2AMLogic/gf180-usb2-phy/layout/README.md

# layout

GDS/OASIS and DRC/LVS evidence for this PHY. Two halves, tracked separately
because they landed at very different maturity (issue #25, T1 checklist item
2).

## Digital — `layout/digital/` (delivered, DRC-clean, LVS-matched)

`usb_utmi_phy.gds` / `usb_utmi_phy.def` / `usb_utmi_phy_routed.v` — the real
PHY digital logic (`rtl/usb_utmi_phy.v` and every submodule it instantiates:
the four vendored canonical protocol modules under `rtl/common/`
(`usb_nrzi_encoder`, `usb_nrzi_decoder`, `usb_bit_stuffer`,
`usb_bit_destuffer`, since #84) plus `usb_sync_detector`,
`usb_eop_detector`, `usb_line_state_decode`), synthesized (`klt synthesize`,
Yosys) and place-and-routed (`klt place-and-route`, OpenROAD) against the
gf180mcu `gf180mcu_fd_sc_mcu9t5v0` standard-cell library. Reproducible from
a committed, real request-file flow — see `flow/README.md`'s "Digital
synthesis + place-and-route" section for the exact commands, and
`verification/records/place-and-route/records/20261015-011501-32db02a.md`
for the measurement (regenerated by issue #131 from the post-#115/#112/#113/#130
source tree at `32db02a`, superseding the post-#84 run of issue #87): 330
mapped standard cells becoming 1155 placed instances (340 logic instances
including CTS buffers and dummy loads, plus 815 physical-only fill, endcap and
tap instances), die 34881.2 um2, 43.7 % utilization, 13140 um routed
wirelength, 0 setup/hold/antenna/router-DRC violations at the 12 MHz spec
clock rate, ~44.4 MHz `fmax` at the nominal liberty corner with estimated RC
(with the extracted parasitics actually attached: 42.6 MHz at `tt_025C_1v80`,
`verification/records/post-layout-pvt/records/20261015-011505-32db02a.md`), and
every one of the cell library's 15 liberty corners (1v8, 3v3 and 5v0
families) positive on both setup and hold (worst setup 27.4 ns at
`ss_125C_1v62`, worst hold 0.41 ns at `ff_n40C_5v50`). The routed
netlist, DEF and GDS are bit-for-bit reproducible: a second, newer klt
reproduced all three byte-identically.

**DRC-clean** — `verification/records/digital-drc/records/20261015-011502-32db02a.md`:
`klt drc --deck gf180mcu` reports `status: "clean"`, `violation_count: 0`
against this exact GDS.

**LVS-matched, power-verified** —
`verification/records/digital-lvs/records/20261015-011503-32db02a.md`:
gate-level LVS of this GDS against `usb_utmi_phy_routed.v` (the as-built,
post-CTS netlist) is a `status: "match"` **and**
`power_connectivity.status: "match"` — every power/ground pin of every
instantiated standard cell reaches its expected net — with the negative
control on a deliberately-broken reference correctly rejected. Driven by
`scripts/digital_lvs.py`, which asks `klt lvs` to compare the as-built
Verilog directly (`reference.form: "gate-level-verilog"`, the form
[klayout-tools#1336](https://github.com/2AMLogic/klayout-tools/issues/1336)
added to close
[klayout-tools#1419](https://github.com/2AMLogic/klayout-tools/issues/1419)
— the transcription half of this script this issue made deletable, exactly
as the old closing note predicted) and to prune the physical-only
filler/tap masters structurally instead of by name. The three flow-level
asymmetries the script's earlier hand-transcription handled
(physical-only fillers, unconnected CTS load pins, `assign`-aliased output
ports) are the tool's own disclosed warnings now
(`topology.power_only_pruned`, `topology.reference_port_alias_joined`).

**What that does and does not say.** The curated `gf180mcu` deck is klt's own
rule set, not the foundry sign-off deck; no metal/density fill is inserted, so
this is not a density-clean claim. LVS holds the standard cells as black boxes
— it verifies the *assembly*, not the foundry's library. There is no IO ring
or pad frame (core-only). Extracted-parasitic STA of this
layout is recorded separately under
`verification/records/post-layout-pvt/` — three liberty corners with extracted
wire and vertical-coupling capacitance attached (current record
`20261015-011505-32db02a`), not a SPICE re-simulation of this netlist and not
RC signoff. A net being *name-matched* in the SPEF is not evidence its
parasitics were attached: the earlier records (`20260922-042422-9ec2304`,
`20261008-200000-8139bb6`; the latter's fix is `20261008-195826-74ccfac`) reported full name annotation while OpenSTA applied
no wire capacitance (`delay_changed: false`). The current record discloses 7
unannotated drivers (floating CTS dummy-load outputs) and 3 partially
unannotated drivers (`RxActive`, `LineState[1:0]`), no wire RC delay (lumped
capacitance), an ideal clock, and no lateral coupling (none declared); see
`manifests/README.md` item 5.digital. The older name-annotation counts in
`20260905-182000-80d4593.md` were not re-checked for attachment.

**History.** Until 2026-08-25 this layout was **not** DRC-clean: 153 `Metal1`
space/width violations at standard-cell row gaps, root-caused to
`klt place-and-route`'s v1 scope having no filler-cell / power-rail-stitching
stage, and cross-checked against
[klayout-tools#1028](https://github.com/2AMLogic/klayout-tools/issues/1028).
That record
(`verification/records/digital-drc/records/20260817-202448-0956748.md`) is
superseded, not deleted — it remains the correct account of what a PDN-less
place-and-route produces. The fix was upstream: `klt` 0.3.0 added the optional
`request.power` block (tapcell + `pdngen` + `filler_placement`), which
`flow/request-usb-utmi-phy-par.json` now uses.

## Analog — all five blocks routed (scripted completion), signoff pending

All five analog blocks (`differential_driver`, `differential_receiver`,
`dplus_pullup`, `se_receiver_dm`, `se_receiver_dp` — `design/*.sch` /
`design/netlist/*.spice`) now have a committed, fully routed GDS under
`layout/analog/`: the four receiver/pull-up blocks from issue #251 (child A of
#245) and `differential_driver` from issue #252 (child B), delivered once the
driver re-size (#166/#167) landed. See "Outcome per block" immediately below.
The set is cited by T1 item `2.analog` through
`signoff/evidence/inventory-analog-layout.json`. Nothing here is signed off —
DRC/LVS/ERC of these streams are issues #246/#247/#248. The dated history of the klt-only
attempt that led here is kept verbatim in
[`analog/HISTORY.md`](analog/HISTORY.md); where it says "not delivered" or
lists 6/21 and 1/8/9/9 routed nets, it describes that run, not the committed
GDS.

### Outcome per block (issues #251, #252)

| Block | GDS | Nets routed | By klt-plan / scripted | DRC (`klt drc --deck gf180mcu`) |
|---|---|---|---|---|
| `differential_driver` | `layout/analog/differential_driver.gds` | 20/20 | 2 / 18 | **clean** (0) |
| `differential_receiver` | `layout/analog/differential_receiver.gds` | 8/8 | 0 / 8 | **clean** (0) |
| `se_receiver_dm` | `layout/analog/se_receiver_dm.gds` | 9/9 | 0 / 9 | **clean** (0) |
| `se_receiver_dp` | `layout/analog/se_receiver_dp.gds` | 9/9 | 0 / 9 | **clean** (0) |
| `dplus_pullup` | `layout/analog/dplus_pullup.gds` | 21/21 | 6 / 15 | **clean** (0), lengths snapped by klt 0.9.0 `res_array` and equal to DR-0010 (was 75 violations) |

The three receivers read 0 by the klt plan path because issue #346 gave their
`VDD` net a body tie, which moves it into the scripted pass; nothing else in
this table moved.

`layout/analog/provenance.json` carries, per block, `gds_sha256`,
`netlist_sha256`, `plan_sha256`, `klt_version`, `regeneration_command`,
`routing_method` (per-method net counts, or the bare method name for a block
routed by one path only), `body_tie_nets`, `pin_labels` and the DRC
result. `scripts/gen_analog_layout.py --check` regenerates every block into a
scratch directory and compares each `gds_sha256` (and the netlist and plan
hashes) against that sidecar; GDS output is written without timestamps so the
hashes reproduce.

> **`--check` reproduces all five committed streams (measured 2026-11-13,
> issue #335).** It did not until then: `dplus_pullup` regenerated stably to
> `3729bd19…` against the committed `c4080adb…` while every pinned input
> (plan, netlist, klt 0.9.0, PDK `c6d73a35`) hashed as recorded, and klayout
> version (0.30.12 vs 0.30.13) and Python version (3.12.3 vs 3.12.15) were
> each eliminated. The cause was **process-shared state, not any pinned
> input**: the generator executed all five plans in one Python process, and
> klt's layout-plan executor emits a plan's device-cell records in an order
> that depends on which plans ran *earlier in that process*. `dplus_pullup`
> reproduced under exactly one block selection — the one that wrote it — and
> stopped reproducing at `6b6483e`, when `differential_driver` began
> executing ahead of it. Measured against klt's executor directly, with none
> of this repo's generator involved, so the leaked state is klt's and not
> this script's: filed as `2AMLogic/klayout-tools#5499`.
>
> The generator now runs **one process per plan**, so a block's stream is a
> function of its own inputs and not of which blocks were selected or in what
> order. `dplus_pullup` was re-delivered from an isolated run as
> `3729bd19…`, which is **geometrically identical** to the `c4080adb…` it
> supersedes — `klt diff` exits 0 with `equivalent: true`,
> `stream_identical: false` and one shared `canonical_hash`; independently,
> 49 cells in both, equal cell bounding boxes, zero XOR area on all 15
> layers, the same 2713 element blocks, with 18 cells differing only in
> emission order — and DRC-clean (0 violations). **No geometry changed**, and
> no other committed stream was touched. CI was unaffected throughout:
> `scripts/check_analog_provenance.py` re-hashes committed files and does not
> regenerate. Records:
> `verification/records/analog-layout/records/20261113-134500-7233150d73ec.md`,
> superseding `20261113-133000-f26c7be72693.md` (which reported the finding
> with its cause still unknown) for the `dplus_pullup` hash. The earlier tool
> gap filed from this diagnosis — no `klt` verb compares two streams for
> *geometric* equivalence — was closed as already provided by `klt diff`
> (`2AMLogic/klayout-tools#5489`).

CI (`scripts/check_analog_provenance.py`, via `npm run lint`) re-hashes the committed GDS, netlist and plan against the sidecar offline, with no PDK; `--check` stays the full regeneration test. A net counts as routed only when a flat conductivity
extraction over metal1/via1/metal2/via2/metal3 puts all of its pins in one
component that no other net's pin shares, and as a cross-check KLayout's own
`LayoutToNetlist` finds exactly one wired net per plan net (20/8/9/9/21). Negative controls
(one track's vias deleted; an extra metal-2 bridge) were seen to be reported as an open and a
short respectively.

**klt limit hit, with the run.** With the klt of the first delivery (`7ee09483`,
0.7.1.dev1743 — the pin these counts were measured under, 2026-10-27)
the plan path routes `dplus_pullup` 6/21 and the three receivers 1/8, 1/9, 1/9 —
the same counts as the 2026-09-21 run — and rejects every other leg with
"backbone ... crosses N um of block 'X''s interior on the side *away* from its own
pin" (issue #1895 protection), even with `routing.cross_block_layer_role`
set to `metal2` (tried on `differential_receiver`: IBIASN and LOADDIODE then route, the
other five still do not). This is the multi-net layer/track-assignment gap
recorded as `2AMLogic/klayout-tools#1962` (open). The pin has moved twice since
that run: to klt 0.8.0 on 2026-10-27 (`f10baec`), under which all four GDS were
recorded as reproducing (`fdff78c`), and to klt 0.9.0 on 2026-11-06 (issue #263,
`102faa6`), which regenerated all four streams under new hashes — so the streams
committed today are the 0.9.0 ones, and `layout/analog/provenance.json` records
the klt each was written by. The remaining nets are
completed by scripted routes in `scripts/gen_analog_layout.py`:

- every plan places one row of tall vertical devices, so gate pins (a metal-1 pad
  on top) escape **up** and everything else (full-height source/drain strips,
  resistor heads) escapes **down**; each pin gets a via1 on its own metal-1 and a
  0.28 um metal-2 stub, and each net a metal-3 track (0.70 um pitch, never shared)
  above or below the row;
- a net with both kinds is joined by one metal-2 corridor in a gap between two
  devices (gate and source/drain stubs of one device are 0.43 um apart, closer
  than metal-2 spacing, so they never share a side);
- no device is moved or re-sized. The one geometry-adjacent change is that
  top-level instance origins are snapped to the 0.005 um manufacturing grid
  (only `dplus_pullup` is affected: 7 instances).

**How `dplus_pullup` became DRC-clean (DR-0010).** At klt `7ee09483`
(0.7.1.dev1743), the pin at the 2026-10-27 run, a bare `dplus_pullup` plan run
had **2583** violations, almost all `*.ongrid.1` on every
device placed to the right of the first fractional-width resistor. The origin snap
removes all of those; 75 remained *inside* the five `res_array` cells for
`r_seg0`–`r_seg4`, whose netlist lengths (0.343, 0.686, 1.371, 2.743, 5.486 um)
are not on the grid. Both gaps are filed as `2AMLogic/klayout-tools#4202` (group
origins not snapped) and `#4203` (`res_array` sub-grid lengths). The operator
ruled on 2026-10-30 (issue #251) to set the no-re-sizing rule aside for these five
resistors only: `spec/decisions/0010-dplus-pullup-trim-resistor-grid-snap.md`
gives each an on-grid drawn length (0.420, 0.685, 1.370, 2.745, 5.485 um; XR0 is
lengthened because 0.345 um fails `pplus.width.1`/`sab.width.1`), set as
`params.length_um` in `layout/analog/plans/dplus_pullup.json`. **Update, issue
#263 (2026-11-06):** klt 0.9.0 ships klayout-tools#4666, so the plan no longer
carries any `length_um`: the generator snaps the netlist lengths itself
(`r_seg0` also sets `short_length: "lengthen"`) and its realised lengths equal the
DR-0010 table. The layout still differs from `design/netlist/dplus_pullup.spice` on
those five lengths (the generator reports each as a deviation); the
pull-up was re-simulated on the snapped lengths over the 45-corner matrix (PASS,
worst per-corner error 2.44 %, fixed-trim 2.55 %, limit 5 %). The `res_array`
snapping gap was `2AMLogic/klayout-tools#4666`. No violation was ever in the routing or in the placement of
any other device. Run record: `verification/records/analog-layout/records/20261106-120000-ef841f90e933.md`
(previous: `20261030-213500-7134cc091abf.md`).

**Bodies are tied, and the pins are the schematic's (issue #346).** The two
paragraphs above describe the plan path, and the plan path alone still wires
device terminals only: `klt`'s layout-plan executor derives connectivity from
source/drain/gate terminals and deliberately drops the bulk terminal, so the
guard-ring / body-tie metal-1 pads each generator draws are in no plan net.
That is a tool gap (`2AMLogic/klayout-tools#5546`), and until it closes
`scripts/gen_analog_layout.py` completes the tie itself, in the same post-plan
pass as the scripted routes: it reads the plan's own netlist digest, and for
each device group ties the group's body — through one of the contacted
`TAP_PAD` ports `mos_array` reports — to the net the schematic puts that body
on. One pad per group is enough, because a group's pads contact the one well
(pfet) or the one substrate (nfet) its devices sit in. The same pass re-labels
the top cell so its named nets are **exactly** the reference `.subckt` ports;
what klt leaves behind is one label per net its router drew a leg for, which is
neither the port set nor a subset of it.

**LVS has now been run on all five committed streams and all five match** —
record `verification/records/analog-lvs/records/20261113-163000-35e9b6e5ab87.md`
(issue #346), which supersedes the five-mismatch measurement of
`20261113-151132-45afbeea4868.md` (issue #345). `body_verification.status`
reads `verified` on every block, `vsubs` appears in none of the five extracted
netlists, and the layout pin set equals the reference port set on every block.
The layout measurement for those regenerated streams — 5/5 fully routed, 5/5
DRC-clean, every device cell unchanged — is
`verification/records/analog-layout/records/20261113-162700-35e9b6e5ab87.md`.
The earlier `differential_receiver` LVS mismatch (`20261009-203500-7a8e831`)
is history: that stream no longer exists in the tree.

**What the match does not say.** The compare paired the poly resistors on
topology alone — their `R` is a `subckt-call` placeholder and `L`/`W`/`A`/`P`
are KLayout-secondary, so none was compared — so it verifies no resistor
dimension, including the DR-0010 deviation above. MOS `L`/`W` *were* compared
and agreed. No ERC or extracted re-simulation was run on these streams
(issues #248, #53), and nothing here is an IR-drop or latch-up-margin claim
about the tie geometry.
Metal-3 is used for the first time in this repo; nothing yet checks it beyond the
deck's `metal3.*` and `via2.*` rules.

### Current state in one paragraph

Plans, routing, and signed-off layout are three different things here. All
five blocks have a committed **plan** (`layout/analog/plans/*.json`), and four
of them — `differential_receiver`, `se_receiver_dm`, `se_receiver_dp` and
`dplus_pullup` — now also have a **committed GDS** under `layout/analog/`
(issue #251): each is fully routed (8/8, 9/9, 9/9 and 21/21 nets) and
DRC-clean (0 violations) at the `gf180mcu` deck under the pinned klt 0.9.0.
Those nets are completed by two paths, as the table under "Outcome for the
four child-A blocks" above and `layout/analog/provenance.json` record per
block: the klt plan path routes 0, 0, 0 and 6 of them, and scripted routes in
`scripts/gen_analog_layout.py` complete the remaining 8, 9, 9 and 15.
`differential_driver` now has a **committed stream** too (issue #252): its
plan executes 40 device groups for the 40 netlist devices and all **20 of its
20** nets are routed — the plan path routes 2 and scripted routes in
`scripts/gen_analog_layout.py` complete the remaining 18 — DRC-clean at the
`gf180mcu` deck, bbox 1831.2 x 83.88 um; run record
`verification/records/analog-layout/records/20261113-162700-35e9b6e5ab87.md`,
the current measurement of all five streams (its lineage runs back through
`20261113-134500-7233150d73ec.md` and `20261113-133000-f26c7be72693.md` to the
2-of-20 measurement of `20261113-090000-4f79d854e7b4.md`; each date's three
sibling records are source-only provenance-hash refreshes, not measurements).
The driver does ingest now — the "cannot be ingested" wording in the early
columns of the per-run table in `analog/HISTORY.md` is history. There is still
**no signoff-ready analog layout**, but the LVS gap is now closed rather than
merely measured: `scripts/analog_lvs.py` runs transistor-level LVS on **all
five** committed streams against `design/netlist/<block>.spice`, and **all
five match** — record
`verification/records/analog-lvs/records/20261113-163000-35e9b6e5ab87.md`
(issue #346, klt 0.9.0), which supersedes the five-mismatch measurement of
`20261113-151132-45afbeea4868.md` (issue #345). Every device, net and pin
pairs on every block (40/40, 11/11, 78/78, 13/13, 13/13 devices), `error_count`
is 0, and nothing was relaxed to get there — no `ignore_mos_bulk`, no
parameter tolerance, no flattening. The three causes that record named are
each gone: PMOS bodies sit on the supply the schematic names, the substrate is
tied to a drawn `VSS` (`vsubs` appears in no extracted netlist), and the
labelled port set is the schematic's. The earlier
`verification/records/analog-layout/records/20261009-203500-7a8e831.md`
(issue #103) is superseded: its verdict still holds for the stream it pinned,
but its 1-of-8 routing and 31-vs-10 net counts describe that 2026-10-09
plan-path-only `differential_receiver` geometry, not the committed stream.
What is still missing is electrical: no ERC and no extracted re-simulation
exists, and LVS compared no resistor dimension (see "What the match does not
say" above). DRC and ERC signoff of the committed streams are issues #246 and
#248; citing the match as T1 item `4.analog` is #247. The
per-run table in `analog/HISTORY.md` is dated history.

### Dated history

The narrative of the klt-only routing attempt that led here — "What was
attempted", "What actually happened", "Why nothing routed — root causes, not
guesses", "Friction filed", and "What would have to be true to deliver analog
layout" — is kept verbatim in [`analog/HISTORY.md`](analog/HISTORY.md). Read it
for how this block got here, not for what the tree contains.

## Regenerating

Both halves need `scripts/setup-env.sh`'s environment (venv + pinned `klt` +
gf180mcu PDK) — see `docs/environment-setup.md`.

```bash
./scripts/setup-env.sh
source .venv/bin/activate

# --- digital: synthesis -> place-and-route -> routed GDS (layout/digital/)
ln -sf "$(pwd)/scripts/openroad-docker.sh" .venv/bin/openroad   # if no native openroad
PDK=gf180mcuD klt synthesize flow/request-usb-utmi-phy-synth.json --format json
cp flow/.klt/synthesize/run-*/usb_utmi_phy_synth.v flow/.klt/synthesize/usb_utmi_phy_synth.v   # the P&R request names this path
PDK=gf180mcuD klt place-and-route flow/request-usb-utmi-phy-par.json --format json
cp flow/.klt/place-and-route/usb_utmi_phy.gds layout/digital/usb_utmi_phy.gds
cp flow/.klt/place-and-route/usb_utmi_phy.def layout/digital/usb_utmi_phy.def
cp flow/.klt/place-and-route/usb_utmi_phy.v   layout/digital/usb_utmi_phy_routed.v

# --- digital signoff: DRC, then gate-level LVS (+ its negative control)
PDK=gf180mcuD klt drc layout/digital/usb_utmi_phy.gds \
    --deck gf180mcu --top usb_utmi_phy --format json
PDK=gf180mcuD python3 scripts/digital_lvs.py
PDK=gf180mcuD python3 scripts/digital_lvs.py --negative-control
klt erc layout/digital/usb_utmi_phy.gds layout/digital/erc-supply-spec.json \
    --top usb_utmi_phy --format json   # T1 item 11; exit 4 = antenna half not_checked, expected

# --- analog: execute the committed layout plans, complete the routing, DRC each result
PDK_ROOT=$HOME/.volare .venv/bin/python scripts/gen_analog_layout.py            # text report
PDK_ROOT=$HOME/.volare .venv/bin/python scripts/gen_analog_layout.py --format json
PDK_ROOT=$HOME/.volare .venv/bin/python scripts/gen_analog_layout.py --deliver   # rewrite layout/analog/*.gds + provenance.json
PDK_ROOT=$HOME/.volare .venv/bin/python scripts/gen_analog_layout.py --check     # reproduce every gds_sha256 in a scratch dir

# --- analog signoff: transistor-level LVS of every committed stream (all five
#     mismatch today -- exit 1 is the current, recorded result, not a failure
#     of the harness; see verification/records/analog-lvs/)
PDK=gf180mcuD python3 scripts/analog_lvs.py
PDK=gf180mcuD python3 scripts/analog_lvs.py --blocks differential_receiver   # one block
```

`scripts/analog_lvs.py` discovers its blocks from `layout/analog/*.gds` (never
a hard-coded list), compares each against `design/netlist/<block>.spice` with
`klt lvs` (inline extraction, `form: "subckt-call"`, `keep_extracted` so the
compare's own layout-side netlist is written out), and writes its artifacts to
`layout/analog/lvs/` (gitignored scratch). It **exits 0 only when every block
reads `status: "match"`**; a block whose reference netlist is missing fails
loudly rather than being skipped. Frozen evidence lives under
`verification/records/analog-lvs/`. `scripts/test_analog_lvs.py` is its
self-test and needs neither klt nor the PDK.

`scripts/gen_analog_layout.py` writes each block's klt result
(`<block>.klt.gds`), the routed GDS, its raw Phase C response JSON, and a
combined `analog-layout-report.json` under `layout/analog/out/` (gitignored
scratch), and prints one verdict line per block; `--deliver` copies the routed
GDS of every block in `DELIVERABLE_BLOCKS` (now all five) to `layout/analog/`
and merges their entries into `provenance.json`; `--blocks <name>` narrows a
run, and the merge leaves the other blocks' entries untouched. A run with more
than one plan executes **each plan in its own child interpreter** and merges
the per-block results (issue #335), so no block's stream can depend on a
sibling; a lone plan already owns its interpreter and runs in-process. Its exit
code is about *the run*, never about the quality of the
layout: `0` means every plan executed (with `--check`: and every hash
reproduced), `1` means the run itself failed (no klt, no PDK, an isolated
per-block run that reported nothing, an unexpected exception), `3` means
`--check` found a mismatch. Read the report for the
verdict — a full run now ends `analog layout DELIVERED`, every plan having
executed, routed fully and come back DRC-clean.

As of issue #72 every one of the five analog blocks executes from a
committed plan (`differential_driver.json` was the last to be authored, once
klayout-tools#1731 gave `res_array` drawn-geometry support for gf180mcu
metal resistors), so the driver no longer carries a plan-less-block path
(removed in issue #177; it is in git history if a future block needs one).

`scripts/digital_lvs.py` writes its extracted/reference netlists and reports
to `layout/digital/lvs/` (gitignored scratch — the frozen copies live under
`verification/records/digital-lvs/`). It exits 0 only on a full pass —
`status: "match"` **and** `power_connectivity.status: "match"` with every
declared expected net exercised; with `--negative-control` it exits 0 only
when the compare correctly *fails* on a deliberately broken reference.

See `flow/README.md` for the digital flow's full detail and
`verification/README.md` for the evidence-record convention that
`verification/records/place-and-route/`, `verification/records/digital-drc/`,
`verification/records/digital-lvs/`, and
`verification/records/analog-layout/` all follow.
