2AMLogic/gf180-usb2-phy/sim/spec-coverage.md

# §8.2 coverage — which spec row is substantiated by which record

`spec/usb2-device-phy.md` §8.2 names the quantities every electrical claim
against this block must carry, and §8.1 fixes the 45-corner PVT matrix each of
them must be run over. This file is the **index** from those rows to the
append-only evidence that answers them. It is not the characterization report
(that is issue #27's artifact, and it will aggregate rather than replace this);
it exists so that "does every §8.2 row have a recorded pass/fail?" is a
question with a one-page answer instead of a directory crawl.

Every row below was run over the **full 45-corner matrix** of §8.1 — 5 process
corners (`tt`, `ff`, `ss`, `fs`, `sf`) × 3 temperatures (−40, 27, 125 °C) × 3
supplies (2.97, 3.30, 3.63 V). No subset justification is claimed by any of
these records, because none of them is a subset.

- **PDK**: `gf180mcuD` @ open_pdks `c6d73a35f524070e85faff4a6a9eef49553ebc2b`
- **Simulator**: ngspice-47
- **Netlist provenance** (current state: `layout/README.md` § "Analog"; the dated
  narrative that follows is history): schematic — the DUT of every experiment in the
  table below is the generated export under `design/netlist/`, not a
  post-layout extraction. There is no **analog** layout, so no extracted
  re-run exists to compare any electrical row against; issue #52 closed
  (PR #57, 2026-08-26) without ever committing a GDS/OASIS for any of the
  five analog blocks, and **that is still true as of 2026-09-09** — the
  remaining friction is tracked at klayout-tools#1424 (a DRC regression,
  closed `NOT_PLANNED`/refuted 2026-08-26 but re-confirmed by issue #61 on
  2026-09-05 to still reproduce byte-for-byte against the exact commit the
  refutation's source inspection covered). gf180-usb2-phy#56's
  `dplus_pullup` design decision is **resolved** (operator ruling
  2026-09-05, FLATTEN — `spec/decisions/0001-dplus-pullup-switch-device-flattening.md`):
  that block's switch devices are now drawn one device per gate, `klt`
  ingests and places it, and the §5 row below was re-run against the
  flattened netlist. It now has a committed layout *plan* — and, since issue
  #68 (2026-09-09), one that spends `routing.cross_block_layer_role` at
  `klt` pin `8bd3f0b0` — but a plan is not a layout: `dplus_pullup` routes
  **6 of 21 nets** and the three receiver plans **1 of 8/9/9**, with both
  supplies and every ladder node unrouted, so there is still no analog
  extraction to compare against. Issue #53's analog acceptance criterion
  therefore stays unattempted: **there is still nothing under
  `layout/analog/` to extract** (only `layout/analog/plans/*.json`), so no
  analog `sim/`-row re-run against an extracted netlist can exist yet,
  regardless of #52's own closed/open status. The two upstream gaps that
  now hold the routed-net count down are klayout-tools#1531 and #1467, both
  open; the full per-net evidence is
  `verification/records/analog-layout/records/20260909-215500-29c5780.md`.
  (The digital half does have a committed,
  DRC-clean, LVS-matched layout and, as of issue #53's `post-layout-pvt`
  experiment, a SPEF post-layout STA re-run whose record reported 364/366 design
  nets *name-annotated*:
  `verification/records/post-layout-pvt/records/20260905-182000-80d4593.md`.
  **Name annotation is not attached capacitance.** A later record found the
  same extraction recipe reported full name annotation while OpenSTA applied
  no wire parasitics (`delay_changed: false`); the 364/366 figure was not
  re-checked for attachment. The current digital STA evidence is
  `verification/records/post-layout-pvt/records/20261015-011505-32db02a.md`
  (regenerated layout of #131; three liberty corners, parasitics attached with `--def-pins`, 7 unannotated
  and 3 partially unannotated drivers, lumped capacitance with no wire RC
  delay, ideal clock, no lateral coupling; not RC signoff and not the §8.1
  45-corner matrix — see `manifests/README.md` item 5.digital).
  That record supersedes an earlier, partial attempt
  (`20260825-233200-1c84648.md`, 186/366 nets name-annotated, filed as
  klayout-tools#1422 and fixed by #1423); the later
  record above shows that fix changed name matching, not attached
  capacitance. No row in *this* table is
  a digital timing row, so neither post-layout-pvt record changes any
  verdict below; both are cited here only so "post-layout re-verification"
  for the digital half is discoverable from this index.)

## The table

Record IDs are current **as of this file's last edit**; records are
append-only, so a later re-run mints a new record ID in the same experiment
directory and names the one below in its **Supersedes** field. Trust the
experiment directory, and read its newest record.

| §8.2 row | Verified against | Experiment | Record | Verdict |
|---|---|---|---|---|
| Rise/fall time | §6 (4–20 ns into 50 pF) | `sim/driver-signal-quality/` | `20261104-204550-2d31f87` (supersedes `20261104-194138-bccb09f`; TXOE cell with the lengthened NMOS-path slew resistor, issue #277) | **PASS** 45/45 — rise 4.04–8.65 ns, fall 4.12–8.77 ns (fast corner 0.9 % above the 4 ns floor, `ff_-40c_3.63v`) |
| Crossover voltage | §6 (1.3–2.0 V) | `sim/driver-signal-quality/` | `20261104-204550-2d31f87` | **PASS** 45/45 — 1.419–1.941 V (high end 3 % below the 2.0 V ceiling, at `sf_-40c_3.63v`; low end 9 % above the 1.3 V floor; was 1.339–1.834 V in `20261104-194138-bccb09f`) |
| Rise/fall matching | §6 (within 10 % of each other) | `sim/driver-signal-quality/` | `20261104-204550-2d31f87` | **PASS** 45/45 — ratio 0.930–1.068; `fs_-40c_2.97v` now reads 1.06821 (was 1.10582 in the superseded `20261104-194138-bccb09f`, FAIL). Fixed by design (`RSLEWNDP`/`RSLEWNDM` 1u × 2u → 1u × 10u), limit not relaxed; see [the TXOE trf fix comparison note](notes/20261104-txoe-trf-fix-comparison.md) |
| Full-speed signal quality | §6 rows as a set + monotonic single-zero-crossing transition | `sim/driver-signal-quality/` | `20261104-204550-2d31f87` | **PASS** 45/45 — every §6 row passes at all 45 corners and the monotonicity/single-crossing half (`xing_extra_ps` = 0 everywhere) passes |
| Driver-output timing jitter | §8.2's own note: no confirmed numeric limit ⇒ engineering data, no spec citation | `sim/driver-jitter/` | `20261104-204926-2d31f87` (supersedes `20261104-194449-bccb09f`) | **No pass/fail claimed** (see below) — data recorded at 45/45 with TXOE=1 |
| Driver disabled-state leakage (TXOE=0) | No §6/§8.2 numeric limit: engineering data, no spec limit | `sim/driver-disabled-leakage/` | `20261104-205341-2d31f87` (supersedes `20261104-193759-bccb09f`; re-run after the #277 slew-resistor change, worst-case figures unchanged) | **No pass/fail claimed** — engineering data, no spec limit; 45/45 points completed, harness contention control passes. Worst settled disabled current 50.46 µA at `ff_125c_2.97v` (host driving 3.3 V into a 2.97 V-supplied cell, over-rail case); at 3.30 V / 3.63 V supply the worst settled current is 283 nA (`ff_125c_3.30v`) / 273 nA (`ff_125c_3.63v`) |
| Shared-pad-bus host/device ownership on shared DP/DM | No §6/§8.2 numeric limit: engineering data, no spec limit (integration evidence for the DR-0004 pin contract, `spec/decisions/0004-digital-analog-pin-contract.md`) | `sim/shared-pad-bus/` | `20261106-181119-02e3661` | **No pass/fail claimed** — engineering data, no spec limit; 45/45 points completed. Reports pad voltages, receiver output levels and pad-crossing-to-output delays on the shared nets; the only checks are a functional-polarity smoke count and a harness-integrity check that the deliberate contention is visible to the current meter. No compliance claim: the pending DR-0004 rulings (§6 high-Z/leakage row; RXD not consumed by the digital side) are not settled here |
| D+ pull-up tolerance | §5 (1.5 kΩ ±5 %) | `sim/dplus-pullup-tolerance/` | `20260905-185112-6bfe679` (supersedes `20260817-203609-a408cb6`) | **PASS** 45/45 — re-run against the flattened `dplus_pullup` netlist (issue #56 / DR-0001); same verdict, same trim code at every corner, ≤ 0.01 Ω from the superseded result |
| Receiver thresholds — differential | §4 (\|D+ − D−\| > 200 mV over 0.8–2.5 V common mode) | `sim/diff-receiver-sensitivity/` | `20261008-193113-2e9f63e` (supersedes `20260817-203852-5a963e7`) | **PASS** — 45/45 corners at each of the 0.8 V, 1.65 V and 2.5 V common-mode points; worst input-referred threshold −81 mV (`fs_125c_2.97v`, 2.5 V common mode). Sizing fix in issue #97; the previous record's 30/45 failure at 2.5 V is retained as history in the section below |
| Receiver thresholds — single-ended D+ | §4 (VIH > 2.0 V, VIL < 0.8 V) | `sim/se-receiver-dp-thresholds/` | `20260817-203631-a408cb6` | **PASS** 45/45 |
| Receiver thresholds — single-ended D− | §4 (VIH > 2.0 V, VIL < 0.8 V) | `sim/se-receiver-dm-thresholds/` | `20260817-203654-a408cb6` | **PASS** 45/45 |
| DRC / LVS | §8.2 marks this "N/A — layout hygiene, not an electrical spec row" | `layout/digital/`; `layout/analog/` | `verification/records/digital-drc/records/20260825-224815-6a83263.md`; `verification/records/digital-lvs/records/20260825-224930-6a83263.md`; `verification/records/analog-layout/records/20261113-162700-35e9b6e5ab87.md`; `verification/records/analog-lvs/records/20261113-163000-35e9b6e5ab87.md` | **PASS for the digital half. Analog layout delivered and LVS-matched; analog signoff still open.** `klt drc` on `layout/digital/usb_utmi_phy.gds` is `clean` / 0 violations; gate-level `klt lvs` against the as-built netlist is `match` / 0 mismatches, with a passing negative control (the digital rows are cited at their original records; later re-runs are in `verification/records/digital-drc/` and `digital-lvs/`). For analog, the current state is in `layout/README.md` § "Analog" and in the two head records cited at left: **all five** blocks (`differential_driver`, `differential_receiver`, `se_receiver_dm`, `se_receiver_dp`, `dplus_pullup`) have a committed, **fully routed** GDS under `layout/analog/` — 20/20, 8/8, 9/9, 9/9 and 21/21 nets — that `klt drc --deck gf180mcu` reports `clean` / 0 violations on, and transistor-level `klt lvs` against `design/netlist/*.spice` reads `status: "match"` with `error_count: 0` on every one of them, cited as T1 item `4.analog` (issue #247). What is still missing is the analog DRC **coverage attestation** (#246), any analog **ERC** result (#248) and any **extracted-netlist re-simulation** (#53) — so every electrical row above is still measured against the schematic netlist under `design/netlist/`, and no analog row is yet substantiated by post-layout evidence. The LVS run also compared no poly-resistor dimension (`R` excluded as a `placeholder_value`, `L`/`W`/`A`/`P` as `secondary`), so the DR-0010 trim-length deviation is not covered by it. The earlier states this row described are kept as history, not deleted: the DRC-violating receivers (klayout-tools#1424, cleared by the legal-width plan fix, issue #65), the `differential_driver` `rm1` ingestion error and the `dplus_pullup` blocker (issues #56/#70/#72), the incomplete routing and the `differential_receiver` LVS mismatch of `20261009-203500-7a8e831` all live on in `layout/analog/HISTORY.md` and in the superseded records `20260905-200628-80cb14c`, `20260905-190024-525c67c`, `20260921-130120-223bae5` and `20261113-151132-45afbeea4868`. **The driver rows above pass in simulation (issue #96), and the driver layout is now committed and LVS-matched (issue #252).** §11 requires both halves before signoff. |

**No spec limit was relaxed to produce this table.** The four driver index
rows (§6: rise/fall time, crossover, rise/fall matching, and the full-speed
signal-quality row that aggregates them) failed in the first record,
`20260817-203552-a408cb6`, and pass at 45/45 in `20261015-104027-d109790`
(issue #96). The ratified §6 limits are unchanged; the fix is a re-size of the
output stage and predriver in `design/differential_driver.sch`. The old
record stays as the evidence of the 60/30 µm design.

## Driver §6 rows — failure history and the fix (issue #96)

**Current result** (`20261015-104027-d109790`, supersedes
`20260817-203552-a408cb6`): 45/45 corners pass every §6 row, taken through
`klt sim` on the Spot batch fleet (ngspice-46). Rise 4.09–8.78 ns, fall
4.13–8.76 ns, `t_rise/t_fall` 0.944–1.086, crossover 1.405–1.883 V, overshoot
and undershoot ≤ 1.4 mV in magnitude, no extra zero crossings. Nominal
(`tt`/27 °C/3.30 V): rise 5.90 ns, fall 5.86 ns, ratio 1.006, crossover
1.633 V.

**Re-size**: output PMOS `W=60u` → `W=80u m=4`, output NMOS `W=30u` →
`W=30u m=4` (an effective 320u/120u, P:N ≈ 2.7:1 rather than 2:1), predriver
PMOS/NMOS `4u/2u` → `8u/2.5u`. The `rm1` ~36 Ω series termination and the poly
slew resistor are unchanged, so the §6 output resistance is untouched. The
larger output stage cuts the RC at the gate and lets the P:N ratio be tuned
for equal rise and fall.

**Residual risk, not a failure**: the fast corner (`ff`, −40 °C, 3.63 V) has
rise 4.094 ns and fall 4.132 ns, 2.3 % and 3.3 % above the 4 ns floor. That
is a pass, and it is also the thinnest margin in the table; layout parasitics
(none committed) will slow edges, which helps this end and costs margin at
the 20 ns end, where there is a factor of 2.3.

### What was wrong (history, from `20260817-203552-a408cb6`)

**Rise/fall matching, 36/45 corners.** `t_rise / t_fall` ranged from 0.979
(`sf_125c_3.63v`) to 1.402 (`fs_-40c_2.97v`) against a ratified window of
[0.90, 1.10]. The output stage was a 60 µm PMOS / 30 µm NMOS pair into a fixed
~36 Ω `rm1` series termination, so its pull-up was systematically weaker than
its pull-down once carrier mobility is accounted for, and the imbalance was
amplified by the skewed process corners (`fs` was worst, `sf` the only family
inside the window).

**Rise time > 20 ns, 3/45 corners:** `ss_125c_2.97v` (22.33 ns),
`fs_125c_2.97v` (20.92 ns) and `ss_125c_3.30v` (20.79 ns), the weakest-drive
corners of the matrix.

**Crossover < 1.3 V, 2/45 corners:** `fs_27c_2.97v` (1.2935 V) and
`fs_-40c_2.97v` (1.2968 V), the same asymmetry seen as a crossing below
mid-rail.

### Differential receiver at 2.5 V common mode (was 30/45 corners; now 45/45)

**Current result** (`20261008-193113-2e9f63e`, supersedes
`20260817-203852-5a963e7`, issue #97): all three common-mode points pass at
45/45 corners, against the unchanged ±200 mV requirement. Input-referred
threshold: −31.5…−14.5 mV at 0.8 V, −34.9…−16.1 mV at 1.65 V, −81.0…−18.5 mV
at 2.5 V (worst: `fs_125c_2.97v`); output levels are valid logic levels at
±200 mV everywhere. This run was taken through `klt sim` on the Spot batch
fleet (ngspice-46); its threshold is the interpolated `.meas ... WHEN`
crossing, so it is not quantised to the 1 mV sweep step the earlier records'
vector form was.

**What was wrong** (history, from `20260817-203852-5a963e7`): at the 0.8 V and
1.65 V common-mode points the input-referred threshold stayed within
−89…−32 mV, but at 2.5 V it degraded to −60…−500 mV and at 30 of the 45
corners the receiver read a **K** state (D+ − D− = −200 mV) as a **J**. The
original diagnosis (OTA output common mode above the buffer trip point) was
right in effect but the precise mechanism, found in issue #97, is that the
NMOS input pair cannot pull `AMPOUT` below its own tail node
(V_cm − V_GS,n ≈ 1.6 V at 2.5 V common mode), which sits above the old
mid-rail trip point of the first buffer inverter, so a K state never read low.

**Fix**: the first buffer inverter was made deliberately P-heavy
(`MP_B1`/`MN_B1` 8u/4u → 32u/2u), moving its trip point to about 0.65·VDD (2.13 V at tt/27 °C/3.3 V),
which is the OTA's balanced output level (VDD − |V_SG,p| of the diode load)
and tracks it over supply. This was the cheap sizing lever the issue named
first; the complementary-input-pair topology change was not needed. The
single-ended receivers and the spec are untouched.

Records `20261008-191800-f6a4f18` and `20261008-191928-8b1f27c` are 0/45
infrastructure-error records (the fleet runner image's klt predated the
client's request features) kept as append-only evidence of the failed
submissions; they carry no design result.

### Jitter — recorded, deliberately unjudged

§8.2's jitter note is explicit that this repo has no confirmed numeric USB 2.0
source-jitter limits from the physical specification text, forbids inventing
them, and permits `sim/` to "record measured jitter as engineering data without
a spec citation attached" until they are pulled. `sim/driver-jitter/`'s
manifest therefore declares **no** min/max limit on any jitter measurement; its
only check is a spread floor on propagation delay that asserts the corner sweep
actually moved. What the record contains:

- **Edge-to-edge timing variation across the corner set** (which is what the
  §8.2 method column asks for): driver propagation delay to the first
  differential crossing spans **3.02 ns** (`ff_-40c_3.63v` end) to **5.50 ns**
  (`ss_125c_2.97v` end) — a 2.48 ns spread across the 45 corners
  (`20261015-104027-d109790`, the re-sized driver; the superseded record had
  5.36–10.10 ns).
- **Data-dependent jitter within one corner**, over an 18-bit 12 Mbps pattern
  with run lengths 1, 1, 2, 1, 3, 1, 6, 1, 2: peak-to-peak ≤ **0.26 ps**
  consecutive-transition and ≤ **0.16 ps** against the ideal bit grid (the
  superseded record: 2.53 ps and 1.33 ps). At an
  83.33 ns bit time that is ~3 × 10⁻⁶ UI, i.e. negligible — and small enough
  to be at the resolution floor of the transient solver, so it should be read
  as "below the noise of this measurement", not as a precise figure.

The practical reading: the driver contributes essentially no data-dependent
jitter at full speed; what a system would see is the corner-to-corner
propagation-delay spread above, plus the reference-clock tolerance of §7, which
is not this experiment's subject.

## Digital (§2, §3) — where its evidence lives

§8.2's table is entirely analog; the digital UTMI-side logic's verification
floor is set by §11 ("verified by a cocotb testbench, bit-exact against
NRZI/bit-stuffing/SYNC/EOP/line-state behavior") rather than by a PVT row. That
evidence already exists and is not re-derived here:

| §11 digital clause | Record |
|---|---|
| NRZI encode/decode, bit stuffing/destuffing, codec loopback | `verification/records/bit-codec-functional/records/20260816-074908-4e92fcc.md` |
| SYNC detection, EOP detection, line-state decode, top-level UTMI wrapper | `verification/records/utmi-framing-functional/records/20260817-184228-72de176.md` |

Gate-level PVT timing closure of that logic across the same §8.1 grid is
**not** covered: STA exists at three liberty corners only (see the
netlist-provenance note above), and the SDF-annotated gate-level replay was
attempted and blocked (`verification/records/post-layout-functional/` record
`20261015-011506-32db02a`; zero-delay replay 111/111, SDF annotation still rejected, klayout-tools#2885/#2886). §8.2 does
not require it, so it is noted here as a known gap rather than claimed.

## Reproducing any row

```bash
python3 sim/run_corners.py --check-env          # ngspice + gf180mcu PDK present?
python3 sim/run_corners.py driver-signal-quality        # mints a new record
python3 sim/run_corners.py dplus-pullup-tolerance
python3 sim/run_corners.py diff-receiver-sensitivity
python3 sim/run_corners.py se-receiver-dp-thresholds
python3 sim/run_corners.py se-receiver-dm-thresholds
python3 sim/run_corners.py driver-jitter
python3 sim/dplus-pullup-tolerance/analyze_fixed_trim.py   # reads recorded logs
```

Each invocation writes a **new** record; nothing above is ever edited in place
(see `sim/README.md`, "Append-only rule").
