2AMLogic/gf180-usb2-phy/docs/analog-envelope-agreement.md

# Analog `klt sim` envelopes vs. the committed evidence records

Generated by `sim/envelope_agreement.py`; do not edit by hand. For each
bench, the committed `klt sim` envelope (`sim/<bench>/corners/<id>/
klt-sim-report.json`) is compared corner-by-corner with the per-corner
table of the evidence record named below. Every (corner, row) pair is in
`analog-envelope-agreement.csv`; this page keeps the worst case per row.

| bench | row (measurement) | corners compared | worst corner | record | envelope | relative delta |
|---|---|---|---|---|---|---|
| `diff-receiver-sensitivity` | `vth_cm080_mv` | 45 | `tt_125c_3.63v` | -27.4748 | -27.4748 | 1.3e-16 |
| `diff-receiver-sensitivity` | `vth_cm165_mv` | 45 | `fs_125c_3.63v` | -33.4072 | -33.4072 | 2.1e-16 |
| `diff-receiver-sensitivity` | `vth_cm250_mv` | 45 | `fs_125c_3.63v` | -37.4569 | -37.4569 | 1.9e-16 |
| `diff-receiver-sensitivity` | `hi_cm080` | 45 | `tt_125c_3.63v` | 1 | 1 | 0 |
| `diff-receiver-sensitivity` | `lo_cm080` | 45 | `tt_125c_3.63v` | 9.52817e-09 | 9.52817e-09 | 0 |
| `diff-receiver-sensitivity` | `hi_cm165` | 45 | `tt_125c_3.63v` | 1 | 1 | 0 |
| `diff-receiver-sensitivity` | `lo_cm165` | 45 | `tt_125c_3.63v` | 1.36469e-08 | 1.36469e-08 | 0 |
| `diff-receiver-sensitivity` | `hi_cm250` | 45 | `tt_125c_3.63v` | 1 | 1 | 0 |
| `diff-receiver-sensitivity` | `lo_cm250` | 45 | `tt_125c_3.63v` | 5.45954e-08 | 5.45954e-08 | 0 |
| `se-receiver-dp-thresholds` | `vth_v` | 45 | `tt_125c_3.63v` | 1.47599 | 1.47599 | 0 |
| `se-receiver-dp-thresholds` | `out_at_vil` | 45 | `fs_125c_3.63v` | 1.98504e-09 | 1.98679e-09 | 0.00088 |
| `se-receiver-dp-thresholds` | `out_at_vih` | 45 | `tt_125c_3.63v` | 1 | 1 | 0 |
| `se-receiver-dm-thresholds` | `vth_v` | 45 | `tt_125c_3.63v` | 1.47599 | 1.47599 | 0 |
| `se-receiver-dm-thresholds` | `out_at_vil` | 45 | `fs_125c_3.63v` | 1.98504e-09 | 1.98679e-09 | 0.00088 |
| `se-receiver-dm-thresholds` | `out_at_vih` | 45 | `tt_125c_3.63v` | 1 | 1 | 0 |
| `driver-signal-quality` | `trise_ns` | 45 | `tt_125c_3.63v` | 7.3415 | 7.3415 | 0 |
| `driver-signal-quality` | `tfall_ns` | 45 | `tt_125c_3.63v` | 7.43603 | 7.43603 | 0 |
| `driver-signal-quality` | `trf_ratio` | 45 | `tt_125c_3.63v` | 0.987288 | 0.987288 | 0 |
| `driver-signal-quality` | `vcross_rise` | 45 | `tt_125c_3.63v` | 1.80158 | 1.80158 | 0 |
| `driver-signal-quality` | `vcross_fall` | 45 | `tt_125c_3.63v` | 1.80158 | 1.80158 | 0 |
| `driver-signal-quality` | `xing_extra_ps` | 45 | `tt_125c_3.63v` | 0 | 0 | 0 |
| `driver-signal-quality` | `dp_over_mv` | 45 | `tt_125c_3.63v` | 0.678897 | 0.678897 | 0 |
| `driver-signal-quality` | `dp_under_mv` | 45 | `tt_125c_3.63v` | -0.48681 | -0.48681 | 0 |
| `dplus-pullup-tolerance` | `r_code0_ohm` | 45 | `tt_-40c_2.97v` | 2176.66 | 2176.66 | 2.3e-06 |
| `dplus-pullup-tolerance` | `r_code31_ohm` | 45 | `tt_27c_2.97v` | 1072.84 | 1068.97 | 0.0036 |
| `dplus-pullup-tolerance` | `r_best_ohm` | 45 | `fs_125c_3.63v` | 1475.44 | 1523.14 | 0.032 |
| `dplus-pullup-tolerance` | `best_code` | 45 | `tt_125c_3.30v` | 19 | 18 | 0.053 |
| `dplus-pullup-tolerance` | `best_err_pct` | 45 | `ff_125c_2.97v` | 0.537834 | 0.143721 | 0.73 |
| `dplus-pullup-tolerance` | `trim_step_pct` | 45 | `ff_125c_2.97v` | 3.19482 | 3.21874 | 0.0075 |

## Findings

All five benches pass at all 45 corners in the envelopes, and no cited
envelope disagrees with its record about a pass/fail verdict. Agreement by
bench:

- **`diff-receiver-sensitivity`, `driver-signal-quality`**: identical to the
  record to printed precision (relative delta at the level of floating-point
  rounding). The driver envelope *is* the run the record transcribes, so that
  comparison checks the transcription only.
- **`se-receiver-dp-thresholds`, `se-receiver-dm-thresholds`**:
  `vth_v` and `out_at_vih` identical. `out_at_vil` differs by ~9e-4 relative
  at the worst corner, but the quantity is ~2e-9 of the rail (leakage level,
  limit is -0.05..0.1), so the difference is simulator noise on a
  zero-signal output.
- **`dplus-pullup-tolerance`: a real disagreement, not noise.** `r_code0_ohm`
  agrees (<=2.3e-6 relative). `r_code31_ohm`, `r_best_ohm`, `best_code`,
  `best_err_pct` and `trim_step_pct` differ from record `20260905-185112-6bfe679`
  by up to 3 %, 1 code, and 0.4 percentage points of tolerance (worst:
  `best_err_pct` 0.538 % in the record vs 0.144 % in the envelope at
  `ff_125c_2.97v`). Both are far inside the +/-5 % bound, so no verdict moves,
  but the numbers are not the record's. What was checked:
  * The bench netlist change made for `klt sim` (the pull-up supply, enable
    and trim bits follow `v(vdd)` instead of being separate sources at
    `{vdd_val}`) is neutral: the **unmodified** bench run through the local
    harness on this host reproduces the envelope, e.g. `fs_125c_3.63v`
    `r_best_ohm` 1523.14, `best_code` 18, `best_err_pct` 1.54284, both ways.
  * The envelope matches the local harness on the same ngspice-46 and the same
    PDK build (`open_pdks c6d73a35`, the fleet's PDK stamp matches).
  * The record was taken with **ngspice-47** (its own text says so), and its
    `r_best_ohm`/`best_code` expressions spell the comparison with `>`, which
    ngspice-46's control language parses as I/O redirection (the committed
    bench's local `measure` fails outright on ngspice-46 for that reason; the
    `klt_measure` spells it `gt`). `r_code31_ohm` has no comparison in it and
    still differs (1070.37 vs 1067.75 at that corner), so the `>` spelling does
    not explain everything.
  * Not established: whether ngspice-47 vs 46 accounts for the remaining
    difference. It could not be tested here (no ngspice-47 on this host). The
    envelope is the evidence for the current tree; the older record is left
    unedited.
