2AMLogic/gf180-usb2-phy/sim/driver-jitter/records/20261104-204926-2d31f87.md

# Record 20261104-204926-2d31f87

- **Record ID**: 20261104-204926-2d31f87
- **Claim**: spec/usb2-device-phy.md#82-what-gets-measured-and-against-which-section row 'Driver-output timing jitter' -- recorded as ENGINEERING DATA WITH NO SPEC LIMIT ATTACHED, which is what that row's own note mandates: the repo has no confirmed numeric USB 2.0 source-jitter limits from the physical specification text, and §8.2 explicitly says sim/ 'may record measured jitter as engineering data without a spec citation attached' until that pull happens. No jitter measurement below carries a min/max limit; the single check present is a harness-integrity spread floor, not a spec claim.
- **Netlist provenance**: schematic — DUT `design/netlist/differential_driver.spice` (sha256 `b5dda5306f4636451ffc047c3792151f0a5c49d87082e6304cc065831c9f0b72`), driven by `sim/driver-jitter/testbench/driver_jitter_tb.spice` — **taken against a dirty working tree** at commit `2d31f873c2786d5394de45257eb6542a2dbbc1e6`; not citable as a clean-tree result
- **Corner matrix run**:
  - Process: tt, ff, ss, fs, sf
  - Temperature: -40 °C, 27 °C, 125 °C
  - Supply: 2.97 V, 3.30 V, 3.63 V
  - 45 point full-factorial grid (process × temperature × supply), 45 completed
  - Full PVT matrix per CLAUDE.md (−40/27/125 °C, ±10 % supply, process corners).
- **Statistical convention**: N/A (corner-matrix claim, not a distribution claim)
- **Result**:

  | corner-id | tprop_ns | jit_grid_pp_ps | jit_grid_max_ps | jit_cons_pp_ps | jit_cons_max_ps | xings_extra_ps | pass/fail |
  |---|---|---|---|---|---|---|---|
  | `tt_-40c_2.97v` | 3.238 | 0.5002 | 0.4664 | 0.9335 | 0.5002 | 0 | PASS |
  | `tt_-40c_3.30v` | 3.1379 | 0.4002 | 0.2664 | 0.7335 | 0.4002 | 0 | PASS |
  | `tt_-40c_3.63v` | 3.0667 | 0.5337 | 0.3338 | 0.8335 | 0.5002 | 0 | PASS |
  | `tt_27c_2.97v` | 3.6388 | 1.0995 | 1.0995 | 0.7334 | 0.6333 | 0 | PASS |
  | `tt_27c_3.30v` | 3.5287 | 0.6667 | 0.6662 | 1.1 | 0.6667 | 0 | PASS |
  | `tt_27c_3.63v` | 3.449 | 0.3337 | 0.2999 | 0.6335 | 0.3333 | 0 | PASS |
  | `tt_125c_2.97v` | 4.2459 | 0.7337 | 0.5999 | 1.2335 | 0.7002 | 0 | PASS |
  | `tt_125c_3.30v` | 4.1202 | 0.4995 | 0.4995 | 0.7335 | 0.4333 | 0 | PASS |
  | `tt_125c_3.63v` | 4.0262 | 0.4995 | 0.4995 | 0.5335 | 0.3333 | 0 | PASS |
  | `ff_-40c_2.97v` | 2.8212 | 0.4995 | 0.4995 | 0.4 | 0.3333 | 0 | PASS |
  | `ff_-40c_3.30v` | 2.7523 | 0.5995 | 0.5995 | 0.5 | 0.3333 | 0 | PASS |
  | `ff_-40c_3.63v` | 2.7032 | 0.4995 | 0.4995 | 0.4 | 0.3333 | 0 | PASS |
  | `ff_27c_2.97v` | 3.1704 | 0.6995 | 0.6995 | 0.4334 | 0.3333 | 0 | PASS |
  | `ff_27c_3.30v` | 3.0931 | 0.3995 | 0.3995 | 0.4335 | 0.3333 | 0 | PASS |
  | `ff_27c_3.63v` | 3.0366 | 0.5337 | 0.4338 | 0.8335 | 0.5002 | 0 | PASS |
  | `ff_125c_2.97v` | 3.6976 | 0.6002 | 0.4338 | 0.9335 | 0.6002 | 0 | PASS |
  | `ff_125c_3.30v` | 3.6065 | 0.6667 | 0.4662 | 0.9665 | 0.6667 | 0 | PASS |
  | `ff_125c_3.63v` | 3.5374 | 0.6667 | 0.3662 | 1.0665 | 0.6667 | 0 | PASS |
  | `ss_-40c_2.97v` | 3.7432 | 1.4995 | 1.4995 | 1.1334 | 0.9333 | 0 | PASS |
  | `ss_-40c_3.30v` | 3.5979 | 0.8662 | 0.8662 | 1.2 | 0.6667 | 0 | PASS |
  | `ss_-40c_3.63v` | 3.4959 | 0.5002 | 0.3664 | 0.8335 | 0.5002 | 0 | PASS |
  | `ss_27c_2.97v` | 4.1964 | 1.6995 | 1.6995 | 1.5334 | 1.3333 | 0 | PASS |
  | `ss_27c_3.30v` | 4.0393 | 0.8664 | 0.8664 | 1.4335 | 0.8333 | 0 | PASS |
  | `ss_27c_3.63v` | 3.927 | 0.6002 | 0.5664 | 1.1335 | 0.6002 | 0 | PASS |
  | `ss_125c_2.97v` | 4.8862 | 1.5664 | 1.5664 | 1.9335 | 1.5333 | 0 | PASS |
  | `ss_125c_3.30v` | 4.7111 | 1.3995 | 1.3995 | 1.3334 | 1.0333 | 0 | PASS |
  | `ss_125c_3.63v` | 4.5823 | 0.7332 | 0.7332 | 1.0335 | 0.6333 | 0 | PASS |
  | `fs_-40c_2.97v` | 3.2326 | 0.8995 | 0.8995 | 0.6334 | 0.4333 | 0 | PASS |
  | `fs_-40c_3.30v` | 3.1306 | 0.6667 | 0.5662 | 1.0665 | 0.6667 | 0 | PASS |
  | `fs_-40c_3.63v` | 3.0588 | 0.3337 | 0.2338 | 0.6335 | 0.3333 | 0 | PASS |
  | `fs_27c_2.97v` | 3.6335 | 0.8664 | 0.8664 | 1.2335 | 0.8333 | 0 | PASS |
  | `fs_27c_3.30v` | 3.5216 | 0.8995 | 0.8995 | 0.4 | 0.3333 | 0 | PASS |
  | `fs_27c_3.63v` | 3.4412 | 0.4995 | 0.4995 | 0.5335 | 0.3333 | 0 | PASS |
  | `fs_125c_2.97v` | 4.2374 | 0.9664 | 0.9664 | 1.5335 | 0.9333 | 0 | PASS |
  | `fs_125c_3.30v` | 4.1101 | 0.6664 | 0.6664 | 1.1335 | 0.6002 | 0 | PASS |
  | `fs_125c_3.63v` | 4.0153 | 0.5995 | 0.5995 | 0.6335 | 0.4333 | 0 | PASS |
  | `sf_-40c_2.97v` | 3.2697 | 0.6667 | 0.6662 | 1 | 0.6667 | 0 | PASS |
  | `sf_-40c_3.30v` | 3.1677 | 0.6667 | 0.6662 | 1.0665 | 0.6667 | 0 | PASS |
  | `sf_-40c_3.63v` | 3.0949 | 0.4002 | 0.2664 | 0.7335 | 0.4002 | 0 | PASS |
  | `sf_27c_2.97v` | 3.671 | 0.9662 | 0.9662 | 1.3 | 0.6667 | 0 | PASS |
  | `sf_27c_3.30v` | 3.5586 | 0.8995 | 0.8995 | 0.4334 | 0.3333 | 0 | PASS |
  | `sf_27c_3.63v` | 3.4772 | 0.4995 | 0.4995 | 0.5335 | 0.3333 | 0 | PASS |
  | `sf_125c_2.97v` | 4.2822 | 0.4995 | 0.4995 | 0.4335 | 0.3333 | 0 | PASS |
  | `sf_125c_3.30v` | 4.1539 | 0.4002 | 0.2664 | 0.7335 | 0.4002 | 0 | PASS |
  | `sf_125c_3.63v` | 4.0579 | 0.3333 | 0.1995 | 0.6335 | 0.3333 | 0 | PASS |

  Spread across the grid:

  | measurement | min | max | mean | spread % | limits |
  |---|---|---|---|---|---|
  | `tprop_ns` | 2.7032 (`ff_-40c_3.63v`) | 4.8862 (`ss_125c_2.97v`) | 3.62585 | 60.2066 | min_spread_pct=5 |
  | `jit_grid_pp_ps` | 0.3333 (`sf_125c_3.63v`) | 1.6995 (`ss_27c_2.97v`) | 0.708711 | 192.772 | — |
  | `jit_grid_max_ps` | 0.1995 (`sf_125c_3.63v`) | 1.6995 (`ss_27c_2.97v`) | 0.662638 | 226.368 | — |
  | `jit_cons_pp_ps` | 0.4 (`ff_-40c_2.97v`) | 1.9335 (`ss_125c_2.97v`) | 0.881573 | 173.95 | — |
  | `jit_cons_max_ps` | 0.3333 (`ff_-40c_2.97v`) | 1.5333 (`ss_125c_2.97v`) | 0.571147 | 210.104 | — |
  | `xings_extra_ps` | 0 (`tt_-40c_2.97v`) | 0 (`tt_-40c_2.97v`) | 0 | n/a | — |

  - **Overall: PASS**
- **Links**:
  - Testbench: `sim/driver-jitter/testbench/driver_jitter_tb.spice`, `sim/driver-jitter/testbench/tb.json`
  - DUT netlist: `design/netlist/differential_driver.spice`
  - Netlist snapshot: `sim/driver-jitter/netlist-snapshots/20261104-204926-2d31f87.spice`
  - Raw logs: `sim/driver-jitter/corners/20261104-204926-2d31f87/`
- **Timestamp / author**: 2026-11-04T20:49:26+00:00, ubuntu
- **Supersedes**: 20261104-194449-bccb09f

## Environment

Everything needed to re-run this record:

- PDK: gf180mcuD @ open_pdks `c6d73a35f524070e85faff4a6a9eef49553ebc2b` (/home/ubuntu/.volare/gf180mcuD, found via search_root:~/.volare)
- ngspice: ngspice-None via `klt sim` (backend batch; submitting host had ngspice-46 : Circuit level simulation program)
- klt sim: version 0.8.0, backend `batch`, klt status `pass`, remote `{'provider': 'aws-batch-fleet', 'job_id': 'klt-sim-061f4df7bb73', 'region': 'us-east-1', 'instance_id': 'i-0ac04211decb33b83', 'instance_type': 'm7i.4xlarge', 'availability_zone': 'us-east-1a', 'ami_id': 'ami-0fa5ef830209100bd', 'lifecycle': 'spot', 'spot': True, 'state': 'done', 'exit_code': '0', 'concurrency': '1', 'physical_cores': '8', 'elapsed_seconds': 73, 'runner_klt_version': '0.8.0', 'client_klt_version': '0.8.1.dev1317+ga2804ab99263', 'runner_compatibility': 'match'}`
- Harness: sim/harness 0.1.0, python 3.12.3
- git: `2d31f873c2786d5394de45257eb6542a2dbbc1e6` on `feature/issue-277` (dirty)
- Testbench netlist sha256: `33ecff4d9452dd90dcc489c765a8e23fb83df03b1e390e5177292555abd6e13f`
- DUT netlist: `design/netlist/differential_driver.spice` sha256 `b5dda5306f4636451ffc047c3792151f0a5c49d87082e6304cc065831c9f0b72`
- Manifest sha256: `38860a513bb18f5d9cadc39e81d5e8a2fab03c4362733145f3c3c06602a27175`
- Wall time: 225.85 s

Per-corner model sections used:

- `tt`: typical res_typical bjt_typical diode_typical moscap_typical mimcap_typical
- `ff`: ff res_ff bjt_ff diode_ff moscap_ff mimcap_ff
- `ss`: ss res_ss bjt_ss diode_ss moscap_ss mimcap_ss
- `fs`: fs res_typical bjt_typical diode_typical moscap_typical mimcap_typical
- `sf`: sf res_typical bjt_typical diode_typical moscap_typical mimcap_typical

---

Written by `sim/run_corners.py`. Append-only: never edit or delete this
file — a re-run or correction mints a new record-id and points back here
via **Supersedes** (see `sim/README.md`).

## Stored evidence

The bytes of this run are in the fleet artifact store, not in git (issue #237). Manifest: `manifests/artifacts/driver-jitter-20261104-204926-2d31f87.manifest.json` (46 objects, 89284667 B). Paths above are the manifest `name`s. Fetch one, hash-verified, with:

```
klt artifact get manifests/artifacts/driver-jitter-20261104-204926-2d31f87.manifest.json#<name> -o <out>
klt artifact verify manifests/artifacts/driver-jitter-20261104-204926-2d31f87.manifest.json
```

| name | size (B) | sha256 |
|---|---:|---|
| `sim/driver-jitter/corners/20261104-204926-2d31f87/ff_-40c_2.97v.log` | 1985641 | `4e7f7c3b5da053e3a8ca4eb0a8be5907c02ed21a9e338bc6308c3f7acec82e87` |
| `sim/driver-jitter/corners/20261104-204926-2d31f87/ff_-40c_3.30v.log` | 1988093 | `fe8c29611b32ce5a170d4bf98cfe5d902c48d0dc8bb83294d5a05ab44417b00b` |
| `sim/driver-jitter/corners/20261104-204926-2d31f87/ff_-40c_3.63v.log` | 1990381 | `224c95180392e50b66f8445f300b926a51428004428ce78c2876311a7d05161b` |
| `sim/driver-jitter/corners/20261104-204926-2d31f87/ff_125c_2.97v.log` | 1982053 | `9268705e9e0a803373aba5facc71d96338375bcb82498587e5b91e1e176affed` |
| `sim/driver-jitter/corners/20261104-204926-2d31f87/ff_125c_3.30v.log` | 1983397 | `14e89f97d8373a1fbc003540d3ad48be14c4292e201379d2b5a52f1cf905c298` |
| `sim/driver-jitter/corners/20261104-204926-2d31f87/ff_125c_3.63v.log` | 1985765 | `24e93197aff0baf1e3cd79ee34f486426cc6f23b852151406e56c75a18b24bef` |
| `sim/driver-jitter/corners/20261104-204926-2d31f87/ff_27c_2.97v.log` | 1984049 | `3a54620990f6312240fbabdae9302f2cd4105bb219f85d4f1cbba97bc6d1cff4` |
| `sim/driver-jitter/corners/20261104-204926-2d31f87/ff_27c_3.30v.log` | 1986777 | `814b0f1bca49125c433430bc4c38ffdcb8159e3829642a69882667f6ab6a2362` |
| `sim/driver-jitter/corners/20261104-204926-2d31f87/ff_27c_3.63v.log` | 1988997 | `1d9cf4295b47b27c3e3de757c46195f90c3ad26d42ee65d8ea51013804c61e9c` |
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
| `sim/driver-jitter/netlist-snapshots/20261104-204926-2d31f87.spice` | 13274 | `3e19425a5e530748eb16bcc6fb111b156130c2a8514cfa16d9f3b600333f2bf5` |
