2AMLogic/gf180-usb2-phy/sim/driver-jitter/records/20261104-194449-bccb09f.md

# Record 20261104-194449-bccb09f

- **Record ID**: 20261104-194449-bccb09f
- **Claim**: spec/usb2-device-phy.md#82-what-gets-measured-and-against-which-section row 'Driver-output timing jitter' -- recorded as ENGINEERING DATA WITH NO SPEC LIMIT ATTACHED, which is what that row's own note mandates: the repo has no confirmed numeric USB 2.0 source-jitter limits from the physical specification text, and §8.2 explicitly says sim/ 'may record measured jitter as engineering data without a spec citation attached' until that pull happens. No jitter measurement below carries a min/max limit; the single check present is a harness-integrity spread floor, not a spec claim.
- **Netlist provenance**: schematic — DUT `design/netlist/differential_driver.spice` (sha256 `50dcbc20ca353357ffeaf63b347f5b76e218625921035e0c6c1692413b9a8930`), driven by `sim/driver-jitter/testbench/driver_jitter_tb.spice` — **taken against a dirty working tree** at commit `bccb09f44c6e700440b32aab37b90a8701c160b2`; not citable as a clean-tree result
- **Corner matrix run**:
  - Process: tt, ff, ss, fs, sf
  - Temperature: -40 °C, 27 °C, 125 °C
  - Supply: 2.97 V, 3.30 V, 3.63 V
  - 45 point full-factorial grid (process × temperature × supply), 45 completed
  - Full PVT matrix per CLAUDE.md (−40/27/125 °C, ±10 % supply, process corners).
- **Statistical convention**: N/A (corner-matrix claim, not a distribution claim)
- **Result**:

  | corner-id | tprop_ns | jit_grid_pp_ps | jit_grid_max_ps | jit_cons_pp_ps | jit_cons_max_ps | xings_extra_ps | pass/fail |
  |---|---|---|---|---|---|---|---|
  | `tt_-40c_2.97v` | 2.9719 | 0.3669 | 0.2331 | 0.6335 | 0.3333 | 0 | PASS |
  | `tt_-40c_3.30v` | 2.8749 | 0.3333 | 0.1995 | 0.5335 | 0.3333 | 0 | PASS |
  | `tt_-40c_3.63v` | 2.8069 | 0.3333 | 0.1995 | 0.5335 | 0.3333 | 0 | PASS |
  | `tt_27c_2.97v` | 3.3818 | 0.5337 | 0.2999 | 0.8335 | 0.5002 | 0 | PASS |
  | `tt_27c_3.30v` | 3.274 | 0.3337 | 0.2999 | 0.5335 | 0.3333 | 0 | PASS |
  | `tt_27c_3.63v` | 3.1968 | 0.4337 | 0.2338 | 0.7335 | 0.4002 | 0 | PASS |
  | `tt_125c_2.97v` | 3.9953 | 0.5995 | 0.5995 | 0.4335 | 0.3333 | 0 | PASS |
  | `tt_125c_3.30v` | 3.8709 | 0.4337 | 0.2999 | 0.7335 | 0.4002 | 0 | PASS |
  | `tt_125c_3.63v` | 3.7787 | 0.5002 | 0.3338 | 0.8335 | 0.5002 | 0 | PASS |
  | `ff_-40c_2.97v` | 2.6318 | 0.3337 | 0.2338 | 0.6335 | 0.3333 | 0 | PASS |
  | `ff_-40c_3.30v` | 2.5639 | 0.3333 | 0.1995 | 0.4335 | 0.3333 | 0 | PASS |
  | `ff_-40c_3.63v` | 2.516 | 0.3333 | 0.2995 | 0.4335 | 0.3333 | 0 | PASS |
  | `ff_27c_2.97v` | 2.986 | 0.3337 | 0.2999 | 0.6335 | 0.3333 | 0 | PASS |
  | `ff_27c_3.30v` | 2.9092 | 0.4995 | 0.4995 | 0.4 | 0.3333 | 0 | PASS |
  | `ff_27c_3.63v` | 2.8535 | 0.6667 | 0.4662 | 1.1665 | 0.6667 | 0 | PASS |
  | `ff_125c_2.97v` | 3.5152 | 0.4995 | 0.4995 | 0.4 | 0.3333 | 0 | PASS |
  | `ff_125c_3.30v` | 3.4245 | 0.6667 | 0.4662 | 1.0665 | 0.6667 | 0 | PASS |
  | `ff_125c_3.63v` | 3.3562 | 0.5662 | 0.4995 | 0.4 | 0.3333 | 0 | PASS |
  | `ss_-40c_2.97v` | 3.3849 | 0.6002 | 0.4664 | 1.0335 | 0.6002 | 0 | PASS |
  | `ss_-40c_3.30v` | 3.2458 | 0.5002 | 0.2664 | 0.8335 | 0.5002 | 0 | PASS |
  | `ss_-40c_3.63v` | 3.1494 | 0.6667 | 0.3662 | 0.8665 | 0.6667 | 0 | PASS |
  | `ss_27c_2.97v` | 3.8522 | 0.5999 | 0.5999 | 0.9335 | 0.5333 | 0 | PASS |
  | `ss_27c_3.30v` | 3.7003 | 0.5995 | 0.5995 | 0.6335 | 0.4333 | 0 | PASS |
  | `ss_27c_3.63v` | 3.5929 | 0.4337 | 0.2999 | 0.7335 | 0.4002 | 0 | PASS |
  | `ss_125c_2.97v` | 4.5548 | 1.0995 | 1.0995 | 1.0334 | 0.8333 | 0 | PASS |
  | `ss_125c_3.30v` | 4.3831 | 0.5664 | 0.5664 | 1.0335 | 0.5333 | 0 | PASS |
  | `ss_125c_3.63v` | 4.258 | 0.4337 | 0.3999 | 0.7335 | 0.4002 | 0 | PASS |
  | `fs_-40c_2.97v` | 2.981 | 0.367 | 0.3332 | 0.6335 | 0.3333 | 0 | PASS |
  | `fs_-40c_3.30v` | 2.8779 | 0.4002 | 0.2664 | 0.7335 | 0.4002 | 0 | PASS |
  | `fs_-40c_3.63v` | 2.8056 | 0.6667 | 0.5662 | 1.0665 | 0.6667 | 0 | PASS |
  | `fs_27c_2.97v` | 3.3886 | 0.8995 | 0.8995 | 0.4667 | 0.4333 | 0 | PASS |
  | `fs_27c_3.30v` | 3.2748 | 0.5337 | 0.2999 | 0.8335 | 0.5002 | 0 | PASS |
  | `fs_27c_3.63v` | 3.1933 | 0.6667 | 0.4005 | 0.8665 | 0.6667 | 0 | PASS |
  | `fs_125c_2.97v` | 3.9946 | 0.8995 | 0.8995 | 0.7335 | 0.6333 | 0 | PASS |
  | `fs_125c_3.30v` | 3.8652 | 0.4999 | 0.4999 | 0.7335 | 0.4333 | 0 | PASS |
  | `fs_125c_3.63v` | 3.7696 | 0.6667 | 0.5662 | 1 | 0.6667 | 0 | PASS |
  | `sf_-40c_2.97v` | 2.9893 | 0.5995 | 0.5995 | 0.4 | 0.3333 | 0 | PASS |
  | `sf_-40c_3.30v` | 2.8941 | 0.3995 | 0.3995 | 0.5 | 0.3333 | 0 | PASS |
  | `sf_-40c_3.63v` | 2.8275 | 0.6667 | 0.4662 | 1.0665 | 0.6667 | 0 | PASS |
  | `sf_27c_2.97v` | 3.4013 | 0.5995 | 0.5995 | 0.4335 | 0.3333 | 0 | PASS |
  | `sf_27c_3.30v` | 3.2953 | 0.5995 | 0.5995 | 0.4 | 0.3333 | 0 | PASS |
  | `sf_27c_3.63v` | 3.2194 | 0.6667 | 0.3662 | 0.9665 | 0.6667 | 0 | PASS |
  | `sf_125c_2.97v` | 4.0231 | 0.3995 | 0.3995 | 0.5335 | 0.3333 | 0 | PASS |
  | `sf_125c_3.30v` | 3.8995 | 0.6667 | 0.4662 | 1.0665 | 0.6667 | 0 | PASS |
  | `sf_125c_3.63v` | 3.8081 | 0.3995 | 0.3995 | 0.4 | 0.3333 | 0 | PASS |

  Spread across the grid:

  | measurement | min | max | mean | spread % | limits |
  |---|---|---|---|---|---|
  | `tprop_ns` | 2.516 (`ff_-40c_3.63v`) | 4.5548 (`ss_125c_2.97v`) | 3.36749 | 60.5436 | min_spread_pct=5 |
  | `jit_grid_pp_ps` | 0.3333 (`tt_-40c_3.30v`) | 1.0995 (`ss_125c_2.97v`) | 0.53772 | 142.491 | — |
  | `jit_grid_max_ps` | 0.1995 (`tt_-40c_3.30v`) | 1.0995 (`ss_125c_2.97v`) | 0.441189 | 203.994 | — |
  | `jit_cons_pp_ps` | 0.4 (`ff_27c_3.30v`) | 1.1665 (`ff_27c_3.63v`) | 0.711924 | 107.666 | — |
  | `jit_cons_max_ps` | 0.3333 (`tt_-40c_3.30v`) | 0.8333 (`ss_125c_2.97v`) | 0.461513 | 108.339 | — |
  | `xings_extra_ps` | 0 (`tt_-40c_2.97v`) | 0 (`tt_-40c_2.97v`) | 0 | n/a | — |

  - **Overall: PASS**
- **Links**:
  - Testbench: `sim/driver-jitter/testbench/driver_jitter_tb.spice`, `sim/driver-jitter/testbench/tb.json`
  - DUT netlist: `design/netlist/differential_driver.spice`
  - Netlist snapshot: `sim/driver-jitter/netlist-snapshots/20261104-194449-bccb09f.spice`
  - Raw logs: `sim/driver-jitter/corners/20261104-194449-bccb09f/`
- **Timestamp / author**: 2026-11-04T19:44:49+00:00, ubuntu
- **Supersedes**: 20261015-104027-d109790

## Environment

Everything needed to re-run this record:

- PDK: gf180mcuD @ open_pdks `c6d73a35f524070e85faff4a6a9eef49553ebc2b` (/home/ubuntu/.volare/gf180mcuD, found via search_root:~/.volare)
- ngspice: ngspice-None via `klt sim` (backend batch; submitting host had ngspice-42 : Circuit level simulation program)
- klt sim: version 0.8.0, backend `batch`, klt status `pass`, remote `{'provider': 'aws-batch-fleet', 'job_id': 'klt-sim-45c3f47e5606', 'region': 'us-east-1', 'instance_id': 'i-01eb97c745c1c8141', 'instance_type': 'c7i.8xlarge', 'availability_zone': 'us-east-1a', 'ami_id': 'ami-0fa5ef830209100bd', 'lifecycle': 'spot', 'spot': True, 'state': 'done', 'exit_code': '0', 'concurrency': '2', 'physical_cores': '16', 'elapsed_seconds': 41, 'runner_klt_version': '0.8.0', 'client_klt_version': '0.8.1.dev1317+ga2804ab99263', 'runner_compatibility': 'match'}`
- Harness: sim/harness 0.1.0, python 3.12.3
- git: `bccb09f44c6e700440b32aab37b90a8701c160b2` on `feature/issue-114` (dirty)
- Testbench netlist sha256: `33ecff4d9452dd90dcc489c765a8e23fb83df03b1e390e5177292555abd6e13f`
- DUT netlist: `design/netlist/differential_driver.spice` sha256 `50dcbc20ca353357ffeaf63b347f5b76e218625921035e0c6c1692413b9a8930`
- Manifest sha256: `38860a513bb18f5d9cadc39e81d5e8a2fab03c4362733145f3c3c06602a27175`
- Wall time: 171.93 s

Per-corner model sections used:

- `tt`: typical res_typical bjt_typical diode_typical moscap_typical mimcap_typical
- `ff`: ff res_ff bjt_ff diode_ff moscap_ff mimcap_ff
- `ss`: ss res_ss bjt_ss diode_ss moscap_ss mimcap_ss
- `fs`: fs res_typical bjt_typical diode_typical moscap_typical mimcap_typical
- `sf`: sf res_typical bjt_typical diode_typical moscap_typical mimcap_typical

---

Written by `sim/run_corners.py`. Append-only: never edit or delete this
file — a re-run or correction mints a new record-id and points back here
via **Supersedes** (see `sim/README.md`).

## Stored evidence

The bytes of this run are in the fleet artifact store, not in git (issue #237). Manifest: `manifests/artifacts/driver-jitter-20261104-194449-bccb09f.manifest.json` (46 objects, 89274373 B). Paths above are the manifest `name`s. Fetch one, hash-verified, with:

```
klt artifact get manifests/artifacts/driver-jitter-20261104-194449-bccb09f.manifest.json#<name> -o <out>
klt artifact verify manifests/artifacts/driver-jitter-20261104-194449-bccb09f.manifest.json
```

| name | size (B) | sha256 |
|---|---:|---|
| `sim/driver-jitter/corners/20261104-194449-bccb09f/ff_-40c_2.97v.log` | 1986609 | `70d68bf43c280b885bdf884f72f746e4f2821801b1ddcb3d156a2204acb11c59` |
| `sim/driver-jitter/corners/20261104-194449-bccb09f/ff_-40c_3.30v.log` | 1987957 | `be3507e8a78763993b72a62769d0eec672515b2050ee8e77dd480e12ce08c87e` |
| `sim/driver-jitter/corners/20261104-194449-bccb09f/ff_-40c_3.63v.log` | 1989261 | `c504307231765f74670bc2186b9948e1e86e09a534e6d38c459a4e7b8230c228` |
| `sim/driver-jitter/corners/20261104-194449-bccb09f/ff_125c_2.97v.log` | 1981061 | `5703e22a33f8977df9ca5e8d8d2afd7f8b715229026dda54d3653a45c01a118b` |
| `sim/driver-jitter/corners/20261104-194449-bccb09f/ff_125c_3.30v.log` | 1982385 | `590c9a349e9a2107c5efbdd23e08aa6927d09ec0425aaf9b6c6a555c2f5826f5` |
| `sim/driver-jitter/corners/20261104-194449-bccb09f/ff_125c_3.63v.log` | 1984821 | `cfa5c3fcd1aac3f1aec02bd37d2ff59982477372f082f6dfd090f5f330dee8ee` |
| `sim/driver-jitter/corners/20261104-194449-bccb09f/ff_27c_2.97v.log` | 1984037 | `b6ff47265f14c52c64b0910abe77e3c3074c813c571ebe4b4eb32dd0f8952b86` |
| `sim/driver-jitter/corners/20261104-194449-bccb09f/ff_27c_3.30v.log` | 1985421 | `cac392da8b5c5c6257eb2b213f3521977ba4f42b76a3f9cd1ce832963d8f5c23` |
| `sim/driver-jitter/corners/20261104-194449-bccb09f/ff_27c_3.63v.log` | 1986753 | `4e875eba416f2982d5024c628400bc9bcaf335ecd175c6357ba2081d61643748` |
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
| `sim/driver-jitter/netlist-snapshots/20261104-194449-bccb09f.spice` | 13272 | `0a10cc070aa453c7aaeeec6ddf30910e4e3cd19d4930c2cc33a4555289f34b28` |
