2AMLogic/gf180-usb2-phy/sim/driver-signal-quality/records/20261104-194138-bccb09f.md

# Record 20261104-194138-bccb09f

- **Record ID**: 20261104-194138-bccb09f
- **Claim**: spec/usb2-device-phy.md#6-driver-characteristics -- rise time 4-20 ns, fall time 4-20 ns, rise/fall matching within 10 %, crossover voltage 1.3-2.0 V, all into the ratified 50 pF test load; and spec/usb2-device-phy.md#82-what-gets-measured-and-against-which-section rows 'Rise/fall time', 'Crossover voltage' and 'Full-speed signal quality'.
- **Netlist provenance**: schematic — DUT `design/netlist/differential_driver.spice` (sha256 `50dcbc20ca353357ffeaf63b347f5b76e218625921035e0c6c1692413b9a8930`), driven by `sim/driver-signal-quality/testbench/driver_tb.spice` — **taken against a dirty working tree** at commit `bccb09f44c6e700440b32aab37b90a8701c160b2`; not citable as a clean-tree result
- **Corner matrix run**:
  - Process: tt, ff, ss, fs, sf
  - Temperature: -40 °C, 27 °C, 125 °C
  - Supply: 2.97 V, 3.30 V, 3.63 V
  - 45 point full-factorial grid (process × temperature × supply), 45 completed
  - Full PVT matrix per CLAUDE.md (−40/27/125 °C, ±10 % supply, process corners).
- **Statistical convention**: N/A (corner-matrix claim, not a distribution claim)
- **Result**:

  | corner-id | trise_ns | tfall_ns | trf_ratio | vcross_rise | vcross_fall | xing_extra_ps | dp_over_mv | dp_under_mv | pass/fail |
  |---|---|---|---|---|---|---|---|---|---|
  | `tt_-40c_2.97v` | 4.85913 | 4.68616 | 1.03691 | 1.40499 | 1.40461 | 0 | 0.308097 | -0.636339 | PASS |
  | `tt_-40c_3.30v` | 4.7111 | 4.60994 | 1.02194 | 1.58554 | 1.5854 | 0 | 0.272005 | -0.605967 | PASS |
  | `tt_-40c_3.63v` | 4.60249 | 4.55782 | 1.0098 | 1.76638 | 1.76576 | 0 | 0.240419 | -0.57429 | PASS |
  | `tt_27c_2.97v` | 5.98929 | 5.84144 | 1.02531 | 1.41657 | 1.41619 | 0 | 0.271603 | -0.588974 | PASS |
  | `tt_27c_3.30v` | 5.82169 | 5.74264 | 1.01377 | 1.59384 | 1.5932 | 0 | 0.247006 | -0.552786 | PASS |
  | `tt_27c_3.63v` | 5.69677 | 5.67227 | 1.00432 | 1.77065 | 1.77034 | 0 | 0.222591 | -0.520805 | PASS |
  | `tt_125c_2.97v` | 7.60456 | 7.59893 | 1.00074 | 1.43699 | 1.43685 | 0 | 0.238419 | -0.507013 | PASS |
  | `tt_125c_3.30v` | 7.41054 | 7.45651 | 0.993834 | 1.61089 | 1.61088 | 0 | 0.209637 | -0.479657 | PASS |
  | `tt_125c_3.63v` | 7.26203 | 7.34989 | 0.988046 | 1.78479 | 1.78456 | 0 | 0.190424 | -0.452704 | PASS |
  | `ff_-40c_2.97v` | 4.22356 | 4.13795 | 1.02069 | 1.42448 | 1.42441 | 0 | 0.217989 | -0.530601 | PASS |
  | `ff_-40c_3.30v` | 4.11266 | 4.0832 | 1.00722 | 1.60304 | 1.60333 | 0 | 0.191197 | -0.504443 | PASS |
  | `ff_-40c_3.63v` | 4.03035 | 4.04597 | 0.99614 | 1.78254 | 1.78215 | 0 | 0.178504 | -0.481746 | PASS |
  | `ff_27c_2.97v` | 5.20628 | 5.14192 | 1.01252 | 1.43248 | 1.43191 | 0 | 0.198654 | -0.47862 | PASS |
  | `ff_27c_3.30v` | 5.07919 | 5.06816 | 1.00218 | 1.60793 | 1.60804 | 0 | 0.17758 | -0.447655 | PASS |
  | `ff_27c_3.63v` | 4.98326 | 5.0157 | 0.993533 | 1.7838 | 1.7838 | 0 | 0.164529 | -0.425294 | PASS |
  | `ff_125c_2.97v` | 6.61038 | 6.66624 | 0.991622 | 1.44911 | 1.44931 | 0 | 0.158875 | -0.396502 | PASS |
  | `ff_125c_3.30v` | 6.46053 | 6.5558 | 0.985468 | 1.62203 | 1.62208 | 0 | 0.139365 | -0.369714 | PASS |
  | `ff_125c_3.63v` | 6.3441 | 6.47261 | 0.980145 | 1.79493 | 1.79492 | 0 | 0.12618 | -0.350417 | PASS |
  | `ss_-40c_2.97v` | 5.55682 | 5.28677 | 1.05108 | 1.38577 | 1.38546 | 0 | 0.430153 | -0.760452 | PASS |
  | `ss_-40c_3.30v` | 5.35795 | 5.17896 | 1.03456 | 1.5679 | 1.56753 | 0 | 0.369022 | -0.70802 | PASS |
  | `ss_-40c_3.63v` | 5.21425 | 5.10524 | 1.02135 | 1.74939 | 1.74926 | 0 | 0.333203 | -0.676592 | PASS |
  | `ss_27c_2.97v` | 6.83615 | 6.5938 | 1.03675 | 1.40002 | 1.39978 | 0 | 0.386546 | -0.701157 | PASS |
  | `ss_27c_3.30v` | 6.61373 | 6.4598 | 1.02383 | 1.5786 | 1.57848 | 0 | 0.344764 | -0.65869 | PASS |
  | `ss_27c_3.63v` | 6.45067 | 6.36491 | 1.01347 | 1.7568 | 1.75637 | 0 | 0.29679 | -0.619676 | PASS |
  | `ss_125c_2.97v` | 8.66446 | 8.59125 | 1.00852 | 1.42388 | 1.42384 | 0 | 0.345831 | -0.619298 | PASS |
  | `ss_125c_3.30v` | 8.41174 | 8.40605 | 1.00068 | 1.59932 | 1.59924 | 0 | 0.30214 | -0.58388 | PASS |
  | `ss_125c_3.63v` | 8.22169 | 8.26872 | 0.994312 | 1.77451 | 1.7741 | 0 | 0.268309 | -0.551508 | PASS |
  | `fs_-40c_2.97v` | 5.05189 | 4.56846 | 1.10582 | 1.33958 | 1.33918 | 0 | 0.273373 | -0.720303 | FAIL — trf_ratio max=1.1 (got 1.10582) |
  | `fs_-40c_3.30v` | 4.87091 | 4.50835 | 1.08042 | 1.52052 | 1.52065 | 0 | 0.227568 | -0.677941 | PASS |
  | `fs_-40c_3.63v` | 4.73969 | 4.46748 | 1.06093 | 1.70175 | 1.70081 | 0 | 0.205555 | -0.642306 | PASS |
  | `fs_27c_2.97v` | 6.20204 | 5.70244 | 1.08761 | 1.36167 | 1.36142 | 0 | 0.249141 | -0.661346 | PASS |
  | `fs_27c_3.30v` | 5.99911 | 5.6221 | 1.06706 | 1.53955 | 1.53951 | 0 | 0.210738 | -0.619845 | PASS |
  | `fs_27c_3.63v` | 5.84958 | 5.56493 | 1.05115 | 1.71653 | 1.71651 | 0 | 0.180558 | -0.585408 | PASS |
  | `fs_125c_2.97v` | 7.84071 | 7.41931 | 1.0568 | 1.39164 | 1.39122 | 0 | 0.203147 | -0.580724 | PASS |
  | `fs_125c_3.30v` | 7.60927 | 7.3002 | 1.04234 | 1.56584 | 1.56552 | 0 | 0.175468 | -0.546819 | PASS |
  | `fs_125c_3.63v` | 7.43413 | 7.21063 | 1.031 | 1.73939 | 1.73937 | 0 | 0.148892 | -0.517265 | PASS |
  | `sf_-40c_2.97v` | 4.69589 | 4.83667 | 0.970892 | 1.47385 | 1.47331 | 0 | 0.340628 | -0.563451 | PASS |
  | `sf_-40c_3.30v` | 4.57372 | 4.73843 | 0.965241 | 1.65366 | 1.65306 | 0 | 0.295421 | -0.536957 | PASS |
  | `sf_-40c_3.63v` | 4.48331 | 4.67101 | 0.959817 | 1.8341 | 1.83376 | 0 | 0.267094 | -0.509374 | PASS |
  | `sf_27c_2.97v` | 5.80715 | 6.01307 | 0.965754 | 1.47313 | 1.4729 | 0 | 0.316243 | -0.518052 | PASS |
  | `sf_27c_3.30v` | 5.66756 | 5.88985 | 0.96226 | 1.65018 | 1.64993 | 0 | 0.276111 | -0.485966 | PASS |
  | `sf_27c_3.63v` | 5.56269 | 5.80241 | 0.958686 | 1.82692 | 1.82693 | 0 | 0.244509 | -0.458033 | PASS |
  | `sf_125c_2.97v` | 7.3997 | 7.81408 | 0.94697 | 1.48414 | 1.48392 | 0 | 0.272411 | -0.431906 | PASS |
  | `sf_125c_3.30v` | 7.23581 | 7.64218 | 0.946825 | 1.65815 | 1.65776 | 0 | 0.243793 | -0.409323 | PASS |
  | `sf_125c_3.63v` | 7.10924 | 7.51431 | 0.946094 | 1.8321 | 1.83207 | 0 | 0.219325 | -0.385766 | PASS |

  Spread across the grid:

  | measurement | min | max | mean | spread % | limits |
  |---|---|---|---|---|---|
  | `trise_ns` | 4.03035 (`ff_-40c_3.63v`) | 8.66446 (`ss_125c_2.97v`) | 6.0104 | 77.1015 | min=4, max=20 |
  | `tfall_ns` | 4.04597 (`ff_-40c_3.63v`) | 8.59125 (`ss_125c_2.97v`) | 5.96099 | 76.2504 | min=4, max=20 |
  | `trf_ratio` | 0.946094 (`sf_125c_3.63v`) | 1.10582 (`fs_-40c_2.97v`) | 1.01054 | 15.8058 | min=0.9, max=1.1 |
  | `vcross_rise` | 1.33958 (`fs_-40c_2.97v`) | 1.8341 (`sf_-40c_3.63v`) | 1.59711 | 30.9632 | min=1.3, max=2 |
  | `vcross_fall` | 1.33918 (`fs_-40c_2.97v`) | 1.83376 (`sf_-40c_3.63v`) | 1.59688 | 30.972 | min=1.3, max=2 |
  | `xing_extra_ps` | 0 (`tt_-40c_2.97v`) | 0 (`tt_-40c_2.97v`) | 0 | n/a | min=-1, max=1 |
  | `dp_over_mv` | 0.12618 (`ff_125c_3.63v`) | 0.430153 (`ss_-40c_2.97v`) | 0.24844 | 122.353 | min=-50, max=50 |
  | `dp_under_mv` | -0.760452 (`ss_-40c_2.97v`) | -0.350417 (`ff_125c_3.63v`) | -0.547413 | 74.9041 | min=-50, max=50 |

  - **Overall: FAIL**
- **Links**:
  - Testbench: `sim/driver-signal-quality/testbench/driver_tb.spice`, `sim/driver-signal-quality/testbench/tb.json`
  - DUT netlist: `design/netlist/differential_driver.spice`
  - Netlist snapshot: `sim/driver-signal-quality/netlist-snapshots/20261104-194138-bccb09f.spice`
  - Raw logs: `sim/driver-signal-quality/corners/20261104-194138-bccb09f/`
- **Timestamp / author**: 2026-11-04T19:41:38+00:00, ubuntu
- **Supersedes**: 20261015-104027-d109790

## Environment

Everything needed to re-run this record:

- PDK: gf180mcuD @ open_pdks `c6d73a35f524070e85faff4a6a9eef49553ebc2b` (/home/ubuntu/.volare/gf180mcuD, found via search_root:~/.volare)
- ngspice: ngspice-None via `klt sim` (backend batch; submitting host had ngspice-42 : Circuit level simulation program)
- klt sim: version 0.8.0, backend `batch`, klt status `pass`, remote `{'provider': 'aws-batch-fleet', 'job_id': 'klt-sim-94773e0c253e', 'region': 'us-east-1', 'instance_id': 'i-0865da80a81fde403', 'instance_type': 'c7i.8xlarge', 'availability_zone': 'us-east-1a', 'ami_id': 'ami-0fa5ef830209100bd', 'lifecycle': 'spot', 'spot': True, 'state': 'done', 'exit_code': '0', 'concurrency': '2', 'physical_cores': '16', 'elapsed_seconds': 23, 'runner_klt_version': '0.8.0', 'client_klt_version': '0.8.1.dev1317+ga2804ab99263', 'runner_compatibility': 'match'}`
- Harness: sim/harness 0.1.0, python 3.12.3
- git: `bccb09f44c6e700440b32aab37b90a8701c160b2` on `feature/issue-114` (dirty)
- Testbench netlist sha256: `782b3fddae62244a3dc4a620b73e4cd147f12ed8c5b7e05eea4ed24701e1b729`
- DUT netlist: `design/netlist/differential_driver.spice` sha256 `50dcbc20ca353357ffeaf63b347f5b76e218625921035e0c6c1692413b9a8930`
- Manifest sha256: `4a2887e51394239a834690b685f4756db62b2b138979f3f053f0386837b5adbf`
- Wall time: 173.07 s

Per-corner model sections used:

- `tt`: typical res_typical bjt_typical diode_typical moscap_typical mimcap_typical
- `ff`: ff res_ff bjt_ff diode_ff moscap_ff mimcap_ff
- `ss`: ss res_ss bjt_ss diode_ss moscap_ss mimcap_ss
- `fs`: fs res_typical bjt_typical diode_typical moscap_typical mimcap_typical
- `sf`: sf res_typical bjt_typical diode_typical moscap_typical mimcap_typical

---

Written by `sim/run_corners.py`. Append-only: never edit or delete this
file — a re-run or correction mints a new record-id and points back here
via **Supersedes** (see `sim/README.md`).

## Stored evidence

The bytes of this run are in the fleet artifact store, not in git (issue #237). Manifest: `manifests/artifacts/driver-signal-quality-20261104-194138-bccb09f.manifest.json` (46 objects, 190409 B). Paths above are the manifest `name`s. Fetch one, hash-verified, with:

```
klt artifact get manifests/artifacts/driver-signal-quality-20261104-194138-bccb09f.manifest.json#<name> -o <out>
klt artifact verify manifests/artifacts/driver-signal-quality-20261104-194138-bccb09f.manifest.json
```

| name | size (B) | sha256 |
|---|---:|---|
| `sim/driver-signal-quality/corners/20261104-194138-bccb09f/ff_-40c_2.97v.log` | 3959 | `cae8a31417674bf76c9c35135703a6d923a3a6b9526bfafdaaf117c3672bbc52` |
| `sim/driver-signal-quality/corners/20261104-194138-bccb09f/ff_-40c_3.30v.log` | 3959 | `fb78f75ebcfffd0d07659b07f0dc4266dc25382d6e6bda8a95c673c1a23062fc` |
| `sim/driver-signal-quality/corners/20261104-194138-bccb09f/ff_-40c_3.63v.log` | 3959 | `34335e8843a575d06262b44804ead35709f8d2e8e5cf0df413dbcada9f54b077` |
| `sim/driver-signal-quality/corners/20261104-194138-bccb09f/ff_125c_2.97v.log` | 3895 | `5f3f155ff2b82654f73ae7ba74a12f42dec9d57f31d39752a171ac67d21ce480` |
| `sim/driver-signal-quality/corners/20261104-194138-bccb09f/ff_125c_3.30v.log` | 3959 | `548ee2c56fc92410dccc8c18f5caa27113f73105860af11917c81fe35ba2a59a` |
| `sim/driver-signal-quality/corners/20261104-194138-bccb09f/ff_125c_3.63v.log` | 3959 | `39d1cd9672ce42aca2c97b123b5f316d5b627ef5f8b0fa0d501cb9d0b78da128` |
| `sim/driver-signal-quality/corners/20261104-194138-bccb09f/ff_27c_2.97v.log` | 3925 | `53f0bdff8aaf3db1941fb06f49e6bd4413a4837fdfac62d9affcedb8d539489c` |
| `sim/driver-signal-quality/corners/20261104-194138-bccb09f/ff_27c_3.30v.log` | 3989 | `651ff2e05b139e52cc38a2cfc1417b8e8495e1dcaebf1de62d35876eb33c6000` |
| `sim/driver-signal-quality/corners/20261104-194138-bccb09f/ff_27c_3.63v.log` | 3957 | `1386c22732ca815680c096294587680ffb8164ea0e24c880776312b7cc3e2cd2` |
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
| `sim/driver-signal-quality/netlist-snapshots/20261104-194138-bccb09f.spice` | 12796 | `e42d271d56b311def1fd4ae5673cfde9d6676a11b09a2923316f251c8289ab4f` |
