2AMLogic/gf180-usb2-phy/sim/dplus-pullup-tolerance/records/20261030-212701-7134cc0.md

# Record 20261030-212701-7134cc0

- **Record ID**: 20261030-212701-7134cc0
- **Claim**: spec/usb2-device-phy.md#5-d-pull-up -- nominal 1.5 kΩ, tolerance ±5 % (1.425-1.575 kΩ) across the full PVT envelope, with the trim ladder §5 requires; and spec/usb2-device-phy.md#82-what-gets-measured-and-against-which-section row 'D+ pull-up tolerance'.
- **Netlist provenance**: schematic — DUT `sim/dplus-pullup-tolerance/dut/dplus_pullup_grid_snapped.spice` (sha256 `452d5ce6905b0d8a92d1405af1ba13ed423ffcf8e30f59dad0f0218cb09f719a`), driven by `sim/dplus-pullup-tolerance/testbench/pullup_tb.spice` — **taken against a dirty working tree** at commit `7134cc091abfaffa805f464773c103e9f7378254`; not citable as a clean-tree result
- **Corner matrix run**:
  - Process: tt, ff, ss, fs, sf
  - Temperature: -40 °C, 27 °C, 125 °C
  - Supply: 2.97 V, 3.30 V, 3.63 V
  - 45 point full-factorial grid (process × temperature × supply), 45 completed
  - Full PVT matrix per CLAUDE.md (−40/27/125 °C, ±10 % supply, process corners).
- **Statistical convention**: N/A (corner-matrix claim, not a distribution claim)
- **Result**:

  | corner-id | r_code0_ohm | r_code31_ohm | r_best_ohm | best_code | best_err_pct | trim_step_pct | pass/fail |
  |---|---|---|---|---|---|---|---|
  | `tt_-40c_2.97v` | 2183.46 | 1080.51 | 1506.81 | 19 | 0.453739 | 3.29282 | PASS |
  | `tt_-40c_3.30v` | 2183.19 | 1078.69 | 1505.6 | 19 | 0.373074 | 3.303 | PASS |
  | `tt_-40c_3.63v` | 2182.99 | 1077.34 | 1504.7 | 19 | 0.313121 | 3.31059 | PASS |
  | `tt_27c_2.97v` | 2148 | 1068.65 | 1484.1 | 20 | 1.05983 | 3.25811 | PASS |
  | `tt_27c_3.30v` | 2147.67 | 1067.87 | 1485.42 | 20 | 0.97221 | 3.26181 | PASS |
  | `tt_27c_3.63v` | 2147.42 | 1067.69 | 1486.57 | 20 | 0.895616 | 3.26218 | PASS |
  | `tt_125c_2.97v` | 2120.62 | 1068.38 | 1472.6 | 19 | 1.82652 | 3.17708 | PASS |
  | `tt_125c_3.30v` | 2120.2 | 1066.69 | 1471.86 | 19 | 1.87571 | 3.18594 | PASS |
  | `tt_125c_3.63v` | 2119.88 | 1065.63 | 1471.52 | 19 | 1.8985 | 3.19135 | PASS |
  | `ff_-40c_2.97v` | 1787.2 | 872.828 | 1501.34 | 9 | 0.0894368 | 3.37934 | PASS |
  | `ff_-40c_3.30v` | 1786.99 | 871.487 | 1500.68 | 9 | 0.045308 | 3.38873 | PASS |
  | `ff_-40c_3.63v` | 1786.83 | 872.618 | 1502.38 | 9 | 0.158781 | 3.37958 | PASS |
  | `ff_27c_2.97v` | 1755.17 | 863.474 | 1498.48 | 7 | 0.100973 | 3.33123 | PASS |
  | `ff_27c_3.30v` | 1754.91 | 863.554 | 1499.22 | 7 | 0.0520955 | 3.32966 | PASS |
  | `ff_27c_3.63v` | 1754.71 | 863.529 | 1499.69 | 7 | 0.0208466 | 3.32911 | PASS |
  | `ff_125c_2.97v` | 1728.38 | 862.248 | 1507.41 | 8 | 0.493753 | 3.24033 | PASS |
  | `ff_125c_3.30v` | 1728.05 | 861.369 | 1508.68 | 8 | 0.578809 | 3.24571 | PASS |
  | `ff_125c_3.63v` | 1727.8 | 860.71 | 1509.71 | 8 | 0.647548 | 3.2497 | PASS |
  | `ss_-40c_2.97v` | 2579.79 | 1288.86 | 1464.83 | 28 | 2.34451 | 3.23097 | PASS |
  | `ss_-40c_3.30v` | 2579.44 | 1286.4 | 1536.57 | 26 | 2.43778 | 3.24244 | PASS |
  | `ss_-40c_3.63v` | 2579.18 | 1284.6 | 1535.34 | 26 | 2.35565 | 3.25087 | PASS |
  | `ss_27c_2.97v` | 2540.91 | 1275.99 | 1514.9 | 26 | 0.993166 | 3.19783 | PASS |
  | `ss_27c_3.30v` | 2540.49 | 1273.26 | 1513.33 | 26 | 0.888777 | 3.21051 | PASS |
  | `ss_27c_3.63v` | 2540.17 | 1272.81 | 1513.83 | 26 | 0.92164 | 3.21202 | PASS |
  | `ss_125c_2.97v` | 2512.95 | 1276.57 | 1504.57 | 26 | 0.304389 | 3.12423 | PASS |
  | `ss_125c_3.30v` | 2512.43 | 1273 | 1502.28 | 26 | 0.151987 | 3.14073 | PASS |
  | `ss_125c_3.63v` | 2512.03 | 1271.4 | 1501.7 | 26 | 0.113229 | 3.1477 | PASS |
  | `fs_-40c_2.97v` | 2183.81 | 1082.83 | 1508.35 | 19 | 0.556884 | 3.27985 | PASS |
  | `fs_-40c_3.30v` | 2183.49 | 1080.65 | 1506.9 | 19 | 0.459927 | 3.29204 | PASS |
  | `fs_-40c_3.63v` | 2183.24 | 1079.04 | 1505.83 | 19 | 0.3885 | 3.30106 | PASS |
  | `fs_27c_2.97v` | 2148.42 | 1071.39 | 1485.58 | 19 | 0.961522 | 3.2428 | PASS |
  | `fs_27c_3.30v` | 2148.03 | 1069.37 | 1485.33 | 20 | 0.977743 | 3.25383 | PASS |
  | `fs_27c_3.63v` | 2147.73 | 1068.96 | 1486.47 | 20 | 0.901691 | 3.25539 | PASS |
  | `fs_125c_2.97v` | 2121.12 | 1071.87 | 1475.02 | 19 | 1.6655 | 3.15773 | PASS |
  | `fs_125c_3.30v` | 2120.64 | 1068.99 | 1473.22 | 19 | 1.78561 | 3.17347 | PASS |
  | `fs_125c_3.63v` | 2120.26 | 1067.58 | 1472.64 | 19 | 1.824 | 3.1808 | PASS |
  | `sf_-40c_2.97v` | 2183.14 | 1078.41 | 1505.41 | 19 | 0.360796 | 3.30454 | PASS |
  | `sf_-40c_3.30v` | 2182.92 | 1076.9 | 1504.41 | 19 | 0.293837 | 3.31302 | PASS |
  | `sf_-40c_3.63v` | 2182.75 | 1075.77 | 1503.66 | 19 | 0.243708 | 3.31938 | PASS |
  | `sf_27c_2.97v` | 2147.62 | 1066.85 | 1484.4 | 20 | 1.03975 | 3.26792 | PASS |
  | `sf_27c_3.30v` | 2147.34 | 1066.85 | 1485.91 | 20 | 0.939294 | 3.26707 | PASS |
  | `sf_27c_3.63v` | 2147.13 | 1066.83 | 1487.04 | 20 | 0.86435 | 3.26656 | PASS |
  | `sf_125c_2.97v` | 2120.16 | 1065.87 | 1528.6 | 18 | 1.90642 | 3.19078 | PASS |
  | `sf_125c_3.30v` | 2119.81 | 1064.79 | 1528.84 | 18 | 1.92231 | 3.19622 | PASS |
  | `sf_125c_3.63v` | 2119.53 | 1064.02 | 1529.13 | 18 | 1.94179 | 3.19998 | PASS |

  Spread across the grid:

  | measurement | min | max | mean | spread % | limits |
  |---|---|---|---|---|---|
  | `r_code0_ohm` | 1727.8 (`ff_125c_3.63v`) | 2579.79 (`ss_-40c_2.97v`) | 2150.4 | 39.6201 | min_spread_pct=10 |
  | `r_code31_ohm` | 860.71 (`ff_125c_3.63v`) | 1288.86 (`ss_-40c_2.97v`) | 1071.62 | 39.9534 | — |
  | `r_best_ohm` | 1464.83 (`ss_-40c_2.97v`) | 1536.57 (`ss_-40c_3.30v`) | 1499.13 | 4.78511 | min=1425, max=1575 |
  | `best_code` | 7 (`ff_27c_2.97v`) | 28 (`ss_-40c_2.97v`) | 18.3556 | 114.407 | — |
  | `best_err_pct` | 0.0208466 (`ff_27c_3.63v`) | 2.43778 (`ss_-40c_3.30v`) | 0.920014 | 262.706 | min=0, max=5 |
  | `trim_step_pct` | 3.12423 (`ss_125c_2.97v`) | 3.38873 (`ff_-40c_3.30v`) | 3.25191 | 8.13371 | — |

  - **Overall: PASS**
- **Links**:
  - Testbench: `sim/dplus-pullup-tolerance/testbench/pullup_tb.spice`, `sim/dplus-pullup-tolerance/testbench/tb.json`
  - DUT netlist: `sim/dplus-pullup-tolerance/dut/dplus_pullup_grid_snapped.spice`
  - Netlist snapshot: `sim/dplus-pullup-tolerance/netlist-snapshots/20261030-212701-7134cc0.spice`
  - Raw logs: `sim/dplus-pullup-tolerance/corners/20261030-212701-7134cc0/`
- **Timestamp / author**: 2026-10-30T21:27:01+00:00, ubuntu
- **Supersedes**: (none)

## Environment

Everything needed to re-run this record:

- PDK: gf180mcuD @ open_pdks `c6d73a35f524070e85faff4a6a9eef49553ebc2b` (/home/ubuntu/.volare/gf180mcuD, found via PDK_ROOT)
- ngspice: ngspice-46 via `klt sim` (backend batch; submitting host had ngspice-42 : Circuit level simulation program)
- klt sim: version 0.8.1.dev835+geae64ef5dc41, backend `batch`, klt status `pass`, remote `{'provider': 'aws-batch-fleet', 'job_id': 'klt-sim-3359ffde72a9', 'region': 'us-east-1', 'instance_id': 'i-01710afcd4900e8d5', 'instance_type': 'c7i.8xlarge', 'availability_zone': 'us-east-1a', 'ami_id': 'ami-0fa5ef830209100bd', 'lifecycle': 'spot', 'spot': True, 'state': 'done', 'exit_code': '0', 'concurrency': '2', 'physical_cores': '16', 'elapsed_seconds': 22, 'client_submitted_at': '2026-10-30T21:27:01.488966Z', 'client_launched_at': '2026-10-30T21:27:22.863962Z', 'client_status_terminal_at': '2026-10-30T21:28:24.998869Z', 'client_collected_at': '2026-10-30T21:28:26.002281Z', 'runner_klt_version': '0.8.0', 'client_klt_version': '0.8.1.dev835+geae64ef5dc41', 'runner_compatibility': 'match', 'runner_request_features': {'required': ['measurements[].expr'], 'missing': [], 'status': 'supported'}, 'worker_environment': {'capture': 'ok', 'simulator': {'requested_binary': 'ngspice', 'binary_source': 'PATH', 'selected_path': '/usr/local/bin/ngspice', 'version_banner': '******\n** ngspice-46 : Circuit level simulation program\n** Compiled with KLU Direct Linear Solver\n** The U. C. Berkeley CAD Group\n** Copyright 1985-1994, Regents of the University of California.\n** Copyright 2001-2025, The ngspice team.\n** Please get your ngspice manual from https://ngspice.sourceforge.io/docs.html\n** Please file your bug-reports at http://ngspice.sourceforge.net/bugrep.html\n** Creation Date: Thu Oct  1 23:51:59 UTC 2026\n******\n', 'version_probe': 'ok'}, 'pdk': {'variant': 'gf180mcuD', 'root': '/opt/pdk', 'stamp_scheme': 'sources-sha256', 'stamp_sha256': 'd5ac52956829da3fee35d0b307d4e6cb83ae0e6535b56dba2eefed61cdffaf9b', 'stamp_text': 'open_pdks c6d73a35f524070e85faff4a6a9eef49553ebc2b', 'models_staged': False, 'stamp_scope': 'executed'}, 'cpu_model': 'Intel(R) Xeon(R) Platinum 8488C', 'omp_num_threads': None, 'image_manifest': None, 'model_inputs': None, 'diagnostics': [], 'pdk_stamp_comparison': {'status': 'match'}, 'engine_build_comparison': {'status': 'mismatch', 'warning': "the worker's ngspice --version banner differs from the local binary's; build options (e.g. FFT linkage) may differ, so results derived from them can differ from a local run"}}, 'runner_model_inputs': None, 'job_ceiling': {'basis': 'conservative_serial_bound', 'unit_count': 45, 'per_unit_timeout_s': 300, 'overhead_s': 120.0, 'job_bound_s': 13620.0, 'max_job_seconds': 3600.0, 'max_job_seconds_source': 'fleet_config', 'exceeds_ceiling': True, 'check': 'warn', 'max_units_per_job': 11, 'recommended_hosts': 5, 'warning': "batch job bound 13620s (options.timeout_s 300s x 45 units + 120s; a conservative fully-serial upper bound, not a runtime estimate) exceeds the fleet's whole-job ceiling of 3600s (max_job_seconds from fleet_config); a job still running at the ceiling is killed and every unit is reported batch_job_timeout. Set request.remote.hosts to at least 5 to run one job per shard of at most 11 units, each within the ceiling"}}`
- Harness: sim/harness 0.1.0, python 3.12.3
- git: `7134cc091abfaffa805f464773c103e9f7378254` on `feature/issue-251` (dirty)
- Testbench netlist sha256: `ef7ab6c6b85957fd263b7d07518c14947bad049669d103987bb583da173e274c`
- DUT netlist: `sim/dplus-pullup-tolerance/dut/dplus_pullup_grid_snapped.spice` sha256 `452d5ce6905b0d8a92d1405af1ba13ed423ffcf8e30f59dad0f0218cb09f719a`
- Manifest sha256: `e6277119afb0c1ae9e2a8d2892ce3c67d1d2d45d4fa8705907430bccc171406f`
- Wall time: 84.93 s

Per-corner model sections used:

- `tt`: typical res_typical bjt_typical diode_typical moscap_typical mimcap_typical
- `ff`: ff res_ff bjt_ff diode_ff moscap_ff mimcap_ff
- `ss`: ss res_ss bjt_ss diode_ss moscap_ss mimcap_ss
- `fs`: fs res_typical bjt_typical diode_typical moscap_typical mimcap_typical
- `sf`: sf res_typical bjt_typical diode_typical moscap_typical mimcap_typical

---

Written by `sim/run_corners.py`. Append-only: never edit or delete this
file — a re-run or correction mints a new record-id and points back here
via **Supersedes** (see `sim/README.md`).

## Stored evidence

The bytes of this run are in the fleet artifact store, not in git (issue #237). Manifest: `manifests/artifacts/dplus-pullup-tolerance-20261030-212701-7134cc0.manifest.json` (46 objects, 41776 B). Paths above are the manifest `name`s. Fetch one, hash-verified, with:

```
klt artifact get manifests/artifacts/dplus-pullup-tolerance-20261030-212701-7134cc0.manifest.json#<name> -o <out>
klt artifact verify manifests/artifacts/dplus-pullup-tolerance-20261030-212701-7134cc0.manifest.json
```

| name | size (B) | sha256 |
|---|---:|---|
| `sim/dplus-pullup-tolerance/corners/20261030-212701-7134cc0/ff_-40c_2.97v.log` | 400 | `456f5005af2bde8e00e284c1242f8794d5ea1b65a780e6024e94125ebe734657` |
| `sim/dplus-pullup-tolerance/corners/20261030-212701-7134cc0/ff_-40c_3.30v.log` | 400 | `465c443c8d6d22f546a01caf2d5db920b051df851ef9cca2f9c18cb4c557c039` |
| `sim/dplus-pullup-tolerance/corners/20261030-212701-7134cc0/ff_-40c_3.63v.log` | 400 | `5eee243a43f2b400e98ac1507f13317cb121f14787b4e6bcc2bb966efe163ad8` |
| `sim/dplus-pullup-tolerance/corners/20261030-212701-7134cc0/ff_125c_2.97v.log` | 400 | `51abc56ece6a3761e057b71caeed38571462e4d8088a90d7b0617dc116e29811` |
| `sim/dplus-pullup-tolerance/corners/20261030-212701-7134cc0/ff_125c_3.30v.log` | 400 | `e65dc1efc41bbaa5a0074991d1ea0c99a76344902f5e74717de0b884785accb4` |
| `sim/dplus-pullup-tolerance/corners/20261030-212701-7134cc0/ff_125c_3.63v.log` | 400 | `ff11a89a1c074d24d41d0d5c8a94d51eddeac8d8475c89b7d5990f6ad6d4a54b` |
| `sim/dplus-pullup-tolerance/corners/20261030-212701-7134cc0/ff_27c_2.97v.log` | 399 | `9eb45755bc384a3c894c21d14aa86af4b0a0b4d15568e5453191428c84c318bc` |
| `sim/dplus-pullup-tolerance/corners/20261030-212701-7134cc0/ff_27c_3.30v.log` | 399 | `76ed70af63aaf8b39e2485a6371d452073502e754041a7d954a5832d1a9d867f` |
| `sim/dplus-pullup-tolerance/corners/20261030-212701-7134cc0/ff_27c_3.63v.log` | 399 | `53451d2fe83ed71b3255d8025d599edbb4282bd7138093d45dd59df3b9b45ae3` |
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
| `sim/dplus-pullup-tolerance/netlist-snapshots/20261030-212701-7134cc0.spice` | 23791 | `cee4616fbb2a85dfa0c0b4ef9d9786f4879540c2a805a9463a91ad2f03dc9c1e` |
