2AMLogic/gf180-usb2-phy/sim/smoke-inverter/records/20261024-122053-b8bbc48.md

# Record 20261024-122053-b8bbc48

- **Record ID**: 20261024-122053-b8bbc48
- **Claim**: None -- harness self-verification, not a spec claim. Proves the PVT plumbing (parameter substitution, .lib corner sections, .temp) actually takes effect, so later records against ratified spec lines (spec/usb2-device-phy.md) can be trusted.
- **Netlist provenance**: schematic (`sim/smoke-inverter/testbench/smoke_inverter.spice`)
- **Corner matrix run**:
  - Process: tt, ff, ss, fs, sf
  - Temperature: -40 °C, 27 °C, 125 °C
  - Supply: 2.97 V, 3.30 V, 3.63 V
  - 45 point full-factorial grid (process × temperature × supply), 0 completed
  - Full PVT matrix per CLAUDE.md (−40/27/125 °C, ±10 % supply, process corners).
- **Statistical convention**: N/A (corner-matrix claim, not a distribution claim)
- **Result**:

  | corner-id | voh_ratio | vol_ratio | vm | isup_ua | pass/fail |
  |---|---|---|---|---|---|
  | `tt_-40c_2.97v` | n/a | n/a | n/a | n/a | ERROR — batch job klt-sim-0686aff908ad finished 'failed' (job command exited 87): the job's klt reported: the fleet runner runs klt 0.7.0, which does not know deck-list (decks[]) requests -- the request was not run (rebuild the runner image from a klt that includes decks[]) |
  | `tt_-40c_3.30v` | n/a | n/a | n/a | n/a | ERROR — batch job klt-sim-0686aff908ad finished 'failed' (job command exited 87): the job's klt reported: the fleet runner runs klt 0.7.0, which does not know deck-list (decks[]) requests -- the request was not run (rebuild the runner image from a klt that includes decks[]) |
  | `tt_-40c_3.63v` | n/a | n/a | n/a | n/a | ERROR — batch job klt-sim-0686aff908ad finished 'failed' (job command exited 87): the job's klt reported: the fleet runner runs klt 0.7.0, which does not know deck-list (decks[]) requests -- the request was not run (rebuild the runner image from a klt that includes decks[]) |
  | `tt_27c_2.97v` | n/a | n/a | n/a | n/a | ERROR — batch job klt-sim-0686aff908ad finished 'failed' (job command exited 87): the job's klt reported: the fleet runner runs klt 0.7.0, which does not know deck-list (decks[]) requests -- the request was not run (rebuild the runner image from a klt that includes decks[]) |
  | `tt_27c_3.30v` | n/a | n/a | n/a | n/a | ERROR — batch job klt-sim-0686aff908ad finished 'failed' (job command exited 87): the job's klt reported: the fleet runner runs klt 0.7.0, which does not know deck-list (decks[]) requests -- the request was not run (rebuild the runner image from a klt that includes decks[]) |
  | `tt_27c_3.63v` | n/a | n/a | n/a | n/a | ERROR — batch job klt-sim-0686aff908ad finished 'failed' (job command exited 87): the job's klt reported: the fleet runner runs klt 0.7.0, which does not know deck-list (decks[]) requests -- the request was not run (rebuild the runner image from a klt that includes decks[]) |
  | `tt_125c_2.97v` | n/a | n/a | n/a | n/a | ERROR — batch job klt-sim-0686aff908ad finished 'failed' (job command exited 87): the job's klt reported: the fleet runner runs klt 0.7.0, which does not know deck-list (decks[]) requests -- the request was not run (rebuild the runner image from a klt that includes decks[]) |
  | `tt_125c_3.30v` | n/a | n/a | n/a | n/a | ERROR — batch job klt-sim-0686aff908ad finished 'failed' (job command exited 87): the job's klt reported: the fleet runner runs klt 0.7.0, which does not know deck-list (decks[]) requests -- the request was not run (rebuild the runner image from a klt that includes decks[]) |
  | `tt_125c_3.63v` | n/a | n/a | n/a | n/a | ERROR — batch job klt-sim-0686aff908ad finished 'failed' (job command exited 87): the job's klt reported: the fleet runner runs klt 0.7.0, which does not know deck-list (decks[]) requests -- the request was not run (rebuild the runner image from a klt that includes decks[]) |
  | `ff_-40c_2.97v` | n/a | n/a | n/a | n/a | ERROR — batch job klt-sim-0686aff908ad finished 'failed' (job command exited 87): the job's klt reported: the fleet runner runs klt 0.7.0, which does not know deck-list (decks[]) requests -- the request was not run (rebuild the runner image from a klt that includes decks[]) |
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
  | `fs_125c_2.97v` | n/a | n/a | n/a | n/a | ERROR — batch job klt-sim-0686aff908ad finished 'failed' (job command exited 87): the job's klt reported: the fleet runner runs klt 0.7.0, which does not know deck-list (decks[]) requests -- the request was not run (rebuild the runner image from a klt that includes decks[]) |
  | `fs_125c_3.30v` | n/a | n/a | n/a | n/a | ERROR — batch job klt-sim-0686aff908ad finished 'failed' (job command exited 87): the job's klt reported: the fleet runner runs klt 0.7.0, which does not know deck-list (decks[]) requests -- the request was not run (rebuild the runner image from a klt that includes decks[]) |
  | `fs_125c_3.63v` | n/a | n/a | n/a | n/a | ERROR — batch job klt-sim-0686aff908ad finished 'failed' (job command exited 87): the job's klt reported: the fleet runner runs klt 0.7.0, which does not know deck-list (decks[]) requests -- the request was not run (rebuild the runner image from a klt that includes decks[]) |
  | `sf_-40c_2.97v` | n/a | n/a | n/a | n/a | ERROR — batch job klt-sim-0686aff908ad finished 'failed' (job command exited 87): the job's klt reported: the fleet runner runs klt 0.7.0, which does not know deck-list (decks[]) requests -- the request was not run (rebuild the runner image from a klt that includes decks[]) |
  | `sf_-40c_3.30v` | n/a | n/a | n/a | n/a | ERROR — batch job klt-sim-0686aff908ad finished 'failed' (job command exited 87): the job's klt reported: the fleet runner runs klt 0.7.0, which does not know deck-list (decks[]) requests -- the request was not run (rebuild the runner image from a klt that includes decks[]) |
  | `sf_-40c_3.63v` | n/a | n/a | n/a | n/a | ERROR — batch job klt-sim-0686aff908ad finished 'failed' (job command exited 87): the job's klt reported: the fleet runner runs klt 0.7.0, which does not know deck-list (decks[]) requests -- the request was not run (rebuild the runner image from a klt that includes decks[]) |
  | `sf_27c_2.97v` | n/a | n/a | n/a | n/a | ERROR — batch job klt-sim-0686aff908ad finished 'failed' (job command exited 87): the job's klt reported: the fleet runner runs klt 0.7.0, which does not know deck-list (decks[]) requests -- the request was not run (rebuild the runner image from a klt that includes decks[]) |
  | `sf_27c_3.30v` | n/a | n/a | n/a | n/a | ERROR — batch job klt-sim-0686aff908ad finished 'failed' (job command exited 87): the job's klt reported: the fleet runner runs klt 0.7.0, which does not know deck-list (decks[]) requests -- the request was not run (rebuild the runner image from a klt that includes decks[]) |
  | `sf_27c_3.63v` | n/a | n/a | n/a | n/a | ERROR — batch job klt-sim-0686aff908ad finished 'failed' (job command exited 87): the job's klt reported: the fleet runner runs klt 0.7.0, which does not know deck-list (decks[]) requests -- the request was not run (rebuild the runner image from a klt that includes decks[]) |
  | `sf_125c_2.97v` | n/a | n/a | n/a | n/a | ERROR — batch job klt-sim-0686aff908ad finished 'failed' (job command exited 87): the job's klt reported: the fleet runner runs klt 0.7.0, which does not know deck-list (decks[]) requests -- the request was not run (rebuild the runner image from a klt that includes decks[]) |
  | `sf_125c_3.30v` | n/a | n/a | n/a | n/a | ERROR — batch job klt-sim-0686aff908ad finished 'failed' (job command exited 87): the job's klt reported: the fleet runner runs klt 0.7.0, which does not know deck-list (decks[]) requests -- the request was not run (rebuild the runner image from a klt that includes decks[]) |
  | `sf_125c_3.63v` | n/a | n/a | n/a | n/a | ERROR — batch job klt-sim-0686aff908ad finished 'failed' (job command exited 87): the job's klt reported: the fleet runner runs klt 0.7.0, which does not know deck-list (decks[]) requests -- the request was not run (rebuild the runner image from a klt that includes decks[]) |

  Grid-level check failures: vm min_spread_pct=5 (got n/a).

  Spread across the grid:

  | measurement | min | max | mean | spread % | limits |
  |---|---|---|---|---|---|
  | `voh_ratio` | no data | | | | min=0.95, max=1 |
  | `vol_ratio` | no data | | | | min=0, max=0.05 |
  | `vm` | no data | | | | min=0.9, max=2.4, min_spread_pct=5 |
  | `isup_ua` | no data | | | | min=0.001, max=5000 |

  - **Overall: ERROR**
- **Links**:
  - Testbench: `sim/smoke-inverter/testbench/smoke_inverter.spice`, `sim/smoke-inverter/testbench/tb.json`
  - Netlist snapshot: `sim/smoke-inverter/netlist-snapshots/20261024-122053-b8bbc48.spice`
  - Raw logs: `sim/smoke-inverter/corners/20261024-122053-b8bbc48/`
- **Timestamp / author**: 2026-10-24T12:20:53+00:00, ubuntu
- **Supersedes**: (none)

## Environment

Everything needed to re-run this record:

- PDK: gf180mcuD @ open_pdks `c6d73a35f524070e85faff4a6a9eef49553ebc2b` (/home/ubuntu/.volare/gf180mcuD, found via search_root:~/.volare)
- ngspice: ngspice-None via `klt sim` (backend batch; submitting host had ngspice-42 : Circuit level simulation program)
- klt sim: version 0.7.1.dev2608+g06064174166b, backend `batch`, klt status `error`, remote `{'provider': 'aws-batch-fleet', 'job_id': 'klt-sim-0686aff908ad', 'region': 'us-east-1', 'instance_id': 'i-06debae4e6fea5f0b', 'instance_type': 'm6i.4xlarge', 'availability_zone': 'us-east-1d', 'ami_id': 'ami-0dda7bd225256d63c', 'lifecycle': 'spot', 'spot': True, 'state': 'failed', 'exit_code': '87', 'concurrency': '1', 'physical_cores': '8', 'elapsed_seconds': 9, 'runner_klt_version': '0.7.0', 'client_klt_version': '0.7.1.dev2608+g06064174166b', 'runner_compatibility': 'match'}`
- Harness: sim/harness 0.1.0, python 3.12.3
- git: `b8bbc48bd5432b924e0d0ac294b73448d5e4a82d` on `feature/issue-241` (clean)
- Testbench netlist sha256: `2dedde9c63093a033ae4e345c345c2ebf28c1b67c3492e6f392ed44faeb4033c`
- Manifest sha256: `7c83eb00587980371eb0a46c809be220d1990d9516650cbfdc07da3f9e7142b5`
- Wall time: 113.12 s

Per-corner model sections used:

- `tt`: typical res_typical bjt_typical diode_typical moscap_typical mimcap_typical
- `ff`: ff res_ff bjt_ff diode_ff moscap_ff mimcap_ff
- `ss`: ss res_ss bjt_ss diode_ss moscap_ss mimcap_ss
- `fs`: fs res_typical bjt_typical diode_typical moscap_typical mimcap_typical
- `sf`: sf res_typical bjt_typical diode_typical moscap_typical mimcap_typical

---

Written by `sim/run_corners.py`. Append-only: never edit or delete this
file — a re-run or correction mints a new record-id and points back here
via **Supersedes** (see `sim/README.md`).

## Stored evidence

The bytes of this run are in the fleet artifact store, not in git (issue #237). Manifest: `manifests/artifacts/smoke-inverter-20261024-122053-b8bbc48.manifest.json` (46 objects, 3655 B). Paths above are the manifest `name`s. Fetch one, hash-verified, with:

```
klt artifact get manifests/artifacts/smoke-inverter-20261024-122053-b8bbc48.manifest.json#<name> -o <out>
klt artifact verify manifests/artifacts/smoke-inverter-20261024-122053-b8bbc48.manifest.json
```

| name | size (B) | sha256 |
|---|---:|---|
| `sim/smoke-inverter/corners/20261024-122053-b8bbc48/ff_-40c_2.97v.log` | 43 | `fb1c707a553033efda55e895a60afd828d851a2f9fecc9a2c2004feb0cd42af1` |
| `sim/smoke-inverter/corners/20261024-122053-b8bbc48/ff_-40c_3.30v.log` | 43 | `fd7da037c11e8e4e71fa4d739609d270a9485ce41b2d169a6a5b1e55abbf1a0f` |
| `sim/smoke-inverter/corners/20261024-122053-b8bbc48/ff_-40c_3.63v.log` | 43 | `41d007683ec40336bc3a7ad723845061593b35b9d05f61d977acb3645b10401c` |
| `sim/smoke-inverter/corners/20261024-122053-b8bbc48/ff_125c_2.97v.log` | 43 | `4cc6effc9b9498343f40b56160b828c18eca5bbe53764e8c6bc453386fb29e2a` |
| `sim/smoke-inverter/corners/20261024-122053-b8bbc48/ff_125c_3.30v.log` | 43 | `3441a83814897906959f69878ace6ba4a1bcdd6616fb7117415dfc629b814ff8` |
| `sim/smoke-inverter/corners/20261024-122053-b8bbc48/ff_125c_3.63v.log` | 43 | `cb4a838cf3f3fe14364165361a1190699d9860b833c2534cbf821788c5c61f71` |
| `sim/smoke-inverter/corners/20261024-122053-b8bbc48/ff_27c_2.97v.log` | 42 | `197189d247d898021a995b5be81f0af7ed0c0e490c943fd944d032ec4249a645` |
| `sim/smoke-inverter/corners/20261024-122053-b8bbc48/ff_27c_3.30v.log` | 42 | `0a6a39d0ef2c6b1a667e94eb9be11d8ab2bdac269cbc2afed138e4b5b0aa652b` |
| `sim/smoke-inverter/corners/20261024-122053-b8bbc48/ff_27c_3.63v.log` | 42 | `2ca709b9c2c8048edbd4870eb02a70fdbbcae1d70bfd8488a637954217bb4d13` |
| `sim/smoke-inverter/corners/20261024-122053-b8bbc48/fs_-40c_2.97v.log` | 43 | `605a41e571d975f3b06166f92a9aa76b15232e48735a046fd791cdd61b45c394` |
| `sim/smoke-inverter/corners/20261024-122053-b8bbc48/fs_-40c_3.30v.log` | 43 | `4e62247d2f6b7e40580d88266129a1af8018beedb0a56d3f7a67c3888630c583` |
| `sim/smoke-inverter/corners/20261024-122053-b8bbc48/fs_-40c_3.63v.log` | 43 | `4f199d42f18b8f03560f9debbda7c7896d2a7392eea24375583510cf0d196a36` |
| `sim/smoke-inverter/corners/20261024-122053-b8bbc48/fs_125c_2.97v.log` | 43 | `8761aef28cfe117b934543d86a6cb9612d34634602712c0a6e436d1036a014a9` |
| `sim/smoke-inverter/corners/20261024-122053-b8bbc48/fs_125c_3.30v.log` | 43 | `2952a8e8dd0c84830ce77e460a2937c58422a1e4e1094c95de57965881c02c71` |
| `sim/smoke-inverter/corners/20261024-122053-b8bbc48/fs_125c_3.63v.log` | 43 | `f25c892c1fec6f45ff96c5687410bc4f69693d14738e12da9ce8f12fe92ed5af` |
| `sim/smoke-inverter/corners/20261024-122053-b8bbc48/fs_27c_2.97v.log` | 42 | `c47009cd5240480725f552b388c1df0476dae6e882eba9b054172f5912bd6836` |
| `sim/smoke-inverter/corners/20261024-122053-b8bbc48/fs_27c_3.30v.log` | 42 | `92c25e5d2be275f02e0bbd1a854aa1aa4b4a7a3cbb4fbbe48e4c75cab3ee88db` |
| `sim/smoke-inverter/corners/20261024-122053-b8bbc48/fs_27c_3.63v.log` | 42 | `522d94b6985fe891469888545f56dbb8d248369b4cd20d90452ed211c6e37562` |
| `sim/smoke-inverter/corners/20261024-122053-b8bbc48/sf_-40c_2.97v.log` | 43 | `7813f69cba087b1e2c2523cb259141003600135c9ec631d0d11484f8dc031880` |
| `sim/smoke-inverter/corners/20261024-122053-b8bbc48/sf_-40c_3.30v.log` | 43 | `1127ea3860d5866eb11bcbe584a3cdf1effd514d4be2e24171d3ed048d76bbd5` |
| `sim/smoke-inverter/corners/20261024-122053-b8bbc48/sf_-40c_3.63v.log` | 43 | `9b0378b32d34ce3b841a8dab011b6398fd2a311efa017c7d14f3574de46953b5` |
| `sim/smoke-inverter/corners/20261024-122053-b8bbc48/sf_125c_2.97v.log` | 43 | `df3cf7daa6c5a84f19c3460b56d7b12079e21ba70a11384033adf052b866fc6c` |
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
| `sim/smoke-inverter/corners/20261024-122053-b8bbc48/tt_27c_3.63v.log` | 42 | `c25948b6bb3208d603a135bc2be24e4fc2f7f52df7dda36ca8464abfeb4de1d4` |
| `sim/smoke-inverter/netlist-snapshots/20261024-122053-b8bbc48.spice` | 1735 | `b54a7900d85fe2c7140e6a205bdac0158d331a80c6da3c2f52c3ef66f9ea9863` |
