2AMLogic/gf180-usb2-phy/sim/driver-signal-quality/records/20261015-104027-d109790.md

# Record 20261015-104027-d109790

- **Record ID**: 20261015-104027-d109790
- **Claim**: spec/usb2-device-phy.md#6-driver-characteristics -- rise time 4-20 ns, fall time 4-20 ns, rise/fall matching within 10 %, crossover voltage 1.3-2.0 V, all into the ratified 50 pF test load; and spec/usb2-device-phy.md#82-what-gets-measured-and-against-which-section rows 'Rise/fall time', 'Crossover voltage' and 'Full-speed signal quality'.
- **Netlist provenance**: schematic — DUT `design/netlist/differential_driver.spice` (sha256 `537fddd8a639fa90874430c0f5e5df3434c2afb28aba2055d532d2b1deb01cc2`), driven by `sim/driver-signal-quality/testbench/driver_tb_klt.spice`
- **Corner matrix run**:
  - Process: tt, ff, ss, fs, sf
  - Temperature: -40 °C, 27 °C, 125 °C
  - Supply: 2.97 V, 3.30 V, 3.63 V
  - 45 point full-factorial grid (process × temperature × supply), 45 completed
  - Full PVT matrix per CLAUDE.md (−40/27/125 °C, ±10 % supply, process corners).
- **Statistical convention**: N/A (corner-matrix claim, not a distribution claim)
- **Result**:

  | corner-id | trise_ns | tfall_ns | trf_ratio | vcross_rise | vcross_fall | xing_extra_ps | dp_over_mv | dp_under_mv | pass/fail |
  |---|---|---|---|---|---|---|---|---|---|
  | `tt_-40c_2.97v` | 4.94208 | 4.84373 | 1.02031 | 1.46747 | 1.46747 | 0 | 1.12506 | -0.697111 | PASS |
  | `tt_-40c_3.30v` | 4.78589 | 4.74767 | 1.00805 | 1.64174 | 1.64174 | 0 | 1.0558 | -0.674905 | PASS |
  | `tt_-40c_3.63v` | 4.67519 | 4.67897 | 0.999193 | 1.81559 | 1.81559 | 0 | 1.00157 | -0.658538 | PASS |
  | `tt_27c_2.97v` | 6.07013 | 5.97993 | 1.01508 | 1.46188 | 1.46188 | 0 | 0.965587 | -0.622033 | PASS |
  | `tt_27c_3.30v` | 5.89613 | 5.86056 | 1.00607 | 1.6325 | 1.6325 | 0 | 0.90657 | -0.600385 | PASS |
  | `tt_27c_3.63v` | 5.76978 | 5.77426 | 0.999223 | 1.80316 | 1.80316 | 0 | 0.858303 | -0.585542 | PASS |
  | `tt_125c_2.97v` | 7.6886 | 7.71699 | 0.996321 | 1.4642 | 1.4642 | 0 | 0.757225 | -0.518136 | PASS |
  | `tt_125c_3.30v` | 7.49054 | 7.55617 | 0.991314 | 1.63275 | 1.63275 | 0 | 0.717523 | -0.499917 | PASS |
  | `tt_125c_3.63v` | 7.3415 | 7.43603 | 0.987288 | 1.80158 | 1.80158 | 0 | 0.678897 | -0.48681 | PASS |
  | `ff_-40c_2.97v` | 4.28649 | 4.25099 | 1.00835 | 1.4768 | 1.4768 | 0 | 0.928675 | -0.592759 | PASS |
  | `ff_-40c_3.30v` | 4.17418 | 4.18108 | 0.998352 | 1.64933 | 1.64933 | 0 | 0.87873 | -0.580277 | PASS |
  | `ff_-40c_3.63v` | 4.09386 | 4.13205 | 0.990759 | 1.82188 | 1.82188 | 0 | 0.829855 | -0.569642 | PASS |
  | `ff_27c_2.97v` | 5.26988 | 5.23873 | 1.00595 | 1.46994 | 1.46994 | 0 | 0.780368 | -0.517045 | PASS |
  | `ff_27c_3.30v` | 5.14214 | 5.15056 | 0.998365 | 1.63957 | 1.63957 | 0 | 0.735891 | -0.505584 | PASS |
  | `ff_27c_3.63v` | 5.04822 | 5.08737 | 0.992304 | 1.8095 | 1.8095 | 0 | 0.691906 | -0.493114 | PASS |
  | `ff_125c_2.97v` | 6.68149 | 6.74836 | 0.990091 | 1.47149 | 1.47149 | 0 | 0.57809 | -0.413597 | PASS |
  | `ff_125c_3.30v` | 6.53201 | 6.62584 | 0.985838 | 1.63949 | 1.63949 | 0 | 0.542678 | -0.401037 | PASS |
  | `ff_125c_3.63v` | 6.41758 | 6.53378 | 0.982216 | 1.80779 | 1.80779 | 0 | 0.502245 | -0.392564 | PASS |
  | `ss_-40c_2.97v` | 5.67282 | 5.49929 | 1.03155 | 1.4555 | 1.4555 | 0 | 1.34322 | -0.808864 | PASS |
  | `ss_-40c_3.30v` | 5.45711 | 5.36898 | 1.01642 | 1.63193 | 1.63193 | 0 | 1.25165 | -0.778335 | PASS |
  | `ss_-40c_3.63v` | 5.30432 | 5.27456 | 1.00564 | 1.80757 | 1.80757 | 0 | 1.18466 | -0.757139 | PASS |
  | `ss_27c_2.97v` | 6.94805 | 6.78801 | 1.02358 | 1.45148 | 1.45148 | 0 | 1.16777 | -0.736989 | PASS |
  | `ss_27c_3.30v` | 6.7103 | 6.62784 | 1.01244 | 1.62352 | 1.62352 | 0 | 1.09586 | -0.705483 | PASS |
  | `ss_27c_3.63v` | 6.53967 | 6.51104 | 1.0044 | 1.79516 | 1.79516 | 0 | 1.03556 | -0.681792 | PASS |
  | `ss_125c_2.97v` | 8.77519 | 8.76134 | 1.00158 | 1.45501 | 1.45501 | 0 | 0.945971 | -0.631333 | PASS |
  | `ss_125c_3.30v` | 8.51062 | 8.54959 | 0.995443 | 1.62413 | 1.62413 | 0 | 0.887865 | -0.60621 | PASS |
  | `ss_125c_3.63v` | 8.31514 | 8.3919 | 0.990853 | 1.79337 | 1.79337 | 0 | 0.840885 | -0.586111 | PASS |
  | `fs_-40c_2.97v` | 5.13035 | 4.72295 | 1.08626 | 1.4046 | 1.4046 | 0 | 1.03739 | -0.740953 | PASS |
  | `fs_-40c_3.30v` | 4.94092 | 4.64132 | 1.06455 | 1.5767 | 1.5767 | 0 | 0.972794 | -0.718908 | PASS |
  | `fs_-40c_3.63v` | 4.80784 | 4.58309 | 1.04904 | 1.74785 | 1.74785 | 0 | 0.918711 | -0.703173 | PASS |
  | `fs_27c_2.97v` | 6.27781 | 5.83754 | 1.07542 | 1.41071 | 1.41071 | 0 | 0.870999 | -0.667542 | PASS |
  | `fs_27c_3.30v` | 6.06869 | 5.73533 | 1.05812 | 1.57933 | 1.57933 | 0 | 0.819205 | -0.646423 | PASS |
  | `fs_27c_3.63v` | 5.91837 | 5.66164 | 1.04534 | 1.74763 | 1.74763 | 0 | 0.772513 | -0.631327 | PASS |
  | `fs_125c_2.97v` | 7.91889 | 7.53584 | 1.05083 | 1.42226 | 1.42226 | 0 | 0.654551 | -0.569219 | PASS |
  | `fs_125c_3.30v` | 7.68442 | 7.39713 | 1.03884 | 1.58906 | 1.58906 | 0 | 0.612913 | -0.552043 | PASS |
  | `fs_125c_3.63v` | 7.50983 | 7.29337 | 1.02968 | 1.75591 | 1.75591 | 0 | 0.576937 | -0.537596 | PASS |
  | `sf_-40c_2.97v` | 4.78523 | 4.99688 | 0.957644 | 1.53002 | 1.53002 | 0 | 1.19163 | -0.644699 | PASS |
  | `sf_-40c_3.30v` | 4.655 | 4.88121 | 0.953657 | 1.70653 | 1.70653 | 0 | 1.12033 | -0.622285 | PASS |
  | `sf_-40c_3.63v` | 4.56217 | 4.79867 | 0.950717 | 1.88326 | 1.88326 | 0 | 1.06773 | -0.605826 | PASS |
  | `sf_27c_2.97v` | 5.89538 | 6.15614 | 0.957643 | 1.51279 | 1.51279 | 0 | 1.03797 | -0.567225 | PASS |
  | `sf_27c_3.30v` | 5.74897 | 6.01391 | 0.955945 | 1.68541 | 1.68541 | 0 | 0.98067 | -0.545997 | PASS |
  | `sf_27c_3.63v` | 5.64186 | 5.91128 | 0.954422 | 1.85847 | 1.85847 | 0 | 0.933022 | -0.531927 | PASS |
  | `sf_125c_2.97v` | 7.49288 | 7.93559 | 0.944212 | 1.50606 | 1.50606 | 0 | 0.841048 | -0.45437 | PASS |
  | `sf_125c_3.30v` | 7.32381 | 7.74631 | 0.945457 | 1.6763 | 1.6763 | 0 | 0.796226 | -0.440742 | PASS |
  | `sf_125c_3.63v` | 7.19551 | 7.60551 | 0.946091 | 1.84707 | 1.84707 | 0 | 0.755776 | -0.427596 | PASS |

  Spread across the grid:

  | measurement | min | max | mean | spread % | limits |
  |---|---|---|---|---|---|
  | `trise_ns` | 4.09386 (`ff_-40c_3.63v`) | 8.77519 (`ss_125c_2.97v`) | 6.09104 | 76.856 | min=4, max=20 |
  | `tfall_ns` | 4.13205 (`ff_-40c_3.63v`) | 8.76134 (`ss_125c_2.97v`) | 6.08376 | 76.0925 | min=4, max=20 |
  | `trf_ratio` | 0.944212 (`sf_125c_2.97v`) | 1.08626 (`fs_-40c_2.97v`) | 1.00269 | 14.1668 | min=0.9, max=1.1 |
  | `vcross_rise` | 1.4046 (`fs_-40c_2.97v`) | 1.88326 (`sf_-40c_3.63v`) | 1.63521 | 29.2721 | min=1.3, max=2 |
  | `vcross_fall` | 1.4046 (`fs_-40c_2.97v`) | 1.88326 (`sf_-40c_3.63v`) | 1.63521 | 29.2721 | min=1.3, max=2 |
  | `xing_extra_ps` | 0 (`ff_-40c_2.97v`) | 0 (`tt_27c_3.63v`) | 0 | n/a | min=-1, max=1 |
  | `dp_over_mv` | 0.502245 (`ff_125c_3.63v`) | 1.34322 (`ss_-40c_2.97v`) | 0.894418 | 94.0248 | min=-50, max=50 |
  | `dp_under_mv` | -0.808864 (`ss_-40c_2.97v`) | -0.392564 (`ff_125c_3.63v`) | -0.593536 | 70.139 | min=-50, max=50 |

  - **Overall: PASS** (45/45 corners pass every attached limit)
- **Links**:
  - Testbench: `sim/driver-signal-quality/testbench/driver_tb_klt.spice`, `sim/driver-signal-quality/testbench/klt-sim-request.json`
  - DUT netlist: `design/netlist/differential_driver.spice`
  - Netlist snapshot: `sim/driver-signal-quality/netlist-snapshots/20261015-104027-d109790.spice`
  - Raw logs: `sim/driver-signal-quality/corners/20261015-104027-d109790/` (per-corner `.log` plus the full `klt sim` JSON report `klt-sim-report.json`)
- **Timestamp / author**: 2026-10-15T10:40:27+00:00, loom builder agent (issue #96)
- **Supersedes**: 20260817-203552-a408cb6

## Why this record supersedes `20260817-203552-a408cb6`

Issue #96: the output stage of `design/differential_driver.sch` was re-sized
(output PMOS `W=80u m=4`, output NMOS `W=30u m=4`, predriver PMOS/NMOS `8u`/`2.5u`;
`rm1` ~36 Ω series termination and the poly slew resistor unchanged) so the
ratified §6 rows hold. `20260817-203552-a408cb6` stays in place as the record of the
60/30 µm design. The testbench netlist differs in measurement plumbing only (the
`klt sim` body `driver_tb_klt.spice` replaces the harness `.control` derive vectors; see its header comment).

## Environment

Run through `klt sim` on the Spot batch fleet (`KLT_SIM_BACKEND=batch`, request `remote.hosts=5`), not a hand-launched grid.

- Fleet jobs: `klt-sim-5ced2d17790c`, `klt-sim-8cbd8df1f1fa`, `klt-sim-b995f5dc16fb`, `klt-sim-8d37f43d54ce`, `klt-sim-cfc0af93ce90`
- Client: klt `0.7.1.dev497+g7ea1e4bc8d31`; runner klt `0.7.0` (`runner_compatibility: match`)
- ngspice: ngspice-46 (fleet `/usr/local/bin/ngspice`)
- PDK: gf180mcuD @ open_pdks c6d73a35f524070e85faff4a6a9eef49553ebc2b
- git: `d109790ecaaffdb80ac4c287ce3a9e2d5278b122` on `feature/issue-96`
- Testbench netlist sha256: `c161b5ca6660d1af9b26ec2c490aeca2250f85a85609b14030fb3d493c35158a`
- DUT netlist: `design/netlist/differential_driver.spice` sha256 `537fddd8a639fa90874430c0f5e5df3434c2afb28aba2055d532d2b1deb01cc2`
- Models library sha256: `6edba54d23b38a2c60f8ffdbaa3eb75a7568c615e4820808969bd1121b77b1aa`

Per-corner model sections used:

- `tt`: typical res_typical bjt_typical diode_typical moscap_typical mimcap_typical
- `ff`: ff res_ff bjt_ff diode_ff moscap_ff mimcap_ff
- `ss`: ss res_ss bjt_ss diode_ss moscap_ss mimcap_ss
- `fs`: fs res_typical bjt_typical diode_typical moscap_typical mimcap_typical
- `sf`: sf res_typical bjt_typical diode_typical moscap_typical mimcap_typical

---

Written from the `klt sim` report by the issue #96 builder. Append-only: never edit or delete this
file — a re-run or correction mints a new record-id and points back here
via **Supersedes** (see `sim/README.md`).
