2AMLogic/gf180-usb2-phy/verification/records/synthesis-smoke/records/20261010-153006-8562fa6.md

<!-- record-meta
{
  "record_id": "20261010-153006-8562fa6",
  "experiment": "synthesis-smoke",
  "supersedes": "20261010-130006-1b2472e",
  "git_revision": "8562fa6",
  "provenance": {
    "klt_version": "0.5.0+ge8ca621a6961",
    "pdk": {
      "name": "gf180mcuD",
      "version": "open_pdks c6d73a35f524070e85faff4a6a9eef49553ebc2b"
    },
    "deck": {
      "name": "gf180mcu_fd_sc_mcu9t5v0__tt_025C_1v80",
      "content_hash": "sha256:2482036479c89fbee3754524e3fcdb530aa40aff0fef9e9385e3bc7b7a67d4ef",
      "released": false
    },
    "inputs": [
      {
        "path": "flow/request-usb-utmi-phy-synth.json",
        "content_hash": "sha256:e04c09fd45025320b460a36c0631fba6127dea8440a2a0fb12bff4d1574cdba2"
      },
      {
        "path": "rtl/common/usb_nrzi_encoder.v",
        "content_hash": "sha256:9ab1f95a877aab538d13784fa02e7c260d173cac851b4c9e9fa78d25ea01bf39"
      },
      {
        "path": "rtl/common/usb_nrzi_decoder.v",
        "content_hash": "sha256:aa7eef14d8b00c6969ff375007ce34b960a9e2bd8f337d18590d902edad426c3"
      },
      {
        "path": "rtl/common/usb_bit_stuffer.v",
        "content_hash": "sha256:8987568b5bf36d0bfa649c2cb8bfbe7c06a2a3c22df3491d5548820a917ce0c4"
      },
      {
        "path": "rtl/common/usb_bit_destuffer.v",
        "content_hash": "sha256:03fc67bcec9eaece476ed46a7cb41fab4000bcd49e18cc7c7bf60f016f1ffc51"
      },
      {
        "path": "rtl/usb_sync_detector.v",
        "content_hash": "sha256:1f69da425fec809895fbdeb61e1d308379ddabc9aa0ecb10bf2f88f8fa88cbdc"
      },
      {
        "path": "rtl/usb_eop_detector.v",
        "content_hash": "sha256:163b950b3dcf939a2810f03b63dbea6f361f3261d47a75ea980cdf60d67e8e28"
      },
      {
        "path": "rtl/usb_line_state_decode.v",
        "content_hash": "sha256:c2d93d43d48ddaa2b620c3c0f11b06af74e89860fa3883f7b543955b46aa0d08"
      },
      {
        "path": "rtl/usb_utmi_phy.v",
        "content_hash": "sha256:bfcd8d525915b34e71db2d70510cfad52edace3c360f911f02cc07d8523f4f45"
      },
      {
        "path": "reuse.lock.json",
        "content_hash": "sha256:e48883b59c16cbaaa640c4414ff06c9cd0804fa02ef8855bd8e772d555906755"
      }
    ]
  }
}
-->

# Record 20261010-153006-8562fa6

- **Record ID**: 20261010-153006-8562fa6
- **Claim**: `rtl/usb_utmi_phy.v` elaborates and synthesizes cleanly through `klt synthesize` with issue #132's synchronous RX-reset wiring (DR-0006) and every module it instantiates (unchanged vendored copies under `rtl/common/` plus the three local RX modules). No latches, combinational loops, multi-driven nets or warnings. Synthesis smoke only; no place-and-route, STA, recovery/removal or signoff claim, and the committed layout and routed netlist predate #132 (#131). Why this record exists: the merged-main records minted by #147 pin `rtl/usb_utmi_phy.v` at its pre-#132 hash (`647f61f6...`). Issue #132 changes that file (and `verification/test_usb_utmi_phy.py`), so each of those records is live and stale again once #132 lands (`verification/check_records.py`). The records are frozen history and are NOT edited; this record supersedes the stale one.
- **Design provenance**: `main` @ `8562fa6` plus issue #132's working tree. All inputs pinned above.
- **Run configuration**: `PDK_ROOT=~/.volare PDK=gf180mcuD klt synthesize request-usb-utmi-phy-synth.json --format json`, run from `flow/`. klt `0.5.0+ge8ca621a6961` (CI pin, run via a throwaway `uvx` environment, not the host klt; `klt --version` carries a `.dirty` suffix from building the pinned commit from git source, not from local edits), Yosys 0.67+post and KLayout 0.30.12 (as recorded in the run envelope); library `gf180mcu_fd_sc_mcu9t5v0` @ `tt_025C_1v80`, open_pdks `c6d73a35f524070e85faff4a6a9eef49553ebc2b`.
- **Statistical convention**: deterministic single run. N/A.
- **Result**:
  - **status: ok. 330 mapped instances, 12782.6496 um2, 0 warnings.** 0 latches, 0 comb loops, 0 multi-driven. abc critical-path estimate 7432.82 ps. Sequential cells: 56 `dffq`, 11 `dffrnq`, 2 `dffsnq`.
  - Versus `20261010-130006-1b2472e` (321 instances, 12548.3904 um2, 7796.18 ps, 55 `dffq`): the one extra `dffq` is the new `rx_dec_mask` flop; the remaining combinational deltas are abc restructuring and are NOT attributed to any one change. Treat the figures as a smoke record, not an area or timing claim.
  - Artifacts: `artifacts/20261010-153006-8562fa6/usb-utmi-phy-synthesize-output.json` (envelope; worktree path replaced by `<worktree>`) and `usb_utmi_phy_synth.v` (mapped netlist).
- **klt provenance**: klt `0.5.0+ge8ca621a6961`; PDK gf180mcuD (open_pdks c6d73a35f524...); deck `gf180mcu_fd_sc_mcu9t5v0__tt_025C_1v80`; Yosys 0.67+post.
- **Links**: `20261010-130006-1b2472e`, issues #132, #147, #131.
- **Timestamp / author**: 2026-10-10T15:30:06Z, loom-doctor (PR #150, issue #132)
- **Supersedes**: `20261010-130006-1b2472e`, stale against the #132 source.
