2AMLogic/gf180-usb2-phy/verification/records/synthesis-smoke/records/20261010-013016-cc4e89c.md

<!-- record-meta
{
  "record_id": "20261010-013016-cc4e89c",
  "experiment": "synthesis-smoke",
  "supersedes": "20261009-135700-5e89df9",
  "git_revision": "cc4e89c",
  "provenance": {
    "klt_version": "0.5.0+ge8ca621a6961",
    "pdk": {
      "name": "gf180mcuD",
      "version": "open_pdks c6d73a35f524070e85faff4a6a9eef49553ebc2b"
    },
    "deck": {
      "name": "gf180mcu_fd_sc_mcu9t5v0__tt_025C_1v80",
      "content_hash": "sha256:2482036479c89fbee3754524e3fcdb530aa40aff0fef9e9385e3bc7b7a67d4ef",
      "released": false
    },
    "inputs": [
      {
        "path": "flow/request-usb-utmi-phy-synth.json",
        "content_hash": "sha256:e04c09fd45025320b460a36c0631fba6127dea8440a2a0fb12bff4d1574cdba2"
      },
      {
        "path": "rtl/common/usb_nrzi_encoder.v",
        "content_hash": "sha256:9ab1f95a877aab538d13784fa02e7c260d173cac851b4c9e9fa78d25ea01bf39"
      },
      {
        "path": "rtl/common/usb_nrzi_decoder.v",
        "content_hash": "sha256:aa7eef14d8b00c6969ff375007ce34b960a9e2bd8f337d18590d902edad426c3"
      },
      {
        "path": "rtl/common/usb_bit_stuffer.v",
        "content_hash": "sha256:8987568b5bf36d0bfa649c2cb8bfbe7c06a2a3c22df3491d5548820a917ce0c4"
      },
      {
        "path": "rtl/common/usb_bit_destuffer.v",
        "content_hash": "sha256:03fc67bcec9eaece476ed46a7cb41fab4000bcd49e18cc7c7bf60f016f1ffc51"
      },
      {
        "path": "rtl/usb_sync_detector.v",
        "content_hash": "sha256:1f69da425fec809895fbdeb61e1d308379ddabc9aa0ecb10bf2f88f8fa88cbdc"
      },
      {
        "path": "rtl/usb_eop_detector.v",
        "content_hash": "sha256:163b950b3dcf939a2810f03b63dbea6f361f3261d47a75ea980cdf60d67e8e28"
      },
      {
        "path": "rtl/usb_line_state_decode.v",
        "content_hash": "sha256:c2d93d43d48ddaa2b620c3c0f11b06af74e89860fa3883f7b543955b46aa0d08"
      },
      {
        "path": "rtl/usb_utmi_phy.v",
        "content_hash": "sha256:1a8cae96bf362280fa2eefec4c7e396e381e19f9053a613ac1bc80e983d948d3"
      },
      {
        "path": "reuse.lock.json",
        "content_hash": "sha256:e48883b59c16cbaaa640c4414ff06c9cd0804fa02ef8855bd8e772d555906755"
      }
    ]
  }
}
-->

# Record 20261010-013016-cc4e89c

- **Record ID**: 20261010-013016-cc4e89c
- **Claim**: `rtl/usb_utmi_phy.v` still elaborates and synthesizes cleanly
  through `klt synthesize` with issue #112's new `pu_en` output
  (`assign pu_en = TermSelect & rst_n`), together with every module it
  instantiates (vendored copies unchanged, stamped by `reuse.lock.json`).
  No latches, combinational loops, multi-driven nets or warnings. Synthesis
  smoke only; no place-and-route or signoff claim for the new port.
- **Design provenance**: `main` @ `cc4e89c` plus issue #112's working tree.
  Only `rtl/usb_utmi_phy.v` differs from the superseded record's pins.
- **Run configuration**: `PDK_ROOT=~/.volare PDK=gf180mcuD klt synthesize
  flow/request-usb-utmi-phy-synth.json --format json`. Tools: klt `0.5.0+ge8ca621a6961` (CI pin, installed as a throwaway `uvx --from` environment, not the host klt 0.7.0), Icarus Verilog 13.0, cocotb 2.0.1; Yosys
  0.67+post, KLayout 0.30.12. Library `gf180mcu_fd_sc_mcu9t5v0` @
  `tt_025C_1v80`, open_pdks `c6d73a35f524070e85faff4a6a9eef49553ebc2b`.
- **Statistical convention**: deterministic single run. N/A.
- **Result**: **status: ok. 322 mapped instances, 12912.48 um^2, 0
  warnings.** 0 latches, 0 comb loops, 0 multi-driven. abc critical-path
  estimate 6004.58 ps (unchanged from `20261009-135700-5e89df9`). Sequential cells: 60
  `dffq`, 11 `dffrnq`, 2 `dffsnq` (unchanged). The instance count differs
  from `20261009-135700-5e89df9` (326 / 12777.0048 um^2) even though the change adds only one
  AND gate; the difference was not investigated here (no flop change;
  likely abc mapping variation on the changed netlist), so no area claim
  is made. Artifacts: `artifacts/20261010-013016-cc4e89c/usb-utmi-phy-synthesize-output.json`
  and `usb_utmi_phy_synth.v` (mapped netlist).
- **klt provenance**: klt `0.5.0+ge8ca621a6961` (CI pin, installed as a throwaway `uvx --from` environment, not the host klt 0.7.0), Icarus Verilog 13.0, cocotb 2.0.1; PDK gf180mcuD (open_pdks c6d73a35f524...);
  deck `gf180mcu_fd_sc_mcu9t5v0__tt_025C_1v80`; Yosys 0.67+post; KLayout
  0.30.12.
- **Links**: issue #112, `flow/request-usb-utmi-phy-synth.json`,
  `utmi-framing-functional/20261010-013013-cc4e89c`.
- **Timestamp / author**: 2026-10-10T01:30:16Z, loom-builder (issue #112)
- **Supersedes**: `20261009-135700-5e89df9`, whose `rtl/usb_utmi_phy.v` input hash is stale.
