2AMLogic/gf180-usb2-phy/verification/records/synthesis-smoke/records/20260922-004226-0446e4b.md

<!-- record-meta
{
  "record_id": "20260922-004226-0446e4b",
  "experiment": "synthesis-smoke",
  "supersedes": null,
  "git_revision": "0446e4be73cf8f27f0a5df9b35ca3d32dc0bee6d",
  "provenance": {
    "klt_version": "0.4.0",
    "pdk": {
      "name": "gf180mcuD",
      "version": "open_pdks f6eeac7dad085ffcc829ccfd721f7b4ce39edcf7"
    },
    "deck": {
      "name": "gf180mcu_fd_sc_mcu9t5v0__tt_025C_1v80",
      "content_hash": "sha256:c0b6946a2d48a4604c687a29d3c8b1e05b3da5a42866b21592eaacfeae6e9ca7",
      "released": false
    },
    "inputs": [
      {
        "path": "flow/request-usb-utmi-phy-synth.json",
        "content_hash": "sha256:e04c09fd45025320b460a36c0631fba6127dea8440a2a0fb12bff4d1574cdba2"
      },
      {
        "path": "rtl/common/usb_nrzi_encoder.v",
        "content_hash": "sha256:9ab1f95a877aab538d13784fa02e7c260d173cac851b4c9e9fa78d25ea01bf39"
      },
      {
        "path": "rtl/common/usb_nrzi_decoder.v",
        "content_hash": "sha256:aa7eef14d8b00c6969ff375007ce34b960a9e2bd8f337d18590d902edad426c3"
      },
      {
        "path": "rtl/common/usb_bit_stuffer.v",
        "content_hash": "sha256:8987568b5bf36d0bfa649c2cb8bfbe7c06a2a3c22df3491d5548820a917ce0c4"
      },
      {
        "path": "rtl/common/usb_bit_destuffer.v",
        "content_hash": "sha256:03fc67bcec9eaece476ed46a7cb41fab4000bcd49e18cc7c7bf60f016f1ffc51"
      },
      {
        "path": "rtl/usb_sync_detector.v",
        "content_hash": "sha256:1f69da425fec809895fbdeb61e1d308379ddabc9aa0ecb10bf2f88f8fa88cbdc"
      },
      {
        "path": "rtl/usb_eop_detector.v",
        "content_hash": "sha256:163b950b3dcf939a2810f03b63dbea6f361f3261d47a75ea980cdf60d67e8e28"
      },
      {
        "path": "rtl/usb_line_state_decode.v",
        "content_hash": "sha256:c2d93d43d48ddaa2b620c3c0f11b06af74e89860fa3883f7b543955b46aa0d08"
      },
      {
        "path": "rtl/usb_utmi_phy.v",
        "content_hash": "sha256:313cde6e64c4f6829ef27184f6c8a1d325b7ed12f918db03478332ab42b78945"
      },
      {
        "path": "reuse.lock.json",
        "content_hash": "sha256:e48883b59c16cbaaa640c4414ff06c9cd0804fa02ef8855bd8e772d555906755"
      }
    ]
  }
}
-->

# Record 20260922-004226-0446e4b

- **Record ID**: 20260922-004226-0446e4b
- **Claim**: `rtl/usb_utmi_phy.v` and every module it instantiates — the
  four vendored canonical copies under `rtl/common/` (issue #84; byte-exact
  from sky130-usb2-phy @ `4f3b2c72`, pinned by `reuse.lock.json`) plus the
  three local RX modules — elaborate and synthesize cleanly through
  `klt synthesize` (Yosys, gf180mcu `gf180mcu_fd_sc_mcu9t5v5v0`
  standard-cell mapping) against the updated source list in
  `flow/request-usb-utmi-phy-synth.json`. First post-vendoring synthesis
  record for the PHY (the prior synthesis evidence for these sources rode
  inside `place-and-route/20260825-224709-6a83263`, which issue #84's
  inputs move superseded — see the record that supersedes it, and #87 for
  the P&R re-run).
- **Design provenance**: vendoring, interface adaptation, and the
  `sync_idx` second-packet fix are recorded in
  `spec/decisions/0002-vendored-protocol-rtl-interfaces-and-dispositions.md`;
  the vendored bytes are stamped in `reuse.lock.json` and enforced by
  `scripts/reuse-check.py` (CI).
- **Run configuration**: `PDK=gf180mcuD klt synthesize
  flow/request-usb-utmi-phy-synth.json --format json`, klt 0.4.0,
  KLayout 0.30.12, cell library `gf180mcu_fd_sc_mcu9t5v0` @
  `tt_025C_1v80`, open_pdks `f6eeac7dad085ffcc829ccfd721f7b4ce39edcf7`.
  Local contributor leg (same scope note as `.github/workflows/ci.yml`:
  the PDK-heavy legs stay local by design).
- **Statistical convention**: deterministic single run — N/A.
- **Result**:
  - **status: ok — 318 mapped instances, 12737.4912 µm², 0 warnings.**
  - Instance count vs the pre-vendoring P&R record's synthesis leg
    (342→318 mapped cells there vs here — the counts are not directly
    comparable: that record's 342 was the pre-#84 local modules' mapping
    and included the since-removed `sync_next`-driven destuffer init path;
    the delta reflects the canonical modules' simpler gating, not a
    dropped function — the functional suites in the #84 records are the
    behavioural evidence).
  - Note: a transient leg of this same request earlier in the #84 work
    (314 instances / 13220 µm²) ran against the pre-fix wrapper (before
    the `sync_idx` re-arm and RX assembly-enable fixes landed in the same
    commit); this record's numbers are from the final `0446e4b` tree.

- **klt provenance**: klt 0.4.0; PDK: gf180mcuD (open_pdks
  f6eeac7dad085ffcc829ccfd721f7b4ce39edcf7); deck:
  gf180mcu_fd_sc_mcu9t5v0__tt_025C_1v80 (content hash in the meta block).
  Yosys via klt synthesize; KLayout 0.30.12.
- **Links**: `flow/README.md` §"Digital synthesis + place-and-route",
  `spec/decisions/0002-vendored-protocol-rtl-interfaces-and-dispositions.md`,
  `reuse.lock.json`, #84, #87 (P&R + PVT re-run), #25.
- **Timestamp / author**: 2026-09-22T00:42:26Z, loom-builder (issue #84)
- **Supersedes**: none (first synthesis record for the PHY in this
  experiment; the prior synthesis evidence for these sources rode inside
  `place-and-route/20260825-224709-6a83263`, superseded separately).
