2AMLogic/gf180-usb2-phy/verification/records/synthesis-smoke/records/20260810-205021-c819c95.md

<!-- record-meta
{
  "record_id": "20260810-205021-c819c95",
  "experiment": "synthesis-smoke",
  "supersedes": null,
  "git_revision": "c819c95aad440213f5869f1552f308c530c37be7",
  "provenance": {
    "klt_version": "0.2.0",
    "pdk": {
      "name": "gf180mcuD",
      "version": "open_pdks c6d73a35f524070e85faff4a6a9eef49553ebc2b"
    },
    "deck": {
      "content_hash": "sha256:2482036479c89fbee3754524e3fcdb530aa40aff0fef9e9385e3bc7b7a67d4ef"
    },
    "inputs": [
      {
        "path": "rtl/harness_counter.v",
        "content_hash": "sha256:fb4559ab74baf24b26fb27463ac30f57efe00a89e9108e4e86e108a9398c0025"
      }
    ]
  }
}
-->

# Record 20260810-205021-c819c95

- **Record ID**: 20260810-205021-c819c95
- **Claim**: `flow/README.md#the-recipe` -- `harness_counter.v` synthesizes
  cleanly through `klt synthesize` against the gf180mcu PDK (the digital
  synthesis leg of the harness bootstrapped by issue #7, re-targeted from
  `sky130-modexp`'s sky130 pattern to gf180mcu).
- **Design provenance**: rtl (`rtl/harness_counter.v` @
  `c819c95aad440213f5869f1552f308c530c37be7`)
- **Run configuration**: `klt synthesize` (engine `yosys`),
  `flow/request-harness-counter-synth.json` (`pdk.cell_library` =
  `gf180mcu_fd_sc_mcu9t5v0`, `pdk.corner` = `tt_025C_1v80`,
  `constraints.clock_period_ns` = null / unconstrained), `PDK=gf180mcuD`
  resolved via `klt pdk find` against the local `~/.volare` install.
- **Statistical convention**: N/A (single deterministic synthesis run, not
  a distribution claim).
- **Result**:
  - `instance_count`: 34
  - `area_um2`: 1162.8288
  - `sequential_area_um2`: 632.2176
  - cell mix: 8 `dffq_1` (the 8-bit register), remainder combinational
    reset/enable/increment logic (`and3_1`, `and4_1`, `aoi21_1`,
    `clkinv_1`, `nand2_1`, `nand3_1`, `nand4_1`, `nor2_1`, `nor3_1`,
    `oai21_1`, `oai31_1`, `or2_1`) -- see the raw envelope for the full
    per-type breakdown
  - **Overall: PASS** -- `status: "ok"`, no synthesis errors
  - Independently reproduced on a second host (Linux, Yosys 0.67 vs. the
    0.68+post originally used) with byte-identical `instance_count`,
    `area_um2`, `sequential_area_um2`, and `instance_counts_by_type` --
    only the Yosys version-string header comment in the generated `.ys`
    script/netlist and the absolute scratch paths (host-local, gitignored)
    differed.
- **klt provenance**: klt 0.2.0; PDK: gf180mcuD (open_pdks
  c6d73a35f524070e85faff4a6a9eef49553ebc2b); deck:
  `gf180mcu_fd_sc_mcu9t5v0__tt_025C_1v80`, content_hash:
  `sha256:2482036479c89fbee3754524e3fcdb530aa40aff0fef9e9385e3bc7b7a67d4ef`;
  input content_hash: `rtl/harness_counter.v` =
  `sha256:fb4559ab74baf24b26fb27463ac30f57efe00a89e9108e4e86e108a9398c0025`
  (see `provenance.inputs` in the metadata block above).
- **Links**:
  - Request recipe: `flow/request-harness-counter-synth.json`
  - Design under test: `rtl/harness_counter.v`
  - Raw klt JSON envelope:
    `verification/records/synthesis-smoke/artifacts/20260810-205021-c819c95/synthesize-output.json`
  - Mapped netlist snapshot:
    `verification/records/synthesis-smoke/artifacts/20260810-205021-c819c95/harness_counter_synth.v`
  - Yosys script snapshot:
    `verification/records/synthesis-smoke/artifacts/20260810-205021-c819c95/synth_harness_counter.ys`
    (unedited klt output, so it carries the absolute liberty/scratch paths
    of the host it ran on -- artifacts are frozen exactly as the tool
    emitted them, per `verification/README.md`'s append-only rule)
- **Timestamp / author**: 2026-08-10T20:50:21Z, loom-builder (issue #7)
- **Supersedes**: none
