2AMLogic/gf180-usb2-phy/.loom/docs/telemetry-schema.md

# Fleet Telemetry Schema (wire format)

> Epic #4702, Phase 1 — the versioned telemetry record schema the fleet
> observability pipeline is built on. Defined in Rust in
> `loom-daemon/src/telemetry/` (`kinds.rs` — the one-row-per-kind registry that
> generates the record enum, its wire tags, and each kind's gate version;
> `mod.rs` — the record payload structs + envelope; `visibility.rs` — the
> repo-visibility derivation helper). This document is the
> **format-independent reference** so the Phase-2 Workers/TypeScript backend can
> parse the wire format without the Rust types.

This document defines the schema + serialization only. **#4704 (below) is the
first consumer that actually persists records** — a durable, append-only local
journal of `sweep.outcome` records, with a `loom-daemon` CLI read surface, no
exporter or cloud backend required. #4705 (still schema-only as of this
writing) will additionally push these records to a cloud backend.

<!-- toc:begin generated by scripts/check-doc-tocs.sh --fix; do not edit by hand -->
**Contents**

- [Envelope](#envelope)
- [`/ingest` response (the bound-`host_id` echo)](#ingest-response-the-bound-host_id-echo)
- [`RepoVisibility` contract — private by default](#repovisibility-contract--private-by-default)
- [Exported-facts contract (external ETA consumers, #11098)](#exported-facts-contract-external-eta-consumers-11098)
- [Record kinds](#record-kinds)
- [Persistence & read surface (`sweep.outcome`, Issue #4704)](#persistence--read-surface-sweepoutcome-issue-4704)
- [Refreshing the model rate card](#refreshing-the-model-rate-card)
<!-- toc:end -->

## Envelope

Every record is transmitted inside a versioned envelope:

```json
{
  "schema_version": 2,
  "emitted_at": "2026-07-30T12:00:00Z",
  "host_id": "fleet-host-abc",
  "record": {
    "kind": "sweep.outcome",
    "...": "record fields, flattened alongside `kind`"
  }
}
```

| Field | Type | Notes |
|---|---|---|
| `schema_version` | integer (`u32`) | **Per record kind**, not per daemon build: the kind's declared gate (`gate:` in `loom-daemon/src/telemetry/kinds.rs`). **2** (`CURRENT_SCHEMA_VERSION`) for the eight kinds that never pinned their own — bumped from `1` by Issue #8056's new `role_tick.outcome` record kind — and the pinned value otherwise (`3`…`11`; see Version history). Every kind added after #8921 carries **12**. |
| `emitted_at` | RFC 3339 datetime | When the daemon produced the envelope. |
| `host_id` | string | Stable identifier for the emitting host. Opaque to the schema. |
| `record` | object | The record payload, internally tagged on `kind` (see below). |

### Event time vs knowable-at, and `loom.record_id` (Issue #10196)

On OTLP log records, `timestamp` (`time_unix_nano`) is **event time** and
`observed_timestamp` (`observed_time_unix_nano`) is **knowable-at**. **Replay
filters on knowable-at**, never event time. The exporter currently sets
`observed_timestamp` to `emitted_at` (a producer-side copy, only a lower bound);
a true ingest-side value needs a collector-side receive stamp, a recorded design
decision. Every log record also carries `loom.record_id`, a content-derived
dedupe id (`derived_hex(["loom.record", kind, host_id, emitted_at, record JSON],
16)`). Full contract: [`telemetry-replay.md`](telemetry-replay.md).

### `loom.kind` on every log record (Issues #9881, #10899)

Every OTLP **log** record carries its record kind as the ordinary string
attribute `loom.kind`, equal to the envelope's `kind` tag (`sweep.outcome`,
`ci.job`, `pr.resolved`, …). That holds for every kind whose
registry row says `otlp: Logs`. Filter logs by kind on this key, never on the
log `name` column (SigNoz lowers `name` to a JSON function this ClickHouse build
rejects, loom-ui#747) and never on `body`: the JSON-body kinds (`eta.stage_outcome`,
`pr.resolved`, `pass.*`, `pick.decision`, `auto_update.tick`,
`token_ranking.refresh`, `ci.job.log`, `session.output`) have a body that is
not the event name. The mapping stamps it once, after the per-kind mapping, at
index 1 right after `loom.record_id`, so the 64-attribute bound never drops
it. The collector's log `keep_keys` admits it. Records exported before #10899
lack it for every kind except the `sweep.*` lifecycle kinds (other than
`sweep.phase`), `role_tick.outcome`, `session.summary`, `session.analysis`,
`pick.decision` and `pass.*`. The `loom.eta.*` attribute keys of `pr.resolved` and
`eta.stage_outcome` are unchanged and still valid. Contract:
`observability/otlp/mapping/tests/loom_kind.rs`, which walks the kind registry.

### `schema_version` semantics

`schema_version` is a **plain integer**, not a semver string, deliberately: a
backend ingesting a mixed-version fleet (some hosts on an older daemon mid
rolling-upgrade) gates on a numeric compare, with no semver parsing. It is bumped
only on a **breaking** wire change to the record shapes below. A backend should:

- **accept** records at any `schema_version` it recognizes;
- treat an **unknown (higher)** `schema_version` as forward-compatible where it
  can (unknown fields are additive) or route it to a dead-letter path otherwise;
- **never** silently coerce a missing `schema_version` to `0` — a record with no
  `schema_version` is malformed.

**Version history**

| Version | Change | Compatibility |
|---|---|---|
| `1` | The original six record kinds (`sweep.started`, `sweep.phase`, `sweep.completed`, `sweep.outcome`, `tokens.snapshot`, `host.health`). | — |
| `2` | Adds the `role_tick.outcome` record kind (Issue #8056). | **Every `1`-era record shape is byte-identical in `2`.** The bump exists solely because a backend that pattern-matches exhaustively on `kind` has no arm for the new one. A `2` envelope carrying any of the original six kinds is still parseable by a `1`-era reader; a `1` envelope is still parseable by the current daemon (the version is read, never validated, on the read path). Issue #8056's *additive* fields on `sweep.outcome` — `failure_class`, `models_used`, `doctor_cycles` — shipped under `1` and did **not** bump it, exactly as this section prescribes: a new optional field is not a breaking change, a new record kind is. Issue #8222's `judge_verdicts` is additive under `2` for the same reason (and re-sourcing `doctor_cycles` changed the value's provenance, never its wire type). |
| `3` | Adds `trace.span` (only trace envelopes use this version). | Existing lifecycle envelopes keep version `2`. |
| `4` | Adds `sweep.identity` (#8713); only identity envelopes use `4`. | Existing lifecycle/trace versions and shapes remain unchanged. Older Workers store unknown kinds in history but cannot enrich live state from them. |
| `5` | Adds `session.summary` (#8757, G3 of #8714); only session-summary envelopes use `5`. | Existing lifecycle/trace/identity versions and shapes remain unchanged. |
| `6` | Adds `session.analysis` (#8760, G3 part 2 of #8714); only session-analysis envelopes use `6`. | Existing lifecycle/trace/identity/session-summary versions and shapes remain unchanged. |
| `7` | Adds `daemon.event` (#8760, G4 of #8714); only daemon-event envelopes use `7`. | Existing lifecycle/trace/identity/session-summary/session-analysis versions and shapes remain unchanged. |
| `8` | Adds the CI family `ci.run`, `ci.job`, `ci.duration` (#8824); only those three kinds use `8`. CI spans reuse `trace.span` at `3`. | Every earlier kind's version and shape is unchanged. |
| `9` | Adds `ci.job.log` (#8825); only job-log chunk envelopes use `9`. | Every earlier kind's version and shape is unchanged — including the phase-1 CI family at `8`, so a backend that is not ready to ingest free-text log bodies can refuse exactly this kind without losing run/job/duration telemetry. |
| `10` | Adds `metric.points` (#8860); only those envelopes use `10`. OTLP-only — the native HTTPS exporter never sends it. The `loom.dispatch.tick` span reuses `trace.span` at `3`. | Every earlier kind's version and shape is unchanged — including `ci.job.log` at `9`. |
| `11` | Adds `queue.snapshot` (#8852 phase 2); only those envelopes use `11`. Native-HTTPS only — the OTLP exporter never sends it (SigNoz gets the queue as `loom.queue.*` gauges in `metric.points`). | Every earlier kind's version and shape is unchanged. Workers older than phase 3 store it as an unknown kind, and `/public/*` shows it as `kind` only. |
| `12` | **Every record kind added after #8921**, collectively — not one kind. `12` is `NEW_KIND_SCHEMA_VERSION` in `loom-daemon/src/telemetry/kinds.rs`, the value a new kind's registry row declares symbolically instead of claiming the next free integer. | Every earlier kind's version and shape is unchanged, exactly as for `3`–`11`. **A backend that must refuse one specific post-#8921 kind gates on the `kind` tag, not on `12`** — the tag is always unique (enforced by the `kind_registry` tests), while `12` is shared. Only a kind whose *content* is risky enough to deserve a version-level gate of its own (the `ci.job.log` free-text precedent at `9`) pins a fresh number, and then it adds its own row here. |

**This table no longer grows per kind** (#8921). Versions `1`–`11` were allocated
one-per-kind by hand, each PR taking "the next number" from a single `match` arm
in `envelope.rs` — which made every pair of concurrent record-kind PRs conflict
on that one line by construction (#8915 vs #8909, 2026-09-25). Row `12` is the
terminal row for that practice: a new kind declares
`gate: NEW_KIND_SCHEMA_VERSION` in its registry row and appends nothing here.

## `/ingest` response (the bound-`host_id` echo)

A push is a bare JSON array of envelopes; the backend answers a **2xx with a
JSON object**:

```json
{ "accepted": 50, "host_id": "fleet-host-abc" }
```

| Field | Type | Notes |
|---|---|---|
| `accepted` | integer | How many envelopes from this batch were persisted. Whole-batch semantics: a batch is either fully accepted or rejected with a non-2xx. |
| `host_id`  | string  | **The host id the authenticated ingest key is bound to** — i.e. the identity the batch's rows were actually filed under. Added by issue #4830. |

`host_id` here is *not* echoed from the request. Every record is persisted
under the identity bound to the presented key, never the envelope's own
(client-supplied, opaque) `host_id` field — so this echo is what a host was
actually recorded as, which is exactly the value that differs when the wrong
host's key file has been installed on a machine.

**How the exporter uses it.** `loom-daemon`'s exporter compares this value
against the identity the daemon resolved for itself (`$LOOM_HOST_ID`, else
`$HOSTNAME`, else `hostname`) and on a disagreement logs a WARN **once per
daemon lifetime** and reports an `observability DEGRADED` section in
`loom-daemon health`. Nothing about the export changes: the batch stays acked
and the backend keeps filing under the key's binding, which remains
authoritative. See `2AMLogic/loom-ui:docs/deploy-runbook.md` §8.

**Compatibility.** The field is purely additive — no `schema_version` rev is
involved (that integer versions the *record* envelope, not this response).
Both directions are safe:

- an exporter that ignores the response body behaves exactly as before;
- a backend that does not send `host_id` (anything predating #4830) is treated
  by the exporter as "no identity to verify" and is **silently** skipped — it
  never produces a recurring "cannot verify" warning.

**Star intents (#9244 C).** The response may also carry
`operator_priority_intents`, the stars and unstars loom-ui recorded (loom-ui
has no GitHub write access, so the daemon applies them):

```json
{ "accepted": 50, "host_id": "fleet-host-abc",
  "operator_priority_intents": [
    { "id": "…", "repo": "owner/repo", "number": 281, "action": "star",
      "label": "loom:operator-priority",
      "requested_at": "2026-09-28T08:15:00Z", "requested_by": "operator" } ] }
```

The actor field is `requested_by`. A missing or `null` field is an older
backend and a no-op; `[]` is a supporting backend with nothing pending. The
daemon reads the field as a raw JSON value, so no shape of it (an object, a
string, a number, a mixed array) can fail the ack or skip the `host_id` check;
a non-array is ignored and logged, and each array entry that is not a
well-formed object is dropped on its own. The daemon applies an
intent only when `label` is exactly `loom:operator-priority`, `action` is
`star` or `unstar`, `repo` is in this host's workspace registry, and
`requested_by` is non-empty; anything else is dropped and logged (visible as
`dropped_intents` in `loom-daemon status --json`). Applying adds or removes the
label, then posts one audit comment carrying
`<!-- loom:operator-priority-intent=<id> action=<a> requested_at=<ts> -->`,
unless a trusted comment with that intent id already exists, so resending an
intent, or several hosts managing the repo, is harmless. Trusted means an
`OWNER` / `MEMBER` / `COLLABORATOR`, a fleet App identity (any identity in the forge roster, or `loom-fleet-dispatch` / `-<digits>` exactly, as a `…[bot]` login only), or
the daemon's own login: a marker an outside commenter posts neither suppresses
the audit comment nor sets the starred-at. `requested_by` is shown inside a
code span, so an email address stays whole and an `@name` pings no one. `requested_at` becomes the
issue's starred-at for dispatch order. The exporter reads at most 64 KiB of
the response (4 KiB before #9244 C, which truncated a ~12 KiB 50-intent ack
and lost the `host_id` check along with the intents).

## `RepoVisibility` contract — private by default

Every record that references a repository carries a `visibility` tag, either
`"public"` or `"private"`. The Phase-2 public view exposes full detail for
`public` work and only redacted/summarized aggregates for `private` work, so this
tag is the schema-level anti-leak control.

**The decode is private-safe by construction.** The Rust deserializer maps *only*
the exact (case-insensitive) string `"public"` to `Public`; **everything else**
maps to `Private`:

- a missing `visibility` field ⇒ `Private`;
- an unknown label (e.g. `"internal"`) ⇒ `Private`;
- a `null`, a wrong-typed scalar (bool/number), or a nested array/object ⇒
  `Private`.

A partial or older-schema record can therefore **never accidentally decode to
`public`** and leak into the public view. The Phase-2 backend MUST implement the
same rule: default anything that is not exactly `"public"` to private. Redaction
keys off this tag, never off client-side filtering.

Visibility is derived at emit time from the forge (`gh api repos/{owner}/{repo}
--jq .private`) and cached per `owner/repo` with a TTL, so it costs no per-record
API call. A probe failure resolves to `private` — the same fail-safe default.

## Exported-facts contract (external ETA consumers, #11098)

ETA is moving out of Loom (decision #11078). loom-ui rebuilds it from label
webhooks, `github-read`, SigNoz and the records below (tracked on #11098).
Loom keeps no ETA logic. Its one obligation is to keep exporting the facts in
the first table. This section only points at each kind's own section, which
remains the field reference.

**Stability promise.** For every record in the first table, changes are
additive only. A field, attribute or metric name is never renamed or removed,
and its meaning never changes. Removing one needs an issue that loom-ui has
agreed to. **Growth rule:** a new fact (up to the whole ready queue per daemon
cycle) is added only when loom-ui's error tracking shows it is needed.

**Stable records: owned by non-ETA code.**

| Record | Signal | Owner (emit site, under `loom-daemon/src/`) |
|---|---|---|
| [`sweep.outcome`](#sweepoutcome) | log, native + OTLP | `sweep_registry/outcome_journal.rs`, `observability/collector.rs`, `sweep_registry/prless_retry/durable.rs`, `observability/backfill.rs` |
| [`sweep.started`](#sweepstarted) / [`sweep.phase`](#sweepphase) / [`sweep.completed`](#sweepcompleted) / [`sweep.identity`](#sweepidentity) | log, native + OTLP | `observability/collector.rs` (+ `collector/identity.rs`), `observability/queue.rs`, `observability/shutdown.rs`, `observability/backfill.rs`; `sweep.started` carries the dispatch facts (`model`, `effort`, `effort_source`, `model_source`, `runtime`, `attempt_index`, `trigger`, `previous_sweep_id`, #11280) from `sweep_registry/start_facts.rs` |
| Phase spans (`trace.span`: `loom.phase`, `loom.role_attempt`) | span, OTLP only | `observability/lifecycle.rs` → `observability/otlp/traces.rs`; see [`tracing.md`](tracing.md#owned-lifecycle-instrumentation) |
| [`pick.decision`](#pickdecision) | log, OTLP only | `observability/pick_decision.rs` (from `role_tick_telemetry.rs` and `work_finder/tick_summary.rs`) |
| [`queue.snapshot`](#queuesnapshot) (whole ready queue per tick) | native only | `observability/queue_snapshot.rs` |
| `loom.queue.issues`, `loom.queue.listing_failed_repos`, `loom.queue.listing_incomplete_repos` ([`metric.points`](#metricpoints)) | metric | `observability/ops/queue.rs` |
| `loom.queue.oldest_wait`, `loom.queue.starved[.by_reason]`, `loom.queue.dispatch_wait[.samples]` ([`metric.points`](#metricpoints)) | metric | `observability/ops/dwell.rs` |
| [`loom.dispatch.disposition`](#loomdispatchdisposition-issue-9222-per-issue-why-is-it-waiting) rows (`loom.queue.*` attributes) and `loom.queue.disposition_rows_dropped` | span + metric, OTLP only | `observability/ops/disposition.rs` |
| [`host.health`](#hosthealth) | gauges, native + OTLP | `observability/collector.rs` (+ `exporter.rs`, `sender.rs`) |
| [`host.export`](#hostexport) | log, OTLP only | `observability/collector.rs` |
| Captain gauges: `loom.captain.gauge_age_seconds`, `loom.captain.gauge_fallback`, `loom.forge.stage_dwell`, `loom.forge.stage_items` ([`metric.points`](#metricpoints)) | metric | `observability/captain_gauges.rs`, `observability/ops/stage_dwell.rs` |
| [`eta.stage_outcome`](#etastage_outcome) (kept, non-ETA owner since #11126) | log, OTLP only | `observability/fleet_state/outcomes.rs` (diff of two `fleet.state` views) |
| [`pr.resolved`](#prresolved) (kept, non-ETA owner since #11126) | log, OTLP only | `observability/fleet_state/outcomes.rs` (a PR that left the review listings) |

The captain gauges are emitted by non-ETA code. Since Stage 2 of #11098,
`fleet.captainGauges.ref` has its own default (`eta-fit`, the branch the
heartbeat already used; a legacy `fleet.etaFitRef` is still read as the
fallback), and `captain_gauges/store.rs` uses the neutral
`fleet_store/publication.rs` helpers instead of `crate::eta::fit`. What is
emitted did not change.

**Retired ETA-only records (Stage 3 of #11098).** Loom no longer computes or
exports ETA. These kinds and metrics were removed with the ETA subsystem, with
loom-ui's agreement that it computes and scores its own estimates from the
records above. Their wire tags are retired, not reused.

| Retired record | Was |
|---|---|
| `eta.estimate` / `eta.outcome` | per-estimate explanation and scored outcome (OTLP) |
| `eta.snapshot` | native-HTTPS live estimate set |
| `eta.fit` | daily coefficient-fit check |
| `eta.fleet_refresh` | one repo's outcome in a fleet snapshot refresh cycle |
| `eta.backtest.fold` / `eta.backtest.summary` | nightly walk-forward backtest |
| `loom.eta.health.*` | per-host ETA pipeline health gauges |

`eta.stage_outcome` and `pr.resolved` are not retired: they have a non-ETA
owner (`observability/fleet_state/outcomes.rs`) and stay under the stability
promise above. Their record types (`telemetry/kinds/stage_outcome.rs`,
`telemetry/kinds/pr_resolved.rs`), OTLP mapping
(`observability/otlp/mapping/outcome_facts.rs`) and attribute-key list
(`OUTCOME_FACT_LOG_ATTRIBUTE_KEYS`) live outside the deleted tree.

**Non-ETA records that carried an ETA type.**
[`pass.summary` / `pass.verdict`](#passsummary-and-passverdict),
[`auto_update.tick`](#auto_updatetick),
[`token_ranking.refresh`](#token_rankingrefresh), and the `release_fetch` and
`stale_blocked` release telemetry use `Provenance` as their `loom` object,
which lives in the neutral `telemetry/provenance.rs`; the wire shape is
unchanged, pinned by that module's serialization test.

**Naming note.** The issue text said `eta.stage_sample`, but no record kind
has that name. Stage exits were exported as `eta.stage_outcome`, from the
stage journal until #11126 and from `fleet.state` views since.

## Record kinds

The `record` object is internally tagged on `kind`. The tag values reuse the
frozen SSE `sweep.*` topic vocabulary where they overlap, plus the epic's added
kinds. Records that reference a repository carry `repo` + `visibility`; host-level
records (`tokens.snapshot`, `host.health`) do not.

**The authoritative list of kinds is the registry**,
`loom-daemon/src/telemetry/kinds.rs` — one row per kind carrying its wire tag,
payload type, gate version, OTLP routing class, and whether the native HTTPS
`/ingest` backend accepts it, plus a prose description. That file *generates* the
Rust enum and the wire tags, so it cannot drift from what a daemon emits; the
`TELEMETRY_KINDS` constant is the same table at runtime. There is deliberately no
second hand-maintained index of the kind set here (#8921 removed the one that
was): each kind's own `###` section below is its reference, and two concurrent
PRs adding two kinds no longer append to a shared table row.

### Adding a record kind (the registration contract, #8921)

Adding a kind used to mean editing four shared files at adjacent lines — the enum
variant and its `#[serde(rename)]`, a `pub mod` / `pub use` pair, a hand-assigned
`schema_version` match arm, two exhaustive OTLP routing chains, and two tables in
this document. Any two concurrent additions were unmergeable even when both were
correct. The contract now is:

1. **One row in `loom-daemon/src/telemetry/kinds.rs`** — the only shared line.
   That row generates the enum variant, the wire tag, the gate version, the OTLP
   routing class, and the native-ingest scope. The file is marked `merge=union`
   in `.gitattributes`, so two branches that each append a row merge cleanly
   instead of conflicting (asserted against real `git` by
   `telemetry::tests::kind_registry::two_branches_each_adding_a_record_kind_merge_cleanly`).
2. **`gate: NEW_KIND_SCHEMA_VERSION`** — never a fresh integer. See the Version
   history note above.
3. **Payload struct in its own module** — a new family belongs at
   `telemetry/kinds/<family>.rs`, declared in the registry file (not in
   `telemetry/mod.rs`), so it costs no shared line either.
4. **OTLP field mapping, if any, in its own sibling module**
   (`observability/otlp/mapping/<family>.rs`). `mapping.rs` reads the declared
   routing class; it has no per-kind bookkeeping arm to append to.
5. **This document**: a new `### <kind>` section for the record's fields. That is
   a new block, not a row inside a shared table — and a kind with a large field
   reference may instead ship its own `defaults/docs/telemetry-kind-<kind>.md`
   file (symlinked into `.loom/docs/` like every other shipped doc) and link it
   from its section here, which costs zero shared lines.

**What `merge=union` does and does not buy you.** The attribute is read by the
`git` that performs the merge, so it applies to every merge, rebase or
`git pull` you run locally and to the merge commit `merge-pr.sh` produces — the
row append resolves itself, with no hand-editing. It is **not** a guarantee that
the forge's *mergeability indicator* will stay green: a forge is free to compute
that status with a plain three-way merge and show `CONFLICTING`. If it does, the
fix is a `git merge origin/main` in the worktree, which under this attribute
produces both rows and needs no conflict resolution — the cost is one push, not
a rebase cycle spent reconstructing two hand-maintained ladders. Reducing the
*work* a collision costs is the goal; the `kind_registry` merge test asserts
exactly that property against real `git`.

### `sweep.started`

A sweep began work on an issue.

```json
{
  "kind": "sweep.started",
  "repo": "rjwalters/loom",
  "visibility": "public",
  "issue": 4703,
  "sweep_id": "sweep-issue-4703-0",
  "started_at": "2026-07-30T12:00:00Z",
  "model": "opus",
  "effort": "high",
  "model_source": "explicit",
  "runtime": "claude",
  "attempt_index": 2,
  "trigger": "retry_after_env_failure",
  "previous_sweep_id": "sweep-issue-4703-1",
  "story_points": 5
}
```

**Dispatch facts** (Issue #11280): `model`, `effort`, `effort_source`, `model_source`,
`runtime`, `attempt_index`, `trigger` and `previous_sweep_id` are what the
dispatch knew when the sweep started, under the same names `sweep.outcome`
uses, so a reader joins the two by name. A fit or a live estimate can then
use them at the sweep's start instead of waiting for its outcome. The same
values ride the native envelope and the OTLP log (`loom.model`,
`loom.effort`, `loom.effort_source`, `loom.model_source`, `loom.runtime`, `loom.attempt_index`,
`loom.trigger`, `loom.previous_sweep_id`; `SWEEP_START_FACT_LOG_ATTRIBUTE_KEYS`,
kept by the collector's `transform/privacy` `keep_keys`, contract-tested), and
every running row of [`fleet.state`](#fleetstate). Each is omitted when
unknown, never guessed. They come from the dispatch itself, with no forge read.

- `model`: the **full model id** the sweep was launched with. An alias
  (`sonnet`, `opus`, `haiku`) is resolved to its id (`claude-sonnet-5-5`, ...)
  through the single `MODEL_ALIAS_IDS` table in
  `sweep_registry/resolved_facts.rs`, a full id passes through, and a
  trailing `@effort` suffix is dropped, so one model is one bucket. It is
  never `''` and never an alias: when no id can be named (empty, or the
  runtime picks its own, for example Codex with no configured model) it is
  absent and `model_source=unknown` (#11370).
- `effort`: the **resolved** effort, the level that applies, not only an
  explicit request (#11370). Order: the dispatch's explicit effort, else the
  `LOOM_EFFORT` the daemon's environment gives the child (applied by
  `spawn-claude.sh`), else, for the `claude` runtime, the CLI's own session
  default, the shipped constant `CLAUDE_DEFAULT_EFFORT` (`medium`; the daemon
  cannot read the CLI's setting, so keep the constant in step with it). Absent
  only when the runtime has no effort setting. Reporting does not change the
  `--effort` the child receives.
- `effort_source`: `explicit` when the dispatch named the effort, `default`
  for the `LOOM_EFFORT` or runtime default. Absent exactly when `effort` is.
  `sweep.outcome` carries the same value as `config.effort_source` and
  `loom.effort_source`, and `config.model_source=unknown` /
  `loom.model_source` when its `model` is absent.
  `sweep.outcome`'s `model` can later name a different model when the sweep
  mostly ran another one (#9465).
- `model_source`: `explicit` when the dispatch request named the model,
  `default` when the daemon chose it (`autonomous.model`, an experiment arm,
  the runtime default), `unknown` when no id can be named (`model` absent). A watchdog or reaper re-dispatch
  passes the previous sweep's model on, so it reads `explicit`.
- `attempt_index` / `trigger` / `previous_sweep_id`: the
  [attempt lineage](#sweepoutcome) `sweep.outcome` reports, derived the same
  way from this host's outcome journal at dispatch. Absent when the journal
  cannot be read or the repo slug does not resolve. Absent for every PR-set
  dispatch.

`runtime` is the admitted runtime adapter (`claude`, `codex`,
…) copied from the `sweep.global.dispatch` event — the same value
`SweepInfo::runtime` records — and is what lets a consumer say *which agent*
is working the sweep. Omitted when the dispatch did not name one; never
defaulted to `"claude"`.

`story_points` (Issue #9432, epic #9429) is the Curator's *a priori* size
estimate for the issue — the numeric value of its single `points:*` label, one
of `1`/`2`/`3`/`5`/`8`/`13` — carried here so a consumer can weigh the work
**in flight**, not only once it terminates. Same source and same contract as
[`sweep.outcome`'s own `story_points`](#story_points--the-curators-size-estimate-issue-9432);
it rides the `sweep.global.dispatch` event, resolved from the label list the
dispatch path's #4444 park-label guard already read (**no** extra forge round
trip). **Omitted, never `0`**, for an unsized issue, a defective points label
set, a skipped label read, and every PR-set dispatch (which claims no issue).

### `sweep.identity`

Update-only launch attribution (#8713), emitted under envelope schema version
`4` when an active sweep's resolved launch metadata becomes available:

```json
{"kind":"sweep.identity","repo":"example/project","visibility":"public","issue":42,"sweep_id":"sweep-42","runtime":"opencode","provider":"zai-coding-plan","model":"glm-5.3"}
```

`runtime`, `provider`, and `model` are optional, nonempty strings. `runtime`
may initially name the admitted adapter; provider/model are populated only from
the sweep's own `# LOOM_LAUNCH` record, never inferred from runtime or current
config. They describe the **sweep launch**, not all child roles' models. Missing
legacy metadata remains unknown; local profile, credential, account and path
fields are never copied into this record.

The collector samples active registries every five seconds (including adopted
sweeps after restart), reads at most 256 KiB per sweep per pass, and caches the
first resolved launch after the exact dispatch header. Large appended logs may
require multiple passes. Partial lines, previous dispatches, child-role launches,
and log truncation are handled without borrowing another launch's identity.
Records are emitted when the known identity changes and replayed after an
observed start/phase event. This repairs an identity update dropped because its
lifecycle row did not exist yet, including restart adoption, while retaining
the cached launch and read offset. The existing export flush cadence still applies.

The Worker applies identity only to an existing same-host active entry. It keeps
that entry's original start/phase and freshness timestamp; metadata alone is not
proof of progress. A late update never recreates a completed or reconciled-away
sweep. Public private-repository views retain runtime/provider/model but remove
repository/issue/sweep identifiers and all unapproved fields.

**Rollout:** deploy the consuming Worker/UI before updating daemon producers.
New consumers tolerate old producers with absent metadata; old consumers store
but ignore this new kind for live state. Existing SSE lifecycle topics and old
envelope versions do not change. After a producer restart, its registry-backed
scan can enrich a surviving Durable Object entry without replaying its start.

### `sweep.phase`

A sweep advanced to a new lifecycle phase (mirrors `sweep.issue.{N}.phase`).

```json
{
  "kind": "sweep.phase",
  "repo": "rjwalters/loom",
  "visibility": "public",
  "issue": 4703,
  "sweep_id": "sweep-issue-4703-0",
  "phase": "builder",
  "entered_at": "2026-07-30T12:03:20Z"
}
```

`phase` is a lifecycle name: `curator`, `builder`, `judge`, `doctor`, `merge`.

**Source and cadence (#4863)**: `Event::SweepPhase` — the record's only upstream —
is published by `SweepRegistry::sample_phase_transition`, which the reaper calls
once per live sweep per `reap_once` tick (the 30s reaper timer, plus every
read-path reap). It reads `.loom/sweep-checkpoint/issue-<N>.json` and publishes
**only when the phase changed since the previous tick**, so a sweep sitting in a
phase emits nothing further. The checkpoint's raw marker (`curator-done`,
`judge-rejected`) is normalized to the lifecycle vocabulary above before it is
published; an unrecognized marker passes through verbatim rather than being
guessed at, so `phase` should be read as "one of the five names, or an unknown
raw marker" — which is exactly how the dashboard types it
(`SweepPhaseName | string`).

Because the phase is polled rather than pushed, `entered_at` is the daemon's
*observation* instant, an honest upper bound on the real transition time.

### `sweep.completed`

A sweep reached a terminal state (the summary moment; richer detail is in the
paired `sweep.outcome`).

```json
{
  "kind": "sweep.completed",
  "repo": "rjwalters/loom",
  "visibility": "public",
  "issue": 4703,
  "sweep_id": "sweep-issue-4703-0",
  "completed_at": "2026-07-30T12:08:32Z",
  "result": "success",
  "tokens_by_model": [
    {
      "model": "claude-sonnet-5",
      "speed": "standard",
      "service_tier": "standard",
      "input": 48000,
      "cache_read": 15000,
      "cache_write_5m": 500,
      "cache_write_1h": 1500,
      "output": 6120
    }
  ]
}
```

`result` is one of `success`, `failure`, `cancelled`, `blocked`.

#### Per-model token usage (Issue #6384)

`tokens_by_model` is an **additive, optional** array — omitted entirely
(never an empty array, never a fabricated `0`) when no attributable
transcript was found for this sweep. Each row is a
`(model, speed, service_tier)` bucket with raw, **not cost-weighted** input
(`input` = `input_tokens` + `cache_read_input_tokens` +
`cache_creation_input_tokens`; `cache_read`/`cache_write_5m`/
`cache_write_1h` further split the cache portion) and output token counts —
the same shape and same underlying aggregation
(`crate::transcript_tokens::sum_sweep_tokens_by_model`) the safehouse
`completion-v1` envelope's own `tokens_by_model` field already carries, so
the two paths report identical per-sweep token data. This closes the gap
where a dashboard-sourced backfill (reconstructing completions from
`sweep.completed` + GitHub when the safehouse→egress path is down) had no
token data to fall back on.

Populated on the backfill/local-journal export path
(`observability::backfill::synthesize_completed`, copied verbatim from the
paired `sweep.outcome` record's own `tokens_by_model` — see below) **and**, since
Issue #9440, on the live event-bus path too: `collector::terminal_records` stays
a pure, I/O-free mapping and a post-pass (`collector::attach_outcome_usage`)
performs one usage read per terminal event off the reactor thread, applying it to
both records of the `sweep.completed` / `sweep.outcome` pair so the two can never
disagree. Before #9440 that path hard-coded both this field and
`sweep.outcome`'s `tokens_in`/`tokens_out` absent — see
"`tokens_status`" below for the measurement hole that produced.

This field is purely additive — a `schema_version` bump is unnecessary (see
"`schema_version` semantics" above). Like `pr_number`/`tokens_in`/
`tokens_out`, it is workload detail about a private repo and is not added to
the public (unauthenticated, private-repo) redaction allowlist
(`loom-ui:src/redaction.ts`) by this change.

### `sweep.outcome`

The full post-hoc outcome: model/config/effort, per-phase durations, terminal
result, PR number, and (Issue #5357) the sweep's work-output — tokens
processed and lines changed. (A distinct type from the daemon's internal
`sweep_outcomes::OutcomeRecord`, which #4704 maps this into for its journal.)

#### The `repo` contract (Issue #9442)

`repo` — on `sweep.outcome` and `sweep.completed` — is **always an
`owner/name` forge slug, or absent; never a local filesystem path**. When the
emitter cannot resolve the workspace's slug, the record omits `repo` and
carries `"repo_unresolved": true` instead (present only when unresolved — a
resolved record is byte-identical to a pre-#9442 one). Resolution order at
the outcome-journal emitter: the `LOOM_REPO` override, then `gh repo view`
(breaker-gated, fail-open); a `skip_label_flip` run — which gates every forge
read at that site — uses the `LOOM_REPO` override alone and keeps `visibility:
private`. The live event-bus collector resolves a path-shaped event value
locally from `git remote get-url origin` (parsed HTTPS/SSH URL — no network),
stamping `repo_unresolved` when that too fails.

Why: pre-#9442 records fell back to the workspace's display path on any
resolution failure — 71 of 134 distinct `repo` strings in the fleet D1 store
were host paths — which leaked host usernames/layout into fleet-wide views
and forced every per-repo query to carry a basename normalization step (a
basename collision across orgs silently merges two repos). Consumers should
treat absent-`repo` + `repo_unresolved: true` as a countable "unattributed"
bucket, never guess from the record's other fields. The OTLP mapping mirrors
this: `loom.repo` only when the slug resolved, plus `loom.repo_unresolved`
when it did not.

Pre-#9442 journal lines — including path-shaped ones — still parse (`repo`
is `#[serde(default)]`); the fix is at the emitters, not the readers.

```json
{
  "kind": "sweep.outcome",
  "repo": "rjwalters/loom",
  "visibility": "public",
  "issue": 4703,
  "sweep_id": "sweep-issue-4703-0",
  "model": "claude-opus-5",
  "effort": "high",
  "config": { "runtime": "claude", "arm": "B" },
  "phase_durations": [
    { "phase": "curator", "duration_sec": 12, "attempt": 1, "tokens_in": 4200, "tokens_out": 510 },
    { "phase": "builder", "duration_sec": 340, "attempt": 1, "tokens_in": 38000, "tokens_out": 4900 },
    { "phase": "judge", "duration_sec": 60, "attempt": 1, "tokens_in": 3100, "tokens_out": 400 },
    { "phase": "doctor", "duration_sec": 45, "attempt": 1, "tokens_in": 1800, "tokens_out": 200 },
    { "phase": "judge", "duration_sec": 20, "attempt": 2 }
  ],
  "total_duration_sec": 512,
  "result": "success",
  "disposition": "landed",
  "pr_number": 4710,
  "pr_numbers": [4698, 4710],
  "tokens_in": 48213,
  "tokens_out": 6120,
  "tokens_unattributed": { "tokens_in": 1113, "tokens_out": 110 },
  "lines_added": 214,
  "lines_deleted": 37,
  "tokens_by_model": [
    {
      "model": "claude-sonnet-5",
      "speed": "standard",
      "service_tier": "standard",
      "input": 18000,
      "cache_read": 11000,
      "cache_write_5m": 400,
      "cache_write_1h": 1100,
      "output": 2120
    },
    {
      "model": "claude-opus-5",
      "speed": "standard",
      "service_tier": "standard",
      "input": 30000,
      "cache_read": 4000,
      "cache_write_5m": 100,
      "cache_write_1h": 400,
      "output": 4000
    }
  ],
  "models_used": ["claude-opus-5", "claude-sonnet-5"],
  "doctor_cycles": 0,
  "judge_verdicts": [{ "attempt": 1, "verdict": "pass" }],
  "complexity": "routine",
  "story_points": 5,
  "tokens_status": "measured"
}
```

This example is deliberately a **Doctor-escalated** sweep, the shape that makes
the #9465 fields legible: it was dispatched on the `sonnet` arm
(`config.arm: "B"`) but most of its tokens were spent by `claude-opus-5`, so
`model` reports `claude-opus-5` (what actually ran) while `arm` keeps the
dispatch-time assignment, and it opened two PRs (`pr_numbers`) of which #4710
is the latest (`pr_number`). A single-model, single-PR sweep collapses to one
`tokens_by_model` row with `model` equal to it, and `pr_numbers == [pr_number]`.

`config` (free-form string map), `phase_durations`, `model`, `effort`,
`pr_number`, `pr_numbers`, `tokens_in`, `tokens_out`, `lines_added`,
`lines_deleted`, `tokens_by_model`, `tokens_unattributed`, `failure_class`,
`models_used`, `doctor_cycles`, `judge_verdicts`, `complexity`,
`story_points`, `tokens_status`, `tokens_status_reason`, and `no_phase_cause`
are omitted when empty/unset.
`config` is a map — not fixed fields — so operator-tunable knobs can be
captured without a schema bump. `disposition` (Issue #9441) is the one recent
addition that is **never** omitted — see its own section below.

`tokens_by_model` (Issue #6384) is the same per-model breakdown documented
under `sweep.completed` above — the same aggregation
(`crate::transcript_tokens::sum_sweep_tokens_by_model`), computed here with
the sweep's real start/completion instant
(`sweep_registry::outcome_journal::append_outcome_telemetry_journal`), and
the source `sweep.completed`'s own copy is taken from.

#### Work-output fields (Issue #5357)

Four **independently optional** fields, each omitted (never coerced to `0`)
when unavailable — a sweep with no PR carries no LOC pair; a sweep whose
Claude Code transcripts were pruned/rotated before capture carries no token
pair. The two pairs are unrelated to each other, so a record can carry
either, both, or neither.

| Field | Source | Notes |
|---|---|---|
| `tokens_in` | Sum of `input_tokens` + `cache_read_input_tokens` + `cache_creation_input_tokens` across the sweep's own Claude Code transcripts (parent session + every subagent). | **Raw**, not cost-weighted — this record already carries `model`, so a consumer applies whatever per-model pricing table it wants without a backfill when that table changes. |
| `tokens_out` | Sum of `output_tokens` across the same transcripts. | Kept separate from `tokens_in` — input and output tokens price very differently per model, so a cost-weighted total needs both counts plus `model`, not one pre-mixed number. |
| `lines_added` | `git diff --numstat` between the worktree's `HEAD` and its mainline merge base, summed. | **Local only — never a forge API call.** Sampled opportunistically while the worktree is still live (so a `--merge`-mode sweep's own synchronous post-merge worktree cleanup, which can complete before the daemon ever observes the sweep's process exit, does not erase it), with a live-probe fallback at outcome-write time for a sweep that died before any sampling tick. |
| `lines_deleted` | Same `git diff --numstat`, deletions side. | Kept as a separate field from `lines_added` (not a net) — a large refactor that adds and deletes a similar line count is not "no work done". |

Neither pair is added to the public (unauthenticated, private-repo) redaction
allowlist — like `pr_number`, they are workload detail about a private repo
and stay behind the same authenticated-only boundary (see
`loom-ui:src/redaction.ts`).

#### Per-phase token attribution (Issue #9443)

`phase_durations` entries are **per phase attempt**, and each carries that
attempt's own cost as well as its duration:

| Field | Type | Notes |
|---|---|---|
| `phase` | string | The lifecycle phase name, as before (`curator`, `builder`, `judge`, `doctor`, `merge`, …). |
| `duration_sec` | integer | Wall-clock seconds, as before. |
| `attempt` | integer | **1-based per phase name** within this record — the same numbering convention `judge_verdicts[].attempt` uses. A `curator → builder → judge(fail) → doctor → judge(pass)` lifecycle yields five entries, with `judge` attempt 1 and `judge` attempt 2 separately addressable. Omitted (never a fabricated `1`) on a record written by a daemon that predates this field, so a consumer can tell "attempt 1 of 1" from "this journal predates attempt numbering". |
| `tokens_in` | integer | This attempt's input-side tokens, on exactly `tokens_in`'s axis (uncached input + cache reads + cache writes). |
| `tokens_out` | integer | This attempt's output-side tokens, on `tokens_out`'s axis. Always present or absent together with `tokens_in`. |
| `tokens_by_model` | array | The same attempt's usage grouped by `(model, speed, service_tier)` — the per-phase counterpart of the record-level `tokens_by_model`, which is what makes a phase priceable when the Doctor ladder ran it on a different model than the Builder. Same presence contract as `tokens_in`. |

**Why per phase.** The record-level totals cannot separate *clean-landing cost*
(curator + builder + the **first** judge) from *rework cost* (Doctor and
re-judge loops), because both happen inside one sweep. With `attempt` making the
first judge addressable and each entry carrying its own usage, both are a
subtraction rather than a hand-scrape of transcripts.

**The partition invariant.** A sibling field, `tokens_unattributed`
(`{ "tokens_in": int, "tokens_out": int }`), reports the part of the record-level
totals that **no** phase entry accounts for, so the breakdown is a partition of
the sweep total rather than a second, unreconciled measurement:

```text
Σ phase_durations[*].tokens_in  + tokens_unattributed.tokens_in  == tokens_in
Σ phase_durations[*].tokens_out + tokens_unattributed.tokens_out == tokens_out
```

The remainder is real, not slop. It collects the trailing in-flight segment
(last observed phase completion → terminal transition, the same segment
`phase_durations` already declines to name a phase for), every transcript record
carrying no usable `timestamp`, and — for a runtime whose usage store has no
per-record instant, or a sweep whose transitions were never sampled — the
**whole** total.

**Unknown is absent, never `0`.** A phase attempt whose usage could not be
measured omits `tokens_in`/`tokens_out`/`tokens_by_model` entirely; its share
shows up in `tokens_unattributed` instead, so "this phase was free" and "this
phase was not measured" never look alike. `tokens_unattributed` is itself
omitted when `tokens_in`/`tokens_out` are unknown: there is no total to take a
remainder of, and `0` would claim the phases account for everything. The
fallback single entry a daemon-restart record falls back to carries **no**
usage for the same reason — with no sampled window, attributing the whole sweep
to the one phase that happened to be observed last would be a fabrication.

**Accuracy.** Attribution windows are the sampled phase-transition instants, so
a phase's tokens are accurate to within one reaper tick — the same caveat
`phase_durations`' durations already carry (see "**`phase_durations` is
sampled**" below). Attribution is per transcript **record**, keyed on each
record's own `timestamp`, after per-message dedupe: a streamed message whose
chunks straddle a phase boundary is counted once, in the phase it started in,
which is what keeps the sum from exceeding the total.

**The same numbers reach OTLP.** `loom.phase_durations`' nested entries carry
`attempt`/`tokens_in`/`tokens_out` (same absent-not-zero discipline), and the
remainder is exported beside the totals as `loom.tokens_unattributed_in` /
`loom.tokens_unattributed_out`, so an OTLP consumer can check the same
invariant. The per-phase `tokens_by_model` breakdown is deliberately **not**
nested there — it reaches OTLP the better way, as this sweep's
`loom.runtime.usage` spans with `loom.usage.scope=attempt`, one per model under
the matching `loom.role_attempt` span (Issue #8525). A phase with no attempt
span in the trace is skipped rather than given a fabricated parent; the JSONL
record still reports its usage.

**Redaction.** The nested usage is workload detail about a private repo, exactly
like the record-level `tokens_in`/`tokens_out` above, so `phase_durations`
reaches a public, unauthenticated response only through
`redactPhaseDurations` in `loom-ui:src/redaction.ts` — which keeps
`phase`/`duration_sec`/`attempt` and drops every usage key.
`tokens_unattributed` is not in the public allowlist at all, being a remainder
of the same withheld totals.

#### `tokens_status` — why the token pair reads the way it does (Issue #9440)

Before #9440 the token pair was computed only for a sweep that still had a live
registry entry at its terminal transition, and the live event-bus collector path
hard-coded it absent outright. Measured against the fleet's D1 store over
2026-08-15..09-29, **10.3%** of `sweep.outcome` records carried `tokens_in` at
all (2,707 of 26,260) — flat on every host and every week. A failed or cancelled
attempt was almost always token-less, so a per-issue "total tokens to land" sum
collapsed onto the single landing sweep (Spearman 0.996 against that sweep's own
tokens; 96% of landed issues at a ratio of exactly 1.0). That was an artifact of
the measurement, not a property of the work: on the 20 multi-attempt issues that
*did* have complete tokens, lifecycle cost was a median **1.5×** the landing
sweep's.

Two independently optional fields close it. They make **absence readable**,
which is what a lifecycle sum needs — not more counters.

| Field | Type | Source | Notes |
|---|---|---|---|
| `tokens_status` | string (`measured` \| `not_spawned` \| `unattributable`) | `crate::sweep_usage::resolve`, the single resolver both construction sites (`sweep_registry::outcome_journal` and `observability::collector`) now share. | A **closed** vocabulary, so a consumer can `GROUP BY` it. Present on every record this daemon writes, whatever the `result`; a record written before #9440 omits it, which reads as *unknown* — **not** as any of the three statuses. |
| `tokens_status_reason` | string | The death class for `not_spawned`; one of `no-sweep-window` / `no-usage-store` / `no-attributable-transcript` for `unattributable`. | Short, enumerable, never free-form prose — the point of separating the absence cases is that each one is countable. Always absent for `measured`: a measurement needs no excuse. |

The three statuses, and exactly what the counters do under each:

| `tokens_status` | `tokens_in` / `tokens_out` | `tokens_by_model` | What it means |
|---|---|---|---|
| `measured` | present | present when the breakdown was readable | An agent process ran and its usage was read. Includes a **partial** read — a sweep cancelled mid-Builder, or watchdog-killed — because those tokens were really spent. Invariant: at least one of `tokens_in` / `tokens_by_model` is present. |
| `not_spawned` | **`0` / `0`** | absent | No agent process ever ran: every `preflight-*` class plus `no-usable-account`, none of which reaches the CLI. This is the **only** status that publishes a zero, because here zero is the observation. `tokens_by_model` still stays absent — a sweep that never ran has no *model* to attribute a zero row to. |
| `unattributable` | **absent** | absent | Something ran (or could not be proven not to) and its usage could not be attributed. `tokens_status_reason` names which: the sweep's wall-clock window was unknown (`no-sweep-window`), the runtime's usage store does not exist on this host (`no-usage-store`), or the store held nothing for this sweep in its window — the pruned/rotated-transcript case (`no-attributable-transcript`). |

This is the same "unknown != zero" contract the rest of this record follows, made
explicit rather than inferred: `not_spawned`'s `0` is a measurement, and
`unattributable`'s absence is the absence of one. A consumer that coerces an
`unattributable` record to `0` re-creates precisely the undercount #9440 removed.

Two deliberate non-classifications:

- **`account-exhausted:*` is never `not_spawned`.** Those classes are matched
  from rate-limit / credit signatures the CLI itself printed, so the CLI ran and
  very often burned tokens first. Calling that a zero would re-introduce the
  undercount in the one shape where the spend is real and interesting.
- **A read is never unbounded.** Every reader behind
  `usage_source::sweep_tokens_by_model` is window-filtered, because a per-issue
  transcript directory accumulates *every* dispatch of that issue. A sweep whose
  registry entry is already gone reconstructs its window from the measured
  `total_duration_sec` (the terminal transition is happening now, so the sweep
  began that long ago); a sweep with neither a start instant nor a positive
  duration reports `no-sweep-window` rather than folding an earlier attempt's
  tokens in. Turning an undercount into a silent double-count would be strictly
  worse.

Neither field is added to the public redaction allowlist, for the same reason as
the work-output pair above. Cross-file `message.id` dedupe within a window is
out of scope here (#9315) — the fold this reuses is unchanged.

#### Completeness fields (Issues #8056, #8222, #8542)

Five more **independently optional** fields, added additively (no
`schema_version` bump — none of them is a new record kind). Each answers a
question that previously required joining the sibling `sweep-outcomes.jsonl`
by `sweep_id`, or could not be answered at all.

| Field | Type | Source | Notes |
|---|---|---|---|
| `failure_class` | string | The paired `sweep_outcomes::OutcomeRecord`'s own classification for the same terminal transition: `death_class` when the pre-flight classifier derived one (`preflight-token-selection-failed`, `preflight-no-cli-start`, …), otherwise `crash_classification` (`account-exhausted:model-credits-exhausted`, `no-usable-account`, …). | Copied at emit time in the same function that writes the sibling record — never a post-hoc joiner. Lets a consumer separate real build failures from sub-60s spawn deaths from this journal alone. The sibling record still carries both classifier fields separately; this is the single most canonical label, not a replacement. Omitted entirely when nothing classified the transition — including on every success. |
| `no_phase_cause` | object `{ "exit": string, "last_step": string, "reason": string }` | Issue #10642. Present **only** when `failure_class` is the synthesized `unclassified:no-phase-signal`. `exit` is the orchestrator's exit code as a decimal string, or `none_observed`; `last_step` is the last checkpoint phase (`curator`…`merge`, else `other`), or — with none — `cli_started` / `pre_cli` from this dispatch's log, or `none` when the log could not be read; `reason` is one of `killed_or_exit_unobserved`, `clean_exit_without_checkpoint`, `nonzero_exit_without_checkpoint`, `died_before_cli_start`, `log_unreadable`. | Closed vocabularies, so each field can be grouped on. Also emitted as `loom.no_phase.exit` / `loom.no_phase.last_step` / `loom.no_phase.reason` on the `loom.sweep` span and the `sweep.outcome` OTLP log record. Additive; no `schema_version` bump. The same class is counted toward the PR-less retry hold from this journal (see `daemon-reference.md`, "Phaseless deaths have a durable floor"). |
| `models_used` | string array | The distinct `model` ids in `tokens_by_model`, sorted and deduped. | The top-level "did this sweep run more than one model?" signal. Since #9465 `model` names the **dominant** model that actually ran (the largest input+output row in `tokens_by_model`, dispatched model as fallback), so a sweep that escalated to `claude-opus-5` through the Doctor ladder reports `model: "claude-opus-5"` with `config["arm"]` still carrying the dispatch-time arm — `models_used` is what shows that the *earlier* phases ran something else. Inherits `tokens_by_model`'s contract exactly: omitted (never `[]`) when no attributable transcript was found. |
| `doctor_cycles` | integer | **The forge label timeline** of the PR named by this record's own `pr_number` (Issue #8222 — re-sourced; the #8056 shipment counted sampled checkpoint markers instead): one cycle per `loom:changes-requested` arrival that a later `loom:review-requested` arrival closed the loop on. | A rejection nobody handed back (the sweep hit the Doctor-cycle cap, or died) is **not** a cycle. Because the label events are durable forge state rather than a ~30s sample, a cycle that opens and closes between two reaper ticks is still counted: this is a certified count, **not** the lower-bound proxy it was under #8056. `0` means "the timeline was read and no Doctor cycle completed"; an **absent** key means the timeline was not read at all. |
| `judge_verdicts` | array of `{ "attempt": int, "verdict": string }` | The same PR's label timeline: `loom:pr` ⇒ `"pass"`, `loom:changes-requested` ⇒ `"fail"`, in lifecycle order. | What makes **first-pass judge approval rate** computable from this journal alone: `judge_verdicts[0].verdict == "pass"` over the records that carry the field. `attempt` is **1-based per PR**, counting `loom:review-requested` arrivals — attempt 1 is the PR as first opened, attempt 2 the pass after the first Doctor hand-back. A repeat of the same verdict inside one attempt (a label removed and re-applied) is one entry, not two. `[]` means "the timeline was read and carried no verdict" (a sweep that died before Judge); an **absent** key means the timeline was not read. |
| `complexity` | string (`mechanical` \| `routine` \| `complex`) | One more best-effort REST read at the SAME terminal transition, of the sweep's own issue body's `<!-- loom:complexity=<tier> -->` marker (Issue #8542) — the same marker `resolve-tier-model.sh` reads at dispatch time to pick a model, re-read here rather than plumbed through dispatch because there is no single dispatch-time seam shared by every entry point (`dispatch_sweep`, the epic supervisor, the work finder, the role runner). | What makes a model-routing decision (`sweep.tierModels` / `sweep.optimization`, or a future classifier-driven router) evaluable against a labeled outcome. Unlike `resolve-tier-model.sh`'s own dispatch-time fold (an absent/unrecognized marker there is a **safe default**, `routine`, for model selection), this field is never defaulted: an unmarked issue, an out-of-vocabulary value, or a failed/skipped read all omit the key. A routing-evaluation consumer needs the true absence rate, not a default masquerading as data. |

**Which PR the two timeline fields describe.** Exactly the one named by this
record's `pr_number` — the latest PR the sweep's own checkpoint recorded. A
sweep that opened more than one PR (a re-dispatch after a park, a
partial-increment slice) reports its **latest** PR and never aggregates across
PRs, so `attempt` numbering always restarts at 1 per record and a join from
`sweep.outcome` to a PR is exact rather than a blend. The full set is still
recoverable — `pr_numbers` (#9465) lists every PR the sweep carried — but the
timeline fields deliberately describe only the one `pr_number` names.

**When the timeline fields are absent.** Both are omitted together, and only
together: the sweep opened no PR, the daemon was configured not to touch the
forge, the fleet rate-limit breaker was suppressing forge polling, or the read
itself failed/timed out. The fetch is best-effort by contract — it never blocks
or fails the journal append, and a failure is logged and omitted rather than
recorded as a zero. `complexity`'s read is independent of `pr_number` (an
issue's marker exists whether or not a PR was ever opened) but follows the
exact same fail-open contract: `skip_label_flip`, the rate-limit breaker, or
any read failure omits the key, never a fabricated `"routine"`.

All five follow the established "unknown != zero" contract: `0` / `[]` / a
one-element array / a tier string is an observation, an absent key is not. A
consumer that coerces a missing `doctor_cycles` to `0` reports "no Doctor
cycle happened" about a sweep nobody watched; one that coerces a missing
`judge_verdicts` to `[]` counts an unobserved sweep into its approval-rate
denominator; one that coerces a missing `complexity` to `"routine"` conflates
"the Curator marked this routine" with "nobody looked".

None of the five is added to the public redaction allowlist, for the same
reason as the work-output fields above.

#### `story_points` — the Curator's size estimate (Issue #9432)

The one thing every actual on this record could not be compared against: an
*a priori* size. `story_points` is the numeric value of the issue's single
`points:*` label (`1`/`2`/`3`/`5`/`8`/`13`, the vocabulary
`defaults/docs/story-points.md` defines and the Curator applies at curation
time, epic #9429). With it on the record, "story points landed per day" (#9433)
and the estimate-vs-actual calibration loop (#9434) are a `GROUP BY` over this
journal instead of a join against the forge.

The throughput question is implemented: this field becomes the `story_points`
column of `sweep_facts`, and **SF8** in
`defaults/observability/sweep-facts/sweep-facts-queries.sql` answers "points
landed per day / per ISO week" from it (#9433). Two things that question set
fixes, and that any other consumer of this field must honour too: absent is a
reported **data gap**, never a zero (the four omission situations below), and the
values are **ordinal, not a unit** — sum the measured point value per bucket
(`landed-size.sql`'s `measured_point_values`), never the raw labels. See
`sweep-facts-questions.md` for the definitions and the capacity-tuning ops note.

| Field | Type | Source | Notes |
|---|---|---|---|
| `story_points` | integer (`1` \| `2` \| `3` \| `5` \| `8` \| `13`) | The `points:*` label in the label list the **same** REST read that sources `complexity` and the disposition end state already returns (`sweep_registry::outcome_journal::complexity_signal`), folded by `crate::story_points`. | **No extra forge round trip** — that read's `--jq` projection already includes `labels`, and using it is what makes the estimate provably about the same issue as `complexity`. The paired `sweep.started` record carries the same field resolved at *dispatch* time, from the label list the #4444 park-label guard already read. |

**Additive** (no `schema_version` bump — not a new record kind), and **absent is
never a measured zero**, the same contract the fields above follow. Four
distinct situations all omit the key:

| situation | why not a number |
|---|---|
| no `points:*` label | The issue was never sized — a pre-epic issue, an operator-filed issue, an uncurated issue. `0` would claim a Curator sized it at nothing, and would drag every mean estimate toward zero. |
| one label, out of vocabulary (`points:21`, `points:xl`) | A curation defect. Folding it onto the nearest legal bucket would invent an estimate nobody made; it is logged at `warn` and omitted. |
| **more than one** `points:*` label | There is no correct answer, so the daemon does not pick one. Enforced daemon-side (the guard #9431 leaves to this phase): the conflict is logged **loudly** — naming the issue and every offending label — and the key is omitted. First/last/largest/newest would each publish a number no human assigned. |
| the read failed, timed out, or was skipped | Same fail-open contract as `complexity`: `skip_label_flip`, the fleet rate-limit breaker, or any read failure yields no labels at all, hence no size. |

The label vocabulary is shared with the older `<!-- loom:points=<N> -->` body
marker (#9056) via `crate::points_marker::POINTS_VALUES`, so the label family
and the marker can never disagree about what a legal size is. Points are stored
in **labels**, not the body (adjudicated on #9431): labels are server-side
filterable and already fetched, so this phase introduced **no** new labels
connection at all — and where a future one is added, it caps `labels(first:)` at
the vocabulary size (`crate::story_points::POINTS_LABEL_PAGE_CAP`) so the cost
stays flat as an issue's label count grows.

**OTLP.** Both records export it as the numeric attribute `loom.story_points`
(absent when the field is), so a backend can `sum()` assigned points per window
and join them to `loom.tokens_in` / `loom.lines_added` /
`loom.total_duration_sec` on the same record. Not added to the public
redaction allowlist, for the same reason as the fields above.

#### `disposition` — what the sweep actually DID (Issue #9441)

`result` answers "did the process end well?", which is not the question a
throughput or effort metric asks. Measured on the fleet store over
2026-08-15..09-29 (26,260 outcomes): only **337 of 8,808 `success` records
carried a `pr_number`**, and 4,825 of them were sub-300 s runs with no PR, no
tokens and no phases — re-dispatch no-ops against an issue that was already
done (one issue accumulated 970 such "successes" over 40 days). On the other
side, 16,898 `failure` records folded 5,326 sub-60 s spawn deaths together with
235 genuine Judge rejections and 6,373 deaths nothing observed at all.

`disposition` is that missing axis. It is **required on every record written
since #9441**, low-cardinality, and **strictly additive**: `result` is emitted
unchanged beside it, so every pre-#9441 consumer keeps working.

| value | meaning |
|---|---|
| `landed` | The sweep produced a PR for its issue. |
| `noop_already_done` | Nothing to do: the issue was already closed before dispatch, or the run exited clean and short having produced no PR, no phase and no work. |
| `curator_closed` | The Curator closed the issue instead of building it (the "Issues Are Suggestions" path) — a correct outcome, not a failure. |
| `curator_rescoped` | The Curator handed the issue back to `loom:triage` / `loom:curated` (and off `loom:issue` / `loom:building`) instead of building it. |
| `env_failure` | The *environment* broke: spawn/pre-flight death, account or credit exhaustion, rate limit, harness execution error. |
| `substantive_failure` | The *work* did not succeed: the Judge rejected it, the Doctor loop was exhausted, or the Builder could not finish. |
| `cancelled` | An operator- or watchdog-initiated cancellation. |
| `unknown` | Genuinely unobservable. Counted, never silently merged into a neighbouring bucket. |

**Two invariants hold on every record the daemon writes**, both proven by
contract tests in `loom-daemon/src/telemetry/disposition.rs` (exhaustive over
the signal space) and on assembled records in
`sweep_registry/outcome_journal/disposition_tests.rs`:

1. **`disposition == "landed"` ⇔ `pr_number` is present.** This deliberately
   outranks `result`: a sweep cancelled after opening a PR still *produced*
   that PR, and "did this sweep land work?" must have exactly one answer.
   Nothing is lost — `result` still reports `cancelled` on such a record.
2. **`failure_class` is MANDATORY when `disposition` is `env_failure`,
   `substantive_failure` or `unknown`.** When no classifier labeled the
   transition, a bounded `unclassified:*` label is synthesized from the
   strongest observed signal (`unclassified:spawn-death`,
   `unclassified:judge-rejected`, `unclassified:doctor-loop`,
   `unclassified:stopped-after-<phase>`, `unclassified:after-<phase>`,
   `unclassified:no-phase-signal`, `unclassified:success-without-pr`,
   `unclassified:blocked-on-human-decision`). A real classifier label is never
   overwritten by a synthesized one, and the `unclassified:` prefix is what
   keeps the two tellable apart. Phase names in a synthesized label are folded
   to the closed `curator|builder|judge|doctor|merge|other` vocabulary, so the
   cardinality stays bounded.

**Derived, not newly instrumented.** The classifier is a pure function of
signals this record already carries — `result`, `pr_number`, `phase_durations`,
`total_duration_sec`, `failure_class`, `judge_verdicts`, `doctor_cycles` — plus
one addition that costs **no extra forge round trip**: the issue's own end
state (`state` / `closed_at` / `labels`), folded into the `--jq` projection of
the SAME REST read that already fetches the `complexity` marker. That end state
is what separates "already done" from "the Curator closed it" from "the Curator
rescoped it", three shapes the local signals cannot tell apart. It follows the
identical fail-open contract: a skipped or failed read simply yields no forge
opinion, and the classifier falls back to its local-signal arms.

**A pre-build label alone is deliberately NOT a rescope signal.** `loom:triage`
and `loom:curated` are *additive milestones* that outlive the state they once
described — Loom never strips `loom:curated`, so promotion (`loom:issue`) and
the Builder's claim (`loom:building`) both leave it in place and essentially
every built issue carries it for life. A rescope is therefore read only from a
pre-build label **plus the absence of `loom:issue` and `loom:building`**, which
is the shape a genuine hand-back actually leaves (the Curator's rescope removes
the ready/claim label by definition). `loom:issue` matters for a second,
independent reason: the reaper's own orphaned-claim recovery restores
`loom:building` → `loom:issue` before the record is written, so reading it as a
rescope would mislabel the entire failure population.

**An environmental `failure_class` outranks both label-derived forge answers**
(`curator_rescoped`, `curator_closed`). A dead token pool is not a Curator
decision no matter what an issue's labels say, and `curator_rescoped` is exempt
from invariant 2 — so letting a stale label shadow an explicit `preflight-*` /
`account-exhausted:*` verdict would both mis-bucket the record and drop its
obligation to say why it failed. The one forge answer that still outranks the
environmental arm is `noop_already_done` from an issue closed *before* dispatch,
because that is derived from a `closed_at` comparison rather than from a label
and cannot go stale the same way.

Unlike every other recent addition, `disposition` is **never skipped on
serialize**: a required field that silently disappears for one variant is
exactly the ambiguity this record already has too much of. A pre-#9441 journal
line carries no `disposition` key and decodes as `unknown` (`#[serde(default)]`)
— the readers drop rather than error on an unparseable line, so without that
default all historical records would vanish. Such a line legitimately fails
invariant 2: the invariants are a contract on records the daemon *writes*.

**Also on the span and the OTLP log record**, always beside `loom.result` and
never instead of it: the terminal sweep span carries `loom.disposition` in its
metadata, and the `sweep.outcome` OTLP mapping emits `loom.disposition` as an
unconditional attribute. A trace or OTLP consumer can therefore separate a
landing from a no-op re-dispatch without joining this journal.

Additive, so it did **not** bump `schema_version` — a new optional-shaped field
is not a breaking change, a new record kind is (see the version table above).
`disposition` is not added to the public redaction allowlist, for the same
reason `failure_class` is not: it is a strictly finer reading of *why* a
private repo's sweep ended. The coarse `result` stays public and unchanged.

`config.token_account` (Issue #8056) is now resolved from three sources at
emit time rather than one: the live registry entry, then a re-parse of the
sweep's own per-sweep log for the account-selection line `spawn-claude.sh`
wrote (the same parser restart adoption uses), then `"unknown"`. The middle
step is what makes the value real: the entry is absent for a sweep
reconstructed after a daemon restart, and carries a literal `"unknown"` when
the 5s dispatch-time capture window closed before the wrapper logged its
selection. `"unknown"` now means genuinely unknowable — no attribution
anywhere — not "nobody looked twice".

`config.credential_source` / `config.credential_provider` /
`config.credential_account` (Issue #8447) are the API-key pool's counterpart of
`config.token_account`, for a **native-harness** spawn. They are read back from
the child's own `# LOOM_LAUNCH` record in the per-sweep log (the record
`worker_spawn::run` writes, Issue #8401) — names only, never key material, and
never a fabricated `"unknown"`: a Claude/legacy-adapter spawn writes no launch
record, so all three keys are simply absent, keeping "not a native pool spawn"
distinguishable from "a pool spawn whose account could not be recovered". An
env-sourced or unpooled spawn records `credential_source` alone, with no
provider and no account, and so does a launch routed through the host's LLM
gateway (`credential_source: "gateway"`, #9473): its virtual key is a gateway
credential, not a pool account, and its spend is measured by the gateway
([`llm-gateway.md`](llm-gateway.md)). The sibling `sweep-outcomes.jsonl` record carries the
same three values under one optional `credential` object
(`{source, provider?, account?}`, `#[serde(default)]` so every pre-#8447 line
still parses). Additive per #4703 — no `schema_version` bump.

`config.tap` and the `config.tap_*` usage keys (Issue #8556) are the
**tap-attributed** layer over those credential keys: `tap` is
`<runtime>[:<model profile>]@<credential source>` — e.g. `claude@claude_tokens`,
`opencode:zai-metered@api_keys:zai`, `pi@harness-own` — the one composite
identity whose economics actually differ, since the same model family is
reachable through a flat-rate subscription and through a metered pay-per-token
endpoint under different providers. It is what
`loom-daemon sweep-outcomes summary --group-by tap` folds on, and therefore what
makes *"how much went to the metered backstop vs. the subscriptions"* a query
rather than a reconstruction. The credential half reuses
`runtime_preference::CredentialSource::wire()`'s spellings where the two overlap
(`api_keys:<provider>`), plus two the resolver never selects and which get their
own buckets rather than being folded into a pool's: `env` (an operator-exported
key) and `harness-own` (the harness's own auth store).

The counters — `tap_input_tokens`, `tap_output_tokens`, `tap_reasoning_tokens`,
`tap_cache_read_tokens`, `tap_cache_write_tokens`, `tap_cost_estimate`,
`tap_usage_events` — are read off the launch's own native event stream (Pi's
assistant `message_end`, OpenCode's `step_finish`; `agent_end` is deliberately
excluded because Pi repeats the same usage there and counting it would double
every Pi run). **Each key is written only when the harness actually reported it**
— a missing counter means *unmeasured*, not zero, and an absent key is how that
stays distinguishable from a reported `0`. `tap_cost_estimate` is spelled
"estimate" on purpose: per `runtime-model-trials.md` a harness cost figure is
directionally meaningful for a metered tap and is **not a charge at all** for a
flat-rate one, so it is a visibility instrument and never a billing
reconciliation. The sibling `sweep-outcomes.jsonl` record carries the same
reading under one optional `tap_usage` object (`{tap, usage}`,
`#[serde(default)]`), resolved from the **same single log read** as `credential`
so the two journals cannot disagree. Additive per #4703 — no `schema_version`
bump.

One anchored region can hold several `# LOOM_LAUNCH` records — a re-dispatch, a
containment re-exec, or an orchestrated sweep whose phases pin their own runtime
(`runtimes.rolePreference` / `LOOM_RUNTIME_<ROLE>`) — and #8633 stopped charging
all of them to whichever tap announced itself last. Issue #8659 fixes what a
one-row field does with the rest, and the answer is deliberately different on
the two journals:

- **`config.tap` and its counters stay exactly one tap** — the launch this
  outcome belongs to (the region's last record), now carrying **that tap's whole
  share of the region** rather than only its final block. This map is flat
  strings and `--group-by tap` puts a record in exactly one bucket, so a second
  tap could only be spelled here by changing what a grouped row means.
- **`config.tap_region_keys`** appears *only* when that single tap does not
  account for the whole region — more than one tap, or a last record that was
  unattributable while an earlier one was. It lists every tap in the region
  (outcome's first, comma-separated), so a telemetry-only reader can never
  mistake one tap's counters for the region's total.
- **`sweep-outcomes.jsonl` carries the breakdown**: `tap_usage_all`, one folded
  row per tap under the same condition `tap_region_keys` is written, and absent
  otherwise — so a single-tap line (every line written before #8659) keeps its
  exact key set. Unlike taps are never merged into one row; that is the #8633
  error restated.

Full rationale, and why this is a prerequisite of every fleet-wide spend
ceiling rather than one:
[`ADR-0020`](https://github.com/rjwalters/loom/blob/main/docs/adr/0020-fleet-metered-spend-ceiling.md).

`model` / `effort` likewise survive a daemon restart: the dispatch stamps both
into the claim lock's `owner.json` (alongside the child pid and process
group), and `reconstruct` restores them onto the adopted entry. A pre-#8056
`owner.json` has neither key and still parses; a dispatch that requested no
explicit model/effort still reports `null` — the honest "inherited the
session default", never a fabricated value.

#### Attempt lineage, rework events, and landing size (Issues #9444, #9454, #9465, #9466)

Fourteen more **independently optional** fields, all added additively (no
`schema_version` bump). Together they make `sweep.outcome` answer the four
questions the #9440–#9446 study showed it could not: *did this sweep land
work*, *were its tokens measured and are they plausible*, *why was it
dispatched*, and *how big was the work it produced*.

**`tokens_status` addendum — the `suspect` guard (Issue #9454):** on top of the `measured`/`not_spawned`/`unattributable` vocabulary #9440 shipped, a *measured* result whose input rate exceeds **100 000 input tokens per wall-clock second** (`sweep_usage::SUSPECT_INPUT_TOKENS_PER_SEC`) is re-classified `suspect` with reason `implausible_input_rate`. The counters are still published — flagged, never as a clean measurement — so a misattribution regression (the study's 250M-tokens-in-22-seconds shape) is visible per host per day (`sweep-facts-queries.sql` SF3) instead of silently poisoning per-issue cost sums. The attribution rule beyond the window and directories: attribution is **per usage record**, keyed on each record's own timestamp (Issue #9454) — a transcript file is never attributed whole. This is the root-cause fix for the implausible-rate population: the #8450 shape (a 292-second judge-only sweep reporting 136.8M tokens) happened because the file-level readers attributed a long-lived session's ENTIRE history to whichever sweep's window contained the file's last write. Per-record attribution means a session that predates the sweep contributes only the records it wrote during the window, so two back-to-back sweeps of one issue can never fold each other's sessions (the acceptance test). Directories still bound the scan: the workspace root and this issue's worktree; a sibling issue's worktree is deliberately excluded.

**Attempt lineage** (Issue #9444): `attempt_index` (1-based count of terminal
sweeps for this repo#issue in **this host's** durable outcome journal — the
honest per-host denominator, not a fleet one), `previous_sweep_id` (the
immediately preceding attempt), and `trigger` — why this sweep was
dispatched: `first` \| `retry_after_env_failure` \|
`retry_after_substantive_failure` \| `doctor_after_changes_requested` \|
`rebase_main_moved` \| `merge_conflict` \| `stale_base_rejudge` \|
`ci_failure_fix` \| `operator_redispatch` \| `unknown`. Derived at the
terminal transition from the previous attempt's disposition (or, for
pre-#9441 lines, its `result` + `failure_class`); `unknown` is counted. All
three are absent when the journal could not be read or the repo slug never
resolved.

**`rework_events`** (array of `{kind, reason?, classification?,
duration_sec?}`) — in-sweep rework observed by the terminal turn from two
sources. The first needs no writer at all: the worktree's own **HEAD reflog**
is read at the terminal transition, and a real `rebase (start)` performed by
a Doctor's conflict resolution or a `merge` of moved main records itself
there with a timestamp — the reflog IS the writer, and every reflog-derived
event is `environmental` (a reflog entry cannot prove the work was hard).
The second source is the append-only marker protocol for events only the
performing path knows: the performing path appends one JSON object per event
to `<workspace_root>/.loom/logs/sweep-rework-events.jsonl`
(`{"at":"<RFC3339>","issue":N,"kind":"rebase|merge_conflict|ci_rerun|rejudge",
"reason":"…","classification":"environmental|substantive","duration_sec":N}`);
the terminal outcome samples the file for its own issue and window. The
default classification when the writer omits one: `rejudge` ⇒
**`substantive`** (the work was hard); `rebase`, `merge_conflict`,
`ci_rerun` ⇒ **`environmental`** (the ground moved). Absent (never `[]`)
when no event was marked.

*Writers.* The reflog source above is the primary one and needs no writer
(#9511). The marker is appended by **`loom-daemon record-rework`**
(`--kind` ∈ the four above, `--issue N` or `--branch feature/issue-N`,
optional `--reason` / `--classification` / `--duration-sec`). It **always
exits 0** — a marker is telemetry attached to an operation that matters, so
an unwritable log directory or an unresolvable issue prints a reason and
records nothing rather than failing the merge it describes; an unknown
`kind`/`classification` is a clap-level argument error (exit 2), because a
typo that widens the vocabulary is a silent cardinality leak into every
rollup. Format, vocabulary, classification table and writer live in
`loom-daemon/src/rework_events.rs`; both readers
(`sweep_registry::outcome_journal::rework` — the marker reader and the
reflog reader) take the path, the `kind` and the classification from it, so
no end can drift.

*The two sources are disjoint by construction.* A marker records only
rework the worktree reflog **cannot** show — a forge-side branch update, a
merge refusal, a CI rerun, a rejudge. A rebase or merge performed with local
git in the sweep's worktree is **never** marked: the reflog already reports
it, and a marker would count it twice. The terminal turn therefore
concatenates both sources rather than de-duplicating them.

The first caller is `merge-pr.sh`, at two sites (#9444): a **`rebase`** when
the merge retry loop syncs a base branch that moved under the PR (via the
forge's update-branch API, which never touches the local worktree, so the
reflog cannot see it; `--duration-sec` is the settle wait it slept, the only
measured part), and a **`merge_conflict`** when it refuses a PR whose
`mergeable=false` was *corroborated* by a local `git merge-tree` check. The
uncorroborated refusal — "the forge's cached state is stale/unknown" — is
deliberately **not** marked: that is "nobody could tell", not "this branch
conflicts", and marking it would inflate the environmental bucket with
unanswered checks. Still unwritten, and the natural next callers:
`rejudge` (a Doctor claimed for `loom:changes-requested`) and `ci_rerun`. A
Doctor's own conflict rebase needs no marker — the reflog reports it.

The committed question set that turns these payload fields into the per-issue split lives in
`defaults/observability/issue-effort-queries.sql`, executed verbatim on
bundled SQLite by `loom-daemon/tests/issue_effort_sqlite.rs` and
vocabulary-checked by `loom-daemon/tests/issue_effort_artifacts.rs`: IE1 (the
per-issue clean / substantive-rework / environmental-rework split), IE2 (the
issues whose cost was mostly environment), IE3 (the attempt/trigger
distribution), IE4 (in-sweep rework by kind), IE5 (how much of the cost the
classification can attribute at all). It reads the raw `records` store,
complementing #9446's `sweep_facts` rollup (whose rework columns are
per-classification *counts*, not per-event durations).

**PR linkage and the model that ran** (Issue #9465): `pr_numbers` (integer
array, first-seen order) lists every PR the sweep's lifecycle was observed to
carry — the multi-PR slice shape the single `pr_number` (the **latest**) cannot
represent. `model` now names the model that **actually ran** — the dominant
entry in `tokens_by_model` (most input+output tokens) — falling back to the
dispatched model when nothing was attributed; the dispatch-time experiment arm
stays under `config["arm"]` (#4809), computed from the dispatched model.

**Landing size** (Issue #9466): `hw_lines_added`, `hw_lines_deleted`,
`hw_files` (hand-written lines/files of the sweep's own diff),
`generated_lines` (lines in generated-classified paths, reported not counted),
and `test_lines` (lines in test files). Classification is repo-owned: a
`generatedPaths` glob list in `.loom/config.json` (gitignore-like semantics: a
bare `*.ext` matches at any depth; `**` crosses segments; a config list
**replaces** the default) over the shipped default covering lockfiles,
`records/`-style output trees, simulator/netlist/physical-design output,
CSV/TSV dumps, minified bundles and vendored trees. Test files are any path
with a `test`/`spec` segment or a `test_*`/`*_test.`/`.spec.`/`.test.` name.
All five are absent (never 0) whenever the worktree's numstat could not be
read — the same contract `lines_added`/`lines_deleted` keep. The
`landed_size`/LSI rollup over these fields lives in
`defaults/observability/sweep-facts/` (#9446/#9466), beside its definitions
doc, and is **fitted** since `v1-2026-10-02` (#9934): the component
means/SDs and per-model token factors in `landed-size.sql` were fit by
`fit-landed-size.mjs` on the emitters' first four days (379 landings, 111
with `hw_*`, 374 with a clean token reading), and the token component scores
only clean `tokens_status` verdicts. The window is young — the refit is part
of the artifact: rerun the script over a longer window once `hw_*` coverage
matures, paste its `params` block, bump `params_version`.

### `role_tick.outcome`

One role-runner tick (Issue #8056) — the per-`(root, role)` counterpart of
`sweep.outcome`, and the record kind that moved `schema_version` to `2`.

Role ticks were, by measurement, roughly 60% of fleet token spend and emitted
**no** durable record at all. The daemon's only trace was an in-memory
`RoleTickRecord` — `{root, role, at, ok, detail, pool_exhausted}` — in a
process-global 2,048-entry ring that is lost on daemon restart and carries no
model, effort, duration, or token counts. Nothing about a role tick was
gradeable by a model or prompt experiment.

```json
{
  "kind": "role_tick.outcome",
  "repo": "rjwalters/loom",
  "visibility": "public",
  "role": "judge",
  "started_at": "2026-07-30T12:00:00Z",
  "duration_sec": 137,
  "result": "success",
  "model": "claude-sonnet-5",
  "effort": "high",
  "tokens_by_model": [
    { "model": "claude-sonnet-5", "speed": "standard", "service_tier": "standard",
      "input": 1200, "cache_read": 40000, "cache_write_5m": 900,
      "cache_write_1h": 0, "output": 3400 }
  ],
  "models_used": ["claude-sonnet-5"],
  "actions": { "issues_labeled": 3, "prs_merged": 1, "comments_posted": 4 }
}
```

| Field | Type | Always present | Notes |
|---|---|---|---|
| `repo` | string | yes | `owner/repo` from the checkout's `origin` remote (a local `git` call, never a forge round trip). Falls back to the workspace-root path when no GitHub remote resolves — same fallback `sweep.outcome` uses. |
| `visibility` | `"public"` / `"private"` | yes | Same private-by-default contract as every other repo-scoped record. |
| `role` | string | yes | `champion`, `curator`, `judge`, `doctor`, `auditor`, `hermit`, `guide`, `architect` — the `/loom:<role>` slash command the tick invoked. |
| `started_at` | RFC 3339 | yes | When the invocation began (not the interval boundary that scheduled it). |
| `duration_sec` | integer | yes | Wall-clock seconds to the outcome, including the pre-spawn preflights. A skip is typically sub-second; the value is real, so it is not optional. |
| `result` | enum (below) | yes | How the tick ended. |
| `model` | string | no | The model the runner **actually resolved and launched with**, including the #7894 unpinned-model reconciliation — not a re-read of config, so it cannot disagree with what ran. Omitted for a skip that bailed out before model resolution. |
| `effort` | string | no | The resolved reasoning-effort level (#8054). Omitted when unconfigured — the honest "inherited the runtime default", never a fabricated `"medium"`. |
| `detail` | string | no | The failure / skip detail, matching what the in-memory ring carries. Always absent for `success`. |
| `gated_pool` | `"claude_tokens"` / `"codex_accounts"` | no | Which credential pool gated a pre-spawn pool skip (#8408): the one the role's **admitted runtime** draws from — `.loom/tokens/` (else the shared pool) for `claude`, the `loom-daemon accounts` codex profiles for `codex`. Present only on `skipped_no_token_pool` and `skipped_pool_exhausted`; absent on every other result and on records written before #8408. Additive, so it did not bump `schema_version`. |
| `preference_tier` | integer | no | Which tier of the ordered runtime-preference list this tick launched on (#8599): `0` is the most-preferred tap — nothing fell through — and any higher value is a fall-through, so "how much work went to the metered backstop?" is a query over this key instead of a grep of `loom-daemon logs`. Absent whenever no preference list decided the launch (no `runtimes.preference` / `rolePreference.<role>` configured, an operator `LOOM_RUNTIME` pin, or a pre-spawn skip that never resolved a runtime) and on records written before #8599. `0` is a real value, so it is emitted as `0` — never elided. Additive, so it did not bump `schema_version`. |
| `preference_tap` | string | no | The chosen tap's identity (`<runtime>[:<profile>]`) when a preference list decided this tick (#8599) — the same rendering the `# LOOM_RUNTIME_PREFERENCE` marker and the launch record's `tap` key use, so one grep finds a tap across all three. Present exactly when `preference_tier` is. Additive, so it did not bump `schema_version`. |
| `tokens_by_model` | array | no | Same grouped, raw (not cost-weighted) shape as `sweep.outcome`'s `tokens_by_model`, summed from the tick's own transcripts. |
| `models_used` | string array | no | The distinct model ids in `tokens_by_model`, sorted and deduped — "did this tick's session escalate past the model it was launched with?" |
| `actions` | object | no | Forge-mutating work observed in the transcripts: `issues_labeled`, `prs_merged`, `comments_posted`. |

#### `result` — seven values, and why a skip is not a failure

| Value | Spawned a session? | Meaning |
|---|---|---|
| `success` | yes | Ran to completion, exit `0`. |
| `failure` | yes | Ran (or failed to start) and reported failure. |
| `skipped_load` | yes | Terminated at the wall-clock ceiling while the host was measurably saturated (#6637) — a starved tick, not a broken role. |
| `runtime_rejected` | no | Fail-closed runtime-admission rejection. |
| `skipped_no_token_pool` | no | No token pool provisioned for this workspace (#4642). |
| `skipped_pool_exhausted` | no | The credential pool the admitted runtime draws from has zero spawnable accounts (#7607) — `gated_pool` says which pool (#8408). |
| `skipped_model_runtime_mismatch` | no | The resolved model provably conflicts with the admitted runtime (#5028). |
| `skipped_queue_empty` | no | A queue-gated role (judge, doctor) found its work queue empty and spawned nothing (#9391). |

Folding the skips into `failure` is the exact mis-read #7607 documents: one
fleet-wide exhausted pool produces hundreds of identical exit-78 skips, which
must not read as hundreds of broken roles. Consumers computing a role failure
rate should use `failure` alone as the numerator and state whether skips are in
the denominator.

#### Reading an absent `tokens_by_model` / `actions`

The same "unknown != zero" contract as `sweep.outcome`: an unobserved
measurement is an **absent key**, never `0` / `[]` / `null`. For this record
the *reason* for an absence is recoverable from `result`:

- **A `result` that did not spawn** (the four rows above) has no transcript
  because no session ever existed. An absent `tokens_by_model` there means
  "correctly nothing", and the record deliberately refuses to attribute even a
  neighbouring session's transcript to it.
- **A `result` that did spawn** and still has no `tokens_by_model` means
  genuinely *unknown* — a pruned transcript directory, a `$CLAUDE_CONFIG_DIR`
  the daemon cannot read, or a session that flushed outside the attribution
  window.

`actions` is optional as a **whole object**, not per count: a present `actions`
with `"prs_merged": 0` means the transcript was read and no merge command
appeared in it, while an absent `actions` means no transcript was read at all.

#### Attribution is time-and-role scoped, and its limits are documented

A role tick has no issue number to key on the way a sweep does. A transcript is
attributed to a tick when all three hold: it lives under the workspace root's
Claude Code project directory, its first user message names `/loom:<role>`, and
its mtime falls inside the tick's own `[started_at, ended_at]` window widened by
5 minutes (`ROLE_TICK_WINDOW_SLACK` — deliberately far tighter than the sweep
path's 2 hours, which can afford a wide skirt because the issue number already
disambiguates). The role runner's run guard makes two concurrent ticks of the
same `(root, role)` impossible, so the one realistic ambiguity is an operator
running the same slash command by hand, on the same checkout, in the same
window.

`actions` counts are a **lower bound** by construction: they come from scanning
the transcript's `tool_use` blocks for the shell commands that perform each
action (`gh issue edit --add-label`, `gh pr comment`, `merge-pr.sh`, `gh api …
/merge`, …), so an action taken through a path the scanner does not recognize
is not counted, and a single command chaining several such invocations counts
once per bucket. Under-counting is preferred to over-counting: a compound
command must never inflate the number a fleet decision is made on.

### `session.summary`

One transcript's session shape (Issue #8757, G3 of epic #8714) — emitted by the
transcript-ingest pass (`activity/transcript_ingest.rs`), one record per
transcript (parent session or subagent) that the pass re-reads because it
changed, and exported through whatever exporter(s) `observability` configures.
A still-growing session is re-summarized on each pass that re-reads it; the
last record for a session is the complete one, mirroring the
replace-never-append semantics of the `resource_usage` rows it summarizes.

**A summary, never a transcript excerpt.** Every field is a count, an id, an
allowlisted name, or derived from timestamps. The parse that produces the
record never copies message text, tool arguments, or tool output — pinned by
the redaction test suite (`otlp/mapping/metadata/tests.rs` +
`activity/session_summary.rs`): a transcript containing a prompt, raw tool
output, a key and an email produces a record carrying none of the four.

```json
{
  "kind": "session.summary",
  "repo": "rjwalters/loom",
  "visibility": "private",
  "session_id": "agent-1",
  "parent_session_id": "7d8119a7-250a-48ca-a0ee-b4b2c7f14d92",
  "runtime": "claude",
  "role": "builder",
  "issue": 8757,
  "pr_number": 8790,
  "session_kind": "sweep",
  "models": ["claude-sonnet-5", "claude-opus-5"],
  "tokens_input": 12, "tokens_output": 24,
  "tokens_cache_read": 100, "tokens_cache_write": 10,
  "wall_ms": 181000,
  "turns": 1,
  "tool_calls": [{ "tool": "Bash", "count": 2 }],
  "tool_errors": 1
}
```

| Field | Type | Always present | Notes |
|---|---|---|---|
| `repo` | string | no | The `owner/name` forge slug, resolved from the session workspace's `origin` remote — a memoised local `git remote get-url origin`, never a forge round trip (#9445). **Absent, never a directory name**, when no remote answers: before #9445 this was the cwd basename, which for a worktree named `wood-reward` or `agent-afb133cdd702752a5` reported exactly that as the repo and made every row unjoinable. Resolution tries the cwd first (so any worktree layout works), then the enclosing workspace root (so a worktree removed on merge still resolves). |
| `visibility` | `"public"` / `"private"` | yes | Always `private` — resolving it truthfully needs the `gh` probe this pass deliberately does not make, so it stamps the fail-closed default every absent/unknown visibility decodes to anyway. |
| `session_id` | string | yes | The transcript's own `sessionId`, or the subagent file's stem for a `subagents/` transcript whose records restate only the parent's id. |
| `parent_session_id` | string | no | The enclosing session's uuid, for a `subagents/` transcript; absent for a parent session. |
| `runtime` | string | yes | `claude` — this pass reads Claude Code transcripts only (#8664's `loom.runtime` vocabulary; per-runtime tails are sibling work). |
| `role` | string | no | Attributed Loom role from the first user message (`attribute_role`); absent when unattributable. |
| `issue` | integer | no | The issue the session worked, from the first source that answers (#9445): the `/loom:<role> <N>` command's own first argument, then an `issue-<N>` worktree component in the cwd (`.loom/worktrees/issue-42`, or the `.claude/worktrees/` layout), then a `feature/issue-<N>` branch. Absent when none of the three names one — `session_kind` then says whether that was deliberate. |
| `pr_number` | integer | no | The PR recorded in the issue's own sweep checkpoint (`.loom/sweep-checkpoint/issue-<N>.json`), when that checkpoint was written **at or after** this session started (#9445) — the same freshness rule the registry's live-phase overlay uses, so an earlier dispatch's PR is never pinned onto a later session. Absent with no issue, before the sweep opens its PR, and for a stale checkpoint. |
| `session_kind` | `"sweep"` / `"role"` / `"interactive"` | no | Why `issue` is set — or deliberately is not (#9445). `sweep`: the session names an issue (a sweep, a subagent of one, or anything running in that issue's worktree or on its branch) — the rows per-issue cost sums over. `role`: a Loom role session with no issue (a scheduled support-role tick, or a hand-run `/loom:<role>`); role-tick issue attribution is #9231's scope. `interactive`: neither — **excluded from per-issue cost deliberately**, which is the point of naming it. Absent only on a record produced before #9445. |
| `models` | string array | yes | Distinct models used, sorted — the `(model, day)` bucket keys collapsed to their model axis. |
| `tokens_input` / `tokens_output` / `tokens_cache_read` / `tokens_cache_write` | integer | yes | The four counters `activity.db`'s `resource_usage` tracks, deduped by `message.id` (a streamed message counts once) and summed across buckets. |
| `wall_ms` | integer | yes | Last record timestamp minus first, milliseconds. `0` when the file carries no timestamps. |
| `turns` | integer | yes | Real user turns — user records whose content is not a tool result. |
| `tool_calls` | array | yes | Histogram of assistant `tool_use` blocks by tool name (`{ "tool", "count" }`), deduped by `message.id`; empty when the session used no tools. |
| `tool_errors` | integer | yes | Tool results flagged `is_error`. |
| `outcome` | string | no | Reserved — this pass has no positive terminal-outcome signal to read from a transcript, so it stays absent until the `session.analysis` slice (or registry correlation) can populate it honestly. |

On the OTLP path this maps to a log record (severity `Info`) with
`loom.repo`, `loom.session_id`, `loom.parent_session_id`, `loom.runtime`,
`loom.role`, `loom.issue`, `loom.pr_number`, `loom.session_kind`,
`loom.models_used`, `loom.tokens.input`, `loom.tokens.output`,
`loom.tokens.cache_read`, `loom.tokens.cache_write`, `loom.wall_ms`,
`loom.turns`, `loom.tool_calls` (kvlist array), `loom.tool_errors` and
`loom.outcome` attributes — all covered by the gateway collector's
`loom.*` privacy allowlist (contract-tested for the four join keys).
`loom.repo`, `loom.issue` and `loom.pr_number` are omitted rather than
defaulted when unresolved.

**Trace join (Issue #8908).** When a traced sweep dispatches, the daemon
writes a local join entry (`.loom/logs/trace-joins/<trace-id>-<span-id>.json`: issue,
root trace context, dispatch time; closed at the terminal transition). The
ingest pass stamps a summary's envelope `trace_context` (the OTLP log's trace
and span id) with that execution's root context when **exactly one** entry
names the summary's `issue` and its window covers the session's first
timestamp. With no issue, no entry or an ambiguous match, the log stays
unjoined. It is never guessed. Since #9445 the `issue` this keys on is
resolved from the worktree/branch too, not only from a slash-command
argument — which is what made the join fire at all: a subagent session's
first message is a role prompt, so before #9445 almost every row reached
SigNoz with an empty `trace_id`. The same trace carries the execution's
`loom.runtime.usage` span (see [`metric.points`](#metricpoints)).

### `session.analysis`

A derived per-session anomaly/quality rollup (Issue #8760, G3 part 2 of epic
#8714), computed alongside `session.summary` from the same parsed transcript
(`activity/session_analysis.rs`) and emitted at the same point in the
transcript-ingest pass — a still-growing session is re-analyzed on each pass
that re-reads it, mirroring `session.summary`'s own replace-never-append
semantics.

**Bounded, mechanical derivation only**: retry-loop detection, the longest
paired `tool_use`/`tool_result` call, a USD cost estimate from the existing
single pricing rate card (applied per-model across the transcript's own usage
buckets, so a multi-model session is costed correctly rather than
approximated from a flat total), and a fixed-threshold anomaly flag. **No
LLM-written prose summary** — that is explicitly a later slice, per #8714's
own G3 proposal.

**Same wire-safety contract as `session.summary`.** Every field is a count,
an id, an allowlisted tool name, a duration, or a derived dollar figure —
pinned by the redaction test suite (`otlp/mapping/metadata/tests.rs` +
`activity/session_analysis.rs`), extended for this kind the same way
`session.summary`'s was.

```json
{
  "kind": "session.analysis",
  "repo": "rjwalters/loom",
  "visibility": "private",
  "session_id": "uuid-a",
  "parent_session_id": "7d8119a7-250a-48ca-a0ee-b4b2c7f14d92",
  "retry_loops": [{ "tool": "Bash", "length": 3 }],
  "longest_tool_call": { "tool": "Bash", "duration_ms": 5000 },
  "cost_usd": 0.042,
  "anomalies": ["high_token_usage"]
}
```

| Field | Type | Always present | Notes |
|---|---|---|---|
| `repo` / `visibility` / `session_id` / `parent_session_id` | — | see `session.summary` | Copied verbatim from the source `session.summary` record — `session_id` is the join key a consumer uses to correlate the two records. `repo` is that record's `owner/name` slug since #9445, and is likewise absent (never a directory name) when unresolved. |
| `retry_loops` | array | yes | Maximal runs of `>= 3` consecutive invocations of the identical tool name, detected purely from call order and name (never arguments/output). `{ "tool", "length" }` per run. Empty (never omitted) when none were detected, so "computed and found none" is distinguishable from "not computed". |
| `longest_tool_call` | object | no | The `tool_use` -> `tool_result` pairing with the largest elapsed wall time, matched by the content block's own opaque call id (never by content). Absent when no pair could be matched (e.g. a transcript whose `tool_use` blocks carry no id) — never a fabricated zero duration. |
| `cost_usd` | number | no | Summed per-model across the session's own usage buckets via the shared rate card (`activity::resource_usage::ModelPricing`) — the same helper `transcript_ingest`'s own cost accounting uses. Absent when the transcript contributed no usage buckets at all — never a fabricated `0.0`. |
| `anomalies` | string array | yes | Anomaly flag classes raised for this session. One class today: `high_token_usage` (combined `tokens_input + tokens_output` above a static, initial-calibration threshold — **not** a live per-role fleet percentile; a true percentile needs a historical query this bounded, mechanical slice does not add). Empty (never omitted) when none were raised. |

On the OTLP path this maps to a log record (severity `Warn` when any anomaly
was raised, `Info` otherwise) with `loom.session_id`,
`loom.parent_session_id`, `loom.cost_usd`, `loom.longest_tool_call.tool`,
`loom.longest_tool_call.duration_ms`, `loom.retry_loops` (kvlist array) and
`loom.anomalies` (string array) attributes — all covered by the gateway
collector's `loom.*` privacy allowlist.

### `session.output`

Live, redacted, issue-scoped agent output, published while a run is still in
flight (Issue #9764). OTLP-only and opt-in. The full contract (content
boundary, schema, ordering, gaps, latency, consumer queries) is in
[`session-output.md`](session-output.md). This section records only how a
consumer tells **who started the agent** (Issue #10116).

Two producers emit the kind, and every record says which one with
`loom.session.output.launch`:

| `launch` | Producer | `loom.sweep_id` | `loom.attempt` |
|---|---|---|---|
| `daemon` | `loom-daemon`'s bus subscriber, for a sweep it dispatched | the dispatch's sweep id (`sweep-issue-<N>-<epoch>`) | the Nth run of that issue in this daemon's lifetime |
| `attended` | the attended tailer (`loom-daemon live-output-attend`, started by `lease ensure` at a claim step) for a Loom role run as a subagent of an attended Claude Code session | `attended-<first 8 chars of the session id>-<agent id>`: a pure function of the transcript | absent |

The rest of the identity is shared: `loom.repo`, `loom.issue`, `loom.role`,
`loom.session_id`, and the per-record `loom.session.output.stream_id` /
`.sequence` / `.event_id`. An attended run's `loom.repo` is the claim
checkout's `origin` remote, never the transcript's `cwd`. A payload queued
before #10116 carries no `launch` and decodes as `daemon`, which is what it was.
A record already exported before #10116 has no `loom.session.output.launch`
attribute at all; it too came from the daemon, so a consumer filtering on
`launch = daemon` should treat an absent attribute as `daemon`.
The attended tailer refuses to start in a process tree the daemon launched
(`LOOM_WORK_ORIGIN=autonomous`, `LOOM_SWEEP_ID`), so one run never appears
under both values.

### `daemon.event`

One of the four named event-bus topics that carried no telemetry record kind
of their own before this issue (Issue #8760, G4 of epic #8714):
`daemon.drain.*`, `daemon.capacity.advisory`, `daemon.preflight.advisory`,
and `epic.issue.*`. Host/daemon-level operational signals, not per-session
user work — carries no `visibility` tag, the same "references no repository"
contract `tokens.snapshot`/`host.health` already establish.

Deliberately generic — one record shape for four topic families — rather than
four new per-topic record types: every one of these topics is already a
small, frozen, operator-facing payload (`event_bus.rs`'s own documented
taxonomy) with no prompt/tool-output/secret content by construction, the same
shape the live SSE event-bus tail already exposes to an authenticated
operator.

```json
{
  "kind": "daemon.event",
  "topic": "daemon.drain.started",
  "payload": { "in_flight": 2, "timeout_secs": 300, "force_after_timeout": true }
}
```

| Field | Type | Notes |
|---|---|---|
| `topic` | string | The exact bus topic this record mirrors, e.g. `"daemon.drain.started"`, `"epic.issue.123.decompose"`. |
| `payload` | object | The event's own payload, exactly as published on the bus — see `event_bus.rs`'s topic table for each topic's shape. One documented exception, below. |

**The one payload field that is not carried verbatim**:
`daemon.preflight.advisory`'s `workspace_root` is reduced to its final path
component (`/home/alice/repos/loom` -> `loom`). It is the only absolute host
filesystem path anywhere in the four topic families, and no other telemetry
record kind ships one — an absolute path routinely embeds the operating
user's name, which is host-identifying in a way nothing else on this wire is.
The final component keeps the field's whole operational point (*which*
workspace in a multi-workspace fleet is failing preflight) at the same
repo-slug granularity `loom.repo` uses everywhere else.

Emitted by a dedicated bus subscriber (`observability/daemon_event.rs`)
alongside — not folded into — `collector.rs`'s own sweep/issue-scoped
subscription, since these four topics need none of that module's dispatch-
correlation or repo-slug-resolution state.

On the OTLP path this maps to a log record (severity `Info`) with
`loom.topic` and `loom.payload` (the payload carried whole as one
compact-JSON string, since its shape varies per topic) attributes.

### `ci.run` / `ci.job` / `ci.duration`

GitHub Actions telemetry from the `loom-daemon ci-telemetry` poller (#8824).
One envelope per completed run attempt (`ci.run`) and per completed job
(`ci.job`), each paired with a `ci.duration` histogram sample and a
`loom.ci.run` / `loom.ci.job` span. All three carry `repo` + `visibility`
(derived from the repo's `private` flag). Since #9089 each **executed step**
of a job additionally becomes a span-only envelope (`loom.ci.step`, a child of
its job span, built from the jobs API's `steps[]`), and each shell test suite a
sharded `Shell Test Suites` leg ran becomes one more (`loom.ci.suite`, also a
child of that job span, built from the leg's uploaded timings artifact) — both
span-only, no log record and no metric series, so the record kinds above are
unchanged. The full field tables, the
exactly-once ledger contract and the `loom.ci.*` allowlist live in
[`ci-observability.md`](ci-observability.md). They are not duplicated here.

### `ci.job.log`

One ≤ 8 KiB chunk of one completed job's log text (#8825), emitted only when
`autonomous.ciTelemetry.logCaptureEnabled` is on. A job's log is reconstructed
by ordering the `chunk_count` records that share a `(repo, job_id)` on
`chunk_index`.

**This is the only record kind whose body is free text the daemon did not
author.** Every other kind's body is a string this codebase wrote; this one's
is whatever GitHub's job-log endpoint returned, forwarded unfiltered apart
from the per-job size cap — by operator decision, the neutral OTLP gateway is
the redaction boundary, not the source. Two invariants follow and must not be
weakened:

- **No attribute is derived from log text.** The gateway's scrub stage
  rewrites the *body* only, so a log-derived attribute would ride straight
  past it. That is also why there is no `step` attribute (see
  [`ci-observability.md`](ci-observability.md) §"Why there is no `step`
  attribute").
- **A truncated log always reads as truncated.** `truncated` is true on
  *every* chunk of a capped log, not only the last, so a single record read in
  isolation can never look complete; the final marker chunk additionally
  carries `truncation_note` naming the cap.

Field tables, the chunking contract, the scrub-class list and the
`logs_done` idempotency contract live in
[`ci-observability.md`](ci-observability.md).

### `metric.points`

The generic operational-metrics carrier (Issue #8860): a batch of points any
daemon loop emits through `loom-daemon/src/observability/ops.rs`, instead of
inventing a record kind per signal. Envelopes carry `schema_version: 10`.
**OTLP-only** — the native HTTPS `/ingest` exporter drops it, like
`trace.span`, so the Cloudflare backend never sees it.

| Field | Type | Notes |
|---|---|---|
| `captured_at` | RFC 3339 | sample instant (the OTLP data-point time) |
| `interval_start` | RFC 3339, optional | start of the interval the batch's delta counters cover (OTLP `start_time_unix_nano`; the tick start for `loom.dispatch.decisions`); defaults to `captured_at` |
| `points[].name` | string | closed vocabulary, `telemetry::ops::MetricName` |
| `points[].value` | int or float | non-finite floats are dropped before the queue (at emit) and again at export |
| `points[].labels` | object | optional; keys limited to `OPS_METRIC_LABEL_KEYS` (`reason`, `provider`, `account`, `model`, `state`, `resource`, `task`, `heuristic`, `kind`, `repo`); values ≤128 bytes, no control chars, ≤8 per point |

Each name fixes its OTLP kind. `loom.dispatch.decisions` is a monotonic
**delta `Sum`**, one point per non-zero work-finder outcome per tick, labelled
`reason` ∈ `dispatched`, `labeled`, `in_flight`, `quarantined`,
`workspace_commands_missing`, `pr_open`, `peer_claim`, `backoff`,
`pr_open_backoff`, `noop_cooldown`, `declined`, `prless_retry`,
`recheck_interval`, `host_constraint`, `host_class` (#9034: a `loom:heavy`
candidate refused on a `local-dev` host), `capacity`, `ramp_cap`, `saturation`,
`build_backoff` (#9410: the build back-off held an unstarred issue build),
`out_of_slice`, `repo_cap` (#9090: the candidate's own repo was at
`maxConcurrentPerRepo`), `error`, plus the typed dispatch refusals (#8907):
`lease_order_lost` (lost the lease-order tie-break), `token_selection_failed`
(empty or fully bad-marked token pool), `claim_collision` (cross-host collision
enforcement) and `claim_lock_held` (the local claim lock already existed).
These are the same buckets as the `work_finder: tick` log line
(`loom-daemon health`'s last-tick summary omits `prless_retry` and
`host_class`), except that
the log line and `health` still fold `lease_order_lost` into `backoff` and the
other three into `error`. The exported `backoff` and `error` are net of them,
so each candidate is counted under exactly one reason. There is no
`worktree_locked` reason: the registry's dispatch path has no worktree lock
(the sweep child creates its worktree).
`loom.dispatch.slot_turnaround` (seconds) and `.samples`,
`loom.dispatch.idle_slot_seconds` (slot-seconds), and
`loom.forge.stage_dwell` (seconds) and `.samples` are also delta `Sum`s; see
"Worker turnaround and forge stage dwell" below.
`loom.queue.dispatch_wait` (seconds) and `loom.queue.dispatch_wait.samples`
(issues) are also delta `Sum`s. Together they give the summed queue dwell of the
issues dispatched in a tick, so the mean wait is `dispatch_wait / samples`.
Every other name is a **`Gauge`**:

| Metric | Unit | Cadence |
|---|---|---|
| `loom.dispatch.candidates`, `loom.dispatch.max_concurrent` | count | every work-finder tick |
| `loom.queue.oldest_wait` (`state` = `ready`/`blocked`) | seconds | every multi-workspace work-finder tick, only for a state with a waiting issue |
| `loom.queue.starved` (`state` = `ready`/`blocked`) | count | every multi-workspace tick, both states, `0` included |
| `loom.queue.starved.by_reason` (`reason` = queue disposition) | count | every multi-workspace tick, non-zero reasons only |
| `loom.host.memory.available_bytes`, `loom.host.memory.total_bytes` | bytes | `host.health` interval |
| `loom.host.swap.used_bytes`, `loom.host.swap.total_bytes` | bytes | `host.health` interval |
| `loom.agent_scope.peak_memory_bytes` (`repo`) | bytes | once per finished agent scope, sweep or role agent (cgroup `memory.peak`, #11094); `repo` is `(unattributed)` for a scope outside every workspace; absent without cgroup v2 |
| `loom.host.worktree_volume.free_bytes`, `loom.host.worktree_volume.total_bytes` | bytes | `host.health` interval |
| `loom.queue.issues` | count | every work-finder tick |
| `loom.queue.listing_failed_repos` | count | every work-finder tick |
| `loom.queue.listing_incomplete_repos` | count | every work-finder tick |
| `loom.dispatch.idle_slots` | count | every work-finder tick with an occupancy reading |
| `loom.forge.stage_items` (`state` = `curated`, `issue`, `building`, `review_requested`, `changes_requested`, `pr`) | count | `host.health` interval |

`loom.queue.issues` (Issue #8852, phase 2) is the ready-queue depth. It has
one point per queue disposition, labelled `state` (`running`, `ready`,
`blocked`) and `reason` (the disposition's wire name, as in
`queue.snapshot`'s `disposition`). Every disposition is emitted every tick,
**zeros included**, so an empty queue reads `0`. A missing series means the
host stopped ticking or exporting. Sum by `state` for the running / ready /
blocked split. `loom.queue.listing_failed_repos` counts the repos whose ready
listing failed on that tick; when it is non-zero, the depth is incomplete, not
low. `loom.queue.listing_incomplete_repos` (#11139) counts the repos whose
listing came back partial (a later page failed, the page cap, a mid-walk
change): their rows are counted, but not all of them. The depth is whole only
when both are `0`. Issue numbers and repos are never labels. The per-issue rows travel in
`queue.snapshot`.

Quota burn and pool state (Issues #8857, #8930, `observability/ops/quota.rs`), all on
the 5-minute snapshot cadence:

| Metric | Kind | Unit | Labels | Meaning |
|---|---|---|---|---|
| `loom.llm.tokens.input`, `.output`, `.cache_read`, `.cache_write` | delta `Sum` | `{token}` | `provider`, `model` | tokens spent host-wide since the previous sample |
| `loom.llm.requests` | delta `Sum` | `{request}` | `provider`, `model` | model API requests with usage in the same interval (one Claude `message.id`, Codex `token_count` delta, OpenCode step or Kimi `usage.record` each) |
| `loom.pool.accounts` | `Gauge` | `{account}` | `provider`, `state` ∈ `usable`, `exhausted` | accounts in each state; malformed or unverifiable API-key accounts are in neither, so `usable + exhausted` can be below the enabled count |
| `loom.pool.exhausted` | `Gauge` | `1` | `provider` | `1` when the pool has an exhausted account and no usable one |
| `loom.pool.exhaustions` | delta `Sum` | `{account}` | `provider` | accounts newly exhausted since the previous sample |
| `loom.pool.exhausted_seconds` | delta `Sum` | `s` | `provider` | the interval, credited when the pool read exhausted at its start (sample-and-hold downtime) |
| `loom.pool.account_state` | `Gauge` | `1` | `provider`, `account`, `state` ∈ `usable`, `exhausted` | per account (#11286): `1` for the state the account is in, `0` for the other, every sample |
| `loom.pool.plan_token_limit` | `Gauge` | `{token}` | `provider`, `account` | an API-key seat's declared plan allowance per window (`api-keys limit --plan-token-limit`); only where declared, never `0` |
| `loom.pool.plan_window_seconds` | `Gauge` | `s` | `provider`, `account` | that seat's declared plan window (`api-keys limit --exhaustion-window`); only where declared |

Burn is read incrementally from every subscription store on the host: Claude
transcripts (`provider=claude`), Codex rollouts including pooled profiles
(`codex`), OpenCode's `opencode.db` `message` table (the pool namespace, e.g.
`zai` for `zai-coding-plan`, else OpenCode's provider id) and Kimi
`wire.jsonl` (`kimi`). OpenCode steps are counted once by row id, reading only
rows newer than the oldest still-running step, so a completion committed late
still counts (#8966); Codex `cache_write_input_tokens` are cache writes, taken
out of input. Each sample reads only what was written since the last
one, each event counts once in the window its timestamp falls in (late writes
count in the current window), windows end 60 s before the sample and are
stamped at that end so they abut, and the first sample after daemon start only
anchors, so TPM/RPM are `rate(loom.llm.tokens.*)`/`rate(loom.llm.requests)`
with no double count and no replayed history. Pool state covers the `tokens.snapshot` accounts (Claude,
Codex) plus every enabled API-key-pool account (Z.ai, Kimi, …); the four
`loom.pool.accounts`/`exhausted`/`exhaustions`/`exhausted_seconds` families
are aggregated per provider with no `account` label, and the `account_state`
and `plan_*` families (#11286) carry the account's non-secret pool name.
Utilization against a declared plan (e.g. Z.ai) is computed downstream:
`loom.llm.tokens.*{provider}` summed over `plan_window_seconds`, divided by the
summed `plan_token_limit` — the daemon exports only the raw facts. OpenCode
burn includes every guarded per-launch store under the native-tools state dir
(the most recently written 128), which is where daemon-dispatched OpenCode
sweeps write (#11286). Delta counters start from the second sample.

Worker turnaround and forge stage dwell (Issue #8929), per host (the
resource `host.id`), never labelled by issue or repo:

| Metric | Kind | Unit | Labels | Meaning |
|---|---|---|---|---|
| `loom.dispatch.slot_turnaround`, `.samples` | delta `Sum` | `s`, `{slot}` | — | seconds from an issue sweep finishing (`sweep.global.completed`) to the next issue-sweep dispatch refilling the slot, FIFO; mean = ratio. Includes time with no work; the first dispatches after a restart have no freed slot to pair with and are not sampled |
| `loom.dispatch.idle_slots` | `Gauge` | `{slot}` | — | `max_concurrent − occupancy` at the end of a tick |
| `loom.dispatch.idle_slot_seconds` | delta `Sum` | `s` | — | `min(idle, waiting) × interval` for a tick that left ready work waiting (ramp cap, saturation brake, repo slice) with slots idle, held until the next tick and capped at 15 min |
| `loom.forge.stage_dwell`, `.samples` | delta `Sum` | `s`, `{item}` | `state` ∈ `created_to_curated`, `curated_to_issue`, `building_to_review_requested`, `review_requested_to_merged` | time spent in a forge label stage the work finder never lists; mean = ratio |
| `loom.forge.stage_items` | `Gauge` | `{item}` | `state` (the stage label) | open items under each stage label, over this host's repos |

The stage dwell reads the stage labels' listings with the ETag-cached REST
listing (a `304` costs no rate limit) every 5 minutes, plus at most 8 per-item
reads per sample (`issues/{n}/events` for a label time, cached per process;
`pulls/{n}` once when a PR leaves review). `created_to_curated` is sampled when
an issue newly appears under `loom:curated`, `curated_to_issue` when a
`loom:curated` issue newly appears under `loom:issue` or `loom:building`
(`loom:curated` is additive and stays on; promotion time is known to within
one 5-minute sample),
`building_to_review_requested` when a PR that closes a `loom:building` issue
newly appears under a review label (PR created minus the `loom:building`
time), and `review_requested_to_merged` when a PR leaves the review labels and
has merged (merged minus PR created). Sampling reads come first and cache
warm-up only spends the remainder; work over the budget waits, uncounted, for
the next sample. Only the first events page (100 events) is read. The reads
run off the collector loop, so a slow forge never stalls it. The first sample after start is a
baseline, so a restart never replays history. Every host managing a repo
samples it: sums scale with the host count, means do not. With
`fleet.captainGauges` configured (W12), only the fleet captain samples a repo
while its published data is fresh, and a dispatcher samples it again only when
that data goes stale (see "Fleet gauges produced by the captain" below).
Completed sweeps' own phase durations remain the cycle-time rollup's (#8692).

Merge-chain re-date pressure (Issue #10163, `observability/ops/redate_chain.rs`).
These are `Gauge`s over a trailing 24 h window, sampled on the `host.health`
cadence from local `git log` only, with no forge call. They are never labelled
by PR or repo. Read them with `max` across hosts:

| Metric | Unit | Labels | Meaning |
|---|---|---|---|
| `loom.merge.redate_prs` | `{pull_request}` | `state` ∈ `landed`, `pending`, `stuck` | PRs with at least one #8508 re-date commit. `stuck` is the subset of `pending` that has spent at least the default re-date budget (3). |
| `loom.merge.redates_max` | `{redate}` | `state` ∈ `landed`, `pending` | the most re-dates any one PR took |
| `loom.merge.time_to_land_max` | `s` | none | longest time from a PR's first re-date to its landing merge. Omitted when nothing landed. |

`redate_prs` and `redates_max` are emitted every sample, zeros included. The
per-PR rows are in `loom-daemon merge-pr redate-report --json` (`chains`); see
[`daemon-reference.md`](daemon-reference.md) §"Re-dates per PR and time to
land".

Long-running task liveness (Issue #10414, `observability/ops/liveness.rs`).
`task_alive` is sampled every 60 s on its own ticker, not on the collector's
pass. `task_faults` is emitted when a fault happens. The `task` label is a
fixed daemon loop name: `auto_update` or
`role_runner.<role>`. It is never a repo, issue or path.

| Metric | Unit | Labels | Meaning |
|---|---|---|---|
| `loom.daemon.task_alive` | `1` | `task` | `1` while the loop has beaten within its staleness window (two intervals plus 60 s, plus the loop's own iteration bound where it has one), `0` once it has gone silent past the window or marked itself dead |
| `loom.daemon.task_faults` | `{fault}` | `task`, `reason` ∈ `panic`, `overrun`, `exit` | a delta counter: an iteration panicked and was caught, an iteration ran past the loop's bound, or the loop stopped for good |

IPC request latency (Issue #10765, `observability/ops/ipc_latency.rs`).
Each IPC request is timed from its line being read to its response being
written, and exported every 60 s on its own ticker. `kind` is the request's
wire `type` tag (a `Request` variant name such as `DaemonStatus`,
`QuarantineList`, `ListWorkspaces`), or `invalid` for a frame that did not
parse. A kind with no requests in the interval emits no point. Event
subscriptions are not counted.

| Metric | Unit | Labels | Meaning |
|---|---|---|---|
| `loom.daemon.ipc.latency_max` | `s` | `kind` | the slowest request of that kind answered in the interval |
| `loom.daemon.ipc.latency` | `s` | `kind` | a delta counter: summed latency of the requests answered |
| `loom.daemon.ipc.requests` | `{request}` | `kind` | a delta counter: requests answered (with `latency`, gives the mean) |
| `loom.daemon.ipc.status_builds` | `{build}` | `outcome` | a delta counter: `DaemonStatus` builds finished (#10861) |

Concurrent `DaemonStatus` requests for the same section set share one build
(Issue #10861), so the three `kind` series are **per request**, not per
build. A request that joined a build already in flight is counted in
`requests`, and its latency is only the time it waited, so under concurrency
the mean (`latency / requests`) and `latency_max` can sit below the build
time. `status_builds` counts the builds themselves, once each however many
requests shared them: `requests{kind=DaemonStatus} / status_builds` is the
coalescing ratio. `outcome` is `ok`, `panic` (every waiting request got an
error frame) or `join_error` (the build task did not complete); an outcome
not seen in the interval emits no point. The section set is deliberately not
a label.

| Metric | Unit | Labels | Meaning |
|---|---|---|---|
| `loom.codex_session.state` | `1` | `account`, `state` ∈ `running`, `stopped`, `restarting`, `missing`, `stale_mounts`, `container` | per session-managed Codex account, `1` for the container's current state and `0` for the other four (#10455). `restarting`: Docker is backing off a crash loop (`State.Restarting`; counts as down). `stale_mounts`: the container's workspace mounts differ from what its workspace label would mount today: a registered root under the label is not mounted, a mount is no longer registered, or a mount is one `session start` now refuses although still registered (home, `firewall: true`) (#10364; the reconciler's own definition since #10600). No drift verdict, so never `stale_mounts`, while the workspace registry cannot be read. Only emitted when an enabled account is session-managed, and omitted for a pass where docker could not be queried (never reported as `missing`) |
| `loom.codex_session.record` | `1` | `account`, `kind` ∈ `hold`, `drift_removal`, `container` | per session-managed Codex account, `1` while that on-disk record stands, else `0` (#10600): `hold` is an operator `accounts session stop` (`.session-hold.json`); `drift_removal` is the reconciler's fail-closed removal for a denied mount (`.session-drift-removed.json`), which keeps the seat down. Emitted with `loom.codex_session.state`, and omitted the same way |
| `loom.codex_session.mount_drift` | `{path}` | `account`, `kind` ∈ `missing`, `extra`, `denied`, `container` | per session-managed Codex account whose container has a drift verdict (#10600): how many workspace paths drift that way. `missing`: registered roots it does not mount; `extra`: mounts no longer registered; `denied`: mounts `session start` refuses today (not counted in `extra`). Omitted for a missing, private-clone or unlabelled container, and while the registry cannot be read |

Fleet gauges produced by the captain (W12, `observability/captain_gauges.rs`).
Gauges on the collector pass, emitted only on a host that is the armed captain
or a dispatcher with `fleet.captainGauges.standDown`. `task` is the singleton job
name (`stage-dwell`, and `star-facts` / `queue-blocked` where those switches
are on), the same label key the task-liveness gauges use; never a repo or
issue. Configuration is in
[`daemon-reference.md`](daemon-reference.md#fleet-gauges-produced-by-the-captain-w12).

| Metric | Unit | Labels | Meaning |
|---|---|---|---|
| `loom.captain.gauge_age_seconds` | `s` | `task` | on the captain, the age of its own last finished pass of the job; on a dispatcher, the age of the captain's published `as_of` as last read. Omitted while unknown. Past `fleet.captainGauges.maxAgeSecs` the captain has stopped producing |
| `loom.captain.gauge_fallback` | `1` | `task` | dispatchers only: `1` while the captain's data for the job is stale or absent and this host produces it locally, `0` while it stands down |

The dwell names (#8856) are `loom.queue.oldest_wait`, `loom.queue.starved`,
`loom.queue.starved.by_reason` and `loom.queue.dispatch_wait[.samples]`. They
measure how long ready-queue issues have waited; for depth, use
`loom.queue.issues`. Their `blocked` state is narrower than the one
`loom.queue.issues` uses, because it leaves out deliberate holds such as parks,
open PRs and peer claims. Like depth, they are derived from the per-tick ready
queue (#8852), and
[`observability.md` §3c](observability.md#3c-operational-signals-from-daemon-loops-issue-8860)
defines which rows count as waiting and where dwell starts.
An unmeasurable host reading produces no point, never a `0`. Each work-finder
tick also emits one `loom.dispatch.tick` span. It is a new root trace per tick
that covers candidate evaluation and dispatch. Its attributes are
`loom.dispatch.result` (`dispatched`, `halted_main_red`, `halted_ci_billing` (#10113), `saturation_held`,
`error`, `build_backoff_held` (#9410; only when the back-off deferred at least one candidate, #10624),
`no_eligible_work`, `capacity_full`, `all_skipped`, first match wins), `loom.dispatch.seen`, `loom.dispatch.dispatched`,
`loom.dispatch.errors` and `loom.dispatch.max_concurrent`. Each `dispatch()` attempt in the
tick is one `loom.dispatch.admission` child span (#8907), with the tick's trace
id and the tick span as its parent. Its attributes are `loom.issue`,
`loom.dispatch.admission_result` (`dispatched`, `in_flight`, `refused`,
`error`) and `loom.dispatch.reason` (the `loom.dispatch.decisions` reason it
was counted under), plus `loom.repo`/`loom.repo.visibility` (Issue #9222) when
the admitting workspace's forge slug has already been resolved by the
collector — omitted, never a local path, on a cache miss — and the candidate's
queue position (Issue #9669): `loom.queue.candidate_rank` (1-indexed position
in the tick's shaped pass-2 candidate order) and `loom.queue.total_candidates`
(that order's length), present only when the tick recorded a plan order naming
this admission; a single-workspace tick records none. A `pr_open` refusal
in a locked repo also carries that repo's `lockout.*` weight (Issue #9674;
see the disposition span's table below). Its status is
`error` only for `error`.
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
