2AMLogic/gf180-usb2-phy/.loom/docs/daemon-reference.md

# Loom Daemon Reference

> **Status: ACTIVE (v0.10.0).** This page describes the Rust `loom-daemon`
> binary and its MCP-facing surface — the dispatch + pub/sub + monitoring
> tools delivered by epic #3449 (Phases A through C). The legacy Python
> `loom-daemon` brain (`loom_tools/daemon_v2/`) and the `/shepherd`
> orchestrator were deleted in the v0.10.0 deprecation epic (#3372). The
> shell-level `./.loom/scripts/daemon.sh` tmux session launcher was removed
> in #3432; use `./.loom/scripts/cli/loom-daemon-start.sh` / `loom-daemon-stop.sh`.

<!-- toc:begin generated by scripts/check-doc-tocs.sh --fix; do not edit by hand -->
**Contents**

- [What the daemon is](#what-the-daemon-is)
- [The `LOOM_ROLE` env-var contract (#6507)](#the-loom_role-env-var-contract-6507)
- [Architecture (Phases A-C)](#architecture-phases-a-c)
- [IPC surface (Request/Response variants)](#ipc-surface-requestresponse-variants)
- [Event taxonomy (frozen for v0.10.0)](#event-taxonomy-frozen-for-v0100)
- [MCP tool reference](#mcp-tool-reference)
- [In-memory registry layout](#in-memory-registry-layout)
- [Per-workspace registry pool (`WorkspacePool`, #3928/#3929)](#per-workspace-registry-pool-workspacepool-39283929)
- [Delegated daemon administration (`daemon.delegatedTo`, #5345)](#delegated-daemon-administration-daemondelegatedto-5345)
- [Fleet — operator-triggered multi-host worker fanout (`fleet`, #4340)](#fleet--operator-triggered-multi-host-worker-fanout-fleet-4340)
- [Fleet store — `fleet-config` (`fleet.repo`)](#fleet-store--fleet-config-fleetrepo)
- [Fleet model A/B — `sweep-experiment plan` (#8055 phase 1)](#fleet-model-ab--sweep-experiment-plan-8055-phase-1)
- [Token pool provisioning for managed repos (#3938)](#token-pool-provisioning-for-managed-repos-3938)
- [Per-repo status breakdown + per-repo main-health gate (#3930 — phase d)](#per-repo-status-breakdown--per-repo-main-health-gate-3930--phase-d)
- [Gate verdicts: VERIFIED_RED vs UNEVALUATED (#3974)](#gate-verdicts-verified_red-vs-unevaluated-3974)
- [Per-workspace priority tiers (#3946)](#per-workspace-priority-tiers-3946)
- [Forge-side pipeline snapshot (`status --pipeline`, #3977)](#forge-side-pipeline-snapshot-status---pipeline-3977)
- [Section-scoped status (`status --json --section`, #10787)](#section-scoped-status-status---json---section-10787)
- [One-shot fleet vitals (`loom-daemon health`, #4761)](#one-shot-fleet-vitals-loom-daemon-health-4761)
- [`.loom/state/` tracking contract (#9592)](#loomstate-tracking-contract-9592)
- [Reaper task](#reaper-task)
- [Stale-claim reconciliation & the sweep journal (#3953, fixed #3975, extended to PR-side claims #4367)](#stale-claim-reconciliation--the-sweep-journal-3953-fixed-3975-extended-to-pr-side-claims-4367)
- [Stacked-PR dependency — #3729 (v1), #3747 (v2 item 1)](#stacked-pr-dependency--3729-v1-3747-v2-item-1)
- [Epic supervisor (#3842)](#epic-supervisor-3842)
- [Curator intake reconcile (#10041)](#curator-intake-reconcile-10041)
- [Autonomous work finder (#3810)](#autonomous-work-finder-3810)
- [Operability — config, start/stop, E2E (Phase D, #3813)](#operability--config-startstop-e2e-phase-d-3813)
- [Reader withdrawal kill switch (`LOOM_READ_ROUTING`)](#reader-withdrawal-kill-switch-loom_read_routing)
- [Read-pool routing (`forge.readPool.routing`)](#read-pool-routing-forgereadpoolrouting)
- [Observability exporter (`observability`, #4705, epic #4702 Phase 1)](#observability-exporter-observability-4705-epic-4702-phase-1)
- [Fleet dashboard (`loom-daemon serve`)](#fleet-dashboard-loom-daemon-serve)
- [Locks and lifecycle](#locks-and-lifecycle)
- [What this page does NOT describe](#what-this-page-does-not-describe)
- [Related resources](#related-resources)
<!-- toc:end -->

## What the daemon is

`loom-daemon` is a Rust process that exposes a Unix-socket IPC surface
(framed JSON, line-delimited) and a paired `mcp-loom` MCP server which
maps each IPC request 1:1 to an MCP tool. The daemon is **the
coordination point** for:

- **Dispatching** `/loom:sweep` children with multi-account OAuth token
  rotation (via `defaults/scripts/spawn-claude.sh`).
- **Tracking** running sweeps in an in-memory registry (no on-disk state
  file — the forge is the source of truth for queue state).
- **Publishing** sweep-lifecycle events on an in-memory pub/sub bus, and
  **subscribing** external monitors to topic-filtered streams.
- **Cancelling** in-flight sweeps with SIGTERM → grace → SIGKILL.
- **Reaping** dead PIDs (every 30s) to maintain registry liveness and
  emit `sweep.issue.*.exited` / `sweep.issue.*.crashed` events.

**By default it is not a work generator.** With no autonomous config it
does not poll the forge for ready issues, it does not maintain a
`shepherd-N` pool, and it does not run support roles on cron — those
responsibilities live in `mcp__loom__dispatch_sweep` (operator-driven
enqueue) and the GitHub Actions cron workflows
(`.github/workflows/loom-*.yml`). Two **opt-in, default-off** surfaces
(epics #3809 and #3842) let the daemon generate and dispatch its own work
when explicitly enabled: the [autonomous work
finder](#autonomous-work-finder-3810) polls open `loom:issue` items and
auto-dispatches sweeps, and the [epic supervisor](#epic-supervisor-3842)
drives `loom:epic` fork-joins. See [Operability](#operability--config-startstop-e2e-phase-d-3813)
for enabling and tuning them.

## The `LOOM_ROLE` env-var contract (#6507)

`LOOM_ROLE` is a **public, stable session-identity contract**: repo-level
hooks/scripts (SessionStart hooks, guard hooks, any tooling that needs to
tell an operator's interactive session apart from a session Loom itself
spawned) **may branch on `LOOM_ROLE` being set** to detect "this is a
Loom-spawned agent session." Two shipped repo-level consumers already do
exactly this — `.loom/hooks/guard-destructive-generic.sh` (the
`dist/`-write-confinement role allowlist, #6021) and
`.loom/hooks/methodology-inject.sh` (role-context injection keyed off
`LOOM_ROLE` matching a `roles/<role>.md` filename) — see
[`guard-hooks.md`](guard-hooks.md) for the former.

**Semantics:**

- **Present** ⇒ this session was spawned by Loom (a dispatched sweep child,
  a role-runner tick, or a tmux/MOM agent launch), and its value names the
  role (or, for a whole `/loom:sweep` launch, the sentinel role
  `sweep-lifecycle`).
- **Absent** ⇒ not spawned by Loom — e.g. an interactive operator session
  (see the one residual gap below).

**What sets it** — every production code path that spawns an agent session
sets `LOOM_ROLE`, unconditionally once past its own admission/validation
step (traced against `origin/main` @ `7d169a06`, 2026-08-18; re-verify
against current `main` before relying on a specific line number, since a
new spawn call site could be added later):

1. `loom-daemon/src/sweep_registry/dispatch.rs` (~line 2089, inside
   `spawn_child`) — sets `LOOM_ROLE` to the already-admitted
   `admission.role` (always `"sweep-lifecycle"` for a full `/loom:sweep`
   launch) alongside `LOOM_RUNTIME`. Gated by `if let Some(admission) =
   runtime_admission`, but `runtime_admission` is only ever `None` when
   `self.config.skip_label_flip` is true — a test-only fixture flag
   (hermetic unit tests skip installing runtime manifests); every real
   dispatch either admits successfully or returns `Err` before the spawn
   is ever reached (Issue #4768).
2. `loom-daemon/src/role_runner.rs` (~line 1212, inside
   `run_role_with_timeout`) — same shape, for a periodic support-role tick
   (Champion/Curator/Judge/Doctor/Auditor/Guide/Hermit/Architect). Gated by
   `if let Some(admission) = admission`, where `admission` is only ever
   `None` when `self.spawn_bin.is_some()` — again a test-only condition (a
   fake spawn script substituted in tests); the production path
   (`spawn_bin` unset) always resolves a real admission or bails out before
   spawning (Issue #4768).
3. `loom-daemon/src/agent_session/spawn.rs` (~line 647, inside the
   tmux/MOM `run()` path used by `agent-spawn.sh` / interactive terminal
   launch) — sets `LOOM_ROLE` to `opts.role` **unconditionally**, no `if
   let Some` gate at all. `opts.role.is_empty()` is already rejected
   earlier in the same function (returns exit `1` before any tmux session
   is created), so by the time this line runs `opts.role` is guaranteed
   non-empty.

**Known residual gap**: an operator manually typing `/loom:<role>` (e.g.
`/loom:doctor`) inside an *already-running* interactive session produces a
role agent with **no `LOOM_ROLE` in its environment** — the session itself
was never spawned by any of the three paths above, so there is nothing for
a spawner to set. This case is structurally outside what an env-var
contract can cover (there is no spawn event to hook), and is handled
instead on the consumer side via a prompt-conditional directive. Do not
treat an unset `LOOM_ROLE` as proof no Loom role is active in the current
prompt — only as proof the *session* was not Loom-spawned.

A regression test pins this invariant against silent regression on the
`dispatch.rs` and `role_runner.rs` admission-success paths (the two call
sites gated by an `if let Some`) — see
`dispatch_sets_loom_role_from_admitted_role` (Issue #4768, pre-existing) and
`invoke_sets_loom_role_env_on_admitted_spawn` (Issue #6507) in
`loom-daemon/src/sweep_registry/dispatch.rs` and
`loom-daemon/src/role_runner.rs` respectively, plus
`test_run_sets_loom_role_session_env` in
`loom-daemon/src/agent_session/spawn.rs` for the unconditional tmux path.

`LOOM_RUNTIME`'s own contract is documented separately in
[`runtime-adapters.md`](runtime-adapters.md) — not covered here.

## Architecture (Phases A-C)

```
┌────────────────────────────────────────────────────────────────┐
│                      MCP clients (Claude Code)                 │
│  - dispatch_sweep, list_sweeps                          (A)    │
│  - publish_event, subscribe_to_events                   (B)    │
│  - get_sweep_status, tail_sweep_log, cancel_sweep       (C)    │
│  - tail_event_bus                                       (C)    │
└────────────────────────────────────────────────────────────────┘
                              │ stdio JSON-RPC
                              ▼
┌────────────────────────────────────────────────────────────────┐
│                    mcp-loom (TypeScript)                       │
│  - Validates args, normalizes payloads, formats output         │
│  - One MCP tool per IPC Request variant                        │
└────────────────────────────────────────────────────────────────┘
                              │ Unix socket, line-delimited JSON
                              ▼
┌────────────────────────────────────────────────────────────────┐
│                    loom-daemon (Rust)                          │
│  ┌──────────────────┐  ┌──────────────────┐  ┌──────────────┐  │
│  │ SweepRegistry    │  │ EventBus         │  │ ReaperTask   │  │
│  │ (BTreeMap)       │  │ (broadcast chan) │  │ (30s tick)   │  │
│  └──────────────────┘  └──────────────────┘  └──────────────┘  │
│                              │                                  │
│                              ▼                                  │
│                    fork+exec /loom:sweep N                      │
│                    via spawn-claude.sh                          │
└────────────────────────────────────────────────────────────────┘
                              │ detached child
                              ▼
                       /loom:sweep <issue>
                       (Claude Code session)
```
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
