2AMLogic/gf180-usb2-phy/docs/environment-setup.md

# Environment setup

What a clean machine actually needs to run this repo's verification harnesses.
Each toolchain section below is added by whichever issue first bootstraps that
harness, and records what was *actually* needed on the machine it was
verified on — not what was assumed. Do not overwrite another toolchain's
section; append a new one instead.

## Analog toolchain

Needed to run `sim/` — the ngspice PVT-corner harness ported from the sibling
[`gf180-bandgap`](https://github.com/2AMLogic/gf180-bandgap) repository (see
`sim/harness/README.md`).

### What you need

| Tool | Why | Verified install |
|---|---|---|
| `ngspice` | circuit simulation | macOS: `brew install ngspice` (verified: Homebrew `ngspice-46`). Debian/Ubuntu: `apt-get install ngspice`. |
| gf180mcu PDK | device models (`sm141064.ngspice`, `design.ngspice`) | `pip install volare && volare enable --pdk gf180mcu <hash>` — see below |
| `xschem` | schematic capture (optional; not required to run the corner harness) | macOS: `brew install xschem`. Debian/Ubuntu: distro package. |
| Python ≥ 3.9 | the harness itself | stdlib only — no `pip install` needed for `sim/harness/`, no virtualenv |

### Installing the PDK with volare

The harness resolves the PDK from environment variables, a config file, or a
set of built-in search roots — see `sim/harness/pdk.py`'s resolution order and
`sim/harness/README.md` § "Prerequisites" for the full list. The straightforward
path on a clean machine:

```bash
pip install volare
volare ls-remote --pdk gf180mcu           # find the open_pdks version to install
volare enable --pdk gf180mcu <version-hash>
```

`volare enable` installs into `~/.volare/<variant>` (e.g. `~/.volare/gf180mcuD`)
and the harness finds it there automatically via its built-in search roots —
no environment variables need to be set by hand. This repo's harness was
verified against an install at `~/.volare/gf180mcuD`, open_pdks commit
`c6d73a35f524070e85faff4a6a9eef49553ebc2b` (installed via `volare` prior to
this issue; `volare ls-remote --pdk gf180mcu` will show a newer commit by the
time you read this — any recent one that resolves via `volare enable` works,
the harness pins nothing PDK-version-specific).

If the PDK lives somewhere volare didn't put it (a shared CI cache, a
pre-provisioned container image), point the harness at it directly instead of
relying on the search roots:

```bash
export GF180_PDK_PATH=/path/to/gf180mcuD        # the variant dir, contains libs.tech/
# or the open_pdks / OpenLane convention:
export PDK_ROOT=/path/to/pdk-root
export PDK=gf180mcuD
```

### Verifying the install

```bash
python3 sim/run_corners.py --check-env
```

prints `ngspice : OK ...` and `PDK : OK ...` (with the resolved path and how
it was found) when both are present, or a install hint and a non-zero exit
when something is missing.

```bash
source sim/env.sh
```

is the acceptance check this section promises: run from a clean shell (a
fresh terminal, no pre-set `PDK_ROOT`/`PDK`/`GF180_PDK_PATH`), it must resolve
the PDK and print a line like:

```
gf180mcu: PDK_ROOT=/Users/you/.volare PDK=gf180mcuD
```

If it instead prints `gf180mcu: PDK not found -- run ...`, the PDK is not
installed or not discoverable by any of the resolution steps above — install
it with `volare` as shown, or set `GF180_PDK_PATH`/`PDK_ROOT` to wherever it
actually lives.

### Running the full harness self-test

```bash
bash sim/selftest.sh              # unit tests + a real 45-point PVT smoke run (writes nothing)
bash sim/selftest.sh --record     # also mint a real evidence record under sim/smoke-inverter/records/
```

`sim/selftest.sh` degrades gracefully: if ngspice or the PDK are missing it
still runs the harness's own unit tests (no PDK required) and reports `SKIP`
for the simulation stage rather than failing outright — pass `--require-pdk`
to make that a hard failure instead (useful in CI once ngspice/the PDK are
provisioned there).

## Digital toolchain

Needed to run `verification/` and `flow/` — the cocotb + Icarus testbench
structure and the `klt functional-verification` / `klt synthesize` request
shape, ported from the sibling
[`sky130-modexp`](https://github.com/2AMLogic/sky130-modexp) repository's
`docs/environment.md` (the pattern named in `CLAUDE.md`'s "Harness
bootstrap" section) and re-targeted from the sky130A PDK to gf180mcu.
`verification/records/**/*.md` cite the versions below in each record's
`klt provenance` field; if you re-pin anything here, mint fresh records
rather than editing old ones (see `verification/README.md`'s append-only
rule).

### Provisioning: `scripts/setup-env.sh`

```bash
./scripts/setup-env.sh
```

This creates a local `.venv`, installs `klayout-tools` (`klt`) into it at
the pinned revision below, fetches the pinned `gf180mcu` PDK version via
`volare`, and reports which of `iverilog` / `yosys` / `openroad` are
missing from `$PATH` — with an actionable install pointer for each, never a
traceback. It is safe to re-run; it reuses an existing `.venv` and an
already-fetched PDK version.

Activate the venv for interactive use with:

```bash
source .venv/bin/activate
```

### Tool-light mode: `scripts/setup-env.sh --tool-light`

For audit or lint hosts that only need the canonical `npm run lint` and
`npm run check:ci` commands (the same split CI uses), run:

```bash
./scripts/setup-env.sh --tool-light
source .venv/bin/activate
npm run lint
npm run check:ci
```

This provisions the same `.venv` with `klt` at the pinned revision and
`cocotb==2.0.1`, and prints the selected Python, `klt`, `cocotb`, and Icarus
versions. It does **not** install `volare`, create a PDK directory, or fetch
the PDK, and it does not need `yosys` or `openroad`. It exits nonzero with an
actionable message if Python (3.10–3.13, with `venv` support) is missing,
package installation fails, or `iverilog`/`vvp` are absent.

Host-administrator prerequisites (the script never installs system packages
and cannot provision Python): a compatible Python 3.10–3.13 with the `venv`
module, `git`, Node/npm, and Icarus Verilog (`iverilog` and `vvp`), plus
network access to GitHub and PyPI.

Bootstrap success only means the prerequisites are usable. It is not
verification evidence: `npm run lint` and `npm run check:ci` are separate
steps whose results must be reported on their own, and no verification record
is minted by installing tools. Re-running is safe; an existing `.venv` is
reused.

### Pinned versions

| Component | Pinned to | Resolved via |
|---|---|---|
| `klayout-tools` (`klt`) | release [`0.9.0`](https://pypi.org/project/klayout-tools/0.9.0/) (reports as `klt 0.9.0`) | `pip install "klayout-tools==0.9.0"` (what `scripts/setup-env.sh` runs) |
| `gf180mcu` PDK | `open_pdks` commit `c6d73a35f524070e85faff4a6a9eef49553ebc2b` (variants `gf180mcuA`/`B`/`C`/`D`; the digital harness uses `gf180mcuD`, whose standard-cell libraries are `gf180mcu_fd_sc_mcu7t5v0` / `gf180mcu_fd_sc_mcu9t5v0`) | `volare enable --pdk-root ~/.volare --pdk gf180mcu c6d73a35f524070e85faff4a6a9eef49553ebc2b` |
| `cocotb` | 2.0.1 (pulled in as a `klayout-tools` dependency) | installed alongside `klt` by `scripts/setup-env.sh` |
| Python | <= 3.13 (cocotb 2.0.1 refuses to build on 3.14+) | `scripts/setup-env.sh` auto-selects `python3.13` > `3.12` > `3.11` > `3.10` > `python3`, whichever is the newest compatible interpreter found on `$PATH` |

As of 2026-11-06 (issue #263) `klt` is pinned by PyPI release, `klayout-tools==0.9.0`
(move 10; issue #257's move 9 set the release-pin scheme at `0.8.0`),
everywhere (CI, the signoff grader and the `scripts/setup-env.sh` venv); move 9
below supersedes the git-revision pin described in moves 7 and 8. A git build
now reports a dev version and no longer satisfies an `==0.8.0` pin
(klayout-tools#2823), so do not go back to a `git+...@<sha>` install. The
history below is kept as recorded. Before move 9 the pin moved seven times
(move 8 records a decision not to move it):

1. `af5791b5` → `b3e284fff4243cdc5ab59a684d9c0582444b485d` by issue #25,
   specifically to pick up the netlist-driven layout-plan compiler/executor
   (klayout-tools PR #1158 "Phase C", `klayout_tools.layout_plan_execute`,
   plus its follow-up fix #1161) that `scripts/gen_analog_layout.py` calls
   — see `layout/README.md`.
2. `b3e284f` → `07b1f04f29f21b3f8551d3937183b206a57a5e3a` by issue #52.
   `b3e284f` was authored 2026-08-18T08:48:51Z; the friction issues that
   same exercise filed (klayout-tools#1163/#1164/#1165) all closed
   `COMPLETED` between 12:19Z and 14:33Z **that same day**, so the pin this
   repo carried predated every fix by hours despite never having been
   re-pinned since. `07b1f04f` is klayout-tools' `main` tip as of this
   move (2026-08-26T00:25:45Z) — confirmed (`gh api
   repos/2AMLogic/klayout-tools/compare/<fix-commit>...main`) to have every
   relevant fix commit as a strict ancestor. See
   `verification/records/analog-layout/records/20260826-003645-4644a26.md`
   for what re-measuring against it did and did not change.
3. `07b1f04f` → `8bd3f0b09a87641b093d655a7282b8f730db19e8` by issue #68,
   specifically to pick up two fixes this repo's committed analog plans were
   waiting on, both closed `COMPLETED` 2026-09-06 — klayout-tools#1502
   (merge [`815d8abadf4182bd1b2543c1dee2f7d04a5ee904`](https://github.com/2AMLogic/klayout-tools/commit/815d8abadf4182bd1b2543c1dee2f7d04a5ee904),
   PR #1509: `layout_plan_execute._resolve_routing_spec()` forwards
   `routing.cross_block_layer_role` instead of silently dropping it, and
   hard-fails on unknown `routing` keys) and klayout-tools#1501 (merge
   [`8d094b70628aae2d4cdba7544989c415c1f877a4`](https://github.com/2AMLogic/klayout-tools/commit/8d094b70628aae2d4cdba7544989c415c1f877a4),
   PR #1507: routing width and the via-drop square are floored at the
   resolved deck's own DRC minimums). Both are **strict ancestors** of the
   new pin — verified with the doc's own rule, `gh api
   repos/2AMLogic/klayout-tools/compare/<fix-commit>...8bd3f0b09a87641b093d655a7282b8f730db19e8`
   returning `status: "ahead"` with `behind_by: 0` for each (`ahead_by` 83
   and 84 respectively); the old pin `07b1f04f` is likewise `behind_by: 0`,
   `ahead_by: 189`. `8bd3f0b0` was klayout-tools' `main` tip at the time of
   this move (2026-09-09T20:48:26Z). The `klt` self-reported version crosses
   a minor boundary with this move (`0.3.0+g07b1f04f29f2` →
   `0.4.0+g8bd3f0b09a87`). See
   `verification/records/analog-layout/records/20260909-213500-29c5780.md`
   for what the pin bump alone changed with byte-identical plans, and
   `…/20260909-215500-29c5780.md` for what spending
   `routing.cross_block_layer_role` on `dplus_pullup` then bought.
4. `8bd3f0b0` → `bf90e1d5e3a624ea2e098efdfe76596081508751` by issue #70,
   specifically to pick up klayout-tools#1640's fix (merge
   [`df36f4fce8c63e367c132a3335369a877acc4ebb`](https://github.com/2AMLogic/klayout-tools/commit/df36f4fce8c63e367c132a3335369a877acc4ebb),
   PR #1662: `rm1`/`rm2`/`rm3` — plus `tm6k`/`tm9k`/`tm11k`/`tm30k` —
   gf180mcu metal-resistor device classes now recognised by
   `netlist_digest`), the ingestion blocker behind `differential_driver`
   being the only one of the five analog blocks klt could not ingest at
   all. The fix commit is a **strict ancestor** of the new pin —
   `gh api repos/2AMLogic/klayout-tools/compare/df36f4fce8c63e367c132a3335369a877acc4ebb...bf90e1d5e3a624ea2e098efdfe76596081508751`
   returns `status: "ahead"`, `behind_by: 0`, `ahead_by: 39`. `bf90e1d5e3a6`
   is not klayout-tools' bare `main` tip at the time of this move (`main`
   was one commit ahead, `160073f34f74e1796b903586a2f278a0438a6462`, whose
   sole parent *is* `bf90e1d5e3a6`, with several CI legs still `queued` —
   `gh api
   repos/2AMLogic/klayout-tools/compare/bf90e1d5e3a624ea2e098efdfe76596081508751...160073f34f74e1796b903586a2f278a0438a6462`
   returns `status: "ahead"`, `behind_by: 0`, `ahead_by: 1`); it is the
   newest commit whose own CI had fully completed with every check-run
   `conclusion: "success"` at check time. The pin move itself is much larger
   than that one-commit gap to `main`: `gh api
   repos/2AMLogic/klayout-tools/compare/8bd3f0b09a87641b093d655a7282b8f730db19e8...bf90e1d5e3a624ea2e098efdfe76596081508751`
   returns `status: "ahead"`, `behind_by: 0`, `ahead_by: 70` — 70 commits
   spanning 2026-09-09T20:48:26Z → 2026-09-12T18:19:29Z (just under three
   days), with the fix commit `df36f4f` 31 commits past the old pin and 39
   short of the new one (31 + 39 = 70). `behind_by: 0` means the old pin
   is a strict ancestor, so the move is still purely forward — a
   fast-forward, but not a one-commit one. The `klt` self-reported version does
   not cross a minor boundary this time (`0.4.0+g8bd3f0b09a87` →
   `0.4.0+gbf90e1d5e3a6`). **What the move bought, and what it didn't**:
   `differential_driver`'s netlist now ingests cleanly (confirmed live), but
   a committed plan still isn't possible — `klt gen`'s `res_array` generator
   has no drawn-geometry support for a gf180mcu metal resistor at all, and
   silently draws the wrong device (a poly resistor) instead of failing
   when a plan leaves `flavor`/`metal_level` at their defaults for an `rm1`
   device, a distinct, narrower gap filed generically as
   [klayout-tools#1731](https://github.com/2AMLogic/klayout-tools/issues/1731).
   See
   `verification/records/analog-layout/records/20260912-191922-5953e89.md`
   for the full reproduction, the byte-identical re-confirmation for the
   four already-committed plans, and a throwaway probe's initial (unrouted)
   placement/DRC reading for `differential_driver`.
5. `bf90e1d5e3a6` → `61e743088f4722854d18b0cc48bd98c3dee58cf6` by issue #72,
   specifically to pick up klayout-tools#1731's fix (merge
   [`1641fa5f9617e57931debbfc2bc58fab62799348`](https://github.com/2AMLogic/klayout-tools/commit/1641fa5f9617e57931debbfc2bc58fab62799348),
   PR #1774: `res_array`'s `metal_level` mechanism gains real drawn-geometry
   support for gf180mcu's `rm1`/`rm2`/`rm3` metal-resistor device classes,
   and a new `device_groups[]`-declared-class-vs-resolved-generator-output
   mismatch check appends a `warnings[]` entry instead of silently
   substituting the wrong device), the last blocker standing between
   `differential_driver` and a committed layout plan. The fix commit is a
   **strict ancestor** of the new pin — `gh api
   repos/2AMLogic/klayout-tools/compare/1641fa5f9617e57931debbfc2bc58fab62799348...61e743088f4722854d18b0cc48bd98c3dee58cf6`
   returns `status: "ahead"`, `behind_by: 0`, `ahead_by: 1`; the old pin
   (`bf90e1d5e3a6`) is 32 commits **behind** the fix (`compare/1641fa5f...
   bf90e1d5e3a6` → `status: "behind"`, `behind_by: 32`), confirming it did
   not contain it. **The new pin is klayout-tools' bare `main` tip**
   (`61e743088f4722854d18b0cc48bd98c3dee58cf6`, 2026-09-13T18:59:37Z) — a
   deliberate deviation from the "confirm CI, don't just take `main`" habit
   the fourth move set, made because checking both candidates' CI directly
   (not assumed from either commit's filing-time snapshot) showed `main`
   tip was the *more* complete one: the fix commit itself has two
   `cancelled` check-runs alongside eleven `success` ones, while `main`
   tip's fourteen check-runs are all `conclusion: "success"`. The `klt`
   self-reported version does not cross a minor boundary
   (`0.4.0+gbf90e1d5e3a6` → `0.4.0+g61e743088f47`). **What the move bought,
   and what it didn't**: `differential_driver` now has a committed,
   correctly-drawn plan (`layout/analog/plans/differential_driver.json`) —
   its two `RM1` series-termination resistors draw real `Metal1`/`Via1`/
   `Metal2` geometry with an explicit `params.metal_level: 1`, confirmed by
   direct GDS layer inspection and a zero-length `warnings[]` array, not
   assumed. The four already-committed plans are unaffected at the
   drawn-geometry level — verified by per-layer Boolean XOR against the
   superseded record's frozen artifacts (zero area difference on every layer
   of all four blocks), **not** by byte comparison: the GDS files are
   geometrically identical but not byte-identical, differing only in the
   order the same elements are emitted. **The new mismatch-warning
   check itself found something this move did not set out to look for**:
   three of those four plans (`differential_receiver`, `se_receiver_dm`,
   `se_receiver_dp`) have their own declared-class-vs-drawn-device mismatch
   — a `PPOLYF_U_1K`-declared bias/reference resistor drawn as the
   default-flavor `ppolyf_u` body instead, present since before this pin
   moved and only now visible. That is a real finding this record does not
   fix (see the record and the follow-up issue it links) — this repo's own
   plan documents disagreeing with the netlist they were written against,
   not a further `klt` gap. See
   `verification/records/analog-layout/records/20260913-192744-b653c71.md`
   for the full reproduction, the geometric re-confirmation (per-layer XOR)
   for the four already-committed plans' drawn geometry, the layer-level
   confirmation that `differential_driver`'s `RM1` groups now draw correctly,
   the newly-surfaced `PPOLYF_U_1K` mismatch finding, and the characterization
   of the GDS byte-level ordering difference.

6. `61e743088f4722854d18b0cc48bd98c3dee58cf6` →
   `e8ca621a6961879cec1af60cc932c3b3d58ddcaa` by issue #78, driven by the
   T1 signoff block manifest rather than by one upstream fix: grading T1
   state with `klt signoff --manifest` requires (a) the **eleventh checklist
   item** "Power delivery (structural)" (klayout-tools#2025/#2057, merged
   2026-09-19 — every earlier `klt` renders a ten-item report, and by this
   repo's own recorded re-survey reads that item's absence made prior
   gap-to-T1 tables stale the day it landed), and (b) `klt lvs`'s
   `provenance.input.content_hash` recording (klayout-tools#1969) so an
   "LVS clean" citation can be freshness-pinned at all. The item-11 merge
   `428951e036935d37161732adb55915049c598cc4` is a strict ancestor of the
   new pin — `gh api repos/2AMLogic/klayout-tools/compare/428951e036935d37161732adb55915049c598cc4...e8ca621a6961879cec1af60cc932c3b3d58ddcaa`
   returns `status: "ahead"`, `behind_by: 0`, `ahead_by: 58` — and the old
   pin is likewise purely behind it (`behind_by: 0`, `ahead_by: 263`).
   `e8ca621a` is klayout-tools' `main` tip (2026-09-21T12:10:33Z) at the
   time of this move, with its own CI complete: all 18 check-runs
   `conclusion: "success"` at the time of this move. **The same move also
   repairs a drifted second pin**: `.github/workflows/ci.yml` still
   installed the *first* pin `b3e284f` (it was never moved by re-pin
   moves 2-5, and at `b3e284f` the CI could not have rendered item 11 or
   re-run the manifest at all); it now installs the same revision as
   `scripts/setup-env.sh`, restoring the "keep in sync with
   docs/environment-setup.md" invariant both files declare. The `klt`
   self-reported version crosses a minor boundary (`0.4.0+g61e743088f47` →
   `0.5.0+ge8ca621a6961`). **What the move bought, and what it didn't**:
   the digital LVS verdict reproduces (`status: "match"`, negative control
   still correctly rejected) at the new pin — and the re-run's envelope
   now records `provenance.input.content_hash`, which the superseded Aug-25
   envelope could not; re-minted as
   `verification/records/digital-lvs/records/20260921-132813-1376d98.md`.
   The five committed analog plans re-execute with no status change
   (DRC-clean everywhere, `0 warnings[]` everywhere, routed tally
   unchanged per block), but `dplus_pullup`'s drawn Metal-1 routing
   genuinely changed shape — 63,504,000 dbu² less on layer `34/0` vs the
   superseded run, produced by the upstream routing-semantics commits
   (#1931/#1936/#1945/#2098/#2144) between the pins — minted as
   `verification/records/analog-layout/records/20260921-130120-223bae5.md`
   rather than assumed identical. The four other blocks' GDS are
   `cmp`-identical to the superseded record's. **Engine note**: this venv
   explicitly holds `klayout==0.30.10` — the `klayout_version_expected`
   this pin reports as tested — so fresh envelopes carry
   `klayout_version_mismatch: false` (a venv left to resolve the newest
   `klayout` shows the flag `true`; the first extraction attempt here did,
   and was discarded, not committed).

7. `e8ca621a6961879cec1af60cc932c3b3d58ddcaa` →
   `7ee09483b74867a47a05eb353015c2cf5ca33ef3` by issue #188, to grade item
   5.analog. The move was needed for two reasons: `measurements[].expr`
   (klayout-tools#2533) and list-form item-5 evidence with `spec_rows`
   coverage (klayout-tools#2959, which lets several `klt sim` envelopes
   jointly cover one item). **`v0.7.0` (`0e2362bd`) has #2533 but not #2959**:
   `klayout_tools.signoff` there has no `_grade_multi_citation`. So the pin is
   the commit the fleet-dispatch host's `klt` was built from (`klt
   0.7.1.dev1743+g7ee09483b748`), which contains both, not a release tag.
   Re-pin to a release once one carries #2959.
   For this move only the lint half of `npm run check:ci` was run locally
   (`npm run lint`'s chain plus `scripts/check_signoff_report.py`); the cocotb
   half (`npm run test`) was left to CI. The re-pin made two live
   `analog-layout` records' `setup-env.sh` provenance hash stale; they are
   superseded by source-only records, not re-run.

8. #187 (artifact-anchored generic envelopes for T1 items 1, 2, 9 and 10,
   klayout-tools#2843, first released in 0.7.0) needs no further pin move: the
   `7ee09483` pin above descends from 0.7.0, so it already carries that grader.
   The old `e8ca621a` revision predates it and renders those items
   `unmet`/`no_evidence` whatever is cited. The unreleased `klt signoff --attest`
   (klayout-tools#2844) is not used. No evidence record was re-minted.

9. `7ee09483b74867a47a05eb353015c2cf5ca33ef3` (`0.7.1.dev1743+g7ee09483b748`) →
   release `0.8.0` by issue #257, on the operator's approval to move chip repos to
   the current klayout-tools release. It supersedes the "re-pin to a release once
   one carries #2959" note in move 7: 0.8.0 contains #2959, #3768 and #3769.

   Issue #260 (2026-10-28) then used #3768: `manifests/gf180-usb2-phy.json`
   declares its item-5 rows under `spec_rows."5.analog"`, so 5.digital is no
   longer charged with the analog rows (no `5.digital` rows are declared;
   spec §8.2 ratifies none). It still renders `unmet`: klt 0.8.0 wants a
   `functional-verification` citation beside the `sta` one.

10. Release `0.8.0` → release `0.9.0` by issue #263, once 0.9.0 (on PyPI; 0.9.1 is
   also out) carried klayout-tools#4666: `klt gen res_array` snaps `length_um`
   to the manufacturing grid and refuses a length below the deck's `sab.width.1`
   floor unless `params.short_length` is `lengthen`, reporting the realised
   length in `drc_hints.length_snap`. `dplus_pullup` is now regenerated from the
   netlist lengths with no `length_um` override (only `short_length: "lengthen"`
   on `r_seg0`), and the realised lengths equal those hand-set by DR-0010. The
   other three child-A blocks are geometrically identical to their 0.8.0 GDS
   (per-layer XOR, zero area difference) but not byte-identical, so their
   `gds_sha256` values in `layout/analog/provenance.json` moved. See
   `verification/records/analog-layout/` for the record.

`npm run check:ci` was re-run against each new pin before it was committed.

`klt` in turn resolves `iverilog`/`yosys`/`openroad` and the PDK itself from
the host — it does not vendor them. Those are:

| Tool | Used for | Resolved version on the environment these records were produced on |
|---|---|---|
| Icarus Verilog (`iverilog`) | `klt functional-verification` | 12.0 (stable) – 13.0 (stable) verified across two environments (`iverilog -V`) |
| Yosys (`yosys`) | `klt synthesize` | 0.67 – 0.68+post verified across two environments (`yosys -V`) |
| OpenROAD (`openroad`) | `klt place-and-route` | not installed natively on the environments these records were produced on; provisioned via the pinned Docker image instead — see "OpenROAD" below. Exercised by issue #25 (`26Q3-1260-g06a5a02279`, image `openroad/orfs:26Q3-296-gda37dce1c`) |

Package-manager installs for the first two:

```bash
# macOS (Homebrew)
brew install icarus-verilog yosys

# Debian/Ubuntu
apt-get install iverilog yosys
```

### OpenROAD

`openroad` has no Homebrew formula or common-distro package as of this
writing, so it is provisioned via the pinned `openroad/orfs` Docker image
rather than a native install — the same route `sky130-modexp` (this
repo's digital-harness sibling, per `CLAUDE.md`'s "Harness bootstrap")
already uses. `scripts/openroad-docker.sh` (ported from that repo,
re-targeted for gf180mcu — no sky130-specific content, since the image
and invocation shape are PDK-agnostic; `klt place-and-route` resolves the
gf180mcu LEF/liberty deck itself) wraps the pinned
`openroad/orfs:26Q3-296-gda37dce1c` image's `openroad` binary as if it
were native on `$PATH`:

```bash
# one-off invocation
./scripts/openroad-docker.sh -version

# or symlink it onto $PATH so `klt place-and-route` resolves it directly
ln -sf "$(pwd)/scripts/openroad-docker.sh" .venv/bin/openroad
```

Requires `docker` with a reachable daemon. If the invoking user is not in
the host's `docker` group, set `OPENROAD_DOCKER_CMD` to a wrapper — the
script splits it into argv, so a multi-word value works:

```bash
OPENROAD_DOCKER_CMD='sudo -n docker' ./scripts/openroad-docker.sh -version
```

Bind-mounts the repo working
directory and the resolved PDK root (`$PDK_ROOT`, else `~/.ciel`, else
`~/.volare`) at identical absolute host paths inside the container — see
the script's own header comment for why (`klt place-and-route` bakes
absolute host paths into every generated OpenROAD Tcl script). Exercised
end-to-end by issue #25 (`openroad -version` inside the image reports
`26Q3-1260-g06a5a02279`) — see
`verification/records/place-and-route/` for the resulting routed digital
GDS and `flow/README.md` for the request-file flow.

If a native `openroad` binary is preferred instead, roughly in order of
effort:

1. **Precompiled binaries** — see
   [`The-OpenROAD-Project/OpenROAD` § Install](https://github.com/The-OpenROAD-Project/OpenROAD#install)
   for current release artifacts.
2. **Build from source via OpenROAD-flow-scripts** —
   [`The-OpenROAD-Project/OpenROAD-flow-scripts`](https://github.com/The-OpenROAD-Project/OpenROAD-flow-scripts),
   `./build_openroad.sh --local` (a from-source build with its own toolchain
   dependencies — see that repo's own docs for platform prerequisites).

### `klt`'s gf180mcu PDK resolution

`klt pdk find --pdk gf180mcuD` (or any of the fetched `gf180mcuA`/`B`/`C`
variants) resolves the install root, per-tool asset directories, and
standard-cell libraries via the same `find_pdk()` discovery `klt pdk`/
`klt cells`/`klt synthesize` all share — no repo-specific PDK-fetch
mechanism. `klt pdk cells --pdk gf180mcuD` reports the available digital
standard-cell libraries directly:

```
gf180mcu_fd_sc_mcu7t5v0   (nominal supply 1.8V, corner ..._tt_025C_1v80)
gf180mcu_fd_sc_mcu9t5v0   (nominal supply 1.8V, corner ..._tt_025C_1v80)
```

`flow/request-usb-utmi-phy-synth.json` uses
`gf180mcu_fd_sc_mcu9t5v0` / `tt_025C_1v80` — see `flow/README.md`.

### Why local, not CI, for the PDK-heavy legs

Provisioning a real PDK in a hosted CI runner on every PR is a real,
recurring cost. Following `sky130-modexp`'s split: the tool-light leg
(`klt functional-verification`, Icarus/cocotb only, no PDK) is cheap enough
to run anywhere; `klt synthesize`, `klt place-and-route`, `klt drc`, and
the analog layout-plan runner (`scripts/gen_analog_layout.py`, which calls
`klayout_tools.layout_plan_execute` and then `klt drc`) all need the
fetched PDK and are run locally by a contributor with
`scripts/setup-env.sh`'s environment provisioned, with the result committed
as an append-only record under `verification/records/` (see
`verification/README.md`). [`.github/workflows/ci.yml`](../.github/workflows/ci.yml)
implements this split: it runs `npm run check:ci` (evidence-record lint +
`klt functional-verification`) on every push/PR to `main`, and does not run
`check:all`'s PDK-heavy `klt synthesize` leg — that stays local, per this
section. If you ever move a PDK-heavy leg into CI, update this section in
the same change rather than letting the two drift.
