2AMLogic/gf180-usb2-phy/verification/records/analog-lvs/records/20261113-151132-45afbeea4868.md

<!-- record-meta
{
  "record_id": "20261113-151132-45afbeea4868",
  "experiment": "analog-lvs",
  "supersedes": null,
  "git_revision": "45afbeea486870bf31b4c103db271964a2f2e6bb",
  "provenance": {
    "klt_version": "0.9.0",
    "klt_git_commit": "5dbbad05ff42265c92a6f3d2f20d1bbcd2957d49",
    "klayout_version": "0.30.13",
    "pdk": {
      "name": "gf180mcuD",
      "version": "open_pdks c6d73a35f524070e85faff4a6a9eef49553ebc2b"
    },
    "deck": {
      "name": "gf180mcu",
      "content_hash": "sha256:cf44de63f0a5b01c1d09c4d58e0535e990aa4b070bcaae17fd3a94a67a1d97e1",
      "released": true
    },
    "inputs": [
      { "path": "scripts/analog_lvs.py", "content_hash": "sha256:2c1147fd541f03b3bee96b0a494045de019539f6985bd0f794fddbd2711234eb" },
      { "path": "scripts/setup-env.sh", "content_hash": "sha256:299eb25303e3238655e566796586d33bef1f4a9cf69eac79118653da3b476515" },
      { "path": "layout/analog/differential_driver.gds", "content_hash": "sha256:f6293c3af17b568cb29f856482b1dee47319f9c99ac04ca616ded67bf3d8eb3d" },
      { "path": "layout/analog/differential_receiver.gds", "content_hash": "sha256:743d43ebdf5e26fea80903aecde6705839d746471bb9c256b86bb12e684e1fcf" },
      { "path": "layout/analog/dplus_pullup.gds", "content_hash": "sha256:3729bd19545640ac1361174b05fcbbbdfdd9b496aa01118cc70ad876e756245c" },
      { "path": "layout/analog/se_receiver_dm.gds", "content_hash": "sha256:54088ae62673bde9dfbce946bb0fc7f7a20016b6084684ebe24505a39826afbb" },
      { "path": "layout/analog/se_receiver_dp.gds", "content_hash": "sha256:a3839bad60a4412b394a4c0d5f36116bfd2d582acf79412b241447c265df44a4" },
      { "path": "design/netlist/differential_driver.spice", "content_hash": "sha256:b5dda5306f4636451ffc047c3792151f0a5c49d87082e6304cc065831c9f0b72" },
      { "path": "design/netlist/differential_receiver.spice", "content_hash": "sha256:76a1e6f9263a115f9103461a03d1f796ec92644e15398a463659c25cce78b13d" },
      { "path": "design/netlist/dplus_pullup.spice", "content_hash": "sha256:9c645ecf0da6d80fb05d85c33d2941cc48bc328a00cd427f0c11bdf980b2cceb" },
      { "path": "design/netlist/se_receiver_dm.spice", "content_hash": "sha256:ebfc91ac1306060dfa0ffce7d91e048b4fc8b50cfebbd5804c3aaf9b58a20554" },
      { "path": "design/netlist/se_receiver_dp.spice", "content_hash": "sha256:1f854210680331a1df73b96b317479cad4af325192fec68b0b61fb1421fac0b3" }
    ]
  }
}
-->

# Record 20261113-151132-45afbeea4868

- **Record ID**: 20261113-151132-45afbeea4868
- **Claim**: transistor-level LVS was run on **all five** committed analog
  streams against their schematic netlists, under the repo-pinned klt. Result,
  stated plainly: **none of the five matches.** No block reads `status:
  "match"`; `scripts/analog_lvs.py` exits 1. This record delivers the harness
  and the honest first measurement, not a match. Per `CLAUDE.md`, the mismatch
  is the recorded result — nothing was relaxed to make it pass.
- **Design provenance**: git `45afbeea4868` (`origin/main`). All five GDS
  hashes above equal the values `layout/analog/provenance.json` records for the
  committed streams, and all five netlist hashes equal the committed
  `design/netlist/*.spice`. **No layout, plan, netlist, schematic, spec or
  manifest was changed by this record's issue (#345)**, and none would have
  been a legitimate response to the result.
- **Run configuration**: `scripts/setup-env.sh`'s pinned environment,
  reproduced in a worktree-local venv (`uv venv` + `klayout-tools==0.9.0`, the
  `KLT_VERSION` pin): **klt 0.9.0** (`5dbbad05ff42`), klayout 0.30.13, PDK
  `gf180mcuD` at volare `c6d73a35f524...`, deck `gf180mcu`
  `sha256:cf44de63...d97e1` (released). The host `klt`
  (`0.9.2.dev915+g513f88f6836d`) was **not** used for any leg. Command, from
  the worktree with that venv's `klt` on `$PATH`:
  ```
  PDK_ROOT=$HOME/.volare PDK=gf180mcuD python3 scripts/analog_lvs.py --also-preextracted
  ```
  Exit 1. Only single-unit, local `klt` invocations were run; no SPICE.
  klt 0.9.0 emits `resolved klayout engine version '0.30.13' differs from
  klayout==0.30.12, the version this klayout-tools build was tested against`
  and states the verdict itself is unaffected. The same klt/klayout pairing
  produced the current analog-layout records
  (`20261113-133000-f26c7be72693`), so this is the repo's established pinned
  environment, not a drift introduced here.
- **Statistical convention**: N/A (deterministic structural compare).

- **Result**: **five blocks, five mismatches.**

| Block | status | devices layout/ref/matched | nets layout/ref/matched | pins layout/ref | errors | error-severity categories |
|---|---|---|---|---|---|---|
| `differential_driver` | mismatch | 40/40/0 | 40/22/0 | 9/7 | 102 | `device.unmatched` 40, `net.unmatched` 62 |
| `differential_receiver` | mismatch | 11/11/0 | 15/10/0 | 4/5 | 36 | `device.unmatched` 11, `net.unmatched` 25 |
| `dplus_pullup` | mismatch | 78/78/16 | 34/21/2 | 20/9 | 75 | `device.unmatched` 62, `net.split` 13 |
| `se_receiver_dm` | mismatch | 13/13/4 | 15/10/1 | 4/4 | 14 | `device.unmatched` 9, `net.split` 5 |
| `se_receiver_dp` | mismatch | 13/13/4 | 15/10/1 | 4/4 | 14 | `device.unmatched` 9, `net.split` 5 |

Every row reproduces the curator probe's 2026-11-13 host-tool snapshot in
issue #345 **exactly** — same status, same device/net/pin counts, same error
categories and counts, on all five blocks. The pin and the host tool agree
here; the snapshot's caveat is discharged.

On every block: `body_verification.status: "unverified"`,
`power_connectivity.status: "unchecked"` (the report's stated reason: the
check exists for the `gate-level-verilog` form and does not apply to
`subckt-call`), and warnings `device.geometry_not_compared` and
`device.placeholder_value` for the poly resistors (`R` is a subckt-call
placeholder; `L`/`W`/`A`/`P` are KLayout-secondary and were not compared).

**Device counts agree on all five** (layout total == reference total). The
layout side has more nets than the reference on all five. So this is not a
missing- or extra-device fault: it is a connectivity and naming fault.

## Cause, per error-severity category

Three facts, measured directly off **the compare's own extracted layout
netlist** (`<block>_layout.spice`) and the reference netlist — not read out of
the tool's prose, and not inferred. `<block>-cause.json` holds them per block;
`scripts/analog_lvs.py` regenerates them on every run (`--no-analyze` skips
it).

### Cause A — PMOS bodies are on floating, unnamed wells (all five blocks)

The reference puts every PMOS body terminal on a named supply net. The layout
puts each PMOS body on its **own anonymous well net** (`\$9`, `\$10`, …), with
no tie to that supply:

| Block | PMOS devices | distinct layout PMOS body nets | reference PMOS body net |
|---|---|---|---|
| `differential_driver` | 17 | 17 (all anonymous) | `VDD` |
| `differential_receiver` | 4 | 4 (all anonymous) | `VDD` |
| `dplus_pullup` | 66 | 12 (all anonymous) | `VPU_REG` |
| `se_receiver_dm` | 4 | 4 (all anonymous) | `VDD` |
| `se_receiver_dp` | 4 | 4 (all anonymous) | `VDD` |

Evidence, `differential_receiver_layout.spice` vs
`differential_receiver_reference.spice`:

```
layout     M$8  \$7 AMPOUT VDD \$9  pfet L=0.28U W=32U      <- body \$9, an unnamed well
reference  XMP_B1 BUF1 AMPOUT VDD VDD pfet_03v3 L=0.28u W=32u  <- body VDD
```

Every PMOS therefore differs from its reference counterpart on one terminal,
and no PMOS can pair. The well geometry exists (KLayout synthesized a net for
it); what is absent is a **tap tying it to the supply**.

### Cause B — the p-substrate is not tied to a labelled ground (all five blocks)

Every NMOS body on the layout side lands on `vsubs`, the deck-synthesized
substrate net, on all five blocks. The reference puts them on `VSS`. And
**`VSS` does not exist as a named net in any of the five layouts** — it is
absent from every block's named-net list. Instead, `vsubs` is exported as a
top-level layout pin on all five.

```
layout     M$1 \$7 AMPOUT \$1 vsubs nfet   <- body vsubs (deck-synthesized); source \$1 unnamed
reference  XMN_B1 BUF1 AMPOUT VSS VSS nfet_03v3  <- body and source both VSS
```

This is why `body_verification.status` is `unverified` on every block: the
tool says as much in its own warning ("either no substrate-tap geometry is
drawn, or the drawn tap's net carries no name label").

### Cause C — the labelled port set is not the schematic's port set (all five blocks)

On **every** block, the set of named layout nets is exactly the set of layout
pins: names come only from text labels, and nothing else is named. The
labelled set is wrong in both directions — schematic ports are missing, and
internal nodes are exported as ports:

| Block | layout pins | reference ports | in common |
|---|---|---|---|
| `differential_driver` | `DM_GATEN DM_GATEP DM_PX DP_GATEN DP_GATEP DP_PX TXDM TXDP vsubs` | `VDD VSS TXDP TXDM TXOE DP DM` | `TXDM TXDP` |
| `differential_receiver` | `AMPOUT IBIASN VDD vsubs` | `VDD VSS DP DM RXD` | `VDD` |
| `dplus_pullup` | `DP NODE0..NODE5 PU_EN PU_ENB TRIM0..TRIM4 TRIM0B..TRIM4B vsubs` | `DP VPU_REG VSS PU_EN TRIM0..TRIM4` | `DP PU_EN TRIM0..TRIM4` |
| `se_receiver_dm` | `AMPOUT IBIASN VDD vsubs` | `VDD VSS DM RXDM` | `VDD` |
| `se_receiver_dp` | `AMPOUT IBIASN VDD vsubs` | `VDD VSS DP RXDP` | `VDD` |

`differential_driver` has **no `VDD` and no `VSS` pin at all**; `dplus_pullup`
has neither `VPU_REG` nor `VSS`. Internal nodes (`AMPOUT`, `IBIASN`,
`DP_GATEP`, `NODE0`, `TRIM0B`, …) are labelled as if they were ports.
Unnamed layout nets: 31 of 40 (`differential_driver`), 11 of 15 (each of
the three receivers), 14 of 34 (`dplus_pullup`).

### Why `net.unmatched` on three blocks and `net.split` on two

The two error categories track **how many net correspondences the comparer
could seed from**, read from each report's own `net_correspondence`:

| Block | seeded correspondences | net error category |
|---|---|---|
| `differential_driver` | 0 (`[]`) | `net.unmatched` 62 |
| `differential_receiver` | 0 (`[]`) | `net.unmatched` 25 |
| `dplus_pullup` | 2 (`DP`, `NODE1`, both pins) | `net.split` 13 |
| `se_receiver_dm` | 1 (`\$15` ↔ `DM`, not a pin) | `net.split` 5 |
| `se_receiver_dp` | 1 (`\$15` ↔ `DP`, not a pin) | `net.split` 5 |

The correlation is measured. The **mechanism** — that with zero seeds the
comparer can only report every net as having no counterpart, and that one or
two seeds let it propagate far enough to describe the remainder as a reference
net "divided across multiple layout nets" (the tool's own wording for
`net.split`) — is read from the tool's category descriptions and is
**inferred, not established here**. The 16 of 78 devices that pair on
`dplus_pullup` and the 4 of 13 on each single-ended receiver are the
downstream consequence of those seeds; which specific devices they are is in
each `-lvs-report.json`.

### What was NOT established

- **That Causes A–C are the whole story.** No run was made with the ties and
  labels repaired, so it is not shown that fixing them alone yields a match.
  Correcting them is the follow-up issue's work, and its result is the test.
- **The specific geometry responsible.** `layout/README.md` states the
  guard-ring / body-tie metal-1 pads each generator draws are in no plan net
  and so left unconnected. The measurements above are **consistent** with that
  and with the plan's pins being device terminals only — but the geometry was
  not stepped through, so the linkage from "pads in no plan net" to "these
  specific floating wells" remains an inference, not a finding.
- **Anything about device parameters.** With zero or near-zero device pairing,
  no W/L comparison took place. This record says nothing about whether the
  drawn sizes are right.

## Pre-extracted form (diagnostic, recorded not preferred)

The 2026-10-09 record found the pre-extracted layout form unusable for a
`subckt-call` reference. Re-measured here under klt 0.9.0 rather than assumed,
for all five blocks (`--also-preextracted`): it is still unusable, and it
**loses devices** relative to the inline form, which the verdict leg does not:

| Block | inline devices layout/ref | pre-extracted devices layout/ref | pre-extracted matched |
|---|---|---|---|
| `differential_driver` | 40/40 | 36/40 | 0 |
| `differential_receiver` | 11/11 | 10/11 | 0 |
| `dplus_pullup` | 78/78 | 72/78 | 0 |
| `se_receiver_dm` | 13/13 | 10/13 | 0 |
| `se_receiver_dp` | 13/13 | 10/13 | 0 |

Both results are frozen (`-lvs-report.json` and
`-lvs-report-preextracted.json`); neither is picked over the other as the
verdict. **The verdict is the inline form**, as in the 2026-10-09 record —
not because it reads better (it does not; it too is `mismatch` on every
block) but because it is the form that sees all the devices.

## Replay

From the artifacts directory, with the pinned `klt` on `$PATH`:

```
klt lvs --check <block>-lvs-report.json --layout <repo>/layout/analog/<block>.gds
```

Exits 0 (`status: "match"`, i.e. inputs still hash as recorded) for all five
blocks, verified 2026-11-13. `--layout` is required because the run's own
out-dir (`layout/analog/lvs/`, gitignored scratch) is the path each report
echoes; the committed stream is the thing worth pinning. A full re-run is
`python3 scripts/analog_lvs.py` (exit 1 while any block mismatches).

## Options used

**One, and it is output-side: `keep_extracted: true`.** It asks `klt lvs` to
write out the netlist it already built (below); it cannot change a verdict.

Nothing that relaxes the compare is set: no `parameter_tolerance`, no
`compare_parameters`, no `flatten_layout`/`flatten_reference`, no
`power_connectivity`, no `combine_devices`, no `netgen_setup`. The request is
layout `{file, deck: gf180mcu, top}` against reference `{netlist, top, form:
"subckt-call"}`, plus that one flag. `scripts/test_analog_lvs.py` pins that
the request carries no result-relaxing knob. The report's echoed `options`
block shows klt's defaults otherwise (`supply_nets: [GND, VCC, VDD, VGND,
VPWR, VSS]`, everything else false/null).

Confirmed by measurement, not assumption: the same five compares were first
run **without** `keep_extracted` and returned byte-identical verdicts — same
status, same device/net/pin counts, same error categories and counts on all
five blocks.

## Frozen artifacts

`verification/records/analog-lvs/artifacts/20261113-151132-45afbeea4868/`, per
block: `<block>-lvs-request.json`, `<block>-lvs-report.json`,
`<block>_reference.spice` (byte copy of `design/netlist/<block>.spice`),
`<block>_layout.spice` (**the layout side of the verdict** — the netlist the
compare itself built, via `options.keep_extracted`), `<block>_extract.spice`
and `<block>-extract-report.json` (the standalone `klt extract` leg),
`<block>-cause.json`, plus the pre-extracted diagnostic pair — and
`analog-lvs-summary.json` for the whole run.

The GDS streams are **not** re-frozen here: they are committed at
`layout/analog/<block>.gds` and pinned by hash in this record's
`provenance.inputs[]`, in each report's `environment.layout_sha256`, and in
`layout/analog/provenance.json`.

**Where the layout-side netlist comes from — and a correction.** Issue #345's
curator pass noted that `klt lvs --help` lists no option that writes the
extracted netlist, and inferred from that a tool gap to be filed upstream.
**That inference is wrong, and no friction issue was filed.** `keep_extracted`
is a *request* option, not a CLI flag; it exists and works on the pinned klt
0.9.0, writing the compare's own netlist to
`<request_dir>/.klt/lvs/<top>.spice` and naming it in
`environment.extracted_netlist`. The `null` the curator observed is simply
what a request that does not set it produces. (Pre-existing upstream context:
`2AMLogic/klayout-tools#1223`, which tunes `--check --rerun` around this very
field.)

So AC2's "extracted layout-side netlist" is taken from the compare itself, not
from a second extraction that might not be the netlist actually compared.

A standalone `klt extract` still runs, for the one thing `klt lvs` does not
emit: a structured per-device JSON report (device classes and counts,
per-device parameters and nets). **It is evidence only; the verdict is the
`klt lvs` run.** Both netlists are frozen and were diffed per block:

> They are identical on **every MOSFET**, and differ only in how resistors are
> carded — `klt lvs` writes `R$11 IBIASN VDD vsubs 200000 ppolyf_u_1k`, `klt
> extract` writes `X$11 IBIASN VDD vsubs ppolyf_u_1k r=200000 L=400U W=2U`.
> 1 resistor differs on `differential_receiver`, 3 on each single-ended
> receiver, 6 on `differential_driver`, 6 on `dplus_pullup`.

That carding difference is also what makes the pre-extracted form lose
devices: fed back in as a layout netlist, the `X`-card resistors are not
recognised as devices.

Layout-side netlist hashes (`klt lvs`, `options.keep_extracted`):
`differential_driver` `f9523695...02f2`, `differential_receiver`
`2d73c321...b216`, `dplus_pullup` `a79be811...d38c`, `se_receiver_dm`
`e22b7067...fbe8`, `se_receiver_dp` `90845cb5...2885`.
Standalone `klt extract` netlist hashes (`netlist_sha256`):
`8fae5dff...6415e`, `c3813f5c...1c39`, `b11273a6...f1a3`, `1267960f...bb24`,
`524da6bf...e62d` respectively.

- **klt provenance**: klt `0.9.0` (git `5dbbad05ff42`,
  `klayout-tools==0.9.0`), klayout `0.30.13`, PDK `gf180mcuD` (open_pdks
  `c6d73a35f524...`), extraction deck `gf180mcu`
  `sha256:cf44de63f0a5b01c1d09c4d58e0535e990aa4b070bcaae17fd3a94a67a1d97e1`
  (released; options `metal_top=9K`, `mim_cap=cap_mim_2f0_m4m5_noshield`,
  `poly_res=1k`, none set explicitly). klt warns that klayout 0.30.13 differs
  from the 0.30.12 it was tested against and states the verdict is unaffected;
  the repo's current analog-layout records use the same pairing.
- **Links**:
  - Harness: `scripts/analog_lvs.py`; its self-test `scripts/test_analog_lvs.py`
  - Layout-fault follow-up (Causes A–C): [gf180-usb2-phy#346](https://github.com/2AMLogic/gf180-usb2-phy/issues/346)
  - Dispatching issue: [gf180-usb2-phy#345](https://github.com/2AMLogic/gf180-usb2-phy/issues/345);
  parent [#247](https://github.com/2AMLogic/gf180-usb2-phy/issues/247) (T1 item `4.analog`)
  - Tracking narrative: `layout/README.md` § "Analog"
  - Sibling signoff: analog DRC #246, ERC #248, post-layout re-simulation #53
  - Friction: **none filed.** The one candidate gap (no way to get the extracted
  netlist out of an inline `klt lvs` run) turned out not to exist — see
  "Where the layout-side netlist comes from" above. Nothing else in this run
  was awkward or missing.
## Manifest impact

**None.** `manifests/gf180-usb2-phy.json` has no `4.analog` entry and gains
none here: item `4.analog` requires `status: match` per block, and no block
matches. It stays `unmet` / `no_evidence` as `manifests/README.md` describes.
Citing `4.analog` and regenerating `manifests/t1-signoff-report.json` remain
with #247.

- **Timestamp / author**: 2026-11-13T15:11:32Z, Loom Builder (AI agent), issue #345.
- **Supersedes**: none — this is the first record of the `analog-lvs`
  experiment. It does, however, **replace the standing analog LVS result**,
  which until now was `20261009-203500-7a8e831` in the *separate*
  `analog-layout` experiment (recorded there because no analog LVS experiment
  existed yet; the record-meta `supersedes` field names records within one
  experiment, so it is `null` here). **Why that result no longer describes the
  tree**: that record measured
  LVS on *one* block (`differential_receiver`) against a then-current,
  plan-path-only geometry with 1 of 8 nets routed, under klt 0.5.0. Its
  verdict (`mismatch`) still stands for the stream it pinned, and its counts
  (31 layout nets, 11/11/0 devices) describe that 2026-10-09 geometry — **not**
  the committed stream, which is fully routed and extracts to 15 nets. This
  record supersedes it by measuring all five committed streams under the
  current pin. The superseded record is kept, unedited, as history
  (append-only): a result is superseded by a later record that says why, never
  by deletion.
