2AMLogic/gf180-usb2-phy/verification/records/analog-layout/records/20261113-090000-4f79d854e7b4.md

<!-- record-meta
{
  "record_id": "20261113-090000-4f79d854e7b4",
  "experiment": "analog-layout",
  "supersedes": "20261106-120000-ef841f90e933",
  "git_revision": "4f79d854e7b4",
  "provenance": {
    "klt_version": "0.9.0",
    "pdk": {
      "name": "gf180mcuD",
      "version": "open_pdks c6d73a35f524070e85faff4a6a9eef49553ebc2b"
    },
    "deck": {
      "name": "gf180mcu",
      "content_hash": "sha256:0eb6df1bafc5106ec50bd58479dbd7cda36bb685f1ef18cd3a2244a6e7e48666",
      "released": true
    },
    "inputs": [
      {
        "path": "scripts/setup-env.sh",
        "content_hash": "sha256:299eb25303e3238655e566796586d33bef1f4a9cf69eac79118653da3b476515"
      },
      {
        "path": "scripts/gen_analog_layout.py",
        "content_hash": "sha256:e04f3daa808ee15bc8ad4cf904ae56936d81e1436772d8793a5a240f03f6194a"
      },
      {
        "path": "layout/analog/plans/differential_receiver.json",
        "content_hash": "sha256:77c62e64b32eeb81732dedd2ec841a6e584aa64bcebbd598cd0586081694abdf"
      },
      {
        "path": "layout/analog/plans/dplus_pullup.json",
        "content_hash": "sha256:769f4bdfbf6d8ca2cba147fb354e2f929264f11b94de6e71ded4c9f2f10935aa"
      },
      {
        "path": "layout/analog/plans/se_receiver_dm.json",
        "content_hash": "sha256:90b3ec9e6b22ce691540746afc85731e3d9692c94a63028167049b9afbf5a687"
      },
      {
        "path": "layout/analog/plans/se_receiver_dp.json",
        "content_hash": "sha256:4806a6fa835c72f6205d1aef2a77732703f109205bac472a76bfb6b1b961a81a"
      },
      {
        "path": "layout/analog/plans/differential_driver.json",
        "content_hash": "sha256:4a8b1ed420ff93de0f2847927a4a7337f46d4545f6690f7a6f7ccf912417ea4f"
      },
      {
        "path": "design/differential_driver.sch",
        "content_hash": "sha256:53dbce789297be5d2f98457e3162ac01ee1f820a6c186cd5d41da16252050591"
      },
      {
        "path": "design/dplus_pullup.sch",
        "content_hash": "sha256:81eaf5101b343bc5773f7d2800ea3dec40f8d7a5388240b8d22fd13a0b7684e6"
      },
      {
        "path": "design/netlist/differential_driver.spice",
        "content_hash": "sha256:b5dda5306f4636451ffc047c3792151f0a5c49d87082e6304cc065831c9f0b72"
      },
      {
        "path": "design/netlist/differential_receiver.spice",
        "content_hash": "sha256:76a1e6f9263a115f9103461a03d1f796ec92644e15398a463659c25cce78b13d"
      },
      {
        "path": "design/netlist/dplus_pullup.spice",
        "content_hash": "sha256:9c645ecf0da6d80fb05d85c33d2941cc48bc328a00cd427f0c11bdf980b2cceb"
      },
      {
        "path": "design/netlist/se_receiver_dm.spice",
        "content_hash": "sha256:ebfc91ac1306060dfa0ffce7d91e048b4fc8b50cfebbd5804c3aaf9b58a20554"
      },
      {
        "path": "design/netlist/se_receiver_dp.spice",
        "content_hash": "sha256:1f854210680331a1df73b96b317479cad4af325192fec68b0b61fb1421fac0b3"
      }
    ]
  }
}
-->

# Record 20261113-090000-4f79d854e7b4

- **Record ID**: 20261113-090000-4f79d854e7b4
- **Claim**: the committed `differential_driver` layout plan is now consistent with the current driver netlist and **executes** under klt 0.9.0: 40 device groups for the 40 netlist devices (including the TXOE high-Z stage and the `m=4` output devices flattened into four `m=1` instances each), placed, 0 DRC violations at the `gf180mcu` deck on the placed GDS. The driver is **not routed** (2/20 nets, by klt's plan path only; `gen_analog_layout.py` does not script-route the driver) and **no LVS, ERC or extracted re-simulation is claimed**. Driver layout is still not delivered.
- **Design provenance**: git `4f79d854e7b4` (`origin/main`) plus the issue #166 working tree (`layout/analog/plans/differential_driver.json` only). `provenance.inputs[]` hashes recomputed with sha256 over the working-tree files; only the driver plan differs from the superseded record.
- **Why this supersedes**: on `4f79d854e7b4` the committed driver plan named devices `N1DM`, `P2DP_1`, ... (the pre-#114 netlist), so `scripts/gen_analog_layout.py` returned `execute-failed` for the driver (`request.device_groups (id 'mn_n1dm').devices references netlist device 'N1DM', which does not resolve against the ingested netlist digest`). The plan had not followed the TXOE rework (#114, new devices `POEB`, `NOEB`, `P1ADP`/`P1BDP`, `N1ADP`/`N1BDP`, `P3A*`/`P3B*`, `N3A*`/`N3B*`) or the slew-resistor renames. The plan was regenerated one group per netlist device (klt names a device by its card name minus the leading `X` and `M`/`R`); generator params are unchanged from the previous plan. `m` is `1` on every driver card, so multiplicity needs no expression in the plan (the `m=4` route is the flatten of #167/#169/#170).
- **Run configuration**: `PDK_ROOT=$HOME/.volare .venv/bin/python scripts/gen_analog_layout.py --out-dir <scratch> --format json` in a throwaway venv holding `klayout-tools==0.9.0` (the repo pin). Single-unit klt run; no SPICE grid. Frozen output: `verification/records/analog-layout/artifacts/20261113-090000-4f79d854e7b4/analog-layout-report.json` (scratch path scrubbed). The same run re-executed the four child-A blocks; all four remain routed and DRC-clean, unchanged. Netlist faithfulness: `design/netlist/differential_driver.spice` was not regenerated here; the issue's netlist criterion was met by `20261015-142756-0e9d9cb`, and the netlist has since changed by reviewed PRs (#114, #277) that regenerated it.
- **Statistical convention**: N/A (deterministic geometry).
- **Result**: `differential_driver`: `executed`, `klt_exit_code` 3 (unrouted nets), 40 device groups, 20 nets, 2 routed by klt, 18 unrouted (`DM_GATEN`, `DM_GATEP`, `DM_NX`, `DM_OUTINT`, `DM_PREN`, `DM_PREP`, `DP_*` likewise, `TXDM`, `TXDP`, `TXOE`, `TXOEB`, `VDD`, `VSS`), 0 unmapped netlist nets, bbox 1831.2 x 83.88 um, DRC clean (0 violations). Routing, LVS and the layout hand-off remain open work.
- **klt provenance**: klt `0.9.0`, deck `gf180mcu`, PDK `gf180mcuD`.
- **Links**:
  - Superseded record (kept, append-only): `verification/records/analog-layout/records/20261106-120000-ef841f90e933.md`
  - Earlier driver re-check: `verification/records/analog-layout/records/20261015-142756-0e9d9cb.md`
  - Issue #166
- **Timestamp / author**: 2026-11-13T09:00:00Z, Loom Builder (AI agent), issue #166.
- **Supersedes**: 20261106-120000-ef841f90e933.
