2AMLogic/gf180-usb2-phy/verification/records/analog-layout/records/20261015-165518-24a9b52.md

<!-- record-meta
{
  "record_id": "20261015-165518-24a9b52",
  "experiment": "analog-layout",
  "supersedes": null,
  "git_revision": "24a9b52f33b8b632f4873aae5fd2b5802760aaf1",
  "provenance": {
    "klt_version": "0.5.0+ge8ca621a6961",
    "pdk": {
      "name": "gf180mcuD",
      "version": "open_pdks c6d73a35f524070e85faff4a6a9eef49553ebc2b"
    },
    "deck": {
      "name": "gf180mcu",
      "content_hash": "sha256:95c2eb9148b29ded02182aeca4222287ff57f813691d5e2f9f8d7a675f6cb637",
      "released": false
    },
    "inputs": [
      { "path": "scripts/setup-env.sh", "content_hash": "sha256:0e0d81f96049c922357f1018d0272085d9a7a63b72262275c84519ae28613377" },
      { "path": "scripts/gen_analog_layout.py", "content_hash": "sha256:ff45c4e289284df5c9427f4884fc2b446acd57440a685ac8ae24ec7b75c3865d" },
      { "path": "layout/analog/plans/differential_receiver.json", "content_hash": "sha256:77c62e64b32eeb81732dedd2ec841a6e584aa64bcebbd598cd0586081694abdf" },
      { "path": "layout/analog/plans/dplus_pullup.json", "content_hash": "sha256:0f7dac6b6c74df0a171b57d8c7df20faf943eb9a8be12d9a2fc6d88e8c68fa31" },
      { "path": "layout/analog/plans/se_receiver_dm.json", "content_hash": "sha256:90b3ec9e6b22ce691540746afc85731e3d9692c94a63028167049b9afbf5a687" },
      { "path": "layout/analog/plans/se_receiver_dp.json", "content_hash": "sha256:4806a6fa835c72f6205d1aef2a77732703f109205bac472a76bfb6b1b961a81a" },
      { "path": "layout/analog/plans/differential_driver.json", "content_hash": "sha256:9df528611f370f3032d7f4f5cebab1ddb4f3f0d476d95f7e7913cbc09449ae05" },
      { "path": "design/dplus_pullup.sch", "content_hash": "sha256:81eaf5101b343bc5773f7d2800ea3dec40f8d7a5388240b8d22fd13a0b7684e6" },
      { "path": "design/netlist/differential_receiver.spice", "content_hash": "sha256:76a1e6f9263a115f9103461a03d1f796ec92644e15398a463659c25cce78b13d" },
      { "path": "design/netlist/dplus_pullup.spice", "content_hash": "sha256:9c645ecf0da6d80fb05d85c33d2941cc48bc328a00cd427f0c11bdf980b2cceb" },
      { "path": "design/netlist/se_receiver_dm.spice", "content_hash": "sha256:ebfc91ac1306060dfa0ffce7d91e048b4fc8b50cfebbd5804c3aaf9b58a20554" },
      { "path": "design/netlist/se_receiver_dp.spice", "content_hash": "sha256:1f854210680331a1df73b96b317479cad4af325192fec68b0b61fb1421fac0b3" }
    ]
  }
}
-->

# Record 20261015-165518-24a9b52

- **Record ID**: 20261015-165518-24a9b52
- **Claim**: supplements `20261015-170000-4a82604` (it does not supersede
  it). Three further attempts to re-run the #165 driver sims on the flattened
  driver through the batch fleet **did not complete**, so electrical
  equivalence of the flattened driver to the `m=4` driver is **not yet
  shown**. The plan-run result (24 device groups placed, DRC clean, 0 of 10
  nets routed) matches `20261015-170000-4a82604`. Routing, LVS and signoff
  remain **not delivered**.
- **Design provenance**: the `provenance.inputs[]` hashes above were taken
  from the flatten as first committed on this branch. The driver netlist that
  was simulated (sha256 `62e0ecc765bf610cff82b0a612e2c0faa7ef66c8109e9f7e6eda5e13ad5b983b`)
  is no longer in the tree, so it is deliberately omitted from
  `provenance.inputs[]` (the lint requires listed hashes to match the current
  source). It differs from the netlist now on `main` (sha256 `5062c8ae...`,
  from `20261015-170000-4a82604`); the plan hash
  (`9df52861...`) equals main's. Both netlists flatten `m=4` into four `m=1`
  cards per output FET, but the sims below ran on this branch's variant, not
  byte-for-byte on main's.
- **Run configuration**:
  - Netlist: `design/netlist/differential_driver.spice` regenerated from the
    schematic via `klt netlist --rcfile design/xschemrc` (klt
    0.7.1.dev501+ge4b7dfd532cb, PDK environment from `sim/env.sh`). The
    committed file equals klt's output apart from the same wrapper difference
    described in `20261015-142756-0e9d9cb` (`.subckt`/`.ends` and header vs
    `**.subckt` and `.end`; `sch_path` made repo-relative). It contains no
    `m=4`; every MOS card has `m=1`.
  - Plan run: `python3 scripts/gen_analog_layout.py --out-dir <out> --format
    json` with klt 0.5.0+ge8ca621a6961 (the repo pin, `uv venv` in the
    worktree).
- **Statistical convention**: N/A. No measurement; a deterministic tool run.
- **Result**:
  - `differential_driver`: `executed`, `klt_exit_code` 3, 24 device groups,
    10 nets, 0 routed, 0 warnings, DRC clean (0 violations), bbox about
    1689 x 82 um. The `m=4` ingestion rejection no longer occurs. This
    restores the pre-#165 state (placed, DRC clean, 0 of 10 nets routed).
  - Other four blocks: unchanged inputs, same generator summary
    (`total 5, executed 5, fully_routed 0, drc_clean 5`; verdict `analog
    layout NOT delivered`). Not re-checked beyond that summary; full LVS was
    not run.
  - **Equivalence NOT shown**: the #165 driver sims were re-submitted to the
    batch fleet as `klt sim` requests on the flattened netlist and did not
    complete. Three submissions failed on fleet capacity (`lost_shard`: "no
    capacity in any of the 20 pools after 3 attempts"; jitter 10, 10 and 15 of
    45 corners lost, signal-quality 18 and 36 lost). The first
    signal-quality submission also hit the request's 300 s `timeout_s` on 24
    corners: the flattened deck did not finish its transient in 300 s on the
    fleet, where the `m=4` deck took 160-200 s, so that request's
    `timeout_s` was raised to 900 (jitter's was already 900). The 35 jitter
    corners that did run took 673-737 s, against a 5.6-716 s range for the
    `m=4` record. These partial runs are not recorded as evidence; no pass
    claim is made from them. `klt sim --resume` is not supported on the batch
    backend, so lost corners cannot be re-run alone.
- **klt provenance**: `klt` 0.5.0+ge8ca621a6961 (pin) and
  0.7.1.dev501+ge4b7dfd532cb (host), PDK `gf180mcuD`, deck `gf180mcu`.
- **Links**:
  - Artifact (generator report; absolute paths replaced by `<repo>`/`<out>`):
    `verification/records/analog-layout/artifacts/20261015-165518-24a9b52/analog-layout-report.json`
  - Supplemented record (kept, append-only):
    `verification/records/analog-layout/records/20261015-170000-4a82604.md`
  - Issue #167; klt gap 2AMLogic/klayout-tools#3123 (not needed on this path)
- **Timestamp / author**: 2026-10-15T16:55:18Z, Loom Builder (AI agent), issue #167.
- **Supersedes**: none. This record supplements `20261015-170000-4a82604`,
  whose plan-run result and single-corner probe stand.
