2AMLogic/gf180-usb2-phy/verification/records/analog-layout/records/20261009-203500-7a8e831.md

<!-- record-meta
{
  "record_id": "20261009-203500-7a8e831",
  "experiment": "analog-layout",
  "supersedes": "20261009-094254-560eea8",
  "git_revision": "7a8e8317af7d9926004b9611cd772b4b8c018f1f",
  "provenance": {
    "klt_version": "0.5.0+ge8ca621a6961",
    "pdk": {
      "name": "gf180mcuD",
      "version": "open_pdks c6d73a35f524070e85faff4a6a9eef49553ebc2b"
    },
    "deck": {
      "name": "gf180mcu",
      "content_hash": "sha256:95c2eb9148b29ded02182aeca4222287ff57f813691d5e2f9f8d7a675f6cb637",
      "released": false
    },
    "inputs": [
      { "path": "scripts/setup-env.sh", "content_hash": "sha256:0e0d81f96049c922357f1018d0272085d9a7a63b72262275c84519ae28613377" },
      { "path": "scripts/gen_analog_layout.py", "content_hash": "sha256:ff45c4e289284df5c9427f4884fc2b446acd57440a685ac8ae24ec7b75c3865d" },
      { "path": "layout/analog/plans/differential_receiver.json", "content_hash": "sha256:77c62e64b32eeb81732dedd2ec841a6e584aa64bcebbd598cd0586081694abdf" },
      { "path": "layout/analog/plans/dplus_pullup.json", "content_hash": "sha256:0f7dac6b6c74df0a171b57d8c7df20faf943eb9a8be12d9a2fc6d88e8c68fa31" },
      { "path": "layout/analog/plans/se_receiver_dm.json", "content_hash": "sha256:90b3ec9e6b22ce691540746afc85731e3d9692c94a63028167049b9afbf5a687" },
      { "path": "layout/analog/plans/se_receiver_dp.json", "content_hash": "sha256:4806a6fa835c72f6205d1aef2a77732703f109205bac472a76bfb6b1b961a81a" },
      { "path": "layout/analog/plans/differential_driver.json", "content_hash": "sha256:8d134f5e80e13342878b9e47c3f9670595c3e5f7b7cc842eee114484bfd896c6" },
      { "path": "design/dplus_pullup.sch", "content_hash": "sha256:81eaf5101b343bc5773f7d2800ea3dec40f8d7a5388240b8d22fd13a0b7684e6" },
      { "path": "design/netlist/differential_driver.spice", "content_hash": "sha256:bd4b2608c986fd1e305be7b1522e94f578cf36206fe30c13325f48a55f46afa5" },
      { "path": "design/netlist/differential_receiver.spice", "content_hash": "sha256:76a1e6f9263a115f9103461a03d1f796ec92644e15398a463659c25cce78b13d" },
      { "path": "design/netlist/dplus_pullup.spice", "content_hash": "sha256:9c645ecf0da6d80fb05d85c33d2941cc48bc328a00cd427f0c11bdf980b2cceb" },
      { "path": "design/netlist/se_receiver_dm.spice", "content_hash": "sha256:ebfc91ac1306060dfa0ffce7d91e048b4fc8b50cfebbd5804c3aaf9b58a20554" },
      { "path": "design/netlist/se_receiver_dp.spice", "content_hash": "sha256:1f854210680331a1df73b96b317479cad4af325192fec68b0b61fb1421fac0b3" }
    ]
  }
}
-->

# Record 20261009-203500-7a8e831

- **Record ID**: 20261009-203500-7a8e831
- **Claim**: the resized `differential_receiver` (issue #97 / PR #102:
  `XMP_B1` `W=32u nf=1`, `XMN_B1` `W=2u nf=1`, both `L=0.28u`) was
  regenerated from the current netlist and measured. Result, stated plainly:
  **geometry carries the new sizes, DRC is clean, extraction succeeds, and
  LVS does NOT match.** The layout is still not a usable analog layout:
  routing is incomplete (1 of 8 nets routed). A DRC-clean result says nothing
  about routing completeness or LVS.
- **Design provenance**: git `7a8e8317af7d` (`origin/main`). All thirteen
  `provenance.inputs[]` hashes were recomputed from the tree and match the
  superseded record byte for byte. No plan, netlist, schematic, spec or
  script was changed by this record's issue (#103); no plan change was
  needed (see "Plan check").
- **Run configuration**: pinned environment from `scripts/setup-env.sh`,
  full mode: `klt 0.5.0+ge8ca621a6961`, volare gf180mcu `c6d73a35f524`,
  deck `gf180mcu` content hash `sha256:95c2eb91...cb637`. Commands, run
  from the worktree with the pinned `.venv` activated, `PDK_ROOT=$HOME/.volare
  PDK=gf180mcuD`:
  1. `python3 scripts/gen_analog_layout.py --out-dir <scratch> --format json`
     (exit 0 = the run completed only). Executes all five committed plans
     and `klt drc`; saved as `analog-layout-report.json`.
  2. `klt drc differential_receiver.gds --deck gf180mcu --format json`
     (exit 0) -> `differential_receiver-drc-full.json`.
  3. `klt extract differential_receiver.gds --deck gf180mcu --pdk gf180mcuD
     --format json -o differential_receiver-extracted.spice` (exit 0) ->
     `differential_receiver-extract.json`.
  4. `klt lvs lvs-request.json --format json` (exit 3 = mismatch). Request:
     inline layout `{file: differential_receiver.gds, deck: gf180mcu, top:
     differential_receiver}` against reference
     `design/netlist/differential_receiver.spice` (copied verbatim as
     `differential_receiver_reference.spice`, sha256 `76a1e6f9...8b13d`,
     `form: subckt-call`) -> `differential_receiver-lvs.json`.
  5. Also attempted: `klt lvs lvs-request-preextracted.json` (pre-extracted
     `.spice` layout side) -> `differential_receiver-lvs-preextracted.json`
     (exit 3). This form cannot work here: the extracted netlist is itself in
     X-card form, so the compare reports the whole circuit as unmatched and
     zero devices extracted (0 of 11). Kept as evidence of the failure
     envelope; use the inline form (step 4) for the verdict.
  Artifact JSON files are verbatim tool output, so they contain the scratch
  paths (`/tmp/i103/...`) used for the run. Only single-unit, local `klt`
  invocations were run; no SPICE.
- **Statistical convention**: N/A (deterministic geometry checks).
- **Result**:
  - **Resized devices in the geometry** (layout plan `resolved_params`,
    and independently the extracted netlist): `mp_p_b1` `w_um` 32.0 (was
    8.0), `l_um` 0.28, a single unfolded finger (`rows` 1, `cols` 1);
    `klt extract` reports `X$8 ... pfet_03v3 L=0.28U W=32U` and
    `X$1 ... nfet_03v3 L=0.28U W=2U` (nfet 6, pfet 4, ppolyf_u_1k 1 = 11
    devices, matching the 11 reference devices). Effective width is the
    drawn width (no folding). Plan bbox is unchanged (439.08 x 41.82 um)
    because the taller PFET fits within the existing row height.
  - **DRC**: `clean`, 0 violations, `nothing_checked` false, `coverage.checked` 13 (full envelope in `differential_receiver-drc-full.json`).
  - **Extraction**: `extracted`, 11 devices, 31 nets, 4 pins (`AMPOUT`,
    `IBIASN`, `VDD`, `vsubs`). 31 nets against 10 in the reference shows the
    routing gap: the layout is a set of placed devices with almost no
    inter-device wiring.
  - **Routing** (from the plan/report): 1 of 8 nets routed. Unrouted:
    `AMPOUT`, `BUF1`, `IBIASN`, `LOADDIODE`, `RXD`, `TAIL`, `VSS`. 0 warnings,
    0 unmapped netlist nets. Unchanged from `20260921-130120-223bae5`.
  - **LVS**: `mismatch` (exit 3). 56 findings, 52 errors: 11
    `device.unmatched`, 41 `net.unmatched`, 1 `topology` (informational, no
    device-class mismatch), 1 `device.placeholder_value`, 2
    `device.body_unverified`. Counts: nets 31 layout / 10 reference / 0
    matched; devices 11 / 11 / 0 matched; pins 4 / 5 (9 matched on
    pin-level). **No device is matched because connectivity is incomplete;
    the report does not isolate a sizing mismatch.** This is a connectivity
    failure, not evidence the 32u/2u sizing is wrong or right at the LVS
    level (devices paired on topology could not form). No `match` is
    claimed, so no negative control was run.
  - **Limitations reported by the tool**: the reference `R` for
    `ppolyf_u_1k` is a subckt-call placeholder (not compared); device bodies
    are `unverified` (no tap convention establishes them); the engine
    resolved klayout `0.30.12` vs the tested `0.30.10`
    (`klayout_version_mismatch: true`, verdict unaffected per the tool).
  - **Other four blocks (carried forward, not re-verified here)**: the
    generator executed all five plans in this run (all five placed and
    DRC-clean in its summary; routed nets `dplus_pullup` 6/21,
    `se_receiver_dm` 1/9, `se_receiver_dp` 1/9, `differential_driver`
    0/10). No full DRC, extraction, or LVS was run for them; their
    layout/LVS state is as recorded in `20260921-130120-223bae5`, and their
    plans and netlists are byte-identical to it. Their GDS is not frozen
    here.
- **klt provenance**: `klt 0.5.0+ge8ca621a6961`, klayout 0.30.12, PDK
  `gf180mcuD` (open_pdks `c6d73a35f524`), deck `gf180mcu`
  (`sha256:95c2eb9148b29ded02182aeca4222287ff57f813691d5e2f9f8d7a675f6cb637`,
  unreleased). Frozen GDS sha256 `0d817398...cdc80a`; extracted netlist
  sha256 `0c1813d5...5305fc0`.
- **Plan check**: `layout/analog/plans/differential_receiver.json` needs no
  change. Its `mp_p_b1`/`mn_n_b1` groups take W/L from the netlist and the
  executor resolved 32.0 / 2.0 um. A 32 um single-finger PFET is tall but
  DRC-clean; fingering would only be a layout-quality choice (not needed for
  correctness), and is left to the routing follow-up.
- **Links**:
  - Superseded record (kept, append-only):
    `verification/records/analog-layout/records/20261009-094254-560eea8.md`
  - Earlier chain: `20261008-200500-4c71e6e`, `20260921-130120-223bae5`
  - Artifacts:
    `verification/records/analog-layout/artifacts/20261009-203500-7a8e831/`
  - Tracking narrative: `layout/README.md` § "Analog"
  - Dispatching issue: [gf180-usb2-phy#103](https://github.com/2AMLogic/gf180-usb2-phy/issues/103)
    (input resize: #97 / PR #102; broader post-layout re-verification: #53)
- **Timestamp / author**: 2026-10-09T20:35:00Z, Loom Builder (AI agent),
  issue #103.
- **Supersedes**: 20261009-094254-560eea8. That record was provenance-only
  and left the resized receiver unverified; this record measures it. Its
  statements about the other four blocks stand.
