2AMLogic/gf180-usb2-phy/verification/records/post-layout-pvt/records/20261008-195826-74ccfac.md

<!-- record-meta
{
  "record_id": "20261008-195826-74ccfac",
  "experiment": "post-layout-pvt",
  "supersedes": "20261008-200000-8139bb6",
  "git_revision": "74ccfac9da4cf3683f2f3e575ad70fa53cc60a88",
  "provenance": {
    "klt_version": "0.5.0+ge8ca621a6961",
    "pdk": {
      "name": "gf180mcuD",
      "version": "open_pdks c6d73a35f524070e85faff4a6a9eef49553ebc2b"
    },
    "deck": {
      "name": "gf180mcu_fd_sc_mcu9t5v0__{tt_025C_1v80,ss_125C_1v62,ff_n40C_5v50}",
      "content_hash": "sha256:2482036479c89fbee3754524e3fcdb530aa40aff0fef9e9385e3bc7b7a67d4ef"
    },
    "inputs": [
      {
        "path": "layout/digital/usb_utmi_phy.gds",
        "content_hash": "sha256:32e6dead081fefe5a237a66196699f6fb3cbcd032061964868104dd7d1ff484f"
      },
      {
        "path": "layout/digital/usb_utmi_phy.def",
        "content_hash": "sha256:82a57e76646067f49f4f48f796a8348b20b7e829fb8757778aed3c7900dde29e"
      },
      {
        "path": "layout/digital/usb_utmi_phy_routed.v",
        "content_hash": "sha256:188c15b9b06a64be4727174ff420bc2ecafe95f6dbab9508a08ada191e090276"
      },
      {
        "path": "flow/request-usb-utmi-phy-sta-corners.json",
        "content_hash": "sha256:590d85c1fbbfcc2ebc7ed42e2b3908142acb0395783fa21c0c1aff7056870aa2"
      }
    ]
  }
}
-->

# Record 20261008-195826-74ccfac

- **Record ID**: 20261008-195826-74ccfac
- **Claim**: three-corner post-layout STA of the routed digital partition
  with the extracted parasitics actually attached by OpenSTA. Record
  `20261008-200000-8139bb6` (and the single-corner record it superseded,
  `20260922-042422-9ec2304`) presented wire-parasitic-free timing as
  SPEF-annotated timing. This record measures why, repairs the extraction
  with the pinned klt's own `--def-pins` flag, and re-runs the same
  multi-corner `klt sta` request. It is the envelope
  `manifests/gf180-usb2-phy.json` cites for T1 item `5.digital`
  (issue #92, PR #104 review). Layout unchanged; no place-and-route re-run.
- **Design provenance**: layout (post-P&R, extracted). `layout/digital/
  usb_utmi_phy.{gds,def}` and `usb_utmi_phy_routed.v` are byte-identical to
  the superseded records' copies (SHA-256 checked before and after: def
  `82a57e76…`, gds `32e6dead…`, routed.v `188c15b9…`).
- **Run configuration**:
  ```
  PDK_ROOT=~/.volare PDK=gf180mcuD klt extract layout/digital/usb_utmi_phy.gds \
    --deck gf180mcu --top usb_utmi_phy --pdk gf180mcuD --parasitics \
    --def-net-names --def-net-connections layout/digital/usb_utmi_phy.def \
    --def-pins layout/digital/usb_utmi_phy.def \
    --spef flow/.klt/extract/usb_utmi_phy_route.spef \
    -o flow/.klt/extract/usb_utmi_phy_route.spice --format json

  PDK_ROOT=~/.volare PDK=gf180mcuD klt sta flow/request-usb-utmi-phy-sta-corners.json --format json

  OPENROAD_DOCKER_CMD='sudo -n docker' \
    verification/records/post-layout-pvt/artifacts/20261008-195826-74ccfac/annotation-probe/run.sh
  ```
  The only change from the superseded run is `--def-pins` on the extract
  step. `klt 0.5.0+ge8ca621a6961` (the repo pin, through `uvx --from` at
  that git rev; host `klt` not used). OpenSTA from OpenROAD
  `26Q3-1260-g06a5a02279` (the pinned `openroad/orfs` digest through
  `scripts/openroad-docker.sh`). Clock `clk` at 83.333 ns, ideal (as
  `klt sta` emits it). The extraction is deterministic: a second
  `--def-pins` run gave a byte-identical SPEF. The frozen request
  `artifacts/20261008-195826-74ccfac/request-sta-corners.json` (paths
  relative to that directory) was replayed from the repo root and gave the
  same per-corner metrics and `spef_annotation` blocks.
- **Statistical convention**: N/A. Deterministic runs on one fixed DEF and
  SPEF.
- **Result**:
  - **What was wrong with the superseded evidence (measured).** The
    probe (`annotation-probe/`, OpenSTA on the same LEFs, DEF, liberty and
    clock) on record `20261008-200000-8139bb6`'s SPEF, at all three
    corners:
    - the timing paths before and after `read_spef` are byte-identical
      (`delay_changed: false` in the cited envelope);
    - `report_net _013_` (an ordinary two-pin net) shows wire capacitance
      0.0000 pF after `read_spef`, where the SPEF gives it 2.45 fF;
    - 1001 `STA-1656 pin … not found` warnings (OpenSTA stops printing at
      1000) on top of the 1652 `STA-1650` warnings the envelope reports.

    Root cause, from the SPEF text. Without `--def-pins`, the extractor
    declares every DEF-named net as a top-level port: all 343 nets appear
    in `*PORTS` and each has a `*P <net>` entry. It also writes the hub
    node of each net as the bare net name (`_013_`), not as an internal
    node (`_013_:1`). OpenSTA reads a bare name as a port pin and finds no
    such port, because the DEF has 37. It then drops every CAP and RES
    element that touches the hub, which is all of them, so no design net
    gets any wire parasitics. `report_parasitic_annotation` lists 307
    partially unannotated drivers. "342 of 342 design nets annotated"
    only counts net names that matched; it does not mean any parasitics
    were attached. The superseded records' statement that the incomplete
    annotation was only discarded physical-only nets, "not a correlation
    miss", was wrong. Every number in `20261008-200000-8139bb6` and
    `20260922-042422-9ec2304` is wire-parasitic-free timing (pin
    capacitance only), not a post-layout measurement. The superseded
    single-corner record's SPEF has the same structure (`*P _013_ B`, bare
    hub nodes).
  - **Repair.** The pinned klt has `--def-pins <DEF>`, which takes the
    declared port set from the DEF's own `PINS` section. With it, 306 nets
    stay internal (the extractor's warning) and their hubs become `net:1`.
    `*PORTS` has 37 entries. As a cross-check, a value-preserving rewrite
    of the old SPEF (`annotation-probe/repair_spef_hub_nodes.py`) gives the
    same worst setup and hold slack to four decimals at every corner (see
    the probe table). The rewrite renames bare hub nodes to `:1` and drops
    the false port entries; it changes no R or C value and is not cited
    evidence.
  - **Envelope (`sta-corners.json`)**: `status: "ok"`,
    `geometry_source: "routed"`, three distinct `corners`, each
    `timing_status: "constrained"`, 0 setup / 0 hold violations, TNS 0,
    `provenance.input.content_hash` = DEF `sha256:82a57e76…`. At every
    corner: **`delay_changed: true`**, `unannotated_driver_count` 7,
    `partially_unannotated_driver_count` 3, `design_nets_annotated` 342 of
    342, `reader_warning_count` 831.

    | Corner | setup slack (ns) | hold slack (ns) | fmax (MHz) | skew (ns) | power (mW) | superseded wire-free setup / hold |
    |---|---|---|---|---|---|---|
    | `tt_025C_1v80` | 62.3295 | 2.59857 | 47.611 | 0.08197 | 0.145 | 65.0864 / 2.42085 |
    | `ss_125C_1v62` | 30.9015 | 6.33243 | 19.0725 | 0.18048 | 0.1207 | 37.7904 / 5.90006 |
    | `ff_n40C_5v50` | 80.0919 | 0.43474 | 308.541 | 0.01689 | 1.4863 | 80.4630 / 0.40569 |

    Attaching the parasitics costs 2.76 ns of setup slack at tt, 6.89 ns
    at ss (18 % of the wire-free figure) and 0.37 ns at ff. Hold slack
    increases slightly, because the data path is slower and the clock is
    ideal. The ss figure is 2.00 ns tighter than the place-and-route
    estimated-RC figure that `20260922-042422-9ec2304` quoted (32.9047 ns).
    The superseded wire-free numbers were optimistic relative to both.
    All three corners still meet setup and hold, with at least 30.9 ns of
    setup margin at the 12 MHz clock.
  - **What the remaining diagnostics are (measured, not assumed)**:
    - *7 unannotated drivers* = `clkload0/ZN` … `clkload6/ZN`. These are
      CTS dummy-load inverters whose output connects to no DEF net. The
      extractor emits their floating outputs as seven duplicate
      `*D_NET ZN` blocks, and OpenSTA rejects them (`STA-1650 net ZN`).
      No timing path goes through these outputs.
    - *3 partially unannotated drivers* = `_341_/Q`,
      `u_line_state/_6_/Q`, `u_line_state/_7_/Q`. They drive the three
      nets whose DEF PIN name differs from the DEF NET name: `RxActive`
      on net `rx_receiving`, and `LineState[0]` and `LineState[1]` on nets
      `line_state[0]` and `line_state[1]`. `--def-pins` keeps those nets
      as ports under the net name, so their hubs stay bare and OpenSTA
      drops them (`STA-1656`, 180 lines). Those three nets carry 0 wire
      capacitance in this run. With the repaired-hub cross-check, which
      attaches 28.9, 10.6 and 11.3 fF to them, worst setup and hold slack
      do not change in the fourth decimal at any corner. So the cited
      worst-slack figures do not depend on these three nets.
    - *643 `STA-1650 net $N not found`*: these are the extractor's
      unnamed nets. Every one of them is poly and `metal0` only (457 fF
      poly, 411 fF `metal0` in total) and ends on transistor terminals.
      They are standard-cell internal nets, which the liberty
      characterization already covers, not routing. Coupling from design
      nets to non-design nets totals 3.1 fF, against 1675 fF of grounded
      design-net capacitance; the largest single-net share is 0.53 fF.
  - **Probe table** (`annotation-probe/probe-<corner>-<spef>.txt`, worst
    setup / worst hold slack in ns, `report_worst_slack -digits 4`):

    | Corner | as-extracted (old SPEF) | hub-repaired (old SPEF, rewrite) | `--def-pins` (this record's SPEF) |
    |---|---|---|---|
    | `tt_025C_1v80` | 65.0864 / 2.4208, paths identical before/after `read_spef` | 62.3294 / 2.5986 | 62.3294 / 2.5986 |
    | `ss_125C_1v62` | 37.7904 / 5.9001, paths identical | 30.9015 / 6.3324 | 30.9015 / 6.3324 |
    | `ff_n40C_5v50` | 80.4631 / 0.4057, paths identical | 80.0919 / 0.4347 | 80.0919 / 0.4347 |
  - **Overall: pass** on three corners, with extracted wire capacitance
    attached. Read this within the limits below.
- **Coverage gaps**:
  - *Wire resistance does not reach any pin-to-pin path.* This is how the
    extractor models resistance at the pin, not a reader problem. Every
    pin connects to its net's hub through a 0 Ω leg (1091 of 1091). The
    per-net resistance is a star from the hub to internal nodes that carry
    no capacitance and no pins (13 847 such nodes, 3 with any
    capacitance). OpenSTA therefore sees each net as a lumped capacitance.
    The `--distributed-rc --critical-net` mode, which would add
    resistance, was not used. The largest per-net resistance sum is
    7.3 kΩ on net `_053_`. As a rough, unmeasured bound, ΣR·(C_wire +
    100 fF) for that net is about 1.3 ns, which is well inside the
    30.9 ns worst-corner setup margin. Wire resistance only adds data-path
    delay under an ideal clock, so it cannot reduce hold slack. This
    estimate is not a measurement.
  - *Ideal clock.* `klt sta` times this post-CTS DEF with an ideal clock,
    so slack does not include clock-tree insertion delay. Skew is reported
    as a separate metric. This is a known tool gap (klayout-tools#2739).
  - *Lateral (same-layer) coupling* is only modelled for
    `--critical-net` nets. None were declared, so only vertical-overlap
    coupling is present.
  - Three liberty corners only. Spec §8.1 fixes a 45-corner matrix
    (3 T × 3 V × 5 process including `fs`/`sf`). This record does not
    claim it. There is no SDF gate-level run (#93). Analog PVT is
    untouched (klayout-tools#1962).
- **Cited envelope (path normalization)**: `sta-corners.emitted.json` is
  the `klt sta` response exactly as emitted (sha256 `3c14d7a5…`).
  `sta-corners.json` is that response with the producing worktree's root
  prefix stripped and nothing else changed. It is byte-equal to
  `sed 's#/home/ubuntu/GitHub/gf180-usb2-phy/.loom/worktrees/issue-92/##g' sta-corners.emitted.json`,
  so `def_path` is `layout/digital/usb_utmi_phy.def` and `klt signoff`
  can re-hash it from any checkout (klayout-tools#2879). `spef_path`
  names the run's working SPEF, which is not committed; the committed
  copy is `usb_utmi_phy_route.spef` in this directory (sha256
  `2d4fbb57…`).
- **klt provenance**: `klt 0.5.0+ge8ca621a6961`, PDK `gf180mcuD` (open_pdks
  `c6d73a35f524…`), extract deck `gf180mcu`.
- **Links**: artifacts in `artifacts/20261008-195826-74ccfac/`:
  `request-sta-corners.json`, `extract-defnames-defpins-output.json`,
  `usb_utmi_phy_route.spef`, `sta-corners.emitted.json` (raw),
  `sta-corners.json` (cited), and `annotation-probe/` (`probe.tcl`,
  `run.sh`, `repair_spef_hub_nodes.py`, nine OpenSTA logs `probe-*.txt`). Superseded:
  `records/20261008-200000-8139bb6.md`. Issues #92, #53. PR #104.
  Follow-up issue #106 (this record does its repair and re-mint).
  Friction: klayout-tools#2879 (absolute paths) and klayout-tools#2880
  (annotation reported complete while parasitics were not applied). The
  root cause, the `--def-pins` workaround and the three residual gaps
  above are in a comment there.
- **Timestamp / author**: 2026-10-08T19:58:26Z, loom-doctor (issue #92, PR #104 review)
- **Supersedes**: `20261008-200000-8139bb6`. Same layout, request and
  corners. Its SPEF could not be attached by OpenSTA, so its numbers are
  wire-parasitic-free. Its artifacts, including the emitted response, are
  kept unchanged.
