2AMLogic/gf180-usb2-phy/verification/records/post-layout-pvt/records/20261008-200000-8139bb6.md

<!-- record-meta
{
  "record_id": "20261008-200000-8139bb6",
  "experiment": "post-layout-pvt",
  "supersedes": "20260922-042422-9ec2304",
  "git_revision": "8139bb64eec639be6ff04e78cc713be584dbf6f6",
  "provenance": {
    "klt_version": "0.5.0+ge8ca621a6961",
    "pdk": {
      "name": "gf180mcuD",
      "version": "open_pdks c6d73a35f524070e85faff4a6a9eef49553ebc2b"
    },
    "deck": {
      "name": "gf180mcu_fd_sc_mcu9t5v0__{tt_025C_1v80,ss_125C_1v62,ff_n40C_5v50}",
      "content_hash": "sha256:2482036479c89fbee3754524e3fcdb530aa40aff0fef9e9385e3bc7b7a67d4ef"
    },
    "inputs": [
      {
        "path": "layout/digital/usb_utmi_phy.gds",
        "content_hash": "sha256:32e6dead081fefe5a237a66196699f6fb3cbcd032061964868104dd7d1ff484f"
      },
      {
        "path": "layout/digital/usb_utmi_phy.def",
        "content_hash": "sha256:82a57e76646067f49f4f48f796a8348b20b7e829fb8757778aed3c7900dde29e"
      },
      {
        "path": "layout/digital/usb_utmi_phy_routed.v",
        "content_hash": "sha256:188c15b9b06a64be4727174ff420bc2ecafe95f6dbab9508a08ada191e090276"
      },
      {
        "path": "flow/request-usb-utmi-phy-sta-corners.json",
        "content_hash": "sha256:590d85c1fbbfcc2ebc7ed42e2b3908142acb0395783fa21c0c1aff7056870aa2"
      }
    ]
  }
}
-->

# Record 20261008-200000-8139bb6

- **Record ID**: 20261008-200000-8139bb6
- **Claim**: the layout-netlist STA of record `20260922-042422-9ec2304`
  (its SPEF annotation is shown below not to take effect), re-minted as **one multi-corner `klt sta` envelope** (`pdk.corners`) so
  `manifests/gf180-usb2-phy.json` can cite it as T1 item `5.digital`
  (issue #92, the digital leg of #53). Same routed layout, same SPEF
  procedure, same clock, same three corners; no place-and-route re-run.
  **Correction, before merge (PR #104 review):** the timing in this record
  carries no wire parasitics (see Result). The manifest therefore cites
  the superseding record `20261008-195826-74ccfac`, not this one. This
  record and its artifacts, including `sta-corners.emitted.json`, are kept
  as the measured history.
- **Design provenance**: layout (post-P&R; extracted SPEF read but **not
  attached** by OpenSTA, see Result) — `layout/digital/
  usb_utmi_phy.{gds,def}` and `usb_utmi_phy_routed.v` are byte-identical to
  the superseded record's (SHA-256 before == after: def `82a57e76…`,
  gds `32e6dead…`, routed.v `188c15b9…`).
- **Run configuration**:
  ```
  PDK_ROOT=~/.volare PDK=gf180mcuD klt extract layout/digital/usb_utmi_phy.gds \
    --deck gf180mcu --top usb_utmi_phy --pdk gf180mcuD --parasitics \
    --def-net-names --def-net-connections layout/digital/usb_utmi_phy.def \
    --spef flow/.klt/extract/usb_utmi_phy_route.spef \
    -o flow/.klt/extract/usb_utmi_phy_route.spice --format json

  PDK_ROOT=~/.volare PDK=gf180mcuD klt sta flow/request-usb-utmi-phy-sta-corners.json --format json
  ```
  `klt 0.5.0+ge8ca621a6961` (the repo pin, via `uvx --from` a git rev; the
  host `klt` 0.7.0 was not used), OpenSTA via OpenROAD `26Q3-1260-g06a5a02279`
  (pinned `openroad/orfs` digest through `scripts/openroad-docker.sh`,
  `OPENROAD_DOCKER_CMD='sudo -n docker'`), run from the worktree root.
  `klayout` module reported by the response: 0.30.12 (the superseded record
  states 0.30.10; extraction output below is equivalent). Clock `clk` @
  83.333 ns. The frozen request replays: re-running
  `klt sta` on `artifacts/20261008-200000-8139bb6/request-sta-corners.json`
  (paths rewritten relative to that directory) reproduced the same numbers.
- **Statistical convention**: N/A — deterministic runs on one fixed DEF+SPEF.
- **Result**:
  - Envelope: `geometry_source: "routed"`, `status: "ok"`, `corners` list of
    exactly three distinct entries, each `timing_status: "constrained"`,
    0 setup / 0 hold violations, TNS 0. `provenance.input.content_hash` =
    DEF `sha256:82a57e76…`.
  - SPEF annotation at every corner: **incomplete; the parasitics were not
    attached, and the timing below is wire-parasitic-free.** The envelope
    reports `design_nets_annotated` 342 of 342 (every design net *name*
    has a `*D_NET`), but also `unannotated_driver_count` 7,
    `partially_unannotated_driver_count` 307, `delay_changed: false`, and
    an `annotation_warning` stating the reported paths are byte-identical
    before and after `read_spef`. The 342/342 count is a name match; it
    does not reconcile with those diagnostics. A first draft of this
    record attributed the incomplete annotation only to discarded
    physical-only nets and called it "not a correlation miss". That was
    wrong, and the PR #104 review caught it. Measured on a `tt_025C_1v80`
    replay (artifacts `annotation-diagnostic-tt.*`, same pinned OpenROAD,
    same DEF and SPEF):
    - The 7 fully unannotated drivers are `clkload0/ZN` .. `clkload6/ZN`,
      the dummy clock-load cells in `usb_utmi_phy_routed.v`. They have no
      output net, so there is nothing to annotate; this part is benign.
    - The 307 partially unannotated drivers are ordinary signal nets (for
      example `_148_/ZN` driving `_290_/A1`, `u_sync_detector/_16_/I`,
      `u_sync_detector/_21_/A1`). Their `*D_NET` exists with `*RES`
      segments to every load pin, yet `report_parasitic_annotation` lists
      the load pins as unannotated.
    - `report_net _010_` (that same net) reports `Wire capacitance:
      0.000000` both before and after `read_spef`, although the SPEF
      gives it a 6.11 fF `*D_NET`. `report_checks` with `-fields {cap
      slew input_pins nets}` is byte-identical before and after
      `read_spef`.
    - **Cause (established afterwards, in record
      `20261008-195826-74ccfac`'s `annotation-probe/`, at all three
      corners).** This SPEF was extracted without `--def-pins`. It
      declares every DEF net a top-level port (343 `*PORTS` entries, a
      `*P <net>` in every `*CONN`; the DEF has 37 PINS) and names each
      net's RC hub node with the bare net name (`_013_`, not `_013_:1`).
      OpenSTA reads a bare node name as a port pin and finds no such port.
      That is where the 1001 `STA-1656 pin … not found` warnings come
      from. It then drops every CAP and RES element touching the hub,
      which is every element of every design net. Re-extracting with the
      pinned klt's `--def-pins` (or a value-preserving rewrite of this
      SPEF's hub names) attaches the parasitics: `delay_changed: true`,
      and partially unannotated drivers fall from 307 to 3. The 1652
      `STA-1650` records are separate and benign: 643 unnamed
      standard-cell-internal poly/`metal0` nets and 7 floating `ZN`
      outputs. Follow-up #106 and klayout-tools#2880 carry this.
  - Per-corner numbers vs the three single-corner envelopes of
    `20260922-042422-9ec2304`:

    | Corner | setup slack (ns) | hold slack (ns) | fmax (MHz) | vs superseded |
    |---|---|---|---|---|
    | `tt_025C_1v80` | 65.0864 | 2.42085 | 54.8047 | identical |
    | `ss_125C_1v62` | 37.7904 | 5.90006 | 21.9575 | identical |
    | `ff_n40C_5v50` | 80.463 | 0.40569 | 348.438 | identical |

    Clock skew (0.06185 / 0.1422 / 0.01277 ns) and power (0.1358 / 0.1132 /
    1.3961 mW) also match the single-corner runs. Deltas: none in any
    reported metric. The re-extracted SPEF differs textually from the
    superseded one only in the order of some internal-node RC lines
    (a sorted-line diff shows reordering, values unchanged; the extract
    netlist sha256 therefore differs: `3a540e62…` vs `25c65fe5…`), which
    does not move any timing value. The match is expected: neither run
    attached any parasitics, and the superseded record's SPEF has the same
    bare-hub, every-net-a-port structure.
  - **Overall**: 0 setup / 0 hold violations at three corners for
    **wire-parasitic-free timing only** (pin capacitance, ideal wires,
    ideal clock). This record does **not** establish post-layout timing
    with extracted parasitics, and the manifest no longer cites it. It is
    superseded by `20261008-195826-74ccfac`, which re-extracts with
    `--def-pins` so the parasitics attach (`delay_changed: true`). There,
    setup slack is 2.76 / 6.89 / 0.37 ns lower at tt / ss / ff, and all
    three corners still meet setup and hold.
- **Coverage gaps**: three liberty corners only. Spec §8.1 fixes a 45-corner
  matrix (3 T x 3 V x 5 process incl. `fs`/`sf`); the digital cell library
  corners used here do not span it, and this record does not claim it.
  Analog PVT is untouched (parked on klayout-tools#1962). No SDF
  gate-level run (#93). `klt sta` (at this pin) emits `def_path` /
  `spef_path` as absolute paths of the producing host; see "Cited
  envelope" below for how the cited copy is made portable.
- **Cited envelope (path normalization)**: `artifacts/20261008-200000-8139bb6/
  sta-corners.emitted.json` is the `klt sta` response exactly as emitted
  (sha256 `5698c3e5…`), carrying the producing worktree's absolute root
  `/home/ubuntu/GitHub/gf180-usb2-phy/.loom/worktrees/issue-92/` in
  `def_path`, `spef_path` and the `STA-1650` warning strings. `klt signoff`
  re-hashes an `sta` citation's input via `def_path`, so an absolute host
  path makes `input_verified` resolve only on that host (`null` on a clean
  CI checkout, which is how CI first failed on this record). The cited
  `sta-corners.json` is that response with the root prefix stripped and
  nothing else changed — byte-equal to
  `sed 's#/home/ubuntu/GitHub/gf180-usb2-phy/.loom/worktrees/issue-92/##g' sta-corners.emitted.json`
  — so `def_path` reads `layout/digital/usb_utmi_phy.def`, resolved
  against the repo root where `klt signoff` is run, and re-hashes to the
  recorded `sha256:82a57e76…` on any checkout. `provenance`, all corner
  results and all metrics are unchanged. `spef_path` names the run's
  working SPEF (`flow/.klt/extract/…`, not committed); the committed copy
  of that SPEF is `usb_utmi_phy_route.spef` in this directory.
- **klt provenance**: `klt 0.5.0+ge8ca621a6961`, PDK `gf180mcuD` (open_pdks
  `c6d73a35f524…`), extract deck `gf180mcu`.
- **Links**: superseded `records/20260922-042422-9ec2304.md`; artifacts in
  `artifacts/20261008-200000-8139bb6/` (`request-sta-corners.json`,
  `extract-defnames-output.json`, `usb_utmi_phy_route.spef`,
  `sta-corners.emitted.json` (raw), `sta-corners.json` (cited,
  path-normalized), `annotation-diagnostic-tt.{tcl,report,net-010-pre-spef,net-010-post-spef}.txt` (annotation probe)); issues #92, #53. Friction filed: klayout-tools#2880 (SPEF annotation reported complete while parasitics not applied), follow-up issue #106; also klayout-tools#2879 (`klt sta` echoes absolute input paths, so `input_verified` cannot be re-derived off-host).
- **Timestamp / author**: 2026-10-08T20:00:00Z, loom-builder (issue #92)
- **Supersedes**: `20260922-042422-9ec2304` (same measurement, now in the
  single multi-corner shape the signoff grader cites; its artifacts are
  preserved).
