2AMLogic/gf180-usb2-phy/verification/records/digital-erc/records/20260922-042422-9ec2304.md

<!-- record-meta
{
  "record_id": "20260922-042422-9ec2304",
  "experiment": "digital-erc",
  "supersedes": "20260921-213041-4b9148f",
  "git_revision": "9ec2304c8aa3cc18fe1c50f3c48fdb38e0997db3",
  "provenance": {
    "klt_version": "0.5.0+ge8ca621a6961",
    "pdk": {
      "name": "gf180mcuD",
      "version": "open_pdks c6d73a35f524070e85faff4a6a9eef49553ebc2b"
    },
    "deck": {
      "name": "n/a",
      "content_hash": "n/a"
    },
    "inputs": [
      { "path": "layout/digital/usb_utmi_phy.gds", "content_hash": "sha256:32e6dead081fefe5a237a66196699f6fb3cbcd032061964868104dd7d1ff484f" },
      { "path": "layout/digital/erc-supply-spec.json", "content_hash": "sha256:194c781ba27426de010030732e85ee75b34548bafa8b20af003184fb94145fef" },
      { "path": "flow/request-usb-utmi-phy-par.json", "content_hash": "sha256:5e267e8645ade958cadc62e93ab523278d0f84c8ef9e8f1a123e1442036e27e2" },
      { "path": "verification/records/place-and-route/artifacts/20260922-042422-9ec2304/place-and-route-output.json", "content_hash": "sha256:af52ac3c638fe24a7c856ca3d8707fe734c0f015dc3422e16614b219a8d71a12" },
      { "path": "verification/records/digital-lvs/artifacts/20260922-042422-9ec2304/lvs-report.json", "content_hash": "sha256:c2f4cf100d326afc61af26bbd4d8fd780a44ad063bd5a464db89baf9b9a96529" }
    ]
  }
}
-->

# Record 20260922-042422-9ec2304

- **Record ID**: 20260922-042422-9ec2304
- **Claim**: re-runs the superseded record's exact claim — the
  supply-connectivity ERC half on the digital PHY's routed GDS is
  **clean** (`erc_status: "clean"`, `erc_finding_count: 0`) — against the
  **post-#84 re-implementation** of that layout (issue #87's P&R re-run).
  Not in issue #87's original leg list, but required by it: the
  re-refreshed GDS staled the superseded ERC record's provenance, and
  `verification/check_records.py` correctly flags a live record whose
  cited layout hash no longer matches — so the re-run keeps the evidence
  chain's freshness invariant whole rather than leaving a red lint for
  the next pass.
- **Design provenance**: layout (post-P&R, merged DEF+GDS) — the GDS
  committed at `9ec2304c8aa3cc18fe1c50f3c48fdb38e0997db3`, produced by
  the same-day place-and-route record. The spec
  (`layout/digital/erc-supply-spec.json`, hash `194c781b…`) is
  byte-identical to the superseded run's — same stackup, `vias[]`,
  `nets[]` (`VDD`/`VSS` supply), and the declared `ties[]` section.
- **Run configuration**:
  ```
  PDK_ROOT=~/.volare klt erc layout/digital/usb_utmi_phy.gds \
    layout/digital/erc-supply-spec.json \
    --top usb_utmi_phy --format json
  ```
  `klt 0.5.0+ge8ca621a6961` (this repo's pin), `klayout 0.30.10` (the
  version this pin reports as tested). No `--pdk`, no `--deck` — same
  shape as the superseded run.
- **Statistical convention**: N/A — one deterministic rule run against
  one fixed GDS.
- **Result**:
  - **`erc_status: "clean"`, `erc_finding_count: 0`** — all 852 gates
    (gate role `poly2`) checked by the `erc.floating_gate` rules, the
    declared ties (`lvpwell_vss_tap`, `nwell_vdd_tap`) exercised,
    coverage `known: true`.
  - **`status: "not_checked"`, process exit `4`** — the antenna half,
    exactly as in the superseded record: the overall `status` field is
    the antenna check's, which needs netlist-level data this GDS-only
    invocation does not have; the P&R leg's own
    `antenna_violation_count: 0` is the antenna evidence for this
    layout. Disclosed, not hidden; unchanged in kind from the
    superseded record.
- **Coverage gaps** (unchanged from the superseded record): the
  supply-connectivity half checks tie/well-tap presence per the declared
  spec, not rail IR drop or grid robustness; the antenna half is
  `not_checked` here for the stated reason.
- **klt provenance**: `klt 0.5.0+ge8ca621a6961`, `klayout 0.30.10`, no
  PDK/deck resolution on this command (spec-driven); layout input
  content_hash `sha256:32e6dead…`, spec content_hash
  `sha256:194c781b…`.
- **Links**:
  - Layout under test: `layout/digital/usb_utmi_phy.gds`
  - Spec: `layout/digital/erc-supply-spec.json`
  - Producing P&R record + envelope (the antenna verdict cited above):
    `verification/records/place-and-route/records/20260922-042422-9ec2304.md`,
    `artifacts/20260922-042422-9ec2304/place-and-route-output.json`
  - Same-day LVS record (the power-connectivity cross-check):
    `verification/records/digital-lvs/records/20260922-042422-9ec2304.md`,
    `artifacts/20260922-042422-9ec2304/lvs-report.json`
  - Raw klt JSON envelope (frozen):
    `artifacts/20260922-042422-9ec2304/erc-supply-report.json`
  - Friction filed: none.
- **Timestamp / author**: 2026-09-22T04:24:22Z, loom-builder (issue #87)
- **Supersedes**: `20260921-213041-4b9148f` — that record's clean
  verdict was true of the pre-#84 GDS it pinned (`sha256:341ccb21…`);
  #87's re-run replaced the GDS, so its provenance is stale by
  construction. It stands as history.
