2AMLogic/gf180-usb2-phy/verification/records/place-and-route/records/20260922-042422-9ec2304.md

<!-- record-meta
{
  "record_id": "20260922-042422-9ec2304",
  "experiment": "place-and-route",
  "supersedes": "20260922-004226-0446e4c",
  "git_revision": "9ec2304c8aa3cc18fe1c50f3c48fdb38e0997db3",
  "provenance": {
    "klt_version": "0.5.0+ge8ca621a6961",
    "pdk": {
      "name": "gf180mcuD",
      "version": "open_pdks c6d73a35f524070e85faff4a6a9eef49553ebc2b"
    },
    "deck": {
      "synthesize": {
        "name": "gf180mcu_fd_sc_mcu9t5v0__tt_025C_1v80",
        "content_hash": "sha256:2482036479c89fbee3754524e3fcdb530aa40aff0fef9e9385e3bc7b7a67d4ef"
      },
      "place_and_route": {
        "name": "gf180mcu_fd_sc_mcu9t5v0__tt_025C_1v80",
        "content_hash": "sha256:2482036479c89fbee3754524e3fcdb530aa40aff0fef9e9385e3bc7b7a67d4ef"
      }
    },
    "inputs": [
      { "path": "rtl/common/usb_nrzi_encoder.v", "content_hash": "sha256:9ab1f95a877aab538d13784fa02e7c260d173cac851b4c9e9fa78d25ea01bf39" },
      { "path": "rtl/common/usb_nrzi_decoder.v", "content_hash": "sha256:aa7eef14d8b00c6969ff375007ce34b960a9e2bd8f337d18590d902edad426c3" },
      { "path": "rtl/common/usb_bit_stuffer.v", "content_hash": "sha256:8987568b5bf36d0bfa649c2cb8bfbe7c06a2a3c22df3491d5548820a917ce0c4" },
      { "path": "rtl/common/usb_bit_destuffer.v", "content_hash": "sha256:03fc67bcec9eaece476ed46a7cb41fab4000bcd49e18cc7c7bf60f016f1ffc51" },
      { "path": "rtl/usb_sync_detector.v", "content_hash": "sha256:1f69da425fec809895fbdeb61e1d308379ddabc9aa0ecb10bf2f88f8fa88cbdc" },
      { "path": "rtl/usb_eop_detector.v", "content_hash": "sha256:163b950b3dcf939a2810f03b63dbea6f361f3261d47a75ea980cdf60d67e8e28" },
      { "path": "rtl/usb_line_state_decode.v", "content_hash": "sha256:c2d93d43d48ddaa2b620c3c0f11b06af74e89860fa3883f7b543955b46aa0d08" },
      { "path": "rtl/usb_utmi_phy.v", "content_hash": "sha256:313cde6e64c4f6829ef27184f6c8a1d325b7ed12f918db03478332ab42b78945" },
      { "path": "flow/request-usb-utmi-phy-synth.json", "content_hash": "sha256:e04c09fd45025320b460a36c0631fba6127dea8440a2a0fb12bff4d1574cdba2" },
      { "path": "flow/request-usb-utmi-phy-par.json", "content_hash": "sha256:5e267e8645ade958cadc62e93ab523278d0f84c8ef9e8f1a123e1442036e27e2" },
      { "path": "layout/digital/usb_utmi_phy.gds", "content_hash": "sha256:32e6dead081fefe5a237a66196699f6fb3cbcd032061964868104dd7d1ff484f" },
      { "path": "layout/digital/usb_utmi_phy.def", "content_hash": "sha256:82a57e76646067f49f4f48f796a8348b20b7e829fb8757778aed3c7900dde29e" },
      { "path": "layout/digital/usb_utmi_phy_routed.v", "content_hash": "sha256:188c15b9b06a64be4727174ff420bc2ecafe95f6dbab9508a08ada191e090276" },
      { "path": "reuse.lock.json", "content_hash": "sha256:e48883b59c16cbaaa640c4414ff06c9cd0804fa02ef8855bd8e772d555906755" },
      { "path": "spec/decisions/0002-vendored-protocol-rtl-interfaces-and-dispositions.md", "content_hash": "sha256:5b279332dd3fff52fbdecbeb1dfeaf2303eb671ba5895756859143ed82a26a82" }
    ]
  }
}
-->

# Record 20260922-042422-9ec2304

- **Record ID**: 20260922-042422-9ec2304
- **Claim**: the re-run #87 owns — the real PHY digital logic
  (`rtl/usb_utmi_phy.v` and every submodule it instantiates: the four
  vendored canonical protocol modules under `rtl/common/`, pinned by
  `reuse.lock.json`, plus `usb_sync_detector`, `usb_eop_detector`,
  `usb_line_state_decode`) synthesizes and place-and-routes to a
  committed, routed GDS via `klt synthesize` + `klt place-and-route`
  (OpenROAD), against the post-#84 source set. This is the actual
  measurement the superseded documentation record
  (`20260922-004226-0446e4c`) deferred to this issue: that record retired
  the pre-#84 P&R evidence without presenting an un-run result; this one
  re-runs the chain and replaces the deferral with numbers.
- **Design provenance**: netlist (post-synthesis) → layout (post-P&R,
  merged DEF+GDS, not extracted) — `rtl/usb_utmi_phy.v` and its seven
  submodules @ `9ec2304c8aa3cc18fe1c50f3c48fdb38e0997db3`. Every source
  input hash above is byte-identical to the ones
  `20260922-004226-0446e4c` pinned (the post-#84 tree it named as the
  future re-run's inputs); the only changed inputs are the three
  generated artifacts this run refreshes (GDS/DEF/as-built netlist).
- **Run configuration**:
  ```
  PDK_ROOT=~/.volare PDK=gf180mcuD klt synthesize        flow/request-usb-utmi-phy-synth.json --format json
  PDK_ROOT=~/.volare PDK=gf180mcuD klt place-and-route   flow/request-usb-utmi-phy-par.json   --format json
  ```
  `klt 0.5.0+ge8ca621a6961` (this repo's pin, `docs/environment-setup.md`,
  provisioned via `scripts/setup-env.sh`), `klayout 0.30.10` (pinned into
  the venv over the 0.30.12 the install resolves by default — the version
  this klt pin reports as tested, matching the Sep-21 records), OpenROAD
  `26Q3-1260-g06a5a02279` (the pinned `openroad/orfs` image via
  `scripts/openroad-docker.sh`, `OPENROAD_DOCKER_CMD='sudo -n docker'`),
  cell library `gf180mcu_fd_sc_mcu9t5v0` @ `tt_025C_1v80`
  (content_hash `sha256:2482036479c89f…`, byte-identical to the
  2026-08-25 record's deck), PDK `gf180mcuD` (open_pdks
  `c6d73a35f524070e85faff4a6a9eef49553ebc2b` from `PDK_ROOT=~/.volare` —
  the documented pin, not the `~/.ciel` build klt's bare search root
  would pick), `seed: 1`, `target_stage: "route"`, floorplan
  `utilization` 40 % / aspect 1.0 / `core_margin_um` 4.0 / site
  `GF018hv5v_green_sc9`, IO layers `Metal3`(h)/`Metal2`(v), clock `clk`
  @ 83.333 ns (12 MHz, spec §3), and the unchanged `request.power`
  three-strap PDN block (Metal1 followpins 0.900 µm @ 5.040 µm; Metal4
  4.480 µm @ 44.8 µm pitch / 22.4 µm offset; Metal5 4.480 µm @ 89.6 µm
  pitch / 44.8 µm offset; Metal1→Metal4 stack `-max_columns 5 -ongrid
  {Metal2 Metal3 Metal4} -split_cuts {Metal3 0.128}`). The netlist
  `klt synthesize` emitted (run-scoped under
  `flow/.klt/synthesize/run-*/`) is staged to the canonical
  `flow/.klt/synthesize/usb_utmi_phy_synth.v` path the P&R request
  names, then both envelopes are frozen verbatim in this record's
  artifacts.
- **Statistical convention**: N/A — a single deterministic implementation
  run at a fixed seed (`seed: 1`). Re-running the P&R leg twice on this
  host (once with the venv-default klayout 0.30.12, once with the pinned
  0.30.10) produced byte-identical GDS/DEF/netlist artifacts
  (`sha256:32e6dead…` / `82a57e76…` / `188c15b9…` both times).
- **Result**: `status: "ok"`, `stage_reached: "route"`.
  - **Synthesis**: 318 mapped standard cells, 12737.4912 µm² cell area,
    0 Yosys warnings — reproducing the post-#84 synthesis-smoke record
    (`20260922-004226-0446e4b`) figure for figure, now against this
    worktree's own run of the same request (down from 342 cells /
    13953.9 µm² pre-#84: the adapted wrapper's instantiation of the
    vendored canonical modules maps to fewer cells than the deleted
    local copies did).
  - **Implementation**: the routed DEF holds **1121 placed instances** —
    328 logic instances (the 318 mapped cells plus CTS's own clock
    buffers and dummy loads) plus **793 physical-only instances** (705
    `fill_*`, 70 `endcap`, 18 `filltie`) that the power stage inserted.
    Die area 34763.6 µm², core area 31314.5 µm², utilization 43.1996 %
    (42.2623 % at floorplan, before CTS/fill), routed wirelength
    11981 µm.
  - **Power delivery, as applied** (echoed by the response's own `power`
    block, not asserted here): `pdn: true`, `global_connect: true`,
    tapcell master `gf180mcu_fd_sc_mcu9t5v0__filltie`, endcap master
    `gf180mcu_fd_sc_mcu9t5v0__endcap`, filler masters
    `__fill_{64,32,16,8,4,2,1}`; the written DEF carries a
    `SPECIALNETS` section with real wired `VDD`/`VSS` nets
    (18 followpin + ~5123 stripe segments per rail across
    Metal1–Metal5, ~5118 vias per rail).
  - **Timing, at the 12 MHz spec clock**: 0 setup violations, 0 hold
    violations, 0 antenna violations, 0 router DRC violations, 0
    max-transition and 0 max-capacitance violations. At the nominal
    `tt_025C_1v80` corner: worst setup slack 63.1563 ns, worst hold
    slack 2.56852 ns, `fmax` 51.7739 MHz — 4.3× the 12 MHz the spec
    asks for (down from 68.53 MHz pre-#84 with the larger cell count;
    still wide margin). TNS 0, clock skew 0.07406 ns, estimated power
    0.1426 mW.
  - **Multi-corner STA** (15 liberty corners, the 1v8/3v3/5v0 families
    of this cell library, liberty + estimated-RC inside OpenROAD):
    every corner is positive on both setup and hold. Worst setup slack
    **32.9047 ns** (`ss_125C_1v62`), worst hold slack **0.43171 ns**
    (`ff_n40C_5v50`). At the two rails the Chipalooza GF180 brief
    names: `tt_025C_3v30` 75.8961 ns setup / 1.00863 ns hold;
    `tt_025C_5v00` 78.3446 ns setup / 0.68709 ns hold.
  - **Overall: pass.** The requested stage was reached, the layout
    carries real power delivery, and no timing/antenna/router violation
    is reported at any corner.
- **Coverage gaps** (unchanged in kind from the 2026-08-25 record):
  - No IO ring / pad frame — core-only block-level implementation; pad
    assignment is a test-chip integration question.
  - No metal (density) fill; the curated gf180mcu DRC deck does not
    check density, so a clean DRC is not a density-clean claim.
  - Post-layout (extracted-parasitic) simulation is not part of this
    record — see `post-layout-pvt/`'s same-day record, which sweeps the
    extracted SPEF of exactly these artifacts.
- **klt provenance**: `klt 0.5.0+ge8ca621a6961`, `klayout 0.30.10`,
  PDK `gf180mcuD` (open_pdks `c6d73a35f524…`, resolved from
  `PDK_ROOT=~/.volare`), liberty deck `gf180mcu_fd_sc_mcu9t5v0__tt_025C_1v80`
  content_hash `sha256:2482036479c89fbee3754524e3fcdb530aa40aff0fef9e9385e3bc7b7a67d4ef`
  for both legs. OpenROAD engine `26Q3-1260-g06a5a02279`, self-reported.
- **Links**:
  - Design under test: `rtl/usb_utmi_phy.v` (+ four vendored
    `rtl/common/` modules, three local detectors/decoder)
  - Committed layout: `layout/digital/usb_utmi_phy.gds` /
    `usb_utmi_phy.def` / `usb_utmi_phy_routed.v` (this run's outputs)
  - Request files: `flow/request-usb-utmi-phy-synth.json`,
    `flow/request-usb-utmi-phy-par.json`
  - Raw klt JSON envelopes (frozen):
    `artifacts/20260922-042422-9ec2304/place-and-route-output.json`,
    `artifacts/20260922-042422-9ec2304/synthesize-output.json`
  - Mapped netlist + Yosys script snapshots:
    `artifacts/20260922-042422-9ec2304/usb_utmi_phy_synth.v`,
    `artifacts/20260922-042422-9ec2304/synth_usb_utmi_phy.ys`
  - DRC leg against this GDS:
    `verification/records/digital-drc/records/20260922-042422-9ec2304.md`
  - LVS leg against this GDS:
    `verification/records/digital-lvs/records/20260922-042422-9ec2304.md`
  - ERC leg against this GDS:
    `verification/records/digital-erc/records/20260922-042422-9ec2304.md`
  - Post-layout PVT against this routed netlist:
    `verification/records/post-layout-pvt/records/20260922-042422-9ec2304.md`
  - Friction filed: none this run. (A first pass on this host resolved
    the PDK from klt's bare `~/.ciel` search root instead of the
    documented `~/.volare` pin — a caller-side `PDK_ROOT` discipline
    issue, not a klt capability gap, so no klayout-tools issue; recorded
    here so the next runner sets `PDK_ROOT` explicitly.)
- **Timestamp / author**: 2026-09-22T04:24:22Z, loom-builder (issue #87)
- **Supersedes**: `20260922-004226-0446e4c` — the supersede-without-rerun
  documentation record #84 minted when it vendored the sources. That
  record's deferral is discharged by this measurement; its own
  supersession chain (it already retired `20260825-224709-6a83263`, the
  pre-#84 P&R evidence) needs no further action.
