2AMLogic/gf180-usb2-phy/verification/records/analog-layout/records/20260909-215500-29c5780.md

<!-- record-meta
{
  "record_id": "20260909-215500-29c5780",
  "experiment": "analog-layout",
  "supersedes": "20260909-213500-29c5780",
  "git_revision": "29c5780d1df0a16bb1d14c4af0bbc9ff0ad99b43",
  "provenance": {
    "klt_version": "0.4.0+g8bd3f0b09a87",
    "pdk": {
      "name": "gf180mcuD",
      "version": "open_pdks c6d73a35f524070e85faff4a6a9eef49553ebc2b"
    },
    "deck": {
      "name": "gf180mcu",
      "content_hash": "sha256:79e71a1e7d84be3cfc82e4c70afbdf7b743ac1f361fb8e981f57831014d2e8b0"
    },
    "inputs": [
      { "path": "scripts/setup-env.sh", "content_hash": "sha256:ea6bd105372a9cabd2657144434368c76ebafbe47d8c78ded3841227385cecaf" },
      { "path": "scripts/gen_analog_layout.py", "content_hash": "sha256:65b7c20e3f852fabadfd4e69a40d9f9794dc18a32c488b42540af5e973abd5d9" },
      { "path": "layout/analog/plans/differential_receiver.json", "content_hash": "sha256:f04c6d416066179975458c7c253db9f6143b3f0e1a98cb4519692a9e5871de1c" },
      { "path": "layout/analog/plans/dplus_pullup.json", "content_hash": "sha256:0f7dac6b6c74df0a171b57d8c7df20faf943eb9a8be12d9a2fc6d88e8c68fa31" },
      { "path": "layout/analog/plans/se_receiver_dm.json", "content_hash": "sha256:4f8d5b08e4007e851fa1095528b40bb926c4fe44864af8cb886472335b810b36" },
      { "path": "layout/analog/plans/se_receiver_dp.json", "content_hash": "sha256:4d16672ea830a0d695ee62edab0b713046854aedc873f9ba67c57152869cec8b" },
      { "path": "design/dplus_pullup.sch", "content_hash": "sha256:81eaf5101b343bc5773f7d2800ea3dec40f8d7a5388240b8d22fd13a0b7684e6" },
      { "path": "design/netlist/differential_driver.spice", "content_hash": "sha256:bd4b2608c986fd1e305be7b1522e94f578cf36206fe30c13325f48a55f46afa5" },
      { "path": "design/netlist/differential_receiver.spice", "content_hash": "sha256:b8b230603cfc88b05ebe27eb18e476ddbbfa0cfab64c23677b2862ae8c658e0e" },
      { "path": "design/netlist/dplus_pullup.spice", "content_hash": "sha256:9c645ecf0da6d80fb05d85c33d2941cc48bc328a00cd427f0c11bdf980b2cceb" },
      { "path": "design/netlist/se_receiver_dm.spice", "content_hash": "sha256:ebfc91ac1306060dfa0ffce7d91e048b4fc8b50cfebbd5804c3aaf9b58a20554" },
      { "path": "design/netlist/se_receiver_dp.spice", "content_hash": "sha256:1f854210680331a1df73b96b317479cad4af325192fec68b0b61fb1421fac0b3" }
    ]
  }
}
-->

# Record 20260909-215500-29c5780

- **Record ID**: 20260909-215500-29c5780
- **Claim**: `layout/analog/plans/dplus_pullup.json` now carries
  `routing.cross_block_layer_role: "metal2"` (primary `layer_role` stays
  `metal`; `width_um` moves 0.23 → 0.28 µm because it is forced to — see
  below). The field is **reachable and it works**: it eliminates the entire
  same-drawing-layer-short rejection class (**540 → 0** rejected legs),
  raises routed legs **114 → 168** (+47%), moves two nets from `unrouted` to
  `partial`, and stays **DRC-clean with an empty violation list** — now with
  `via1` and `metal2` geometry actually present and actually rule-checked,
  which is the direct refutation of the 284 × `via1.width.1` failure that
  killed this repo's earlier `metal2` probe. It does **not** raise the
  routed-**net** count: `dplus_pullup` is still **6/21**. All 15 remaining
  unrouted nets are named below with the router's own rejection text, and
  every one of them is blocked by an already-open upstream issue
  (klayout-tools#1531 and/or #1467), not by anything this plan controls.
  **No GDS is committed**: the 21/21 gate this issue set for committing one,
  and for running `klt lvs`, was not met.
- **Design provenance**: schematic — `design/*.sch` exported to
  `design/netlist/*.spice` by `design/netlist.py`. **No design source
  changed**: all five block netlists and `design/dplus_pullup.sch` carry
  content hashes byte-identical to the superseded record's, which in turn
  carries them byte-identical back through `20260906-004835-90e442a` to
  `20260905-233520-2eca93d`. `scripts/gen_analog_layout.py` is likewise
  unchanged — its invocation is identical, per this issue's requirement that
  one-command regeneration stay one command. The **only** changed input is
  `layout/analog/plans/dplus_pullup.json`, and the only change inside it is
  the two-line `routing` edit (`width_um` 0.23 → 0.28,
  `cross_block_layer_role: "metal2"` added); device groups, `rows[]`
  order/spacing/align, and `options` are untouched.
- **Run configuration**: `PDK_ROOT=$HOME/.volare .venv/bin/python
  scripts/gen_analog_layout.py --format json` from the same fresh
  `./scripts/setup-env.sh` venv as the superseded record, at the same pin
  (`KLT_REV=8bd3f0b09a87641b093d655a7282b8f730db19e8`, `klt
  0.4.0+g8bd3f0b09a87`), plus a direct `klt drc --deck gf180mcu --format
  json` per executed block for the full violation list. The parameter sweeps
  in item 5 below were run by
  `verification/records/analog-layout/artifacts/20260909-215500-29c5780/dplus_pullup-sweep.py`,
  frozen alongside this record, which drives the same
  `execute_layout_plan_document` entry point the committed driver calls with
  one field changed per variant.
- **Statistical convention**: N/A — deterministic runs against fixed
  netlists and fixed plan documents.
- **Result**: **The capability the README said was unreachable is now
  reachable, is spent, and is measurably working at the leg level — and the
  block still routes 6 of 21 nets.**

  | Metric | Before (superseded record, same pin, no `cross_block_layer_role`) | After (this record) |
  |---|---|---|
  | Routed nets | 6/21 | **6/21 (unchanged)** |
  | Net status | 6 routed, 11 partial, 4 unrouted | 6 routed, **13 partial, 2 unrouted** |
  | Routed legs | 114/1301 | **168/769** |
  | Total routed length | 1317.23 µm | **1427.11 µm** |
  | Rejected legs: self-net same-layer short | **540** | **0** |
  | Rejected legs: crosses already-routed net | 280 | 270 |
  | Rejected legs: plows through own pin's block | 247 | 211 |
  | Rejected legs: crosses unrelated block bbox | 120 | 120 |
  | `klt drc` full violation list | `[]` | **`[]`** |
  | DRC layers actually checked | `21/0 22/0 30/0 33/0 34/0` | **`21/0 22/0 30/0 33/0 34/0 35/0 36/0`** |

  1. **`routing.cross_block_layer_role` is forwarded, not silently dropped —
     the klayout-tools#1502 fix is confirmed from this repo's side.** Under
     the old pin, `layout/README.md` recorded that adding this key "changes
     nothing, with no error and no warning". At the new pin the same key
     changes 540 leg outcomes. The router's own text confirms it is being
     exercised rather than merely accepted: a `NODE2` leg is now rejected
     with *"crosses already-routed net 'NODE1' — **a bounded same-block
     cross-layer detour (4 alternate lanes looped clear of the block's own
     bbox) was tried first**, and each one still conflicted"*. The fallback
     runs; it is downstream contention that defeats it.
  2. **The `via1.width.1` class is gone — and this is a stronger result than
     "the count is zero".** Record `20260905-233520-2eca93d` item 4 measured
     an all-`metal2` plan producing **284 × `via1.width.1`** violations,
     because `gen_compose`'s via-drop square was a hard-coded 0.22 µm against
     a deck minimum of 0.26 µm. Two things had to be checked to call that
     fixed, and both were: (a) `klt drc`'s `coverage.layers_checked` now
     includes `35/0` (via1) and `36/0` (metal2), where the superseded record's
     run stopped at `34/0` (metal1) — so via1 and metal2 geometry is really
     present in the stream and `via1.width.1`, `via1.space.1`,
     `metal1.enclosing.via1.1`, `metal2.enclosing.via1.1`, `metal2.width.1`
     and `metal2.space.1` moved out of `coverage.rules_skipped` into rules
     that actually ran; and (b) with those rules running, the full
     `violations` array is `[]` and `rule_counts` is `{}`. A zero from a rule
     that was skipped for want of geometry would have proved nothing; this is
     a zero from a rule that was applied. klayout-tools#1501 / PR #1507's
     via-drop flooring is confirmed working against this repo's own block.
  3. **The primary plane's routing width was forced wider, and that is a new
     upstream gap, not a design choice.** The first attempt kept
     `width_um: 0.23` (the deck's own `metal1.width.1` minimum, the value
     record `20260906-004835-90e442a` established as correct) and added only
     `cross_block_layer_role`. It fails outright, exit non-zero, no geometry:

     ```
     composition failed: request.routing.width_um (0.23um) is narrower than
     the resolved PDK deck's own minimum width for
     routing.cross_block_layer_role 'metal2' -- 'metal2.width.1' requires
     >= 0.28um
     ```

     `routing` has exactly one width knob
     (`_ALLOWED_ROUTING_KEYS = {"layer_role", "width_um",
     "cross_block_layer_role"}`) and it is validated against the *stricter*
     of the two planes, so enabling the metal2 escape hatch also widens every
     metal1 route in the block from 0.23 to 0.28 µm — including the great
     majority that never touch metal2. 0.28 µm is still ≥ the metal1 minimum
     and the result is DRC-clean, so this is a density cost, not a
     correctness one, and the plan commits 0.28. Filed generically upstream
     as [klayout-tools#1620](https://github.com/2AMLogic/klayout-tools/issues/1620).
     The failure message itself is good and made the constraint findable —
     that is #1501's flooring doing its job, and the record notes it as such.
  4. **Every one of the 15 still-unrouted nets, with the router's own reason.**
     Read from this run's frozen `dplus_pullup-layout-plan.json`
     `nets[].legs[].reason`; counts are rejected legs by class per net.

     | Net | Status | Legs routed | Blocking classes (rejected legs) |
     |---|---|---|---|
     | `DP` | partial | 9/19 | plows-through-own-pin's-block ×10 |
     | `NODE0` | partial | 9/19 | plows-through-own-pin's-block ×10 |
     | `NODE1` | partial | 10/21 | plows-through-own-pin's-block ×11 |
     | `NODE2` | partial | 20/86 | crosses-already-routed-net ×45, plows-through ×21 |
     | `NODE3` | partial | 20/86 | crosses-already-routed-net ×45, plows-through ×21 |
     | `NODE4` | partial | 20/86 | crosses-already-routed-net ×45, plows-through ×21 |
     | `NODE5` | partial | 20/131 | crosses-already-routed-net ×90, plows-through ×21 |
     | `PU_ENB` | partial | 9/30 | crosses-unrelated-block-bbox ×20, plows-through ×1 |
     | `TRIM0B` | partial | 9/30 | crosses-unrelated-block-bbox ×20, plows-through ×1 |
     | `TRIM1B` | partial | 9/30 | crosses-unrelated-block-bbox ×20, plows-through ×1 |
     | `TRIM2B` | partial | 9/30 | crosses-unrelated-block-bbox ×20, plows-through ×1 |
     | `TRIM3B` | partial | 9/30 | crosses-unrelated-block-bbox ×20, plows-through ×1 |
     | `TRIM4B` | partial | 9/30 | crosses-unrelated-block-bbox ×20, plows-through ×1 |
     | `VPU_REG` | unrouted | 0/120 | plows-through-own-pin's-block ×75, crosses-already-routed-net ×45 |
     | `VSS` | unrouted | 0/15 | plows-through-own-pin's-block ×15 |

     Verbatim rejection text, one representative per class:

     - *plows-through-own-pin's-block* (`DP`): "backbone's 0.28um-wide drawn
       path crosses 7.358um through its own pin's block 'r_seg4' -- more than
       that pin's own 0.35um edge margin (including 0.14um for the route's
       own half-width), so the route plows through, or clips the edge of, the
       block's interior (e.g. a same-facing port pair reaching a pin on the
       block's far side, crossing another pin on the way, or a connecting jog
       running close enough alongside the block's own edge that the drawn
       wire's width still overlaps it) rather than approaching the pin
       cleanly"
     - *crosses-already-routed-net* (`NODE2`): "crosses already-routed net
       'NODE1' -- a bounded same-block cross-layer detour (4 alternate lanes
       looped clear of the block's own bbox) was tried first, and each one
       still conflicted"
     - *crosses-unrelated-block-bbox* (`PU_ENB`): "backbone's 0.28um-wide
       drawn path crosses 2.06um through unrelated block 'mn_drv_t0''s bbox
       (including its own edge, within half the route's width) -- the route
       is not point-to-point between only the two connected blocks"

     **Both dominant classes are already-open upstream issues, and neither is
     something this plan can route around.**
     [klayout-tools#1531](https://github.com/2AMLogic/klayout-tools/issues/1531)
     is exactly the plows-through-own-pin's-block wall — a generated array's
     own footprint is treated as one opaque obstacle, so a pin that is not on
     the outermost row relative to the route direction is unreachable for any
     net.
     [klayout-tools#1467](https://github.com/2AMLogic/klayout-tools/issues/1467)
     is exactly the crosses-already-routed-net wall — there is no track or
     layer *allocation* between nets, so whichever net routes first rejects
     the rest. No new issue was filed for either: filing a third description
     of an already-tracked gap is noise, and the friction protocol asks for
     the gap, not for one report per encounter. The two gaps this run *did*
     find fresh are #1620 (item 3) and #1621 (the `differential_driver`
     metal-resistor blocker, reconfirmed in the superseded record).
  5. **Sweeps were re-run only where the new field could have moved the
     answer, and one of them had moved.** Full per-variant results, including
     each variant's complete DRC violation array, are frozen as
     `dplus_pullup-sweep-summary.json`.

     - **`spacing_um` — re-swept, and it no longer discriminates.** Justified
       because the new field changes both the drawn width (0.23 → 0.28 µm)
       and which layers carry geometry, either of which could move a spacing
       cliff. Result: `2.0, 2.5, 3.0, 3.5, 4.0, 5.0` µm **all** give 6/21
       nets, 168/769 legs, and an empty violation list. The
       `metal1.space.1` violation that record `20260905-233520-2eca93d`
       item 6 measured at 2.0 µm is **gone** — there is no longer a cliff
       anywhere in that range. The plan **keeps 3.0 µm**: nothing measured
       argues for moving it, and holding it keeps the diff to the two
       `routing` lines this record is about. Note the honest consequence —
       the superseded justification ("one step above the smallest value that
       clears") no longer applies, because every value clears.
     - **`orientation` — re-swept, and it moved.** Justified for the same
       reason, plus the specific hypothesis that removing the same-layer-short
       class might rescue a far-edge-port orientation. Result, applying the
       orientation to every device group: default/omitted → 6/21, 168 legs,
       0 violations; `mirror_y` → **6/21, 168 legs, 0 violations** (tied with
       the default); `mirror_x` → 5/21, 138 legs, **22 violations**
       (`metal1.space.1` ×12, `comp.enclosing.contact.1` ×5,
       `poly2.enclosing.contact.1` ×2, `poly2.space.1` ×2, `comp.space.1` ×1);
       `rotate_180` → identical to `mirror_x`. The plan **keeps the default**
       (no `orientation` key): it is measured-best, tied with `mirror_y`, and
       an unnecessary key is not worth a tie. **This is not a like-for-like
       contradiction of `20260905-233520-2eca93d` item 5** — that sweep
       applied `mirror_x` to the pfet driver groups only and reported 0/21 for
       `mirror_y`/`rotate_180`; this one applies each value to all 24 groups
       at a different pin. The conclusion ("default is measured-best, not an
       unexamined default") survives; the numbers behind it do not transfer.
     - **The all-`metal2` primary probe — re-run, because #1501 removed its
       stated reason for rejection.** Record `20260905-233520-2eca93d` item 4
       rejected `layer_role: "metal2"` for producing 284 × `via1.width.1`
       with no routing gain. At the new pin, `layer_role: "metal2"` +
       `cross_block_layer_role: "metal3"` is **DRC-clean (0 violations)** at
       both 0.28 and 0.30 µm — the DRC objection is genuinely gone — but it
       routes **fewer** legs (123/1138 vs 168/769) at the same 6/21. The
       rejection therefore **stands on the routing evidence alone**, which is
       a better reason than the one it used to have. `layer_role: "metal"` +
       `cross_block_layer_role: "metal3"` matches the committed metal2
       variant exactly (168/769, 6/21, clean), so the committed choice of
       `metal2` as the cross plane costs nothing versus reaching further up
       the stack.
     - **`width_um` above the forced minimum — probed, no effect.** 0.28,
       0.30 and 0.36 µm all give 6/21, 168/769, 0 violations. The plan commits
       0.28, the smallest legal value under the item-3 constraint.
     - **Not re-swept, deliberately**: the grouping/`rows[]` structure. The new
       field acts per *leg*, on a fallback layer, after grouping and placement
       are already resolved; it cannot change which devices belong in a group.
       Re-running that sweep could not have moved its result, and this issue
       explicitly asked not to re-run sweeps whose answer cannot have moved.
  6. **The three receiver plans and `differential_driver` are unchanged from
     the superseded record, as expected** — 1/8, 1/9, 1/9, all DRC-clean with
     empty violation lists, and the identical `rm1` ingestion failure. Their
     plan documents were not touched (byte-identical content hashes), and
     re-authoring them in `dplus_pullup`'s grouped shape stays out of scope
     here; it is the natural next block of work now that this record shows
     what `cross_block_layer_role` does and does not buy.

  **What this record does and does not claim.** It claims
  `routing.cross_block_layer_role` is reachable from a committed plan
  document at the new pin, that spending it removes an entire rejection class
  and draws 47% more routed legs with no DRC cost, and that the
  `via1.width.1` objection to second-metal routing is measurably retired. It
  does **not** claim `dplus_pullup` is a layout, or that this issue's headline
  goal was met: **15 of 21 nets remain unrouted**, both supplies (`VSS`,
  `VPU_REG`) and every ladder node among them, and a block whose supplies are
  unwired is not a layout under this repo's own rule. Accordingly **no GDS is
  committed under `layout/analog/` and `klt lvs` was not run** — this issue
  gated both on reaching 21/21, and running LVS against a 6/21 layout would
  produce a mismatch report that says nothing anyone did not already know.
  The repo still has no committed analog layout.
- **klt provenance**: `klt` 0.4.0+g8bd3f0b09a87 @ klayout-tools
  `8bd3f0b09a87641b093d655a7282b8f730db19e8` (this repo's pinned `KLT_REV`,
  identical to the superseded record), `klayout` 0.30.12; PDK `gf180mcuD`,
  open_pdks `c6d73a35f524070e85faff4a6a9eef49553ebc2b`; DRC deck `gf180mcu`,
  content hash
  `sha256:79e71a1e7d84be3cfc82e4c70afbdf7b743ac1f361fb8e981f57831014d2e8b0`
  (byte-identical to the superseded record's deck build). klt drove every
  leg of this run — plan execution, DRC, and all 15 sweep variants; nothing
  here is hand-derived.
- **Links**:
  - Driver: `scripts/gen_analog_layout.py` (unchanged — same one command)
  - Plan under test (changed — `routing` block only):
    `layout/analog/plans/dplus_pullup.json`
  - Plans under test (unchanged):
    `layout/analog/plans/{differential_receiver,se_receiver_dm,se_receiver_dp}.json`
  - Designs under test: `design/netlist/*.spice` — none changed
  - Diagnosis + friction: `layout/README.md` § "Analog"
  - Raw artifacts:
    `verification/records/analog-layout/artifacts/20260909-215500-29c5780/`
    — `analog-layout-report.json` (the combined report); one
    `<block>-layout-plan.json`, `<block>.gds` and `<block>-drc-full.json`
    per executed block; plus `dplus_pullup-sweep.py` (the frozen sweep
    driver) and `dplus_pullup-sweep-summary.json` (all 15 variants with
    their full DRC violation arrays).
  - Upstream fixes this record consumes:
    [klayout-tools#1502](https://github.com/2AMLogic/klayout-tools/issues/1502)
    (`routing.cross_block_layer_role` reachable from a plan document) and
    [klayout-tools#1501](https://github.com/2AMLogic/klayout-tools/issues/1501)
    (routing width and via-drop square floored at deck minimums).
  - Upstream gaps blocking the remaining 15 nets (already open, not re-filed):
    [klayout-tools#1531](https://github.com/2AMLogic/klayout-tools/issues/1531),
    [klayout-tools#1467](https://github.com/2AMLogic/klayout-tools/issues/1467).
  - Upstream gaps filed fresh by this issue's run:
    [klayout-tools#1620](https://github.com/2AMLogic/klayout-tools/issues/1620)
    (one `routing.width_um` for two layers) and
    [klayout-tools#1621](https://github.com/2AMLogic/klayout-tools/issues/1621)
    (no metal-resistor device class).
  - Trackers this record advances: gf180-usb2-phy#51 (analog-layout
    acceptance criterion), #53 (analog post-layout PVT, structurally blocked
    on a committed analog GDS — **still blocked**, and this record is the
    evidence of why), #3 (gap-to-T1 items 2/3/4/7).
  - Superseded: `verification/records/analog-layout/records/20260909-213500-29c5780.md`
    — same driver, same `klt` pin, same design sources, same three receiver
    plans. Superseded because `layout/analog/plans/dplus_pullup.json` has
    changed, which is exactly why that record's provenance hash for it is
    now stale. That record remains the correct, unedited account of what the
    pin bump alone changed, and is the reason nothing in this record's gain
    can be misattributed to the pin.
- **Timestamp / author**: 2026-09-09T21:55:00Z, Loom Builder (AI agent),
  issue #68.
- **Supersedes**: 20260909-213500-29c5780 — same five-block claim, same
  driver, same `klt` pin and design sources; `layout/analog/plans/dplus_pullup.json`
  is the one changed input.
