2AMLogic/gf180-usb2-phy/verification/records/analog-layout/records/20260905-190024-525c67c.md

<!-- record-meta
{
  "record_id": "20260905-190024-525c67c",
  "experiment": "analog-layout",
  "supersedes": "20260905-200628-80cb14c",
  "git_revision": "525c67c220ede0937fa1ee94aafc25983460bb69",
  "provenance": {
    "klt_version": "0.3.0+g07b1f04f29f2",
    "pdk": {
      "name": "gf180mcuD",
      "version": "open_pdks c6d73a35f524070e85faff4a6a9eef49553ebc2b"
    },
    "deck": {
      "name": "gf180mcu",
      "content_hash": "sha256:79e71a1e7d84be3cfc82e4c70afbdf7b743ac1f361fb8e981f57831014d2e8b0"
    },
    "inputs": [
      { "path": "scripts/gen_analog_layout.py", "content_hash": "sha256:091cd5cfea5718729c71bff540551b5da5132409cef4ca80d1c466738aa23ddc" },
      { "path": "layout/analog/plans/differential_receiver.json", "content_hash": "sha256:c8eecd85b5a831be834f4cd487f09ac1071f268aebc7125cfd9fe5506ac5c158" },
      { "path": "layout/analog/plans/se_receiver_dm.json", "content_hash": "sha256:27cbbc720040e1ca6ba17aa4d9dc463aeb61e3b8f988a45750e7ae955fbf00ba" },
      { "path": "layout/analog/plans/se_receiver_dp.json", "content_hash": "sha256:00cda22c9f5123f5e95abf6c3302c79b0d2f5ae642c0b6c6b7a28f78db4414b6" },
      { "path": "design/dplus_pullup.sch", "content_hash": "sha256:81eaf5101b343bc5773f7d2800ea3dec40f8d7a5388240b8d22fd13a0b7684e6" },
      { "path": "design/netlist/differential_driver.spice", "content_hash": "sha256:bd4b2608c986fd1e305be7b1522e94f578cf36206fe30c13325f48a55f46afa5" },
      { "path": "design/netlist/differential_receiver.spice", "content_hash": "sha256:b8b230603cfc88b05ebe27eb18e476ddbbfa0cfab64c23677b2862ae8c658e0e" },
      { "path": "design/netlist/dplus_pullup.spice", "content_hash": "sha256:9c645ecf0da6d80fb05d85c33d2941cc48bc328a00cd427f0c11bdf980b2cceb" },
      { "path": "design/netlist/se_receiver_dm.spice", "content_hash": "sha256:ebfc91ac1306060dfa0ffce7d91e048b4fc8b50cfebbd5804c3aaf9b58a20554" },
      { "path": "design/netlist/se_receiver_dp.spice", "content_hash": "sha256:1f854210680331a1df73b96b317479cad4af325192fec68b0b61fb1421fac0b3" }
    ]
  }
}
-->

# Record 20260905-190024-525c67c

- **Record ID**: 20260905-190024-525c67c
- **Claim**: `dplus_pullup`'s `klt` ingestion blocker — the one issue #56's
  operator ruling (2026-09-05, FLATTEN) set out to clear — **is cleared in
  practice**, not merely in principle: with the six `nf=10` pull-up switch
  devices redrawn as one device per drawn gate, `klt`'s subckt-call →
  plain-element netlist conversion now ingests `dplus_pullup`, and the
  `klt layout-plan` executor places it. Everything else about the five-block
  analog-layout measurement is **unchanged from the superseded record**:
  analog layout is *still* not delivered, `differential_driver` is *still*
  un-ingestable for its own unrelated reason, and the three previously
  placeable blocks *still* route zero of their nets. This record's job is to
  isolate one variable — the `dplus_pullup` design source — and report what
  moved and what did not.
- **Design provenance**: schematic — `design/*.sch` exported to
  `design/netlist/*.spice` by `design/netlist.py`. Exactly one input changed
  relative to the superseded record: `design/netlist/dplus_pullup.spice`
  (`sha256:65ab8534…` → `sha256:9c645ecf…`), regenerated from
  `design/dplus_pullup.sch` after the issue #56 flatten. Every other
  `provenance.inputs[]` content hash above — the driver script, all three
  committed plans, and the other four block netlists — is byte-identical to
  the superseded record's. No extracted or post-layout netlist exists for
  these blocks.
- **Run configuration**: same invocation as the superseded record —
  `PDK_ROOT=$HOME/.volare .venv/bin/python scripts/gen_analog_layout.py`,
  plus a direct `klt drc --format json` per executed block to retain full
  violation polygons (the script's aggregated `by_rule` counts do not).
  Two additional, `dplus_pullup`-specific probes were run for this record's
  own claim and are described under **Result**: a direct
  `build_netlist_digest(..., form="subckt-call", deck="gf180mcu")` call (the
  exact ingestion entry point `klt layout-plan` and `klt lvs` share, and the
  one the superseded record recorded failing), and a throwaway two-group
  layout-plan document driven through `execute_layout_plan_document`.

  | | Superseded run | This run |
  |---|---|---|
  | `klt` git revision | `07b1f04f29f21b3f8551d3937183b206a57a5e3a` | `07b1f04f29f21b3f8551d3937183b206a57a5e3a` (identical, the repo's pinned `KLT_REV`) |
  | `klt` reported version | 0.3.0+g07b1f04f29f2 | 0.3.0+g07b1f04f29f2 (identical) |
  | `klayout` | 0.30.11 | 0.30.12 |
  | DRC deck content hash | `sha256:79e71a1e…` | `sha256:79e71a1e…` (identical) |
  | PDK (`gf180mcuD`, open_pdks) | `c6d73a35f5…` | `c6d73a35f5…` (identical) |
  | `design/netlist/dplus_pullup.spice` | `sha256:65ab8534…` (`nf=10`) | `sha256:9c645ecf…` (flattened) |

  **The `klayout` patch bump is demonstrably inert here, and that is
  measured rather than asserted.** All three executed blocks' output GDS
  files are **byte-identical** to the superseded record's committed
  artifacts (`cmp` on `differential_receiver.gds`, `se_receiver_dm.gds`,
  `se_receiver_dp.gds`), and their `layout-plan` JSON responses differ only
  in the absolute `gds_path` string (which contains the worktree directory
  name), with every device group, net, leg, and bbox identical. The DRC
  violation counts are likewise unchanged at 19 / 22 / 22. So the only
  variable that moved anything in this record is the `dplus_pullup` design
  source.
- **Statistical convention**: N/A — deterministic runs against fixed
  netlists and fixed plan documents.
- **Result**: **The `dplus_pullup` ingestion blocker is cleared. The overall
  five-block verdict is unchanged: analog layout is still NOT delivered.**

  | Block | Superseded (`nf=10` netlist) | This run (flattened netlist) |
  |---|---|---|
  | `differential_receiver` | 11 groups, 0/8 nets, 19 × `metal1.width.1` | identical (byte-identical GDS) |
  | `se_receiver_dm` | 13 groups, 0/9 nets, 22 × `metal1.width.1` | identical (byte-identical GDS) |
  | `se_receiver_dp` | 13 groups, 0/9 nets, 22 × `metal1.width.1` | identical (byte-identical GDS) |
  | `differential_driver` | ingestion failed (`rm1` unknown device) | ingestion failed, **identical error text, verbatim** |
  | `dplus_pullup` | **ingestion failed (`nf=10`)** | **ingestion SUCCEEDS** — `scripts/gen_analog_layout.py` reports `status: ingest-unexpectedly-succeeded` |

  1. **`klt` now ingests `dplus_pullup`.** The direct probe returns a
     complete netlist digest: circuit `DPLUS_PULLUP`, **78 devices** (66
     `PFET`, 6 `NFET`, 6 `PPOLYF_U`) across **21 nets**, with every device's
     `W`/`L` resolved — the sixty flattened switch fingers each land as
     `W=100.0`, `L=0.28`. The full digest is this record's
     `dplus_pullup-netlist-digest.json` artifact. The superseded record's
     error at this exact call — "which klt's subckt-call → plain-element
     conversion refuses to represent" — no longer occurs. `scripts/
     gen_analog_layout.py` reaches the same conclusion through its own
     `_probe_blocked()` path and reports it in its own words: "klt now
     ingests this netlist -- the blocker this entry records is gone; author
     a plan under layout/analog/plans/ and drop this block from
     BLOCKED_BLOCKS".
  2. **The `klt layout-plan` executor places the flattened block.** Because
     no committed plan exists for `dplus_pullup` (authoring one is real
     per-block layout design work, deliberately out of this issue's scope —
     see "Not in scope" below), a **throwaway two-group probe plan** was
     driven through `execute_layout_plan_document` purely to prove the
     ingestion path is clear end to end rather than only at the digest
     stage. It is committed under `artifacts/` as evidence, **not** under
     `layout/analog/plans/`, because it is not a design. Result: both groups
     place — the six-resistor ladder at 76.12 × 4.00 µm and the ten
     flattened `MEN` fingers as a `mos_array` at 15.10 × 101.12 µm (ten
     100 µm-wide fingers, as drawn) — for an overall 93.22 × 101.12 µm
     bbox, and **1 of 8 nets routes**. The seven unrouted nets and the 38
     `metal1.width.1` violations in the probe GDS are the *same* router and
     rejected-leg-geometry limitations the superseded record already
     characterised for the three placeable blocks (upstream:
     [klayout-tools#1424](https://github.com/2AMLogic/klayout-tools/issues/1424));
     they are a plan-authoring and router problem, categorically not the
     ingestion blocker this record is about. The probe also emits five
     `length_um` disagreement warnings, which are an artifact of the probe
     lumping six different-length ladder resistors into one `res_array` —
     a defect of the throwaway probe, not of the design or of `klt`.
  3. **Nothing else moved.** `differential_driver`'s `rm1` (2-terminal metal
     resistor) blocker is byte-for-byte unchanged, as expected: the
     `device_map` capability that landed upstream is documented as
     MOS-shaped-only. The three placeable blocks are byte-identical, per the
     GDS comparison above. The aggregate verdict line the driver prints is
     unchanged: `analog layout NOT delivered`.

  **What this record does and does not claim.** It claims that the design
  source change ruled in issue #56 achieved the thing it was ruled in to
  achieve — `dplus_pullup` is no longer un-ingestable, and is for the first
  time placeable. It does **not** claim `dplus_pullup` has a layout: it does
  not have one, it has no committed plan, and a probe that routes 1 of 8
  nets is not a layout. It also does not claim the flatten was electrically
  free — that question is answered separately and by measurement in
  `sim/dplus-pullup-tolerance/records/20260905-185112-6bfe679.md` (45/45 PVT
  corners PASS, identical trim code at every corner, ≤ 0.01 Ω deviation
  against the superseded `nf=10` result).

  **Not in scope (stated so a later reader does not mistake it for an
  oversight).** Authoring a real `layout/analog/plans/dplus_pullup.json` and
  dropping the block from `scripts/gen_analog_layout.py`'s `BLOCKED_BLOCKS`
  is the natural next step and is deliberately not done here: issue #56's
  acceptance criteria ask whether flattening clears the ingestion blocker,
  and the superseded record already established that authoring plans which
  exercise `klt`'s orientation / `metal2` routing-role capabilities is
  per-block design work rather than a mechanical re-run. Tracked as a
  follow-up issue rather than folded in.
- **klt provenance**: `klt` 0.3.0+g07b1f04f29f2 @ klayout-tools
  `07b1f04f29f21b3f8551d3937183b206a57a5e3a` (the revision pinned by
  `scripts/setup-env.sh`'s `KLT_REV`, provisioned into this worktree's
  `.venv` by that script for this run), `klayout` 0.30.12; PDK `gf180mcuD`,
  open_pdks `c6d73a35f524070e85faff4a6a9eef49553ebc2b`; DRC deck `gf180mcu`,
  content hash
  `sha256:79e71a1e7d84be3cfc82e4c70afbdf7b743ac1f361fb8e981f57831014d2e8b0`
  (byte-identical to the superseded record's deck build). klt drove every
  leg of this run — plan execution, DRC, both ingestion probes, and the
  probe plan's placement; nothing here is hand-derived.
- **Links**:
  - Driver: `scripts/gen_analog_layout.py` (unchanged)
  - Plans under test: `layout/analog/plans/{differential_receiver,se_receiver_dm,se_receiver_dp}.json` (unchanged)
  - Designs under test: `design/netlist/*.spice` — only `dplus_pullup.spice` changed
  - Decision record for the design-source change: `spec/usb2-device-phy.md` §12
  - Electrical-equivalence evidence for the same change:
    `sim/dplus-pullup-tolerance/records/20260905-185112-6bfe679.md`
  - Diagnosis + friction: `layout/README.md` § "Analog"
  - Raw artifacts: `verification/records/analog-layout/artifacts/20260905-190024-525c67c/`
    — `analog-layout-report.json` (the combined report); one
    `<block>-layout-plan.json`, `<block>.gds` and `<block>-drc-full.json`
    per executed block; and, for this record's own claim,
    `dplus_pullup-netlist-digest.json` (the ingestion that used to fail),
    `dplus_pullup-probe-plan.json` / `dplus_pullup-probe-layout-plan.json` /
    `dplus_pullup_probe.gds` / `dplus_pullup_probe-drc-full.json` (the
    throwaway placement probe — evidence, not a design).
  - Upstream tool gap this record's design-source change works around:
    [klayout-tools#1487](https://github.com/2AMLogic/klayout-tools/issues/1487)
    (native `nf` expansion, or an explicit conversion mode). No **new**
    friction issue is filed from this run: every limitation observed here
    is already filed (#1424 for the rejected-leg geometry, #1487 for `nf`),
    and the `rm1` gap is already characterised in the superseded record.
  - Superseded: `verification/records/analog-layout/records/20260905-200628-80cb14c.md`
    — same claim, same driver, same plans, same `klt` pin; the only design
    input changed is `design/netlist/dplus_pullup.spice`. That record
    remains the correct, unedited account of what the `nf=10` netlist
    produced and is not deleted. (This record was originally authored
    against `20260826-003645-4644a26`, the only predecessor that existed
    on this issue's branch at the time; `80cb14c` — minted independently on
    `main` roughly an hour later by issue #61's own re-confirmation of
    klayout-tools#1424, against byte-identical inputs to `4644a26` — landed
    on `main` first, so merging this branch onto it repoints the
    supersession chain to `80cb14c` rather than leaving two live records
    with the same stale `dplus_pullup.spice` hash. `4644a26` remains
    correctly superseded, now two hops back instead of one.)
- **Timestamp / author**: 2026-09-05T19:00:24Z, Loom Builder (AI agent),
  issue #56.
- **Supersedes**: 20260905-200628-80cb14c — same five-block claim, same
  driver/plans/`klt` pin; `design/netlist/dplus_pullup.spice` is the single
  changed input, which is exactly why that record's provenance hash for it
  is now stale and this record exists. (Repointed from the originally
  authored `20260826-003645-4644a26` during merge conflict resolution — see
  the "Superseded" bullet above.)
