2AMLogic/gf180-usb2-phy/verification/records/analog-layout/records/20260826-003645-4644a26.md

<!-- record-meta
{
  "record_id": "20260826-003645-4644a26",
  "experiment": "analog-layout",
  "supersedes": "20260818-113513-89520ac",
  "git_revision": "4644a2666b927f9ea163a37f9bd8d4607c544d88",
  "provenance": {
    "klt_version": "0.3.0+g07b1f04f29f2",
    "pdk": {
      "name": "gf180mcuD",
      "version": "open_pdks c6d73a35f524070e85faff4a6a9eef49553ebc2b"
    },
    "deck": {
      "name": "gf180mcu",
      "content_hash": "sha256:79e71a1e7d84be3cfc82e4c70afbdf7b743ac1f361fb8e981f57831014d2e8b0"
    },
    "inputs": [
      { "path": "scripts/gen_analog_layout.py", "content_hash": "sha256:091cd5cfea5718729c71bff540551b5da5132409cef4ca80d1c466738aa23ddc" },
      { "path": "layout/analog/plans/differential_receiver.json", "content_hash": "sha256:c8eecd85b5a831be834f4cd487f09ac1071f268aebc7125cfd9fe5506ac5c158" },
      { "path": "layout/analog/plans/se_receiver_dm.json", "content_hash": "sha256:27cbbc720040e1ca6ba17aa4d9dc463aeb61e3b8f988a45750e7ae955fbf00ba" },
      { "path": "layout/analog/plans/se_receiver_dp.json", "content_hash": "sha256:00cda22c9f5123f5e95abf6c3302c79b0d2f5ae642c0b6c6b7a28f78db4414b6" },
      { "path": "design/netlist/differential_driver.spice", "content_hash": "sha256:bd4b2608c986fd1e305be7b1522e94f578cf36206fe30c13325f48a55f46afa5" },
      { "path": "design/netlist/differential_receiver.spice", "content_hash": "sha256:b8b230603cfc88b05ebe27eb18e476ddbbfa0cfab64c23677b2862ae8c658e0e" },
      { "path": "design/netlist/dplus_pullup.spice", "content_hash": "sha256:65ab85343c98631c749ebadee4be61df75f3f91133bf0c295a9d4b434d07a598" },
      { "path": "design/netlist/se_receiver_dm.spice", "content_hash": "sha256:ebfc91ac1306060dfa0ffce7d91e048b4fc8b50cfebbd5804c3aaf9b58a20554" },
      { "path": "design/netlist/se_receiver_dp.spice", "content_hash": "sha256:1f854210680331a1df73b96b317479cad4af325192fec68b0b61fb1421fac0b3" }
    ]
  }
}
-->

# Record 20260826-003645-4644a26

- **Record ID**: 20260826-003645-4644a26
- **Claim**: re-running the identical five-block measurement from
  `20260818-113513-89520ac` (issue #52, split from #51/Epic #542 Phase 3A)
  against a `klt` pin advanced past the three friction fixes that record
  itself filed (klayout-tools#1163, #1164, #1165 — all closed 2026-08-18,
  hours after that record was minted) still finds **analog layout not
  delivered**, for a different and more specific set of reasons than before.
  The two ingestion blockers are byte-for-byte unchanged. The three
  placeable blocks still route **zero** of their nets, but for that result to
  mean the same thing as before, this record also has to report a new,
  independently-confirmed regression: what `klt drc` reported as clean
  placement-only output in the superseded record is **not** clean under the
  new pin, because failed-to-route leg geometry is now drawn into the GDS
  and violates `metal1.width.1`. No design source, plan, or script changed
  between the two records — every `provenance.inputs[]` content hash above
  is identical to the superseded record's. This is a controlled
  re-measurement of the tool alone.
- **Design provenance**: schematic — `design/*.sch` exported to
  `design/netlist/*.spice` by `design/netlist.py`, unchanged since
  `89520acb0efc824b3bca87e537c4624f67a7ba2a` (confirmed by identical content
  hashes above). No extracted or post-layout netlist exists for these
  blocks.
- **Run configuration**: identical invocation to the superseded record —
  `PDK_ROOT=$HOME/.volare python3 scripts/gen_analog_layout.py --format
  json`, plus a direct `klt drc --format json` re-run per executed block to
  capture full violation polygons (not retained by the script's own
  aggregated `by_rule` counts) as this record's own artifacts. The only
  thing that changed relative to the superseded run is `klt` itself:

  | | Superseded run | This run |
  |---|---|---|
  | `klt` git revision | `b3e284fff4243cdc5ab59a684d9c0582444b485d` | `07b1f04f29f21b3f8551d3937183b206a57a5e3a` |
  | `klt` reported version | 0.2.0 | 0.3.0+g07b1f04f29f2 |
  | `klayout` | 0.30.10 | 0.30.11 |
  | DRC deck content hash | `sha256:79e71a1e...` | `sha256:79e71a1e...` (identical) |
  | PDK (`gf180mcuD`, open_pdks) | `c6d73a35f5...` | `c6d73a35f5...` (identical) |

  **Why the pin moved.** `scripts/setup-env.sh`'s `KLT_REV` had not changed
  since it was set for issue #25/#49 — still `b3e284f` going into this
  issue. That commit was authored 2026-08-18T08:48:51Z. The three friction
  issues this repo filed from the superseded record's own exercise
  (klayout-tools#1163, #1164, #1165) all closed `COMPLETED` between
  2026-08-18T12:19Z and 14:33Z **that same day** — every one of their
  fix-landing PRs (#1171 for #1163; #1166/#1167/#1168/#1169/#1170, #1164's
  decomposed children, via PRs #1174/#1176/etc.; the commit closing #1165)
  is confirmed (`gh api .../compare/<fix-commit>...main`) to be a strict
  ancestor of `b3e284f`'s successor commits, never a predecessor —
  `b3e284f` is 87 commits *behind* the upstream `v0.3.0` tag. So the pin
  this repo carried into this issue predates every fix by hours; re-running
  against it unchanged would have re-measured nothing. `KLT_REV` was moved
  to `07b1f04f29f21b3f8551d3937183b206a57a5e3a` — `klayout-tools`'s `main`
  tip as of this run (2026-08-26T00:25:45Z) — specifically to consume all
  three, per the same "move forward to consume a named capability" pattern
  `docs/environment-setup.md` already documents for the `b3e284f` move
  itself. `scripts/setup-env.sh` and `docs/environment-setup.md`'s pinned-
  version table are updated in the same change as this record. This is a
  tooling/environment pin, not a design-source change, and needed no
  spec/ decision.
- **Statistical convention**: N/A — deterministic runs against fixed
  netlists and fixed plan documents, identical in every respect to the
  superseded record except the pinned `klt` revision.
- **Result**: **FAIL against the claim, still** — no analog layout is
  produced. Per-block outcome, compared against the superseded record:

  | Block | Superseded (`klt` 0.2.0 @ `b3e284f`) | This run (`klt` 0.3.0 @ `07b1f04`) |
  |---|---|---|
  | `differential_receiver` | 11 groups, **0/8** nets, DRC clean (0 violations) | 11 groups, **0/8** nets (unchanged), DRC **violations** (19 × `metal1.width.1`) |
  | `se_receiver_dm` | 13 groups, **0/9** nets, DRC clean | 13 groups, **0/9** nets (unchanged), DRC violations (22 × `metal1.width.1`) |
  | `se_receiver_dp` | 13 groups, **0/9** nets, DRC clean | 13 groups, **0/9** nets (unchanged), DRC violations (22 × `metal1.width.1`) |
  | `differential_driver` | ingestion failed (`rm1` unknown device) | ingestion failed, **identical error text, verbatim** |
  | `dplus_pullup` | ingestion failed (`nf=10`) | ingestion failed, **identical error text, verbatim** |

  **What genuinely changed upstream, verified against the new pin's own
  docs (`docs/cli/layout-plan.md`, `docs/cli/gen-compose.md` at
  `07b1f04`), not assumed:**

  1. **#1163 (device_map threading) landed, but doesn't reach this
     blocker.** `netlist.device_map` is now a real field on
     `klt.layout_plan.request/1` (`layout-plan.md:146`), "same shape and
     same ingestion path as `klt lvs`'s `reference.device_map`" — but the
     same doc line states its shipped limitation plainly: "every entry is
     resolved as a MOS-shaped (4-terminal) override, so mapping a non-MOS
     (e.g. 2-terminal resistor/capacitor) subcircuit raises a clear
     `device_map only supports MOS-shaped 4-terminal overrides today`
     error." `differential_driver`'s blocking device (`rm1`) is a
     2-terminal metal resistor, exactly the case the fix explicitly did not
     cover — so re-probing it (this run did, live, the same way the
     superseded record did) reproduces the identical error text.
  2. **#1166 (block orientation, mirror/rotate)** and the two-layer
     `routing.layer_role: "metal2"` via-drop routing role (closing the
     `#1168`/"issue #454" gap the superseded record's root-cause class 3
     named) are both real and documented (`gen-compose.md`'s "Block
     orientation" and "Via-drop routing" sections). **Neither is used by
     the committed plans under `layout/analog/plans/`**, because those
     plans predate both fields — every `device_groups[]` entry still has no
     `orientation` key, and no plan sets `routing.layer_role` to anything
     but the implicit single base layer. These are opt-in fields; landing
     upstream does not retroactively change what an unmodified plan asks
     for, which is exactly why the routed-net count is unchanged at 0/8,
     0/9, 0/9. Authoring plans that actually exercise them (per-group
     mirroring to fix the same-facing CMOS-inverter case; a `metal2`
     `VDD`/`VSS`/bias bus) is real per-block layout design work outside a
     mechanical re-run, and — per this issue's explicit "not in scope"
     section — this record does not attempt to grow that into a
     block-specific generator; it states plainly that the capability exists
     and is unused.
  3. **The router's diagnostic behaviour changed in a way that produces a
     new, independently-confirmed regression.** `gen-compose.md`
     (`nets[].legs[]`, "Since #1169, a net that could not be *fully*
     connected still draws every leg the spanning-tree search accepted")
     documents that a partially-routable net now keeps its successfully
     drawn legs. What this run's raw `nets[]` payloads
     (`differential_receiver-layout-plan.json` etc., in this record's
     `artifacts/`) show going further than that: legs whose own `reason`
     field reports a *rejected* candidate route (`routed: false`, e.g.
     `"backbone's 0.17um-wide drawn path crosses 1.29um through unrelated
     block 'mn_n_ina''s bbox"`) still leave measurable geometry in the
     output GDS. Every one of the 19/22/22 new `klt drc` violations (rule
     `metal1.width.1`, re-run separately from the script's own aggregate
     count so the full polygons are in this record's artifacts) is a
     4-vertex quadrilateral whose two long edges are exactly 0.17 µm apart
     — the backbone width the router itself quotes in its own rejection
     text — with the *opposite* short edge cut on a diagonal down to a
     single point, i.e. a mitered dead-end rather than a squared-off stub.
     A route that tapers to zero width at its unterminated end cannot
     satisfy any positive minimum-width rule by construction. This is
     new: the superseded record's three placeable blocks were DRC-clean
     specifically *because* an unrouted leg left no geometry at all before
     this change. Filed generically upstream — see "Friction filed" below.
  4. **`dplus_pullup`'s `nf=10` blocker is completely unmoved.** No
     upstream issue in this exercise targeted it; the error text is
     byte-identical to the superseded record. It still needs the decision
     this issue's own acceptance criteria reserve for a spec/ decision
     record, not a builder-unilateral schematic edit — see
     `layout/README.md` § "Analog" and the follow-up filed for it.

  The DRC result in this run is *not* evidence of a good layout for the
  same reason the superseded record's clean result wasn't: these are
  blocks with none of their real connectivity routed. It is reported in
  full because the *change* in DRC status between the two records is
  itself load-bearing evidence about what the new `klt` pin actually does,
  not a claim about layout quality.
- **klt provenance**: `klt` 0.3.0+g07b1f04f29f2 @ klayout-tools
  `07b1f04f29f21b3f8551d3937183b206a57a5e3a`, `klayout` 0.30.11; PDK
  `gf180mcuD`, open_pdks `c6d73a35f524070e85faff4a6a9eef49553ebc2b`
  (unchanged from the superseded record); DRC deck `gf180mcu`, content hash
  `sha256:79e71a1e7d84be3cfc82e4c70afbdf7b743ac1f361fb8e981f57831014d2e8b0`
  (byte-identical to the superseded record's deck build — this run isolates
  the `klt` revision as the only variable). klt drove every leg of this run
  (plan execution, DRC, and the two live ingestion re-probes); nothing here
  is hand-derived.
- **Links**:
  - Driver: `scripts/gen_analog_layout.py` (unchanged)
  - Plans under test: `layout/analog/plans/{differential_receiver,se_receiver_dm,se_receiver_dp}.json` (unchanged)
  - Designs under test: `design/netlist/*.spice` (all five blocks, unchanged)
  - Diagnosis + friction: `layout/README.md` § "Analog"
  - Raw artifacts: `verification/records/analog-layout/artifacts/20260826-003645-4644a26/`
    — `analog-layout-report.json` (the combined report), one
    `<block>-layout-plan.json` per executed block (the full Phase C
    response), one `<block>.gds` per executed block, and one
    `<block>-drc-full.json` per executed block (the full `klt drc`
    response including every violation's polygon — the evidence for the
    mitered-stub finding above, which the script's own aggregated
    `by_rule` counts don't retain).
  - Friction filed (new, this record):
    [klayout-tools#1424](https://github.com/2AMLogic/klayout-tools/issues/1424)
    — the mitered-dead-end/DRC-violating rejected-leg geometry finding
    above, filed generically (no design content).
  - Superseded: `verification/records/analog-layout/records/20260818-113513-89520ac.md`
    — same claim, same driver, same plans, same designs; the only
    variable changed is the pinned `klt` revision, per the table above.
    That record remains the correct account of what the pre-fix `klt`
    revision produced (0.2.0 @ `b3e284f`, DRC-clean placement, identical
    ingestion failures) and is not deleted.
- **Timestamp / author**: 2026-08-26T00:36:45Z, Loom Builder (AI agent),
  issue #52.
- **Supersedes**: 20260818-113513-89520ac — same claim (analog layout not
  delivered), same driver/plans/designs (identical content hashes), a newer
  `klt` pin as the sole variable. Superseded record remains the correct,
  unedited account of the pre-fix tool's behavior.
