2AMLogic/gf180-usb2-phy/verification/records/digital-drc/records/20260825-224815-6a83263.md

<!-- record-meta
{
  "record_id": "20260825-224815-6a83263",
  "experiment": "digital-drc",
  "supersedes": "20260817-202448-0956748",
  "git_revision": "6a83263d5f7b35b9e4e092e2ec92934dcc50a4d4",
  "provenance": {
    "klt_version": "0.3.0",
    "pdk": null,
    "deck": {
      "name": "gf180mcu",
      "content_hash": "sha256:79e71a1e7d84be3cfc82e4c70afbdf7b743ac1f361fb8e981f57831014d2e8b0"
    },
    "inputs": [
      { "path": "layout/digital/usb_utmi_phy.gds", "content_hash": "sha256:341ccb21884ef3808e3483b540f7c68f0caec29f6f8eadb1e63bbf85f1df7476" }
    ]
  }
}
-->

# Record 20260825-224815-6a83263

- **Record ID**: 20260825-224815-6a83263
- **Claim**: `klt drc --deck gf180mcu` against
  `layout/digital/usb_utmi_phy.gds` — the routed digital PHY GDS produced
  by `verification/records/place-and-route/records/20260825-224709-6a83263.md`
  (the power-delivery-bearing re-run) — is **clean**. This closes the T1
  checklist's DRC-clean signoff item for the digital half of the block, and
  supersedes the honest non-clean result recorded against the previous,
  PDN-less layout.
- **Design provenance**: layout (post-P&R, not extracted — a direct DRC
  check of the merged GDS, not an extract-then-compare step).
- **Run configuration**: `PDK=gf180mcuD klt drc
  layout/digital/usb_utmi_phy.gds --deck gf180mcu --top usb_utmi_phy
  --format json`, `klt` 0.3.0, curated engine (`--engine curated`,
  default) — the same command, deck and engine the superseded record ran.
  Nothing about *how* the check is run changed; only the layout under it
  did.
- **Statistical convention**: N/A — a single deterministic check against a
  fixed layout.
- **Result**:
  - `status: "clean"`, `violation_count: 0`, `rule_counts: {}`.
  - **What changed, and why this is a real fix rather than a looser
    check.** The superseded record reported 153 violations —
    `metal1.space.1` × 141 and `metal1.width.1` × 12 — every one of them on
    `Metal1` at a standard-cell row gap, root-caused there to
    `klt place-and-route`'s v1 scope having no filler-cell / power-rail
    stitching stage, so each cell's own power-rail edge sat exposed across a
    real inter-cell gap. `klt` 0.3.0 ships the optional `request.power`
    block, which runs `tapcell` + `pdngen` at the floorplan stage and
    `filler_placement` after routing. Enabling it inserted 763 `fill_*`,
    72 `endcap` and 19 `filltie` instances (see the P&R record), which is
    exactly what bridges those gaps into one continuous rail. **Deck
    identity between the two runs is not claimed — the deck build
    differs.** The superseded record ran deck build
    `sha256:e2726af899d1837fe8c9a99688483f145b23c92ded07323f54d627d06bdb2bbf`
    under `klt` 0.2.0; this run ran deck build
    `sha256:79e71a1e7d84be3cfc82e4c70afbdf7b743ac1f361fb8e981f57831014d2e8b0`
    under `klt` 0.3.0. But no rule was waived, disabled or reparameterized
    by this repo in either run: both are the shipped curated `gf180mcu`
    deck at its default settings.
  - **Overall: clean — the DRC-clean digital signoff claim is now
    substantiated.**
- **Scope of the claim** (what a clean result here does *not* say):
  - The curated `gf180mcu` deck is klt's own curated rule set, not the
    foundry's full sign-off deck. Density/metal-fill rules in particular are
    not in it, and no metal fill was inserted — so this is not a
    density-clean claim.
  - It says nothing about the analog blocks: no analog GDS is committed
    (`layout/README.md` § "Analog").
  - It says nothing about electrical correctness. That is the LVS leg
    (`verification/records/digital-lvs/`) and the functional testbenches.
- **klt provenance**: `klt` 0.3.0, `klayout` 0.30.11. DRC deck `gf180mcu`,
  content_hash `sha256:79e71a1e7d84be3cfc82e4c70afbdf7b743ac1f361fb8e981f57831014d2e8b0`,
  `released: true`. `pdk`: `null` — the curated DRC engine has no PDK-install
  dependency (the deck is a klt-shipped Python module, not a resolved PDK
  asset). Layout input content_hash
  `sha256:341ccb21884ef3808e3483b540f7c68f0caec29f6f8eadb1e63bbf85f1df7476`.
- **Links**:
  - Layout under test: `layout/digital/usb_utmi_phy.gds`
  - Raw klt JSON envelope (frozen):
    `artifacts/20260825-224815-6a83263/drc-report.json`
  - Place-and-route leg that produced this GDS:
    `verification/records/place-and-route/records/20260825-224709-6a83263.md`
  - Superseded (non-clean) result and its root-cause chain:
    `verification/records/digital-drc/records/20260817-202448-0956748.md`
  - Friction filed: none — the tool gap the superseded record named is
    closed upstream and consumed here.
- **Timestamp / author**: 2026-08-25T22:48:15Z, loom-builder (issue #51)
- **Supersedes**: 20260817-202448-0956748 — same claim, same command,
  against a layout that now has power delivery. The superseded record
  remains the correct account of what a PDN-less `klt place-and-route`
  result looks like under this deck.
