2AMLogic/gf180-usb2-phy/verification/records/place-and-route/records/20260825-224709-6a83263.md

<!-- record-meta
{
  "record_id": "20260825-224709-6a83263",
  "experiment": "place-and-route",
  "supersedes": "20260817-202448-0956748",
  "git_revision": "6a83263d5f7b35b9e4e092e2ec92934dcc50a4d4",
  "provenance": {
    "klt_version": "0.3.0",
    "pdk": {
      "name": "gf180mcuD",
      "version": "open_pdks c6d73a35f524070e85faff4a6a9eef49553ebc2b"
    },
    "deck": {
      "synthesize": {
        "name": "gf180mcu_fd_sc_mcu9t5v0__tt_025C_1v80",
        "content_hash": "sha256:2482036479c89fbee3754524e3fcdb530aa40aff0fef9e9385e3bc7b7a67d4ef"
      },
      "place_and_route": {
        "name": "gf180mcu_fd_sc_mcu9t5v0__tt_025C_1v80",
        "content_hash": "sha256:2482036479c89fbee3754524e3fcdb530aa40aff0fef9e9385e3bc7b7a67d4ef"
      }
    },
    "inputs": [
      { "path": "rtl/usb_nrzi_encoder.v", "content_hash": "sha256:3f177079cc4112d34d9c9e5864b406481a6735a3ab7a840ccd28f991fc80f5d7" },
      { "path": "rtl/usb_nrzi_decoder.v", "content_hash": "sha256:ac31765a4389a8502526843cdca2edffd6be8b7f4bb4f2fcb3061b5ae85c384b" },
      { "path": "rtl/usb_bit_stuffer.v", "content_hash": "sha256:1f53016e105414fed26e560a64e7d0db7995d32238c3ac3d5070a0c5bf6c8543" },
      { "path": "rtl/usb_bit_destuffer.v", "content_hash": "sha256:2c16654e2f699f6b8692da99563da50bf186f41c89a107c6e2fa8b27f6c6d760" },
      { "path": "rtl/usb_sync_detector.v", "content_hash": "sha256:1f69da425fec809895fbdeb61e1d308379ddabc9aa0ecb10bf2f88f8fa88cbdc" },
      { "path": "rtl/usb_eop_detector.v", "content_hash": "sha256:163b950b3dcf939a2810f03b63dbea6f361f3261d47a75ea980cdf60d67e8e28" },
      { "path": "rtl/usb_line_state_decode.v", "content_hash": "sha256:c2d93d43d48ddaa2b620c3c0f11b06af74e89860fa3883f7b543955b46aa0d08" },
      { "path": "rtl/usb_utmi_phy.v", "content_hash": "sha256:9f0a9c95056934a0a8a7e357ae0b8c44b0e5b6704e94e6b433c478e4ecfb870b" },
      { "path": "flow/request-usb-utmi-phy-synth.json", "content_hash": "sha256:a7d8d2dc02eb81d896811ce814ea92b3a4f3a430fb6c7d9a320cc5ba48bb9a17" },
      { "path": "flow/request-usb-utmi-phy-par.json", "content_hash": "sha256:5e267e8645ade958cadc62e93ab523278d0f84c8ef9e8f1a123e1442036e27e2" },
      { "path": "layout/digital/usb_utmi_phy.gds", "content_hash": "sha256:341ccb21884ef3808e3483b540f7c68f0caec29f6f8eadb1e63bbf85f1df7476" },
      { "path": "layout/digital/usb_utmi_phy.def", "content_hash": "sha256:e0ebd85ef631bdc7acc45a232e618c2b7cb760a1cae682ad9e3527f3652134eb" },
      { "path": "layout/digital/usb_utmi_phy_routed.v", "content_hash": "sha256:c1e0e8ed6e887ed1e45d1371a69e23f23fd3d5344dc73e9c2e963b3d15e6fc87" }
    ]
  }
}
-->

# Record 20260825-224709-6a83263

- **Record ID**: 20260825-224709-6a83263
- **Claim**: the same claim as the record this supersedes — the real PHY
  digital logic (`rtl/usb_utmi_phy.v` and every submodule it instantiates)
  synthesizes and place-and-routes to a committed, routed GDS via
  `klt synthesize` + `klt place-and-route` (OpenROAD) — **re-run with a
  power-delivery stage**, which is what changes the answer. The prior
  record's layout had no PDN, no tapcells and no filler cells, and was
  therefore not DRC-clean; this one adds `request.power` to
  `flow/request-usb-utmi-phy-par.json` and the resulting layout is both
  DRC-clean and LVS-matched (recorded separately in
  `verification/records/digital-drc/` and
  `verification/records/digital-lvs/` — this record does not restate those
  verdicts, it produces the artifact they check).
- **Design provenance**: netlist (post-synthesis) → layout (post-P&R,
  merged DEF+GDS, not extracted) — `rtl/usb_utmi_phy.v` and its seven
  submodules @ `6a83263d5f7b35b9e4e092e2ec92934dcc50a4d4`. The RTL is
  byte-identical to the superseded record's (same eight `content_hash`
  values); the only changed input is the P&R request file.
- **Run configuration**:
  ```
  PDK=gf180mcuD klt synthesize        flow/request-usb-utmi-phy-synth.json --format json
  PDK=gf180mcuD klt place-and-route   flow/request-usb-utmi-phy-par.json   --format json
  ```
  `klt` 0.3.0, OpenROAD 26Q3-1260-g06a5a02279 (the pinned `openroad/orfs`
  image, via `scripts/openroad-docker.sh`), Yosys via `klt synthesize`,
  cell library `gf180mcu_fd_sc_mcu9t5v0` @ `tt_025C_1v80`, `seed: 1`,
  `target_stage: route`, floorplan `utilization` 40 % / aspect 1.0 /
  `core_margin_um` 4.0 / site `GF018hv5v_green_sc9`, IO layers
  `Metal3`(h)/`Metal2`(v), clock `clk` @ 83.333 ns (12 MHz, spec §3).
  **New in this record — `request.power`**: `power_net` `VDD`,
  `ground_net` `VSS`, and a three-strap standard-cell PDN whose geometry is
  transcribed from OpenROAD-flow-scripts' own gf180 platform config
  (`flow/platforms/gf180/openROAD/pdn/pdn_grid_strategy_9t_6M.cfg`, read out
  of the pinned image rather than guessed): `Metal1` 0.900 µm followpins at
  5.040 µm pitch, `Metal4` 4.480 µm / 0.56 µm spacing at 44.8 µm pitch /
  22.4 µm offset, `Metal5` 4.480 µm at 89.6 µm pitch / 44.8 µm offset, with
  the `Metal1`→`Metal4` via stack tuned `-max_columns 5 -ongrid {Metal2
  Metal3 Metal4} -split_cuts {Metal3 0.128}` exactly as that config does.
- **Statistical convention**: N/A — a single deterministic implementation
  run at a fixed seed (`seed: 1`).
- **Result**: `status: "ok"`, `stage_reached: "route"`.
  - **Implementation**: 342 mapped standard cells from synthesis
    (13953.9 µm² cell area); the routed DEF holds **1206 placed instances**
    — 352 logic instances (the 342 plus CTS's own clock buffers and dummy
    loads) plus **854 physical-only instances** (763 `fill_*`, 72 `endcap`,
    19 `filltie`) that the power stage inserted. Die area 37937.3 µm²
    (~195 µm × 195 µm), core area 33733.3 µm², utilization 44.09 %
    (42.67 % before fillers), routed wirelength 12738 µm.
  - **Power delivery, as applied** (echoed by the response's own `power`
    block, not asserted here): `pdn: true`, `global_connect: true`,
    tapcell master `gf180mcu_fd_sc_mcu9t5v0__filltie`, endcap master
    `gf180mcu_fd_sc_mcu9t5v0__endcap`, filler masters
    `__fill_{64,32,16,8,4,2,1}`. The written DEF now carries a
    `SPECIALNETS` section (it did not before), i.e. `VDD`/`VSS` are real,
    wired nets rather than unconnected cell pins.
  - **Timing, at the 12 MHz spec clock**: 0 setup violations, 0 hold
    violations, 0 antenna violations, 0 router DRC violations. Worst slack
    68.741 ns, TNS 0, `fmax` 68.53 MHz at `tt_025C_1v80` — 5.7× the 12 MHz
    the spec asks for.
  - **Multi-corner STA** (15 liberty corners the response reports, spanning
    the 1v8/3v3/5v0 rails of this cell library): every corner is positive on
    both setup and hold. Worst setup slack **47.286 ns** (`ss_125C_1v62`),
    worst hold slack **0.38312 ns** (`ff_n40C_5v50`). At the two rails the
    Chipalooza GF180 brief names: `tt_025C_3v30` 77.734 ns setup /
    0.88593 ns hold; `tt_025C_5v00` 79.358 ns setup / 0.61293 ns hold.
  - **Estimated power** 0.1414 mW, clock skew 0.13763 ns.
  - **Overall: pass.** The requested stage was reached, the layout carries
    real power delivery, and no timing/antenna/router violation is reported
    at any corner.
- **Coverage gaps** (unchanged in kind from the superseded record, narrowed
  in extent):
  - No IO ring / pad frame — this is a core-only block-level
    implementation. Pad assignment is a test-chip integration question, not
    a `klt place-and-route` one.
  - Metal fill (density fill) is still not inserted; the gf180mcu curated
    DRC deck this repo runs does not check density, so a clean DRC here is
    not a density-clean claim. Called out rather than implied.
  - Post-layout (extracted-parasitic) simulation is **not** part of this
    record. The STA above is liberty + estimated-RC inside OpenROAD, not a
    SPICE re-run against an extracted netlist.
- **klt provenance**: `klt` 0.3.0, `klayout` 0.30.11, PDK `gf180mcuD`
  (open_pdks `c6d73a35f524070e85faff4a6a9eef49553ebc2b`, resolved from
  `PDK_ROOT`), liberty deck `gf180mcu_fd_sc_mcu9t5v0__tt_025C_1v80`
  content_hash `sha256:2482036479c89fbee3754524e3fcdb530aa40aff0fef9e9385e3bc7b7a67d4ef`
  for both the synthesis and the P&R leg. OpenROAD engine version
  `26Q3-1260-g06a5a02279`, self-reported by the tool.
- **Links**:
  - Design under test: `rtl/usb_utmi_phy.v` (+ seven submodules)
  - Committed layout: `layout/digital/usb_utmi_phy.gds` /
    `usb_utmi_phy.def` / `usb_utmi_phy_routed.v`
  - Request files: `flow/request-usb-utmi-phy-synth.json`,
    `flow/request-usb-utmi-phy-par.json`
  - Raw klt JSON envelopes (frozen):
    `artifacts/20260825-224709-6a83263/place-and-route-output.json`,
    `artifacts/20260825-224709-6a83263/synthesize-output.json`
  - Mapped netlist + Yosys script snapshots:
    `artifacts/20260825-224709-6a83263/usb_utmi_phy_synth.v`,
    `artifacts/20260825-224709-6a83263/synth_usb_utmi_phy.ys`
  - DRC leg against this GDS:
    `verification/records/digital-drc/records/20260825-224815-6a83263.md`
  - LVS leg against this GDS:
    `verification/records/digital-lvs/records/20260825-224930-6a83263.md`
  - Friction filed: none. The capability the superseded record named as
    missing (`klt place-and-route` had no filler-cell/PDN stage in its v1
    scope) exists in `klt` 0.3.0 as the optional `request.power` block; this
    record is the first use of it in this repo.
- **Timestamp / author**: 2026-08-25T22:47:09Z, loom-builder (issue #51)
- **Supersedes**: 20260817-202448-0956748 — same claim, same RTL, re-run
  with power delivery enabled. That record is not wrong about what it
  measured; it is superseded because its artifact (a PDN-less, filler-less
  layout) is no longer the layout this repo ships.
