2AMLogic/gf180-usb2-phy/verification/records/analog-layout/records/20260818-113513-89520ac.md

<!-- record-meta
{
  "record_id": "20260818-113513-89520ac",
  "experiment": "analog-layout",
  "supersedes": null,
  "git_revision": "89520acb0efc824b3bca87e537c4624f67a7ba2a",
  "provenance": {
    "klt_version": "0.2.0",
    "pdk": {
      "name": "gf180mcuD",
      "version": "open_pdks c6d73a35f524070e85faff4a6a9eef49553ebc2b"
    },
    "deck": {
      "name": "gf180mcu",
      "content_hash": "sha256:79e71a1e7d84be3cfc82e4c70afbdf7b743ac1f361fb8e981f57831014d2e8b0"
    },
    "inputs": [
      { "path": "scripts/gen_analog_layout.py", "content_hash": "sha256:091cd5cfea5718729c71bff540551b5da5132409cef4ca80d1c466738aa23ddc" },
      { "path": "layout/analog/plans/differential_receiver.json", "content_hash": "sha256:c8eecd85b5a831be834f4cd487f09ac1071f268aebc7125cfd9fe5506ac5c158" },
      { "path": "layout/analog/plans/se_receiver_dm.json", "content_hash": "sha256:27cbbc720040e1ca6ba17aa4d9dc463aeb61e3b8f988a45750e7ae955fbf00ba" },
      { "path": "layout/analog/plans/se_receiver_dp.json", "content_hash": "sha256:00cda22c9f5123f5e95abf6c3302c79b0d2f5ae642c0b6c6b7a28f78db4414b6" },
      { "path": "design/netlist/differential_driver.spice", "content_hash": "sha256:bd4b2608c986fd1e305be7b1522e94f578cf36206fe30c13325f48a55f46afa5" },
      { "path": "design/netlist/differential_receiver.spice", "content_hash": "sha256:b8b230603cfc88b05ebe27eb18e476ddbbfa0cfab64c23677b2862ae8c658e0e" },
      { "path": "design/netlist/dplus_pullup.spice", "content_hash": "sha256:65ab85343c98631c749ebadee4be61df75f3f91133bf0c295a9d4b434d07a598" },
      { "path": "design/netlist/se_receiver_dm.spice", "content_hash": "sha256:ebfc91ac1306060dfa0ffce7d91e048b4fc8b50cfebbd5804c3aaf9b58a20554" },
      { "path": "design/netlist/se_receiver_dp.spice", "content_hash": "sha256:1f854210680331a1df73b96b317479cad4af325192fec68b0b61fb1421fac0b3" }
    ]
  }
}
-->

# Record 20260818-113513-89520ac

- **Record ID**: 20260818-113513-89520ac
- **Claim**: the analog half of T1 checklist item 2 (issue #25) —
  *"committed GDS/OASIS under `layout/`, reproducibly generated"* for the
  five analog blocks — **is not delivered**, and this record states what
  klayout-tools' netlist-driven layout-plan path (`klt.layout_plan.request/1`
  + `klayout_tools.layout_plan_execute`, Phase C) actually produces for those
  blocks when it is run. Two blocks cannot be ingested at all; the three that
  can are placed DRC-clean and have **zero** of their nets routed. Per
  `CLAUDE.md` ("no claim without a testbench", never fabricate a passing
  result) this is the negative result itself, measured — not an assumption
  that it would fail, and not a placeholder GDS standing in for a layout.
- **Design provenance**: schematic — `design/*.sch` exported to
  `design/netlist/*.spice` by `design/netlist.py`, at design git revision
  `89520acb0efc824b3bca87e537c4624f67a7ba2a`. No extracted or post-layout
  netlist exists for these blocks, which is precisely what this record is
  about.
- **Run configuration**: `PDK_ROOT=$HOME/.volare python3
  scripts/gen_analog_layout.py --format json`, which for each plan under
  `layout/analog/plans/` calls
  `klayout_tools.layout_plan_execute.execute_layout_plan_document()` and then
  `klt drc <block>.gds --deck gf180mcu --format json` (curated engine,
  default), and for each block with no committed plan calls
  `klayout_tools.netlist_digest.build_netlist_digest()` directly to
  re-measure its ingestion error. `klt` 0.2.0 @ klayout-tools
  `b3e284fff4243cdc5ab59a684d9c0582444b485d` (the pin this repo moved to in
  the same change, to consume klayout-tools PR #1158/#1161), KLayout 0.30.10,
  PDK `gf180mcuD` (open_pdks `c6d73a35`). Host: macOS/arm64.
- **Statistical convention**: N/A — deterministic runs against fixed
  netlists and fixed plan documents. The placement sweep quoted under
  "Result" (1/2/4/6/13 groups per row × 2/10/20/30 µm row spacing) was an
  exploratory sweep on `se_receiver_dp` performed before the committed plans
  were frozen; it is reported as context for *why* the single-row plan was
  chosen, not as a separately archived measurement.
- **Result**: **FAIL against the claim** — no analog layout is produced.

  | Block | `klt` status | Device groups | Nets routed | DRC (`gf180mcu`) |
  |---|---|---|---|---|
  | `differential_receiver` | executed, exit 3 (partial) | 11 | **0 / 8** | clean, 0 violations |
  | `se_receiver_dm` | executed, exit 3 (partial) | 13 | **0 / 9** | clean, 0 violations |
  | `se_receiver_dp` | executed, exit 3 (partial) | 13 | **0 / 9** | clean, 0 violations |
  | `differential_driver` | ingestion failed | — | — | — |
  | `dplus_pullup` | ingestion failed | — | — | — |

  Ingestion failures, verbatim from klt:

  - `differential_driver` — *"subcircuit 'rm1' is not a known device for the
    requested deck (known: cap_mim_2f0_m4m5_noshield, nfet_03v3, nfet_06v0,
    pfet_03v3, pfet_06v0, ppolyf_u, ppolyf_u_1k, ppolyf_u_2k, ppolyf_u_3k);
    if it is a real device, pass reference.device_map to map it explicitly"*.
    The plan schema has no `device_map` field, so that instruction cannot be
    followed from a plan (klayout-tools#1163), and no `klt gen` generator
    draws a metal resistor in any case.
  - `dplus_pullup` — *"device 'MEN' (subcircuit 'pfet_03v3'): nf=10 describes
    a multi-finger/multiplied device the curated plain-element form cannot
    represent; flatten it in the schematic netlist (one device per drawn
    gate) before comparing"*.

  The routing failures are klt's own `nets[].legs[].reason` strings (frozen
  in this record's `artifacts/`), in four classes: a same-facing port pair
  cannot be connected (a two-device CMOS inverter's drain–drain net fails on
  its own, with no orientation/mirror field to fix it); no obstacle
  avoidance (any non-adjacent pair "crosses … through unrelated block X's
  bbox"); a single drawing layer, so a multi-block `VDD`/`VSS`/bias bus
  would "draw a silent short to that pad"; and one unroutable leg discarding
  every leg's geometry for that net. `layout/README.md` § "Analog" carries
  the full diagnosis and the three friction issues filed upstream
  (klayout-tools#1163, #1164, #1165).

  The DRC result is *not* evidence of a good layout: a block whose nets are
  all unrouted has no inter-device wiring for a spacing rule to flag. It is
  reported because it isolates the failure to routing rather than
  device generation or placement.
- **klt provenance**: `klt` 0.2.0 @ klayout-tools `b3e284f`, KLayout 0.30.10;
  PDK `gf180mcuD`, open_pdks `c6d73a35f524070e85faff4a6a9eef49553ebc2b`; DRC
  deck `gf180mcu`, content hash
  `sha256:79e71a1e7d84be3cfc82e4c70afbdf7b743ac1f361fb8e981f57831014d2e8b0`.
  klt drove every leg of this run (plan execution and DRC); nothing here is
  hand-derived.
- **Links**:
  - Driver: `scripts/gen_analog_layout.py`
  - Plans under test: `layout/analog/plans/{differential_receiver,se_receiver_dm,se_receiver_dp}.json`
  - Designs under test: `design/netlist/*.spice` (all five blocks)
  - Diagnosis + friction: `layout/README.md` § "Analog"
  - Raw artifacts: `verification/records/analog-layout/artifacts/20260818-113513-89520ac/`
    — `analog-layout-report.json` (the combined report), one
    `<block>-layout-plan.json` per executed block (the full Phase C response,
    including every `nets[].legs[].reason`), and one `<block>.gds` per
    executed block (the placed, unrouted composition; committed here as
    evidence, deliberately **not** under `layout/`, where it would read as a
    delivered layout).
- **Timestamp / author**: 2026-08-18T11:35:13Z, Loom Builder (AI agent),
  issue #25.
- **Supersedes**: none.
