2AMLogic/gf180-usb2-phy/verification/records/place-and-route/records/20260817-202448-0956748.md

<!-- record-meta
{
  "record_id": "20260817-202448-0956748",
  "experiment": "place-and-route",
  "supersedes": null,
  "git_revision": "09567484640b0323ffbec633350c3190ae0c2799",
  "provenance": {
    "klt_version": "0.2.0",
    "pdk": {
      "name": "gf180mcuD",
      "version": "open_pdks f6eeac7dad085ffcc829ccfd721f7b4ce39edcf7"
    },
    "deck": {
      "synthesize": {
        "name": "gf180mcu_fd_sc_mcu9t5v0__tt_025C_1v80",
        "content_hash": "sha256:c0b6946a2d48a4604c687a29d3c8b1e05b3da5a42866b21592eaacfeae6e9ca7"
      },
      "place_and_route": {
        "name": "gf180mcu_fd_sc_mcu9t5v0__tt_025C_1v80",
        "content_hash": "sha256:c0b6946a2d48a4604c687a29d3c8b1e05b3da5a42866b21592eaacfeae6e9ca7"
      }
    },
    "inputs": [
      { "path": "rtl/usb_nrzi_encoder.v", "content_hash": "sha256:3f177079cc4112d34d9c9e5864b406481a6735a3ab7a840ccd28f991fc80f5d7" },
      { "path": "rtl/usb_nrzi_decoder.v", "content_hash": "sha256:ac31765a4389a8502526843cdca2edffd6be8b7f4bb4f2fcb3061b5ae85c384b" },
      { "path": "rtl/usb_bit_stuffer.v", "content_hash": "sha256:1f53016e105414fed26e560a64e7d0db7995d32238c3ac3d5070a0c5bf6c8543" },
      { "path": "rtl/usb_bit_destuffer.v", "content_hash": "sha256:2c16654e2f699f6b8692da99563da50bf186f41c89a107c6e2fa8b27f6c6d760" },
      { "path": "rtl/usb_sync_detector.v", "content_hash": "sha256:1f69da425fec809895fbdeb61e1d308379ddabc9aa0ecb10bf2f88f8fa88cbdc" },
      { "path": "rtl/usb_eop_detector.v", "content_hash": "sha256:163b950b3dcf939a2810f03b63dbea6f361f3261d47a75ea980cdf60d67e8e28" },
      { "path": "rtl/usb_line_state_decode.v", "content_hash": "sha256:c2d93d43d48ddaa2b620c3c0f11b06af74e89860fa3883f7b543955b46aa0d08" },
      { "path": "rtl/usb_utmi_phy.v", "content_hash": "sha256:9f0a9c95056934a0a8a7e357ae0b8c44b0e5b6704e94e6b433c478e4ecfb870b" },
      { "path": "flow/request-usb-utmi-phy-synth.json", "content_hash": "sha256:a7d8d2dc02eb81d896811ce814ea92b3a4f3a430fb6c7d9a320cc5ba48bb9a17" },
      { "path": "flow/request-usb-utmi-phy-par.json", "content_hash": "sha256:a42560e57dff0754cbc7852b6512dc9026ff56b6eb81d504bdbc42b31efc7560" },
      { "path": "layout/digital/usb_utmi_phy.gds", "content_hash": "sha256:9dfcece796c047ab90d033030a87519475bb353f126481d428d040b812bc0dc5" },
      { "path": "layout/digital/usb_utmi_phy.def", "content_hash": "sha256:45cc4a57befa514eae82f15b9c8562b1c94a01cb26a4621c61fb9f87d4e94508" },
      { "path": "layout/digital/usb_utmi_phy_routed.v", "content_hash": "sha256:6628657c7031a34205336faac41f47ada4cffd11c06e81a3dbbaafb1a83a125f" }
    ]
  }
}
-->

# Record 20260817-202448-0956748

- **Record ID**: 20260817-202448-0956748
- **Claim**: T1 checklist item 2 (issue #25) — the real PHY digital logic
  (`rtl/usb_utmi_phy.v` and every submodule it instantiates:
  `usb_nrzi_encoder`, `usb_nrzi_decoder`, `usb_bit_stuffer`,
  `usb_bit_destuffer`, `usb_sync_detector`, `usb_eop_detector`,
  `usb_line_state_decode` — issues #31/#32) synthesizes against the
  gf180mcu standard-cell library and place-and-routes to a committed,
  routed GDS via `klt synthesize` + `klt place-and-route` (OpenROAD),
  reproducibly, from a real committed request-file flow (not a one-off
  hand edit). This record does **not** claim DRC-clean or LVS-clean
  signoff — those are T1 checklist items 3/4, explicitly out of scope for
  this record (see `verification/records/digital-drc/` for the DRC leg,
  run and recorded honestly with a non-clean result; LVS is not attempted
  by this record — see this record's own "Coverage gaps" below).
- **Design provenance**: netlist (post-synthesis) → layout (post-P&R,
  merged DEF+GDS, not extracted/re-verified) — `rtl/usb_utmi_phy.v` and its
  seven submodules @ `09567484640b0323ffbec633350c3190ae0c2799`.
- **Run configuration**:
  1. **Synthesis**: `PDK=gf180mcuD klt synthesize
     flow/request-usb-utmi-phy-synth.json --format json` — engine `yosys`
     0.67, `pdk.cell_library` = `gf180mcu_fd_sc_mcu9t5v0`, `pdk.corner` =
     `tt_025C_1v80`, unconstrained (`clock_period_ns: null`).
  2. **Place-and-route**: `PDK=gf180mcuD klt place-and-route
     flow/request-usb-utmi-phy-par.json --format json` — engine `openroad`
     26Q3-1260-g06a5a02279 (invoked via `scripts/openroad-docker.sh`, the
     pinned `openroad/orfs:26Q3-296-gda37dce1c` image — no native
     `openroad` on this host, see `docs/environment-setup.md`'s "OpenROAD"
     section), `floorplan.method` = `utilization` (40%, aspect ratio 1.0,
     4 µm core margin, site `GF018hv5v_green_sc9`), `io` = `Metal3`
     (horizontal) / `Metal2` (vertical), `constraints.clock_port` = `clk`,
     `constraints.clock_period_ns` = 83.333 (12 MHz, spec
     `usb2-device-phy.md` §3's UTMI interface clock rate), `seed` = 1,
     `target_stage` = `route`.
- **Statistical convention**: N/A — a single deterministic synthesis +
  P&R run (OpenROAD's placement/CTS/routing is seeded and reproducible
  given an identical seed, engine version, and PDK install), not a
  distribution claim.
- **Result**:
  - Synthesis: `status: "ok"`, 342 standard-cell instances,
    `area_um2`: 13953.9456 (`sequential_area_um2`: 6638.2848 — 84
    `dffq_1` flip-flops).
  - Place-and-route: `status: "ok"`, `stage_reached: "route"`.
    - `die_area_um2` / `core_area_um2`: 37937.3 / 33733.3,
      `utilization_pct`: 42.6707.
    - `wirelength_um`: 12608.
    - Timing at the 12 MHz (83.333 ns) target: `worst_slack_ns`: 68.6887,
      `total_negative_slack_ns`: 0, `setup_violation_count`: 0,
      `hold_violation_count`: 0 — **no timing violations at the spec
      clock rate**, with over 5x margin to spare (`fmax_mhz`: 68.2861,
      i.e. this netlist places/routes cleanly to roughly 68 MHz, far
      above the 12 MHz full-speed UTMI target it actually needs to hit —
      consistent with this being a full-speed-only, deliberately
      unaggressive design per `CLAUDE.md`'s scope discipline).
    - `antenna_violation_count`: 0, `route_drc_violation_count` (OpenROAD's
      own in-flow DRC check): 0.
    - `estimated_power_mw`: 0.1436, `clock_skew_ns`: 0.1088.
  - **Overall: PASS** for this record's own claim (synthesizes and routes
    to a complete, timing-clean-at-spec-rate GDS). See "Coverage gaps"
    below for what this record explicitly does not cover.
  - **Coverage gaps, stated explicitly** (per `verification/README.md`'s
    "claim states what it does not cover" convention):
    - **Not DRC-clean.** `verification/records/digital-drc/` records a
      real, non-fabricated DRC run against this exact GDS: 153 violations
      (141 `metal1.space.1`, 12 `metal1.width.1`), all located inside
      standard-cell instance boundaries at cell-to-cell row gaps. Root
      cause (verified, see that record): `klt place-and-route`'s v1
      contract has **no filler-cell insertion or power-rail-stitching
      stage** (its own `docs/cli/place-and-route.md` "Out of scope"
      section names this directly: "Tapcell insertion, power-grid
      generation (PDN), metal fill... none of these are part of the
      request/response contract this phase implements") — at 40%
      utilization, real (non-abutted) gaps between adjacent same-row
      standard cells leave each cell's own power/ground rail edge exposed
      with no filler cell bridging it, which is a genuine drawn-geometry
      condition, not a `klt drc` false positive (klayout-tools#1028 already
      investigated and closed the "is this a DRC engine bug" question for
      the zero-gap-abutment case; this is the same underlying mechanism at
      a non-zero gap, which that investigation's own PR explicitly
      confirmed is a real violation, "by-design, not loosened").
    - **LVS not attempted by this record.** T1 checklist item 4 (LVS) is a
      separate checklist item from this one (item 2, layout); building a
      real digital LVS pipeline (cell-level netlist extraction + a golden
      reference netlist assembled from the as-built P&R netlist, following
      `sky130-modexp`'s `layout/lvs/build_reference_netlist.py` pattern) is
      deferred to that item's own issue rather than attempted here as
      scope creep on a layout-production issue.
    - **No tapcell/PDN/metal-fill/`DONT_USE_CELLS`** — `klt
      place-and-route`'s own documented v1 scope; not attempted.
- **klt provenance**: `klt` 0.2.0. `klayout` 0.30.10. PDK: `gf180mcuD`
  (open_pdks `f6eeac7dad085ffcc829ccfd721f7b4ce39edcf7`). Synthesis +
  place-and-route deck: `gf180mcu_fd_sc_mcu9t5v0__tt_025C_1v80`,
  content_hash `sha256:c0b6946a2d48a4604c687a29d3c8b1e05b3da5a42866b21592eaacfeae6e9ca7`
  (same liberty resolves both steps). Input content hashes: see
  `provenance.inputs` in the metadata block above.
- **Links**:
  - Request recipes: `flow/request-usb-utmi-phy-synth.json`,
    `flow/request-usb-utmi-phy-par.json`
  - Design under test: `rtl/usb_utmi_phy.v` and its submodules (see
    `provenance.inputs`)
  - Routed layout: `layout/digital/usb_utmi_phy.gds`,
    `layout/digital/usb_utmi_phy.def`,
    `layout/digital/usb_utmi_phy_routed.v` (the as-built, post-CTS/route
    gate-level netlist `klt place-and-route` emits — CTS buffers, resizes,
    and antenna diodes included)
  - Raw klt JSON envelopes (frozen):
    `artifacts/20260817-202448-0956748/synthesize-output.json`,
    `artifacts/20260817-202448-0956748/place-and-route-output.json`
  - Mapped netlist / Yosys script snapshots:
    `artifacts/20260817-202448-0956748/usb_utmi_phy_synth.v`,
    `artifacts/20260817-202448-0956748/synth_usb_utmi_phy.ys`
  - OpenROAD provisioning: `scripts/openroad-docker.sh`,
    `docs/environment-setup.md` § "OpenROAD"
  - DRC leg: `verification/records/digital-drc/`
  - Friction: none new filed for this leg — the filler-cell/PDN gap is
    already documented as deliberate v1 scope in `klt place-and-route`'s
    own CLI docs, and the DRC-engine-vs-real-violation question for this
    exact mechanism is already closed by
    [klayout-tools#1028](https://github.com/2AMLogic/klayout-tools/issues/1028).
    See `verification/records/digital-drc/` for the friction issue filed
    for the *analog* layout gap this same PR hit (unrelated mechanism).
- **Timestamp / author**: 2026-08-17T20:24:48Z, loom-builder (issue #25)
- **Supersedes**: none
