2AMLogic/gf180-usb2-phy/verification/README.md

# verification/ — evidence record format

**This file is the authoritative convention.** The scripts under
`verification/` (`check_records.py`) implement it; if a script and this
document ever disagree, this document wins and the script is the thing that
gets fixed. This convention is ported, near-verbatim, from
[`sky130-modexp`](https://github.com/2AMLogic/sky130-modexp)'s
`verification/README.md` (the digital half of issue #2's harness bootstrap,
per `CLAUDE.md`) — same record schema, re-targeted from sky130 to gf180mcu.
It in turn adapts the record convention used by the analog canaries
(`2AMLogic/gf180-bandgap`'s `sim/README.md`) for a digital RTL flow: no
ngspice, no PVT corner sweep; the klt `provenance` block (klt version,
resolved PDK, deck/input content hashes) takes the place of a swept-corner
matrix.
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
