2AMLogic/gf180-usb2-phy/layout/analog/HISTORY.md

# Analog layout — dated history of the klt-only attempt

**This file is history, not current state.** It is the narrative of the
klt-only analog routing attempt that preceded the committed analog streams,
moved here verbatim from `layout/README.md` (issue #323) so that the README
describes the tree as it ships.

Nothing was rewritten in the move. Where the text below says "not delivered",
or lists 6/21 and 1/8/9/9 routed nets, or calls `differential_driver`
un-ingestible, it describes the run it was written about — not the GDS now
committed under `layout/analog/`. "this file", "above" and "below" in that text
refer to this block as it stood in `layout/README.md`; every heading it
cross-references moved with it, so each of those pointers still resolves here.

**For current state** read [`../README.md`](../README.md) § "Analog" — the
status paragraph, "Outcome for the four child-A blocks", and "Current state in
one paragraph". This file is a narrative *over* the evidence of record, which
is the append-only set under
`../../verification/records/analog-layout/records/`; the records, not this
file, are what a claim rests on.

---

### What was attempted

klayout-tools now ships the netlist-driven layout-plan compiler/executor that
the earlier revision of this file recorded as missing
([klayout-tools#1116](https://github.com/2AMLogic/klayout-tools/issues/1116),
closed): a plan (`klt.layout_plan.request/1`, `docs/cli/layout-plan.md`)
declares how a netlist's devices group onto `klt gen` generators, and Phase C
(`klayout_tools.layout_plan_execute`, klayout-tools PR #1158 + #1161)
generates, places, and routes them through `klt gen-compose`. This repo's klt
pin was moved forward to `b3e284f` specifically to consume it, then again
to `07b1f04f` (issue #52), and again to `8bd3f0b0` (issue #68), each time to
consume the fixes named under "Friction filed" below (see
`docs/environment-setup.md`).

`layout/analog/plans/*.json` are the resulting committed plans — as of issue
#72, all five blocks now have one. The three receiver plans use one
`device_groups[]` entry per netlist device (`mos_array` with `rows`/`cols` 1
and `dummy` 0 for each MOS, `res_array` with `num` 1 and `dummy` 0 for each
poly resistor), every group in a single `rows[]` row. `dplus_pullup.json`
(issue #62) is the first plan that groups rather than enumerates: 78 devices
in 24 groups — the six differently-sized `ppolyf_u` ladder segments as six
distinct `res_array` groups (one shared group would force a single
`length_um` onto all six), each switch bank's ten flattened fingers as one
10-wide `mos_array`, and the six control inverters as per-device groups
clustered in n/p pairs. It is also the first plan to declare `routing`
explicitly rather than take klt's default — see "Route width" below.
`differential_driver.json` (issue #72) is the last of the five to be
authored — one `device_groups[]` entry per netlist device like the three
receiver plans, with one addition: its two `RM1`-classed series-termination
resistors set `params.metal_level: 1` explicitly, the field klayout-tools#1731's
fix added drawn-geometry support for (see "Friction filed" below); without
it, `res_array` would silently draw a poly resistor instead of the metal-1
device the netlist declares. `scripts/gen_analog_layout.py` executes them
and runs `klt drc` on each result. Nothing here is hand-drawn: `klt draw`
remains the wrong tool for a layout claim (its own docs: "no PDK awareness
and no rule checking").

### What actually happened

Nine runs exist. The first two ran against two `klt` pins over
byte-identical inputs (design netlists, plans, and the driver script never
changed between them — see `verification/records/analog-layout/` for the
content hashes that prove it); the pin moved specifically because the three
friction issues the first run filed (klayout-tools#1163, #1164, #1165) all
closed upstream within hours of that run, and the pin this repo carried
predated every one of the fixes (issue #52's investigation). The third
holds the `klt` pin fixed and changes exactly one design input —
`design/netlist/dplus_pullup.spice`, per the issue #56 flatten ruling
(`spec/decisions/0001-dplus-pullup-switch-device-flattening.md`) — so that
its effect is isolated. The fourth changes no design source at all: it adds
the committed `dplus_pullup` layout plan (issue #62) and drops that block
from the driver's (since removed, issue #177) list of plan-less blocks. The
fifth (issue #65) changes no design source and no `klt` pin either: it adds an explicit `routing` block (`metal`,
0.23 µm) to the three older plan documents themselves, in place of the
illegal 0.17 µm default they had taken by omission since the second run. The
sixth (issue #68) changes exactly one repo input — `scripts/setup-env.sh`'s
`KLT_REV`, moved to `8bd3f0b0` to consume klayout-tools#1501 and #1502 —
with all four plan documents byte-identical, so the pin bump's own effect is
isolated before any plan edit can be credited with it. The seventh (also
issue #68) holds that pin and changes exactly one plan document:
`dplus_pullup.json` gains `routing.cross_block_layer_role`. The eighth
(issue #70) changes exactly one repo input again — `scripts/setup-env.sh`'s
`KLT_REV`, moved to `bf90e1d5e3a6` to consume klayout-tools#1640
(`rm1`/`rm2`/`rm3` metal-resistor device-class recognition) — with all four
plan documents byte-identical, isolating the pin bump's effect exactly like
the sixth run did. The ninth (issue #72) changes `scripts/setup-env.sh`'s
`KLT_REV` again, moved to `61e743088f47` to consume klayout-tools#1731
(`res_array` drawn-geometry support for gf180mcu metal resistors, plus the
declared-class-vs-resolved-generator mismatch warning) — with the four
already-committed plan documents byte-identical (isolating the pin bump's
drawn-geometry effect on them, as before) — **and** adds the fifth plan,
`differential_driver.json`, in the same run.

| Block | 2026-08-18, `klt` 0.2.0 @ `b3e284f` | 2026-08-26, `klt` 0.3.0 @ `07b1f04` | 2026-09-05, flattened `dplus_pullup` | 2026-09-05, + committed `dplus_pullup` plan | 2026-09-05, + legal `routing.width_um` (issue #65) | 2026-09-09, `klt` 0.4.0 @ `8bd3f0b0`, plans byte-identical (issue #68) | 2026-09-09, + `cross_block_layer_role` on `dplus_pullup` (issue #68) | 2026-09-12, `klt` 0.4.0 @ `bf90e1d5e3a6`, plans byte-identical (issue #70) | 2026-09-13, `klt` 0.4.0 @ `61e743088f47`, four plans byte-identical + new `differential_driver` plan (issue #72) | 2026-09-14, `klt` pin unchanged, `params.flavor: "1k"` fix on three plans (issue #73) | 2026-09-21, `klt` 0.5.0 @ `e8ca621a`, plans byte-identical (issue #78 re-pin, move 6) |
|---|---|---|---|---|---|---|---|---|---|---|
| `differential_receiver` | 11 groups placed, **DRC-clean**, **0/8 nets routed** | 11 groups placed, **0/8 nets routed (unchanged)**, DRC **19 violations** (`metal1.width.1`) | unchanged — byte-identical GDS | unchanged — byte-identical GDS | **DRC-clean (0 violations)**, **0/8 nets routed (unchanged)** — `routing.width_um` corrected from klt's illegal 0.17 µm default to the deck's own 0.23 µm minimum | **1/8 nets routed** (`VDD`), DRC-clean — the pin bump alone; geometry re-floored at deck minimums, plan untouched | unchanged — plan untouched by this run | unchanged — `cmp`-identical GDS; plan untouched | unchanged drawn geometry — geometrically identical GDS (per-layer Boolean XOR: zero area difference on all 10 layers; **not** byte-identical — same elements, different emission order), plan untouched; **new**: `klt`'s new mismatch check reports 1 `warnings[]` entry (`r_bias` declares `PPOLYF_U_1K`, draws default-flavor `ppolyf_u`) — a pre-existing mismatch, not a regression; not fixed here (see "Friction filed") | **fixed**: `r_bias` gains `params.flavor: "1k"` — now draws real `ppolyf_u_1k` geometry (layer `31/0` → `62/0` swap, confirmed by direct GDS read), **0 `warnings[]`** (down from 1); **1/8 nets routed (unchanged)**, **DRC-clean (unchanged)**, bbox unchanged (per-layer XOR against the prior run is zero everywhere except the two swapped layers) | 1/8 nets routed (unchanged), DRC-clean, 0 `warnings[]`, bbox unchanged — `cmp`-identical GDS to the tenth run; the pin bump does not move this block at all |
| `se_receiver_dm` | 13 groups placed, **DRC-clean**, **0/9 nets routed** | 13 groups placed, **0/9 nets routed (unchanged)**, DRC **22 violations** | unchanged — byte-identical GDS | unchanged — byte-identical GDS | **DRC-clean (0 violations)**, **0/9 nets routed (unchanged)** — same fix | **1/9 nets routed** (`VDD`), DRC-clean — same mechanism | unchanged — plan untouched by this run | unchanged — `cmp`-identical GDS; plan untouched | unchanged drawn geometry — geometrically identical GDS (per-layer Boolean XOR: zero area difference on all 10 layers; **not** byte-identical — same elements, different emission order), plan untouched; **new**: 3 `warnings[]` entries (`r_bias`/`r_1`/`r_2`, same mismatch shape as above) | **fixed**: all three groups (`r_1`, `r_2`, `r_bias`) gain `params.flavor: "1k"` — same layer-swap confirmation, **0 `warnings[]`** (down from 3); **1/9 nets routed (unchanged)**, **DRC-clean (unchanged)**, bbox unchanged | 1/9 nets routed (unchanged), DRC-clean, 0 `warnings[]`, bbox unchanged — `cmp`-identical GDS to the tenth run |
| `se_receiver_dp` | 13 groups placed, **DRC-clean**, **0/9 nets routed** | 13 groups placed, **0/9 nets routed (unchanged)**, DRC **22 violations** | unchanged — byte-identical GDS | unchanged — byte-identical GDS | **DRC-clean (0 violations)**, **0/9 nets routed (unchanged)** — same fix | **1/9 nets routed** (`VDD`), DRC-clean — same mechanism | unchanged — plan untouched by this run | unchanged — `cmp`-identical GDS; plan untouched | unchanged drawn geometry — geometrically identical GDS (per-layer Boolean XOR: zero area difference on all 10 layers; **not** byte-identical — same elements, different emission order), plan untouched; **new**: 3 `warnings[]` entries (`r_bias`/`r_1`/`r_2`, same mismatch shape as above) | **fixed**: all three groups (`r_1`, `r_2`, `r_bias`) gain `params.flavor: "1k"` — same layer-swap confirmation, **0 `warnings[]`** (down from 3); **1/9 nets routed (unchanged)**, **DRC-clean (unchanged)**, bbox unchanged | 1/9 nets routed (unchanged), DRC-clean, 0 `warnings[]`, bbox unchanged — `cmp`-identical GDS to the tenth run |
| `differential_driver` | **cannot be ingested** — series-termination resistors are `rm1` (metal-1) devices, unknown to klt's curated `gf180mcu` deck | **cannot be ingested — identical error text, verbatim** | **still cannot be ingested** — unrelated blocker, unchanged | **still cannot be ingested** — unchanged | **still cannot be ingested** — unchanged, out of this fix's scope | **still cannot be ingested — identical error text, verbatim**; reconfirmed at the new pin and filed upstream as klayout-tools#1621 | unchanged | **now ingests** (klayout-tools#1640/PR #1662 fixed) — 12-device digest resolves cleanly for the first time. Still **no committed plan**: a throwaway probe places 12 groups / **0/10 nets routed** / DRC-clean, but `klt gen`'s `res_array` has no gf180mcu metal-resistor generator support and *silently draws the wrong device* (a poly resistor) for the two `rm1` groups when left at default `flavor` — filed generically as klayout-tools#1731 | **plan committed** (`differential_driver.json`, `params.metal_level: 1` on both `RM1` groups) — 12 groups placed, **0/10 nets routed**, DRC-clean, **0 `warnings[]`**: both series-termination resistors confirmed (by direct GDS layer inspection) to draw real `Metal1`/`Via1`/`Metal2` geometry, not the poly substitution the eighth run caught | unaffected — plan untouched, `cmp`-identical GDS (issue #73 is scoped to the three receiver plans' `PPOLYF_U_1K` resistors only) | 0/10 nets routed (unchanged), DRC-clean, 0 `warnings[]`, bbox unchanged — `cmp`-identical GDS to the tenth run |
| `dplus_pullup` | **cannot be ingested** — pull-up switches carry `nf=10`, which klt's subckt-call → plain-element conversion refuses to represent | **cannot be ingested — identical error text, verbatim** | **ingests, and places** — 78 devices / 21 nets; blocker cleared by the flatten. Still **no committed plan**, so still no layout | **plan committed and executed** — 24 groups placed, **6/21 nets routed**, **DRC-clean (0 violations)**. Still not a layout: 15 nets unrouted | unchanged — byte-identical GDS (its plan already carried the legal `routing.width_um: 0.23`) | **6/21 nets routed (unchanged)**, DRC-clean; 114/1301 legs routed | **6/21 nets routed (still unchanged)**, DRC-clean **with `via1`/`metal2` rules now actually checked**; **168/769 legs routed**, the 540 same-layer-short leg rejections **gone**, 2 nets `unrouted` → `partial` | unchanged — `cmp`-identical GDS; plan untouched | unchanged drawn geometry — geometrically identical GDS (per-layer Boolean XOR: zero area difference on all 13 layers; **not** byte-identical — same elements, different emission order), plan untouched; 0 `warnings[]` (its `res_array` groups declare plain `PPOLYF_U`, matching the default flavor they draw — no mismatch) | unaffected — plan untouched, `cmp`-identical GDS (its `res_array` groups already declared plain `PPOLYF_U`, no mismatch to fix) | **6/21 nets routed (unchanged), DRC-clean, 0 `warnings[]`, bbox unchanged** — but the *drawn routing* genuinely moved with the pin: per-layer XOR vs the tenth run is zero on every layer except `34/0` (Metal1), which loses 63,504,000 dbu² (610,832,320 → 547,328,320) — the four already-routed ladder nets `NODE2`–`NODE5` are re-legged far shorter (`route_length_um` 227.1→75.5, 234.0→76.2, 247.7→77.5, 454.8→65.2) by the upstream routing-semantics commits that landed between the pins (klayout-tools#1931/#1936/#1945/#2098/#2144: legs reaching a pin from the side it doesn't face are now rejected, own-block approaches held to the deck's spacing rule, routed metal floored against per-layer min-area). No recorded status moved: the 15 unrouted nets stay unrouted and stay the (d) critical path |

**New finding, ninth run: three of the four already-committed plans have their own declared-class/drawn-device mismatch, just found by the same check that fixed `differential_driver`.** `differential_receiver.json`'s `r_bias` group and `se_receiver_dm.json`/`se_receiver_dp.json`'s `r_bias`/`r_1`/`r_2` groups all declare `device_class: "PPOLYF_U_1K"` (matching the netlist, which genuinely instantiates those bias/reference resistors as the `ppolyf_u_1k` model — a specific 1 kΩ/sq flavor) but never set `params.flavor: "1k"`, so `res_array`'s default `"generic"` flavor has silently drawn the wrong poly-resistor body for all seven groups since before this pin moved. The drawn geometry for these three blocks is unchanged by this pin bump (per-layer Boolean XOR against the superseded record's artifacts: zero area difference on every layer; the GDS files are geometrically identical, not byte-identical) — this is not a regression, it is a standing, previously-undetectable defect the new mismatch-warning check (klayout-tools#1731's second half) surfaces for the first time. **Not fixed in this run**: correcting it is real per-block layout work (each group needs a `params.flavor: "1k"` override, then its own DRC/LVS re-verification), out of scope for issue #72, and tracked by [gf180-usb2-phy#73](https://github.com/2AMLogic/gf180-usb2-phy/issues/73) — see record `verification/records/analog-layout/records/20260913-192744-b653c71.md`.

**Fixed (2026-09-14, issue #73, tenth run).** All seven affected groups now carry `params.flavor: "1k"`. Re-executing the three plans confirms the mismatch check reports **0 `warnings[]` entries** on all three (down from 1/3/3), each affected group's drawn body swaps from `ppolyf_u`'s layer `31/0` to `ppolyf_u_1k`'s layer `62/0` marker (confirmed by direct GDS layer inspection against each group's own bounding box), and nothing else moves: routed-net counts (1/8, 1/9, 1/9), DRC-clean status, device-group counts, and block bboxes are unchanged from the superseded record, and a per-layer Boolean XOR against its frozen artifacts is exactly zero on every layer except the one `31/0`→`62/0` swap per block (equal area on each side, i.e. a pure body-flavor substitution, not a resize). See record `verification/records/analog-layout/records/20260914-023747-74372a3.md` for the full reproduction. Routing any of the pre-existing unrouted nets on these three blocks remains out of scope for this fix (unchanged by it, and not something a `flavor` correction touches).

**Eleventh run (2026-09-20/21, `klt` re-pin move 6, issue #78).** Nothing
design-side changed; this run exists because the `klt` pin moved to
`e8ca621a` (the revision that can grade T1 item 11 — see
`docs/environment-setup.md`), and the re-measure discipline applies. All
five plans re-executed with input hashes byte-identical to the tenth run:
four blocks reproduce `cmp`-identical GDS, and `dplus_pullup`'s drawn
Metal-1 routing re-shaped under the upstream routing-semantics commits
between the pins (`route_length_um` collapses on `NODE2`–`NODE5`,
63,504,000 dbu² less layer `34/0`) with **no change to any recorded
status** — 6/21 routed stays 6/21, DRC stays clean, `warnings[]` stays 0,
bboxes stay put. See record
`verification/records/analog-layout/records/20260921-130120-223bae5.md`
for the full reproduction, and `manifests/README.md` for the graded
T1 state this era exists to track.

**The `dplus_pullup` ingestion blocker is resolved; that block now has a
committed plan; it still does not have a layout.** Issue #56's operator
ruling (2026-09-05, FLATTEN — recorded as
`spec/decisions/0001-dplus-pullup-switch-device-flattening.md`) redrew each
of the six `nf=10` pull-up switch devices as ten one-finger devices in
parallel, one device per drawn gate, which is verbatim what klt's own error
text prescribed; that ruling did not make the change free — the flatten's
electrical equivalence is *measured*, in
`sim/dplus-pullup-tolerance/records/20260905-185112-6bfe679.md` (45/45 PVT
corners PASS, identical trim code at every corner, ≤ 0.01 Ω from the
superseded `nf=10` result), not assumed.

Issue #62 then authored `layout/analog/plans/dplus_pullup.json` — the real
plan, replacing the throwaway two-group probe #56's record used to prove the
ingestion path. Executing it places all 78 devices in 24 groups
(201.94 × 101.12 µm), routes **6 of 21 nets**, and produces a **DRC-clean**
GDS. Both of those are firsts for a committed analog plan in this repo, and
neither makes it a layout: the six routed nets are the inverter gate-input
nets, while every ladder node, both supplies, and all six switch gate-drive
nets are unrouted. The grouping decisions and the measured sweeps behind
them (grouping, `spacing_um`, `orientation`, `routing.layer_role`) are in
`verification/records/analog-layout/records/20260905-233520-2eca93d.md`.

**Route width: klt's default was illegal on this PDK, and that — not miter
geometry — is what the `metal1.width.1` counts above were measuring. All four
plans now set a legal width and all four are DRC-clean.** klt's documented
default routing width is 0.17 µm; the `gf180mcu` deck's own `metal1.width.1`
minimum is 0.23 µm (DRM 7.13 "Mn.1"), so every segment a default-width route
draws is below minimum. The `dplus_pullup` plan (issue #62) was the first
here to set `routing` explicitly (`metal`, 0.23 µm) and is DRC-clean; forcing
that same plan back to 0.17 µm yields 172 `metal1.width.1` violations with an
otherwise byte-for-byte identical placement and the same 6/21 routing.
Probing the three older plans the same way cleared **all** of their
violations (19 → 0, 22 → 0, 22 → 0) with unchanged 0/N routing, and issue #65
then committed that same `routing` block (`metal`, 0.23 µm) to
`differential_receiver.json`, `se_receiver_dm.json`, and `se_receiver_dp.json`
themselves — re-executing them confirms the identical result (0 violations,
routed-net counts unchanged) as the as-committed state, not just a probe. The
generic tool-side gap — klt never validates `routing.width_um` (nor its
hard-coded 0.22 µm via-drop square) against the resolved deck's own rules —
is filed upstream as
[klayout-tools#1501](https://github.com/2AMLogic/klayout-tools/issues/1501)
and **closed `COMPLETED` 2026-09-06**, consumed by issue #68's pin move to
`8bd3f0b0`; this repo's own four plans never depended on it being fixed, and
now benefit from it anyway.

A block of placed devices with none of its nets wired is not a layout, and
neither is one with 6 of 21 wired. None is committed as one, and no analog
GDS is committed under `layout/` — per `CLAUDE.md`'s rule against making a
claim the evidence does not support. Re-run `scripts/gen_analog_layout.py`
(below) to reproduce the artifacts under `layout/analog/out/` (gitignored)
for inspection; the same artifacts are frozen in the seven evidence records.

**A third run (2026-09-05, issue #61): re-measured after klayout-tools#1424
closed, found unchanged.** klayout-tools#1424 (the DRC regression named
below) was closed `NOT_PLANNED` on 2026-08-26 — the maintainer refuted the
issue's claimed mechanism ("polygon-miter code" in `gen_compose.py`) via
direct source inspection, and invited a re-run with a concrete repro if the
violations still reproduce. They do: this repo's `klt` pin has not moved
since the 2026-08-26 run (nothing upstream needed consuming), so the re-run
is byte-for-byte identical in every input and every output — same 19/22/22
`metal1.width.1` violations, on byte-identical polygons, same 0/8, 0/9, 0/9
routed-net counts, `cmp`-identical GDS files. The closure corrected the
*claimed mechanism*, not the observed symptom. See
`verification/records/analog-layout/records/20260905-200628-80cb14c.md`
for the full comparison and the independent re-verification that the
inspected and pinned commits are code-identical for the relevant files.
**That record's own explanation of the symptom is now superseded** — the
violating shapes are not the tapered quadrilaterals it (and #1424) described
but ordinary sub-minimum-width route segments; see "Route width" above and
record `20260905-233520-2eca93d`. The record stands unedited as the correct
account of *what reproduced*; only the mechanism it inferred is wrong.

**Why the routed-net count didn't move even though three friction issues
closed.** All three fixes are real and confirmed present in the newer
`klt` (checked directly against its own shipped docs, not assumed):
`netlist.device_map` now threads through a layout plan (#1163's fix), a
per-`device_groups[]` `orientation` field (`"mirror_x"`/`"mirror_y"`/
`"rotate_180"`) now exists to resolve same-facing ports (#1166, one of
#1164's five decomposed children), and a real two-layer
`routing.layer_role: "metal2"` bus role with via-drop now exists for
cross-block supply/bias nets (closing root-cause class 3 from the original
diagnosis below). **All three are opt-in fields that the three receiver
plans predate and do not use** — landing upstream does not retroactively
change what an already-written plan asks for.

**Update (2026-09-05, issue #62): two of those three were finally spent, on
`dplus_pullup`, and measured.** `orientation` was tried in all three
non-default values: `mirror_x` is neutral (6/21 routed, DRC clean),
`mirror_y` and `rotate_180` move the gate ports to the far edge and drop the
count to 0/21 — so the committed plan leaves it at `"none"` by measurement,
not by omission. `routing.layer_role: "metal2"` does remove the whole
same-drawing-layer rejection class, but does not raise the routed-net count
(the router still refuses to cross a block's bbox even on a layer that
cannot short to it) and adds 284 sub-minimum vias, so the committed plan
stays on metal1. The one capability that would plausibly carry the remaining
nets — `routing.cross_block_layer_role` — is unreachable from a plan
document at all (klayout-tools#1502). Using these fields for real is genuine
per-block analog layout design work, not a mechanical re-run, and remains
short of the line this repo does not cross into a bespoke block-specific
generator.

**Update (2026-09-09, issue #68): that capability is now reachable, has been
spent, and the answer is "it helps, and it is not the thing that was holding
the nets."** klayout-tools#1502 and #1501 both closed 2026-09-06, this repo's
pin moved to `8bd3f0b0`, and `dplus_pullup.json` now carries
`routing.cross_block_layer_role: "metal2"` (primary `layer_role` stays
`metal`). What that measurably bought, against the 6/21 baseline:

- The **entire** same-drawing-layer-short rejection class is gone — **540
  rejected legs → 0**. Routed legs go 114 → **168** (+47%), total routed
  length 1317 → 1427 µm, and two nets (`DP`, `NODE0`) move from `unrouted` to
  `partial`. The fallback is demonstrably running, not merely accepted: a
  `NODE2` leg is now rejected with "crosses already-routed net 'NODE1' — a
  bounded same-block cross-layer detour (4 alternate lanes looped clear of
  the block's own bbox) was tried first, and each one still conflicted".
- The **`via1.width.1` objection to second-metal routing is retired**, and
  checked properly rather than by a bare zero: `klt drc`'s
  `coverage.layers_checked` now reaches `35/0` (via1) and `36/0` (metal2)
  where it previously stopped at `34/0` (metal1), so those rules actually
  ran — and the full violation array is still `[]`. The 284 sub-minimum vias
  above are a fixed bug, not a standing constraint.
- **The routed-*net* count does not move. `dplus_pullup` is still 6/21.**
  Every one of the 15 remaining nets is blocked by
  [klayout-tools#1531](https://github.com/2AMLogic/klayout-tools/issues/1531)
  (a generated array's own footprint is an opaque obstacle, so an
  interior-row pin is unreachable for any net) and/or
  [klayout-tools#1467](https://github.com/2AMLogic/klayout-tools/issues/1467)
  (no track or layer allocation *between* nets, so whichever net routes first
  rejects the rest) — both already open upstream, neither re-filed. The
  per-net table with the router's verbatim rejection text is in record
  `20260909-215500-29c5780`.
- One new constraint surfaced and is filed as
  [klayout-tools#1620](https://github.com/2AMLogic/klayout-tools/issues/1620):
  `routing` has a single `width_um` validated against the *stricter* of the
  two planes, so naming a `metal2` cross plane forces every `metal1` route in
  the block from 0.23 to 0.28 µm. The committed plan pays that (0.28 µm is
  still ≥ the metal1 minimum and the result is DRC-clean) — a density cost,
  not a correctness one.

`spacing_um` and `orientation` were re-swept because the new field could have
moved their optimum, and one had moved: `spacing_um` no longer discriminates
at all (2.0–5.0 µm are now *all* 6/21 and DRC-clean, so the 2.0 µm
`metal1.space.1` cliff recorded in `20260905-233520-2eca93d` is gone), and
`orientation` now gives 6/21 DRC-clean for both the default and `mirror_y`,
with `mirror_x`/`rotate_180` at 5/21 and 22 violations. Both keep their
committed values, now on current evidence rather than stale evidence. The
all-`metal2` primary probe was re-run too and is **still rejected — but on
better grounds**: it is DRC-clean now, and simply routes fewer legs
(123/1138 vs 168/769) at the same 6/21.

**A regression, found only because the same inputs were run twice — filed,
closed as refuted, re-confirmed to still reproduce, and finally root-caused
to this repo's own plans (2026-09-05, issue #62).** The story, in order,
because each step is recorded and none of them is deleted:

1. The three blocks went from DRC-clean to 19/22/22 `metal1.width.1`
   violations across a `klt` pin bump over byte-identical inputs. Per
   `gen-compose.md`, a partially-routable net's *accepted* legs are now kept
   in the output (klayout-tools#1169), where the pre-fix `klt` drew nothing
   for a rejected leg — so the new violations are drawn route geometry, and
   none of them come from device generation or placement. That much was, and
   remains, correct.
2. The mechanism this repo inferred for them — that a **rejected** leg
   leaves behind a mitered dead end tapering to zero width — was wrong. It
   was filed generically as
   [klayout-tools#1424](https://github.com/2AMLogic/klayout-tools/issues/1424)
   and **closed `NOT_PLANNED` on 2026-08-26**: the maintainer's direct source
   inspection found no `kdb.Polygon`/miter construction in `gen_compose.py`
   and every rejected leg's `points_um` `None` before the GDS writer runs.
   That refutation was right.
3. Issue #61's 2026-09-05 re-measurement then found the violations still
   reproduce byte-for-byte against the exact inspected commit — correctly
   recording that the refutation had settled the claimed mechanism without
   making the symptom go away
   (`verification/records/analog-layout/records/20260905-200628-80cb14c.md`).
4. Issue #62 root-caused it: the violating shapes are ordinary route
   segments drawn at klt's default `routing.width_um` of **0.17 µm**, below
   the `gf180mcu` deck's own **0.23 µm** `metal1.width.1` minimum. Setting a
   legal width on the identical plan documents clears every violation on all
   three blocks (19 → 0, 22 → 0, 22 → 0) with unchanged 0/N routed-net
   counts — see "Route width" above and record
   `20260905-233520-2eca93d`. The refuted miter theory and the real
   parameter bug were about different things, which is why both the
   maintainer's inspection and this repo's re-measurement were each right on
   their own terms.
5. Issue #65 committed the fix #62 had only probed: an explicit
   `routing: {"layer_role": "metal", "width_um": 0.23}` block added to
   `differential_receiver.json`, `se_receiver_dm.json`, and
   `se_receiver_dp.json` themselves. Re-executing the now-committed plans
   reproduces the probe exactly — 0 violations, 0/8, 0/9, 0/9 routed-net
   counts unchanged — see record `20260906-004835-90e442a`. The DRC-clean
   column of the table above is no longer a probe result; it is what the
   committed plans produce.

6. The tool-side gap behind the whole episode — klt validating neither the
   requested route width nor its hard-coded via-drop size against the
   resolved deck it will later be judged by — was filed generically as
   [klayout-tools#1501](https://github.com/2AMLogic/klayout-tools/issues/1501)
   and **closed `COMPLETED` 2026-09-06**. Issue #68's pin move to `8bd3f0b0`
   consumed it and re-measured: both floors are now enforced, a too-narrow
   request fails loudly naming the rule and the required value, and the
   via-drop half of it is confirmed by a `dplus_pullup` that is DRC-clean
   with `via1`/`metal2` rules actually running. This repo's committed plans
   never needed it fixed to be DRC-clean — they just needed a legal literal
   value — but the class of mistake it allowed is now impossible to make
   silently.

### Why nothing routed — root causes, not guesses (as diagnosed 2026-08-18)

**This section is the original diagnosis and is now partly historical** —
per "Friction filed" above, classes 1 and 3 have shipped fixes upstream
(an `orientation` field, and a real `metal2` bus role) that this repo's
committed plans do not yet use. Kept verbatim because it is still the
correct account of why the *committed* plans read the way they do, and
because classes 2 and 4 are unconfirmed either way (not re-tested, since
the routed-net count didn't move — see "What actually happened").

Every failure is reported by klt itself in the response's
`nets[].legs[].reason`; the frozen JSON responses are in the evidence
record's `artifacts/`. Four distinct classes, none of them a plan-authoring
mistake:

1. **A same-facing port pair cannot be connected — including a plain CMOS
   inverter.** Every `mos_array` block exposes `U0_S` on its left edge and
   `U0_D` on its right, with no orientation/mirror field anywhere in the plan
   or `gen-compose` contract. A two-block plan (one nfet, one pfet) routes
   the shared *gate* net and fails the shared *drain* net, because the route
   would have to re-enter one of its own endpoint blocks. Both receiver
   blocks' output stages are exactly that inverter.
2. **No obstacle avoidance.** Any net whose endpoints are not immediate
   neighbours fails with "crosses N µm through unrelated block X's bbox …
   the route is not point-to-point between only the two connected blocks".
   Sweeping placement (1/2/4/6/13 groups per row × 2/10/20/30 µm spacing)
   never moved the routed-net count off 0 — a real netlist is not a
   Hamiltonian path over its devices.
3. **Single drawing layer, so `VDD`/`VSS`/bias buses short.** A net touching
   several blocks fails with "bussing this net across the block would draw a
   silent short to that pad; route to a `layer_role` with a metal2/via stack
   instead" — and no such two-layer role exists in `gen-compose` today.
4. **One failed leg fails the whole net**, discarding the geometry of legs
   that were individually routable.

Two further gaps surfaced in the same exercise, and are why the committed
plans look the way they do:

- **`rows[]` stacking has no inter-row margin.** Multi-row placement puts
  vertically adjacent groups at 0.00 µm and only *warns* that this is closer
  than the blocks' own declared `drc_hints.min_spacing_um`. The committed
  plans therefore use a single row — which is also why the placement DRC
  comes back clean.
- **`diff_pair`'s netlist-derived sizing ignores `params.splits`**, drawing
  each matched device `splits ×` (default 2×) its schematic width, with no
  warning. That is why the plans use one `mos_array` group per device rather
  than grouping the genuinely matched pairs (input pair, load pair) into
  `diff_pair` groups, which is what a hand layout would do.

### Friction filed

Per `CLAUDE.md`'s friction protocol, each gap is filed generically against
the tool, not this design. **Update (issue #52, 2026-08-26): all three
below are now `CLOSED`/`COMPLETED` upstream** (closed 2026-08-18, the same
day they were filed) — `layout/analog/plans/` and this repo's `klt` pin
were advanced to `07b1f04f` specifically to consume the fixes (see
"What actually happened" above for why the routed-net count didn't move
regardless, and klayout-tools#1424 for a regression the same
re-measurement surfaced, closed `NOT_PLANNED` as of 2026-08-26 and
re-confirmed as of 2026-09-05, per the entry below, to still reproduce):

- [klayout-tools#1163](https://github.com/2AMLogic/klayout-tools/issues/1163)
  (closed) — `layout_plan`'s `netlist` block silently dropped `device_map`.
  Fixed: `device_map` now threads through. Does **not** unblock
  `differential_driver` — the fix is explicitly MOS-shaped-4-terminal only,
  and `rm1` is a 2-terminal metal resistor.
- [klayout-tools#1164](https://github.com/2AMLogic/klayout-tools/issues/1164)
  (closed, decomposed into #1166–#1170, all closed) — Phase C routed 0/N
  nets on a real full-custom block. Fixed: a `device_groups[]`/`blocks[]`
  `orientation` field (mirror/rotate) and a real two-layer
  `routing.layer_role: "metal2"` bus role (with via-drop) now exist. Both
  are opt-in and unused by the committed plans — see above.
- [klayout-tools#1165](https://github.com/2AMLogic/klayout-tools/issues/1165)
  (closed) — `diff_pair` netlist-derived sizing ignored `params.splits`.
  Fixed upstream; not exercised here since the committed plans use
  `mos_array`, not `diff_pair`, for exactly the reason this issue names
  below.
- [klayout-tools#1424](https://github.com/2AMLogic/klayout-tools/issues/1424)
  (filed by issue #52; **closed `NOT_PLANNED` 2026-08-26 — correctly
  refuted, and its claimed mechanism is now known to be wrong**) — it
  attributed the 19/22/22 `metal1.width.1` violations to a rejected
  (`routed: false`) leg leaving mitered dead-end geometry in the output GDS.
  The maintainer's direct source inspection found no such construction, and
  issue #62's 2026-09-05 root-cause confirms the refutation: the violations
  come from this repo's own plans requesting a 0.17 µm route width against a
  deck whose metal1 minimum is 0.23 µm. **Nothing about #1424 needs
  reopening**; the two real tool gaps behind the episode are filed fresh as
  #1501/#1502 below, and the plan-side correction — committing an explicit
  `routing.width_um: 0.23` to the three affected plans — is this repo's
  issue #65, **closed 2026-09-05**: all three blocks are now DRC-clean with
  their routed-net counts unchanged (record `20260906-004835-90e442a`).
- [klayout-tools#1501](https://github.com/2AMLogic/klayout-tools/issues/1501)
  (filed by issue #62; **closed `COMPLETED` 2026-09-06** via PR #1507,
  `8d094b7`; consumed by issue #68's pin move to `8bd3f0b0`) — neither
  `routing.width_um` nor the via-drop square was validated against the
  resolved PDK deck's own minimum-width rules, so `klt` silently drew
  geometry that `klt drc --deck <the same deck>` then rejected. Two instances
  were measured: the documented default routing width (0.17 µm) is below
  `gf180mcu`'s `metal1.width.1` (0.23 µm), and the hard-coded 0.22 µm
  via-drop square is below its `via1.width.1` (0.26 µm), which made
  `routing.layer_role: "metal2"` unable to produce a DRC-clean result on this
  family at all. **Both are fixed and re-measured here**: routing width and
  the via-drop square are now floored at the deck's own minimums, a
  too-narrow request fails loudly instead of drawing silently, and a
  second-metal `dplus_pullup` is DRC-clean with `via1`/`metal2` rules
  actually exercised (record `20260909-215500-29c5780`).
- [klayout-tools#1502](https://github.com/2AMLogic/klayout-tools/issues/1502)
  (filed by issue #62; **closed `COMPLETED` 2026-09-06** via PR #1509,
  `815d8ab`; consumed by issue #68's pin move) — `layout_plan_execute`
  rebuilt `request.routing` from a two-field allow-list
  (`layer_role`/`width_um`), silently dropping every other field
  `gen_compose.compose()` accepts. `cross_block_layer_role` — the field the
  router's own rejection messages tell a plan author to configure when a
  net's backbone would short against a block's own ports — was therefore
  unreachable from a layout plan: adding it changed nothing, with no error
  and no warning. **Fixed**: the field now forwards (and an unknown `routing`
  key is a hard error rather than a silent drop). Spending it on
  `dplus_pullup` eliminates all 540 same-layer-short leg rejections and
  raises routed legs 114 → 168 — see "What actually happened" above — but
  does **not** raise the routed-net count off 6/21, so the earlier reading of
  this as "the single capability most of `dplus_pullup`'s 15 unrouted nets
  are waiting on" was **wrong**, and is corrected by measurement: the nets
  were waiting on #1531 and #1467, below.
- [klayout-tools#1531](https://github.com/2AMLogic/klayout-tools/issues/1531)
  (filed upstream by another consumer, open — **not** filed by this repo, but
  it is the dominant blocker here) — a generated `mos_array`'s own footprint
  is treated as one opaque obstacle, so a pin on any unit device that is not
  on the outermost row relative to the route direction is unreachable for any
  net, even a lone one. All 15 of `dplus_pullup`'s unrouted nets hit this,
  and for `VSS` and `DP`/`NODE0`/`NODE1` it is the *only* thing they hit.
- [klayout-tools#1467](https://github.com/2AMLogic/klayout-tools/issues/1467)
  (filed upstream by another consumer, open) — `gen-compose` has no track or
  layer *allocation* between nets, so whichever net routes first rejects the
  rest. This is what stops the six `NODE*` ladder nodes and `VPU_REG` once
  #1531 is worked around per-leg by the cross-block layer.
- [klayout-tools#1620](https://github.com/2AMLogic/klayout-tools/issues/1620)
  (filed by issue #68, open) — `routing` has exactly one `width_um`, applied
  to both `routing.layer_role` and `routing.cross_block_layer_role` and
  validated against the stricter of the two. Naming a second plane therefore
  silently widens every route on the primary plane, including the majority
  that never use the second plane. There is no way to express "minimum width
  on the primary plane, the cross plane's own minimum on the escape legs".
- [klayout-tools#1621](https://github.com/2AMLogic/klayout-tools/issues/1621)
  (filed by issue #68; **closed via klayout-tools#1640/PR #1662, merge
  `df36f4f`, consumed by issue #70's pin move to `bf90e1d5e3a6`**) — no
  metal-resistor device class existed in the curated decks, so a netlist
  using one could not be ingested at all. **Fixed and consumed**:
  `netlist_digest` now recognises gf180mcu's `rm1`/`rm2`/`rm3` (plus
  `tm6k`/`tm9k`/`tm11k`/`tm30k`), and `differential_driver`'s netlist — the
  only one of the five analog blocks this blocked — ingests cleanly for the
  first time, confirmed live, not assumed (record
  `20260912-191922-5953e89`).
- [klayout-tools#1731](https://github.com/2AMLogic/klayout-tools/issues/1731)
  (filed by issue #70; **closed via PR #1774, merge `1641fa5f`, consumed by
  issue #72's pin move to `61e743088f47`**) — landing #1621's fix had moved
  the blocker one stage downstream rather than clearing it: `klt gen`'s
  `res_array` generator had no drawn-geometry path for a gf180mcu metal
  resistor at all (its `metal_level` mechanism was populated for a
  different PDK family only), and — the sharper half of this gap — a
  `device_groups[]` entry whose declared `device_class` named a
  metal-resistor class but whose `generator`/`flavor` resolved to the
  default poly-body path did not fail; it **silently drew the wrong
  device** (a poly resistor) with no error and no `warnings[]` entry,
  because nothing cross-checked a group's declared device class against
  what its generator actually drew. **Fixed and consumed**: `res_array`'s
  `metal_level` mechanism now covers gf180mcu's `rm1`/`rm2`/`rm3`, and a new
  `_device_class_mismatch_warnings` check appends a `warnings[]` entry
  instead of silently substituting whenever a declared class disagrees with
  what the resolved generator/flavor actually draws. Confirmed directly by
  reading `klt gen`'s own source (`_PDK_METAL_RES_LEVELS`/
  `_PDK_METAL_RES_DEVICE_CLASS` in `gen.py`) and by executing
  `differential_driver`'s committed plan, not assumed — see record
  `20260913-192744-b653c71`. This is why `differential_driver` now has a
  committed plan under `layout/analog/plans/`: `res_array` with an explicit
  `params.metal_level: 1` draws its two series-termination resistors as the
  real `rm1` devices the netlist and LVS both expect, confirmed by direct
  GDS layer inspection. **The new mismatch-warning half of the fix also
  found a second, unrelated, pre-existing bug it was not filed to find**:
  three of the four already-committed plans
  (`differential_receiver.json`'s `r_bias`; `se_receiver_dm.json`/
  `se_receiver_dp.json`'s `r_bias`/`r_1`/`r_2`) declare `device_class:
  "PPOLYF_U_1K"` but never set `params.flavor: "1k"`, so `res_array` has
  been silently drawing the default `"generic"`-flavor `ppolyf_u` body
  instead — the identical mismatch shape `differential_driver`'s `RM1`
  groups had, just on `flavor` instead of `metal_level`, and on
  already-committed plans rather than one that was blocked from being
  committed at all. This is **not** a further `klt` gap (the tool now
  correctly reports it); it is this repo's own plan documents disagreeing
  with the netlist they were written against. Not fixed here — real
  per-block layout work, tracked by
  [gf180-usb2-phy#73](https://github.com/2AMLogic/gf180-usb2-phy/issues/73)
  (see record `20260913-192744-b653c71`'s "Links"). **Fixed 2026-09-14**:
  see the "New finding, ninth run" / "Fixed" update above and item (f)
  below for the corrected state (record `20260914-023747-74372a3`).

The `dplus_pullup` blocker (`nf=10`) was unrelated to any of the above and
was unmoved across the 2026-08-18 and 2026-08-26 runs: a deliberate,
documented refusal in klt's subckt-call conversion, whose own error text
prescribed the fix — "flatten it in the schematic netlist (one device per
drawn gate)". Doing that changes a design source to suit a tool, and the
`sim/` evidence for spec §5 had been taken against the un-flattened
netlist, so it was escalated rather than done unilaterally
([gf180-usb2-phy#56](https://github.com/2AMLogic/gf180-usb2-phy/issues/56)).

**Resolved 2026-09-05.** The operator ruled FLATTEN, conditional on proving
rather than assuming the equivalence — see
`spec/decisions/0001-dplus-pullup-switch-device-flattening.md` for the
ruling, the alternatives that were live, and the conditions attached. The
upstream tool gap is filed generically, per this repo's friction protocol,
as [klayout-tools#1487](https://github.com/2AMLogic/klayout-tools/issues/1487)
(native `nf` expansion, or an explicit conversion mode); if that lands, a
future decision record may restore the idiomatic `nf=10` form.

### What would have to be true to deliver analog layout

**Several of the items this list used to carry have now closed, and closing
them did not deliver a layout** — which is itself the most useful thing this
section records. As of 2026-09-13 (issue #72), what remains is:

(a) **Plans that spend the available capabilities on real per-block layout
decisions** — genuine analog layout design work, not a mechanical re-run.
`dplus_pullup` (issues #62, #68) is the first of these and now shows the full
arc: measured grouping/`spacing_um`/`orientation` choices take it to 6/21
nets routed and DRC-clean, and spending
`routing.cross_block_layer_role: "metal2"` on top of that removes 540 leg
rejections and draws 47% more routed legs — while leaving the routed-*net*
count at exactly 6/21. The three older plans are DRC-clean (issue #65) and
each routes 1 of 8/9/9 at the new pin, which is a pin effect, not a plan
improvement; re-authoring them in `dplus_pullup`'s grouped shape is the
natural next block of work and is deliberately not done here.

(b) **~~klt validating drawn geometry against the deck it will be judged
by~~ — CLOSED.** klayout-tools#1501 landed 2026-09-06 and is consumed at pin
`8bd3f0b0`. Routing width and the via-drop square are floored at the deck's
own minimums, a too-narrow request now fails loudly with the rule and the
required value named, and the 284 × `via1.width.1` that made second-metal
routing DRC-dirty is gone. Nothing in this repo depends on it any more.

(b′) **~~`routing.cross_block_layer_role` reachable from a plan
document~~ — CLOSED.** klayout-tools#1502 landed the same day and is
likewise consumed. It works; it is not what the nets were waiting on.

(c) **~~`differential_driver`'s ingestion blocker resolving via klt
device-class support for metal resistors~~ — CLOSED, and partially
superseded by a narrower successor.** klayout-tools#1621/#1640 closed via
PR #1662 (merge `df36f4f`), consumed by issue #70's pin move to
`bf90e1d5e3a6`: `differential_driver`'s netlist now ingests cleanly, the
only one of the five blocks this ever blocked. What it did *not* buy is a
committed plan — `klt gen`'s `res_array` generator has no drawn-geometry
support for a gf180mcu metal resistor at all, and silently draws the wrong
device instead of failing when a plan's declared `device_class` doesn't
match its generator/flavor's actual output. That successor gap is filed
generically as klayout-tools#1731 and is the new item (c′) below.
`dplus_pullup`'s half of the original item was discharged by the
2026-09-05 flatten above.

(c′) **~~`klt gen` drawing a metal-resistor device for the family whose
extraction side just gained one, and validating that a plan's declared
`device_class` matches what its generator actually draws~~ — CLOSED.**
klayout-tools#1731 closed via PR #1774 (merge `1641fa5f`), consumed by
issue #72's pin move to `61e743088f47`: `res_array` now draws real
`Metal1`/`Via1`/`Metal2` geometry for a `metal_level`-scoped gf180mcu
resistor, and `differential_driver.json` (issue #72) is committed with an
explicit `params.metal_level: 1` on both `RM1` groups, confirmed to draw
the correct device by direct GDS layer inspection, not assumed. All five
analog blocks now have a committed plan.

(f) **~~The mismatch-warning half of #1731's fix found a second,
unrelated, pre-existing bug — `flavor` overrides missing on three
already-committed plans' `PPOLYF_U_1K`-declared resistors~~ — CLOSED.**
`differential_receiver.json`'s `r_bias` group and
`se_receiver_dm.json`/`se_receiver_dp.json`'s `r_bias`/`r_1`/`r_2` groups
declared `device_class: "PPOLYF_U_1K"` (matching the netlist) but never set
`params.flavor: "1k"`, so they had been silently drawing the default
`"generic"`-flavor `ppolyf_u` body instead — present since before issue
#72's pin move, only made visible by it. Not a `klt` gap (the tool
correctly reported it); this repo's own plan documents needed a
one-field-per-group fix plus re-verification. **Fixed by
[gf180-usb2-phy#73](https://github.com/2AMLogic/gf180-usb2-phy/issues/73)**:
all seven groups now carry `params.flavor: "1k"`, confirmed by direct GDS
layer inspection to draw `ppolyf_u_1k` (not `ppolyf_u`), with the
`_device_class_mismatch_warnings` check now reporting zero entries on all
three plans and DRC/routed-net counts/bboxes unchanged (see record
`20260914-023747-74372a3`, superseding `20260913-192744-b653c71`'s
still-open finding).

(d) **New, and now the actual critical path: routing that can reach into a
generated array and can allocate space between nets.** Every one of
`dplus_pullup`'s 15 unrouted nets is blocked by klayout-tools#1531 (an
array's own footprint is an opaque obstacle, so interior-row pins are
unreachable) and/or klayout-tools#1467 (no inter-net track/layer allocation,
so the first-routed net rejects the rest). Both are open upstream and neither
is something a plan document can route around — which is precisely the
finding that spending #1502 produced.

(e) **Minor, and cheap to live with**: klayout-tools#1620 — one `width_um`
for two routing planes, so enabling the cross plane widens the primary
plane's routing. Costs density, not correctness.

None of this is a bespoke block-specific layout generator in the shape of
[`gf180-bandgap`](https://github.com/2AMLogic/gf180-bandgap)'s
`generate.py`/`plan.py` — that remains explicitly out of scope; this record
exists so that as each piece above closes, re-measuring is one command
rather than a re-derivation. Items (b) and (b′) closing on 2026-09-06 and
being re-measured on 2026-09-09 by exactly that one command is the
demonstration that it works.
