2AMLogic/gf180-usb2-phy/verification/records/post-layout-pvt/artifacts/20261008-195826-74ccfac/annotation-probe/probe-ff_n40C_5v50-hub-repaired.txt

OpenROAD 26Q3-1260-g06a5a02279 
Features included (+) or not (-): +GPU +GUI +Python
This program is licensed under the BSD-3 license. See the LICENSE file for details.
Components of this program may be licensed under more restrictive licenses which must be honored.
[INFO ODB-0388] unsupported LEF58_EOLENCLOSURE property for layer Via1 :"
  	EOLENCLOSURE 0.34 0.06 ;"
[INFO ODB-0388] unsupported LEF58_EOLENCLOSURE property for layer Via2 :" EOLENCLOSURE 0.34 0.06 ; "
[INFO ODB-0388] unsupported LEF58_EOLENCLOSURE property for layer Via3 :" EOLENCLOSURE 0.34 0.06 ; "
[INFO ODB-0388] unsupported LEF58_EOLENCLOSURE property for layer Via4 :" EOLENCLOSURE 0.34 0.06 ; "
[INFO ODB-0227] LEF file: /home/ubuntu/.volare/gf180mcuD/libs.ref/gf180mcu_fd_sc_mcu9t5v0/techlef/gf180mcu_fd_sc_mcu9t5v0__nom.tlef, created 15 layers, 56 vias
[WARNING ODB-0220] WARNING (LEFPARS-2008): NOWIREEXTENSIONATPIN statement is obsolete in version 5.6 or later.
The NOWIREEXTENSIONATPIN statement will be ignored. See file /home/ubuntu/.volare/gf180mcuD/libs.ref/gf180mcu_fd_sc_mcu9t5v0/lef/gf180mcu_fd_sc_mcu9t5v0.lef at line 2.

[INFO ODB-0227] LEF file: /home/ubuntu/.volare/gf180mcuD/libs.ref/gf180mcu_fd_sc_mcu9t5v0/lef/gf180mcu_fd_sc_mcu9t5v0.lef, created 229 library cells
[INFO ODB-0127] Reading DEF file: layout/digital/usb_utmi_phy.def
[INFO ODB-0128] Design: usb_utmi_phy
[INFO ODB-0130]     Created 37 pins.
[INFO ODB-0131]     Created 1121 components and 5406 component-terminals.
[INFO ODB-0132]     Created 2 special nets and 4308 connections.
[INFO ODB-0133]     Created 340 nets and 1091 connections.
[INFO ODB-0134] Finished DEF file: layout/digital/usb_utmi_phy.def
===PROBE_PRE_BEGIN===
Startpoint: _340_ (rising edge-triggered flip-flop clocked by clk)
Endpoint: _340_ (rising edge-triggered flip-flop clocked by clk)
Path Group: clk
Path Type: min

    Delay      Time   Description
-------------------------------------------------------------
   0.0000    0.0000   clock clk (rise edge)
   0.0000    0.0000   clock network delay (ideal)
   0.0000    0.0000 ^ _340_/CLK (gf180mcu_fd_sc_mcu9t5v0__dffq_1)
   0.4096    0.4096 ^ _340_/Q (gf180mcu_fd_sc_mcu9t5v0__dffq_1)
   0.0611    0.4707 v _272_/ZN (gf180mcu_fd_sc_mcu9t5v0__aoi21_1)
   0.0000    0.4707 v _340_/D (gf180mcu_fd_sc_mcu9t5v0__dffq_1)
             0.4707   data arrival time

   0.0000    0.0000   clock clk (rise edge)
   0.0000    0.0000   clock network delay (ideal)
   0.0000    0.0000   clock reconvergence pessimism
             0.0000 ^ _340_/CLK (gf180mcu_fd_sc_mcu9t5v0__dffq_1)
   0.0650    0.0650   library hold time
             0.0650   data required time
-------------------------------------------------------------
             0.0650   data required time
            -0.4707   data arrival time
-------------------------------------------------------------
             0.4057   slack (MET)

Startpoint: _344_ (rising edge-triggered flip-flop clocked by clk)
Endpoint: _319_ (rising edge-triggered flip-flop clocked by clk)
Path Group: clk
Path Type: max

    Delay      Time   Description
-------------------------------------------------------------
   0.0000    0.0000   clock clk (rise edge)
   0.0000    0.0000   clock network delay (ideal)
   0.0000    0.0000 ^ _344_/CLK (gf180mcu_fd_sc_mcu9t5v0__dffq_1)
   0.7874    0.7874 ^ _344_/Q (gf180mcu_fd_sc_mcu9t5v0__dffq_1)
   0.0338    0.8211 v _202_/ZN (gf180mcu_fd_sc_mcu9t5v0__nand2_1)
   0.6191    1.4402 ^ _203_/ZN (gf180mcu_fd_sc_mcu9t5v0__nor4_1)
   0.1316    1.5718 v u_stuffer/_15_/ZN (gf180mcu_fd_sc_mcu9t5v0__nor2_4)
   0.3047    1.8764 ^ u_stuffer/_16_/ZN (gf180mcu_fd_sc_mcu9t5v0__nand4_4)
   0.2276    2.1041 ^ _280_/Z (gf180mcu_fd_sc_mcu9t5v0__mux2_1)
   0.1932    2.2973 v _281_/ZN (gf180mcu_fd_sc_mcu9t5v0__oai221_2)
   0.3044    2.6017 v _282_/Z (gf180mcu_fd_sc_mcu9t5v0__or3_2)
   0.1254    2.7271 ^ _285_/ZN (gf180mcu_fd_sc_mcu9t5v0__aoi211_2)
   0.0000    2.7271 ^ _319_/D (gf180mcu_fd_sc_mcu9t5v0__dffq_1)
             2.7271   data arrival time

  83.3330   83.3330   clock clk (rise edge)
   0.0000   83.3330   clock network delay (ideal)
   0.0000   83.3330   clock reconvergence pessimism
            83.3330 ^ _319_/CLK (gf180mcu_fd_sc_mcu9t5v0__dffq_1)
  -0.1428   83.1902   library setup time
            83.1902   data required time
-------------------------------------------------------------
            83.1902   data required time
            -2.7271   data arrival time
-------------------------------------------------------------
            80.4631   slack (MET)

===PROBE_PRE_END===
[WARNING STA-1650] flow/.klt/probe/repaired.spef line 53, net $1008 not found.
[WARNING STA-1650] flow/.klt/probe/repaired.spef line 76, net $1011 not found.
[WARNING STA-1650] flow/.klt/probe/repaired.spef line 92, net $1012 not found.
[WARNING STA-1650] flow/.klt/probe/repaired.spef line 104, net $1013 not found.
[WARNING STA-1650] flow/.klt/probe/repaired.spef line 117, net $1014 not found.
[WARNING STA-1650] flow/.klt/probe/repaired.spef line 129, net $1015 not found.
[WARNING STA-1650] flow/.klt/probe/repaired.spef line 141, net $1016 not found.
[WARNING STA-1650] flow/.klt/probe/repaired.spef line 153, net $1018 not found.
[WARNING STA-1650] flow/.klt/probe/repaired.spef line 169, net $1019 not found.
[WARNING STA-1650] flow/.klt/probe/repaired.spef line 186, net $1020 not found.
[WARNING STA-1650] flow/.klt/probe/repaired.spef line 201, net $1021 not found.
[WARNING STA-1650] flow/.klt/probe/repaired.spef line 216, net $1022 not found.
[WARNING STA-1650] flow/.klt/probe/repaired.spef line 230, net $1023 not found.
[WARNING STA-1650] flow/.klt/probe/repaired.spef line 243, net $1024 not found.
[WARNING STA-1650] flow/.klt/probe/repaired.spef line 255, net $1027 not found.
[WARNING STA-1650] flow/.klt/probe/repaired.spef line 272, net $1028 not found.
[WARNING STA-1650] flow/.klt/probe/repaired.spef line 289, net $1029 not found.
[WARNING STA-1650] flow/.klt/probe/repaired.spef line 303, net $1030 not found.
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
[WARNING STA-1650] flow/.klt/probe/repaired.spef line 8614, net $949 not found.
[WARNING STA-1650] flow/.klt/probe/repaired.spef line 8627, net $950 not found.
[WARNING STA-1650] flow/.klt/probe/repaired.spef line 8639, net $951 not found.
[WARNING STA-1650] flow/.klt/probe/repaired.spef line 8653, net $953 not found.
[WARNING STA-1650] flow/.klt/probe/repaired.spef line 8668, net $955 not found.
[WARNING STA-1650] flow/.klt/probe/repaired.spef line 8683, net $956 not found.
[WARNING STA-1650] flow/.klt/probe/repaired.spef line 8697, net $957 not found.
[WARNING STA-1650] flow/.klt/probe/repaired.spef line 8710, net $958 not found.
[WARNING STA-1650] flow/.klt/probe/repaired.spef line 8725, net $961 not found.
[WARNING STA-1650] flow/.klt/probe/repaired.spef line 8744, net $962 not found.
[WARNING STA-1650] flow/.klt/probe/repaired.spef line 8759, net $963 not found.
[WARNING STA-1650] flow/.klt/probe/repaired.spef line 8774, net $964 not found.
[WARNING STA-1650] flow/.klt/probe/repaired.spef line 8786, net $965 not found.
[WARNING STA-1650] flow/.klt/probe/repaired.spef line 8798, net $985 not found.
[WARNING STA-1650] flow/.klt/probe/repaired.spef line 8810, net $986 not found.
[WARNING STA-1650] flow/.klt/probe/repaired.spef line 8822, net $987 not found.
[WARNING STA-1650] flow/.klt/probe/repaired.spef line 8833, net $99 not found.
[WARNING STA-1650] flow/.klt/probe/repaired.spef line 9340, net ZN not found.
[WARNING STA-1650] flow/.klt/probe/repaired.spef line 16620, net ZN not found.
[WARNING STA-1650] flow/.klt/probe/repaired.spef line 16647, net ZN not found.
[WARNING STA-1650] flow/.klt/probe/repaired.spef line 16682, net ZN not found.
[WARNING STA-1650] flow/.klt/probe/repaired.spef line 16717, net ZN not found.
[WARNING STA-1650] flow/.klt/probe/repaired.spef line 16744, net ZN not found.
[WARNING STA-1650] flow/.klt/probe/repaired.spef line 16771, net ZN not found.
[WARNING STA-1650] flow/.klt/probe/repaired.spef line 16796, net ZN not found.
===PROBE_ANNOTATION_BEGIN===
Found 7 unannotated drivers.
 clkload0/ZN
 clkload1/ZN
 clkload2/ZN
 clkload3/ZN
 clkload4/ZN
 clkload5/ZN
 clkload6/ZN
Found 3 partially unannotated drivers.
 _341_/Q
  RxActive
 u_line_state/_6_/Q
  LineState[0]
 u_line_state/_7_/Q
  LineState[1]
===PROBE_ANNOTATION_END===
===PROBE_POST_BEGIN===
Startpoint: _340_ (rising edge-triggered flip-flop clocked by clk)
Endpoint: _340_ (rising edge-triggered flip-flop clocked by clk)
Path Group: clk
Path Type: min

    Delay      Time   Description
-------------------------------------------------------------
   0.0000    0.0000   clock clk (rise edge)
   0.0000    0.0000   clock network delay (ideal)
   0.0000    0.0000 ^ _340_/CLK (gf180mcu_fd_sc_mcu9t5v0__dffq_1)
   0.4290    0.4290 ^ _340_/Q (gf180mcu_fd_sc_mcu9t5v0__dffq_1)
   0.0698    0.4987 v _272_/ZN (gf180mcu_fd_sc_mcu9t5v0__aoi21_1)
   0.0000    0.4987 v _340_/D (gf180mcu_fd_sc_mcu9t5v0__dffq_1)
             0.4987   data arrival time

   0.0000    0.0000   clock clk (rise edge)
   0.0000    0.0000   clock network delay (ideal)
   0.0000    0.0000   clock reconvergence pessimism
             0.0000 ^ _340_/CLK (gf180mcu_fd_sc_mcu9t5v0__dffq_1)
   0.0640    0.0640   library hold time
             0.0640   data required time
-------------------------------------------------------------
             0.0640   data required time
            -0.4987   data arrival time
-------------------------------------------------------------
             0.4347   slack (MET)

Startpoint: _344_ (rising edge-triggered flip-flop clocked by clk)
Endpoint: _319_ (rising edge-triggered flip-flop clocked by clk)
Path Group: clk
Path Type: max

    Delay      Time   Description
-------------------------------------------------------------
   0.0000    0.0000   clock clk (rise edge)
   0.0000    0.0000   clock network delay (ideal)
   0.0000    0.0000 ^ _344_/CLK (gf180mcu_fd_sc_mcu9t5v0__dffq_1)
   0.9002    0.9002 ^ _344_/Q (gf180mcu_fd_sc_mcu9t5v0__dffq_1)
   0.0367    0.9369 v _202_/ZN (gf180mcu_fd_sc_mcu9t5v0__nand2_1)
   0.7367    1.6736 ^ _203_/ZN (gf180mcu_fd_sc_mcu9t5v0__nor4_1)
   0.1459    1.8196 v u_stuffer/_15_/ZN (gf180mcu_fd_sc_mcu9t5v0__nor2_4)
   0.3540    2.1736 ^ u_stuffer/_16_/ZN (gf180mcu_fd_sc_mcu9t5v0__nand4_4)
   0.2467    2.4203 ^ _280_/Z (gf180mcu_fd_sc_mcu9t5v0__mux2_1)
   0.2175    2.6378 v _281_/ZN (gf180mcu_fd_sc_mcu9t5v0__oai221_2)
   0.3217    2.9595 v _282_/Z (gf180mcu_fd_sc_mcu9t5v0__or3_2)
   0.1378    3.0973 ^ _285_/ZN (gf180mcu_fd_sc_mcu9t5v0__aoi211_2)
   0.0000    3.0973 ^ _319_/D (gf180mcu_fd_sc_mcu9t5v0__dffq_1)
             3.0973   data arrival time

  83.3330   83.3330   clock clk (rise edge)
   0.0000   83.3330   clock network delay (ideal)
   0.0000   83.3330   clock reconvergence pessimism
            83.3330 ^ _319_/CLK (gf180mcu_fd_sc_mcu9t5v0__dffq_1)
  -0.1437   83.1893   library setup time
            83.1893   data required time
-------------------------------------------------------------
            83.1893   data required time
            -3.0973   data arrival time
-------------------------------------------------------------
            80.0919   slack (MET)

===PROBE_POST_END===
===PROBE_NET_BEGIN===
Net _013_
 Pin capacitance: 0.0106
 Wire capacitance: 0.0025
 Total capacitance: 0.0130
 Number of drivers: 1
 Number of loads: 1
 Number of pins: 2

Driver pins
 _191_/Z output (gf180mcu_fd_sc_mcu9t5v0__mux2_1) (111, 93)

Load pins
 u_encoder/_4_/A1 input (gf180mcu_fd_sc_mcu9t5v0__xor2_2) 0.0106 (102, 94)

Net rx_receiving
 Pin capacitance: 0.1153
 Wire capacitance: 0.0289
 Total capacitance: 0.1442
 Number of drivers: 1
 Number of loads: 10
 Number of pins: 11

Driver pins
 _341_/Q output (gf180mcu_fd_sc_mcu9t5v0__dffq_1) (85, 83)

Load pins
 RxActive output port (80, 186)
 _148_/I input (gf180mcu_fd_sc_mcu9t5v0__clkinv_1) 0.0056 (76, 77)
 _209_/A1 input (gf180mcu_fd_sc_mcu9t5v0__nand2_2) 0.0128 (41, 144)
 _218_/A1 input (gf180mcu_fd_sc_mcu9t5v0__and4_4) 0.0115 (36, 138)
 _271_/C input (gf180mcu_fd_sc_mcu9t5v0__oai211_1) 0.0060 (38, 124)
 u_destuffer/_19_/A1 input (gf180mcu_fd_sc_mcu9t5v0__aoi21_4) 0.0280 (41, 114)
 u_destuffer/_20_/A2 input (gf180mcu_fd_sc_mcu9t5v0__and4_1) 0.0034 (45, 108)
 u_destuffer/_21_/A1 input (gf180mcu_fd_sc_mcu9t5v0__and3_2) 0.0063 (35, 118)
 u_destuffer/_22_/A2 input (gf180mcu_fd_sc_mcu9t5v0__aoi21_2) 0.0140 (36, 114)
 u_destuffer/_24_/A2 input (gf180mcu_fd_sc_mcu9t5v0__aoi21_4) 0.0277 (33, 88)

Net line_state[0]
 Pin capacitance: 0.0222
 Wire capacitance: 0.0106
 Total capacitance: 0.0328
 Number of drivers: 1
 Number of loads: 4
 Number of pins: 5

Driver pins
 u_line_state/_6_/Q output (gf180mcu_fd_sc_mcu9t5v0__dffq_1) (105, 154)

Load pins
 LineState[0] output port (108, 186)
 _172_/I input (gf180mcu_fd_sc_mcu9t5v0__clkinv_1) 0.0056 (88, 108)
 _174_/A1 input (gf180mcu_fd_sc_mcu9t5v0__xor2_1) 0.0106 (87, 104)
 u_eop_detector/_27_/A1 input (gf180mcu_fd_sc_mcu9t5v0__nor2_1) 0.0061 (93, 98)

Net line_state[1]
 Pin capacitance: 0.0215
 Wire capacitance: 0.0113
 Total capacitance: 0.0328
 Number of drivers: 1
 Number of loads: 4
 Number of pins: 5

Driver pins
 u_line_state/_7_/Q output (gf180mcu_fd_sc_mcu9t5v0__dffq_1) (108, 164)

Load pins
 LineState[1] output port (109, 186)
 _173_/A2 input (gf180mcu_fd_sc_mcu9t5v0__nor2_1) 0.0057 (85, 98)
 _174_/A2 input (gf180mcu_fd_sc_mcu9t5v0__xor2_1) 0.0100 (88, 103)
 u_eop_detector/_27_/A2 input (gf180mcu_fd_sc_mcu9t5v0__nor2_1) 0.0057 (92, 98)

===PROBE_NET_END===
worst slack max 80.0919
worst slack min 0.4347
