2AMLogic/gf180-usb2-phy/verification/records/post-layout-pvt/artifacts/20261008-195826-74ccfac/annotation-probe/probe-ss_125C_1v62-hub-repaired.txt

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

    Delay      Time   Description
-------------------------------------------------------------
   0.0000    0.0000   clock clk (rise edge)
   0.0000    0.0000   clock network delay (ideal)
   0.0000    0.0000 ^ _340_/CLK (gf180mcu_fd_sc_mcu9t5v0__dffq_1)
   5.3377    5.3377 ^ _340_/Q (gf180mcu_fd_sc_mcu9t5v0__dffq_1)
   1.0997    6.4374 v _272_/ZN (gf180mcu_fd_sc_mcu9t5v0__aoi21_1)
   0.0000    6.4374 v _340_/D (gf180mcu_fd_sc_mcu9t5v0__dffq_1)
             6.4374   data arrival time

   0.0000    0.0000   clock clk (rise edge)
   0.0000    0.0000   clock network delay (ideal)
   0.0000    0.0000   clock reconvergence pessimism
             0.0000 ^ _340_/CLK (gf180mcu_fd_sc_mcu9t5v0__dffq_1)
   0.5373    0.5373   library hold time
             0.5373   data required time
-------------------------------------------------------------
             0.5373   data required time
            -6.4374   data arrival time
-------------------------------------------------------------
             5.9001   slack (MET)

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

    Delay      Time   Description
-------------------------------------------------------------
   0.0000    0.0000   clock clk (rise edge)
   0.0000    0.0000   clock network delay (ideal)
   0.0000    0.0000 ^ _344_/CLK (gf180mcu_fd_sc_mcu9t5v0__dffq_1)
   9.3263    9.3263 ^ _344_/Q (gf180mcu_fd_sc_mcu9t5v0__dffq_1)
   2.0516   11.3778 v _202_/ZN (gf180mcu_fd_sc_mcu9t5v0__nand2_1)
  10.6256   22.0034 ^ _203_/ZN (gf180mcu_fd_sc_mcu9t5v0__nor4_1)
   3.2811   25.2845 v u_stuffer/_15_/ZN (gf180mcu_fd_sc_mcu9t5v0__nor2_4)
   3.7590   29.0435 ^ u_stuffer/_16_/ZN (gf180mcu_fd_sc_mcu9t5v0__nand4_4)
   3.3878   32.4313 ^ _280_/Z (gf180mcu_fd_sc_mcu9t5v0__mux2_1)
   2.4096   34.8409 v _281_/ZN (gf180mcu_fd_sc_mcu9t5v0__oai221_2)
   5.6913   40.5322 v _282_/Z (gf180mcu_fd_sc_mcu9t5v0__or3_2)
   2.2726   42.8048 ^ _285_/ZN (gf180mcu_fd_sc_mcu9t5v0__aoi211_2)
   0.0000   42.8048 ^ _319_/D (gf180mcu_fd_sc_mcu9t5v0__dffq_1)
            42.8048   data arrival time

  83.3330   83.3330   clock clk (rise edge)
   0.0000   83.3330   clock network delay (ideal)
   0.0000   83.3330   clock reconvergence pessimism
            83.3330 ^ _319_/CLK (gf180mcu_fd_sc_mcu9t5v0__dffq_1)
  -2.7378   80.5952   library setup time
            80.5952   data required time
-------------------------------------------------------------
            80.5952   data required time
           -42.8048   data arrival time
-------------------------------------------------------------
            37.7904   slack (MET)

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

    Delay      Time   Description
-------------------------------------------------------------
   0.0000    0.0000   clock clk (rise edge)
   0.0000    0.0000   clock network delay (ideal)
   0.0000    0.0000 ^ _340_/CLK (gf180mcu_fd_sc_mcu9t5v0__dffq_1)
   5.5726    5.5726 ^ _340_/Q (gf180mcu_fd_sc_mcu9t5v0__dffq_1)
   1.2723    6.8449 v _272_/ZN (gf180mcu_fd_sc_mcu9t5v0__aoi21_1)
   0.0000    6.8449 v _340_/D (gf180mcu_fd_sc_mcu9t5v0__dffq_1)
             6.8449   data arrival time

   0.0000    0.0000   clock clk (rise edge)
   0.0000    0.0000   clock network delay (ideal)
   0.0000    0.0000   clock reconvergence pessimism
             0.0000 ^ _340_/CLK (gf180mcu_fd_sc_mcu9t5v0__dffq_1)
   0.5125    0.5125   library hold time
             0.5125   data required time
-------------------------------------------------------------
             0.5125   data required time
            -6.8449   data arrival time
-------------------------------------------------------------
             6.3324   slack (MET)

Startpoint: _344_ (rising edge-triggered flip-flop clocked by clk)
Endpoint: _305_ (rising edge-triggered flip-flop clocked by clk)
Path Group: clk
Path Type: max

    Delay      Time   Description
-------------------------------------------------------------
   0.0000    0.0000   clock clk (rise edge)
   0.0000    0.0000   clock network delay (ideal)
   0.0000    0.0000 ^ _344_/CLK (gf180mcu_fd_sc_mcu9t5v0__dffq_1)
  10.6460   10.6460 ^ _344_/Q (gf180mcu_fd_sc_mcu9t5v0__dffq_1)
   2.4620   13.1080 v _202_/ZN (gf180mcu_fd_sc_mcu9t5v0__nand2_1)
  12.8605   25.9685 ^ _203_/ZN (gf180mcu_fd_sc_mcu9t5v0__nor4_1)
   3.8251   29.7936 v u_stuffer/_15_/ZN (gf180mcu_fd_sc_mcu9t5v0__nor2_4)
   4.4142   34.2078 ^ u_stuffer/_16_/ZN (gf180mcu_fd_sc_mcu9t5v0__nand4_4)
   2.6576   36.8654 v _187_/ZN (gf180mcu_fd_sc_mcu9t5v0__nand4_4)
   6.1333   42.9987 ^ _213_/ZN (gf180mcu_fd_sc_mcu9t5v0__aoi22_4)
   2.1654   45.1641 v _241_/ZN (gf180mcu_fd_sc_mcu9t5v0__nor2_1)
   4.1770   49.3411 ^ _242_/ZN (gf180mcu_fd_sc_mcu9t5v0__aoi211_1)
   0.0000   49.3411 ^ _305_/D (gf180mcu_fd_sc_mcu9t5v0__dffq_1)
            49.3411   data arrival time

  83.3330   83.3330   clock clk (rise edge)
   0.0000   83.3330   clock network delay (ideal)
   0.0000   83.3330   clock reconvergence pessimism
            83.3330 ^ _305_/CLK (gf180mcu_fd_sc_mcu9t5v0__dffq_1)
  -3.0905   80.2425   library setup time
            80.2425   data required time
-------------------------------------------------------------
            80.2425   data required time
           -49.3411   data arrival time
-------------------------------------------------------------
            30.9015   slack (MET)

===PROBE_POST_END===
===PROBE_NET_BEGIN===
Net _013_
 Pin capacitance: 0.0096
 Wire capacitance: 0.0025
 Total capacitance: 0.0121
 Number of drivers: 1
 Number of loads: 1
 Number of pins: 2

Driver pins
 _191_/Z output (gf180mcu_fd_sc_mcu9t5v0__mux2_1) (111, 93)

Load pins
 u_encoder/_4_/A1 input (gf180mcu_fd_sc_mcu9t5v0__xor2_2) 0.0096 (102, 94)

Net rx_receiving
 Pin capacitance: 0.1041
 Wire capacitance: 0.0289
 Total capacitance: 0.1329
 Number of drivers: 1
 Number of loads: 10
 Number of pins: 11

Driver pins
 _341_/Q output (gf180mcu_fd_sc_mcu9t5v0__dffq_1) (85, 83)

Load pins
 RxActive output port (80, 186)
 _148_/I input (gf180mcu_fd_sc_mcu9t5v0__clkinv_1) 0.0049 (76, 77)
 _209_/A1 input (gf180mcu_fd_sc_mcu9t5v0__nand2_2) 0.0115 (41, 144)
 _218_/A1 input (gf180mcu_fd_sc_mcu9t5v0__and4_4) 0.0104 (36, 138)
 _271_/C input (gf180mcu_fd_sc_mcu9t5v0__oai211_1) 0.0053 (38, 124)
 u_destuffer/_19_/A1 input (gf180mcu_fd_sc_mcu9t5v0__aoi21_4) 0.0256 (41, 114)
 u_destuffer/_20_/A2 input (gf180mcu_fd_sc_mcu9t5v0__and4_1) 0.0031 (45, 108)
 u_destuffer/_21_/A1 input (gf180mcu_fd_sc_mcu9t5v0__and3_2) 0.0058 (35, 118)
 u_destuffer/_22_/A2 input (gf180mcu_fd_sc_mcu9t5v0__aoi21_2) 0.0127 (36, 114)
 u_destuffer/_24_/A2 input (gf180mcu_fd_sc_mcu9t5v0__aoi21_4) 0.0249 (33, 88)

Net line_state[0]
 Pin capacitance: 0.0199
 Wire capacitance: 0.0106
 Total capacitance: 0.0305
 Number of drivers: 1
 Number of loads: 4
 Number of pins: 5

Driver pins
 u_line_state/_6_/Q output (gf180mcu_fd_sc_mcu9t5v0__dffq_1) (105, 154)

Load pins
 LineState[0] output port (108, 186)
 _172_/I input (gf180mcu_fd_sc_mcu9t5v0__clkinv_1) 0.0049 (88, 108)
 _174_/A1 input (gf180mcu_fd_sc_mcu9t5v0__xor2_1) 0.0096 (87, 104)
 u_eop_detector/_27_/A1 input (gf180mcu_fd_sc_mcu9t5v0__nor2_1) 0.0054 (93, 98)

Net line_state[1]
 Pin capacitance: 0.0195
 Wire capacitance: 0.0113
 Total capacitance: 0.0308
 Number of drivers: 1
 Number of loads: 4
 Number of pins: 5

Driver pins
 u_line_state/_7_/Q output (gf180mcu_fd_sc_mcu9t5v0__dffq_1) (108, 164)

Load pins
 LineState[1] output port (109, 186)
 _173_/A2 input (gf180mcu_fd_sc_mcu9t5v0__nor2_1) 0.0050 (85, 98)
 _174_/A2 input (gf180mcu_fd_sc_mcu9t5v0__xor2_1) 0.0095 (88, 103)
 u_eop_detector/_27_/A2 input (gf180mcu_fd_sc_mcu9t5v0__nor2_1) 0.0050 (92, 98)

===PROBE_NET_END===
worst slack max 30.9015
worst slack min 6.3324
