2AMLogic/gf180-usb2-phy/verification/records/post-layout-pvt/artifacts/20261008-195826-74ccfac/annotation-probe/probe-tt_025C_1v80-hub-repaired.txt

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

    Delay      Time   Description
-------------------------------------------------------------
   0.0000    0.0000   clock clk (rise edge)
   0.0000    0.0000   clock network delay (ideal)
   0.0000    0.0000 ^ _340_/CLK (gf180mcu_fd_sc_mcu9t5v0__dffq_1)
   2.2270    2.2270 ^ _340_/Q (gf180mcu_fd_sc_mcu9t5v0__dffq_1)
   0.4303    2.6574 v _272_/ZN (gf180mcu_fd_sc_mcu9t5v0__aoi21_1)
   0.0000    2.6574 v _340_/D (gf180mcu_fd_sc_mcu9t5v0__dffq_1)
             2.6574   data arrival time

   0.0000    0.0000   clock clk (rise edge)
   0.0000    0.0000   clock network delay (ideal)
   0.0000    0.0000   clock reconvergence pessimism
             0.0000 ^ _340_/CLK (gf180mcu_fd_sc_mcu9t5v0__dffq_1)
   0.2365    0.2365   library hold time
             0.2365   data required time
-------------------------------------------------------------
             0.2365   data required time
            -2.6574   data arrival time
-------------------------------------------------------------
             2.4208   slack (MET)

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

    Delay      Time   Description
-------------------------------------------------------------
   0.0000    0.0000   clock clk (rise edge)
   0.0000    0.0000   clock network delay (ideal)
   0.0000    0.0000 ^ _344_/CLK (gf180mcu_fd_sc_mcu9t5v0__dffq_1)
   3.9865    3.9865 ^ _344_/Q (gf180mcu_fd_sc_mcu9t5v0__dffq_1)
   0.6647    4.6511 v _202_/ZN (gf180mcu_fd_sc_mcu9t5v0__nand2_1)
   4.3171    8.9682 ^ _203_/ZN (gf180mcu_fd_sc_mcu9t5v0__nor4_1)
   1.0748   10.0430 v u_stuffer/_15_/ZN (gf180mcu_fd_sc_mcu9t5v0__nor2_4)
   1.5974   11.6404 ^ u_stuffer/_16_/ZN (gf180mcu_fd_sc_mcu9t5v0__nand4_4)
   1.3880   13.0283 ^ _280_/Z (gf180mcu_fd_sc_mcu9t5v0__mux2_1)
   1.0156   14.0439 v _281_/ZN (gf180mcu_fd_sc_mcu9t5v0__oai221_2)
   2.2135   16.2574 v _282_/Z (gf180mcu_fd_sc_mcu9t5v0__or3_2)
   0.9099   17.1673 ^ _285_/ZN (gf180mcu_fd_sc_mcu9t5v0__aoi211_2)
   0.0000   17.1673 ^ _319_/D (gf180mcu_fd_sc_mcu9t5v0__dffq_1)
            17.1673   data arrival time

  83.3330   83.3330   clock clk (rise edge)
   0.0000   83.3330   clock network delay (ideal)
   0.0000   83.3330   clock reconvergence pessimism
            83.3330 ^ _319_/CLK (gf180mcu_fd_sc_mcu9t5v0__dffq_1)
  -1.0793   82.2537   library setup time
            82.2537   data required time
-------------------------------------------------------------
            82.2537   data required time
           -17.1673   data arrival time
-------------------------------------------------------------
            65.0864   slack (MET)

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

    Delay      Time   Description
-------------------------------------------------------------
   0.0000    0.0000   clock clk (rise edge)
   0.0000    0.0000   clock network delay (ideal)
   0.0000    0.0000 ^ _340_/CLK (gf180mcu_fd_sc_mcu9t5v0__dffq_1)
   2.3319    2.3319 ^ _340_/Q (gf180mcu_fd_sc_mcu9t5v0__dffq_1)
   0.4927    2.8246 v _272_/ZN (gf180mcu_fd_sc_mcu9t5v0__aoi21_1)
   0.0000    2.8246 v _340_/D (gf180mcu_fd_sc_mcu9t5v0__dffq_1)
             2.8246   data arrival time

   0.0000    0.0000   clock clk (rise edge)
   0.0000    0.0000   clock network delay (ideal)
   0.0000    0.0000   clock reconvergence pessimism
             0.0000 ^ _340_/CLK (gf180mcu_fd_sc_mcu9t5v0__dffq_1)
   0.2260    0.2260   library hold time
             0.2260   data required time
-------------------------------------------------------------
             0.2260   data required time
            -2.8246   data arrival time
-------------------------------------------------------------
             2.5986   slack (MET)

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

    Delay      Time   Description
-------------------------------------------------------------
   0.0000    0.0000   clock clk (rise edge)
   0.0000    0.0000   clock network delay (ideal)
   0.0000    0.0000 ^ _344_/CLK (gf180mcu_fd_sc_mcu9t5v0__dffq_1)
   4.5729    4.5729 ^ _344_/Q (gf180mcu_fd_sc_mcu9t5v0__dffq_1)
   0.7853    5.3582 v _202_/ZN (gf180mcu_fd_sc_mcu9t5v0__nand2_1)
   5.2408   10.5991 ^ _203_/ZN (gf180mcu_fd_sc_mcu9t5v0__nor4_1)
   1.2461   11.8451 v u_stuffer/_15_/ZN (gf180mcu_fd_sc_mcu9t5v0__nor2_4)
   1.8795   13.7246 ^ u_stuffer/_16_/ZN (gf180mcu_fd_sc_mcu9t5v0__nand4_4)
   1.0410   14.7656 v _187_/ZN (gf180mcu_fd_sc_mcu9t5v0__nand4_4)
   2.5618   17.3275 ^ _213_/ZN (gf180mcu_fd_sc_mcu9t5v0__aoi22_4)
   0.7948   18.1223 v _241_/ZN (gf180mcu_fd_sc_mcu9t5v0__nor2_1)
   1.6848   19.8071 ^ _242_/ZN (gf180mcu_fd_sc_mcu9t5v0__aoi211_1)
   0.0000   19.8071 ^ _305_/D (gf180mcu_fd_sc_mcu9t5v0__dffq_1)
            19.8071   data arrival time

  83.3330   83.3330   clock clk (rise edge)
   0.0000   83.3330   clock network delay (ideal)
   0.0000   83.3330   clock reconvergence pessimism
            83.3330 ^ _305_/CLK (gf180mcu_fd_sc_mcu9t5v0__dffq_1)
  -1.1965   82.1365   library setup time
            82.1365   data required time
-------------------------------------------------------------
            82.1365   data required time
           -19.8071   data arrival time
-------------------------------------------------------------
            62.3294   slack (MET)

===PROBE_POST_END===
===PROBE_NET_BEGIN===
Net _013_
 Pin capacitance: 0.0095
 Wire capacitance: 0.0025
 Total capacitance: 0.0119
 Number of drivers: 1
 Number of loads: 1
 Number of pins: 2

Driver pins
 _191_/Z output (gf180mcu_fd_sc_mcu9t5v0__mux2_1) (111, 93)

Load pins
 u_encoder/_4_/A1 input (gf180mcu_fd_sc_mcu9t5v0__xor2_2) 0.0095 (102, 94)

Net rx_receiving
 Pin capacitance: 0.1027
 Wire capacitance: 0.0289
 Total capacitance: 0.1316
 Number of drivers: 1
 Number of loads: 10
 Number of pins: 11

Driver pins
 _341_/Q output (gf180mcu_fd_sc_mcu9t5v0__dffq_1) (85, 83)

Load pins
 RxActive output port (80, 186)
 _148_/I input (gf180mcu_fd_sc_mcu9t5v0__clkinv_1) 0.0049 (76, 77)
 _209_/A1 input (gf180mcu_fd_sc_mcu9t5v0__nand2_2) 0.0114 (41, 144)
 _218_/A1 input (gf180mcu_fd_sc_mcu9t5v0__and4_4) 0.0103 (36, 138)
 _271_/C input (gf180mcu_fd_sc_mcu9t5v0__oai211_1) 0.0053 (38, 124)
 u_destuffer/_19_/A1 input (gf180mcu_fd_sc_mcu9t5v0__aoi21_4) 0.0251 (41, 114)
 u_destuffer/_20_/A2 input (gf180mcu_fd_sc_mcu9t5v0__and4_1) 0.0031 (45, 108)
 u_destuffer/_21_/A1 input (gf180mcu_fd_sc_mcu9t5v0__and3_2) 0.0057 (35, 118)
 u_destuffer/_22_/A2 input (gf180mcu_fd_sc_mcu9t5v0__aoi21_2) 0.0124 (36, 114)
 u_destuffer/_24_/A2 input (gf180mcu_fd_sc_mcu9t5v0__aoi21_4) 0.0245 (33, 88)

Net line_state[0]
 Pin capacitance: 0.0197
 Wire capacitance: 0.0106
 Total capacitance: 0.0303
 Number of drivers: 1
 Number of loads: 4
 Number of pins: 5

Driver pins
 u_line_state/_6_/Q output (gf180mcu_fd_sc_mcu9t5v0__dffq_1) (105, 154)

Load pins
 LineState[0] output port (108, 186)
 _172_/I input (gf180mcu_fd_sc_mcu9t5v0__clkinv_1) 0.0049 (88, 108)
 _174_/A1 input (gf180mcu_fd_sc_mcu9t5v0__xor2_1) 0.0094 (87, 104)
 u_eop_detector/_27_/A1 input (gf180mcu_fd_sc_mcu9t5v0__nor2_1) 0.0053 (93, 98)

Net line_state[1]
 Pin capacitance: 0.0193
 Wire capacitance: 0.0113
 Total capacitance: 0.0306
 Number of drivers: 1
 Number of loads: 4
 Number of pins: 5

Driver pins
 u_line_state/_7_/Q output (gf180mcu_fd_sc_mcu9t5v0__dffq_1) (108, 164)

Load pins
 LineState[1] output port (109, 186)
 _173_/A2 input (gf180mcu_fd_sc_mcu9t5v0__nor2_1) 0.0050 (85, 98)
 _174_/A2 input (gf180mcu_fd_sc_mcu9t5v0__xor2_1) 0.0093 (88, 103)
 u_eop_detector/_27_/A2 input (gf180mcu_fd_sc_mcu9t5v0__nor2_1) 0.0050 (92, 98)

===PROBE_NET_END===
worst slack max 62.3294
worst slack min 2.5986
