2AMLogic/gf180-usb2-phy/verification/records/analog-lvs/artifacts/20261113-163000-35e9b6e5ab87/dplus_pullup_layout.spice

* extracted by klt lvs (deck gf180mcu)

* cell dplus_pullup
* pin DP
* pin PU_EN
* pin TRIM0
* pin TRIM1
* pin TRIM2
* pin TRIM3
* pin TRIM4
* pin VPU_REG
* pin VSS
.SUBCKT dplus_pullup DP PU_EN TRIM0 TRIM1 TRIM2 TRIM3 TRIM4 VPU_REG VSS
* device instance $1 r0 *1 0.64,1.73 nfet
M$1 \$16 PU_EN VSS VSS nfet L=0.28U W=1U AS=0.5P AD=0.5P PS=3U PD=3U
* device instance $2 r0 *1 13.68,1.73 nfet
M$2 \$17 TRIM0 VSS VSS nfet L=0.28U W=1U AS=0.5P AD=0.5P PS=3U PD=3U
* device instance $3 r0 *1 26.72,1.73 nfet
M$3 \$18 TRIM1 VSS VSS nfet L=0.28U W=1U AS=0.5P AD=0.5P PS=3U PD=3U
* device instance $4 r0 *1 39.76,1.73 nfet
M$4 \$19 TRIM2 VSS VSS nfet L=0.28U W=1U AS=0.5P AD=0.5P PS=3U PD=3U
* device instance $5 r0 *1 52.8,1.73 nfet
M$5 \$20 TRIM3 VSS VSS nfet L=0.28U W=1U AS=0.5P AD=0.5P PS=3U PD=3U
* device instance $6 r0 *1 65.84,1.73 nfet
M$6 \$21 TRIM4 VSS VSS nfet L=0.28U W=1U AS=0.5P AD=0.5P PS=3U PD=3U
* device instance $7 r0 *1 7.16,2.23 pfet
M$7 \$16 PU_EN VPU_REG VPU_REG pfet L=0.28U W=2U AS=1P AD=1P PS=5U PD=5U
* device instance $8 r0 *1 20.2,2.23 pfet
M$8 \$17 TRIM0 VPU_REG VPU_REG pfet L=0.28U W=2U AS=1P AD=1P PS=5U PD=5U
* device instance $9 r0 *1 33.24,2.23 pfet
M$9 \$18 TRIM1 VPU_REG VPU_REG pfet L=0.28U W=2U AS=1P AD=1P PS=5U PD=5U
* device instance $10 r0 *1 46.28,2.23 pfet
M$10 \$19 TRIM2 VPU_REG VPU_REG pfet L=0.28U W=2U AS=1P AD=1P PS=5U PD=5U
* device instance $11 r0 *1 59.32,2.23 pfet
M$11 \$20 TRIM3 VPU_REG VPU_REG pfet L=0.28U W=2U AS=1P AD=1P PS=5U PD=5U
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
* device instance $70 r0 *1 246.525,51.23 pfet
M$70 DP \$21 \$4 VPU_REG pfet L=0.28U W=100U AS=50P AD=50P PS=201U PD=201U
* device instance $71 r0 *1 248.205,51.23 pfet
M$71 DP \$21 \$4 VPU_REG pfet L=0.28U W=100U AS=50P AD=50P PS=201U PD=201U
* device instance $72 r0 *1 249.885,51.23 pfet
M$72 DP \$21 \$4 VPU_REG pfet L=0.28U W=100U AS=50P AD=50P PS=201U PD=201U
* device instance $73 r0 *1 105.315,2.22 ppolyf_u
R$73 \$6 \$5 VSS 1000.125 ppolyf_u
* device instance $74 r0 *1 115.28,2.22 ppolyf_u
R$74 \$7 \$6 VSS 36.75 ppolyf_u
* device instance $75 r0 *1 141.7325,2.22 ppolyf_u
R$75 \$8 \$7 VSS 59.9375 ppolyf_u
* device instance $76 r0 *1 168.66,2.22 ppolyf_u
R$76 \$3 \$8 VSS 119.875 ppolyf_u
* device instance $77 r0 *1 196.6175,2.22 ppolyf_u
R$77 \$4 \$3 VSS 240.1875 ppolyf_u
* device instance $78 r0 *1 226.6325,2.22 ppolyf_u
R$78 DP \$4 VSS 479.9375 ppolyf_u
.ENDS dplus_pullup
