2AMLogic/gf180-usb2-phy/verification/records/analog-lvs/artifacts/20261113-151132-45afbeea4868/dplus_pullup_extract.spice

* extracted by klt extract --deck gf180mcu

* cell dplus_pullup
* pin DP
* pin NODE0
* pin NODE1
* pin NODE2
* pin NODE3
* pin NODE4
* pin NODE5
* pin PU_EN
* pin PU_ENB
* pin TRIM0
* pin TRIM0B
* pin TRIM1
* pin TRIM1B
* pin TRIM2
* pin TRIM2B
* pin TRIM3
* pin TRIM3B
* pin TRIM4
* pin TRIM4B
* pin vsubs
.SUBCKT dplus_pullup DP NODE0 NODE1 NODE2 NODE3 NODE4 NODE5 PU_EN PU_ENB TRIM0
+ TRIM0B TRIM1 TRIM1B TRIM2 TRIM2B TRIM3 TRIM3B TRIM4 TRIM4B vsubs
* device instance $1 r0 *1 0.64,1.73 nfet
M$1 PU_ENB PU_EN \$1 vsubs nfet L=0.28U W=1U AS=0.5P AD=0.5P PS=3U PD=3U
* device instance $2 r0 *1 13.68,1.73 nfet
M$2 TRIM0B TRIM0 \$1 vsubs nfet L=0.28U W=1U AS=0.5P AD=0.5P PS=3U PD=3U
* device instance $3 r0 *1 26.72,1.73 nfet
M$3 TRIM1B TRIM1 \$1 vsubs nfet L=0.28U W=1U AS=0.5P AD=0.5P PS=3U PD=3U
* device instance $4 r0 *1 39.76,1.73 nfet
M$4 TRIM2B TRIM2 \$1 vsubs nfet L=0.28U W=1U AS=0.5P AD=0.5P PS=3U PD=3U
* device instance $5 r0 *1 52.8,1.73 nfet
M$5 TRIM3B TRIM3 \$1 vsubs nfet L=0.28U W=1U AS=0.5P AD=0.5P PS=3U PD=3U
* device instance $6 r0 *1 65.84,1.73 nfet
M$6 TRIM4B TRIM4 \$1 vsubs nfet L=0.28U W=1U AS=0.5P AD=0.5P PS=3U PD=3U
* device instance $7 r0 *1 7.16,2.23 pfet
M$7 PU_ENB PU_EN \$2 \$6 pfet L=0.28U W=2U AS=1P AD=1P PS=5U PD=5U
* device instance $8 r0 *1 20.2,2.23 pfet
M$8 TRIM0B TRIM0 \$2 \$7 pfet L=0.28U W=2U AS=1P AD=1P PS=5U PD=5U
* device instance $9 r0 *1 33.24,2.23 pfet
M$9 TRIM1B TRIM1 \$2 \$8 pfet L=0.28U W=2U AS=1P AD=1P PS=5U PD=5U
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
* device instance $68 r0 *1 243.165,51.23 pfet
M$68 DP TRIM4B NODE5 \$21 pfet L=0.28U W=100U AS=50P AD=50P PS=201U PD=201U
* device instance $69 r0 *1 244.845,51.23 pfet
M$69 DP TRIM4B NODE5 \$21 pfet L=0.28U W=100U AS=50P AD=50P PS=201U PD=201U
* device instance $70 r0 *1 246.525,51.23 pfet
M$70 DP TRIM4B NODE5 \$21 pfet L=0.28U W=100U AS=50P AD=50P PS=201U PD=201U
* device instance $71 r0 *1 248.205,51.23 pfet
M$71 DP TRIM4B NODE5 \$21 pfet L=0.28U W=100U AS=50P AD=50P PS=201U PD=201U
* device instance $72 r0 *1 249.885,51.23 pfet
M$72 DP TRIM4B NODE5 \$21 pfet L=0.28U W=100U AS=50P AD=50P PS=201U PD=201U
* device instance $73 r0 *1 105.315,2.22 ppolyf_u
X$73 NODE1 NODE0 vsubs ppolyf_u r=1000.125 L=11.43U W=4U
* device instance $74 r0 *1 115.28,2.22 ppolyf_u
X$74 NODE2 NODE1 vsubs ppolyf_u r=36.75 L=0.42U W=4U
* device instance $75 r0 *1 141.7325,2.22 ppolyf_u
X$75 NODE3 NODE2 vsubs ppolyf_u r=59.9375 L=0.685U W=4U
* device instance $76 r0 *1 168.66,2.22 ppolyf_u
X$76 NODE4 NODE3 vsubs ppolyf_u r=119.875 L=1.37U W=4U
* device instance $77 r0 *1 196.6175,2.22 ppolyf_u
X$77 NODE5 NODE4 vsubs ppolyf_u r=240.1875 L=2.745U W=4U
* device instance $78 r0 *1 226.6325,2.22 ppolyf_u
X$78 DP NODE5 vsubs ppolyf_u r=479.9375 L=5.485U W=4U
.ENDS dplus_pullup
