2AMLogic/gf180-usb2-phy/verification/records/digital-lvs/artifacts/20261015-011503-32db02a/usb_utmi_phy_layout.spice

* extracted by klt extract --deck gf180mcu

* cell usb_utmi_phy
* pin DataIn[0]
* pin DataIn[1]
* pin DataIn[2]
* pin DataIn[3]
* pin DataIn[4]
* pin DataIn[5]
* pin DataIn[6]
* pin DataIn[7]
* pin DataOut[0]
* pin DataOut[1]
* pin DataOut[2]
* pin DataOut[3]
* pin DataOut[4]
* pin DataOut[5]
* pin DataOut[6]
* pin DataOut[7]
* pin OpMode[0]
* pin OpMode[1]
* pin Reset
* pin RxError
* pin RxValid
* pin TermSelect
* pin TxReady
* pin TxValid
* pin VDD
* pin VSS
* pin clk
* pin line_state[0]
* pin line_state[1]
* pin pu_en
* pin rst_n
* pin rx_receiving
* pin rxdm
* pin rxdp
* pin txdm
* pin txdp
* pin txoe
* pin SuspendM
* pin XcvrSelect
* pin trim[0]
* pin trim[1]
* pin trim[2]
* pin trim[3]
* pin trim[4]
.SUBCKT usb_utmi_phy DataIn[0] DataIn[1] DataIn[2] DataIn[3] DataIn[4]
+ DataIn[5] DataIn[6] DataIn[7] DataOut[0] DataOut[1] DataOut[2] DataOut[3]
+ DataOut[4] DataOut[5] DataOut[6] DataOut[7] OpMode[0] OpMode[1] Reset RxError
+ RxValid TermSelect TxReady TxValid VDD VSS clk line_state[0] line_state[1]
+ pu_en rst_n rx_receiving rxdm rxdp txdm txdp txoe SuspendM XcvrSelect trim[0]
+ trim[1] trim[2] trim[3] trim[4]
* cell instance gf180mcu_fd_sc_mcu9t5v0__and2_1_0 r0 *1 0,0
Xgf180mcu_fd_sc_mcu9t5v0__and2_1_0 rx_bit_valid rx_assembly_en VDD VSS \_099_
+ gf180mcu_fd_sc_mcu9t5v0__and2_1
* cell instance gf180mcu_fd_sc_mcu9t5v0__and2_1_1 r0 *1 0,0
Xgf180mcu_fd_sc_mcu9t5v0__and2_1_1 u_sync_detector/match[0] rx_dec_strobe VDD
+ VSS u_sync_detector/_13_ gf180mcu_fd_sc_mcu9t5v0__and2_1
* cell instance gf180mcu_fd_sc_mcu9t5v0__and2_1_2 r0 *1 0,0
Xgf180mcu_fd_sc_mcu9t5v0__and2_1_2 rx_stuff_err \_002_ VDD VSS \_040_
+ gf180mcu_fd_sc_mcu9t5v0__and2_1
* cell instance gf180mcu_fd_sc_mcu9t5v0__and2_1_3 r0 *1 0,0
Xgf180mcu_fd_sc_mcu9t5v0__and2_1_3 \_055_ rx_dec_strobe VDD VSS \_003_
+ gf180mcu_fd_sc_mcu9t5v0__and2_1
* cell instance gf180mcu_fd_sc_mcu9t5v0__and2_1_4 r0 *1 0,0
Xgf180mcu_fd_sc_mcu9t5v0__and2_1_4 line_state[1] \_058_ VDD VSS \_059_
+ gf180mcu_fd_sc_mcu9t5v0__and2_1
* cell instance gf180mcu_fd_sc_mcu9t5v0__and2_1_5 r0 *1 0,0
Xgf180mcu_fd_sc_mcu9t5v0__and2_1_5 u_eop_detector/_12_ u_eop_detector/_26_ VDD
+ VSS u_eop_detector/_07_ gf180mcu_fd_sc_mcu9t5v0__and2_1
* cell instance gf180mcu_fd_sc_mcu9t5v0__and2_1_6 r0 *1 0,0
Xgf180mcu_fd_sc_mcu9t5v0__and2_1_6 rst_n TermSelect VDD VSS pu_en
+ gf180mcu_fd_sc_mcu9t5v0__and2_1
* cell instance gf180mcu_fd_sc_mcu9t5v0__and2_1_7 r0 *1 0,0
Xgf180mcu_fd_sc_mcu9t5v0__and2_1_7 \_010_ stuff_consume VDD VSS stuff_bit_out
+ gf180mcu_fd_sc_mcu9t5v0__and2_1
* cell instance gf180mcu_fd_sc_mcu9t5v0__and2_1_8 r0 *1 0,0
Xgf180mcu_fd_sc_mcu9t5v0__and2_1_8 \_071_ \_097_ VDD VSS \_137_
+ gf180mcu_fd_sc_mcu9t5v0__and2_1
* cell instance gf180mcu_fd_sc_mcu9t5v0__and2_2_0 r0 *1 0,0
Xgf180mcu_fd_sc_mcu9t5v0__and2_2_0 u_sync_detector/match[2]
+ u_sync_detector/_10_ VDD VSS u_sync_detector/_11_
+ gf180mcu_fd_sc_mcu9t5v0__and2_2
* cell instance gf180mcu_fd_sc_mcu9t5v0__and2_2_1 r0 *1 0,0
Xgf180mcu_fd_sc_mcu9t5v0__and2_2_1 \_055_ sync_next VDD VSS
+ u_sync_detector/_04_ gf180mcu_fd_sc_mcu9t5v0__and2_2
* cell instance gf180mcu_fd_sc_mcu9t5v0__and2_2_2 r0 *1 0,0
Xgf180mcu_fd_sc_mcu9t5v0__and2_2_2 \_093_ \_095_ VDD VSS \_098_
+ gf180mcu_fd_sc_mcu9t5v0__and2_2
* cell instance gf180mcu_fd_sc_mcu9t5v0__and2_4_0 r0 *1 0,0
Xgf180mcu_fd_sc_mcu9t5v0__and2_4_0 \_055_ rxdm VDD VSS u_line_state/_1_
+ gf180mcu_fd_sc_mcu9t5v0__and2_4
* cell instance gf180mcu_fd_sc_mcu9t5v0__and2_4_1 r0 *1 0,0
Xgf180mcu_fd_sc_mcu9t5v0__and2_4_1 tx_state[0] \_069_ VDD VSS \_091_
+ gf180mcu_fd_sc_mcu9t5v0__and2_4
* cell instance gf180mcu_fd_sc_mcu9t5v0__and3_1_0 r0 *1 0,0
Xgf180mcu_fd_sc_mcu9t5v0__and3_1_0 rx_bitcnt[0] rx_bitcnt[1] \_099_ VDD VSS
+ \_100_ gf180mcu_fd_sc_mcu9t5v0__and3_1
* cell instance gf180mcu_fd_sc_mcu9t5v0__and3_1_1 r0 *1 0,0
Xgf180mcu_fd_sc_mcu9t5v0__and3_1_1 u_eop_detector/se0_count[3]
+ u_eop_detector/se0_count[2] u_eop_detector/_15_ VDD VSS u_eop_detector/_24_
+ gf180mcu_fd_sc_mcu9t5v0__and3_1
* cell instance gf180mcu_fd_sc_mcu9t5v0__and3_2_0 r0 *1 0,0
Xgf180mcu_fd_sc_mcu9t5v0__and3_2_0 rx_bitcnt[2] \_002_ \_100_ VDD VSS \_101_
+ gf180mcu_fd_sc_mcu9t5v0__and3_2
* cell instance gf180mcu_fd_sc_mcu9t5v0__and3_2_1 r0 *1 0,0
Xgf180mcu_fd_sc_mcu9t5v0__and3_2_1 \_002_ dec_data_bit u_destuffer/_06_ VDD VSS
+ u_destuffer/_09_ gf180mcu_fd_sc_mcu9t5v0__and3_2
* cell instance gf180mcu_fd_sc_mcu9t5v0__and3_2_2 r0 *1 0,0
Xgf180mcu_fd_sc_mcu9t5v0__and3_2_2 u_sync_detector/match[0] rx_dec_strobe
+ u_sync_detector/match[1] VDD VSS u_sync_detector/_10_
+ gf180mcu_fd_sc_mcu9t5v0__and3_2
* cell instance gf180mcu_fd_sc_mcu9t5v0__and3_4_0 r0 *1 0,0
Xgf180mcu_fd_sc_mcu9t5v0__and3_4_0 u_eop_detector/se0_count[3]
+ u_eop_detector/se0_count[4] u_eop_detector/se0_count[2] VDD VSS
+ u_eop_detector/_10_ gf180mcu_fd_sc_mcu9t5v0__and3_4
* cell instance gf180mcu_fd_sc_mcu9t5v0__and4_1_0 r0 *1 0,0
Xgf180mcu_fd_sc_mcu9t5v0__and4_1_0 \_003_ \_002_ dec_data_bit u_destuffer/_07_
+ VDD VSS u_destuffer/_01_ gf180mcu_fd_sc_mcu9t5v0__and4_1
* cell instance gf180mcu_fd_sc_mcu9t5v0__and4_1_1 r0 *1 0,0
Xgf180mcu_fd_sc_mcu9t5v0__and4_1_1 \_135_ \_136_ \_137_ \_141_ VDD VSS \_142_
+ gf180mcu_fd_sc_mcu9t5v0__and4_1
* cell instance gf180mcu_fd_sc_mcu9t5v0__aoi211_1_0 r0 *1 0,0
Xgf180mcu_fd_sc_mcu9t5v0__aoi211_1_0 u_sync_detector/_06_ u_sync_detector/_13_
+ u_sync_detector/_15_ u_sync_detector/_09_ VDD VSS u_sync_detector/_03_
+ gf180mcu_fd_sc_mcu9t5v0__aoi211_1
* cell instance gf180mcu_fd_sc_mcu9t5v0__aoi211_1_1 r0 *1 0,0
Xgf180mcu_fd_sc_mcu9t5v0__aoi211_1_1 u_eop_detector/_14_ u_eop_detector/_18_
+ u_eop_detector/_15_ u_eop_detector/_09_ VDD VSS u_eop_detector/_02_
+ gf180mcu_fd_sc_mcu9t5v0__aoi211_1
* cell instance gf180mcu_fd_sc_mcu9t5v0__aoi211_1_2 r0 *1 0,0
Xgf180mcu_fd_sc_mcu9t5v0__aoi211_1_2 \_063_ \_064_ \_091_ \_140_ VDD VSS \_141_
+ gf180mcu_fd_sc_mcu9t5v0__aoi211_1
* cell instance gf180mcu_fd_sc_mcu9t5v0__aoi211_1_3 r0 *1 0,0
Xgf180mcu_fd_sc_mcu9t5v0__aoi211_1_3 \_158_ \_143_ \_138_ \_054_ VDD VSS \_048_
+ gf180mcu_fd_sc_mcu9t5v0__aoi211_1
* cell instance gf180mcu_fd_sc_mcu9t5v0__aoi211_1_4 r0 *1 0,0
Xgf180mcu_fd_sc_mcu9t5v0__aoi211_1_4 \_098_ \_109_ \_110_ \_054_ VDD VSS \_017_
+ gf180mcu_fd_sc_mcu9t5v0__aoi211_1
* cell instance gf180mcu_fd_sc_mcu9t5v0__aoi211_1_5 r0 *1 0,0
Xgf180mcu_fd_sc_mcu9t5v0__aoi211_1_5 byte_idx[0] \_098_ \_111_ \_054_ VDD VSS
+ \_018_ gf180mcu_fd_sc_mcu9t5v0__aoi211_1
* cell instance gf180mcu_fd_sc_mcu9t5v0__aoi211_2_0 r0 *1 0,0
Xgf180mcu_fd_sc_mcu9t5v0__aoi211_2_0 \_146_ \_102_ \_147_ \_054_ VDD VSS \_039_
+ gf180mcu_fd_sc_mcu9t5v0__aoi211_2
* cell instance gf180mcu_fd_sc_mcu9t5v0__aoi211_2_1 r0 *1 0,0
Xgf180mcu_fd_sc_mcu9t5v0__aoi211_2_1 \_105_ \_102_ \_106_ \_054_ VDD VSS \_016_
+ gf180mcu_fd_sc_mcu9t5v0__aoi211_2
* cell instance gf180mcu_fd_sc_mcu9t5v0__aoi211_2_2 r0 *1 0,0
Xgf180mcu_fd_sc_mcu9t5v0__aoi211_2_2 \_150_ \_102_ \_151_ \_054_ VDD VSS \_043_
+ gf180mcu_fd_sc_mcu9t5v0__aoi211_2
* cell instance gf180mcu_fd_sc_mcu9t5v0__aoi211_2_3 r0 *1 0,0
Xgf180mcu_fd_sc_mcu9t5v0__aoi211_2_3 \_152_ \_102_ \_153_ \_054_ VDD VSS \_045_
+ gf180mcu_fd_sc_mcu9t5v0__aoi211_2
* cell instance gf180mcu_fd_sc_mcu9t5v0__aoi211_2_4 r0 *1 0,0
Xgf180mcu_fd_sc_mcu9t5v0__aoi211_2_4 \_156_ \_102_ \_157_ \_054_ VDD VSS \_047_
+ gf180mcu_fd_sc_mcu9t5v0__aoi211_2
* cell instance gf180mcu_fd_sc_mcu9t5v0__aoi211_2_5 r0 *1 0,0
Xgf180mcu_fd_sc_mcu9t5v0__aoi211_2_5 \_162_ \_102_ \_163_ \_054_ VDD VSS \_051_
+ gf180mcu_fd_sc_mcu9t5v0__aoi211_2
* cell instance gf180mcu_fd_sc_mcu9t5v0__aoi211_2_6 r0 *1 0,0
Xgf180mcu_fd_sc_mcu9t5v0__aoi211_2_6 \_159_ \_102_ \_160_ \_054_ VDD VSS \_049_
+ gf180mcu_fd_sc_mcu9t5v0__aoi211_2
* cell instance gf180mcu_fd_sc_mcu9t5v0__aoi211_2_7 r0 *1 0,0
Xgf180mcu_fd_sc_mcu9t5v0__aoi211_2_7 \_085_ \_102_ \_149_ \_054_ VDD VSS \_042_
+ gf180mcu_fd_sc_mcu9t5v0__aoi211_2
* cell instance gf180mcu_fd_sc_mcu9t5v0__aoi211_2_8 r0 *1 0,0
Xgf180mcu_fd_sc_mcu9t5v0__aoi211_2_8 \_065_ \_138_ \_142_ \_054_ VDD VSS \_030_
+ gf180mcu_fd_sc_mcu9t5v0__aoi211_2
* cell instance gf180mcu_fd_sc_mcu9t5v0__aoi21_1_0 r0 *1 0,0
Xgf180mcu_fd_sc_mcu9t5v0__aoi21_1_0 rx_bitcnt[0] \_099_ \_127_ VDD VSS \_026_
+ gf180mcu_fd_sc_mcu9t5v0__aoi21_1
* cell instance gf180mcu_fd_sc_mcu9t5v0__aoi21_1_1 r0 *1 0,0
Xgf180mcu_fd_sc_mcu9t5v0__aoi21_1_1 \_113_ \_115_ \_056_ VDD VSS \_019_
+ gf180mcu_fd_sc_mcu9t5v0__aoi21_1
* cell instance gf180mcu_fd_sc_mcu9t5v0__aoi21_1_2 r0 *1 0,0
Xgf180mcu_fd_sc_mcu9t5v0__aoi21_1_2 rx_bitcnt[2] \_100_ \_148_ VDD VSS \_041_
+ gf180mcu_fd_sc_mcu9t5v0__aoi21_1
* cell instance gf180mcu_fd_sc_mcu9t5v0__aoi21_1_3 r0 *1 0,0
Xgf180mcu_fd_sc_mcu9t5v0__aoi21_1_3 \_128_ \_129_ \_056_ VDD VSS \_027_
+ gf180mcu_fd_sc_mcu9t5v0__aoi21_1
* cell instance gf180mcu_fd_sc_mcu9t5v0__aoi21_1_4 r0 *1 0,0
Xgf180mcu_fd_sc_mcu9t5v0__aoi21_1_4 rx_bitcnt[0] \_099_ rx_bitcnt[1] VDD VSS
+ \_126_ gf180mcu_fd_sc_mcu9t5v0__aoi21_1
* cell instance gf180mcu_fd_sc_mcu9t5v0__aoi21_1_5 r0 *1 0,0
Xgf180mcu_fd_sc_mcu9t5v0__aoi21_1_5 u_destuffer/ones_run[1] u_destuffer/_12_
+ u_destuffer/ones_run[2] VDD VSS u_destuffer/_14_
+ gf180mcu_fd_sc_mcu9t5v0__aoi21_1
* cell instance gf180mcu_fd_sc_mcu9t5v0__aoi21_1_6 r0 *1 0,0
Xgf180mcu_fd_sc_mcu9t5v0__aoi21_1_6 \_116_ \_117_ \_056_ VDD VSS \_020_
+ gf180mcu_fd_sc_mcu9t5v0__aoi21_1
* cell instance gf180mcu_fd_sc_mcu9t5v0__aoi21_1_7 r0 *1 0,0
Xgf180mcu_fd_sc_mcu9t5v0__aoi21_1_7 \_124_ \_125_ \_056_ VDD VSS \_024_
+ gf180mcu_fd_sc_mcu9t5v0__aoi21_1
* cell instance gf180mcu_fd_sc_mcu9t5v0__aoi21_1_8 r0 *1 0,0
Xgf180mcu_fd_sc_mcu9t5v0__aoi21_1_8 \_003_ u_destuffer/_09_
+ u_destuffer/ones_run[0] VDD VSS u_destuffer/_15_
+ gf180mcu_fd_sc_mcu9t5v0__aoi21_1
* cell instance gf180mcu_fd_sc_mcu9t5v0__aoi21_1_9 r0 *1 0,0
Xgf180mcu_fd_sc_mcu9t5v0__aoi21_1_9 \_120_ \_121_ \_056_ VDD VSS \_022_
+ gf180mcu_fd_sc_mcu9t5v0__aoi21_1
* cell instance gf180mcu_fd_sc_mcu9t5v0__aoi21_1_10 r0 *1 0,0
Xgf180mcu_fd_sc_mcu9t5v0__aoi21_1_10 \_154_ \_155_ \_056_ VDD VSS \_046_
+ gf180mcu_fd_sc_mcu9t5v0__aoi21_1
* cell instance gf180mcu_fd_sc_mcu9t5v0__aoi21_1_11 r0 *1 0,0
Xgf180mcu_fd_sc_mcu9t5v0__aoi21_1_11 \_122_ \_123_ \_056_ VDD VSS \_023_
+ gf180mcu_fd_sc_mcu9t5v0__aoi21_1
* cell instance gf180mcu_fd_sc_mcu9t5v0__aoi21_1_12 r0 *1 0,0
Xgf180mcu_fd_sc_mcu9t5v0__aoi21_1_12 u_eop_detector/_22_ u_eop_detector/_23_
+ u_eop_detector/_09_ VDD VSS u_eop_detector/_04_
+ gf180mcu_fd_sc_mcu9t5v0__aoi21_1
* cell instance gf180mcu_fd_sc_mcu9t5v0__aoi21_1_13 r0 *1 0,0
Xgf180mcu_fd_sc_mcu9t5v0__aoi21_1_13 u_eop_detector/se0_count[2]
+ u_eop_detector/_15_ u_eop_detector/se0_count[3] VDD VSS u_eop_detector/_25_
+ gf180mcu_fd_sc_mcu9t5v0__aoi21_1
* cell instance gf180mcu_fd_sc_mcu9t5v0__aoi21_1_14 r0 *1 0,0
Xgf180mcu_fd_sc_mcu9t5v0__aoi21_1_14 u_eop_detector/_10_ u_eop_detector/_12_
+ bus_reset VDD VSS u_eop_detector/_13_ gf180mcu_fd_sc_mcu9t5v0__aoi21_1
* cell instance gf180mcu_fd_sc_mcu9t5v0__aoi21_1_15 r0 *1 0,0
Xgf180mcu_fd_sc_mcu9t5v0__aoi21_1_15 \_063_ \_064_ txdm VDD VSS txdp
+ gf180mcu_fd_sc_mcu9t5v0__aoi21_1
* cell instance gf180mcu_fd_sc_mcu9t5v0__aoi21_1_16 r0 *1 0,0
Xgf180mcu_fd_sc_mcu9t5v0__aoi21_1_16 u_eop_detector/se0_count[1]
+ u_eop_detector/_10_ u_eop_detector/_18_ VDD VSS u_eop_detector/_19_
+ gf180mcu_fd_sc_mcu9t5v0__aoi21_1
* cell instance gf180mcu_fd_sc_mcu9t5v0__aoi21_1_17 r0 *1 0,0
Xgf180mcu_fd_sc_mcu9t5v0__aoi21_1_17 u_eop_detector/_17_ u_eop_detector/_20_
+ u_eop_detector/se0_count[0] VDD VSS u_eop_detector/_21_
+ gf180mcu_fd_sc_mcu9t5v0__aoi21_1
* cell instance gf180mcu_fd_sc_mcu9t5v0__aoi21_1_18 r0 *1 0,0
Xgf180mcu_fd_sc_mcu9t5v0__aoi21_1_18 \_075_ \_104_ \_054_ VDD VSS \_014_
+ gf180mcu_fd_sc_mcu9t5v0__aoi21_1
* cell instance gf180mcu_fd_sc_mcu9t5v0__aoi21_1_19 r0 *1 0,0
Xgf180mcu_fd_sc_mcu9t5v0__aoi21_1_19 byte_reg[4] byte_idx[2] \_082_ VDD VSS
+ \_083_ gf180mcu_fd_sc_mcu9t5v0__aoi21_1
* cell instance gf180mcu_fd_sc_mcu9t5v0__aoi21_1_20 r0 *1 0,0
Xgf180mcu_fd_sc_mcu9t5v0__aoi21_1_20 \_075_ \_134_ \_054_ VDD VSS \_029_
+ gf180mcu_fd_sc_mcu9t5v0__aoi21_1
* cell instance gf180mcu_fd_sc_mcu9t5v0__aoi21_1_21 r0 *1 0,0
Xgf180mcu_fd_sc_mcu9t5v0__aoi21_1_21 byte_reg[1] \_080_ byte_idx[1] VDD VSS
+ \_086_ gf180mcu_fd_sc_mcu9t5v0__aoi21_1
* cell instance gf180mcu_fd_sc_mcu9t5v0__aoi21_1_22 r0 *1 0,0
Xgf180mcu_fd_sc_mcu9t5v0__aoi21_1_22 sync_idx[0] \_091_ sync_idx[1] VDD VSS
+ \_130_ gf180mcu_fd_sc_mcu9t5v0__aoi21_1
* cell instance gf180mcu_fd_sc_mcu9t5v0__aoi21_1_23 r0 *1 0,0
Xgf180mcu_fd_sc_mcu9t5v0__aoi21_1_23 \_073_ \_091_ \_092_ VDD VSS \_135_
+ gf180mcu_fd_sc_mcu9t5v0__aoi21_1
* cell instance gf180mcu_fd_sc_mcu9t5v0__aoi21_1_24 r0 *1 0,0
Xgf180mcu_fd_sc_mcu9t5v0__aoi21_1_24 \_107_ \_093_ byte_idx[0] VDD VSS \_111_
+ gf180mcu_fd_sc_mcu9t5v0__aoi21_1
* cell instance gf180mcu_fd_sc_mcu9t5v0__aoi21_1_25 r0 *1 0,0
Xgf180mcu_fd_sc_mcu9t5v0__aoi21_1_25 \_093_ \_095_ byte_idx[1] VDD VSS \_110_
+ gf180mcu_fd_sc_mcu9t5v0__aoi21_1
* cell instance gf180mcu_fd_sc_mcu9t5v0__aoi21_2_0 r0 *1 0,0
Xgf180mcu_fd_sc_mcu9t5v0__aoi21_2_0 u_destuffer/_08_ \_002_ u_destuffer/_09_
+ VDD VSS u_destuffer/_10_ gf180mcu_fd_sc_mcu9t5v0__aoi21_2
* cell instance gf180mcu_fd_sc_mcu9t5v0__aoi21_2_1 r0 *1 0,0
Xgf180mcu_fd_sc_mcu9t5v0__aoi21_2_1 u_stuffer/_03_ stuff_consume \_000_ VDD VSS
+ u_stuffer/_06_ gf180mcu_fd_sc_mcu9t5v0__aoi21_2
* cell instance gf180mcu_fd_sc_mcu9t5v0__aoi21_2_2 r0 *1 0,0
Xgf180mcu_fd_sc_mcu9t5v0__aoi21_2_2 \_005_ u_stuffer/_09_ u_stuffer/_11_ VDD
+ VSS u_stuffer/_01_ gf180mcu_fd_sc_mcu9t5v0__aoi21_2
* cell instance gf180mcu_fd_sc_mcu9t5v0__aoi21_2_3 r0 *1 0,0
Xgf180mcu_fd_sc_mcu9t5v0__aoi21_2_3 \_005_ u_stuffer/_09_ u_stuffer/_13_ VDD
+ VSS u_stuffer/_02_ gf180mcu_fd_sc_mcu9t5v0__aoi21_2
* cell instance gf180mcu_fd_sc_mcu9t5v0__aoi21_4_0 r0 *1 0,0
Xgf180mcu_fd_sc_mcu9t5v0__aoi21_4_0 \_002_ u_destuffer/_07_ u_destuffer/_08_
+ VDD VSS u_destuffer/_00_ gf180mcu_fd_sc_mcu9t5v0__aoi21_4
* cell instance gf180mcu_fd_sc_mcu9t5v0__aoi21_4_1 r0 *1 0,0
Xgf180mcu_fd_sc_mcu9t5v0__aoi21_4_1 u_destuffer/_08_ \_002_ u_destuffer/_11_
+ VDD VSS u_destuffer/_12_ gf180mcu_fd_sc_mcu9t5v0__aoi21_4
* cell instance gf180mcu_fd_sc_mcu9t5v0__aoi221_1_0 r0 *1 0,0
Xgf180mcu_fd_sc_mcu9t5v0__aoi221_1_0 byte_idx[1] \_079_ \_081_ \_083_ \_088_
+ VDD VSS \_010_ gf180mcu_fd_sc_mcu9t5v0__aoi221_1
* cell instance gf180mcu_fd_sc_mcu9t5v0__aoi221_2_0 r0 *1 0,0
Xgf180mcu_fd_sc_mcu9t5v0__aoi221_2_0 \_070_ \_067_ \_073_ \_091_ \_092_ VDD VSS
+ \_093_ gf180mcu_fd_sc_mcu9t5v0__aoi221_2
* cell instance gf180mcu_fd_sc_mcu9t5v0__aoi221_2_1 r0 *1 0,0
Xgf180mcu_fd_sc_mcu9t5v0__aoi221_2_1 \_080_ \_096_ \_097_ \_098_ \_054_ VDD VSS
+ \_012_ gf180mcu_fd_sc_mcu9t5v0__aoi221_2
* cell instance gf180mcu_fd_sc_mcu9t5v0__buf_4_0 r0 *1 0,0
Xgf180mcu_fd_sc_mcu9t5v0__buf_4_0 clknet_0_clk VDD VSS clknet_3_0__leaf_clk
+ gf180mcu_fd_sc_mcu9t5v0__buf_4
* cell instance gf180mcu_fd_sc_mcu9t5v0__buf_4_1 r0 *1 0,0
Xgf180mcu_fd_sc_mcu9t5v0__buf_4_1 clknet_0_clk VDD VSS clknet_3_2__leaf_clk
+ gf180mcu_fd_sc_mcu9t5v0__buf_4
* cell instance gf180mcu_fd_sc_mcu9t5v0__buf_4_2 r0 *1 0,0
Xgf180mcu_fd_sc_mcu9t5v0__buf_4_2 clknet_0_clk VDD VSS clknet_3_1__leaf_clk
+ gf180mcu_fd_sc_mcu9t5v0__buf_4
* cell instance gf180mcu_fd_sc_mcu9t5v0__buf_4_3 r0 *1 0,0
Xgf180mcu_fd_sc_mcu9t5v0__buf_4_3 clknet_0_clk VDD VSS clknet_3_3__leaf_clk
+ gf180mcu_fd_sc_mcu9t5v0__buf_4
* cell instance gf180mcu_fd_sc_mcu9t5v0__buf_4_4 r0 *1 0,0
Xgf180mcu_fd_sc_mcu9t5v0__buf_4_4 clk VDD VSS clknet_0_clk
+ gf180mcu_fd_sc_mcu9t5v0__buf_4
* cell instance gf180mcu_fd_sc_mcu9t5v0__buf_4_5 r0 *1 0,0
Xgf180mcu_fd_sc_mcu9t5v0__buf_4_5 clknet_0_clk VDD VSS clknet_3_6__leaf_clk
+ gf180mcu_fd_sc_mcu9t5v0__buf_4
* cell instance gf180mcu_fd_sc_mcu9t5v0__buf_4_6 r0 *1 0,0
Xgf180mcu_fd_sc_mcu9t5v0__buf_4_6 clknet_0_clk VDD VSS clknet_3_4__leaf_clk
+ gf180mcu_fd_sc_mcu9t5v0__buf_4
* cell instance gf180mcu_fd_sc_mcu9t5v0__buf_4_7 r0 *1 0,0
Xgf180mcu_fd_sc_mcu9t5v0__buf_4_7 clknet_0_clk VDD VSS clknet_3_5__leaf_clk
+ gf180mcu_fd_sc_mcu9t5v0__buf_4
* cell instance gf180mcu_fd_sc_mcu9t5v0__buf_4_8 r0 *1 0,0
Xgf180mcu_fd_sc_mcu9t5v0__buf_4_8 clknet_0_clk VDD VSS clknet_3_7__leaf_clk
+ gf180mcu_fd_sc_mcu9t5v0__buf_4
* cell instance gf180mcu_fd_sc_mcu9t5v0__clkinv_1_0 r0 *1 0,0
Xgf180mcu_fd_sc_mcu9t5v0__clkinv_1_0 \_056_ VDD VSS \_031_
+ gf180mcu_fd_sc_mcu9t5v0__clkinv_1
* cell instance gf180mcu_fd_sc_mcu9t5v0__clkinv_1_1 r0 *1 0,0
Xgf180mcu_fd_sc_mcu9t5v0__clkinv_1_1 u_sync_detector/match[3] VDD VSS
+ u_sync_detector/_08_ gf180mcu_fd_sc_mcu9t5v0__clkinv_1
* cell instance gf180mcu_fd_sc_mcu9t5v0__clkinv_1_2 r0 *1 0,0
Xgf180mcu_fd_sc_mcu9t5v0__clkinv_1_2 \_004_ VDD VSS u_sync_detector/_05_
+ gf180mcu_fd_sc_mcu9t5v0__clkinv_1
* cell instance gf180mcu_fd_sc_mcu9t5v0__clkinv_1_3 r0 *1 0,0
Xgf180mcu_fd_sc_mcu9t5v0__clkinv_1_3 rx_receiving VDD VSS \_004_
+ gf180mcu_fd_sc_mcu9t5v0__clkinv_1
* cell instance gf180mcu_fd_sc_mcu9t5v0__clkinv_1_4 r0 *1 0,0
Xgf180mcu_fd_sc_mcu9t5v0__clkinv_1_4 Reset VDD VSS \_053_
+ gf180mcu_fd_sc_mcu9t5v0__clkinv_1
* cell instance gf180mcu_fd_sc_mcu9t5v0__clkinv_1_5 r0 *1 0,0
Xgf180mcu_fd_sc_mcu9t5v0__clkinv_1_5 u_decoder/_04_ VDD VSS u_decoder/_00_
+ gf180mcu_fd_sc_mcu9t5v0__clkinv_1
* cell instance gf180mcu_fd_sc_mcu9t5v0__clkinv_1_6 r0 *1 0,0
Xgf180mcu_fd_sc_mcu9t5v0__clkinv_1_6 \_052_ VDD VSS txoe
+ gf180mcu_fd_sc_mcu9t5v0__clkinv_1
* cell instance gf180mcu_fd_sc_mcu9t5v0__clkinv_1_7 r0 *1 0,0
Xgf180mcu_fd_sc_mcu9t5v0__clkinv_1_7 byte_reg[7] VDD VSS \_105_
+ gf180mcu_fd_sc_mcu9t5v0__clkinv_1
* cell instance gf180mcu_fd_sc_mcu9t5v0__clkinv_1_8 r0 *1 0,0
Xgf180mcu_fd_sc_mcu9t5v0__clkinv_1_8 byte_reg[6] VDD VSS \_146_
+ gf180mcu_fd_sc_mcu9t5v0__clkinv_1
* cell instance gf180mcu_fd_sc_mcu9t5v0__clkinv_1_9 r0 *1 0,0
Xgf180mcu_fd_sc_mcu9t5v0__clkinv_1_9 u_eop_detector/se0_count[4] VDD VSS
+ u_eop_detector/_22_ gf180mcu_fd_sc_mcu9t5v0__clkinv_1
* cell instance gf180mcu_fd_sc_mcu9t5v0__clkinv_1_10 r0 *1 0,0
Xgf180mcu_fd_sc_mcu9t5v0__clkinv_1_10 line_state[0] VDD VSS \_058_
+ gf180mcu_fd_sc_mcu9t5v0__clkinv_1
* cell instance gf180mcu_fd_sc_mcu9t5v0__clkinv_1_11 r0 *1 0,0
Xgf180mcu_fd_sc_mcu9t5v0__clkinv_1_11 dec_data_strobe VDD VSS \_057_
+ gf180mcu_fd_sc_mcu9t5v0__clkinv_1
* cell instance gf180mcu_fd_sc_mcu9t5v0__clkinv_1_12 r0 *1 0,0
Xgf180mcu_fd_sc_mcu9t5v0__clkinv_1_12 byte_reg[4] VDD VSS \_150_
+ gf180mcu_fd_sc_mcu9t5v0__clkinv_1
* cell instance gf180mcu_fd_sc_mcu9t5v0__clkinv_1_13 r0 *1 0,0
Xgf180mcu_fd_sc_mcu9t5v0__clkinv_1_13 OpMode[1] VDD VSS \_076_
+ gf180mcu_fd_sc_mcu9t5v0__clkinv_1
* cell instance gf180mcu_fd_sc_mcu9t5v0__clkinv_1_14 r0 *1 0,0
Xgf180mcu_fd_sc_mcu9t5v0__clkinv_1_14 byte_reg[3] VDD VSS \_152_
+ gf180mcu_fd_sc_mcu9t5v0__clkinv_1
* cell instance gf180mcu_fd_sc_mcu9t5v0__clkinv_1_15 r0 *1 0,0
Xgf180mcu_fd_sc_mcu9t5v0__clkinv_1_15 byte_reg[2] VDD VSS \_156_
+ gf180mcu_fd_sc_mcu9t5v0__clkinv_1
* cell instance gf180mcu_fd_sc_mcu9t5v0__clkinv_1_16 r0 *1 0,0
Xgf180mcu_fd_sc_mcu9t5v0__clkinv_1_16 raw_mode VDD VSS u_stuffer/_07_
+ gf180mcu_fd_sc_mcu9t5v0__clkinv_1
* cell instance gf180mcu_fd_sc_mcu9t5v0__clkinv_1_17 r0 *1 0,0
Xgf180mcu_fd_sc_mcu9t5v0__clkinv_1_17 \_078_ VDD VSS \_079_
+ gf180mcu_fd_sc_mcu9t5v0__clkinv_1
* cell instance gf180mcu_fd_sc_mcu9t5v0__clkinv_1_18 r0 *1 0,0
Xgf180mcu_fd_sc_mcu9t5v0__clkinv_1_18 u_eop_detector/se0_count[0] VDD VSS
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
Xgf180mcu_fd_sc_mcu9t5v0__dffq_1_26 clknet_3_1__leaf_clk \_039_ byte_reg[6] VDD
+ VSS gf180mcu_fd_sc_mcu9t5v0__dffq_1
* cell instance gf180mcu_fd_sc_mcu9t5v0__dffq_1_27 r0 *1 0,0
Xgf180mcu_fd_sc_mcu9t5v0__dffq_1_27 clknet_3_1__leaf_clk u_line_state/_1_
+ line_state[1] VDD VSS gf180mcu_fd_sc_mcu9t5v0__dffq_1
* cell instance gf180mcu_fd_sc_mcu9t5v0__dffq_1_28 r0 *1 0,0
Xgf180mcu_fd_sc_mcu9t5v0__dffq_1_28 clknet_3_3__leaf_clk \_054_ rx_dec_mask VDD
+ VSS gf180mcu_fd_sc_mcu9t5v0__dffq_1
* cell instance gf180mcu_fd_sc_mcu9t5v0__dffq_1_29 r0 *1 0,0
Xgf180mcu_fd_sc_mcu9t5v0__dffq_1_29 clknet_3_3__leaf_clk u_sync_detector/_04_
+ u_sync_detector/sync_valid VDD VSS gf180mcu_fd_sc_mcu9t5v0__dffq_1
* cell instance gf180mcu_fd_sc_mcu9t5v0__dffq_1_30 r0 *1 0,0
Xgf180mcu_fd_sc_mcu9t5v0__dffq_1_30 clknet_3_3__leaf_clk u_eop_detector/_07_
+ eop_pulse VDD VSS gf180mcu_fd_sc_mcu9t5v0__dffq_1
* cell instance gf180mcu_fd_sc_mcu9t5v0__dffq_1_31 r0 *1 0,0
Xgf180mcu_fd_sc_mcu9t5v0__dffq_1_31 clknet_3_1__leaf_clk \_016_ byte_reg[7] VDD
+ VSS gf180mcu_fd_sc_mcu9t5v0__dffq_1
* cell instance gf180mcu_fd_sc_mcu9t5v0__dffq_1_32 r0 *1 0,0
Xgf180mcu_fd_sc_mcu9t5v0__dffq_1_32 clknet_3_3__leaf_clk u_eop_detector/_01_
+ u_eop_detector/se0_count[2] VDD VSS gf180mcu_fd_sc_mcu9t5v0__dffq_1
* cell instance gf180mcu_fd_sc_mcu9t5v0__dffq_1_33 r0 *1 0,0
Xgf180mcu_fd_sc_mcu9t5v0__dffq_1_33 clknet_3_1__leaf_clk u_line_state/_0_
+ line_state[0] VDD VSS gf180mcu_fd_sc_mcu9t5v0__dffq_1
* cell instance gf180mcu_fd_sc_mcu9t5v0__dffq_1_34 r0 *1 0,0
Xgf180mcu_fd_sc_mcu9t5v0__dffq_1_34 clknet_3_6__leaf_clk \_021_ rx_receiving
+ VDD VSS gf180mcu_fd_sc_mcu9t5v0__dffq_1
* cell instance gf180mcu_fd_sc_mcu9t5v0__dffq_1_35 r0 *1 0,0
Xgf180mcu_fd_sc_mcu9t5v0__dffq_1_35 clknet_3_4__leaf_clk \_043_ byte_reg[4] VDD
+ VSS gf180mcu_fd_sc_mcu9t5v0__dffq_1
* cell instance gf180mcu_fd_sc_mcu9t5v0__dffq_1_36 r0 *1 0,0
Xgf180mcu_fd_sc_mcu9t5v0__dffq_1_36 clknet_3_6__leaf_clk u_eop_detector/_00_
+ bus_reset VDD VSS gf180mcu_fd_sc_mcu9t5v0__dffq_1
* cell instance gf180mcu_fd_sc_mcu9t5v0__dffq_1_37 r0 *1 0,0
Xgf180mcu_fd_sc_mcu9t5v0__dffq_1_37 clknet_3_6__leaf_clk u_eop_detector/_05_
+ u_eop_detector/se0_count[3] VDD VSS gf180mcu_fd_sc_mcu9t5v0__dffq_1
* cell instance gf180mcu_fd_sc_mcu9t5v0__dffq_1_38 r0 *1 0,0
Xgf180mcu_fd_sc_mcu9t5v0__dffq_1_38 clknet_3_4__leaf_clk \_045_ byte_reg[3] VDD
+ VSS gf180mcu_fd_sc_mcu9t5v0__dffq_1
* cell instance gf180mcu_fd_sc_mcu9t5v0__dffq_1_39 r0 *1 0,0
Xgf180mcu_fd_sc_mcu9t5v0__dffq_1_39 clknet_3_4__leaf_clk \_047_ byte_reg[2] VDD
+ VSS gf180mcu_fd_sc_mcu9t5v0__dffq_1
* cell instance gf180mcu_fd_sc_mcu9t5v0__dffq_1_40 r0 *1 0,0
Xgf180mcu_fd_sc_mcu9t5v0__dffq_1_40 clknet_3_6__leaf_clk u_eop_detector/_03_
+ u_eop_detector/se0_count[0] VDD VSS gf180mcu_fd_sc_mcu9t5v0__dffq_1
* cell instance gf180mcu_fd_sc_mcu9t5v0__dffq_1_41 r0 *1 0,0
Xgf180mcu_fd_sc_mcu9t5v0__dffq_1_41 clknet_3_4__leaf_clk \_014_ first_byte VDD
+ VSS gf180mcu_fd_sc_mcu9t5v0__dffq_1
* cell instance gf180mcu_fd_sc_mcu9t5v0__dffq_1_42 r0 *1 0,0
Xgf180mcu_fd_sc_mcu9t5v0__dffq_1_42 clknet_3_6__leaf_clk u_eop_detector/_02_
+ u_eop_detector/se0_count[1] VDD VSS gf180mcu_fd_sc_mcu9t5v0__dffq_1
* cell instance gf180mcu_fd_sc_mcu9t5v0__dffq_1_43 r0 *1 0,0
Xgf180mcu_fd_sc_mcu9t5v0__dffq_1_43 clknet_3_5__leaf_clk \_051_ byte_reg[0] VDD
+ VSS gf180mcu_fd_sc_mcu9t5v0__dffq_1
* cell instance gf180mcu_fd_sc_mcu9t5v0__dffq_1_44 r0 *1 0,0
Xgf180mcu_fd_sc_mcu9t5v0__dffq_1_44 clknet_3_7__leaf_clk u_eop_detector/_06_
+ u_eop_detector/se0_count[5] VDD VSS gf180mcu_fd_sc_mcu9t5v0__dffq_1
* cell instance gf180mcu_fd_sc_mcu9t5v0__dffq_1_45 r0 *1 0,0
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
