2AMLogic/gf180-usb2-phy/verification/records/digital-lvs/artifacts/20260922-042422-9ec2304/usb_utmi_phy_layout.spice

* extracted by klt extract --deck gf180mcu

* cell usb_utmi_phy
* pin DataIn[0]
* pin DataIn[1]
* pin DataIn[2]
* pin DataIn[3]
* pin DataIn[4]
* pin DataIn[5]
* pin DataIn[6]
* pin DataIn[7]
* pin DataOut[0]
* pin DataOut[1]
* pin DataOut[2]
* pin DataOut[3]
* pin DataOut[4]
* pin DataOut[5]
* pin DataOut[6]
* pin DataOut[7]
* pin OpMode[0]
* pin OpMode[1]
* pin Reset
* pin RxError
* pin RxValid
* pin TxReady
* pin TxValid
* pin VDD
* pin VSS
* pin clk
* pin line_state[0]
* pin line_state[1]
* pin rst_n
* pin rx_receiving
* pin rxdm
* pin rxdp
* pin txdm
* pin txdp
* pin SuspendM
* pin TermSelect
* pin XcvrSelect
.SUBCKT usb_utmi_phy DataIn[0] DataIn[1] DataIn[2] DataIn[3] DataIn[4]
+ DataIn[5] DataIn[6] DataIn[7] DataOut[0] DataOut[1] DataOut[2] DataOut[3]
+ DataOut[4] DataOut[5] DataOut[6] DataOut[7] OpMode[0] OpMode[1] Reset RxError
+ RxValid TxReady TxValid VDD VSS clk line_state[0] line_state[1] rst_n
+ rx_receiving rxdm rxdp txdm txdp SuspendM TermSelect XcvrSelect
* cell instance gf180mcu_fd_sc_mcu9t5v0__and2_1_0 r0 *1 0,0
Xgf180mcu_fd_sc_mcu9t5v0__and2_1_0 u_sync_detector/match[0] dec_data_strobe VDD
+ VSS u_sync_detector/_13_ gf180mcu_fd_sc_mcu9t5v0__and2_1
* cell instance gf180mcu_fd_sc_mcu9t5v0__and2_1_1 r0 *1 0,0
Xgf180mcu_fd_sc_mcu9t5v0__and2_1_1 rx_stuff_err \_017_ VDD VSS \_045_
+ gf180mcu_fd_sc_mcu9t5v0__and2_1
* cell instance gf180mcu_fd_sc_mcu9t5v0__and2_1_2 r0 *1 0,0
Xgf180mcu_fd_sc_mcu9t5v0__and2_1_2 u_eop_detector/_12_ u_eop_detector/_26_ VDD
+ VSS u_eop_detector/_07_ gf180mcu_fd_sc_mcu9t5v0__and2_1
* cell instance gf180mcu_fd_sc_mcu9t5v0__and2_1_3 r0 *1 0,0
Xgf180mcu_fd_sc_mcu9t5v0__and2_1_3 tx_state[1] \_053_ VDD VSS \_001_
+ gf180mcu_fd_sc_mcu9t5v0__and2_1
* cell instance gf180mcu_fd_sc_mcu9t5v0__and2_1_4 r0 *1 0,0
Xgf180mcu_fd_sc_mcu9t5v0__and2_1_4 tx_state[5] \_053_ VDD VSS \_000_
+ gf180mcu_fd_sc_mcu9t5v0__and2_1
* cell instance gf180mcu_fd_sc_mcu9t5v0__and2_1_5 r0 *1 0,0
Xgf180mcu_fd_sc_mcu9t5v0__and2_1_5 tx_state[3] \_053_ VDD VSS \_003_
+ gf180mcu_fd_sc_mcu9t5v0__and2_1
* cell instance gf180mcu_fd_sc_mcu9t5v0__and2_1_6 r0 *1 0,0
Xgf180mcu_fd_sc_mcu9t5v0__and2_1_6 \_012_ stuff_consume VDD VSS stuff_bit_out
+ gf180mcu_fd_sc_mcu9t5v0__and2_1
* cell instance gf180mcu_fd_sc_mcu9t5v0__and2_1_7 r0 *1 0,0
Xgf180mcu_fd_sc_mcu9t5v0__and2_1_7 \_053_ \_125_ VDD VSS \_031_
+ gf180mcu_fd_sc_mcu9t5v0__and2_1
* cell instance gf180mcu_fd_sc_mcu9t5v0__and2_1_8 r0 *1 0,0
Xgf180mcu_fd_sc_mcu9t5v0__and2_1_8 \_121_ \_122_ VDD VSS \_029_
+ gf180mcu_fd_sc_mcu9t5v0__and2_1
* cell instance gf180mcu_fd_sc_mcu9t5v0__and2_1_9 r0 *1 0,0
Xgf180mcu_fd_sc_mcu9t5v0__and2_1_9 sync_idx[0] \_119_ VDD VSS \_120_
+ gf180mcu_fd_sc_mcu9t5v0__and2_1
* cell instance gf180mcu_fd_sc_mcu9t5v0__and2_2_0 r0 *1 0,0
Xgf180mcu_fd_sc_mcu9t5v0__and2_2_0 u_sync_detector/match[2]
+ u_sync_detector/_10_ VDD VSS u_sync_detector/_11_
+ gf180mcu_fd_sc_mcu9t5v0__and2_2
* cell instance gf180mcu_fd_sc_mcu9t5v0__and2_2_1 r0 *1 0,0
Xgf180mcu_fd_sc_mcu9t5v0__and2_2_1 \_053_ sync_next VDD VSS
+ u_sync_detector/_04_ gf180mcu_fd_sc_mcu9t5v0__and2_2
* cell instance gf180mcu_fd_sc_mcu9t5v0__and2_4_0 r0 *1 0,0
Xgf180mcu_fd_sc_mcu9t5v0__and2_4_0 rx_bit_valid rx_assembly_en VDD VSS \_086_
+ gf180mcu_fd_sc_mcu9t5v0__and2_4
* cell instance gf180mcu_fd_sc_mcu9t5v0__and2_4_1 r0 *1 0,0
Xgf180mcu_fd_sc_mcu9t5v0__and2_4_1 \_053_ rxdm VDD VSS u_line_state/_1_
+ gf180mcu_fd_sc_mcu9t5v0__and2_4
* cell instance gf180mcu_fd_sc_mcu9t5v0__and3_1_0 r0 *1 0,0
Xgf180mcu_fd_sc_mcu9t5v0__and3_1_0 u_eop_detector/se0_count[3]
+ u_eop_detector/se0_count[2] u_eop_detector/_15_ VDD VSS u_eop_detector/_24_
+ gf180mcu_fd_sc_mcu9t5v0__and3_1
* cell instance gf180mcu_fd_sc_mcu9t5v0__and3_1_1 r0 *1 0,0
Xgf180mcu_fd_sc_mcu9t5v0__and3_1_1 sync_idx[0] sync_idx[2] sync_idx[1] VDD VSS
+ \_063_ gf180mcu_fd_sc_mcu9t5v0__and3_1
* cell instance gf180mcu_fd_sc_mcu9t5v0__and3_2_0 r0 *1 0,0
Xgf180mcu_fd_sc_mcu9t5v0__and3_2_0 u_sync_detector/match[0] dec_data_strobe
+ u_sync_detector/match[1] VDD VSS u_sync_detector/_10_
+ gf180mcu_fd_sc_mcu9t5v0__and3_2
* cell instance gf180mcu_fd_sc_mcu9t5v0__and3_2_1 r0 *1 0,0
Xgf180mcu_fd_sc_mcu9t5v0__and3_2_1 rx_receiving dec_data_bit u_destuffer/_06_
+ VDD VSS u_destuffer/_09_ gf180mcu_fd_sc_mcu9t5v0__and3_2
* cell instance gf180mcu_fd_sc_mcu9t5v0__and3_4_0 r0 *1 0,0
Xgf180mcu_fd_sc_mcu9t5v0__and3_4_0 rx_bitcnt[1] rx_bitcnt[0] \_086_ VDD VSS
+ \_095_ gf180mcu_fd_sc_mcu9t5v0__and3_4
* cell instance gf180mcu_fd_sc_mcu9t5v0__and3_4_1 r0 *1 0,0
Xgf180mcu_fd_sc_mcu9t5v0__and3_4_1 u_eop_detector/se0_count[3]
+ u_eop_detector/se0_count[4] u_eop_detector/se0_count[2] VDD VSS
+ u_eop_detector/_10_ gf180mcu_fd_sc_mcu9t5v0__and3_4
* cell instance gf180mcu_fd_sc_mcu9t5v0__and4_1_0 r0 *1 0,0
Xgf180mcu_fd_sc_mcu9t5v0__and4_1_0 dec_data_strobe rx_receiving dec_data_bit
+ u_destuffer/_07_ VDD VSS u_destuffer/_01_ gf180mcu_fd_sc_mcu9t5v0__and4_1
* cell instance gf180mcu_fd_sc_mcu9t5v0__and4_4_0 r0 *1 0,0
Xgf180mcu_fd_sc_mcu9t5v0__and4_4_0 rx_receiving rx_bitcnt[2] \_053_ \_095_ VDD
+ VSS \_096_ gf180mcu_fd_sc_mcu9t5v0__and4_4
* cell instance gf180mcu_fd_sc_mcu9t5v0__aoi211_1_0 r0 *1 0,0
Xgf180mcu_fd_sc_mcu9t5v0__aoi211_1_0 u_sync_detector/_06_ u_sync_detector/_13_
+ u_sync_detector/_15_ u_sync_detector/_09_ VDD VSS u_sync_detector/_03_
+ gf180mcu_fd_sc_mcu9t5v0__aoi211_1
* cell instance gf180mcu_fd_sc_mcu9t5v0__aoi211_1_1 r0 *1 0,0
Xgf180mcu_fd_sc_mcu9t5v0__aoi211_1_1 u_eop_detector/_14_ u_eop_detector/_18_
+ u_eop_detector/_15_ u_eop_detector/_09_ VDD VSS u_eop_detector/_02_
+ gf180mcu_fd_sc_mcu9t5v0__aoi211_1
* cell instance gf180mcu_fd_sc_mcu9t5v0__aoi211_1_2 r0 *1 0,0
Xgf180mcu_fd_sc_mcu9t5v0__aoi211_1_2 \_099_ \_092_ \_100_ \_052_ VDD VSS \_019_
+ gf180mcu_fd_sc_mcu9t5v0__aoi211_1
* cell instance gf180mcu_fd_sc_mcu9t5v0__aoi211_1_3 r0 *1 0,0
Xgf180mcu_fd_sc_mcu9t5v0__aoi211_1_3 \_097_ \_092_ \_098_ \_052_ VDD VSS \_018_
+ gf180mcu_fd_sc_mcu9t5v0__aoi211_1
* cell instance gf180mcu_fd_sc_mcu9t5v0__aoi211_1_4 r0 *1 0,0
Xgf180mcu_fd_sc_mcu9t5v0__aoi211_1_4 \_107_ \_092_ \_108_ \_052_ VDD VSS \_023_
+ gf180mcu_fd_sc_mcu9t5v0__aoi211_1
* cell instance gf180mcu_fd_sc_mcu9t5v0__aoi211_1_5 r0 *1 0,0
Xgf180mcu_fd_sc_mcu9t5v0__aoi211_1_5 \_109_ \_092_ \_110_ \_052_ VDD VSS \_024_
+ gf180mcu_fd_sc_mcu9t5v0__aoi211_1
* cell instance gf180mcu_fd_sc_mcu9t5v0__aoi211_1_6 r0 *1 0,0
Xgf180mcu_fd_sc_mcu9t5v0__aoi211_1_6 \_090_ \_092_ \_094_ \_052_ VDD VSS \_015_
+ gf180mcu_fd_sc_mcu9t5v0__aoi211_1
* cell instance gf180mcu_fd_sc_mcu9t5v0__aoi211_1_7 r0 *1 0,0
Xgf180mcu_fd_sc_mcu9t5v0__aoi211_1_7 \_129_ \_092_ \_130_ \_052_ VDD VSS \_038_
+ gf180mcu_fd_sc_mcu9t5v0__aoi211_1
* cell instance gf180mcu_fd_sc_mcu9t5v0__aoi211_1_8 r0 *1 0,0
Xgf180mcu_fd_sc_mcu9t5v0__aoi211_1_8 \_101_ \_092_ \_102_ \_052_ VDD VSS \_020_
+ gf180mcu_fd_sc_mcu9t5v0__aoi211_1
* cell instance gf180mcu_fd_sc_mcu9t5v0__aoi211_1_9 r0 *1 0,0
Xgf180mcu_fd_sc_mcu9t5v0__aoi211_1_9 \_064_ \_119_ \_123_ \_052_ VDD VSS \_030_
+ gf180mcu_fd_sc_mcu9t5v0__aoi211_1
* cell instance gf180mcu_fd_sc_mcu9t5v0__aoi211_1_10 r0 *1 0,0
Xgf180mcu_fd_sc_mcu9t5v0__aoi211_1_10 \_080_ \_134_ \_142_ \_052_ VDD VSS
+ \_047_ gf180mcu_fd_sc_mcu9t5v0__aoi211_1
* cell instance gf180mcu_fd_sc_mcu9t5v0__aoi211_1_11 r0 *1 0,0
Xgf180mcu_fd_sc_mcu9t5v0__aoi211_1_11 \_132_ \_143_ \_144_ \_052_ VDD VSS
+ \_048_ gf180mcu_fd_sc_mcu9t5v0__aoi211_1
* cell instance gf180mcu_fd_sc_mcu9t5v0__aoi211_1_12 r0 *1 0,0
Xgf180mcu_fd_sc_mcu9t5v0__aoi211_1_12 \_105_ \_092_ \_106_ \_052_ VDD VSS
+ \_022_ gf180mcu_fd_sc_mcu9t5v0__aoi211_1
* cell instance gf180mcu_fd_sc_mcu9t5v0__aoi211_1_13 r0 *1 0,0
Xgf180mcu_fd_sc_mcu9t5v0__aoi211_1_13 tx_state[4] \_120_ \_126_ \_052_ VDD VSS
+ \_032_ gf180mcu_fd_sc_mcu9t5v0__aoi211_1
* cell instance gf180mcu_fd_sc_mcu9t5v0__aoi211_2_0 r0 *1 0,0
Xgf180mcu_fd_sc_mcu9t5v0__aoi211_2_0 \_131_ \_135_ \_137_ \_052_ VDD VSS \_040_
+ gf180mcu_fd_sc_mcu9t5v0__aoi211_2
* cell instance gf180mcu_fd_sc_mcu9t5v0__aoi21_1_0 r0 *1 0,0
Xgf180mcu_fd_sc_mcu9t5v0__aoi21_1_0 rx_bitcnt[0] \_086_ rx_bitcnt[1] VDD VSS
+ \_145_ gf180mcu_fd_sc_mcu9t5v0__aoi21_1
* cell instance gf180mcu_fd_sc_mcu9t5v0__aoi21_1_1 r0 *1 0,0
Xgf180mcu_fd_sc_mcu9t5v0__aoi21_1_1 \_115_ \_116_ \_089_ VDD VSS \_027_
+ gf180mcu_fd_sc_mcu9t5v0__aoi21_1
* cell instance gf180mcu_fd_sc_mcu9t5v0__aoi21_1_2 r0 *1 0,0
Xgf180mcu_fd_sc_mcu9t5v0__aoi21_1_2 \_117_ \_118_ \_089_ VDD VSS \_028_
+ gf180mcu_fd_sc_mcu9t5v0__aoi21_1
* cell instance gf180mcu_fd_sc_mcu9t5v0__aoi21_1_3 r0 *1 0,0
Xgf180mcu_fd_sc_mcu9t5v0__aoi21_1_3 u_destuffer/ones_run[1] u_destuffer/_12_
+ u_destuffer/ones_run[2] VDD VSS u_destuffer/_14_
+ gf180mcu_fd_sc_mcu9t5v0__aoi21_1
* cell instance gf180mcu_fd_sc_mcu9t5v0__aoi21_1_4 r0 *1 0,0
Xgf180mcu_fd_sc_mcu9t5v0__aoi21_1_4 \_113_ \_114_ \_089_ VDD VSS \_026_
+ gf180mcu_fd_sc_mcu9t5v0__aoi21_1
* cell instance gf180mcu_fd_sc_mcu9t5v0__aoi21_1_5 r0 *1 0,0
Xgf180mcu_fd_sc_mcu9t5v0__aoi21_1_5 dec_data_strobe u_destuffer/_09_
+ u_destuffer/ones_run[0] VDD VSS u_destuffer/_15_
+ gf180mcu_fd_sc_mcu9t5v0__aoi21_1
* cell instance gf180mcu_fd_sc_mcu9t5v0__aoi21_1_6 r0 *1 0,0
Xgf180mcu_fd_sc_mcu9t5v0__aoi21_1_6 rx_bitcnt[2] \_095_ \_128_ VDD VSS \_036_
+ gf180mcu_fd_sc_mcu9t5v0__aoi21_1
* cell instance gf180mcu_fd_sc_mcu9t5v0__aoi21_1_7 r0 *1 0,0
Xgf180mcu_fd_sc_mcu9t5v0__aoi21_1_7 \_111_ \_112_ \_089_ VDD VSS \_025_
+ gf180mcu_fd_sc_mcu9t5v0__aoi21_1
* cell instance gf180mcu_fd_sc_mcu9t5v0__aoi21_1_8 r0 *1 0,0
Xgf180mcu_fd_sc_mcu9t5v0__aoi21_1_8 u_eop_detector/_22_ u_eop_detector/_23_
+ u_eop_detector/_09_ VDD VSS u_eop_detector/_04_
+ gf180mcu_fd_sc_mcu9t5v0__aoi21_1
* cell instance gf180mcu_fd_sc_mcu9t5v0__aoi21_1_9 r0 *1 0,0
Xgf180mcu_fd_sc_mcu9t5v0__aoi21_1_9 \_103_ \_104_ \_089_ VDD VSS \_021_
+ gf180mcu_fd_sc_mcu9t5v0__aoi21_1
* cell instance gf180mcu_fd_sc_mcu9t5v0__aoi21_1_10 r0 *1 0,0
Xgf180mcu_fd_sc_mcu9t5v0__aoi21_1_10 \_085_ \_088_ \_089_ VDD VSS \_014_
+ gf180mcu_fd_sc_mcu9t5v0__aoi21_1
* cell instance gf180mcu_fd_sc_mcu9t5v0__aoi21_1_11 r0 *1 0,0
Xgf180mcu_fd_sc_mcu9t5v0__aoi21_1_11 \_146_ \_147_ \_089_ VDD VSS \_050_
+ gf180mcu_fd_sc_mcu9t5v0__aoi21_1
* cell instance gf180mcu_fd_sc_mcu9t5v0__aoi21_1_12 r0 *1 0,0
Xgf180mcu_fd_sc_mcu9t5v0__aoi21_1_12 u_eop_detector/se0_count[2]
+ u_eop_detector/_15_ u_eop_detector/se0_count[3] VDD VSS u_eop_detector/_25_
+ gf180mcu_fd_sc_mcu9t5v0__aoi21_1
* cell instance gf180mcu_fd_sc_mcu9t5v0__aoi21_1_13 r0 *1 0,0
Xgf180mcu_fd_sc_mcu9t5v0__aoi21_1_13 u_eop_detector/_10_ u_eop_detector/_12_
+ bus_reset VDD VSS u_eop_detector/_13_ gf180mcu_fd_sc_mcu9t5v0__aoi21_1
* cell instance gf180mcu_fd_sc_mcu9t5v0__aoi21_1_14 r0 *1 0,0
Xgf180mcu_fd_sc_mcu9t5v0__aoi21_1_14 u_eop_detector/se0_count[1]
+ u_eop_detector/_10_ u_eop_detector/_18_ VDD VSS u_eop_detector/_19_
+ gf180mcu_fd_sc_mcu9t5v0__aoi21_1
* cell instance gf180mcu_fd_sc_mcu9t5v0__aoi21_1_15 r0 *1 0,0
Xgf180mcu_fd_sc_mcu9t5v0__aoi21_1_15 u_eop_detector/_17_ u_eop_detector/_20_
+ u_eop_detector/se0_count[0] VDD VSS u_eop_detector/_21_
+ gf180mcu_fd_sc_mcu9t5v0__aoi21_1
* cell instance gf180mcu_fd_sc_mcu9t5v0__aoi21_1_16 r0 *1 0,0
Xgf180mcu_fd_sc_mcu9t5v0__aoi21_1_16 \_079_ \_082_ tx_state[6] VDD VSS \_012_
+ gf180mcu_fd_sc_mcu9t5v0__aoi21_1
* cell instance gf180mcu_fd_sc_mcu9t5v0__aoi21_1_17 r0 *1 0,0
Xgf180mcu_fd_sc_mcu9t5v0__aoi21_1_17 \_061_ \_064_ \_052_ VDD VSS \_007_
+ gf180mcu_fd_sc_mcu9t5v0__aoi21_1
* cell instance gf180mcu_fd_sc_mcu9t5v0__aoi21_1_18 r0 *1 0,0
Xgf180mcu_fd_sc_mcu9t5v0__aoi21_1_18 \_073_ \_075_ \_052_ VDD VSS \_006_
+ gf180mcu_fd_sc_mcu9t5v0__aoi21_1
* cell instance gf180mcu_fd_sc_mcu9t5v0__aoi21_1_19 r0 *1 0,0
Xgf180mcu_fd_sc_mcu9t5v0__aoi21_1_19 sync_idx[1] \_120_ sync_idx[2] VDD VSS
+ \_123_ gf180mcu_fd_sc_mcu9t5v0__aoi21_1
* cell instance gf180mcu_fd_sc_mcu9t5v0__aoi21_1_20 r0 *1 0,0
Xgf180mcu_fd_sc_mcu9t5v0__aoi21_1_20 tx_state[2] \_136_ \_134_ VDD VSS \_137_
+ gf180mcu_fd_sc_mcu9t5v0__aoi21_1
* cell instance gf180mcu_fd_sc_mcu9t5v0__aoi21_1_21 r0 *1 0,0
Xgf180mcu_fd_sc_mcu9t5v0__aoi21_1_21 byte_idx[0] byte_idx[1] \_140_ VDD VSS
+ \_141_ gf180mcu_fd_sc_mcu9t5v0__aoi21_1
* cell instance gf180mcu_fd_sc_mcu9t5v0__aoi21_2_0 r0 *1 0,0
Xgf180mcu_fd_sc_mcu9t5v0__aoi21_2_0 u_destuffer/_08_ rx_receiving
+ u_destuffer/_09_ VDD VSS u_destuffer/_10_ gf180mcu_fd_sc_mcu9t5v0__aoi21_2
* cell instance gf180mcu_fd_sc_mcu9t5v0__aoi21_2_1 r0 *1 0,0
Xgf180mcu_fd_sc_mcu9t5v0__aoi21_2_1 tx_body_active u_stuffer/_09_
+ u_stuffer/_13_ VDD VSS u_stuffer/_02_ gf180mcu_fd_sc_mcu9t5v0__aoi21_2
* cell instance gf180mcu_fd_sc_mcu9t5v0__aoi21_2_2 r0 *1 0,0
Xgf180mcu_fd_sc_mcu9t5v0__aoi21_2_2 tx_body_active u_stuffer/_09_
+ u_stuffer/_11_ VDD VSS u_stuffer/_01_ gf180mcu_fd_sc_mcu9t5v0__aoi21_2
* cell instance gf180mcu_fd_sc_mcu9t5v0__aoi21_2_3 r0 *1 0,0
Xgf180mcu_fd_sc_mcu9t5v0__aoi21_2_3 u_stuffer/_03_ stuff_consume \_008_ VDD VSS
+ u_stuffer/_06_ gf180mcu_fd_sc_mcu9t5v0__aoi21_2
* cell instance gf180mcu_fd_sc_mcu9t5v0__aoi21_4_0 r0 *1 0,0
Xgf180mcu_fd_sc_mcu9t5v0__aoi21_4_0 u_destuffer/_08_ rx_receiving
+ u_destuffer/_11_ VDD VSS u_destuffer/_12_ gf180mcu_fd_sc_mcu9t5v0__aoi21_4
* cell instance gf180mcu_fd_sc_mcu9t5v0__aoi21_4_1 r0 *1 0,0
Xgf180mcu_fd_sc_mcu9t5v0__aoi21_4_1 rx_receiving u_destuffer/_07_
+ u_destuffer/_08_ VDD VSS u_destuffer/_00_ gf180mcu_fd_sc_mcu9t5v0__aoi21_4
* cell instance gf180mcu_fd_sc_mcu9t5v0__aoi221_1_0 r0 *1 0,0
Xgf180mcu_fd_sc_mcu9t5v0__aoi221_1_0 \_062_ entering_sync \_120_ sync_idx[1]
+ \_052_ VDD VSS \_122_ gf180mcu_fd_sc_mcu9t5v0__aoi221_1
* cell instance gf180mcu_fd_sc_mcu9t5v0__aoi22_4_0 r0 *1 0,0
Xgf180mcu_fd_sc_mcu9t5v0__aoi22_4_0 tx_state[2] \_074_ \_091_ \_061_ VDD VSS
+ \_092_ gf180mcu_fd_sc_mcu9t5v0__aoi22_4
* cell instance gf180mcu_fd_sc_mcu9t5v0__buf_4_0 r0 *1 0,0
Xgf180mcu_fd_sc_mcu9t5v0__buf_4_0 clknet_0_clk VDD VSS clknet_3_2__leaf_clk
+ gf180mcu_fd_sc_mcu9t5v0__buf_4
* cell instance gf180mcu_fd_sc_mcu9t5v0__buf_4_1 r0 *1 0,0
Xgf180mcu_fd_sc_mcu9t5v0__buf_4_1 clknet_0_clk VDD VSS clknet_3_0__leaf_clk
+ gf180mcu_fd_sc_mcu9t5v0__buf_4
* cell instance gf180mcu_fd_sc_mcu9t5v0__buf_4_2 r0 *1 0,0
Xgf180mcu_fd_sc_mcu9t5v0__buf_4_2 clknet_0_clk VDD VSS clknet_3_1__leaf_clk
+ gf180mcu_fd_sc_mcu9t5v0__buf_4
* cell instance gf180mcu_fd_sc_mcu9t5v0__buf_4_3 r0 *1 0,0
Xgf180mcu_fd_sc_mcu9t5v0__buf_4_3 clknet_0_clk VDD VSS clknet_3_3__leaf_clk
+ gf180mcu_fd_sc_mcu9t5v0__buf_4
* cell instance gf180mcu_fd_sc_mcu9t5v0__buf_4_4 r0 *1 0,0
Xgf180mcu_fd_sc_mcu9t5v0__buf_4_4 clk VDD VSS clknet_0_clk
+ gf180mcu_fd_sc_mcu9t5v0__buf_4
* cell instance gf180mcu_fd_sc_mcu9t5v0__buf_4_5 r0 *1 0,0
Xgf180mcu_fd_sc_mcu9t5v0__buf_4_5 clknet_0_clk VDD VSS clknet_3_6__leaf_clk
+ gf180mcu_fd_sc_mcu9t5v0__buf_4
* cell instance gf180mcu_fd_sc_mcu9t5v0__buf_4_6 r0 *1 0,0
Xgf180mcu_fd_sc_mcu9t5v0__buf_4_6 clknet_0_clk VDD VSS clknet_3_4__leaf_clk
+ gf180mcu_fd_sc_mcu9t5v0__buf_4
* cell instance gf180mcu_fd_sc_mcu9t5v0__buf_4_7 r0 *1 0,0
Xgf180mcu_fd_sc_mcu9t5v0__buf_4_7 clknet_0_clk VDD VSS clknet_3_7__leaf_clk
+ gf180mcu_fd_sc_mcu9t5v0__buf_4
* cell instance gf180mcu_fd_sc_mcu9t5v0__buf_4_8 r0 *1 0,0
Xgf180mcu_fd_sc_mcu9t5v0__buf_4_8 clknet_0_clk VDD VSS clknet_3_5__leaf_clk
+ gf180mcu_fd_sc_mcu9t5v0__buf_4
* cell instance gf180mcu_fd_sc_mcu9t5v0__clkinv_1_0 r0 *1 0,0
Xgf180mcu_fd_sc_mcu9t5v0__clkinv_1_0 u_decoder/_04_ VDD VSS u_decoder/_00_
+ gf180mcu_fd_sc_mcu9t5v0__clkinv_1
* cell instance gf180mcu_fd_sc_mcu9t5v0__clkinv_1_1 r0 *1 0,0
Xgf180mcu_fd_sc_mcu9t5v0__clkinv_1_1 \_089_ VDD VSS \_017_
+ gf180mcu_fd_sc_mcu9t5v0__clkinv_1
* cell instance gf180mcu_fd_sc_mcu9t5v0__clkinv_1_2 r0 *1 0,0
Xgf180mcu_fd_sc_mcu9t5v0__clkinv_1_2 u_sync_detector/match[3] VDD VSS
+ u_sync_detector/_08_ gf180mcu_fd_sc_mcu9t5v0__clkinv_1
* cell instance gf180mcu_fd_sc_mcu9t5v0__clkinv_1_3 r0 *1 0,0
Xgf180mcu_fd_sc_mcu9t5v0__clkinv_1_3 u_eop_detector/se0_count[4] VDD VSS
+ u_eop_detector/_22_ gf180mcu_fd_sc_mcu9t5v0__clkinv_1
* cell instance gf180mcu_fd_sc_mcu9t5v0__clkinv_1_4 r0 *1 0,0
Xgf180mcu_fd_sc_mcu9t5v0__clkinv_1_4 \_010_ VDD VSS u_sync_detector/_05_
+ gf180mcu_fd_sc_mcu9t5v0__clkinv_1
* cell instance gf180mcu_fd_sc_mcu9t5v0__clkinv_1_5 r0 *1 0,0
Xgf180mcu_fd_sc_mcu9t5v0__clkinv_1_5 rx_receiving VDD VSS \_010_
+ gf180mcu_fd_sc_mcu9t5v0__clkinv_1
* cell instance gf180mcu_fd_sc_mcu9t5v0__clkinv_1_6 r0 *1 0,0
Xgf180mcu_fd_sc_mcu9t5v0__clkinv_1_6 \_139_ VDD VSS \_046_
+ gf180mcu_fd_sc_mcu9t5v0__clkinv_1
* cell instance gf180mcu_fd_sc_mcu9t5v0__clkinv_1_7 r0 *1 0,0
Xgf180mcu_fd_sc_mcu9t5v0__clkinv_1_7 line_state[0] VDD VSS \_067_
+ gf180mcu_fd_sc_mcu9t5v0__clkinv_1
* cell instance gf180mcu_fd_sc_mcu9t5v0__clkinv_1_8 r0 *1 0,0
Xgf180mcu_fd_sc_mcu9t5v0__clkinv_1_8 DataOut[4] VDD VSS \_099_
+ gf180mcu_fd_sc_mcu9t5v0__clkinv_1
* cell instance gf180mcu_fd_sc_mcu9t5v0__clkinv_1_9 r0 *1 0,0
Xgf180mcu_fd_sc_mcu9t5v0__clkinv_1_9 DataOut[1] VDD VSS \_107_
+ gf180mcu_fd_sc_mcu9t5v0__clkinv_1
* cell instance gf180mcu_fd_sc_mcu9t5v0__clkinv_1_10 r0 *1 0,0
Xgf180mcu_fd_sc_mcu9t5v0__clkinv_1_10 DataOut[3] VDD VSS \_101_
+ gf180mcu_fd_sc_mcu9t5v0__clkinv_1
* cell instance gf180mcu_fd_sc_mcu9t5v0__clkinv_1_11 r0 *1 0,0
Xgf180mcu_fd_sc_mcu9t5v0__clkinv_1_11 u_eop_detector/se0_count[0] VDD VSS
+ u_eop_detector/_11_ gf180mcu_fd_sc_mcu9t5v0__clkinv_1
* cell instance gf180mcu_fd_sc_mcu9t5v0__clkinv_1_12 r0 *1 0,0
Xgf180mcu_fd_sc_mcu9t5v0__clkinv_1_12 u_eop_detector/se0_count[5] VDD VSS
+ u_eop_detector/_17_ gf180mcu_fd_sc_mcu9t5v0__clkinv_1
* cell instance gf180mcu_fd_sc_mcu9t5v0__clkinv_1_13 r0 *1 0,0
Xgf180mcu_fd_sc_mcu9t5v0__clkinv_1_13 Reset VDD VSS \_051_
+ gf180mcu_fd_sc_mcu9t5v0__clkinv_1
* cell instance gf180mcu_fd_sc_mcu9t5v0__clkinv_1_14 r0 *1 0,0
Xgf180mcu_fd_sc_mcu9t5v0__clkinv_1_14 OpMode[1] VDD VSS \_077_
+ gf180mcu_fd_sc_mcu9t5v0__clkinv_1
* cell instance gf180mcu_fd_sc_mcu9t5v0__clkinv_1_15 r0 *1 0,0
Xgf180mcu_fd_sc_mcu9t5v0__clkinv_1_15 DataOut[5] VDD VSS \_097_
+ gf180mcu_fd_sc_mcu9t5v0__clkinv_1
* cell instance gf180mcu_fd_sc_mcu9t5v0__clkinv_1_16 r0 *1 0,0
Xgf180mcu_fd_sc_mcu9t5v0__clkinv_1_16 \_068_ VDD VSS tx_body_active
+ gf180mcu_fd_sc_mcu9t5v0__clkinv_1
* cell instance gf180mcu_fd_sc_mcu9t5v0__clkinv_1_17 r0 *1 0,0
Xgf180mcu_fd_sc_mcu9t5v0__clkinv_1_17 tx_state[7] VDD VSS \_060_
+ gf180mcu_fd_sc_mcu9t5v0__clkinv_1
* cell instance gf180mcu_fd_sc_mcu9t5v0__clkinv_1_18 r0 *1 0,0
Xgf180mcu_fd_sc_mcu9t5v0__clkinv_1_18 DataOut[0] VDD VSS \_109_
+ gf180mcu_fd_sc_mcu9t5v0__clkinv_1
* cell instance gf180mcu_fd_sc_mcu9t5v0__clkinv_1_19 r0 *1 0,0
Xgf180mcu_fd_sc_mcu9t5v0__clkinv_1_19 stuff_consume VDD VSS \_072_
+ gf180mcu_fd_sc_mcu9t5v0__clkinv_1
* cell instance gf180mcu_fd_sc_mcu9t5v0__clkinv_1_20 r0 *1 0,0
Xgf180mcu_fd_sc_mcu9t5v0__clkinv_1_20 stuff_pending_after VDD VSS \_066_
+ gf180mcu_fd_sc_mcu9t5v0__clkinv_1
* cell instance gf180mcu_fd_sc_mcu9t5v0__clkinv_1_21 r0 *1 0,0
Xgf180mcu_fd_sc_mcu9t5v0__clkinv_1_21 tx_state[0] VDD VSS \_059_
+ gf180mcu_fd_sc_mcu9t5v0__clkinv_1
* cell instance gf180mcu_fd_sc_mcu9t5v0__clkinv_1_22 r0 *1 0,0
Xgf180mcu_fd_sc_mcu9t5v0__clkinv_1_22 raw_mode VDD VSS u_stuffer/_07_
+ gf180mcu_fd_sc_mcu9t5v0__clkinv_1
* cell instance gf180mcu_fd_sc_mcu9t5v0__clkinv_1_23 r0 *1 0,0
Xgf180mcu_fd_sc_mcu9t5v0__clkinv_1_23 DataOut[6] VDD VSS \_090_
+ gf180mcu_fd_sc_mcu9t5v0__clkinv_1
* cell instance gf180mcu_fd_sc_mcu9t5v0__clkinv_1_24 r0 *1 0,0
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
+ VSS gf180mcu_fd_sc_mcu9t5v0__dffq_1
* cell instance gf180mcu_fd_sc_mcu9t5v0__dffq_1_47 r0 *1 0,0
Xgf180mcu_fd_sc_mcu9t5v0__dffq_1_47 clknet_3_7__leaf_clk \_015_ byte_reg[6] VDD
+ VSS gf180mcu_fd_sc_mcu9t5v0__dffq_1
* cell instance gf180mcu_fd_sc_mcu9t5v0__dffq_1_48 r0 *1 0,0
Xgf180mcu_fd_sc_mcu9t5v0__dffq_1_48 clknet_3_7__leaf_clk \_031_ first_byte VDD
+ VSS gf180mcu_fd_sc_mcu9t5v0__dffq_1
* cell instance gf180mcu_fd_sc_mcu9t5v0__dffq_1_49 r0 *1 0,0
Xgf180mcu_fd_sc_mcu9t5v0__dffq_1_49 clknet_3_5__leaf_clk \_007_ tx_state[4] VDD
+ VSS gf180mcu_fd_sc_mcu9t5v0__dffq_1
* cell instance gf180mcu_fd_sc_mcu9t5v0__dffq_1_50 r0 *1 0,0
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
