2AMLogic/gf180-usb2-phy/verification/records/digital-lvs/artifacts/20260921-132813-1376d98/usb_utmi_phy_reference.spice

* reference netlist for `klt lvs`, generated by scripts/digital_lvs.py
* source: the as-built gate-level Verilog from `klt place-and-route`

.SUBCKT gf180mcu_fd_sc_mcu9t5v0__and2_1 A1 A2 VDD VSS Z
.ENDS
.SUBCKT gf180mcu_fd_sc_mcu9t5v0__and2_2 A1 A2 VDD VSS Z
.ENDS
.SUBCKT gf180mcu_fd_sc_mcu9t5v0__and2_4 A1 A2 VDD VSS Z
.ENDS
.SUBCKT gf180mcu_fd_sc_mcu9t5v0__and3_1 A1 A2 A3 VDD VSS Z
.ENDS
.SUBCKT gf180mcu_fd_sc_mcu9t5v0__and3_2 A1 A2 A3 VDD VSS Z
.ENDS
.SUBCKT gf180mcu_fd_sc_mcu9t5v0__and3_4 A1 A2 A3 VDD VSS Z
.ENDS
.SUBCKT gf180mcu_fd_sc_mcu9t5v0__and4_4 A1 A2 A3 A4 VDD VSS Z
.ENDS
.SUBCKT gf180mcu_fd_sc_mcu9t5v0__aoi211_1 A1 A2 B C VDD VSS ZN
.ENDS
.SUBCKT gf180mcu_fd_sc_mcu9t5v0__aoi211_2 A1 A2 B C VDD VSS ZN
.ENDS
.SUBCKT gf180mcu_fd_sc_mcu9t5v0__aoi21_1 A1 A2 B VDD VSS ZN
.ENDS
.SUBCKT gf180mcu_fd_sc_mcu9t5v0__aoi21_2 A1 A2 B VDD VSS ZN
.ENDS
.SUBCKT gf180mcu_fd_sc_mcu9t5v0__aoi21_4 A1 A2 B VDD VSS ZN
.ENDS
.SUBCKT gf180mcu_fd_sc_mcu9t5v0__aoi221_1 A1 A2 B1 B2 C VDD VSS ZN
.ENDS
.SUBCKT gf180mcu_fd_sc_mcu9t5v0__buf_4 I VDD VSS Z
.ENDS
.SUBCKT gf180mcu_fd_sc_mcu9t5v0__clkinv_1 I VDD VSS ZN
.ENDS
.SUBCKT gf180mcu_fd_sc_mcu9t5v0__clkinv_2 I VDD VSS ZN
.ENDS
.SUBCKT gf180mcu_fd_sc_mcu9t5v0__clkinv_3 I VDD VSS ZN
.ENDS
.SUBCKT gf180mcu_fd_sc_mcu9t5v0__clkinv_8 I VDD VSS ZN
.ENDS
.SUBCKT gf180mcu_fd_sc_mcu9t5v0__dffq_1 CLK D Q VDD VSS
.ENDS
.SUBCKT gf180mcu_fd_sc_mcu9t5v0__inv_1 I VDD VSS ZN
.ENDS
.SUBCKT gf180mcu_fd_sc_mcu9t5v0__inv_2 I VDD VSS ZN
.ENDS
.SUBCKT gf180mcu_fd_sc_mcu9t5v0__inv_3 I VDD VSS ZN
.ENDS
.SUBCKT gf180mcu_fd_sc_mcu9t5v0__inv_4 I VDD VSS ZN
.ENDS
.SUBCKT gf180mcu_fd_sc_mcu9t5v0__mux2_1 I0 I1 S VDD VSS Z
.ENDS
.SUBCKT gf180mcu_fd_sc_mcu9t5v0__mux2_2 I0 I1 S VDD VSS Z
.ENDS
.SUBCKT gf180mcu_fd_sc_mcu9t5v0__mux4_1 I0 I1 I2 I3 S0 S1 VDD VSS Z
.ENDS
.SUBCKT gf180mcu_fd_sc_mcu9t5v0__nand2_1 A1 A2 VDD VSS ZN
.ENDS
.SUBCKT gf180mcu_fd_sc_mcu9t5v0__nand2_2 A1 A2 VDD VSS ZN
.ENDS
.SUBCKT gf180mcu_fd_sc_mcu9t5v0__nand2_4 A1 A2 VDD VSS ZN
.ENDS
.SUBCKT gf180mcu_fd_sc_mcu9t5v0__nand3_1 A1 A2 A3 VDD VSS ZN
.ENDS
.SUBCKT gf180mcu_fd_sc_mcu9t5v0__nand3_2 A1 A2 A3 VDD VSS ZN
.ENDS
.SUBCKT gf180mcu_fd_sc_mcu9t5v0__nand3_4 A1 A2 A3 VDD VSS ZN
.ENDS
.SUBCKT gf180mcu_fd_sc_mcu9t5v0__nand4_1 A1 A2 A3 A4 VDD VSS ZN
.ENDS
.SUBCKT gf180mcu_fd_sc_mcu9t5v0__nand4_4 A1 A2 A3 A4 VDD VSS ZN
.ENDS
.SUBCKT gf180mcu_fd_sc_mcu9t5v0__nor2_1 A1 A2 VDD VSS ZN
.ENDS
.SUBCKT gf180mcu_fd_sc_mcu9t5v0__nor2_2 A1 A2 VDD VSS ZN
.ENDS
.SUBCKT gf180mcu_fd_sc_mcu9t5v0__nor2_4 A1 A2 VDD VSS ZN
.ENDS
.SUBCKT gf180mcu_fd_sc_mcu9t5v0__nor3_1 A1 A2 A3 VDD VSS ZN
.ENDS
.SUBCKT gf180mcu_fd_sc_mcu9t5v0__nor3_2 A1 A2 A3 VDD VSS ZN
.ENDS
.SUBCKT gf180mcu_fd_sc_mcu9t5v0__nor4_1 A1 A2 A3 A4 VDD VSS ZN
.ENDS
.SUBCKT gf180mcu_fd_sc_mcu9t5v0__nor4_2 A1 A2 A3 A4 VDD VSS ZN
.ENDS
.SUBCKT gf180mcu_fd_sc_mcu9t5v0__nor4_4 A1 A2 A3 A4 VDD VSS ZN
.ENDS
.SUBCKT gf180mcu_fd_sc_mcu9t5v0__oai211_1 A1 A2 B C VDD VSS ZN
.ENDS
.SUBCKT gf180mcu_fd_sc_mcu9t5v0__oai211_2 A1 A2 B C VDD VSS ZN
.ENDS
.SUBCKT gf180mcu_fd_sc_mcu9t5v0__oai21_1 A1 A2 B VDD VSS ZN
.ENDS
.SUBCKT gf180mcu_fd_sc_mcu9t5v0__oai21_4 A1 A2 B VDD VSS ZN
.ENDS
.SUBCKT gf180mcu_fd_sc_mcu9t5v0__oai22_1 A1 A2 B1 B2 VDD VSS ZN
.ENDS
.SUBCKT gf180mcu_fd_sc_mcu9t5v0__oai32_4 A1 A2 A3 B1 B2 VDD VSS ZN
.ENDS
.SUBCKT gf180mcu_fd_sc_mcu9t5v0__or2_1 A1 A2 VDD VSS Z
.ENDS
.SUBCKT gf180mcu_fd_sc_mcu9t5v0__or2_2 A1 A2 VDD VSS Z
.ENDS
.SUBCKT gf180mcu_fd_sc_mcu9t5v0__or3_4 A1 A2 A3 VDD VSS Z
.ENDS
.SUBCKT gf180mcu_fd_sc_mcu9t5v0__tiel VDD VSS ZN
.ENDS
.SUBCKT gf180mcu_fd_sc_mcu9t5v0__xnor2_1 A1 A2 VDD VSS ZN
.ENDS
.SUBCKT gf180mcu_fd_sc_mcu9t5v0__xor2_1 A1 A2 VDD VSS Z
.ENDS
.SUBCKT gf180mcu_fd_sc_mcu9t5v0__xor2_2 A1 A2 VDD VSS Z
.ENDS
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
