2AMLogic/gf180-usb2-phy/verification/check_records.py

#!/usr/bin/env python3
"""Evidence-record linter for `verification/records/`.

This is the enforcement half of the convention documented in
`verification/README.md` -- **that document is authoritative**; if this
script and the README ever disagree, fix the script.

Zero dependencies beyond the Python 3 standard library and `git`. Reads
tracked files only (`git ls-files`), so untracked scratch runs are never
linted.

Checks, per record `verification/records/<experiment>/records/<record-id>.md`:

1. **Filename / Record ID grammar** -- the filename stem and the metadata
   block's `record_id` must both match `YYYYMMDD-HHMMSS-<7-40 hex chars>`
   and must agree with each other.
2. **Required fields present** -- the `<!-- record-meta ... -->` JSON block
   must be valid JSON with the required keys (see `REQUIRED_META_KEYS`), and
   every field in `REQUIRED_PROSE_FIELDS` must appear as a non-empty
   top-level markdown bullet (`- **Field**: <non-empty value>`).
3. **Supersedes integrity** -- a non-null `supersedes` value must name a
   record that exists in the same experiment directory.
4. **Provenance hash freshness** -- for every record that is *not*
   superseded by another record (a "live" record), every
   `provenance.inputs[].content_hash` is recomputed from the working tree
   and must match. A live record whose cited source has since changed is a
   stale record -- exactly the case this check exists to catch. Superseded
   records are exempt (they are frozen history, not a claim about current
   sources).
5. **Append-only** -- every path under `verification/records/` must be
   either untracked-before (a pure addition) or unchanged, relative to the
   merge-base with `origin/main` (or `--base-ref`). Any modification,
   rename, or deletion fails. If the base ref cannot be resolved, this
   check prints SKIP unless `--require-append-only` is given.

Usage:
    python3 verification/check_records.py
    python3 verification/check_records.py --require-append-only
    python3 verification/check_records.py --base-ref origin/main

Exit codes: 0 pass, 1 a check failed.

--- Shared core -------------------------------------------------------------

The record-id grammar, the `- **Field**: value` top-level block parser, and
the git merge-base / diff-name-status plumbing below are also the
implementation `sim/harness/evidence_lint.py` imports for the analog-side
`sim/` evidence-record convention (`from verification.check_records import
...`), rather than each side maintaining its own copy of that logic (see
issue #16). The shared pieces stay strictly stdlib-only -- no local imports
beyond the Python standard library anywhere in this file -- because
`verification/test_check_records.py` copies *only* this one file into a
throwaway fixture repo to exercise the real linter as a subprocess; an import
of a second local module would not resolve there. The shared implementation
lives here (in `verification/`, the newer of the two linters) rather than in
`sim/`, specifically so that self-containment constraint keeps holding
without having to touch the existing self-test.

`sim/`'s format-specific pieces -- the corner-id grammar, the
netlist-snapshot/corner-log existence checks, and the
log-count-vs-predecessor check -- are not here; they stay in
`sim/harness/evidence_lint.py`, which is free to import from
`verification/`. `verification/`'s format-specific pieces -- the JSON
`<!-- record-meta -->` block and the content-hash freshness check -- have no
`sim/` equivalent and stay below unchanged.
"""

from __future__ import annotations

import argparse
import hashlib
import json
import re
import subprocess
import sys
from dataclasses import dataclass
from dataclasses import field as _dc_field
from pathlib import Path

REPO_ROOT = Path(__file__).resolve().parent.parent
RECORDS_ROOT = REPO_ROOT / "verification" / "records"

# --- shared core: record-id grammar -----------------------------------------

#: `<YYYYMMDD>-<HHMMSS>-<7-40 hex char short-git-sha>`. Named groups so a
#: caller that also wants to validate the date/time (see
#: `sim/harness/evidence_lint.py`'s `validate_record_id`) does not need its
#: own copy of the pattern.
RECORD_ID_RE = re.compile(r"^(?P<date>\d{8})-(?P<time>\d{6})-(?P<sha>[0-9a-f]{7,40})$")

REQUIRED_META_KEYS = (
    "record_id",
    "experiment",
    "supersedes",
    "git_revision",
    "provenance",
)
REQUIRED_PROVENANCE_KEYS = ("klt_version", "pdk", "deck", "inputs")

REQUIRED_PROSE_FIELDS = (
    "Record ID",
    "Claim",
    "Design provenance",
    "Run configuration",
    "Statistical convention",
    "Result",
    "klt provenance",
    "Links",
    "Timestamp / author",
    "Supersedes",
)

_PLACEHOLDER_VALUES = {"", "tbd", "todo", "fixme", "(fill in)", "(fill me in)"}


class LintError(Exception):
    pass


# --- shared core: `- **Field**: value` top-level block parser --------------

#: A top-level record field: ``- **Name**: value``. A line is only
#: recognised as a new field when it starts at column 0 -- an indented
#: ``- **...**:`` (e.g. a nested bullet inside a **Result** field's detail
#: list) is continuation text of the field above it, not a new field.
_TOP_LEVEL_FIELD_RE = re.compile(r"^- \*\*(?P<name>[^*]+?)\*\*:(?P<value>.*)$")


@dataclass
class RecordField:
    """One ``- **Name**: value`` field plus its indented continuation lines."""

    name: str
    line: int
    inline: str
    continuation: list[str] = _dc_field(default_factory=list)

    @property
    def value(self) -> str:
        parts = [self.inline.strip()] + [line.strip() for line in self.continuation]
        return "\n".join(part for part in parts if part)


def parse_fields(text: str) -> tuple[dict[str, RecordField], list[str]]:
    """Split a record body into its top-level fields.

    Returns ``(fields, duplicate_names)``. A field's value is its inline text
    plus every indented line up to the next top-level line, so multi-line
    fields (e.g. **Result**, **Links**) are read whole. A blank line does not
    end a field's continuation block by itself -- only a non-indented,
    non-blank line (a heading, rule, or paragraph) does -- so a multi-line
    field may contain blank-line-separated sub-blocks (e.g. two markdown
    tables) without losing the second one.
    """
    fields: dict[str, RecordField] = {}
    duplicates: list[str] = []
    current: RecordField | None = None
    for number, line in enumerate(text.splitlines(), start=1):
        match = _TOP_LEVEL_FIELD_RE.match(line)
        if match:
            name = match.group("name").strip()
            current = RecordField(name=name, line=number, inline=match.group("value"))
            if name in fields:
                duplicates.append(name)
            else:
                fields[name] = current
            continue
        if current is None or not line.strip():
            continue
        if line[:1].isspace():
            current.continuation.append(line)
        else:
            current = None  # a heading, rule, or paragraph ends the field block
    return fields, duplicates


# --- shared core: git merge-base / diff-name-status plumbing ---------------


def _git(root: Path, *args: str):
    """``git *args`` in ``root``; ``None`` (not an exception) if git itself
    could not be invoked at all, so callers can distinguish "not a git
    checkout" from "the command failed"."""
    try:
        return subprocess.run(
            ("git", *args),
            cwd=str(root),
            stdout=subprocess.PIPE,
            stderr=subprocess.PIPE,
            text=True,
            check=False,
        )
    except OSError:
        return None


def resolve_base_sha(root: Path, base_ref: str) -> tuple[str | None, str | None]:
    """The merge-base commit of ``base_ref`` and ``HEAD`` in ``root``.

    Returns ``(sha, skip_reason)``; exactly one is ``None``. ``skip_reason``
    distinguishes the ways an append-only check can fail to *run at all*
    (no git, no commits yet, an unresolvable ref, unrelated histories) from
    an actual append-only violation, so a caller can decide between SKIP and
    failing (``--require-append-only``).
    """
    inside = _git(root, "rev-parse", "--is-inside-work-tree")
    if inside is None:
        return None, "git is not available"
    if inside.returncode != 0:
        return None, f"{root} is not a git checkout"
    head = _git(root, "rev-parse", "--verify", "--quiet", "HEAD^{commit}")
    if head is None or head.returncode != 0:
        return None, "no commits to compare (unborn HEAD)"
    resolved = _git(root, "rev-parse", "--verify", "--quiet", f"{base_ref}^{{commit}}")
    if resolved is None or resolved.returncode != 0:
        return None, (
            f"{base_ref} does not resolve here (shallow clone, or no such remote "
            "branch) -- run `git fetch origin main` for the full check"
        )
    merge_base = _git(root, "merge-base", base_ref, "HEAD")
    if merge_base is None or merge_base.returncode != 0:
        return None, f"no merge base between HEAD and {base_ref}"
    return merge_base.stdout.strip(), None


def git_diff_name_status(
    root: Path, base_sha: str, pathspec: str, *extra_args: str
) -> str | None:
    """``git diff --name-status <extra_args> <base_sha> -- <pathspec>``.

    Returns the raw stdout, or ``None`` if the diff itself could not be run.
    Callers apply their own per-line filtering and message formatting, since
    what counts as a violation (and how it should read) differs between the
    ``sim/`` and ``verification/`` conventions.
    """
    result = _git(root, "diff", "--name-status", *extra_args, base_sha, "--", pathspec)
    if result is None or result.returncode != 0:
        return None
    return result.stdout


# --- verification-specific: record-meta block, prose fields ----------------


def _tracked_record_files() -> list[Path]:
    args = ("ls-files", "--", "verification/records/**/records/*.md")
    result = _git(REPO_ROOT, *args)
    # Unlike the append-only check, there is no useful way to continue without
    # the tracked file list -- fail fast rather than lint an empty set.
    if result is None or result.returncode != 0:
        stderr = result.stderr.strip() if result is not None else ""
        raise RuntimeError(stderr or f"git {' '.join(args)} failed")
    return sorted(
        REPO_ROOT / line for line in result.stdout.splitlines() if line.strip()
    )


def _extract_meta_block(text: str, path: Path) -> dict:
    match = re.search(r"<!--\s*record-meta\s*(.*?)-->", text, re.DOTALL)
    if not match:
        raise LintError(f"{path}: missing `<!-- record-meta ... -->` block")
    try:
        return json.loads(match.group(1))
    except json.JSONDecodeError as exc:
        raise LintError(f"{path}: record-meta block is not valid JSON: {exc}") from exc


def _sha256_of(path: Path) -> str:
    return "sha256:" + hashlib.sha256(path.read_bytes()).hexdigest()


def lint_record(path: Path, all_record_ids_by_experiment: dict) -> list[str]:
    errors = []
    text = path.read_text(encoding="utf-8")
    experiment = path.parent.parent.name  # .../<experiment>/records/<id>.md
    stem = path.stem

    if not RECORD_ID_RE.match(stem):
        errors.append(f"{path}: filename `{path.name}` is not a valid record-id")

    try:
        meta = _extract_meta_block(text, path)
    except LintError as exc:
        errors.append(str(exc))
        return errors  # nothing further to check without metadata

    for key in REQUIRED_META_KEYS:
        if key not in meta:
            errors.append(f"{path}: record-meta missing required key `{key}`")

    if meta.get("record_id") != stem:
        errors.append(
            f"{path}: record-meta record_id `{meta.get('record_id')}` "
            f"disagrees with filename `{stem}`"
        )

    provenance = meta.get("provenance", {})
    if not isinstance(provenance, dict):
        errors.append(f"{path}: record-meta `provenance` must be an object")
        provenance = {}
    for key in REQUIRED_PROVENANCE_KEYS:
        if key not in provenance:
            errors.append(f"{path}: record-meta.provenance missing required key `{key}`")

    inputs = provenance.get("inputs")
    if not inputs:
        errors.append(f"{path}: record-meta.provenance.inputs is missing or empty")
        inputs = []
    for item in inputs:
        if not isinstance(item, dict) or "path" not in item or "content_hash" not in item:
            errors.append(
                f"{path}: record-meta.provenance.inputs entries need `path` and `content_hash`"
            )

    prose, _duplicates = parse_fields(text)
    for field_name in REQUIRED_PROSE_FIELDS:
        found = prose.get(field_name)
        if found is None:
            errors.append(f"{path}: missing required field bullet `- **{field_name}**:`")
        elif found.value.strip().lower() in _PLACEHOLDER_VALUES:
            errors.append(f"{path}: required field `{field_name}` is empty/placeholder")

    supersedes = meta.get("supersedes")
    if supersedes not in (None, "none"):
        known_ids = all_record_ids_by_experiment.get(experiment, set())
        if supersedes not in known_ids:
            errors.append(
                f"{path}: supersedes `{supersedes}`, which has no record "
                f"in `{experiment}/records/`"
            )

    return errors


def check_hash_freshness(
    path: Path, superseded_ids: set, base_dir_for_relpaths: Path
) -> list[str]:
    errors = []
    text = path.read_text(encoding="utf-8")
    try:
        meta = _extract_meta_block(text, path)
    except LintError:
        return errors  # already reported by lint_record

    record_id = meta.get("record_id")
    if record_id in superseded_ids:
        return errors  # frozen history, exempt from freshness

    for item in meta.get("provenance", {}).get("inputs", []) or []:
        rel_path = item.get("path")
        recorded_hash = item.get("content_hash")
        if not rel_path or not recorded_hash:
            continue
        src = REPO_ROOT / rel_path
        if not src.exists():
            errors.append(
                f"{path}: input `{rel_path}` no longer exists in the working tree"
            )
            continue
        current_hash = _sha256_of(src)
        if current_hash != recorded_hash:
            errors.append(
                f"{path}: provenance hash for `{rel_path}` is stale -- "
                f"recorded {recorded_hash}, current {current_hash} "
                f"(source changed since this record; mint a new record)"
            )
    return errors


def check_append_only(base_ref: str, require: bool) -> list[str]:
    base_sha, skip_reason = resolve_base_sha(REPO_ROOT, base_ref)
    if skip_reason is not None:
        msg = f"append-only check: could not resolve base ref `{base_ref}` ({skip_reason})"
        if require:
            return [msg]
        print(f"SKIP: {msg}")
        return []

    diff_text = git_diff_name_status(REPO_ROOT, base_sha, "verification/records/")
    if diff_text is None:
        msg = "append-only check: `git diff` failed"
        if require:
            return [msg]
        print(f"SKIP: {msg}")
        return []

    errors = []
    for line in diff_text.splitlines():
        if not line.strip():
            continue
        parts = line.split("\t")
        status = parts[0]
        if status.startswith("A"):
            continue  # pure addition -- allowed
        paths = parts[1:]
        errors.append(
            f"append-only violation: `{status}` on {', '.join(paths)} "
            f"relative to {base_ref} -- records/artifacts must only be added"
        )
    if not errors:
        print(f"OK: no append-only violations relative to {base_ref} ({base_sha[:12]})")
    return errors


def main() -> int:
    parser = argparse.ArgumentParser(description=__doc__)
    parser.add_argument(
        "--base-ref",
        default="origin/main",
        help="ref to diff against for the append-only check (default: origin/main)",
    )
    parser.add_argument(
        "--require-append-only",
        action="store_true",
        help="fail (instead of SKIP) if the append-only base ref cannot be resolved",
    )
    args = parser.parse_args()

    all_errors: list[str] = []

    # NOTE: an empty/absent records tree must NOT short-circuit -- deleting
    # every record is itself the most severe append-only violation there is,
    # and reporting only "the directory is gone" would let it through with a
    # misleading diagnosis. Record it as an error and keep going so the
    # append-only check below still runs and names the deleted paths.
    record_files = _tracked_record_files() if RECORDS_ROOT.exists() else []
    if not RECORDS_ROOT.exists():
        all_errors.append(f"{RECORDS_ROOT.relative_to(REPO_ROOT)} does not exist")
    elif not record_files:
        all_errors.append(
            "no tracked records under verification/records/**/records/*.md"
        )

    print(f"== linting {len(record_files)} record(s) ==")
    for error in all_errors:
        print(f"  - {error}")

    all_ids_by_experiment: dict[str, set] = {}
    metas_by_path: dict[Path, dict] = {}
    for path in record_files:
        experiment = path.parent.parent.name
        stem = path.stem
        all_ids_by_experiment.setdefault(experiment, set()).add(stem)
        try:
            metas_by_path[path] = _extract_meta_block(
                path.read_text(encoding="utf-8"), path
            )
        except LintError:
            metas_by_path[path] = {}

    superseded_ids = {
        meta["supersedes"]
        for meta in metas_by_path.values()
        if meta.get("supersedes") not in (None, "none")
    }

    for path in record_files:
        errors = lint_record(path, all_ids_by_experiment)
        errors += check_hash_freshness(path, superseded_ids, path.parent.parent)
        if errors:
            print(f"FAIL: {path.relative_to(REPO_ROOT)}")
            for e in errors:
                print(f"  - {e}")
        else:
            print(f"OK:   {path.relative_to(REPO_ROOT)}")
        all_errors.extend(errors)

    print()
    print("== append-only check ==")
    append_errors = check_append_only(args.base_ref, args.require_append_only)
    for e in append_errors:
        print(f"  - {e}")
    all_errors.extend(append_errors)

    print()
    if all_errors:
        print(f"FAIL: {len(all_errors)} record-lint error(s)")
        return 1
    print("PASS: all records valid")
    return 0


if __name__ == "__main__":
    sys.exit(main())
