2AMLogic/gf180-usb2-phy/verification/test_usb_bit_codec_loopback.py

"""cocotb testbench for `verification/tb_usb_bit_codec_loopback.v`.

Where the four per-module testbenches check each block against a Python
model, this one closes the loop in RTL: the TX path (`usb_bit_stuffer` ->
`usb_nrzi_encoder`) drives the RX path (`usb_nrzi_decoder` ->
`usb_bit_destuffer`) through a wire, and the claim is that the bit stream
comes back out unchanged. That is the round-trip half of this issue's test
plan, made against real hardware on both ends rather than a model on one.

The harness is testbench scaffolding, not PHY RTL, and deliberately has no
SYNC, no EOP, no line-state decode and no UTMI ports -- see its own header.
Since issue #84 the harness is the minimal *canonical caller* of the
vendored modules (strobe/consume handshake, `sof` run resets, `enable`
gating): a session is one burst of `tx_valid`, the harness itself
discharges the #7.1.9 trailing-stuff-bit flush duty at session end, and
the destuffer's `enable` tracks the session through a 2-clock pipeline
delay. There is no `init` port any more -- a fresh session re-arms
everything through the canonical `sof`/`enable` mechanisms.

Sampling discipline: drive on a
`FallingEdge` (with `await ReadWrite()` so the combinational `tx_ready`
settles before it is read), read the registered observables on the
`FallingEdge` after the `RisingEdge` under test.

This file is *input* to `klt functional-verification` (see
`request-usb-bit-codec-loopback.json`), not a pytest module.
"""

import random

import cocotb
from cocotb.triggers import ClockCycles, FallingEdge, RisingEdge, Timer

from cocotb_helpers import start_clock as _start_clock
from usb_bit_model import bit_stuff, nrzi_encode

# Stuffer -> encoder -> decoder -> destuffer: the harness's session
# machinery self-drains the last strobed bit through both registered
# stages, so a couple of idle clocks after the last consumed bit-time
# suffice to observe everything the session put on the wire.
DRAIN_CLOCKS = 4


async def _reset(dut):
    dut.rst_n.value = 0
    dut.tx_valid.value = 0
    dut.tx_bit.value = 0
    await ClockCycles(dut.clk, 3)
    dut.rst_n.value = 1
    await FallingEdge(dut.clk)


async def _step(dut, valid, bit=0):
    dut.tx_valid.value = valid
    dut.tx_bit.value = bit
    # `tx_ready` and `tx_stuffed` are combinational on the just-driven
    # `tx_valid` and belong to THIS bit-time; settle one scheduler round
    # (still inside the low half of the clock period) and read them
    # pre-edge. A post-edge read of `tx_stuffed` would report the *next*
    # bit-time's evaluation and double-count the trailing flush.
    await Timer(1, unit="ps")
    ready = int(dut.tx_ready.value)
    stuffed = int(dut.tx_stuffed.value)
    await RisingEdge(dut.clk)
    await FallingEdge(dut.clk)
    return {
        "ready": ready,
        "line_valid": int(dut.line_valid.value),
        "line_bit": int(dut.line_bit.value),
        "tx_stuffed": stuffed,
        "rx_valid": int(dut.rx_valid.value),
        "rx_bit": int(dut.rx_bit.value),
        "rx_stuff_err": int(dut.rx_stuff_err.value),
    }


async def _loopback(dut, bits):
    """Send `bits` through the whole path as one session; return what came
    back. The harness flushes a trailing stuff bit on its own when the
    stream ends on a stuff position (USB 2.0 #7.1.9), so unlike the
    pre-vendoring driver there is no explicit flush step here.

    Returns `(line_bits, stuffed_count, rx_bits, error_count)`.
    """
    line = []
    stuffed = 0
    rx_bits = []
    errors = 0

    def observe(sample):
        nonlocal stuffed, errors
        if sample["line_valid"]:
            line.append(sample["line_bit"])
        if sample["tx_stuffed"]:
            stuffed += 1
        if sample["rx_valid"]:
            rx_bits.append(sample["rx_bit"])
        if sample["rx_stuff_err"]:
            errors += 1

    index = 0
    budget = 4 * len(bits) + 32
    while index < len(bits):
        budget -= 1
        assert budget > 0, "tx_ready never came back high -- handshake stalled"
        sample = await _step(dut, valid=1, bit=bits[index])
        observe(sample)
        if sample["ready"]:
            index += 1

    # Session end: the harness spends one bit-time on the forced trailing
    # stuff bit if one is owed, then the pipeline drains.
    for _ in range(DRAIN_CLOCKS):
        observe(await _step(dut, valid=0))

    return line, stuffed, rx_bits, errors


def _longest_run(values):
    longest = 0
    run = 0
    previous = None
    for value in values:
        run = run + 1 if value == previous else 1
        previous = value
        longest = max(longest, run)
    return longest


@cocotb.test()
async def test_round_trip_random_stream(dut):
    """512 random bits survive stuff -> NRZI -> NRZI -> destuff intact."""
    await _start_clock(dut)
    await _reset(dut)

    rng = random.Random(20260820)
    # Biased toward 1s so the round trip actually exercises stuffing.
    bits = [1 if rng.random() < 0.8 else 0 for _ in range(512)]

    line, stuffed, rx_bits, errors = await _loopback(dut, bits)

    expected_stuffed, flags = bit_stuff(bits)
    assert stuffed == sum(flags) > 0, "stuffing did not fire as the model expects"
    assert line == nrzi_encode(expected_stuffed), "line stream differs from the model"
    assert rx_bits == bits, "the round trip did not recover the transmitted bits"
    assert errors == 0, "a well-formed round trip raised a stuff error"


@cocotb.test()
async def test_round_trip_all_ones(dut):
    """All-1s: maximal stuffing density, still lossless end to end."""
    await _start_clock(dut)
    await _reset(dut)

    bits = [1] * 64
    line, stuffed, rx_bits, errors = await _loopback(dut, bits)

    _expected, flags = bit_stuff(bits)
    assert stuffed == sum(flags) > 0, f"unexpected stuffed-bit count: {stuffed}"
    assert rx_bits == bits, "the round trip did not recover the transmitted bits"
    assert errors == 0, "a legally stuffed 1 run raised a stuff error"

    # The point of the whole exercise: without stuffing an all-1s payload
    # would leave the line static forever. With it, the line cannot hold
    # the same state for more than seven bit times.
    assert _longest_run(line) == 7, f"line held for {_longest_run(line)} bit times"


@cocotb.test()
async def test_round_trip_all_zeros(dut):
    """All-0s: no stuffing at all, a transition on every bit."""
    await _start_clock(dut)
    await _reset(dut)

    bits = [0] * 64
    line, stuffed, rx_bits, errors = await _loopback(dut, bits)

    assert stuffed == 0, "a 0 run should never stuff"
    assert rx_bits == bits, "the round trip did not recover the transmitted bits"
    assert errors == 0, "a 0 run raised a stuff error"
    assert _longest_run(line) == 1, "a 0 run should transition every bit"


@cocotb.test()
async def test_round_trip_packet_ending_on_six_ones(dut):
    """A stream ending on six 1s carries its #7.1.9 stuff bit and survives.

    The end-to-end statement of the session-boundary rule: the harness's
    auto-flush puts one extra 0 on the line, and the RX path removes it at
    the same position, so the payload comes back unchanged with no stuff
    error. Reachable in ordinary traffic -- a CRC16 residue can end in six
    1s.
    """
    await _start_clock(dut)
    await _reset(dut)

    bits = [0, 1, 0] + [1] * 6
    line, stuffed, rx_bits, errors = await _loopback(dut, bits)

    expected_stuffed, flags = bit_stuff(bits)
    assert flags[-1] is True, "fixture does not end on a stuff position"
    assert stuffed == 1, f"the trailing stuff bit was not emitted: {stuffed}"
    assert len(line) == len(bits) + 1, f"unexpected line length: {len(line)}"
    assert line == nrzi_encode(expected_stuffed), "line stream differs from the model"
    assert rx_bits == bits, "the round trip did not recover the transmitted bits"
    assert errors == 0, "a conformant trailing stuff bit raised a stuff error"


@cocotb.test()
async def test_round_trip_second_session_after_gap(dut):
    """A second, independent session after an idle gap round-trips exactly:
    the stuffer's `sof` re-anchors the run counter and the encoder's
    transition reference (the canonical replacement for the former `init`
    re-arm), and the destuffer's enable gating zeroed its run counter in
    the gap.
    """
    await _start_clock(dut)
    await _reset(dut)

    first = [1] * 6 + [0, 1, 0]
    _line, _stuffed, rx_first, errors = await _loopback(dut, first)
    assert rx_first == first, "first stream did not round trip"
    assert errors == 0, "first stream raised a stuff error"

    # The gap: a few idle clocks (no tx_valid).
    for _ in range(3):
        await _step(dut, valid=0)

    second = [1] * 9
    line, stuffed, rx_second, errors = await _loopback(dut, second)
    assert rx_second == second, "second stream did not round trip after the gap"
    assert errors == 0, "second stream raised a stuff error"
    assert stuffed == 1, f"unexpected stuffed-bit count after the gap: {stuffed}"
    # `sof` put the line reference back at J, so the second stream's
    # encoding starts from the session-start reference rather than
    # wherever the first ended.
    expected_stuffed, _flags = bit_stuff(second)
    assert line == nrzi_encode(expected_stuffed), "sof did not re-arm the line"
