2AMLogic/gf180-usb2-phy/(commit log)

2026-08-05 Initial commit: USB 2.0 device PHY on gf180mcu
    Device-side only, full-speed. No host, no OTG, no role switching.
    Apache-2.0. Nothing designed yet.
2026-08-10 chore(repo-skills): install Repo Skills 0.10.0
    This repo had NO Repo Skills install at all — not a stale one. A third of the
    fleet was in that state, which reframes 2AMLogic/2am#56: that issue reads as
    "0.8.1 landed only in 2am", but nine repos had never had the tool, including
    canaries that carry the destructive-command guard the rest of the toolchain
    assumes is present.
    Committed straight to main rather than via a per-repo branch. The 0.8.1
    rollout used branch-per-repo and seven of those branches were abandoned
    mid-flight, leaving their repos parked off trunk and invisible —
    compute-drift.sh's axis 3 compares a checkout against its OWN branch, so a
    repo current with a stale branch rep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
2026-08-10 docs(spec): ratify USB 2.0 device PHY target spec, point README at spec/ (#4)
    Resolves every DRAFT row in README's target-spec table with an explicit
    decision, a USB 2.0 Chapter 7 citation (per issue #1's own §7.3.2
    directive for driver characteristics), and a recorded reason wherever the
    ratified value changes the draft (UTMI+ stretch dropped, crystal-less/
    SOF-trimmed clock explicitly excluded rather than left as a stretch, the
    D+ pull-up's PVT-tolerance mechanism flagged as an open circuit-level
    item instead of assumed). Fixes the PVT corner list (45 corners: 3 temps
    x 3 supply points x 5 process corners) that electrical verification must
    report against, and states explicitly that NRZI/b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
2026-08-10 fix: split concatenated .gitignore rule so flow/build/ is actually ignored (#8)
    Line 13 merged the flow/build/ ignore rule with a trailing comment onto
    one line with no newline, so the '#' was taken as a literal character
    instead of a comment marker and flow/build/ was never ignored. Also
    fix the unsubstituted P{{SCRATCH_RULES}}R template placeholder on line
    12 to read 'place-and-route'.
2026-08-10 feat(sim): port gf180-bandgap's ngspice PVT-corner harness (#9)
    * feat(sim): port gf180-bandgap's ngspice PVT-corner harness
    Bootstraps sim/ with the harness (corners/testbench/runner/report/
    evidence_lint), env.sh PDK resolution, run_corners.py/check_records.py
    CLI entry points, and a throwaway smoke-inverter cell to prove the
    harness end to end. Adapted from gf180-bandgap (same PDK): default
    corner set is now 'mos' (5 corners) to match spec/usb2-device-phy.md
    §8.1's 45-point matrix, and bandgap-specific content is left behind.
    * test(sim): record a real end-to-end smoke-inverter evidence run
    First evidence record produced by the ported harness: 45/45 PVT points
    pass for the throwaway s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
2026-08-10 feat(digital): bootstrap cocotb/klt harness in verification/ + flow/ (#10)
    * feat(digital): bootstrap cocotb/klt harness in verification/ + flow/
    Ports the cocotb + Icarus testbench structure and the klt
    functional-verification / klt synthesize request shape from
    sky130-modexp's verification/ and flow/ layout, re-targeted from sky130
    to gf180mcu. A trivial smoke-vehicle counter (rtl/harness_counter.v, no
    USB semantics) elaborates and verifies via cocotb + Icarus and
    synthesizes via klt synthesize against gf180mcu_fd_sc_mcu9t5v0, with
    real append-only evidence records under verification/records/.
    * fix(verification): re-mint evidence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
    [check_records.py, harness_counter.v, test_harness_counter.py]
2026-08-10 chore: remove unused device-level evidence plumbing from report.py (#12)
    device_log_header, write_device_corner_log, write_device_netlist_snapshot,
    and device_write_record have zero call sites anywhere in the repo and
    contradict sim/harness/README.md, which documents that this pattern was
    not ported (no sim/device-*/ testbenches exist yet). Drops the now-unused
    shutil import along with the dead code.
2026-08-10 refactor(sim): drop unused device_corner_id() helper from corners.py (#14)
    device_corner_id() had zero call sites anywhere in the repo. It mints
    corner ids for sim/device-*/ testbenches, a gf180-bandgap pattern
    sim/harness/README.md explicitly records as not yet ported -- this repo's
    only testbench (sim/smoke-inverter/) is circuit-level and uses
    PvtPoint.corner_id instead.
    Same class of dead code PR #12 removed from sim/harness/report.py; this
    one slipped through in corners.py from the same port pass. Re-port it
    from gf180-bandgap when sim/device-*/ benches actually exist.
2026-08-10 fix: wire sim/check_records.py into npm run lint (#18)
    package.json's lint script only ran the verification/ evidence linter,
    leaving sim/harness/evidence_lint.py's enforcement entirely manual
    despite its docstring claiming it ran as part of a `.github/scripts/lint.sh`
    that does not exist in this repo. Add it as a third lint step and correct
    the docstring's two references to that nonexistent script.
2026-08-15 refactor(sim): remove unused Pdk.klayout_dir property (#22)
    klayout_dir was never read anywhere in sim/, verification/, or flow/ --
    layout/DRC/LVS resolve their own PDK path independently through the
    separate klt CLI. Its sibling properties (ngspice_dir, xschem_dir,
    design_include, model_lib) all have real callers in runner.py/cli.py;
    this one did not.
2026-08-16 ci: add GitHub Actions workflow running npm run check:ci (#28) (#33)
    Adds .github/workflows/ci.yml, running on push/PR to main: the
    tool-light leg only (evidence-record linters + `klt
    functional-verification` against the harness-counter request), matching
    the split docs/environment-setup.md already documented but never wired
    up. check:all's PDK-heavy `klt synthesize` leg stays local and
    committed as an append-only record, per that doc's rationale and
    sky130-modexp's ci.yml, which it cites as the pattern to port.
    Cross-links the new workflow from docs/environment-setup.md's "Why
    local, not CI" section. README has no reproduction-commands section on
    current main to update -- verified, nothing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
2026-08-16 feat: add differential driver and D+ pull-up xschem schematics (#34)
    Adds design/differential_driver.sch and design/dplus_pullup.sch (gf180mcu
    xschem schematic capture, spec sec.5/sec.6 targets by design intent) plus
    design/xschemrc + design/netlist.py to regenerate design/netlist/*.spice
    headlessly via `xschem -x -q -n`. The pull-up uses a binary-weighted trim
    ladder (not active regulation) to target the +/-5% tolerance a bare
    untrimmed poly resistor cannot meet.
    [differential_driver.sch, dplus_pullup.sch]
2026-08-16 feat: add differential + single-ended receiver xschem schematics (#36)
    Adds design/differential_receiver.sch (5T-OTA differential-to-digital
    converter targeting the >200mV/0.8-2.5V-CM sensitivity spec) and
    design/se_receiver_dp.sch / se_receiver_dm.sch (comparator-style
    single-ended receivers, VREF set at the VIH/VIL midpoint via an
    on-chip resistor divider), each with a regenerated netlist and an
    informal ngspice spot-check documented in design/README.md.
    [differential_receiver.sch, se_receiver_dm.sch, se_receiver_dp.sch]
2026-08-17 refactor(verification): fold _run_git into the shared _git helper (#40)
    _tracked_record_files() was the only caller of _run_git(), a second
    git-subprocess wrapper that duplicated _git() apart from hardcoding
    REPO_ROOT and raising on a non-zero exit. Call _git(REPO_ROOT, ...)
    directly and keep the fail-fast behavior with an inline check on the
    returned CompletedProcess (also covering _git's None-on-OSError case),
    so the module has a single git invocation path.
    [check_records.py]
2026-08-17 feat(rtl): add NRZI encode/decode and bit stuffing/destuffing modules (#35)
    * feat(rtl): add NRZI encode/decode and bit stuffing/destuffing modules
    Implements the core bit-level encode/decode path that spec/usb2-device-phy.md
    section 2 places inside this block's UTMI boundary, as four fully synchronous
    single-clock modules running one bit per clock at the section 3 interface
    clock of 12 MHz (no dual-rate or oversampled mode -- high speed is out of
    scope per section 1):
    - usb_nrzi_encoder.v -- data 0 transitions the line, data 1 holds it
    - usb_nrzi_decoder.v -- the inverse; a static line decodes to a run of 1s
    - usb_bit_stuffer.v -- inserts a 0 after every six consecutive 1s, stalling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
    [tb_usb_bit_codec_loopback.v, test_usb_bit_codec_loopback.py, test_usb_bit_destuffer.py, test_usb_bit_stuffer.py, test_usb_nrzi_decoder.py, test_usb_nrzi_encoder.py, usb_bit_model.py]
2026-08-17 feat: add SYNC/EOP framing, line-state decode, and top-level UTMI wrapper (#41)
    * feat(rtl): add SYNC/EOP framing, line-state decode, and top-level UTMI wrapper
    Implements the rest of spec/usb2-device-phy.md section 2's digital logic and
    assembles it, with the already-merged bit-level codec (issue #31), into the
    UTMI-facing block section 3 defines:
    - usb_line_state_decode.v -- LineState[1:0] (J/K/SE0/SE1) from the two
    single-ended receiver outputs
    - usb_sync_detector.v -- SYNC field detection and RX bit-lock, matched
    against the NRZI-decoded bit stream
    - usb_eop_detector.v -- one SE0-duration counter driving both EOP (2
    bit times) and bus-reset (2.5us / 30 clocks) detection,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
    [test_usb_eop_detector.py, test_usb_line_state_decode.py, test_usb_sync_detector.py, test_usb_utmi_phy.py, usb_eop_detector.v, usb_line_state_decode.v, usb_sync_detector.v, usb_utmi_phy.v]
2026-08-17 feat(layout): produce routed digital PHY GDS via klt synthesize + place-and-route (#25) (#42)
    Synthesizes rtl/usb_utmi_phy.v and every submodule it instantiates
    against gf180mcu_fd_sc_mcu9t5v0, then place-and-routes the result via
    klt place-and-route (OpenROAD, provisioned through a new
    scripts/openroad-docker.sh wrapper) at the 12 MHz UTMI clock rate --
    0 setup/hold/antenna violations, ~68 MHz fmax. The routed GDS/DEF/
    as-built netlist land under layout/digital/, evidenced under
    verification/records/place-and-route/.
    A real (non-fabricated) klt drc run against the routed GDS is recorded
    honestly as not clean (153 Metal1 space/width violations at
    standard-cell row gaps), root-caused to klt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
2026-08-17 refactor(verification): extract shared cocotb clock helpers into cocotb_helpers.py (#45)
    CLK_PERIOD_PS and _start_clock(dut) were redefined byte-identically in all
    five verification/test_usb_*.py cocotb testbenches. Extract them into a new
    verification/cocotb_helpers.py (start_clock, imported as
    `from cocotb_helpers import start_clock as _start_clock`), following the
    consolidation pattern of #37/#39. _reset(dut) is left alone per the issue,
    since it drives different DUT signal names per testbench.
    Mints verification/records/bit-codec-functional's next evidence record
    (20260817-212707-6c7f7ff, supersedes 20260816-074908-4e92fcc): the refactor
    changed the content hash of the five testbenches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
    [cocotb_helpers.py, test_usb_bit_codec_loopback.py, test_usb_bit_destuffer.py, test_usb_bit_stuffer.py, test_usb_nrzi_decoder.py, test_usb_nrzi_encoder.py]
2026-08-18 feat(sim): verify the PHY against spec §8.2 across the full 45-corner PVT matrix (#43)
    * feat(sim): add spec-row PVT testbenches for driver, pull-up and receivers
    Adds five ngspice corner-sweep experiments, one per quantity named in
    spec/usb2-device-phy.md §8.2, all driven from the schematic-level netlists
    under design/netlist/ as the DUT:
    - driver-signal-quality §6 rise/fall time, rise/fall matching, crossover
    voltage and full-speed signal quality into the
    ratified 50 pF test load
    - driver-jitter §8.2 driver-output edge timing over an 18-bit
    12 Mbps pattern; recorded with NO spec limit, per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
2026-08-18 docs: add T1 item 8 characterization report aggregating spec-coverage evidence (#48)
    Hand-assembles the aggregated §8.2 characterization artifact required by
    klayout-tools' T1 checklist item 8, citing sim/spec-coverage.md and the
    underlying evidence records with sha256 provenance for staleness checks.
    klt signoff (v0.2.0) was verified not to fit this repo's Markdown
    evidence-record layout in either aggregation mode (documented in the
    report, with the exact commands/errors) rather than forcing a broken
    implementation; filed 2AMLogic/klayout-tools#1152 as the generic tool-gap
    follow-up per this repo's friction protocol.
2026-08-18 feat(layout): drive analog blocks through klt's netlist-driven layout plans (#49)
    Adds the analog half of this repo's layout flow: committed
    klt.layout_plan.request/1 documents for the three analog blocks klt can
    ingest, and scripts/gen_analog_layout.py, which executes them through
    klayout_tools.layout_plan_execute (Phase C) and runs klt drc on each
    result.
    The measured outcome is a negative one, and it is recorded as such rather
    than papered over: two of the five blocks (differential_driver,
    dplus_pullup) cannot be ingested by klt's netlist reader at all, and the
    three that can place their devices DRC-clean but route zero of their nets
    (0/8, 0/9, 0/9). No analog GDS is committed under layo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
2026-08-25 Digital layout DRC-clean + LVS-matched, and the Chipalooza #5 proposal (#54)
    * feat: DRC-clean + LVS-matched digital layout, Chipalooza #5 proposal
    Part of #51 (Epic #542 Phase 3A). Two deliverables that stand on real tool
    runs, plus the follow-up work named honestly rather than claimed.
    Digital layout closed to sign-off
    ---------------------------------
    `flow/request-usb-utmi-phy-par.json` now carries a `request.power` block
    (klt 0.3.0), so place-and-route runs tapcell + pdngen at the floorplan
    stage and filler_placement after routing. The strap geometry is
    transcribed from OpenROAD-flow-scripts' own gf180 PDN config read out of
    the pinned image, not invented.
    - DRC: `clean`, 0 violati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
2026-08-26 feat(layout): re-measure analog layout-plan against a klt pin past 3 closed friction fixes (#57)
    Part of #52 (Epic #542 Phase 3A). Re-runs scripts/gen_analog_layout.py's
    identical five-block measurement against klayout-tools 07b1f04f (up from
    b3e284f), since klayout-tools#1163/#1164/#1165 -- all filed from the prior
    2026-08-18 run -- closed COMPLETED within hours of that run, while this
    repo's klt pin never moved to consume the fixes.
    Result: still not delivered, but for more specific reasons than before.
    The routed-net count is unchanged (0/8, 0/9, 0/9) because the fixes ship
    new opt-in fields (device_groups[].orientation, a metal2 routing.layer_role)
    that the committed plans predate and d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
2026-09-05 feat(verification): re-run digital post-layout STA against fixed klt SPEF correlation (#60)
    Re-runs the digital half of #53's post-layout (extracted-parasitic)
    re-verification against this repo's now-current klt pin, which turns out
    to be exactly the commit that fixed the klt sta net-name-correlation
    defect (klayout-tools#1422/#1423) the prior attempt (PR #55) filed
    upstream. Design-net annotation coverage closes from 186/366 to 364/366
    (100% of nets that physically carry routed metal); every reported
    timing/power/skew number is unchanged from the prior run.
    The analog half stays unattempted: #52 closed via delegation without
    ever committing a GDS/OASIS for any of the five analog blocks, so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
2026-09-05 feat(champion): standing authorization for design-evidence auto-merge (#6850)
    Operator ruling 2026-09-05: Judge-approved, green-CI PRs whose entire
    changed-file set lives in design/, sim/, layout/, measurements/,
    verification/, or docs/ auto-merge without the four-axis human hold.
    Rationale: canary design evidence is fully revertible with no fleet-infra
    blast radius, and the held-PR pattern (sky130-sar-adc#123 sat mergeable for
    days as the sole blocker of a layout chain) costs more than it protects
    here. spec/ and every tool surface fall outside the patterns, so the
    exact-subset rule keeps them on the four-axis judgment automatically.
    C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
2026-09-05 docs(analog-layout): re-measure gen_analog_layout.py after klayout-tools#1424 closed refuted (#64)
    klayout-tools#1424 (the mitered-dead-end DRC regression) closed
    NOT_PLANNED on 2026-08-26 -- the maintainer refuted the claimed
    mechanism via source inspection and invited a re-run with a concrete
    repro if the violations still reproduce. Re-ran
    scripts/gen_analog_layout.py against the unchanged klt pin
    (07b1f04f, confirmed byte-identical for the relevant files to the
    commit the maintainer inspected): the 19/22/22 metal1.width.1
    violations reproduce byte-for-byte identical, with produced GDS files
    cmp-identical to the 2026-08-26 record. The closure corrected the
    claimed mechanism, not the observ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
2026-09-05 flatten dplus_pullup's nf=10 pull-up switches, with measured equivalence and a cleared klt ingestion blocker (#63)
    * design(dplus_pullup): flatten nf=10 pull-up switches to one device per gate
    Operator ruling 2026-09-05 on issue #56 (FLATTEN). Each of the six W=1000u
    pull-up switch devices (MEN, MSW0..MSW4) was drawn as a single nf=10
    instance; it is now drawn as ten one-finger W=100u devices in parallel --
    one device per drawn gate -- which is exactly the transformation klt's own
    subckt-call -> plain-element conversion error text prescribes.
    Total drawn gate width per switch is unchanged (10 x 100u = 1000u) and every
    terminal connection is byte-identical; only the instance decomposition
    c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
    [dplus_pullup.sch]
2026-09-06 Author a klt layout plan for dplus_pullup: 6/21 nets routed, DRC-clean, and the metal1-width symptom root-caused (#66)
    * layout(analog): author dplus_pullup layout plan and unblock it in the driver
    Adds layout/analog/plans/dplus_pullup.json -- a klt.layout_plan.request/1
    document grouping the block's 78 devices into 24 groups: the six
    differently-sized ppolyf_u ladder segments as six distinct res_array groups
    (one res_array would force one length onto all six), the ten flattened
    fingers of each pull-up/trim switch as one 10-wide mos_array, and the six
    control inverters as per-device groups clustered in n/p pairs.
    Drops dplus_pullup from scripts/gen_analog_layout.py's BLOCKED_BLOCKS (its
    nf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
2026-09-09 Re-pin klt past #1501/#1502 and spend cross_block_layer_role on dplus_pullup (#69)
    Moves KLT_REV to 8bd3f0b0 (klayout-tools main, strict ancestor of both
    fix merges), re-measures all four analog plans at the new pin with
    byte-identical inputs (record 20260909-213500), then adds
    routing.cross_block_layer_role: "metal2" to dplus_pullup's plan and
    re-measures again (record 20260909-215500).
    Net result: the capability is reachable and works (540 same-layer-short
    leg rejections eliminated, routed legs 114 -> 168, via1.width.1 class
    retired) but dplus_pullup stays at 6/21 routed nets. All 15 remaining
    nets are named with the router's own rejection text and are blocked by
    already-open upstream iss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
2026-09-12 feat(env): re-pin klt past klayout-tools#1662 (rm1/rm2/rm3 metal resistors) (#71)
    * feat(env): re-pin klt past klayout-tools#1662 (rm1/rm2/rm3 metal resistors)
    Moves KLT_REV to bf90e1d5e3a624ea2e098efdfe76596081508751, a strict
    descendant of klayout-tools PR #1662's merge (rm1/rm2/rm3 gf180mcu
    metal-resistor device-class recognition). The four already-committed
    analog plans are unaffected (cmp-identical GDS). differential_driver's
    netlist now ingests cleanly for the first time -- but a committed plan
    still isn't possible: klt gen's res_array generator has no drawn-geometry
    support for a gf180mcu metal resistor, and silently draws the wrong
    device (a poly resistor) instead of failing when a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
2026-09-13 feat(env): re-pin klt past klayout-tools#1731 (res_array rm1 support) (#74)
    * feat(env): re-pin klt past klayout-tools#1731 (res_array rm1 support)
    Moves KLT_REV to klayout-tools main tip 61e743088f47, a strict
    descendant of PR #1774's fix (res_array now draws real Metal1/Via1/
    Metal2 geometry for a gf180mcu metal resistor, and warns instead of
    silently substituting on a declared-class/generator mismatch). The
    four already-committed plans are unaffected at the drawn-geometry
    level (cmp-identical GDS). differential_driver.json is authored and
    committed for the first time: its two RM1 series-termination
    resistors set params.metal_level: 1 explicitly and are confirmed (by
    direct GDS layer insp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
2026-09-14 fix(layout): set params.flavor:1k on 3 receiver plans' res_array groups (#75)
    differential_receiver.json's r_bias and se_receiver_dm.json/
    se_receiver_dp.json's r_bias/r_1/r_2 groups declared device_class
    PPOLYF_U_1K but never set params.flavor: "1k", so res_array's default
    "generic" flavor silently drew the wrong ppolyf_u body instead of the
    netlist-declared ppolyf_u_1k -- caught by klayout-tools#1731's new
    device_class mismatch warning (issue #72).
    Re-executing all three plans confirms the fix: 0 warnings[] entries
    (down from 1/3/3), each affected group's drawn body swaps from layer
    31/0 (ppolyf_u) to 62/0 (ppolyf_u_1k marker), and DRC/routed-net
    counts/bboxes are unchanged -- a per-layer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
2026-09-21 feat: add klt erc supply spec and evidence record for T1 item 11 (#80)
    Add layout/digital/erc-supply-spec.json — the T1 item 11 (power
    delivery, structural) supply spec for the digital partition — and
    the digital-erc evidence record + frozen klt erc JSON envelope
    run against the routed GDS with that spec: erc_status clean, zero
    erc.unconnected_net / erc.supply_short naming VDD or VSS, with
    erc.missing_tie not computed (no_ties_declared) and the standing-in
    well-tie evidence named. Update verification/README.md's experiment
    list accordingly.
    Closes #77
2026-09-21 feat: check power/ground connectivity in the digital LVS harness (#82)
    * feat: check power/ground connectivity in the digital LVS harness
    Switch scripts/digital_lvs.py from the hand-transcribed plain-element
    SPICE reference to klt lvs' gate-level-verilog form (klayout-tools
    #1336, #1419): the as-built Verilog itself is now the reference, with
    each cell's pin order resolved from the PDK library's own .spice data.
    Declare options.power_connectivity.expected_nets from the P&R request's
    power block so the power/ground half yields an absolute verdict instead
    of unchecked, abstract every standard cell via the documented wildcard
    (fill/tap included; klt lvs prunes the power-only ones itself), gate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
    [usb_utmi_phy_reference.v]
2026-09-21 feat(erc): declare well/substrate ties, re-grade item 11.digital (#85)
    * feat(erc): declare well/substrate ties, re-grade item 11.digital
    Declare ties[] in layout/digital/erc-supply-spec.json now that the
    klayout-tools#2169 tie-graph-collapse fix (klt#2186) is inside the
    pinned klt e8ca621a: Nwell 21/0 tapped by Comp∩Nplus to VDD and
    LVPWELL 204/0 tapped by Comp∩Pplus to VSS, both via Metal1. Re-run
    klt erc at the pin: erc_status clean, zero missing_tie /
    unconnected_net / supply_short, both ties in erc_coverage.checked
    (no degenerate skips). Mint record 20260921-213041-4b9148f
    (supersedes 20260921-125459-223bae5), cite the new envelope plus the
    committed place-and-route envelope in the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
2026-09-22 feat: vendor shared USB protocol RTL and adapt the UTMI wrapper (#88)
    * feat: vendor shared USB protocol RTL and adapt the UTMI wrapper
    Vendor the four USB-spec-defined protocol transforms (NRZI encode/decode,
    bit stuff/destuff) byte-exact from the rule-9 master sky130-usb2-phy @
    4f3b2c72 under rtl/common/, pinned by a root reuse.lock.json and enforced
    by a per-repo copy of 2am's scripts/reuse-check.py in CI; delete the
    superseded local modules; adapt rtl/usb_utmi_phy.v at its boundary to the
    canonical strobed interfaces (framer-shape TX with sof run resets and the
    stuff_pending_after flush duty; RX bit_is_jk line-state gating and
    enable-gated destuffing; OpMode 2'b10 now consumed as bypass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
    [cocotb_helpers.py, tb_usb_bit_codec_loopback.v, test_usb_bit_codec_loopback.py, test_usb_bit_destuffer.py, test_usb_bit_stuffer.py, test_usb_nrzi_decoder.py, test_usb_nrzi_encoder.py]
2026-09-22 feat: re-run usb_utmi_phy P&R and post-layout PVT against vendored sources (#89)
    * feat: refresh routed digital layout against the vendored rtl/common sources
    Re-run klt synthesize + klt place-and-route for usb_utmi_phy against the
    post-#84 source set (rtl/common/ vendored modules + adapted wrapper).
    318 mapped cells -> 1121 placed DEF instances, 0 setup/hold/antenna/
    router-DRC violations at every one of the 15 liberty corners. Evidence
    records minted separately under verification/records/ (issue #87).
    * docs: mint post-#87 evidence records and repoint signoff citations
    Five append-only records against the vendored-source re-implementation
    (P&R, DRC, LVS, ERC, post-layout PVT), each supe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
    [usb_utmi_phy_reference.v, usb_utmi_phy_reference_negctl.v]
2026-10-01 chore: resync installed Loom surfaces
    resynced_by: fleet-resync
    invocation: fleet-resync.sh --fleet-only --push
    <!-- loom:provenance v1 build=unknown 19f4e67fd0a0afbd3d8b6606ca91ceac911377a3 clean prompts=none sweep=none story=none trace=78a5dfbdfd8c530aecd1bb436fd096df host=loom-worker-2 base=788961d87441a172de3693524af79b72e1934523 run=loom-run/v1:timer:loom-worker-2/fleet-resync:67c759f7ef3c43e38d3fa8d5f19a2dd1 installs=0.19.593 658650a4f0eff932ac66a8f690eaedf8123fc83b -->
    Loom-Story: none
    Loom-Trace-Id: 78a5dfbdfd8c530aecd1bb436fd096df
    Loom-Build: unknown 19f4e67fd0a0afbd3d8b6606ca91ceac911377a3 clean
2026-10-01 chore: resync installed Loom surfaces
    <!-- loom:provenance v1 build=unknown 56435bf476452911283e43940ecfd9a30f804af9 clean prompts=none sweep=none story=none trace=342405c5ebc99bdbf17afbd983c0c41c host=loom-worker-2 base=0dbd872d137c31aad7b4d2bd0b98fc2edf69cddb run=loom-run/v1:timer:loom-worker-2/fleet-resync:20c09f231d424cd5b57ca7991848dd8a installs=0.19.603 8c39bf7cde8a8c03d1aaee441f397c017b6a3a9e -->
    Loom-Trace-Id: 342405c5ebc99bdbf17afbd983c0c41c
    Loom-Build: unknown 56435bf476452911283e43940ecfd9a30f804af9 clean
    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
2026-10-01 chore: resync installed Loom surfaces
    <!-- loom:provenance v1 build=unknown f2868e6b4d60d11a8ab47d25cad9e248229d2f66 clean prompts=none sweep=none story=none trace=4e2766ed5160781df891476246a9be2e host=robb-studio base=4498df098ece6ebf57aa5d7867f9ab6f86baf567 run=loom-run/v1:timer:robb-studio/fleet-resync:2d3851d5-1673-43ae-bcc6-e5c971b37f33 installs=0.19.603 74778a6aeea5d9e06b489400942b35f33c8bb766 -->
    Loom-Trace-Id: 4e2766ed5160781df891476246a9be2e
    Loom-Build: unknown f2868e6b4d60d11a8ab47d25cad9e248229d2f66 clean
    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
2026-10-01 chore: resync installed Loom surfaces
    <!-- loom:provenance v1 build=unknown d6714830391f7596338b8de40ee2d0f45dcd12f5 clean prompts=none sweep=none story=none trace=af273f717e759e690d07f372734e9278 host=robb-pro base=9e4b0517821957270353d74889610dc6dee9183a run=loom-run/v1:timer:robb-pro/fleet-resync:92e2f9ba-d083-411b-833b-ae52d169ef04 installs=0.19.605 6eb2b65a4496b7becb84ef1f944493a541fd01cd -->
    Loom-Trace-Id: af273f717e759e690d07f372734e9278
    Loom-Build: unknown d6714830391f7596338b8de40ee2d0f45dcd12f5 clean
    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
2026-10-01 chore: resync installed Loom surfaces
    <!-- loom:provenance v1 build=unknown 617257919edc1b9b9ee27532c5ec1b8a64523388 clean prompts=none sweep=none story=none trace=cb047565635d880cd4ae328b5cfaaf68 host=loom-worker-1 base=c8f8ff7809126beefc30a248603ef5df8bdb40fe run=loom-run/v1:script:loom-worker-1/fleet-resync:9973280a-d0de-4196-8cdb-f221825edc41 installs=0.19.609 ff30576dacc8c2734b1c7434bedd29c47122caeb -->
    Loom-Trace-Id: cb047565635d880cd4ae328b5cfaaf68
    Loom-Build: unknown 617257919edc1b9b9ee27532c5ec1b8a64523388 clean
    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
2026-10-01 chore: resync installed Loom surfaces
    invocation: fleet-resync.sh --repo gf180-usb2-phy --push
    <!-- loom:provenance v1 build=unknown 954a0d1de29ab807c26560c5acd735400bb59d79 clean prompts=none sweep=none story=none trace=07f1339f3c690ed593ac6b463c0bde15 host=loom-worker-2 base=cb1c520674b6008d33c2b820cf18d178396c21c7 run=loom-run/v1:script:loom-worker-2/fleet-resync:0837df52-cde7-4e51-a0ef-1b387027642c installs=0.19.609 9a5a972c77f1ee30369714a2a17ccf4a156ff273 -->
    Loom-Trace-Id: 07f1339f3c690ed593ac6b463c0bde15
    Loom-Build: unknown 954a0d1de29ab807c26560c5acd735400bb59d79 clean
    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
2026-10-01 chore: resync installed Loom surfaces
    <!-- loom:provenance v1 build=unknown 617257919edc1b9b9ee27532c5ec1b8a64523388 clean prompts=none sweep=none story=none trace=dbafe4f8526617aa07c890721298a080 host=robb-studio base=ed83812093e9bcd32401c7de7da81ac043d96992 run=loom-run/v1:timer:robb-studio/fleet-resync:1817df66-02cc-4b27-927d-a38485da550a installs=0.19.610 c94891dd526cf6db5ee02045424c6913be522048 -->
    Loom-Trace-Id: dbafe4f8526617aa07c890721298a080
    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
2026-10-01 chore: resync installed Loom surfaces
    <!-- loom:provenance v1 build=unknown a2a39ac2736eb2686e2c65412d939e67c0438a7d clean prompts=none sweep=none story=none trace=fc1a121767151aae5bd7427c683b7db6 host=robb-pro base=4809f9b428ace614f9b29868c9b5c2b0e670e2ee run=loom-run/v1:timer:robb-pro/fleet-resync:708eb7c8-469d-4783-80b7-bafe142df3c4 installs=0.19.612 d25614656adcf70162da95c5e1035e99a0639a1a -->
    Loom-Trace-Id: fc1a121767151aae5bd7427c683b7db6
    Loom-Build: unknown a2a39ac2736eb2686e2c65412d939e67c0438a7d clean
    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
2026-10-01 chore(tooling): update repo-skills to v0.19.5
    Fleet-wide Repo Skills rollout (2026-10-01). compute-drift's axis 6
    reported repo-skills at 11 different versions across the fleet's
    checkouts; this brings gf180-usb2-phy from v0.10.0 to v0.19.5 (rjwalters/repo
    @ ff282cd), staging only the installer's own surface.
    Loom-Trace-Id: 038dce5d677bceeeca3c111787ac5b68
    Loom-Build: unknown unknown unknown
    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
2026-10-01 chore: resync installed Loom surfaces
    <!-- loom:provenance v1 build=unknown 126c80914e42f913c4fc778d3ddce96daa2c7a77 clean prompts=none sweep=none story=none trace=15a20fbea7a00d0922b943088c80e19d host=loom-worker-1 base=48f8768236f0fb30f028a0c2f20fad2d528e5573 run=loom-run/v1:script:loom-worker-1/fleet-resync:ecc423da-4625-49de-b25a-692fd669a029 installs=0.19.612 d47e0c57a6bea6f7b61ef9ce62632d70c39ef5d5 -->
    Loom-Trace-Id: 15a20fbea7a00d0922b943088c80e19d
    Loom-Build: unknown 126c80914e42f913c4fc778d3ddce96daa2c7a77 clean
    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
2026-10-01 chore: resync installed Loom surfaces
    <!-- loom:provenance v1 build=unknown 126c80914e42f913c4fc778d3ddce96daa2c7a77 clean prompts=none sweep=none story=none trace=a0a42bd10fcfa6d7cbcc9c021c406848 host=loom-worker-2 base=730644c953f21d6b7eba1d786fa7816900671a9d run=loom-run/v1:timer:loom-worker-2/fleet-resync:9e174e6bb0fa41d786e4a86e45632b6f installs=0.19.612 6f0871dc66e62b36d8382ced980d2805bfd97e50 -->
    Loom-Trace-Id: a0a42bd10fcfa6d7cbcc9c021c406848
    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
2026-10-01 chore: resync installed Loom surfaces
    <!-- loom:provenance v1 build=unknown 8891f74a5d568fe3d13937ef37fd64371dd2738f clean prompts=none sweep=none story=none trace=1e216ea76cbd2b72542049c4c18c2817 host=loom-worker-1 base=0400f85b3a7f454a8982e87f51754386e1e80ff5 run=loom-run/v1:timer:loom-worker-1/fleet-resync:679feba6c0f347d39eb5943ed77dc87b installs=0.19.612 62fa67f8756bdf59fdf744be053e5ef1709f1335 -->
    Loom-Trace-Id: 1e216ea76cbd2b72542049c4c18c2817
    Loom-Build: unknown 8891f74a5d568fe3d13937ef37fd64371dd2738f clean
    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
2026-10-01 chore: resync installed Loom surfaces
    <!-- loom:provenance v1 build=unknown 6f3411c8a63e68097dde01bce8a8422230f54218 clean prompts=none sweep=none story=none trace=9aa0a46bb352b9665fdaa5f5b3b85dd7 host=robb-pro base=501bd105b35439ceff435c79c1aee05f7e1fe03c run=loom-run/v1:timer:robb-pro/fleet-resync:ca419e1d-6646-4678-ac7a-b263e4b5119e installs=0.19.612 7731400b3e3e1df39074564166edf656feb0999c -->
    Loom-Trace-Id: 9aa0a46bb352b9665fdaa5f5b3b85dd7
    Loom-Build: unknown 6f3411c8a63e68097dde01bce8a8422230f54218 clean
    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
2026-10-02 chore: resync installed Loom surfaces
    <!-- loom:provenance v1 build=unknown 13c0a3ef467a888520a6529ab34486ab8be826be clean prompts=none sweep=none story=none trace=41356080f367e491d5ff03f17bb98c27 host=loom-worker-2 base=2087ecde1ce91319bfcc776ea4360f70d4e9ad71 run=loom-run/v1:timer:loom-worker-2/fleet-resync:44455fbcbab745abb92cea192fafbb1d installs=0.19.614 3c79f7b1d0cc14723e049cff4250ff7330804326 -->
    Loom-Trace-Id: 41356080f367e491d5ff03f17bb98c27
    Loom-Build: unknown 13c0a3ef467a888520a6529ab34486ab8be826be clean
    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
2026-10-02 chore: resync installed Loom surfaces
    <!-- loom:provenance v1 build=unknown ea2dd21f2ba310ec007d047ddfecc6cd27d220ac clean prompts=none sweep=none story=none trace=f04a67f3922788d2ccdd66578c8d18f9 host=loom-worker-1 base=14dba10de95fe3b13e8a00e4d037ffd8c25182d9 run=loom-run/v1:timer:loom-worker-1/fleet-resync:1c3b601dd998488595adc09040c007d4 installs=0.19.614 79f4897c5d3c78dbfc1b022f77d244838dbf4ccb -->
    Loom-Trace-Id: f04a67f3922788d2ccdd66578c8d18f9
    Loom-Build: unknown ea2dd21f2ba310ec007d047ddfecc6cd27d220ac clean
    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
2026-10-02 chore: resync installed Loom surfaces
    <!-- loom:provenance v1 build=unknown 6f3411c8a63e68097dde01bce8a8422230f54218 clean prompts=none sweep=none story=none trace=acb28d0049e0cc75536f96d503f6e814 host=robb-studio base=48e347c8c1ad49c5fb7da8e202d6a24220380731 run=loom-run/v1:timer:robb-studio/fleet-resync:85d2b1b5-e81d-40c3-ab6a-9a00efbc4ee2 installs=0.19.616 d86523eeadb32b95777f3cd3a76dd2f72f0bf792 -->
    Loom-Trace-Id: acb28d0049e0cc75536f96d503f6e814
    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
2026-10-02 chore: resync installed Loom surfaces
    <!-- loom:provenance v1 build=unknown 2b50bd69eddd038dd738465aa58a9ebca11410ac clean prompts=none sweep=none story=none trace=324e4f607054d0396cfdf8fdc01e93ae host=robb-pro base=0b1ec58651b6a4bf142f70d0bd157f3d50261e7d run=loom-run/v1:timer:robb-pro/fleet-resync:a63799f1-2ad7-4946-b81d-2ec231bc2d2f installs=0.19.617 81cb2ad7e091b19d6a2b95d1add6938c2100d46b -->
    Loom-Trace-Id: 324e4f607054d0396cfdf8fdc01e93ae
    Loom-Build: unknown 2b50bd69eddd038dd738465aa58a9ebca11410ac clean
    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
2026-10-02 chore: resync installed Loom surfaces
    <!-- loom:provenance v1 build=unknown 00d92b326aed50280cd90dc116b7caec27668251 clean prompts=none sweep=none story=none trace=9a5d23cc82b6d3a1c83bfee47bd04970 host=loom-worker-2 base=e9bd0fc82c15ea8c971c9d51177ee732e6f38da6 run=loom-run/v1:timer:loom-worker-2/fleet-resync:12136a7a025d49f3a60b5edb04a3ff81 installs=0.19.619 4c0f505e4f0b76f8ccec07bda6d8b839030c077b -->
    Loom-Trace-Id: 9a5d23cc82b6d3a1c83bfee47bd04970
    Loom-Build: unknown 00d92b326aed50280cd90dc116b7caec27668251 clean
    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
2026-10-02 chore: resync installed Loom surfaces
    <!-- loom:provenance v1 build=unknown 456dad6d90259846313dc3bb80bf4e5471ef2d76 clean prompts=none sweep=none story=none trace=bb9688c03fb5211d06f48c8838a5505c host=robb-studio base=8e0dce77f3cc4b2b6384dbce7be0095821763d6d run=loom-run/v1:timer:robb-studio/fleet-resync:e965c017-8ec7-485d-b46e-aeb399b81fb4 installs=0.19.620 0d28ba49f5a88fdb37271de9cb0144eb3442c6e3 -->
    Loom-Trace-Id: bb9688c03fb5211d06f48c8838a5505c
    Loom-Build: unknown 456dad6d90259846313dc3bb80bf4e5471ef2d76 clean
    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
2026-10-02 chore: resync installed Loom surfaces
    <!-- loom:provenance v1 build=unknown 6c6d2b6565dc13eff4c6811b9c670f452106516b clean prompts=none sweep=none story=none trace=539be979ae694d66ede516a7b5d17e41 host=robb-pro base=734ea6528e7d7ddb6633052549e18bbb3569cfb8 run=loom-run/v1:timer:robb-pro/fleet-resync:9444d216-de08-442f-8352-ba59f6e81bb3 installs=0.19.621 a90dc1d794eb9ff70aaf939ebf495abe716f3bdd -->
    Loom-Trace-Id: 539be979ae694d66ede516a7b5d17e41
    Loom-Build: unknown 6c6d2b6565dc13eff4c6811b9c670f452106516b clean
    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
2026-10-02 chore: resync installed Loom surfaces
    <!-- loom:provenance v1 build=unknown f6d28134bfe476967e005d97424073085f55e8a3 clean prompts=none sweep=none story=none trace=27eb90670d441065f593e941066ee005 host=loom-worker-2 base=4d79e6b719785cadd77966f13dd316250ca30c01 run=loom-run/v1:timer:loom-worker-2/fleet-resync:04001bba930241cf9e325bf304a9270a installs=0.19.623 ccc19c2bbe2aa65328427730fa53f70eb56128c6 -->
    Loom-Trace-Id: 27eb90670d441065f593e941066ee005
    Loom-Build: unknown f6d28134bfe476967e005d97424073085f55e8a3 clean
    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
2026-10-02 chore: resync installed Loom surfaces
    <!-- loom:provenance v1 build=unknown bc461736314499b6c2c4c0ad51fb2294f60336f5 clean prompts=none sweep=none story=none trace=c3ea68717dd3a908dbbd60a35bc8b5d6 host=robb-studio base=8c0b53fa12b426ef6933a25dac83d07a0ef4dabf run=loom-run/v1:timer:robb-studio/fleet-resync:8d4c49e2-3258-4080-b0c8-082499053654 installs=0.19.623 a50aaf70069f8897c41a64b7d90783c5ab8294e0 -->
    Loom-Trace-Id: c3ea68717dd3a908dbbd60a35bc8b5d6
    Loom-Build: unknown bc461736314499b6c2c4c0ad51fb2294f60336f5 clean
    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
2026-10-02 chore: resync installed Loom surfaces
    <!-- loom:provenance v1 build=unknown bc461736314499b6c2c4c0ad51fb2294f60336f5 clean prompts=none sweep=none story=none trace=8bee8a664bfc89e0bbfbb3c2de7342ba host=loom-worker-2 base=f64b96b002a292101c3fc5f4268965621463e3e9 run=loom-run/v1:timer:loom-worker-2/fleet-resync:de2ceceb48ea4927a1334d08dc0082fe installs=0.19.624 5f49564fa78ae06f8c48d5224dae9ded04200bb7 -->
    Loom-Trace-Id: 8bee8a664bfc89e0bbfbb3c2de7342ba
    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
2026-10-03 chore: resync installed Loom surfaces
    <!-- loom:provenance v1 build=unknown 752d316233ed1a3da9e4f69ad760eb99bb477747 clean prompts=none sweep=none story=none trace=7851839b67c00a023e97cbdea1f580e1 host=robb-pro base=9d50f6f2dea9d2fb32567100d7581dc8d766f1f8 run=loom-run/v1:timer:robb-pro/fleet-resync:ae492b66-dca0-4da4-acab-8d26778f2d5c installs=0.19.624 121fac45f5006879bf58a18c951b9243d9099a18 -->
    Loom-Trace-Id: 7851839b67c00a023e97cbdea1f580e1
    Loom-Build: unknown 752d316233ed1a3da9e4f69ad760eb99bb477747 clean
    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
2026-10-03 chore: resync installed Loom surfaces
    <!-- loom:provenance v1 build=unknown b34a08286a42f47f917ec46647d4d167c1f5207c clean prompts=none sweep=none story=none trace=a8e453124b899b440f42c9d83837c7b6 host=loom-worker-2 base=ee72f973587680c3c9c94b4d4d978d4bbcdc3077 run=loom-run/v1:timer:loom-worker-2/fleet-resync:f02dd5df715347fe90fe14b9353a1b66 installs=0.19.624 98c193cf0d12d68d3770edc1baad808c40bb5fd4 -->
    Loom-Trace-Id: a8e453124b899b440f42c9d83837c7b6
    Loom-Build: unknown b34a08286a42f47f917ec46647d4d167c1f5207c clean
    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
2026-10-03 chore: resync installed Loom surfaces
    <!-- loom:provenance v1 build=unknown 3437cece5ab759f772122f8d18a6d2f05d246cde clean prompts=none sweep=none story=none trace=1bd6b75d1c0daff2b433adf5999546a3 host=loom-worker-1 base=9aeaa25b2fd3fcce7589b93d52cdbff9fb40a70d run=loom-run/v1:timer:loom-worker-1/fleet-resync:4c0abac1c29646eaa8502afa223bdd2b installs=0.19.624 0162badc662fb30c070e70611aa8ff74a8486d54 -->
    Loom-Trace-Id: 1bd6b75d1c0daff2b433adf5999546a3
    Loom-Build: unknown 3437cece5ab759f772122f8d18a6d2f05d246cde clean
    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
2026-10-03 chore: resync installed Loom surfaces
    <!-- loom:provenance v1 build=unknown 3437cece5ab759f772122f8d18a6d2f05d246cde clean prompts=none sweep=none story=none trace=bba21427f750636f851279cfae92b4e5 host=loom-worker-1 base=23f10c61da7e0b5177175fe4f4dc6825dc29d549 run=loom-run/v1:timer:loom-worker-1/fleet-resync:9440cda9476f404caa282e360a81ee03 installs=0.19.636 e41edfbb52c13982f7d8b0577f42957427a6514c -->
    Loom-Trace-Id: bba21427f750636f851279cfae92b4e5
    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
2026-10-03 chore: resync installed Loom surfaces
    <!-- loom:provenance v1 build=unknown 28040ed11a4369e20f3b7b0154a3fb2a2c35d38c clean prompts=none sweep=none story=none trace=0cd87d01c45d97a2ee57a99363fc0db2 host=robb-studio base=0f7fef02cfd6dd3c4aa7af2530357edc18998655 run=loom-run/v1:timer:robb-studio/fleet-resync:74b93657-6b04-4ac5-bc77-e0a1682b0595 installs=0.19.636 e41edfbb52c13982f7d8b0577f42957427a6514c -->
    Loom-Trace-Id: 0cd87d01c45d97a2ee57a99363fc0db2
    Loom-Build: unknown 28040ed11a4369e20f3b7b0154a3fb2a2c35d38c clean
    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
2026-10-03 chore: resync installed Loom surfaces
    <!-- loom:provenance v1 build=unknown 388c7fe0cad997f7a887f70c9f2cfe8781a2d512 clean prompts=none sweep=none story=none trace=2046ffd42f138a06b914f34851de3440 host=loom-worker-2 base=5096910913fad7b97192965858f10c99deb6e794 run=loom-run/v1:timer:loom-worker-2/fleet-resync:17c9456bb1934c70a545b12081496cce installs=0.19.647 d1fe5dead4202be12a964ab891fd5980e7836170 -->
    Loom-Trace-Id: 2046ffd42f138a06b914f34851de3440
    Loom-Build: unknown 388c7fe0cad997f7a887f70c9f2cfe8781a2d512 clean
    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
2026-10-03 chore: resync installed Loom surfaces
    <!-- loom:provenance v1 build=unknown 8078c29e691123d91cd761a786f99cfd25f1809d clean prompts=none sweep=none story=none trace=45869a6374635c036a11a6f379fe31a4 host=robb-pro base=e8c22f06373c10fc8006958738c9bc57b18effc5 run=loom-run/v1:timer:robb-pro/fleet-resync:b0a94991-052d-4e7d-ba2b-78b971096849 installs=0.19.647 709ca4396e074e5a4d1c5e19721f6ddac7154ca2 -->
    Loom-Trace-Id: 45869a6374635c036a11a6f379fe31a4
    Loom-Build: unknown 8078c29e691123d91cd761a786f99cfd25f1809d clean
    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
2026-10-03 chore: resync installed Loom surfaces
    <!-- loom:provenance v1 build=unknown f9cba29b0602624a23daa17ae04d31d82e10fa91 clean prompts=none sweep=none story=none trace=754b3688f97b6c34894d8cfbf272b81a host=loom-worker-1 base=88d89d12c1d41e523c0d8588ed602c7819ff95be run=loom-run/v1:script:loom-worker-1/fleet-resync:11eb117a-9ff3-4411-88d4-fdd7d6748639 installs=0.19.649 6f2f13b1c31ce420e2250ae040d8e1050c0e761b -->
    Loom-Trace-Id: 754b3688f97b6c34894d8cfbf272b81a
    Loom-Build: unknown f9cba29b0602624a23daa17ae04d31d82e10fa91 clean
    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
2026-10-03 chore: resync installed Loom surfaces
    <!-- loom:provenance v1 build=unknown f9cba29b0602624a23daa17ae04d31d82e10fa91 clean prompts=none sweep=none story=none trace=544a028e3829d4020b8aaa144e5fa628 host=robb-studio base=33a20966582608ad74d558002fbc26532997c65c run=loom-run/v1:script:robb-studio/fleet-resync:5b5b8b83-7139-447d-88bd-417dcf375aa6 installs=0.19.649 6f2f13b1c31ce420e2250ae040d8e1050c0e761b -->
    Loom-Trace-Id: 544a028e3829d4020b8aaa144e5fa628
    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
2026-10-03 chore: resync installed Loom surfaces
    <!-- loom:provenance v1 build=unknown f9cba29b0602624a23daa17ae04d31d82e10fa91 clean prompts=none sweep=none story=none trace=1057aaaf811f6dd2d64a3bb6d4b3ac49 host=robb-pro base=565ac1678a5a36dccd80ae2a3d69ac9b83c7c8c8 run=loom-run/v1:timer:robb-pro/fleet-resync:785c1ea0-d7f2-4810-99e9-cd9368aebe0c installs=0.19.649 2118aabb5a925f1ec4669b4d3d31176a46d8f2a6 -->
    Loom-Trace-Id: 1057aaaf811f6dd2d64a3bb6d4b3ac49
    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
2026-10-03 chore: resync installed Loom surfaces
    <!-- loom:provenance v1 build=unknown 72f61d9aa0fe08f1ef59f1a97a314e474455801e clean prompts=none sweep=none story=none trace=577d2185973ec59f059fa15bf5b5e514 host=loom-worker-1 base=f360786e4d3bbdd03d3d8a7e83dcf1a5d11ae001 run=loom-run/v1:script:loom-worker-1/fleet-resync:5728a930-137f-4d2f-a962-1cdd7a6a1d46 installs=0.19.652 235a64727b907d65529151af0a962b14f16462a0 -->
    Loom-Trace-Id: 577d2185973ec59f059fa15bf5b5e514
    Loom-Build: unknown 72f61d9aa0fe08f1ef59f1a97a314e474455801e clean
    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
2026-10-03 chore: resync installed Loom surfaces
    <!-- loom:provenance v1 build=unknown 72f61d9aa0fe08f1ef59f1a97a314e474455801e clean prompts=none sweep=none story=none trace=845aaa0eb340f80f12095e2e8b421ed1 host=robb-pro base=2abed6b1d8a57d1e45b5f8e0596bab3a13a32f37 run=loom-run/v1:script:robb-pro/fleet-resync:344add4b-df8a-49e8-8563-2765673acc76 installs=0.19.652 235a64727b907d65529151af0a962b14f16462a0 -->
    Loom-Trace-Id: 845aaa0eb340f80f12095e2e8b421ed1
    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
2026-10-03 chore: resync installed Loom surfaces
    <!-- loom:provenance v1 build=unknown 21130104346fe9c464ce8a3fdf82c1d3e9667639 clean prompts=none sweep=none story=none trace=36308fff5a3c323c3d1bf6fffb6cd122 host=robb-studio base=e6682860843673cbabf849c72bbde0b1fc6fdf27 run=loom-run/v1:timer:robb-studio/fleet-resync:89972fbd-0774-4402-bbb7-26c33a851735 installs=0.19.652 fb69233bd8f1dfc2bdee37d8b934f99274dc0193 -->
    Loom-Trace-Id: 36308fff5a3c323c3d1bf6fffb6cd122
    Loom-Build: unknown 21130104346fe9c464ce8a3fdf82c1d3e9667639 clean
    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
2026-10-04 chore: resync installed Loom surfaces
    <!-- loom:provenance v1 build=unknown 61870b40779d205c1555e801c6e1d95df083cdea clean prompts=none sweep=none story=none trace=fb9213e215442932d2af05f3b14977de host=robb-pro base=d5f49e4c272d730d184f15d9e6cdd4d19b17dc0e run=loom-run/v1:timer:robb-pro/fleet-resync:4c70cd1d-08cd-4add-8e2a-9a75160d163f installs=0.19.655 36c39e3c6f56e1979647ec235b4bd19c77db22f3 -->
    Loom-Trace-Id: fb9213e215442932d2af05f3b14977de
    Loom-Build: unknown 61870b40779d205c1555e801c6e1d95df083cdea clean
    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
2026-10-04 chore: resync installed Loom surfaces
    <!-- loom:provenance v1 build=unknown 61870b40779d205c1555e801c6e1d95df083cdea clean prompts=none sweep=none story=none trace=baa6c2cfcae1a320917c00ff2eb8b630 host=loom-worker-2 base=abdfa41ec1b70148dda032715470d06db7655bd6 run=loom-run/v1:timer:loom-worker-2/fleet-resync:741a7f0f16df4fb1be4e657aeacd1244 installs=0.19.655 fc667a4faae1227f8a6837431f8a0c2d0aeaa7dd -->
    Loom-Trace-Id: baa6c2cfcae1a320917c00ff2eb8b630
    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
2026-10-04 chore: resync installed Loom surfaces
    <!-- loom:provenance v1 build=unknown b922acb2ac655cbccd71daa9e3f05a325a094ca5 clean prompts=none sweep=none story=none trace=833eeb34d4ca65c3f8c6f7824ddca3a3 host=robb-studio base=f3bbcf9f12968debfeb8b1be15f4f016f703e876 run=loom-run/v1:timer:robb-studio/fleet-resync:0d44f6dc-6a62-4d43-b49d-7cfdd7dbd823 installs=0.19.663 0a51e373e7fe1be156c5774b2c827d4b745368a3 -->
    Loom-Trace-Id: 833eeb34d4ca65c3f8c6f7824ddca3a3
    Loom-Build: unknown b922acb2ac655cbccd71daa9e3f05a325a094ca5 clean
    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
2026-10-04 chore: resync installed Loom surfaces
    <!-- loom:provenance v1 build=unknown 746ecb5f9d7e64ba1d2526f1e997530ad4f3dd43 clean prompts=none sweep=none story=none trace=f09501431241df2ec5688e334ba43dfe host=loom-worker-2 base=150ddf9f5819d5ccab39e63f3eb3fe18883e8b9c run=loom-run/v1:timer:loom-worker-2/fleet-resync:70797dad61fb4e21806716d54f1ce910 installs=0.19.669 59a1f84e3742827a8033bb153ebbedc1759bee72 -->
    Loom-Trace-Id: f09501431241df2ec5688e334ba43dfe
    Loom-Build: unknown 746ecb5f9d7e64ba1d2526f1e997530ad4f3dd43 clean
    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
2026-10-04 chore: resync installed Loom surfaces
    <!-- loom:provenance v1 build=unknown 8080d0485cc1312129ee642b084944c56d1be074 clean prompts=none sweep=none story=none trace=ed180bcab6828041123ad54d8ddb4037 host=robb-pro base=781922ae58a0d297e8dc9b90fad4d567baad11a3 run=loom-run/v1:timer:robb-pro/fleet-resync:e97b2f08-4ad9-4b66-a166-5b19820e2d1f installs=0.19.669 59a1f84e3742827a8033bb153ebbedc1759bee72 -->
    Loom-Trace-Id: ed180bcab6828041123ad54d8ddb4037
    Loom-Build: unknown 8080d0485cc1312129ee642b084944c56d1be074 clean
    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
2026-10-04 chore: resync installed Loom surfaces
    <!-- loom:provenance v1 build=unknown 83cb6647167ffc000d2c2f479b4e816b68f863f4 clean prompts=none sweep=none story=none trace=ccabffa1e1ba495895b262086030816c host=robb-studio base=5006eab5f198aaa86ca53cd2339303df5baa1ad9 run=loom-run/v1:timer:robb-studio/fleet-resync:88a78f1f-d978-47b5-99c3-2aabde811d17 installs=0.19.676 cd4f30bd892ea2595d8218b08150633504b0dd14 -->
    Loom-Trace-Id: ccabffa1e1ba495895b262086030816c
    Loom-Build: unknown 83cb6647167ffc000d2c2f479b4e816b68f863f4 clean
    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
2026-10-04 chore: resync installed Loom surfaces
    <!-- loom:provenance v1 build=unknown 32174d0f7e80508fa66c1a11a2c0fb28c515607e clean prompts=none sweep=none story=none trace=436d7c19b10cd5807625a7ce7190a82f host=loom-worker-2 base=ca86079f18a0fb3c026eba99006d9a9030e1499e run=loom-run/v1:timer:loom-worker-2/fleet-resync:19ae50771cc04d8db7b1403c1e66bbea installs=0.19.682 9eccfa110fa294fa32a62ffe8eff669cfcf1a3a6 -->
    Loom-Trace-Id: 436d7c19b10cd5807625a7ce7190a82f
    Loom-Build: unknown 32174d0f7e80508fa66c1a11a2c0fb28c515607e clean
    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
2026-10-04 chore: resync installed Loom surfaces
    <!-- loom:provenance v1 build=unknown 72290fa960e0773b2c50d74042e24914c7327637 clean prompts=none sweep=none story=none trace=f7b6952a649a174398a48b90b6ab4793 host=robb-pro base=5173eb923b704ee44a7f978f99b3cd12ab42804c run=loom-run/v1:timer:robb-pro/fleet-resync:72f32482-5cc4-4b38-ab9e-4d2ef0b64e94 installs=0.19.684 bdb8fb331eb51c7def4cdd2c38b611af06f25f6d -->
    Loom-Trace-Id: f7b6952a649a174398a48b90b6ab4793
    Loom-Build: unknown 72290fa960e0773b2c50d74042e24914c7327637 clean
    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
2026-10-04 chore: resync installed Loom surfaces
    <!-- loom:provenance v1 build=unknown 76cda58637be0e74c4cb5b4c8dbc2000e2a9c3d4 clean prompts=none sweep=none story=none trace=614cbada5ce873c2b34a511816309cfc host=robb-studio base=773af36b8e5507e32fce0729649c8375fb4ad4fb run=loom-run/v1:timer:robb-studio/fleet-resync:7e559a3b-ffdd-409b-8dd2-ae906a273b0a installs=0.19.692 d4974b9f5ff7843a3cfc06378ea2a69bc120e0f4 -->
    Loom-Trace-Id: 614cbada5ce873c2b34a511816309cfc
    Loom-Build: unknown 76cda58637be0e74c4cb5b4c8dbc2000e2a9c3d4 clean
    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
2026-10-04 chore: resync installed Loom surfaces
    <!-- loom:provenance v1 build=unknown f84bac5c232c093f83c1adc2533d8c75b021cda2 clean prompts=none sweep=none story=none trace=e687830614e4bd1c551ab6cf6186f8f3 host=loom-worker-2 base=62ab50a97205d1cc8bf95b5eaa13ba710e074507 run=loom-run/v1:timer:loom-worker-2/fleet-resync:2db2c4373ac24de1b7a364e69eaea1ca installs=0.19.695 b0d5b09f207fda439390ea1dd249ad10e7009dfc -->
    Loom-Trace-Id: e687830614e4bd1c551ab6cf6186f8f3
    Loom-Build: unknown f84bac5c232c093f83c1adc2533d8c75b021cda2 clean
    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
2026-10-04 chore: resync installed Loom surfaces
    <!-- loom:provenance v1 build=unknown ac5c275d1c616a9723e747f5a66de93dc80d3512 clean prompts=none sweep=none story=none trace=c777c3912bd31972e9aa3ccab712ae01 host=loom-worker-1 base=fec08fa7049fe3d559fa758a2098ad4891a10d1a run=loom-run/v1:script:loom-worker-1/fleet-resync:b51a1b33-4958-4408-be36-166e12e8360b installs=0.19.697 ada83a5c7ff66b56b0060ef0be368c9fe56eb3c6 -->
    Loom-Trace-Id: c777c3912bd31972e9aa3ccab712ae01
    Loom-Build: unknown ac5c275d1c616a9723e747f5a66de93dc80d3512 clean
    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
2026-10-04 chore: resync installed Loom surfaces
    <!-- loom:provenance v1 build=unknown a19f642f5c09599c4c64827d81d228eb031be73e clean prompts=none sweep=none story=none trace=34a80e22764eb5055e37faec0eaf65fb host=robb-pro base=2708d8784c7855ecd5ea593b25a360edb5a7cd0b run=loom-run/v1:script:robb-pro/fleet-resync:689be620-3ff2-4ff5-a2ce-f6825f6379e2 installs=0.19.698 aa619a1d07e36e8d90ac01fea63dc39285c93567 -->
    Loom-Trace-Id: 34a80e22764eb5055e37faec0eaf65fb
    Loom-Build: unknown a19f642f5c09599c4c64827d81d228eb031be73e clean
    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
2026-10-04 chore: resync installed Loom surfaces
    <!-- loom:provenance v1 build=unknown 693bdd794cb34afdefd7f0c4596824cd53078a61 clean prompts=none sweep=none story=none trace=aa18f1ec102a98d77ffc51c9be6ffbb3 host=robb-studio base=32d0b07af3c6eeb004c8acb6e1b44e6790e180be run=loom-run/v1:script:robb-studio/fleet-resync:3cb89ca8-62c2-4a69-8434-c4aaa3b64eaf installs=0.19.698 a58f00e0681c50d6bfc5089d0af4b3715198319f -->
    Loom-Trace-Id: aa18f1ec102a98d77ffc51c9be6ffbb3
    Loom-Build: unknown 693bdd794cb34afdefd7f0c4596824cd53078a61 clean
    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
2026-10-04 chore: resync installed Loom surfaces
    <!-- loom:provenance v1 build=unknown 7a41c2e69ef89d60ed3bd190b94838021bf18d0f clean prompts=none sweep=none story=none trace=d0f04f38b507d85402723643fcf47197 host=loom-worker-1 base=49edaebf166a09377c655145b66685044e0feb6d run=loom-run/v1:script:loom-worker-1/fleet-resync:8fdc8c1c-f844-4c33-bc80-b424e5b4cf3d installs=0.19.703 89d5a428c652f957d7fad8a546589042d39911bc -->
    Loom-Trace-Id: d0f04f38b507d85402723643fcf47197
    Loom-Build: unknown 7a41c2e69ef89d60ed3bd190b94838021bf18d0f clean
    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
2026-10-05 chore: resync installed Loom surfaces
    <!-- loom:provenance v1 build=unknown ebb37db560de172930e261675a35bd52e429f650 clean prompts=none sweep=none story=none trace=a40e86a64366c7a1e36aea026901334f host=loom-worker-2 base=7a553459ed75dabd9b196b35d08056a4cb3a9277 run=loom-run/v1:script:loom-worker-2/fleet-resync:90b6cd74-6cc0-4f58-98ee-6ede0ac6f50c installs=0.19.703 f63c3c82e6bf202f2ca7b205b532f681c5ebb2c8 -->
    Loom-Trace-Id: a40e86a64366c7a1e36aea026901334f
    Loom-Build: unknown ebb37db560de172930e261675a35bd52e429f650 clean
    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
2026-10-05 chore: resync installed Loom surfaces
    <!-- loom:provenance v1 build=unknown 7a41c2e69ef89d60ed3bd190b94838021bf18d0f clean prompts=none sweep=none story=none trace=fc04851db12f586b5d58155325131b6e host=robb-studio base=41739215e4c1b4ec8f57845ca36925dad0d3411d run=loom-run/v1:timer:robb-studio/fleet-resync:a7d5da6f-a896-4d6f-8d00-aebf47f9b266 installs=0.19.703 2ad9a08fb93de4d7dfac9d2b501d12c684c9c2cc -->
    Loom-Trace-Id: fc04851db12f586b5d58155325131b6e
    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
2026-10-05 chore: resync installed Loom surfaces
    <!-- loom:provenance v1 build=unknown afe7e99e397c242cc319fa80702fb3b23e23f5a7 clean prompts=none sweep=none story=none trace=e46782e1dd9c94461b4cf934ce05296b host=loom-worker-2 base=4ae6f86b619549fbd1914d4636d45ba2a9915a6c run=loom-run/v1:timer:loom-worker-2/fleet-resync:caa89259b1fd414ebd2f07500621166d installs=0.19.703 972fe7321be6a9efe2653579379ea3bc40b899b2 -->
    Loom-Trace-Id: e46782e1dd9c94461b4cf934ce05296b
    Loom-Build: unknown afe7e99e397c242cc319fa80702fb3b23e23f5a7 clean
    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
2026-10-05 chore: resync installed Loom surfaces
    <!-- loom:provenance v1 build=unknown b44cb904ebb599db793066ccc631c846862abfbd clean prompts=none sweep=none story=none trace=9590fed7c1b1c9f549ccf3cba24292d7 host=robb-pro base=1f45336c9c5e0efe1e79c9b13cdb79ca26d3935c run=loom-run/v1:timer:robb-pro/fleet-resync:dbc6174e-403d-422d-98b6-73a4b6dbf44f installs=0.19.708 dc8faf1eae3143feda6301887c303b1ee45db7f4 -->
    Loom-Trace-Id: 9590fed7c1b1c9f549ccf3cba24292d7
    Loom-Build: unknown b44cb904ebb599db793066ccc631c846862abfbd clean
    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
2026-10-05 chore: resync installed Loom surfaces
    <!-- loom:provenance v1 build=unknown 4548905848fcb7cb875c1c0518f2fd88eb65818e clean prompts=none sweep=none story=none trace=aff5e139797705f6fa0811f102ecd103 host=loom-worker-1 base=5ebb168436f15f69d09c473cfe4c0bce74520993 run=loom-run/v1:timer:loom-worker-1/fleet-resync:ba6a9e5686a64abaa842d71acaeae2ca installs=0.19.718 00d99344506bcf00e1aec7e910abe3d13df2d240 -->
    Loom-Trace-Id: aff5e139797705f6fa0811f102ecd103
    Loom-Build: unknown 4548905848fcb7cb875c1c0518f2fd88eb65818e clean
    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
2026-10-05 chore: resync installed Loom surfaces
    <!-- loom:provenance v1 build=unknown e7efbaa6e7b97a7d72da6032044c67525291f4d1 clean prompts=none sweep=none story=none trace=d74a33a6f35e329b3e795991e790ebfd host=robb-studio base=199348538ffa6cf6843f999a76b6f29ff063712b run=loom-run/v1:timer:robb-studio/fleet-resync:304f49c8-5b3e-46a9-a557-945b9ae177f0 installs=0.19.718 00d99344506bcf00e1aec7e910abe3d13df2d240 -->
    Loom-Trace-Id: d74a33a6f35e329b3e795991e790ebfd
    Loom-Build: unknown e7efbaa6e7b97a7d72da6032044c67525291f4d1 clean
    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
2026-10-05 chore: resync installed Loom surfaces
    <!-- loom:provenance v1 build=unknown 347b71e65e709d9fd49aba75d3fb67877fc08818 clean prompts=none sweep=none story=none trace=f9653dd318724c98136e7cef63e551ed host=robb-pro base=74139fee3337559b7b120399482d8c188af1e4db run=loom-run/v1:timer:robb-pro/fleet-resync:cdc95970-9fb1-49fa-a0e6-037a3fab2099 installs=0.19.728 991dcebf6f6b2de6571f1d3400bec083498c6438 -->
    Loom-Trace-Id: f9653dd318724c98136e7cef63e551ed
    Loom-Build: unknown 347b71e65e709d9fd49aba75d3fb67877fc08818 clean
    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
2026-10-05 chore: resync installed Loom surfaces
    <!-- loom:provenance v1 build=unknown 5c0d18101f48fecb656f10fa37afa9b09bf41631 clean prompts=none sweep=none story=none trace=ddcf49552af364cbf6e884bd59584c1f host=loom-worker-1 base=694ae34efd5d31b64d75dfdd5a8033a144b8b88c run=loom-run/v1:timer:loom-worker-1/fleet-resync:5eb526a05f244f1985770579e7620ff1 installs=0.19.731 7484b71fce5179a025950e71a82855afaf6fd730 -->
    Loom-Trace-Id: ddcf49552af364cbf6e884bd59584c1f
    Loom-Build: unknown 5c0d18101f48fecb656f10fa37afa9b09bf41631 clean
    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
2026-10-05 chore: resync installed Loom surfaces
    <!-- loom:provenance v1 build=unknown 0b160514b6658e3ab26a71c6525791da25b46fcf clean prompts=none sweep=none story=none trace=311c3eb2c0ab9550d3de38df5523f3d7 host=robb-studio base=f2b2da292fb42829fcf68e23e2156b889d1f4065 run=loom-run/v1:timer:robb-studio/fleet-resync:e6dec631-b42b-4cf2-b854-cc363cfde6e0 installs=0.19.731 d6146becf339a3d4e55e26e8807ac4571213a00b -->
    Loom-Trace-Id: 311c3eb2c0ab9550d3de38df5523f3d7
    Loom-Build: unknown 0b160514b6658e3ab26a71c6525791da25b46fcf clean
    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
2026-10-05 chore: resync installed Loom surfaces
    <!-- loom:provenance v1 build=unknown 5c0d18101f48fecb656f10fa37afa9b09bf41631 clean prompts=none sweep=none story=none trace=f1e8d4c6e73b8eec3e87a8da52e10f2d host=robb-pro base=9fe3e500e80be636d0991a055c93214ce4d18263 run=loom-run/v1:timer:robb-pro/fleet-resync:5518fd33-81cb-479f-93f0-287ea4b08876 installs=0.19.733 4e67131ce3a1317d8cb8904ec342541cc2f45665 -->
    Loom-Trace-Id: f1e8d4c6e73b8eec3e87a8da52e10f2d
    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
2026-10-05 chore: resync installed Loom surfaces
    <!-- loom:provenance v1 build=unknown ca170d11544ef499cc9500a45bbad152edacfbd1 clean prompts=none sweep=none story=none trace=6dcfc713b6a851b40932158c2eeb70af host=loom-worker-3 base=2c54653048079e93c61c57fe4b9713009d9adce3 run=loom-run/v1:timer:loom-worker-3/fleet-resync:20ce0908ea5a468a9e055470104047ed installs=0.19.734 7ba6ea50c36dfdd2b5e2922dd22c65560980a5a2 -->
    Loom-Trace-Id: 6dcfc713b6a851b40932158c2eeb70af
    Loom-Build: unknown ca170d11544ef499cc9500a45bbad152edacfbd1 clean
    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
2026-10-05 chore: resync installed Loom surfaces
    <!-- loom:provenance v1 build=unknown 03f1c42302d15f8a83425a84a4e36ca484f3f625 clean prompts=none sweep=none story=none trace=f1bc879f8aa652d550764ffcd36e27d1 host=loom-worker-1 base=b66717b36c0fca0eb6dba2b995397df2e936f06d run=loom-run/v1:timer:loom-worker-1/fleet-resync:f302a3cc8558413492093df510b02418 installs=0.19.734 967abe71d019ce6606018b4e57dee0223b84d96f -->
    Loom-Trace-Id: f1bc879f8aa652d550764ffcd36e27d1
    Loom-Build: unknown 03f1c42302d15f8a83425a84a4e36ca484f3f625 clean
    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
2026-10-05 chore: resync installed Loom surfaces
    <!-- loom:provenance v1 build=unknown ce7557ba58624d48fedbca2bc037dfa8ce3943e7 clean prompts=none sweep=none story=none trace=e1f2558834c47835cd9a53ec8c9a2ffa host=loom-worker-3 base=d68611e37ea0319ae92cf35034e27f7a2626c76e run=loom-run/v1:timer:loom-worker-3/fleet-resync:50f5f0046e2c4890961b3221bd360247 installs=0.19.734 ba9edb650872e5265eaca0c47f75e3cb828ecad2 -->
    Loom-Trace-Id: e1f2558834c47835cd9a53ec8c9a2ffa
    Loom-Build: unknown ce7557ba58624d48fedbca2bc037dfa8ce3943e7 clean
    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
2026-10-05 chore: resync installed Loom surfaces
    <!-- loom:provenance v1 build=unknown f92eaec38470a7b0732e065f4864faec9a1905d6 clean prompts=none sweep=none story=none trace=07aa020a8179d52651250562e9808b98 host=robb-studio base=e4b32e36342ef54e4c38d6c5928fde952ae9cf45 run=loom-run/v1:timer:robb-studio/fleet-resync:3b3ebdf2-b5f7-48ed-b7bb-5fb945094061 installs=0.19.734 78f3e99c44d0af6d4598adf7577bb6676baf3e8f -->
    Loom-Trace-Id: 07aa020a8179d52651250562e9808b98
    Loom-Build: unknown f92eaec38470a7b0732e065f4864faec9a1905d6 clean
    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
2026-10-06 chore: resync installed Loom surfaces
    <!-- loom:provenance v1 build=unknown ca170d11544ef499cc9500a45bbad152edacfbd1 clean prompts=none sweep=none story=none trace=fca9c14d74d6d634726f5823c51bc62a host=loom-worker-2 base=19babcc659f72dfa418926fc61aa77941b331f64 run=loom-run/v1:timer:loom-worker-2/fleet-resync:23a23f0878c1494cb720941baddfea81 installs=0.19.741 3cede3920c6b567d5400789187a904970d46b0fb -->
    Loom-Trace-Id: fca9c14d74d6d634726f5823c51bc62a
    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
2026-10-06 chore: resync installed Loom surfaces
    <!-- loom:provenance v1 build=unknown e38a22941348fd8e83d1f4b06130d2a214adfb50 clean prompts=none sweep=none story=none trace=a7fe3a9a1fedfce89846c20f2e98ac31 host=robb-pro base=a1ab4f49a15a9d642d3f4ba99068ed6bda929a9e run=loom-run/v1:timer:robb-pro/fleet-resync:2d770a42-f0e7-4695-abfa-b912e75382e6 installs=0.19.744 8bc5bcce93c4d9721817387afe8b4b6d79f26054 -->
    Loom-Trace-Id: a7fe3a9a1fedfce89846c20f2e98ac31
    Loom-Build: unknown e38a22941348fd8e83d1f4b06130d2a214adfb50 clean
    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
2026-10-06 chore: resync installed Loom surfaces
    <!-- loom:provenance v1 build=unknown f66ea90ff1bdec51aa4c8dc3f4b2e8d26e3dfd2d clean prompts=none sweep=none story=none trace=66d96c3bb00b04fae967865ee02fc4de host=loom-worker-3 base=fc1626ecb61a2c1e2813f0c543960361019b8fd8 run=loom-run/v1:timer:loom-worker-3/fleet-resync:eb2dceb410e848a19d58f96f678c995e installs=0.19.749 6135634b053dc30ef5aa8e6d733bfe79bb2ac734 -->
    Loom-Trace-Id: 66d96c3bb00b04fae967865ee02fc4de
    Loom-Build: unknown f66ea90ff1bdec51aa4c8dc3f4b2e8d26e3dfd2d clean
    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
2026-10-06 chore: resync installed Loom surfaces
    <!-- loom:provenance v1 build=unknown ade8a2c60cc8370d04d72f331141acb6fb32e121 clean prompts=none sweep=none story=none trace=6245fb88b5bdf9f7ccecb6b2168dc335 host=robb-studio base=fc9bbd77d1d6b5b22643f9d69dca4e75a41fc29f run=loom-run/v1:timer:robb-studio/fleet-resync:b305aed2-1a25-4576-aca7-9b017ac4377e installs=0.19.755 8d97d322e1cb3723988504337089beca73d0511c -->
    Loom-Trace-Id: 6245fb88b5bdf9f7ccecb6b2168dc335
    Loom-Build: unknown ade8a2c60cc8370d04d72f331141acb6fb32e121 clean
    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
2026-10-06 chore: resync installed Loom surfaces
    <!-- loom:provenance v1 build=unknown 2489bb7d5203844b3fbe8efbe007f44aa074685d clean prompts=none sweep=none story=none trace=0b5c9263a55c09e6fbd870b2d9ff5d9b host=loom-worker-2 base=194bbdf7e1b69c53d31ce470bf8d0e291c69db81 run=loom-run/v1:timer:loom-worker-2/fleet-resync:d3f5a5beb1144f72ac8be575767b3e03 installs=0.19.760 3a509582b179d91c2d5b5a65a7ba4650c3c08985 -->
    Loom-Trace-Id: 0b5c9263a55c09e6fbd870b2d9ff5d9b
    Loom-Build: unknown 2489bb7d5203844b3fbe8efbe007f44aa074685d clean
    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
2026-10-06 chore: resync installed Loom surfaces
    <!-- loom:provenance v1 build=unknown 986d16b700174622774ff68af4ef323e8d0e23ba clean prompts=none sweep=none story=none trace=cb518f1f5785c258556383940a46c461 host=loom-worker-1 base=2e35d7642d4b37b076f11d0f190c83b0cbec56e2 run=loom-run/v1:timer:loom-worker-1/fleet-resync:97df92c5eca846de85e979810663a94b installs=0.19.765 c6cec65c4f320f11153c72e840e49a5d6a6f1afc -->
    Loom-Trace-Id: cb518f1f5785c258556383940a46c461
    Loom-Build: unknown 986d16b700174622774ff68af4ef323e8d0e23ba clean
    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
2026-10-06 chore: resync installed Loom surfaces
    <!-- loom:provenance v1 build=unknown 85e52221261264d7f7643251de706f00c8db289f clean prompts=none sweep=none story=none trace=a2434124d73d8cca0ca77230fc85adf5 host=robb-pro base=27a31289037ff022862b4d29d6cb2f5f40f76b11 run=loom-run/v1:timer:robb-pro/fleet-resync:abffb067-59ed-4a6e-94b6-8cf3500c935c installs=0.19.768 c9f7ca975144d991bce40f492403b8292e8b7fae -->
    Loom-Trace-Id: a2434124d73d8cca0ca77230fc85adf5
    Loom-Build: unknown 85e52221261264d7f7643251de706f00c8db289f clean
    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
2026-10-06 chore: resync installed Loom surfaces
    <!-- loom:provenance v1 build=unknown 31b34ebfd7d4539094523eaa7b56a104bebe5fc0 clean prompts=none sweep=none story=none trace=16fac36f144dc183c71465eb36c89afc host=loom-worker-3 base=a030e330210b85e58243ac0397b2097fa2b8d10b run=loom-run/v1:timer:loom-worker-3/fleet-resync:c763e24590314b918c8ee8df5d2de1db installs=0.19.769 af995a5725fdadf708127f006aa8f248b482d7d7 -->
    Loom-Trace-Id: 16fac36f144dc183c71465eb36c89afc
    Loom-Build: unknown 31b34ebfd7d4539094523eaa7b56a104bebe5fc0 clean
    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
2026-10-06 chore: resync installed Loom surfaces
    <!-- loom:provenance v1 build=unknown 7bed309263b3785eae46a9cbc53b3b24a52b10d2 clean prompts=none sweep=none story=none trace=843adbd5eac450c43d3a2c43da1bf729 host=robb-studio base=838a0c4c440b67a40ad5a306bfc5dedf43dacd13 run=loom-run/v1:timer:robb-studio/fleet-resync:f83d5ba4-81f7-479a-9768-6af33d4cc825 installs=0.19.783 a9b459e0c2b1916ceb116db33053e7eb0df57e7b -->
    Loom-Trace-Id: 843adbd5eac450c43d3a2c43da1bf729
    Loom-Build: unknown 7bed309263b3785eae46a9cbc53b3b24a52b10d2 clean
    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
2026-10-06 chore: resync installed Loom surfaces
    <!-- loom:provenance v1 build=unknown 07bc40ba9ab0f7dfe7cd0990377b7ac07a52d220 clean prompts=none sweep=none story=none trace=563f186108419cf03cef002a62c3b201 host=loom-worker-2 base=8de9084e12ddf09137f819948c534fd2fbf67748 run=loom-run/v1:timer:loom-worker-2/fleet-resync:944beccd157a4197b81feafdd19f443e installs=0.19.785 2f0a9dbb4f06053f747b8a5615a3519f8e30b527 -->
    Loom-Trace-Id: 563f186108419cf03cef002a62c3b201
    Loom-Build: unknown 07bc40ba9ab0f7dfe7cd0990377b7ac07a52d220 clean
    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
2026-10-06 chore: resync installed Loom surfaces
    <!-- loom:provenance v1 build=unknown 31b34ebfd7d4539094523eaa7b56a104bebe5fc0 clean prompts=none sweep=none story=none trace=ea6600df41a4b420b6d8e967f839ccfd host=loom-worker-3 base=2724ed67e8ea653a60d422f9adf4fc01449357ae run=loom-run/v1:timer:loom-worker-3/fleet-resync:c80415b48fd5404bbd599c4f6cc8a448 installs=0.19.793 7ceff96944c39d33e3c2f1141ca650c2c4c05679 -->
    Loom-Trace-Id: ea6600df41a4b420b6d8e967f839ccfd
    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
2026-10-06 chore: resync installed Loom surfaces
    <!-- loom:provenance v1 build=unknown 596a53e525683919daae1b43e6babe9bf847a02f clean prompts=none sweep=none story=none trace=b9c0cb42a5a72ecc21726229c957ef1f host=loom-worker-2 base=d062917555f298244197c04c846f57b459b5b398 run=loom-run/v1:timer:loom-worker-2/fleet-resync:21d578f5cc0b4b7ba5f10759f5f30ae8 installs=0.19.801 524bdb33cb26c8355454d7550413c89e72c06fae -->
    Loom-Trace-Id: b9c0cb42a5a72ecc21726229c957ef1f
    Loom-Build: unknown 596a53e525683919daae1b43e6babe9bf847a02f clean
    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
2026-10-06 chore: resync installed Loom surfaces
    <!-- loom:provenance v1 build=unknown 40b591a33adb895d4f46977105f9b264d8a2599b clean prompts=none sweep=none story=none trace=e41c725fe0c176312eb412bc69fe5b01 host=robb-studio base=66b2d2c929e42358bd559c0be242d3018b2b8c7c run=loom-run/v1:timer:robb-studio/fleet-resync:37d704dd-4dfd-4341-adb4-6551637ad147 installs=0.19.802 72ce1f7385747dd773d1644408ec22072b8a5d20 -->
    Loom-Trace-Id: e41c725fe0c176312eb412bc69fe5b01
    Loom-Build: unknown 40b591a33adb895d4f46977105f9b264d8a2599b clean
    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
2026-10-06 chore: resync installed Loom surfaces
    <!-- loom:provenance v1 build=unknown 31b34ebfd7d4539094523eaa7b56a104bebe5fc0 clean prompts=none sweep=none story=none trace=5ad0480c4b21b80f9c852c448319e7a1 host=loom-worker-3 base=c14364e27eea90dc1eba4569fcb28b705b9a0b2c run=loom-run/v1:timer:loom-worker-3/fleet-resync:48e836f11f9547ddb96de5aa0d072a05 installs=0.19.810 933f828e779602e492e4e157812988a4b8128111 -->
    Loom-Trace-Id: 5ad0480c4b21b80f9c852c448319e7a1
    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
2026-10-07 chore: resync installed Loom surfaces
    <!-- loom:provenance v1 build=unknown f71cf25de9e75bae6060da4a599df8fbabe75890 clean prompts=none sweep=none story=none trace=64943e35511da4833bbd385cf288be8a host=loom-worker-2 base=d062641da4717169035ca4dd3092d6348976d31f run=loom-run/v1:timer:loom-worker-2/fleet-resync:d69eb1b87d4849ae810a145b1b667d2f installs=0.19.822 1c6969ea8726c800a353c236d9f23456a5706f1a -->
    Loom-Trace-Id: 64943e35511da4833bbd385cf288be8a
    Loom-Build: unknown f71cf25de9e75bae6060da4a599df8fbabe75890 clean
    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
2026-10-07 chore: resync installed Loom surfaces
    <!-- loom:provenance v1 build=unknown 31b34ebfd7d4539094523eaa7b56a104bebe5fc0 clean prompts=none sweep=none story=none trace=cb192cb8f72cf6f2711f73f7ee12bebc host=loom-worker-3 base=e199a9b8d710a87a5b922ce01d07164f3935c3a6 run=loom-run/v1:timer:loom-worker-3/fleet-resync:c1e385c3607e43ad8bed9c7d29811c66 installs=0.19.830 a966f7b89b714704fa1225b96e2dbee50480a4c6 -->
    Loom-Trace-Id: cb192cb8f72cf6f2711f73f7ee12bebc
    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
2026-10-07 chore: resync installed Loom surfaces
    <!-- loom:provenance v1 build=unknown 8abdd34fddc879aff407380278baa713eca6b758 clean prompts=none sweep=none story=none trace=ea945665dad5ccb3880de51c4448e8b9 host=robb-pro base=fe4a4ee204b7f4aa0f4fe6584ed6300082edb547 run=loom-run/v1:timer:robb-pro/fleet-resync:1466e397-b80c-46ea-a42c-26a7fbd4e00e installs=0.19.831 61814c9c1912925cdff7418842ff3ea17cd56fe4 -->
    Loom-Trace-Id: ea945665dad5ccb3880de51c4448e8b9
    Loom-Build: unknown 8abdd34fddc879aff407380278baa713eca6b758 clean
    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
2026-10-07 chore: resync installed Loom surfaces
    <!-- loom:provenance v1 build=unknown 628be5bb140bcff803d159201bd61e1b868901b0 clean prompts=none sweep=none story=none trace=093df1dc315c5e78dcccfca9d699d5f5 host=loom-worker-2 base=d2565c452a926e4b348e6c844375e1bdb42a47d7 run=loom-run/v1:timer:loom-worker-2/fleet-resync:0b0ea5e184c0429a9c431fcca6c791ad installs=0.19.832 1a0fc15974bf0575a9155fb8276f7529fc813542 -->
    Loom-Trace-Id: 093df1dc315c5e78dcccfca9d699d5f5
    Loom-Build: unknown 628be5bb140bcff803d159201bd61e1b868901b0 clean
    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
2026-10-07 chore: resync installed Loom surfaces
    <!-- loom:provenance v1 build=unknown 069e3b45d86c08f0d60c8fc2b0096de441e99bdc clean prompts=none sweep=none story=none trace=b1ba9d6b2b581e47827d9c099f717b04 host=loom-worker-1 base=37baf932f612464c5dd5ff647dc3c2d12a145554 run=loom-run/v1:timer:loom-worker-1/fleet-resync:aada8278bd4843bcaecce69fdf91251e installs=0.19.837 9504f1e9b05e05ce908dd5cffad2aae723621f63 -->
    Loom-Trace-Id: b1ba9d6b2b581e47827d9c099f717b04
    Loom-Build: unknown 069e3b45d86c08f0d60c8fc2b0096de441e99bdc clean
    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
2026-10-07 chore: resync installed Loom surfaces
    <!-- loom:provenance v1 build=unknown 31b34ebfd7d4539094523eaa7b56a104bebe5fc0 clean prompts=none sweep=none story=none trace=ef030e94bce76f728497f5927960865f host=loom-worker-3 base=4980f7f93d05a1af734f34def759a4848aab6d73 run=loom-run/v1:timer:loom-worker-3/fleet-resync:28ba4284bfa446c888b501714eda0509 installs=0.19.840 59b533a2a1ed5e186fbf8446b5acbe42d7231854 -->
    Loom-Trace-Id: ef030e94bce76f728497f5927960865f
    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
2026-10-07 chore: resync installed Loom surfaces
    <!-- loom:provenance v1 build=unknown bc59c70c3412a87b31a0dbe65cd6abf968744328 clean prompts=none sweep=none story=none trace=766033e4e881801f24971d664c490ea3 host=robb-studio base=0a953b7f8a63a03d0df59f26c85ba77a9d926951 run=loom-run/v1:timer:robb-studio/fleet-resync:6b3b079a-890e-4a79-9c3a-0b4bb33ff7c4 installs=0.19.840 59b533a2a1ed5e186fbf8446b5acbe42d7231854 -->
    Loom-Trace-Id: 766033e4e881801f24971d664c490ea3
    Loom-Build: unknown bc59c70c3412a87b31a0dbe65cd6abf968744328 clean
    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
2026-10-07 chore: resync installed Loom surfaces
    <!-- loom:provenance v1 build=unknown a068938e7a6c13759bcb3943e408273a3d352257 clean prompts=none sweep=none story=none trace=76bec863c8f6aff2d49b3aa2be128619 host=robb-pro base=f66e54f5767f9688537177cea9a74705a6917c6d run=loom-run/v1:timer:robb-pro/fleet-resync:d9927fc6-ee80-4b6a-ba2b-f13576bd5f9b installs=0.19.846 837b14d7440b89ae8a2cec6d045483ac33659af5 -->
    Loom-Trace-Id: 76bec863c8f6aff2d49b3aa2be128619
    Loom-Build: unknown a068938e7a6c13759bcb3943e408273a3d352257 clean
    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
2026-10-07 chore: resync installed Loom surfaces
    <!-- loom:provenance v1 build=unknown 628be5bb140bcff803d159201bd61e1b868901b0 clean prompts=none sweep=none story=none trace=5a6f676b4652a1a750bbce1386c68d06 host=loom-worker-2 base=492384d62b3208a73b10bf52bee73fa0321d7ec4 run=loom-run/v1:timer:loom-worker-2/fleet-resync:bd416e653be04ef4b13353430625e379 installs=0.19.850 3bb4bfc90603b6ad65cabca9b3eb42a59f1a9d3a -->
    Loom-Trace-Id: 5a6f676b4652a1a750bbce1386c68d06
    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
2026-10-07 chore: resync installed Loom surfaces
    <!-- loom:provenance v1 build=unknown 40215645df8a13508180b248b44244dc488bb078 clean prompts=none sweep=none story=none trace=29fde30615e6e47f39b41aa314c2c883 host=loom-worker-1 base=c91973dea5a2a8b02aec099df1529d5b2c7e7584 run=loom-run/v1:timer:loom-worker-1/fleet-resync:d1fbedfcc7824ae59233c0ea94dc4650 installs=0.19.853 2889d5ed585b4da0935543cb916381cc03b19746 -->
    Loom-Trace-Id: 29fde30615e6e47f39b41aa314c2c883
    Loom-Build: unknown 40215645df8a13508180b248b44244dc488bb078 clean
    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
2026-10-07 chore: resync installed Loom surfaces
    <!-- loom:provenance v1 build=unknown 31b34ebfd7d4539094523eaa7b56a104bebe5fc0 clean prompts=none sweep=none story=none trace=cdf49c615da3f5ce46e9fcda1a24f787 host=loom-worker-3 base=f0601b21c40d412705429aa296dc7c287fff152f run=loom-run/v1:timer:loom-worker-3/fleet-resync:cab31e05b8a24df09bc88f53ee3fb501 installs=0.19.857 7a0b529e6f57a79713f6924bf58d8392ff404259 -->
    Loom-Trace-Id: cdf49c615da3f5ce46e9fcda1a24f787
    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
2026-10-07 chore: resync installed Loom surfaces
    <!-- loom:provenance v1 build=unknown 4b44e7c5db0de1d2b5927de7de229120d546aad3 clean prompts=none sweep=none story=none trace=dfa656ee3483a044378501f49d36f812 host=robb-studio base=fd64c69d3d8116d6d43842208547b17cd0dd9ada run=loom-run/v1:timer:robb-studio/fleet-resync:d80d6bc0-eb68-4a07-8226-2d947d328b3a installs=0.19.859 0aefebd79aba8ab33470f1af4b96847fc794bd0d -->
    Loom-Trace-Id: dfa656ee3483a044378501f49d36f812
    Loom-Build: unknown 4b44e7c5db0de1d2b5927de7de229120d546aad3 clean
    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
2026-10-07 chore: resync installed Loom surfaces
    <!-- loom:provenance v1 build=unknown b591c8cf436f0d4aa5870a9bc7cd5f7194e0e778 dirty prompts=none sweep=none story=none trace=6eca4b0c47205457aae7a3d721c17f17 host=robb-pro base=e7ee555dd1bc27f63c3f5bc03619286cc5577137 run=loom-run/v1:timer:robb-pro/fleet-resync:64af20b3-58cb-47f2-b770-117197cb41e9 installs=0.19.864 128a7eba2bb5f7bcf8891ba284b14cb7ebf8dd3d -->
    Loom-Trace-Id: 6eca4b0c47205457aae7a3d721c17f17
    Loom-Build: unknown b591c8cf436f0d4aa5870a9bc7cd5f7194e0e778 dirty
    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
2026-10-07 chore: resync installed Loom surfaces
    <!-- loom:provenance v1 build=unknown b551219fd5b8347113c0cbc79ea416e81c39fa9d clean prompts=none sweep=none story=none trace=5ac7c8c62dad54841e21dd94f0920de3 host=loom-worker-2 base=d1b6357a68408e7010b98850b2dcb21c9388fc38 run=loom-run/v1:timer:loom-worker-2/fleet-resync:d10fb10789e94930ab1af368c15a8f8b installs=0.19.864 128a7eba2bb5f7bcf8891ba284b14cb7ebf8dd3d -->
    Loom-Trace-Id: 5ac7c8c62dad54841e21dd94f0920de3
    Loom-Build: unknown b551219fd5b8347113c0cbc79ea416e81c39fa9d clean
    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
2026-10-07 chore: resync installed Loom surfaces
    <!-- loom:provenance v1 build=unknown 90fbd167e4e376894396e651676cf58fc9aa223a clean prompts=none sweep=none story=none trace=196876656e912171b28029ceca9f772d host=loom-worker-1 base=2efa660920845a9795d2597251b9a1331c0eebe6 run=loom-run/v1:timer:loom-worker-1/fleet-resync:7b46720ff3a84a8184f2f2b3bc039260 installs=0.19.868 ee904e1c151bc9cf15b0eb55dfe9d57ad6136cff -->
    Loom-Trace-Id: 196876656e912171b28029ceca9f772d
    Loom-Build: unknown 90fbd167e4e376894396e651676cf58fc9aa223a clean
    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
2026-10-08 chore: resync installed Loom surfaces
    <!-- loom:provenance v1 build=unknown 5a3df331a0612dee585ef905015af01d08e3467f clean prompts=none sweep=none story=none trace=5690fa95febe608e500a46dde8a6ee92 host=loom-worker-2 base=6b389811077fae96c480472d870c45c3dbd13d17 run=loom-run/v1:timer:loom-worker-2/fleet-resync:5c9c35d59b704bff9d8bf096ee7ba7be installs=0.19.876 b16d54e63fbbec4d7f15f13c1f43a5e5b38145ce -->
    Loom-Trace-Id: 5690fa95febe608e500a46dde8a6ee92
    Loom-Build: unknown 5a3df331a0612dee585ef905015af01d08e3467f clean
    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
2026-10-08 chore: resync installed Loom surfaces
    <!-- loom:provenance v1 build=unknown 134eb3ff06c1a86f49a911c6c17464f55e719736 clean prompts=none sweep=none story=none trace=c7df110d490314040dcd1347b2481843 host=loom-worker-1 base=a13bf0cf22eeaa99c5af25c56ff2d281bc0f1247 run=loom-run/v1:timer:loom-worker-1/fleet-resync:53d0cec2cd61484eb9a0f8fb1f24ac5e installs=0.19.879 c15619905bdd8a24506c3853f45490d26e8f1cad -->
    Loom-Trace-Id: c7df110d490314040dcd1347b2481843
    Loom-Build: unknown 134eb3ff06c1a86f49a911c6c17464f55e719736 clean
    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
2026-10-08 chore: resync installed Loom surfaces
    <!-- loom:provenance v1 build=unknown 8f86de23319d8f6cf049557dcc9cf2e321211d9d clean prompts=none sweep=none story=none trace=17de45f778fbfd714af8afad02c96375 host=loom-worker-3 base=c1abc79b55f791740cdc001fd7447df9bced6eb9 run=loom-run/v1:timer:loom-worker-3/fleet-resync:9e3e5d4a08824de3b7bc02940be2a0da installs=0.19.882 c9f85af3d967986cdd7a3f27e088a16f88712b05 -->
    Loom-Trace-Id: 17de45f778fbfd714af8afad02c96375
    Loom-Build: unknown 8f86de23319d8f6cf049557dcc9cf2e321211d9d clean
    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
2026-10-08 chore: resync installed Loom surfaces
    <!-- loom:provenance v1 build=unknown 4a5fb2b6276e17ff26ee1382acfe2ea7360ebea5 clean prompts=none sweep=none story=none trace=67857e1b7189785825a2dfc70921cf85 host=loom-worker-2 base=0d696edaacdd0a7034a0fce9d239bca333f0aff0 run=loom-run/v1:timer:loom-worker-2/fleet-resync:dd6a5f3dceff4d8d8602a07a1dc89c95 installs=0.19.892 ce93e8a919d79a6f027bab268846a52084f9d94e -->
    Loom-Trace-Id: 67857e1b7189785825a2dfc70921cf85
    Loom-Build: unknown 4a5fb2b6276e17ff26ee1382acfe2ea7360ebea5 clean
    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
2026-10-08 chore: resync installed Loom surfaces
    <!-- loom:provenance v1 build=unknown b591c8cf436f0d4aa5870a9bc7cd5f7194e0e778 dirty prompts=none sweep=none story=none trace=28e7ca5fdb768489aa38bf002407d5a5 host=robb-pro base=7fbe3c388cb404581fef93f92b5b0620fd8a3556 run=loom-run/v1:timer:robb-pro/fleet-resync:eb5f838e-a774-4e20-8102-c37ee3ff31ca installs=0.19.895 9b30d293bcba1e79d49cabfc1c5bb5b6f4c0dc77 -->
    Loom-Trace-Id: 28e7ca5fdb768489aa38bf002407d5a5
    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
2026-10-08 chore: resync installed Loom surfaces
    <!-- loom:provenance v1 build=unknown 5684fc8c8ac418d95ad66a002d001eaea1283c9a clean prompts=none sweep=none story=none trace=c864acd3b9a5dbb419fddd8bd2a6283b host=loom-worker-3 base=8db1bd7904df3413c94de461e7fc11aab5b3eabb run=loom-run/v1:timer:loom-worker-3/fleet-resync:4771e7c630c34445b7f28539669d76e3 installs=0.19.898 3d55b9a1669c132d130d98f10a292c1325322c30 -->
    Loom-Trace-Id: c864acd3b9a5dbb419fddd8bd2a6283b
    Loom-Build: unknown 5684fc8c8ac418d95ad66a002d001eaea1283c9a clean
    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
2026-10-08 chore: resync installed Loom surfaces
    <!-- loom:provenance v1 build=unknown 04a1189116c7320def7d9ce357d2d9268405ae92 clean prompts=none sweep=none story=none trace=8e55b27fc60ffb045554bd413ad8f3c8 host=robb-pro base=da49b75b58a3b01b2bbc60fd9b387f0c76a8cfd2 run=loom-run/v1:timer:robb-pro/fleet-resync:83b69005-7c5b-44b3-96f8-33f07bf82f4b installs=0.19.917 d3c1ea3a4c81e01ce5487dc3e4bbdd86534e677e -->
    Loom-Trace-Id: 8e55b27fc60ffb045554bd413ad8f3c8
    Loom-Build: unknown 04a1189116c7320def7d9ce357d2d9268405ae92 clean
    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
2026-10-08 Analog: P-skew the differential receiver's first buffer inverter; add klt sim grid backend
    Moves the buffer trip point up to the OTA's balanced output level so the
    2.5 V common-mode point resolves (#97). Adds run_corners.py --backend klt so
    full grids go through klt sim (fleet batch) rather than local ngspice.
    Loom-Story: 2AMLogic/gf180-usb2-phy#97
    Loom-Trace-Id: a21d4136afc42b3f266d9521584ab750
    Loom-Build: 0.19.868 ee904e1c151bc9cf15b0eb55dfe9d57ad6136cff clean
    [differential_receiver.sch]
2026-10-08 sim: add --klt-runner-version-check; keep the error record from the version-skewed fleet submit
    The first fleet submit failed 45/45 (runner klt 0.5.0 vs client 0.7.0); the
    record documents that infrastructure failure and carries no design result.
    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
2026-10-08 sim: klt backend measures via .meas cards (older fleet runner has no measurements[].expr)
    The second fleet submit failed 45/45 for that reason; its error record is kept.
    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
2026-10-08 Analog: differential_receiver resolves 200 mV over 0.8-2.5 V common mode (45/45)
    New sim record 20261008-193113-2e9f63e (fleet batch via klt sim) supersedes
    20260817-203852-5a963e7; spec-coverage, challenge-5 row E, design/README updated.
    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
    [differential_receiver.sch]
2026-10-08 records: re-pin analog-layout provenance after differential_receiver netlist resize (layout not re-verified)
    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
2026-10-08 Cite multi-corner klt sta envelope for T1 item 5.digital (#92)
    Mint post-layout-pvt record 20261008-200000-8139bb6 (pdk.corners, three
    corners, routed DEF unchanged), add 5.digital manifest citation, regenerate
    signoff report, document corner scope.
    Loom-Story: 2AMLogic/gf180-usb2-phy#92
    Loom-Trace-Id: 0da242e0e390749eff681d9ed4848693
    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
2026-10-08 Record klayout-tools#2879 as friction for the sta path normalization (#92)
    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
2026-10-08 Disclose incomplete SPEF annotation in post-layout-pvt record (PR #104 review)
    Add annotation diagnostic replay (7 unannotated drivers are clkload dummies;
    307 partial; report_net wire cap stays 0 after read_spef). Withhold the
    extracted-parasitic timing claim; the emitted envelope is unchanged.
2026-10-08 Attach the extracted parasitics for 5.digital STA; correct the annotation claim (#92)
    The PR #104 review was right. The cited envelope's spef_annotation
    reports delay_changed=false, 7 unannotated and 307 partially unannotated
    drivers, and the probe confirms it: paths are byte-identical before and
    after read_spef, and wire capacitance is 0. The SPEF extracted without
    --def-pins declares every DEF net as a port and names each net's hub
    node with the bare net name. OpenSTA cannot resolve those nodes
    (STA-1656) and drops every RC element. So record 20261008-200000-8139bb6
    (and 20260922-042422-9ec2304) recorded wire-parasitic-free timing, not
    post-layout timing.
    - Re-extract with the pinned klt'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
2026-10-08 Characterize RX bit sampling against host/device clock offset (#108)
    Independent-host cocotb sweep (864 cases) with a recorded failing matrix and
    DR-0003 proposing options; no RTL or spec change.
    Loom-Story: 2AMLogic/gf180-usb2-phy#108
    Loom-Trace-Id: 07d106d61d79a9adac825a11a1b88fc4
    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
    [test_usb_rx_clock_tolerance.py]
2026-10-08 chore: resync installed Loom surfaces
    <!-- loom:provenance v1 build=unknown d2a55ce217b3ad1793611a2c54946676bb55b512 clean prompts=none sweep=none story=none trace=459637e4e8503593bdf58360865a7524 host=robb-pro base=1245ceff4195e0411565d968defaddd3a49ec605 run=loom-run/v1:timer:robb-pro/fleet-resync:95b3cf92-9cd9-4c36-8bbd-bdcace7c3874 installs=0.19.935 d347079cd0bad2db2c11ee4f0b760f04b2601d21 -->
    Loom-Trace-Id: 459637e4e8503593bdf58360865a7524
    Loom-Build: unknown d2a55ce217b3ad1793611a2c54946676bb55b512 clean
    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
2026-10-08 Attempt SDF-annotated gate-level regression for T1 item 7.digital; record the blocked result (#93)
    Zero-delay replay of the full usb_utmi_phy suite on the routed netlist passes
    10/10; klt rejects SDF annotation (edge-qualified XOR/XNOR/MUX modpaths vs
    OpenSTA write_sdf IOPATH), so 7.digital stays unmet. Layout untouched.
    Testbench no longer reads RTL-internal tx_state; adds clock override hook.
    Re-pins utmi-framing-functional via a superseding record.
    Loom-Story: 2AMLogic/gf180-usb2-phy#93
    Loom-Trace-Id: 1ed40a879bf6623ec8495eba6ad84468
    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
    [usb_utmi_phy_route_ss_125C_1v62.sdf, usb_utmi_phy_route_tt_025C_1v80.sdf]
2026-10-08 Address PR #111 review: merge #110, fix chain, re-run framing suite, commit SDF transcripts (#93)
    - Merged main (afadb58, previous commit); resolved verification/README.md by keeping
    both the #108 clock-tolerance and the #93 gate-level sections, and fixed
    the README's pointer to the #108 record (213500 -> 210900, the real ID).
    - Replaced the never-merged utmi-framing-functional record 214500-2875d57
    with 20261008-212139-afadb58, re-run on the rebased tree with the pinned
    klt 0.5.0+ge8ca621a6961: 29/29 pass, all 15 input hashes unchanged by #110,
    responses identical apart from wall-clock times. It still supersedes
    20260922-004125-0446e4b: main's 20261008-210900-2875d57 has
    super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
2026-10-08 docs+lint: DR-0004 digital/analog pin contract and structural checker (#109)
    Loom-Story: 2AMLogic/gf180-usb2-phy#109
    Loom-Trace-Id: b697c0267e940fcc850096abe00e79cb
    Loom-Build: 0.19.929 e0381fd31734743649019281f22b12223f853f41 clean
2026-10-08 Reconcile status docs with superseding verification evidence (#120)
    Loom-Story: 2AMLogic/gf180-usb2-phy#120
    Loom-Trace-Id: 09240a18f51b6d7890c903e86213376d
    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
2026-10-08 Add top-level RX stuffing-error propagation and recovery tests (#118)
    Loom-Story: 2AMLogic/gf180-usb2-phy#118
    Loom-Trace-Id: 7417d133892e39904a896fb65d596c2d
    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
    [test_usb_utmi_phy.py]
2026-10-09 chore: resync installed Loom surfaces
    <!-- loom:provenance v1 build=unknown 05dba463c5b293d38f0ca071725983862498b3f3 clean prompts=none sweep=none story=none trace=14298316053024bcf5120bff695771ab host=robb-pro base=9b807cee34bc8ea11692f3887ee284d507fb30b0 run=loom-run/v1:timer:robb-pro/fleet-resync:2f384483-6d77-4ba2-9888-aa1e4b5be36c installs=0.19.953 b93d7a955d63411cb4c94b986fd5138d27dedb0f -->
    Loom-Trace-Id: 14298316053024bcf5120bff695771ab
    Loom-Build: unknown 05dba463c5b293d38f0ca071725983862498b3f3 clean
    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
2026-10-09 feat(setup): add --tool-light mode to scripts/setup-env.sh
    Provisions the .venv with pinned klt and cocotb==2.0.1 without volare or
    the PDK; requires iverilog/vvp. Adds stub-based shell regression test and docs.
    Loom-Story: 2AMLogic/gf180-usb2-phy#117
    Loom-Trace-Id: 58f051bf915c5711ce04de06805096fb
    Loom-Build: 0.19.950 72047016af9d66c08f900bb94c642a66dfd75fc5 clean
2026-10-09 chore: resync installed Loom surfaces
    <!-- loom:provenance v1 build=unknown 7f06b288b150f2fe0a4b24c331a9b3ec093d709d clean prompts=none sweep=none story=none trace=a90c217ff3a3bd9e3a30282b8cadc24d host=robb-pro base=542173d10fda1d1d925c4ed75716b51f68f70fd8 run=loom-run/v1:timer:robb-pro/fleet-resync:6e5ec9f3-d6ef-4953-80f7-c93035e2d359 installs=0.19.966 9bed656320e53ba6c64305daa60613431a7ed02d -->
    Loom-Trace-Id: a90c217ff3a3bd9e3a30282b8cadc24d
    Loom-Build: unknown 7f06b288b150f2fe0a4b24c331a9b3ec093d709d clean
    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
2026-10-09 verification: structural RX synchronization experiment (#123)
    Verification-only experiment; no production RTL, spec, pin-contract or
    vendored-module change. A test-only wrapper
    (verification/tb_usb_rx_sync_candidate.v) puts a candidate two-flop chain
    on each of rxdp/rxdm (both stages reset synchronously to J on rst_n=0 or
    UTMI Reset=1, plus one-clock capture-delay injection per line) in front
    of the unchanged usb_utmi_phy, and compares it with the baseline using
    the existing independent-host stimulus and exact-byte scoreboard
    (imported from test_usb_rx_clock_tolerance.py).
    Asserted controls: skew polarity, scoreboard negative controls on real
    RxError-low runs, reset-to-J from both sources,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
    [candidate-source-tb_usb_rx_sync_candidate.v, rx_sync_candidate_summary.py, tb_usb_rx_sync_candidate.v, test_usb_rx_sync_candidate.py]
2026-10-09 fix(rtl): make UTMI Reset synchronous on the TX path; add TX reset regression (#130)
    Add test_tx_utmi_reset_aborts_and_recovers to the top-level cocotb suite:
    36 parameterized cases asserting UTMI Reset at nine model-located TX wire
    phases (SYNC, SYNC's last bit, payload bit, inserted stuff bit, trailing
    stuff flush, hold clock, each EOP-tail cell), held 1 or 3 clocks, TxValid
    low or held high, then checking the abort happens on the sampling edge,
    the line idles at J with TxReady high, and the next packet is bit-exact
    against the independent model.
    The regression exposed a defect: the vendored stuffer/encoder took the
    combined int_rst_n on their asynchronous reset port, so raising Reset
    mid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
    [test_usb_utmi_phy.py, usb_utmi_phy.v]
2026-10-09 fix(sim): require complete PVT evidence before fixed-trim PASS (#136)
    analyze_fixed_trim.py now derives the required corner matrix from the
    experiment's tb.json via the harness's own corner/supply expansion
    (unioned with the ratified 5 x 9 = 45-corner floor), and validates every
    required corner's 32-code table (no table, truncated, extra rows,
    nonfinite, non-positive) before computing any electrical verdict.
    Missing, unexpected, or malformed evidence is listed per corner and the
    script exits 2 with "Overall: INCOMPLETE EVIDENCE" instead of PASS or an
    IndexError. Calibration point and +/-5 % semantics are unchanged; both
    committed records still analyze as 45/45 PASS.
    Tests: full-matrix fixtu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
2026-10-09 chore: resync installed Loom surfaces
    <!-- loom:provenance v1 build=unknown 30c7a7ee2f74a6a2b5bb0f19fd9f049ec8ae8b5c clean prompts=none sweep=none story=none trace=7bc5ba399ff199d049d83d711920a157 host=robb-pro base=9982b44f7ce2ff1ec4920c4ce29175419dd653b1 run=loom-run/v1:timer:robb-pro/fleet-resync:8e237160-c4d0-4ce3-85ac-c96aff5cf221 installs=0.19.982 2bc4cba624b9053535663441e6f0daf08a7acf2e -->
    Loom-Trace-Id: 7bc5ba399ff199d049d83d711920a157
    Loom-Build: unknown 30c7a7ee2f74a6a2b5bb0f19fd9f049ec8ae8b5c clean
    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
2026-10-09 docs(layout): re-measure resized differential_receiver (DRC clean, LVS mismatch) (#103)
    Loom-Story: 2AMLogic/gf180-usb2-phy#103
    Loom-Trace-Id: 948125b1cbb34427d3690a44c7b6f85a
    Loom-Build: 0.19.972 113c7f31d7d16f75d30c470023e0b65b29b1fe94 clean
2026-10-09 fix(records): satisfy Run configuration lint; qualify analog GDS/LVS status (#103)
    - Record 20261009-203500-7a8e831: label now reads `- **Run configuration**:`
    with the pinned-environment text moved into the bullet body, so
    verification/check_records.py recognizes the field. Results unchanged.
    - layout/README.md, sim/spec-coverage.md, docs/characterization-report.md:
    qualify "no analog GDS / no analog LVS" -- the receiver evidence GDS and a
    failing LVS mismatch are now committed; no LVS match is claimed.
    Loom-Build: 0.19.972 113c7f31d7d16f75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
2026-10-10 chore: resync installed Loom surfaces
    <!-- loom:provenance v1 build=unknown 03c1cb521a10d5101bd8aa2c52a47cebfb0e795b clean prompts=none sweep=none story=none trace=09ccab293fce5c1a7b4aa907c7197bec host=robb-studio base=5b9551c846dda7d35f672d025050cb3767e5f5b1 run=loom-run/v1:timer:robb-studio/fleet-resync:ed2be6c5-20fe-4228-a206-940d35a4858f installs=0.19.996 0d2be7e9ae05753e2c9232a83b7399d45de5396e -->
    Loom-Trace-Id: 09ccab293fce5c1a7b4aa907c7197bec
    Loom-Build: unknown 03c1cb521a10d5101bd8aa2c52a47cebfb0e795b clean
    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
2026-10-10 chore: resync installed Loom surfaces
    <!-- loom:provenance v1 build=unknown a7d2b01d8eb7d09e597a4638e5cb3cdd8bab9156 clean prompts=none sweep=none story=none trace=35c1337ee84607e87ba2038523d63198 host=robb-pro base=5b9551c846dda7d35f672d025050cb3767e5f5b1 run=loom-run/v1:timer:robb-pro/fleet-resync:6bf32a81-6c4a-48c5-a51e-1ad65c6bedfd installs=0.19.999 20513e3064fa3a7c4b3f1c641d97a00446e9ba78 -->
    Loom-Trace-Id: 35c1337ee84607e87ba2038523d63198
    Loom-Build: unknown a7d2b01d8eb7d09e597a4638e5cb3cdd8bab9156 clean
    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
2026-10-10 feat(rtl): add pu_en output = TermSelect & rst_n (#112)
    Combinational D+ pull-up enable per DR-0004 decision 1: not registered,
    not gated by UTMI Reset or SuspendM. Adds a cocotb test over all
    rst_n/TermSelect/Reset/SuspendM combinations plus no-registering checks,
    flips the PU_EN pin-table row to current (record stays Proposed), and
    repoints the pin-contract self-test's planned-landing case at TXOE.
    New append-only records supersede the stale live ones: utmi-framing
    (72/72), RX carry-forwards (byte-identical artifacts), synthesis-smoke,
    and post-layout-functional (committed netlist predates the port; 36/53).
    Loom-Story: 2AMLogic/gf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
    [test_usb_utmi_phy.py, usb_utmi_phy.v]
2026-10-10 feat(rtl): add txoe driver-enable output to usb_utmi_phy (#113)
    txoe = (tx_state != TX_IDLE): high from the first SYNC bit through the
    final EOP J bit, low in idle and while receiving, so the driver can be
    high-Z. New RTL-only cocotb module test_usb_utmi_txoe.py covers idle/reset,
    RX, SYNC rise, data, TX_FLUSH, the SE0/SE0/J tail, fall after J, raw mode
    and back-to-back packets (two pulses, one-clock-minimum low gap). Kept out
    of test_usb_utmi_phy.py because that file is replayed against the committed
    routed netlist, which has no txoe port.
    Pin contract (0004): TXOE row planned #113-114 -> planned-ana #114.
    New append-only records refresh the stale RTL hashes (framing, two RX
    carry-forwards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
    [test_usb_utmi_txoe.py, usb_utmi_phy.v]
2026-10-10 docs: refresh work log and plan after pin-contract RTL merges
2026-10-10 fix(verification): mint current-source records superseding stale #112/#113 carry-forwards (#147)
    Parallel #112/#113 branches each pinned a branch-local usb_utmi_phy.v hash;
    on merged main all eight were live and stale. Re-run the suites on merged
    source and add accurate records superseding them (history untouched). Also
    repoint the pin-contract planned-landing test from txoe (now landed) to trim.
    Loom-Story: 2AMLogic/gf180-usb2-phy#147
    Loom-Trace-Id: 29481d3edd0e76aa388f8f6751714342
    Loom-Build: 0.19.1009 8889f7bd1eccfb4bc8239e7f5669b65f9815c30e clean
2026-10-10 feat(analog): add TXOE high-Z enable to differential_driver (#114)
    Gated NAND/NOR predrivers turn both output transistors off on both pads
    when TXOE=0. Adds disabled-leakage testbench and klt_measure mappings for
    the driver experiments; enabled callers tie TXOE high.
    Loom-Story: 2AMLogic/gf180-usb2-phy#114
    Loom-Trace-Id: ce2b2d3c9e4e0e540b5f1411176e71ea
    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
    [differential_driver.sch]
2026-10-10 sim: spell klt body's design.ngspice include relative to $PDK_ROOT so the batch fleet resolves it (#114)
    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
2026-10-10 docs: TXOE pin current in DR-0004, dated design note; retain failed batch attempt record (#114)
    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
2026-10-10 verification: provenance-refresh analog-layout record for the #114 driver netlist; repoint pin-contract uncovered-pin test
    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
2026-10-10 docs(design): state TXOE evidence status honestly (batch fleet unavailable) (#114)
    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
2026-10-10 chore: resync installed Loom surfaces
    <!-- loom:provenance v1 build=unknown c156f673e072832aaacb4cd1ec65b742e7f45867 clean prompts=none sweep=none story=none trace=9de99c124c651049199abe9a75070dc7 host=robb-pro base=562de3ba5a1f77c89f49e6e7d92f08f7250b0f14 run=loom-run/v1:timer:robb-pro/fleet-resync:f790885c-7154-4b3d-acd9-71fd537cd20b installs=0.19.1010 d1d5fcecb79550fe39658555a4419f98cec060fb -->
    Loom-Trace-Id: 9de99c124c651049199abe9a75070dc7
    Loom-Build: unknown c156f673e072832aaacb4cd1ec65b742e7f45867 clean
    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
2026-10-10 chore: resync installed Loom surfaces
    <!-- loom:provenance v1 build=unknown 52f79668bb5f93c1828b7f1ea4f7013b917b847b clean prompts=none sweep=none story=none trace=7057f3175071f1f6e34b354fab40a0ce host=robb-studio base=21583fb6cc8f5504646d227197441e97a408ad68 run=loom-run/v1:timer:robb-studio/fleet-resync:d8918779-1625-4202-b151-71f64465e8cd installs=0.19.1010 d1d5fcecb79550fe39658555a4419f98cec060fb -->
    Loom-Trace-Id: 7057f3175071f1f6e34b354fab40a0ce
    Loom-Build: unknown 52f79668bb5f93c1828b7f1ea4f7013b917b847b clean
    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
2026-10-10 chore: resync installed Loom surfaces
    <!-- loom:provenance v1 build=unknown 525fe43b7b1b2a0271084bba444c934a1541a8d8 clean prompts=none sweep=none story=none trace=0d4424bd058cf912b74934ec0e7bf37e host=robb-pro base=d42e0a9f48b7cd72e93f945113b2690f3622aa6e run=loom-run/v1:timer:robb-pro/fleet-resync:4812047c-8b9b-4da2-a5dc-13e6f6420a04 installs=0.19.1018 13e54f1cfc513507a7ef84ec6908085638d9c187 -->
    Loom-Trace-Id: 0d4424bd058cf912b74934ec0e7bf37e
    Loom-Build: unknown 525fe43b7b1b2a0271084bba444c934a1541a8d8 clean
    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
2026-10-10 feat(rtl): UTMI Reset reaches the vendored RX transforms synchronously (#132)
    Decide #132 for the synchronous adaptation (spec/decisions/0006, amending
    DR-0002 Decision 5 and DR-0005 Decision 3 for RX; both kept as history).
    - usb_nrzi_decoder / usb_bit_destuffer asynchronous reset now takes rst_n
    only; UTMI Reset reaches no asynchronous reset pin in the block.
    - While int_rst_n is low (rx_clear): the decoder is strobed with J (loads
    the idle-J NRZI reference), one new flop rx_dec_mask hides that strobe
    from the SYNC search and destuffer for the following clock, and the
    destuffer's enable/data_strobe are forced low (zero run, no forwarded
    bit, no error). Vendored bytes unchanged.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
    [test_usb_utmi_phy.py, usb_utmi_phy.v]
2026-10-10 fix(verification): mint #132-source records superseding stale #147 chain heads
    #147's merged-main records pin rtl/usb_utmi_phy.v at its pre-#132 hash, so
    they are live and stale once #132 lands. Add six bookkeeping supersessions
    pointing at the 0522xx #132 records, a fresh klt synthesize smoke on the
    #132 source (330 instances, 56 dffq: +1 = rx_dec_mask), and its bookkeeping
    retirement. History untouched; append-only check passes.
2026-10-10 chore: resync installed Loom surfaces
    <!-- loom:provenance v1 build=unknown 525fe43b7b1b2a0271084bba444c934a1541a8d8 clean prompts=none sweep=none story=none trace=d4059def94f46d8d158946acddd4d602 host=robb-studio base=8562fa65d034a9cc169440cea3a000473f15d1ea run=loom-run/v1:timer:robb-studio/fleet-resync:4a4d1995-968e-44c5-b5fe-804b4d477795 installs=0.19.1019 febfc4335d0554865fadbecba718245cd88c6678 -->
    Loom-Trace-Id: d4059def94f46d8d158946acddd4d602
    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
2026-10-10 feat(rtl): add trim[4:0] integration input to usb_utmi_phy (#115)
    Expose the D+ pull-up trim code as a five-bit pass-through input on the
    digital top per DR-0004 decision 3: integrator-supplied (OTP/fuse/strap),
    static after test, all-zero = unprogrammed default, trim[i] <->
    dplus_pullup.TRIMi. No logic, register or internal default; the packet
    datapath does not read it.
    - DR-0004: TRIM0..TRIM4 rows planned-dig #115 -> current.
    - test_usb_utmi_phy: initialize trim=0 in _reset; new
    test_trim_static_codes_do_not_affect_framing (codes 0/1/16/31, exact
    bytes, framing, RxError/RxActive, TX handshake, trace identical to
    code 0). Absence tolerated only for the legacy routed netlist (no
    pu_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
2026-10-10 fix(verification): mint #115-source records superseding stale chain heads
    Rebased onto main (#132 + #147 merged). Every live record pinning
    rtl/usb_utmi_phy.v or the changed verification sources is stale again.
    Re-ran the affected suites on the rebased tree with the pinned klt/cocotb
    (throwaway venv): UTMI suites 130/130 (phy 106/106 incl. the trim test),
    RX tolerance and sync-candidate matrices byte-identical, zero-delay gate
    replay 85/106 (same 21 expected failures), synthesis smoke unchanged
    (330 instances). Minted 5 run records and 8 bookkeeping supersessions,
    including one retiring this branch's pre-rebase 025244 record.
    History untouched; append-only check passes.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
2026-10-10 chore: resync installed Loom surfaces
    <!-- loom:provenance v1 build=unknown 5d5f41d89eef35adf478b92b96af06c6d86d27a6 clean prompts=none sweep=none story=none trace=05d2a40831b35ba1c48afada00c29519 host=robb-pro base=390d27221456294e98e3b9f854c2a411c3f1631a run=loom-run/v1:timer:robb-pro/fleet-resync:c58bb82e-a213-439d-b829-04234e141de9 installs=0.19.1027 59bb53f01eb99187ce25f22be1a64da5c877d115 -->
    Loom-Trace-Id: 05d2a40831b35ba1c48afada00c29519
    Loom-Build: unknown 5d5f41d89eef35adf478b92b96af06c6d86d27a6 clean
    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
2026-10-10 docs(spec): fix evidence link in decision 0005 (#135)
    Loom-Story: 2AMLogic/gf180-usb2-phy#135
    Loom-Trace-Id: 1288555ec94654b58f1532fd361b9c72
    Loom-Build: 0.19.996 0d2be7e9ae05753e2c9232a83b7399d45de5396e clean
2026-10-10 fix(verification): mint records superseding stale decision-0005 pins (#135)
    Re-ran the five utmi-framing suites on pinned klt (129/129) and added
    bookkeeping supersessions for the two chain heads staled by the link fix.
2026-10-10 chore: resync installed Loom surfaces
    <!-- loom:provenance v1 build=unknown aa536103d6239818bb974a51d2f7f268eff38bad clean prompts=none sweep=none story=none trace=126a1328a3664e2119a0978086db9bea host=robb-studio base=f3ae526a828529111cf527a7d5b41836d1ddd6e5 run=loom-run/v1:timer:robb-studio/fleet-resync:fbc4e361-e290-4d81-ae3a-8b5fde796815 installs=0.19.1032 13ca937a7d6ba8768c296b0c126f2ce48f5f7ca4 -->
    Loom-Trace-Id: 126a1328a3664e2119a0978086db9bea
    Loom-Build: unknown aa536103d6239818bb974a51d2f7f268eff38bad clean
    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
2026-10-11 chore: resync installed Loom surfaces
    <!-- loom:provenance v1 build=unknown cf08873555e2eb95da295dcbee98b0dc34473381 clean prompts=none sweep=none story=none trace=67fbc483c3ca3e442d7928804c11ff06 host=robb-pro base=927a2aff7cb193f40039d4681d6ecb6f25b95d0c run=loom-run/v1:timer:robb-pro/fleet-resync:e3f97888-2b26-404a-bd47-86fd28a4eced installs=0.19.1041 b65c266b47d796bf37d1c04c6f616be0bc699056 -->
    Loom-Trace-Id: 67fbc483c3ca3e442d7928804c11ff06
    Loom-Build: unknown cf08873555e2eb95da295dcbee98b0dc34473381 clean
    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
2026-10-11 chore: resync installed Loom surfaces
    <!-- loom:provenance v1 build=unknown e91831edf7b55b29d3a2d88e266916fab9ce2563 clean prompts=none sweep=none story=none trace=f72dd67520a2c3802aa0495b80ac65a5 host=robb-studio base=4de198174378d9caf66d385988d642edec51d349 run=loom-run/v1:timer:robb-studio/fleet-resync:91d2434e-eae5-45de-9305-d78c43fc7c7a installs=0.19.1042 5b6ebdcc40bfccc9357e15196984061f1d5e6178 -->
    Loom-Trace-Id: f72dd67520a2c3802aa0495b80ac65a5
    Loom-Build: unknown e91831edf7b55b29d3a2d88e266916fab9ce2563 clean
    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
2026-10-11 chore: resync installed Loom surfaces
    <!-- loom:provenance v1 build=unknown 5ec729b9f7dd55a2082752611e4c4964f49661fb clean prompts=none sweep=none story=none trace=efc2abc8b72538df6d1a6ea9d329603d host=robb-pro base=2e94438ca9b1b5335d562e63f1d1a8b43a57cacb run=loom-run/v1:timer:robb-pro/fleet-resync:0d396c06-f26e-423e-97ac-6d3ac04a8e51 installs=0.19.1054 f6a73bc7fc942d7b297514b2e3f57a0ca2076010 -->
    Loom-Trace-Id: efc2abc8b72538df6d1a6ea9d329603d
    Loom-Build: unknown 5ec729b9f7dd55a2082752611e4c4964f49661fb clean
    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
2026-10-11 chore: resync installed Loom surfaces
    <!-- loom:provenance v1 build=unknown 745f69d0daad6c23e76cc006720fa4fbeaa3d887 clean prompts=none sweep=none story=none trace=3baabc4a039fd85029fff227a6ae690a host=robb-studio base=0554c726142c543006d656e220fe72d255ddfb91 run=loom-run/v1:timer:robb-studio/fleet-resync:3b3207d7-055d-49b5-a387-db375213668d installs=0.19.1060 3336676408ee1d4f1df2dc7f23adbb6c3170674e -->
    Loom-Trace-Id: 3baabc4a039fd85029fff227a6ae690a
    Loom-Build: unknown 745f69d0daad6c23e76cc006720fa4fbeaa3d887 clean
    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
2026-10-11 test(utmi): pin inertness of XcvrSelect, SuspendM and non-raw OpMode (#155)
    Loom-Story: 2AMLogic/gf180-usb2-phy#155
    Loom-Trace-Id: 6c3462a5dcc283b26cdbb9e8ff241fdb
    Loom-Build: 0.19.1065 33bb950d65b9038d5cf119a252820edca1192edf clean
2026-10-11 lint: run scripts/test_setup_env.sh from npm run lint (#156)
    Loom-Story: 2AMLogic/gf180-usb2-phy#156
    Loom-Trace-Id: 2e675ef13b650a8d7f53db732040e235
    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
2026-10-11 test(utmi): read DataIn only under RxValid; readable inertness variant ids (#155)
    sample() no longer calls int() on DataIn while RxValid is low. DataIn is an
    unreset hold register and can still be X, so the test now runs order-independently
    (standalone and on a gate netlist). Variant ids are short identifiers
    (xcvr0/suspend0/opmode01/opmode11/all) so cocotb names them in results.
    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
2026-10-11 fix(verification): mint records superseding stale test_usb_utmi_phy.py pins (#155)
    PR #158 changed verification/test_usb_utmi_phy.py, staling four live records.
    Re-ran the five utmi-framing suites on pinned klt e8ca621 / cocotb 2.0.1
    (134/134 PASS) and the gate-level zero-delay replay on the committed routed
    netlist (84/110: the 21 prior stale-netlist failures plus the 5 new
    inertness variants, which need the txoe/pu_en ports the netlist predates,
    #131). New records supersede 20261010-170000/170001/170002-26a37cf and
    20261010-052227-9847dbc; the old records are untouched.
    Loom-Trace-Id: 6c3462a5d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
2026-10-11 chore: resync installed Loom surfaces
    <!-- loom:provenance v1 build=unknown b37a005ac1889262fb9e5338f7cff4e9ed4987da clean prompts=none sweep=none story=none trace=25c158d7e9591610b251780caaff1c5f host=robb-pro base=3425e4b850aa6913b5f20fd7d2a8b90ddaf32669 run=loom-run/v1:timer:robb-pro/fleet-resync:7f020bca-6920-47f7-a5e4-bbd5c82d9bb8 installs=0.19.1072 29b48db1ead9c4501304e0114a5c33310e1d589f -->
    Loom-Trace-Id: 25c158d7e9591610b251780caaff1c5f
    Loom-Build: unknown b37a005ac1889262fb9e5338f7cff4e9ed4987da clean
    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
2026-10-11 chore: resync installed Loom surfaces
    <!-- loom:provenance v1 build=unknown 81a6b4499cb57b3620785bc1625c300da34f0735 clean prompts=none sweep=none story=none trace=d08bbd290651d7bcbda8b216c0dfbcdf host=robb-studio base=ac2de6ecb7647d44be40cee9bf866ed01736d104 run=loom-run/v1:timer:robb-studio/fleet-resync:71e05e3d-931c-46b4-b6d2-5f3f992c1e19 installs=0.19.1073 abb0872ba7d1d3f6f3a14f71f51a562e89308181 -->
    Loom-Trace-Id: d08bbd290651d7bcbda8b216c0dfbcdf
    Loom-Build: unknown 81a6b4499cb57b3620785bc1625c300da34f0735 clean
    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
2026-10-12 chore: resync installed Loom surfaces
    <!-- loom:provenance v1 build=unknown ddfb67ccf9a5115d62dd86924613a468b9328f44 clean prompts=none sweep=none story=none trace=772605234b9d8cafd6a4049200f7425c host=robb-pro base=e8fc4a534e231166406b08f6f8fe8bc47e35df7d run=loom-run/v1:timer:robb-pro/fleet-resync:1ef28ffc-0277-424f-9224-7ee6eca46377 installs=0.19.1083 77a174ea7fcaddbb25d0082956cd25d8633fc2df -->
    Loom-Trace-Id: 772605234b9d8cafd6a4049200f7425c
    Loom-Build: unknown ddfb67ccf9a5115d62dd86924613a468b9328f44 clean
    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
2026-10-12 chore: resync installed Loom surfaces
    <!-- loom:provenance v1 build=unknown be358990895362019614bd207bcbe36bc9eeff2c clean prompts=none sweep=none story=none trace=f1dc643b95859c8f26e892ddb5e2c5d7 host=robb-studio base=330e1cc6a4cd4cddf2a259973e10ef1c2d02cd0d run=loom-run/v1:timer:robb-studio/fleet-resync:da486ca2-3e94-4a85-abd3-88707942489a installs=0.19.1086 d8cb20101a985145fb167c1933758075a14ce1ab -->
    Loom-Trace-Id: f1dc643b95859c8f26e892ddb5e2c5d7
    Loom-Build: unknown be358990895362019614bd207bcbe36bc9eeff2c clean
    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
2026-10-12 chore: resync installed Loom surfaces
    <!-- loom:provenance v1 build=unknown a579728c137cc11d08a48b178e0ff9aa21683e72 clean prompts=none sweep=none story=none trace=10832f2750dbcd63f6c6f301a6f4da9b host=loom-worker-2 base=621831ac4bb2b17d54c5093382c4eab5c57429a3 run=loom-run/v1:timer:loom-worker-2/fleet-resync:180f6d5054f0479ab3990b86ab4522a5 installs=0.19.1087 51ac271f990b317a52ebf27cc21f34561e1179fb -->
    Loom-Trace-Id: 10832f2750dbcd63f6c6f301a6f4da9b
    Loom-Build: unknown a579728c137cc11d08a48b178e0ff9aa21683e72 clean
    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
2026-10-12 chore: resync installed Loom surfaces
    <!-- loom:provenance v1 build=unknown 02ecafe7734bf5faa945ce88940589f00eca78e9 clean prompts=none sweep=none story=none trace=5f71c537126994dc4c45179122427514 host=robb-pro base=d8b797b8c034d3a93ef439b153f2a90b6301d1e6 run=loom-run/v1:timer:robb-pro/fleet-resync:6293e6da-8a67-45aa-b277-c9ef85ddb810 installs=0.19.1101 27422582cd2d34d8ed5f60ce987007bc4bd61081 -->
    Loom-Trace-Id: 5f71c537126994dc4c45179122427514
    Loom-Build: unknown 02ecafe7734bf5faa945ce88940589f00eca78e9 clean
    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
2026-10-12 chore: resync installed Loom surfaces
    <!-- loom:provenance v1 build=unknown 5918da96dcd60c9a677a195737c86ea38972d215 clean prompts=none sweep=none story=none trace=49bb7a8942d6a23bf41754ca27ff2368 host=loom-worker-2 base=a91e0b62fc10c77d19f530ec8128136814b68f58 run=loom-run/v1:timer:loom-worker-2/fleet-resync:2e973f04abd1447d8ee4b696c2e7d2b4 installs=0.19.1107 0792884ed3ac62716726d6e998d9e0ec119ba2d2 -->
    Loom-Trace-Id: 49bb7a8942d6a23bf41754ca27ff2368
    Loom-Build: unknown 5918da96dcd60c9a677a195737c86ea38972d215 clean
    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
2026-10-12 chore: resync installed Loom surfaces
    <!-- loom:provenance v1 build=unknown 9885e6bbba36f53328e04be83140734c6eda9f58 clean prompts=none sweep=none story=none trace=72f34c4066d6ca844a10c33035a775bd host=loom-worker-1 base=d3b0bca9fe4db4e2d3d4e516d20be933845ef570 run=loom-run/v1:timer:loom-worker-1/fleet-resync:8f5732bc51fd43379e17e0de51e86bae installs=0.19.1108 72427939d156341080a7006ae6fbb5ec96b2368e -->
    Loom-Trace-Id: 72f34c4066d6ca844a10c33035a775bd
    Loom-Build: unknown 9885e6bbba36f53328e04be83140734c6eda9f58 clean
    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
2026-10-12 chore: resync installed Loom surfaces
    <!-- loom:provenance v1 build=unknown 01467247f32c59822968bf02d3214d9a3d613452 clean prompts=none sweep=none story=none trace=0e97e9733eef09a33959cf96e6271f40 host=robb-studio base=2c3e305141c18145d1bdf166ecb938ce917e1125 run=loom-run/v1:timer:robb-studio/fleet-resync:53a4d390-3842-4216-9018-5dced9d0ea17 installs=0.19.1109 d9498fcd419776b2517e30b99c88e76bbe92d2f4 -->
    Loom-Trace-Id: 0e97e9733eef09a33959cf96e6271f40
    Loom-Build: unknown 01467247f32c59822968bf02d3214d9a3d613452 clean
    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
2026-10-12 chore: resync installed Loom surfaces
    <!-- loom:provenance v1 build=unknown acadc2b4b0e852f2d889ac9dec616e1548705802 clean prompts=none sweep=none story=none trace=a69edb348af7f0e67b3bc77bc33b1bfc host=loom-worker-2 base=577f30a0dc082d74f9a79546fd150813da75f02d run=loom-run/v1:timer:loom-worker-2/fleet-resync:0923627ffda84cf69ec2486475772b10 installs=0.19.1126 7736d1276b6d01778fba3461114c858ef1bf5e2d -->
    Loom-Trace-Id: a69edb348af7f0e67b3bc77bc33b1bfc
    Loom-Build: unknown acadc2b4b0e852f2d889ac9dec616e1548705802 clean
    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
2026-10-12 chore: resync installed Loom surfaces
    <!-- loom:provenance v1 build=unknown 8d832cc8035d4ba07872510416468da0790332cd clean prompts=none sweep=none story=none trace=09a53bf60e96fc30a753caffd1de8c92 host=robb-studio base=b9136c63ef0d2c38cae66bddbcec37201890f164 run=loom-run/v1:timer:robb-studio/fleet-resync:baf4c30c-65d9-4d4e-a740-f6a80cbb975c installs=0.19.1132 8695bdd2b7b963dca9b76f4643a9d7c744294426 -->
    Loom-Trace-Id: 09a53bf60e96fc30a753caffd1de8c92
    Loom-Build: unknown 8d832cc8035d4ba07872510416468da0790332cd clean
    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
2026-10-12 chore: resync installed Loom surfaces
    <!-- loom:provenance v1 build=unknown aa1ed0d7d5499d2705977d971673d919dbbbaf4e clean prompts=none sweep=none story=none trace=2522608826ef5d5e4a88a9667055aeb7 host=loom-worker-2 base=88299264f7ec54c00b01ac34d829ea21e2c16541 run=loom-run/v1:timer:loom-worker-2/fleet-resync:8f26b719c712455381744111c50e90b4 installs=0.19.1142 b91ae5d1b5204f499a1abb875a6cf5bffc1d90b1 -->
    Loom-Trace-Id: 2522608826ef5d5e4a88a9667055aeb7
    Loom-Build: unknown aa1ed0d7d5499d2705977d971673d919dbbbaf4e clean
    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
2026-10-12 chore: resync installed Loom surfaces
    <!-- loom:provenance v1 build=unknown 8b64614d017d6ce7491c3a2ac9da51e5e2901c97 clean prompts=none sweep=none story=none trace=66044c049ba635bcd6a4797c3a77e84b host=robb-pro base=b7eba6e05e62dd087fb921218c86866a779bab8e run=loom-run/v1:timer:robb-pro/fleet-resync:68f56594-05d0-4cc0-9c07-36263359d698 installs=0.19.1144 9e4381cbbd2386393e44c7a979583252948a3998 -->
    Loom-Trace-Id: 66044c049ba635bcd6a4797c3a77e84b
    Loom-Build: unknown 8b64614d017d6ce7491c3a2ac9da51e5e2901c97 clean
    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
2026-10-13 chore: resync installed Loom surfaces
    <!-- loom:provenance v1 build=unknown e66f00108a9519331aa981da8a01c6569ca623a9 clean prompts=none sweep=none story=none trace=d3e476cf8c03d5ed37f8e146b3632190 host=robb-studio base=051b25e70768280f8cbbffae5171ee22a42b3cc8 run=loom-run/v1:timer:robb-studio/fleet-resync:1d7ace45-2daf-4c92-a752-67b11e982245 installs=0.19.1146 972552531e3e890528f13c6cc8fb7406877c96f9 -->
    Loom-Trace-Id: d3e476cf8c03d5ed37f8e146b3632190
    Loom-Build: unknown e66f00108a9519331aa981da8a01c6569ca623a9 clean
    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
2026-10-13 chore: resync installed Loom surfaces
    <!-- loom:provenance v1 build=unknown 98d08ab78cc223361354ee9947d996b1cb914b30 clean prompts=none sweep=none story=none trace=8b73addcdeaa8fbd65998649f42a8c50 host=loom-worker-2 base=f551904fe089fe37d57744dd36e70ddf601fac87 run=loom-run/v1:timer:loom-worker-2/fleet-resync:3bfb13d52fca425f9cfced4541954cb6 installs=0.19.1148 1448fdfa79ac2dcab7fad6b95b72697b450f2a4a -->
    Loom-Trace-Id: 8b73addcdeaa8fbd65998649f42a8c50
    Loom-Build: unknown 98d08ab78cc223361354ee9947d996b1cb914b30 clean
    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
2026-10-13 chore: resync installed Loom surfaces
    <!-- loom:provenance v1 build=unknown d0bfbbc7ac309581d7abe02c4a269c7704010ee0 clean prompts=none sweep=none story=none trace=0ad6d167235000f3b5648cbd63d761ce host=robb-pro base=3cca589f4e4f74a4d5771271cffdc8362dbf8886 run=loom-run/v1:timer:robb-pro/fleet-resync:4f7cbe22-40b6-49ff-8811-003ae8577c28 installs=0.19.1151 08ee0f8708464aa8e0768640d56955d7f4fcbc98 -->
    Loom-Trace-Id: 0ad6d167235000f3b5648cbd63d761ce
    Loom-Build: unknown d0bfbbc7ac309581d7abe02c4a269c7704010ee0 clean
    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
2026-10-13 chore: resync installed Loom surfaces
    <!-- loom:provenance v1 build=unknown 7916c4043a1b57e97a53bc5c111e74c5038a1091 clean prompts=none sweep=none story=none trace=20b27ffb08c4130dc9836ee8d9d97b97 host=loom-worker-2 base=4847442b4ac19e9e0ec9d8729ec21362f13308ef run=loom-run/v1:timer:loom-worker-2/fleet-resync:d34532ec625a4162ae8b58dde1a6738f installs=0.19.1151 f7d1deaab02a9c483fce1ced33fadb1af6d86f59 -->
    Loom-Trace-Id: 20b27ffb08c4130dc9836ee8d9d97b97
    Loom-Build: unknown 7916c4043a1b57e97a53bc5c111e74c5038a1091 clean
    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
2026-10-13 chore: resync installed Loom surfaces
    <!-- loom:provenance v1 build=unknown ac0bbcf6eda99918e88a0b8893d9762b106a2e45 clean prompts=none sweep=none story=none trace=8597ab8a51d68f9f8ee864fa71904bff host=robb-studio base=0ea7f12be7eedf471fe2edc9f78f460bec84af4f run=loom-run/v1:timer:robb-studio/fleet-resync:2ea9dd71-a6b2-4d0c-86aa-859a0728c9b3 installs=0.19.1151 f7d1deaab02a9c483fce1ced33fadb1af6d86f59 -->
    Loom-Trace-Id: 8597ab8a51d68f9f8ee864fa71904bff
    Loom-Build: unknown ac0bbcf6eda99918e88a0b8893d9762b106a2e45 clean
    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
2026-10-13 chore: resync installed Loom surfaces
    <!-- loom:provenance v1 build=unknown 7916c4043a1b57e97a53bc5c111e74c5038a1091 clean prompts=none sweep=none story=none trace=99a9d442e177e2a14f9fe891925a70a9 host=loom-worker-1 base=ba4812f6b09d884733a6839e6ea3c6331b7754ff run=loom-run/v1:timer:loom-worker-1/fleet-resync:c61893183c38452a8cff7a1b196057af installs=0.19.1151 f7d1deaab02a9c483fce1ced33fadb1af6d86f59 -->
    Loom-Trace-Id: 99a9d442e177e2a14f9fe891925a70a9
    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
2026-10-13 chore: resync installed Loom surfaces
    <!-- loom:provenance v1 build=unknown 7916c4043a1b57e97a53bc5c111e74c5038a1091 clean prompts=none sweep=none story=none trace=773e9e41a5730d2f79f2381ad2cde068 host=robb-pro base=20f15d81b530a3e2d86a4cd8baf98835091a0d2f run=loom-run/v1:timer:robb-pro/fleet-resync:b7ca0d34-434e-4536-85b9-57adfa603a8d installs=0.19.1151 a885af872d054695b81e8458dfc7bd717cbddba8 -->
    Loom-Trace-Id: 773e9e41a5730d2f79f2381ad2cde068
    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
2026-10-13 chore: resync installed Loom surfaces
    <!-- loom:provenance v1 build=unknown f57244868aa20ef22c18aa8025972184aaea43e4 clean prompts=none sweep=none story=none trace=8e03b78fe6cb43a017c4a4823362ffa7 host=loom-worker-2 base=0abe135e8affb4057884f68d7b9a3805aa140813 run=loom-run/v1:timer:loom-worker-2/fleet-resync:eb553d2fc2a54589aa37879f12b18ed5 installs=0.19.1151 4b3b3e77e5ef42971b3c0c3e68c000736a0c7c21 -->
    Loom-Trace-Id: 8e03b78fe6cb43a017c4a4823362ffa7
    Loom-Build: unknown f57244868aa20ef22c18aa8025972184aaea43e4 clean
    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
2026-10-13 chore: resync installed Loom surfaces
    <!-- loom:provenance v1 build=unknown f91cd239df41290ba3efb8bc14320984e3392c6f clean prompts=none sweep=none story=none trace=c1345a24765b7e1c5307ef032fd77486 host=loom-worker-3 base=ee529f21c44f220834547972992ea85ac87044ad run=loom-run/v1:timer:loom-worker-3/fleet-resync:c4883600330b4d70afac9e743a4e52e3 installs=0.19.1151 a9d9bfc13e966655d6d847cb6876af523bc4a4c4 -->
    Loom-Trace-Id: c1345a24765b7e1c5307ef032fd77486
    Loom-Build: unknown f91cd239df41290ba3efb8bc14320984e3392c6f clean
    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
2026-10-13 chore: resync installed Loom surfaces
    <!-- loom:provenance v1 build=unknown 6fe43c87955e02019c2bc8dfad4fbd160b89170c clean prompts=none sweep=none story=none trace=49a4590bf54e81899c26d965f682504c host=robb-studio base=ee98487dc2e84764324c1153a11fc6f332cce930 run=loom-run/v1:timer:robb-studio/fleet-resync:459197b3-0050-4335-893e-e47b638eb819 installs=0.19.1151 c6a7b6acb1e186314d3252e9e96b6ae903e74a1c -->
    Loom-Trace-Id: 49a4590bf54e81899c26d965f682504c
    Loom-Build: unknown 6fe43c87955e02019c2bc8dfad4fbd160b89170c clean
    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
2026-10-13 chore: resync installed Loom surfaces
    <!-- loom:provenance v1 build=unknown 5dc3a07d084d0ec4034f0782d572925dcad86af7 clean prompts=none sweep=none story=none trace=cbc11657acadf58858409fe543c342e1 host=robb-pro base=9b3058b5e6782825ac0ecca105344053237366b5 run=loom-run/v1:timer:robb-pro/fleet-resync:be586137-d91e-4e2c-82d6-3164d43aa9de installs=0.19.1152 2d5fe17958dca799058f16bdd74a12336990bec0 -->
    Loom-Trace-Id: cbc11657acadf58858409fe543c342e1
    Loom-Build: unknown 5dc3a07d084d0ec4034f0782d572925dcad86af7 clean
    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
2026-10-13 chore: resync installed Loom surfaces
    <!-- loom:provenance v1 build=unknown 27a266d5a27885323290840d2a837d73fcf4bcc6 clean prompts=none sweep=none story=none trace=e77cdd5477ef6bfc65fba6cc233788e0 host=loom-worker-2 base=4f03a6fe2f91d34e1677fd708e63641efea5171e run=loom-run/v1:timer:loom-worker-2/fleet-resync:7fac7d82f298441a91761382ac989183 installs=0.19.1152 8d16eec5f10d705602ac4d1ab871c57266f1aa45 -->
    Loom-Trace-Id: e77cdd5477ef6bfc65fba6cc233788e0
    Loom-Build: unknown 27a266d5a27885323290840d2a837d73fcf4bcc6 clean
    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
2026-10-13 chore: resync installed Loom surfaces
    <!-- loom:provenance v1 build=unknown f2b62a2cf576d7d37092147b2281da809f8b5cf5 clean prompts=none sweep=none story=none trace=8adfa75521c72dded43e2932febb6329 host=loom-worker-3 base=12e2ea7165a998632753314e2e5b27607e439a2b run=loom-run/v1:timer:loom-worker-3/fleet-resync:8a8198f8f80e4703bc7365a5e10595e0 installs=0.19.1152 8d16eec5f10d705602ac4d1ab871c57266f1aa45 -->
    Loom-Trace-Id: 8adfa75521c72dded43e2932febb6329
    Loom-Build: unknown f2b62a2cf576d7d37092147b2281da809f8b5cf5 clean
    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
2026-10-13 chore: resync installed Loom surfaces
    <!-- loom:provenance v1 build=unknown 84d11f248d368cae5e04a2255f6897a406c50089 clean prompts=none sweep=none story=none trace=8e50b4ccc3dc58f709a732f69d58fd44 host=robb-studio base=e54dd333563f6c79e7b0fca798ad3573d97923fc run=loom-run/v1:timer:robb-studio/fleet-resync:05c9f3b1-eee2-412f-8996-5fbf02793d9e installs=0.19.1153 d8429a4fabdc955107af1cbc22c548e23eecf9b1 -->
    Loom-Trace-Id: 8e50b4ccc3dc58f709a732f69d58fd44
    Loom-Build: unknown 84d11f248d368cae5e04a2255f6897a406c50089 clean
    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
2026-10-14 fix(verification): mint post-merge records superseding stale chain heads (#115)
    Merged origin/main (#155 inertness tests) into the #115 branch; the only
    conflict was verification/test_usb_utmi_phy.py (kept both blocks). Re-ran on
    the merged tree with the CI-pinned klt/cocotb (throwaway venv): UTMI suites
    135/135 (phy 111/111; ports-only 111/111), zero-delay gate replay 85/111
    (same 21 expected failures + 5 inertness variants on the stale netlist).
    Minted 2 run records and 7 bookkeeping supersessions; history untouched,
    check_records.py --require-append-only is clean.
2026-10-15 feat(digital): regenerate physical/evidence chain from current RTL (#131)
    Re-run synthesis, place-and-route, DRC, LVS (+negative control), ERC,
    extraction, single/multi-corner post-layout STA and the gate-level replay
    on the post-#115/#112/#113/#130 tree (32db02a). New append-only records
    supersede the stale heads; manifests, signoff report and READMEs cite the
    new generation. Zero-delay replay of the routed netlist passes 111/111
    (+5/5 txoe). SDF replay remains rejected by klt's annotation gate, so
    7.digital stays unmet.
    Loom-Story: 2AMLogic/gf180-usb2-phy#131
    Loom-Trace-Id: 552b3ed0a6b6e38ffed50d148be2eece
    Loom-Build: 0.19.1160 57e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
2026-10-15 wip(#96): re-size differential_driver output stage; klt sim request for driver-signal-quality (no evidence record yet)
    Local single-corner probes only; the 45-corner batch run could not be dispatched
    (fleet runner klt 0.5.0 vs client 0.7.0, job klt-sim-e5b70c248c3c exit 87).
    Loom-Story: 2AMLogic/gf180-usb2-phy#96
    Loom-Trace-Id: fdd8d5542e66bb7da13e9dac663873ba
    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
2026-10-15 feat(analog): klt sim batch requests for driver jitter and 45-corner remote sharding
    Adds the jitter klt sim request/body and shards both driver requests across
    fleet hosts so the 45-corner grids fit the fleet job ceiling.
    Loom-Build: 0.19.1162 f1ee755eeca1954f35bf83d19f4b84ad51feb9f5 clean
    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
2026-10-15 feat(analog): re-size differential driver; 45/45 PVT on the §6 rows, supersede failing records
    Adds driver-signal-quality and driver-jitter records (klt sim, batch fleet)
    that supersede the 60/30 um results, and points spec-coverage, the Chipalooza
    rows and the READMEs at them. The ratified spec is unchanged.
    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
2026-10-15 fix(records): supersede stale analog-layout record after driver re-size (provenance-only)
    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
2026-10-15 docs(records): re-run driver layout-plan on post-resize netlist; m=4 fails ingestion, plan unchanged
    Loom-Story: 2AMLogic/gf180-usb2-phy#166
    Loom-Trace-Id: 71e0c8b253268f3571e9f1028405960d
    Loom-Build: 0.19.1163 695290c117c5d456d46b434f9e2817200184f217 clean
2026-10-15 feat(analog): flatten driver output stage m=4 into parallel m=1 devices
    Replace each m=4 output device with four m=1 instances (same L/W/nf),
    regenerate the netlist with klt netlist, update the layout plan to one
    group per instance, and record that the plan now executes (placed, DRC
    clean, 0/10 nets routed). PVT equivalence re-run was blocked by the batch
    fleet instance cap; a single tt/27C/3.30V probe matches the prior record.
    Loom-Story: 2AMLogic/gf180-usb2-phy#167
    Loom-Trace-Id: 6e373d535837d79e07ea37d544a7b5e4
    Loom-Build: 0.19.1164 4f137ac910d942a0fde6fb51791c679c89832ee6 clean
2026-10-15 feat(design): flatten driver output-stage m=4 into four parallel m=1 devices per output FET
    Regenerated the netlist from the schematic with klt netlist and updated the
    layout plan to the new instance names.
    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
2026-10-15 docs(records): driver plan executes after m=4 flatten; raise signal-quality sim timeout to 900s
    Append analog-layout record superseding 20261015-142756-0e9d9cb: the
    flattened driver netlist is ingested and placed DRC-clean (0/10 nets routed).
    Equivalence sims are not yet recorded: fleet capacity errors.
    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
2026-10-15 fix(records): omit stale simulated-netlist hash from provenance inputs
    The simulated netlist variant is no longer in the tree after taking main's
    netlist; record its hash in prose so the lint's stale-hash check passes
    without misattributing the sims to main's netlist.
    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
2026-10-15 ci: cancel in-progress runs only for pull_request events
    Use per-workflow, per-event concurrency groups so started push and
    workflow_dispatch verification runs always finish and keep their verdict,
    while obsolete PR revisions are still cancelled.
    Loom-Story: 2AMLogic/gf180-usb2-phy#138
    Loom-Trace-Id: 25b01de962f70816f23034cd37365f8d
    Loom-Build: 0.19.1166 8a9aad12e32504cea9a7c7d2ed774749c487f875 clean
2026-10-16 docs: update WORK_PLAN from current label state
    Automated document maintenance by Guide triage agent.
2026-10-17 fix(design): record klt version for netlist oracle; print it on --check failure
    Addresses review: klt netlist is absent from the repo pin and the exported
    text is klt-build sensitive. Document the verified klt (dev1624) in
    design/README.md and surface klt --version in netlist.py output. Committed
    netlists are not regenerated.
2026-10-17 refactor(layout): remove inert BLOCKED_BLOCKS path from gen_analog_layout.py
    BLOCKED_BLOCKS has been empty since #72 and has no population path, so
    _probe_blocked() was unreachable. Drop the dict, the probe, the no-op
    extend loop and the matching prose in the script docstring and
    layout/README.md. Mint two source-only records superseding the two live
    analog-layout records whose gen_analog_layout.py hash went stale; they
    re-measure nothing.
2026-10-17 feat(signoff): cite artifact-anchored evidence for T1 items 1, 2.digital, 9, 10
    Add signoff/inventories.py + check.py: per-item sha256 inventories and
    generic envelopes bound to them, a drift check wired into check:ci, and
    manifest citations. CI and the signoff grader move to klayout-tools==0.7.0,
    which grades these envelopes; the setup-env.sh venv pin is left alone
    because live append-only records hash that script.
2026-10-17 feat(sim): klt backend stages the PDK design include, carries check bounds as limits, shards across hosts
2026-10-17 docs: classify analog statistical rows, state digital item-6 N/A, add receiver MC request builder
    Part of #189. Adds DR-0007 (which spec rows are statistical), a hash-bound
    digital 'no statistical row' statement with a checker, corrects the
    manifests/README item-6 paragraph, and a klt sim monte_carlo request builder
    for the differential receiver. No Monte Carlo result is recorded: the one
    fleet submission was Spot-interrupted.
2026-10-17 chore(klt): re-pin klt to 7ee09483 for list-form item-5 evidence; re-render report, no verdict moves
    v0.7.0 has measurements[].expr but not the multi-envelope item-5 grading
    (klayout-tools#2959), so the pin is a commit, not a release tag.
2026-10-17 feat(sim): cite five 45-corner klt sim envelopes as item 5.analog, with agreement table
    Re-emit the SE/diff receiver, driver signal quality and pull-up benches as
    klt sim envelopes (spec bounds carried as limits, run on the batch fleet),
    compare them with the existing records, and declare the jitter row as a gap.
    5.analog renders unmet/partial_coverage; 5.digital moves met -> unmet because
    spec_rows is not partition-scoped (klayout-tools#3768).
2026-10-20 feat(sim): deck-list klt transport for all benches; refuse implicit local grid fan-out
    Adds a klt deck-list transport that ships the harness's own composed
    per-point decks unchanged (only file-reference strings differ), so the six
    benches without klt_measure - including .control/derived-vector ones - can go
    to the fleet with identical measurement parsing and failure classification.
    Multi-unit klt grids must resolve to batch/remote, the in-process runner is
    refused for grids on fleet hosts, and -j is capped at 2. run_grid and
    run_point are kept.
    Part of #195
2026-10-20 docs(records): supersede evidence records staled by the #204 trim-fallback removal
    PR #206 changed verification/test_usb_utmi_phy.py, staling the provenance
    hash of 9 live records. Re-ran the RTL utmi-framing suites (CI klt pin
    e8ca621) and the gate-level SDF/zero-delay replays (klt 0258b255) in
    throwaway venvs; every per-test status and sim_time_ns matches the
    predecessors, and the trim test executes on both RTL and the routed
    netlist (no "RTL-only check skipped" anywhere). The predecessors are not
    edited.
2026-10-20 docs(sim): point run_corners --help examples at real bench and spec anchor
    The argparse epilog named testbench smoke-bias and the --claim example
    cited spec/bandgap.md, neither of which exists in this repo. Use
    smoke-inverter and spec/usb2-device-phy.md#driver-characteristics.
    Loom-Issue: 2AMLogic/gf180-usb2-phy#216
2026-10-20 fix(sim): use numbered spec anchor #6-driver-characteristics in claim examples
2026-10-21 fix(sim): drop duplicate bmid/bn1 nodes left by the main merge in dm/dp benches
    origin/main already defines the measurement-only nodes; the merge kept both
    copies, so ngspice errored on the duplicate device names. Keep main's pair.
2026-10-21 sim: record failed batch attempt for driver-disabled-leakage 45-corner grid (exit 87)
    Append-only ERROR record: the fleet job exited 87 after ~5 s for all 45
    units; a single local tt/27C probe of the same testbench passes. No
    fallback grid was run.
2026-10-21 sim: record diff-receiver-mc campaign not run, klt release lacks capacity-wait fix
2026-10-23 docs(env): fix stale klt pin lead-in; regen signoff inventories and report
    The lead-in claimed CI/grader used a released version while setup-env kept
    a revision pin; after merging main (move 7) the pin is the same git
    revision everywhere. Re-ran signoff/check.py --regen and re-rendered the
    T1 report under the pinned klt.
2026-10-23 feat(sim): store corner-run evidence in the artifact store, commit manifests only
    run_corners.py now stages a record's netlist snapshot and per-corner logs in
    git-ignored sim/.work/.stage/ and stores them with klt artifact put. Git keeps
    manifests/artifacts/<bench>-<rid>.manifest.json plus the Markdown record with
    a Stored evidence table. The run fails closed (exit 10, nothing simulated or
    committed) when the broker, the artifact verb or the put is unavailable.
    sim/check_records.py accepts a manifest in place of committed snapshot and log
    files and treats manifests as append-only. A stdlib, offline
    check_artifact_manifests.py runs in lint and CI. The CI klt pin is unchanged.
    Co-Authored-By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
2026-10-27 docs(spec): propose DR-0009 numeric limit for driver-output jitter row
    Quotes USB 2.0 7.1.13.1.1 full-speed source jitter (+-2.0 ns consecutive,
    +-1.0 ns paired) and Table 7-4, maps them to the sim/driver-jitter
    measurements, and adds a Proposed row to the 12.1 table. Ratified 8.2 text
    is unchanged.
    Part of #249
    Loom-Issue: 2AMLogic/gf180-usb2-phy#249
2026-10-27 docs(verification): supersede digital item-6 N/A statement for DR-0009 spec change
    The DR-0009 proposal adds one §12.1 index row, changing the spec SHA-256
    and tripping check_statistical_na.py. Re-read the statement against the
    changed spec (still holds: no digital statistical row), pin the new hash in
    a dated superseding statement, and keep the original statement below it
    with its marker shown as plain text.
2026-10-27 feat(layout): route and commit GDS for four analog blocks via scripted completion
    Extend scripts/gen_analog_layout.py to finish the nets klt's layout-plan
    path leaves open: metal-2 pin stubs, one metal-3 track per net, and
    metal-2 corridors between devices. Every net is re-verified by a flat
    conductivity extraction (cross-checked with KLayout LayoutToNetlist), and
    instance origins are snapped to the 0.005 um grid.
    Commits layout/analog/{dplus_pullup,se_receiver_dp,se_receiver_dm,
    differential_receiver}.gds with a provenance.json sidecar that
    `gen_analog_layout.py --check` reproduces byte-for-byte. The three receivers
    are DRC-clean; dplus_pullup is fully routed but keeps 75 violations inside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
2026-10-27 chore(signoff): regen T1 repo-hygiene inventory and re-render report after spec index row
    DR-0009's proposal changes spec/usb2-device-phy.md, which the repo-hygiene
    inventory hashes. Regenerated with signoff/check.py --regen and re-rendered
    manifests/t1-signoff-report.json with the CI-pinned klt (7ee09483); the only
    report diff is the four inventory content hashes.
2026-10-27 build: pin klayout-tools to PyPI release 0.8.0 and re-render signoff evidence
    Replace the 7ee09483 git-revision pin with klayout-tools==0.8.0 in CI,
    scripts/setup-env.sh (KLT_REV -> KLT_VERSION), and the docs; teach the
    signoff pin audit the release form for setup-env.sh; regenerate the
    inventories, envelopes and frozen T1 report under 0.8.0 (item statuses
    unchanged); add source-only analog-layout records superseding the four
    chain heads whose setup-env.sh provenance hash went stale.
2026-10-28 fix(signoff): key item-5 spec_rows to 5.analog so 5.digital is not charged analog rows
2026-10-30 feat(layout): grid-snap dplus_pullup trim resistors so the stream is DRC-clean
    Draw XR0..XR4 at 0.420/0.685/1.370/2.745/5.485 um via params.length_um
    (DR-0010, operator ruling on #251), regenerate dplus_pullup.gds (0 DRC
    violations, was 75), re-run the 45-corner pull-up simulation on the snapped
    lengths (PASS), and mint superseding analog-layout records.
    Part of #245. Contributes to #251.
2026-10-30 fix(verification): supersede digital item-6 N/A statement for DR-0010 spec change
    DR-0010 added one row to the spec's section 12.1 index, changing its
    SHA-256 to a7f5fd1c. Re-read the statement against the changed spec (no
    digital statistical row added), added a superseding statement with the
    new pin (old statements kept as history), and regenerated the T1
    repo-hygiene inventory and re-rendered the signoff report with
    klayout-tools==0.8.0 (only the four inventory hashes differ).
2026-10-31 fix: tie TXOE in klt driver testbenches and lint subckt port counts
    Both *_klt.spice testbenches instantiated differential_driver with 6 nets
    against a 7-port subckt (TXOE missing). Tie TXOE high as the harness copies
    do, and add sim/harness/port_lint.py, run from sim/check_records.py, which
    compares testbench X-instance net counts with design/netlist subckt ports.
2026-10-31 chore: regen testbench inventory after klt TXOE tie and port lint
    Re-hashes the two edited klt testbenches and evidence_lint.py, adds
    port_lint.py and test_port_lint.py, and refreshes the item-9 envelope and
    manifest pin that follow from the inventory.
2026-10-31 Re-render T1 signoff report after testbench evidence rebind
    Regenerated with klt 0.8.0 (the CI pin) so items 16/17 content_hash
    matches a fresh render.
2026-11-04 sim: mint 45-corner TXOE records and cite them in spec coverage
    Add driver-disabled-leakage, driver-signal-quality and driver-jitter records
    from the batch fleet, a dated comparison note vs the pre-TXOE records, and
    update sim/spec-coverage.md. driver-signal-quality newly fails rise/fall
    matching at fs_-40c_2.97v (1.10582 > 1.1); tracked in #277.
2026-11-04 design: lengthen TXOE NMOS-path slew resistor to re-match rise/fall
    RSLEWNDP/RSLEWNDM 1u x 2u -> 1u x 10u slows the NMOS gate edge so
    fs/-40C/2.97V trf_ratio drops under the 1.1 spec limit (probe: 1.106 ->
    1.068) without touching the output stage, predriver devices or the spec.
2026-11-04 sim: mint 45-corner records superseding the failing TXOE trf_ratio run
    driver-signal-quality 20261104-204550-2d31f87 passes every §6 row at
    45/45 (trf_ratio 0.930-1.068); jitter and disabled-leakage re-run on the
    batch fleet. spec-coverage points at the new records; comparison note and
    design/README updated. No prior record edited.
2026-11-04 records(analog-layout): supersede four records with stale driver hashes
    PR #281 changed design/differential_driver.sch and its netlist, which the
    four 20261030-2135xx analog-layout records list as provenance inputs.
    Mint superseding records (one re-measured via gen_analog_layout.py --check
    at klt 0.8.0, three source-only); old records untouched.
2026-11-04 chore(signoff): regenerate T1 signoff evidence for driver and spec-coverage changes
    PR #281 changed design/differential_driver.sch, its netlist and
    sim/spec-coverage.md; reuse:check flagged the T1 item 1.analog / item 9
    inventories as stale. Re-ran signoff/check.py --regen and re-rendered
    manifests/t1-signoff-report.json with klayout-tools 0.8.0; hash pins only.
2026-11-04 chore(signoff): regenerate T1 signoff evidence for package.json lint wiring
    Re-binds the package.json hash in the repo-hygiene inventory (T1 item 10)
    and re-renders the T1 signoff report at the pinned klt 0.8.0.
2026-11-06 feat(layout): draw dplus_pullup trim resistors from netlist lengths via klt 0.9.0 snapping
    Bump the klt pin to 0.9.0 (klayout-tools#4666), drop the hand-set length_um
    overrides from the dplus_pullup plan, regenerate the analog GDS, and record the
    generator's realised lengths (equal to DR-0010) with a DRC-clean run record.
2026-11-13 fix(layout): regenerate driver layout plan against current netlist and record re-run
    The committed plan named pre-TXOE devices, so the layout-plan flow returned
    execute-failed. One group per netlist device now; plan executes and placed GDS
    is DRC clean (not routed, no LVS). Superseding records minted per lineage.
2026-11-13 docs(chipalooza): use the current run record and the driver's real net count
    Addresses the two blocking findings on PR #314.
    1. The driver has 20 nets, not 10. "10 nets" came from issue #252's body,
    which predates the TXOE rework (#114). Record
    20261113-090000-4f79d854e7b4 measures 40 device groups, 20 nets, 2 routed
    by klt, 18 unrouted. The driver paragraph now states what that record
    actually shows: the plan executes, 40 groups placed, the placed GDS is
    DRC-clean, 2/20 nets routed, nothing committed.
    2. Row L and the §5 routing-provenance paragraph cited
    20261106-120000-ef841f90e933, which 20261113-090000-4f79d854e7b4
    supersedes. Both now cite the head of the lineag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
2026-11-13 refactor(sim): drop unused write_record, test append-only on the live writer
    `write_record()` lost its last production caller in aa07b6f, when
    `sim/harness/cli.py` switched to passing `report.render_record(...)` as
    `summary_text` into `evidence_store.store_files()`, which writes
    `records/<record-id>.md` itself. The function stayed behind, and with it a
    test asserting the append-only "never overwrite a record" invariant against
    a writer the harness no longer runs.
    Carry the coverage onto the live writer rather than losing it: the existing
    `store_files()` overwrite test pre-creates only the manifest, so the
    record-already-exists leg had no live coverage at all. Add a sibling case
    that pre-cre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
2026-11-13 docs(layout): state the committed analog streams in the current-state paragraph
    layout/README.md § "Current state in one paragraph" still described the
    pre-#251 tree: it said nothing under layout/analog/ was committed, called the
    plan-path-only differential_receiver evidence artifact the only analog GDS,
    reported the klt-plan splits (6 of 21, 1 of 8/9/9) as the routing totals, gave
    the driver as 0 of 10 nets, and cited 20260921-130120-223bae5 as the latest
    run.
    Rewrite the prose to the tree it ships with: four committed, fully routed
    (8/8, 9/9, 9/9, 21/21), DRC-clean streams, with the klt-plan / scripted split
    (1, 1, 1, 6 by plan path; 7, 8, 8, 15 scripted) named as a split rather than a
    t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
2026-11-13 chore(signoff): rebind T1 item 9 to the refactored sim/ files
    The refactor moved three files the T1 item 9 testbench inventory binds by
    sha256, so `python3 signoff/check.py` failed the gate:
    FAIL signoff/evidence/inventory-testbenches.json:
    sim/harness/report.py: changed since it was inventoried
    sim/tests/test_evidence_store.py: ...
    sim/tests/test_harness.py: ...
    `python3 signoff/check.py --regen` refreshes the three member hashes and
    the envelope/manifest pins that chain off them. Re-rendering
    manifests/t1-signoff-report.json moves in the same change, as
    manifests/README.md and check_signoff_report.py's contract require:
    the report froze item 9's old content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
2026-11-13 docs(layout): date the klt pin in the two pin-relative README sentences
    layout/README.md stated a stale pin as current state: line 125 said "the
    repo now pins 0.8.0 and all four GDS reproduce under it" while the repo
    pins 0.9.0 (scripts/setup-env.sh, ci.yml, all four klt_version entries in
    layout/analog/provenance.json), contradicting the same file's lines 110
    and 159.
    Both sentences are reworded away from pin-relative phrasing so they stay
    true across the next re-pin:
    - line 125: the first-delivery parenthetical now names only the klt the
    routing counts were measured under (7ee09483, 0.7.1.dev1743, 2026-10-27,
    d7293c5), and a new sentence records the pin history as history -- 0.8.0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
2026-11-13 docs(layout): move the dated klt-only analog narrative to analog/HISTORY.md
    layout/README.md carried 615 lines (70% of the file) of dated narrative
    about the klt-only analog routing attempt, sitting directly beside the
    prose that describes what the tree actually ships — the arrangement behind
    three recent staleness defects (#314, #315, #321).
    Move those five subsections ("What was attempted" through "What would have
    to be true to deliver analog layout") verbatim into layout/analog/HISTORY.md,
    under a header that says the file is history and where current state lives.
    Nothing is deleted: the 615 lines are byte-for-byte identical to the block
    they came from, and every "above"/"below" cross-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
2026-11-13 refactor(sim): share one deck assembler between both receiver MC builders
    The single-ended Monte Carlo builder's `build_deck()` was a line-for-line
    copy of the differential builder's, differing only in the header comment,
    the extra `side` argument and the `base.`-qualified `strip_end` calls. A
    change to the deck preamble in one would silently not reach the other, so
    the two campaigns could stop being comparable without anything failing --
    while the single-ended module docstring claims it reuses the differential
    builder "so the two campaigns stay identical apart from the testbench".
    Extract the shared layout into `assemble_deck(header, tb, pdk,
    sw_stat_mismatch, fragment)` in the differentia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
2026-11-13 docs(verification): replace per-request command list with one example
    The README restated the `klt functional-verification` chain that already
    lives in `package.json`'s `test` script, and the copy had drifted: the
    script names 12 request files, the block named 10. Missing were
    `request-usb-utmi-txoe.json` (cae64d0) and
    `request-usb-rx-sync-candidate.json` (006e0bc), both added to the script
    without extending the copy.
    Keep one worked invocation to show a request is runnable standalone and
    point at `package.json` as the single list, so there is no second
    enumeration to keep in step.
    Also correct the lede: `npm run test` runs the RTL suites, not "every
    klt-driven functional-verification suit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
2026-11-13 docs(env): move the klt pin-move history to docs/klt-pin-history.md
    docs/environment-setup.md was 502 lines, 222 of which (the ten numbered
    "moves" under "### Pinned versions", plus the check:ci sentence closing the
    list) were dated narrative about how the klt pin reached 0.9.0. A reader
    setting up the environment had to cross all of it between the pin table and
    the host-tool table that completes the same section, and moves 1-8 describe a
    git-revision pin scheme the doc itself says is superseded.
    Relocation only: all ten moves keep their numbers and their text byte for
    byte, now under a path that says what they are. The setup doc keeps the pin
    table, a short current-state paragraph (release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
2026-11-13 feat(layout): route and commit differential_driver GDS, cite T1 item 2.analog
    Add differential_driver to DELIVERABLE_BLOCKS in gen_analog_layout.py. The
    existing scripted channel router completes it with no new router code: 20/20
    nets routed (2 by klt's plan path, 18 scripted), 0 DRC violations at the
    gf180mcu deck, bbox 1831.2 x 83.88 um, LayoutToNetlist independently finding
    20 wired nets. Delivered with --blocks so the four child-A entries in
    provenance.json stay byte-unchanged. A full run now ends "analog layout
    DELIVERED": 5/5 executed, fully routed and DRC-clean.
    Attest the set as T1 item 2.analog following the item-1 pattern: a new
    analog-layout inventory in signoff/inventories.py li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
2026-11-13 fix(layout): run each analog layout plan in its own process
    `gen_analog_layout.py` executed every plan in one Python interpreter, and
    klt's layout-plan executor emits a plan's device-cell records in an order
    that depends on which plans ran earlier in that process. `dplus_pullup`
    therefore reproduced its recorded `gds_sha256` under exactly one block
    selection and stopped reproducing altogether once `differential_driver`
    began executing ahead of it, even though the geometry never changed.
    `main()` now executes each plan in a child interpreter via the new
    `_execute_plan_isolated()` whenever a run has more than one plan, and merges
    the per-block entries; a lone plan already owns its interpreter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
2026-11-13 refactor(sim): build Monte Carlo measurements with the harness's own mapper
    `sim/diff-receiver-mc/build_requests.py` had its own copy of the
    `klt_measure` entry -> `klt sim` `measurements[]` mapping, including the
    division of the bench's `checks` bounds by `scale`. The copy drifted once
    already (commit 3a6e489): it shipped the ratified +/-200 mV threshold
    bounds unscaled, so `klt sim` graded raw `.meas` volts against them, no
    `vth` row could fail, and the 2026-11-05 campaign had to be re-run and
    regraded.
    Both Monte Carlo campaigns now call the harness implementation, which was
    the tested one all along:
    - `klt_backend._measurement` is renamed to the public `measurement`, and
    the `libs.te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
2026-11-13 chore(sim): drop the hand-written klt sim decks from both driver benches
    The two driver benches each carried a second, hand-maintained expression of
    their testbench as a `klt sim` request body:
    sim/driver-jitter/testbench/driver_jitter_tb_klt.spice
    sim/driver-jitter/testbench/klt-sim-request.json
    sim/driver-signal-quality/testbench/driver_tb_klt.spice
    sim/driver-signal-quality/testbench/klt-sim-request.json
    They existed because a `klt sim` corners request could not carry the benches'
    `.control` derive vectors (#96). The `decks` transport (#188) removed that
    constraint: `select_transport` returns `decks` for any bench without
    `klt_measure`, and neither driver `tb.json` declares one,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
2026-11-13 docs(verification): replace per-test case lists in README Contents with file/DUT/caveat entries
    The `## Contents` testbench bullets enumerated, in prose, what each cocotb
    test checks — a second hand-maintained description of the suite beside the
    suite itself, with nothing checking one against the other. The largest
    entry had drifted: it described 14 of the 23 `@cocotb.test()` functions in
    `test_usb_utmi_phy.py`, omitting the RX stuffing-error path, the `pu_en`
    and `trim[4:0]` pin-contract tests and the inert-pin test, and
    `test_usb_utmi_txoe.py` had no RTL-side entry at all.
    Each testbench entry now carries only what a reader cannot get from the
    file: the file names, the DUT path, the spe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
2026-11-13 chore(signoff): re-pin T1 item 9 after the Monte Carlo mapper refactor
    This PR edits two inventoried testbench sources -- `sim/harness/klt_backend.py`
    (`_measurement` -> public `measurement`, new `MODELS_LIB`) and
    `sim/tests/test_harness.py` (the new
    `MonteCarloRequestSharesHarnessLimitsTests`) -- so the T1 item 9 testbench
    inventory no longer described the tree and `signoff/check.py` failed the gate.
    The edits are intended, so the evidence chain is re-pinned rather than the
    sources reverted:
    - `python3 signoff/check.py --regen` rewrote the two `sha256` pins in
    `signoff/evidence/inventory-testbenches.json`, and the envelope and manifest
    hashes that chain off it.
    - `manifests/t1-signoff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
2026-11-13 chore(signoff): rebind the T1 item 10 repo-hygiene inventory to the edited README
    This branch's README.md edit left `signoff/evidence/inventory-repo-hygiene.json`
    describing the pre-edit file, so `python3 signoff/check.py` failed
    `T1 item 10: README.md: changed since it was inventoried` and took CI red.
    Regenerated with `python3 signoff/check.py --regen`, which rewrites the one
    stale member hash and carries it up the binding chain (inventory content hash
    -> `t1-item-10-repo-hygiene.json` envelope -> the item 10 pin in
    `manifests/gf180-usb2-phy.json`), then re-rendered
    `manifests/t1-signoff-report.json` with the repo's pinned klt 0.9.0 — the
    version CI installs — so the frozen report kee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
2026-11-13 feat(verification): add analog LVS harness and record the five-block mismatch
    `scripts/analog_lvs.py` runs transistor-level LVS on every committed stream
    under `layout/analog/*.gds` (discovered by glob, never a hard-coded list)
    against `design/netlist/<block>.spice` with `form: "subckt-call"`, and exits 0
    only when every block reads `status: "match"`. A block whose reference netlist
    is missing fails loudly before any tool runs rather than being skipped.
    Measured under the repo pin (klt 0.9.0, klayout 0.30.13, deck `gf180mcu`):
    all five blocks mismatch, so the script exits 1. That is the recorded result,
    not a harness failure -- no LVS option that would hide it is set.
    The new append-only r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
2026-11-13 fix(layout): tie every device body and label the schematic's ports
    LVS mismatched on all five committed analog streams with the same fault on
    each: floating PMOS wells, an untied p-substrate, and a labelled port set
    that was not the schematic's.
    klt's layout-plan executor derives connectivity[] from source/drain/gate
    terminals only -- its _TERMINAL_SUFFIXES table has no bulk entry -- so a
    device body is never in a plan net and the contacted TAP_PAD* pads mos_array
    draws for gf180mcu's tap-distance rule stay floating. The only labels a plan
    run leaves are the ones klt's router writes, one per net it drew a leg for.
    Complete both in the post-plan pass, where the scripted routes already go: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
2026-11-13 feat(signoff): cite the five analog LVS matches as T1 item 4.analog
    `manifests/gf180-usb2-phy.json` gains an `evidence["4.analog"]` list of
    the five per-block `klt lvs` envelopes from record
    `20261113-163000-35e9b6e5ab87`, each pinned with the `content_hash` its
    envelope recorded for the GDS it was minted against. Every pin was
    checked to equal the sha256 of the committed `layout/analog/<block>.gds`.
    `manifests/t1-signoff-report.json` is re-rendered at the repo pin (klt
    0.9.0): item 4.analog grades `met` with all five citations `met`, and
    `t1_met_count` goes 16 -> 17. 4.digital is untouched. Editing the root
    README re-pins the item-10 repo-hygiene envelope via
    `signoff/check.py --regen`, so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
2026-11-13 chore(sim): print driver-jitter dev/cons element-wise instead of tabulating them
    `print dev` / `print cons` tabulate an 8- and a 7-element vector against the
    current plot's scale, so ngspice emits one row per `tran` time point (~35,000)
    and every row past the 8th (or 7th) is blank. In the committed
    `20260817-203915-5a963e7/tt_27c_3.30v.log`, 70,769 of 74,518 lines are blank
    table rows and only 15 carry a value; the driver-jitter artifact manifests
    carried ~89 MB per run against ~1.1 MB for the next largest bench.
    Indexed operands print one line each, so the per-edge values survive -- and
    become readable instead of being buried mid-table. The measurements are
    computed from `dev` / `cons` by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
2026-11-14 docs: state the five analog LVS matches and the committed driver layout
    `docs/chipalooza/challenge-5-proposal.md` is the public submission document,
    and its analog status became false on `main` on 2026-11-13 when #252 (driver
    route and commit) and #346 (body ties, LVS repair) landed. It said four of
    five analog blocks had a committed GDS and that no analog block had ever
    LVS-matched; both are now wrong, and a submission that undersells verified
    evidence is as much a verification-integrity defect as one that oversells it.
    Correct the thirteen stale passages in place against the two head records,
    keeping each passage's structure and voice:
    - §0 status, §4 Rows L/M/N, §5 (heading, lead, pe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
2026-11-14 chore(signoff): re-derive the item 9 hash chain across the merge with main
    `main` gained #356 (issue #347), which edited another inventoried
    testbench file (`sim/driver-jitter/testbench/tb.json`) and regenerated the
    same T1 item 9 hash chain. Both branches therefore rewrote the same four
    derived fields for unrelated reasons, conflicting on every one.
    A derived hash cannot be resolved by choosing a side: with both source
    edits present the merged inventory hashes to a third value
    (`975e8799…`), which is neither branch's pin. Confirmed by running
    `signoff/check.py` on the raw merge — it reports the manifest pin stale
    against the merged inventory while every inventory *member* still
    describ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
2026-11-14 docs: append four WORK_LOG entries and rotate the September archive
    WORK_LOG.md: PRs #354/#356 and issues #247/#347. WORK_PLAN.md is
    unchanged this tick — its rendered body differs, but only 2534s have
    elapsed since PR #357 last wrote it (< 3600s debounce), so the rewrite
    is suppressed. README.md is current: no merged PR in the window touched
    an architectural path.
    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
2026-11-14 docs: align §4's summary of verdicts with Row M's measured analog LVS match
    §4's "Summary of verdicts" still listed the analog half of M as unmet,
    eight lines below the Row M it summarizes, which now reads "Met for the
    analog half too, as measured". Split the jointly-worded "L and M (digital
    half)" so each row carries its own verdict:
    - Met now names M's analog half explicitly, keeping Row M's own
    qualification ("as measured") and both limits the record states — the
    poly resistors paired on topology alone with no resistor dimension
    compared, and `power_connectivity` `unchecked` on all five, hence the
    separate open ERC obligation (#248). Not compressed to a flat "Met".
    - Unmet ke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
2026-11-14 build: discover scripts/ unittest modules in lint instead of listing them
    The lint chain enumerated four scripts/ unittest modules by hand, which let
    scripts/test_analog_lvs.py (22 cases) sit outside npm run lint and CI
    entirely, even though two frozen analog-LVS evidence records and
    layout/README.md cite it as the self-test pinning their claims.
    Replace the four enumerated steps with a single
    `python3 -m unittest discover -s scripts -t scripts -p 'test_*.py'`, matching
    what step 13 already does for sim/tests. The scripts discover step now
    reports 77 tests instead of the 55 the four steps covered.
    test_check_signoff_report.py stays an explicit step: it is a hand-rolled
    case_*/main() runner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
2026-11-14 build: re-bind T1 item 10 evidence to the edited package.json
    `signoff/evidence/inventory-repo-hygiene.json` binds `package.json` by
    SHA-256 (T1 item 10), so this PR's own `lint` edit made the `check:ci`
    drift gate fail:
    FAIL signoff/evidence/inventory-repo-hygiene.json:
    package.json: changed since it was inventoried
    The change is intended, so the inventory is re-bound per the gate's own
    instruction (`python3 signoff/check.py --regen`). That re-bind moves a
    hash chain, and all four links move together in this one commit:
    - signoff/evidence/inventory-repo-hygiene.json package.json's sha256
    - signoff/evidence/t1-item-10-repo-hygiene.json the envelope's content_hash
    - manifests/gf1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
